0geder/Tukzie-HPEC-HUD/Photos/Reference/README.md

# Reference photos

Photos the student took for design work, resized to 1600 px on the long side. Personal screenshots (maps, ride apps) are not kept here.

## Enclosures (12 Oct 2026)

| File | What it shows | Numbers read from it |
|---|---|---|
| 2026-10-12_whiteboard_dashboard_272x187_pi5_imu_sizes.jpg | Whiteboard sketch of the display outline with the Pi 5 and IMU sizes | Display outer 272 x 187 mm; Pi 5 drawn as 90 x 60 mm (real board 85 x 56 mm); IMU (GY-521) 20 x 17 mm |
| 2026-10-12_sensor_board_and_camera_pod_with_ribbon.jpg | JCP Sense v1.0 ToF board and the yellow camera case joined by the ribbon, laid out the way they go in the front casing (camera above the board) | Camera case 29.2 x 28.2 x 12.35 mm (from its STL); board length estimated at about 120 mm from the photo, to be measured |
| 2026-10-12_display_stack_side_view_1.jpg, _2.jpg | Side of the display: acrylic front frame, panel, standoffs, back plate with the Pi 5 | Whole stack about 20 mm thick (student's estimate) |
| 2026-10-12_display_front_corner_and_stack.jpg | Front corner, frame screws, stack layers | |
| 2026-10-12_display_front_dashboard_running.jpg | The display running the SW-7 dashboard | |

## Vehicle measurements (2 Sep 2026)

Originals are in `../../../MeasurementsOfTuktuk/` (full resolution). Readings are taken from the tape in each photo.

| File | Reading |
|---|---|
| 2026-09-02_handlebar_height_tape.jpg | Tape beside the left grip and front panel, about 69 cm at the grip |
| 2026-09-02_meter_area_width_about_30cm.jpg | Across the meter and headlamp area to the steering stem, about 30.5 cm |
| 2026-09-02_seat_front_edge_width.jpg | Driver seat, about 72 cm |
| 2026-09-02_seat_length_about_93cm.jpg | Passenger seat, about 93 cm |
| 2026-09-02_mirror_span.jpg | Mirror to mirror region, about 90 cm |
| 2026-09-02_seat_cushion_length_about_75cm.jpg | Seat cushion, about 75 cm |
| 2026-09-02_handlebar_above_rear_seat.jpg | Height reading, about 64 cm |
| 2026-09-02_rear_seat_width_about_89cm.jpg | Rear seat, about 89 cm |

The readings marked "about" come from the photo alone; where a photo does not show both ends of the tape, treat the number as approximate.
