0geder/Tukzie-HPEC-HUD/Report/appendixi.tex

\chapter{Photographs of the First Road Session}
\label{app:road1}

These photographs and video stills were taken by the team around the first road session of 19 October 2026 (Section~\ref{sec:field-test-design}) and shared on 21 October. The originals, twelve photographs and five short videos, are kept in the project's \texttt{Roadtest1} folder and not in the repository. In line with Section~\ref{sec:ethics}, the faces of other people have been cropped away or blurred and the vehicle's number plate blurred; the videos show people, so they are listed in Table~\ref{tab:road1-videos} rather than reproduced.

\section{Rear sensor pod}

Figure~\ref{fig:road1-pod} shows the rear sensor pod of Appendix~\ref{app:mechanical} as built: the camera head with the time-of-flight board, the Raspberry Pi~4 with its fan and the ESP32 telemetry unit in their bays, and the vented lid with its push-on hood.

\begin{figure}[H]
\centering
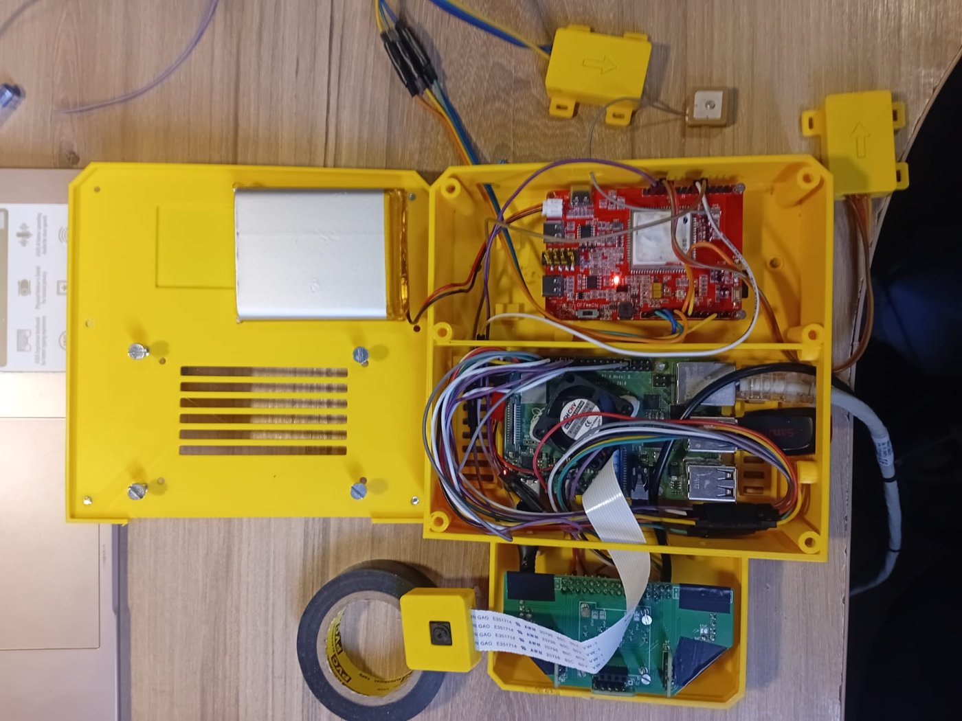
[picture p1: Report/figures/road1/pod_open_top.jpg]
\subfigure[Open, from above: the bays with the Raspberry Pi~4 and the ESP32, a battery pack held in the lid, and the head tray with the time-of-flight board below.]{}
\hfill
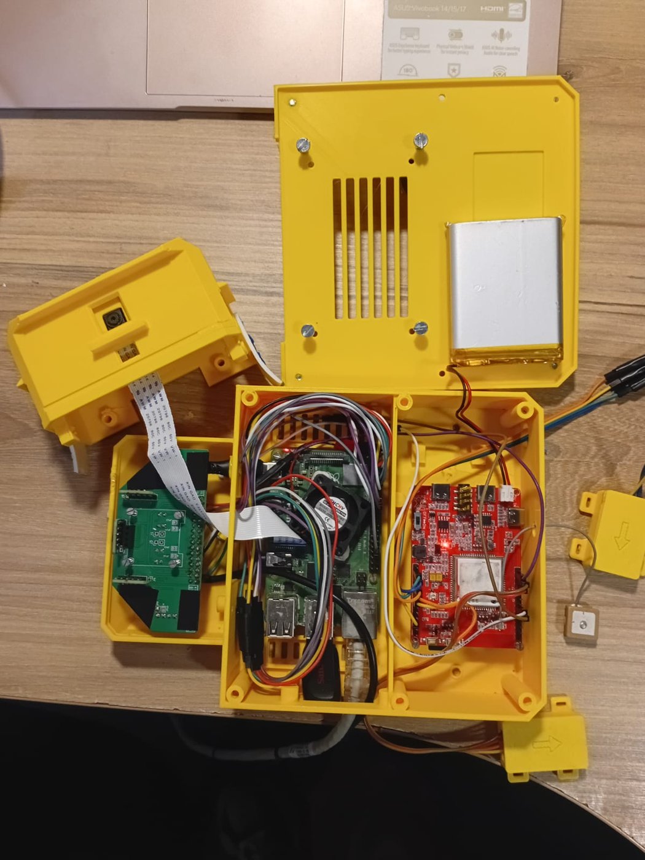
[picture p2: Report/figures/road1/pod_open_bays.jpg]
\subfigure[Open, with the camera head lifted on its ribbon cable beside the time-of-flight board.]{}
\\[4pt]
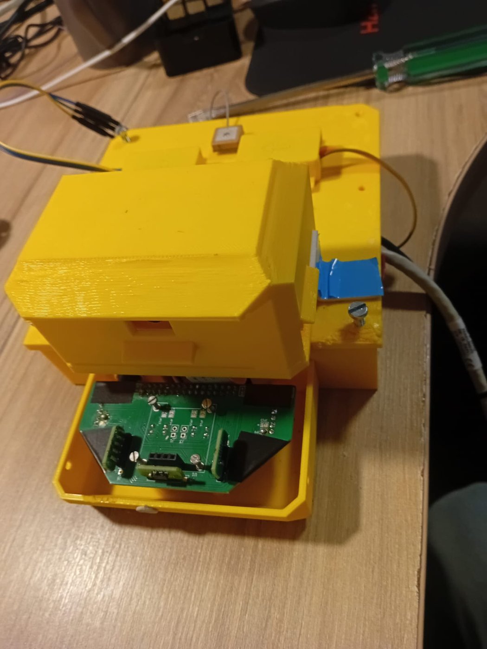
[picture p3: Report/figures/road1/pod_closed_hood.jpg]
\subfigure[Closed, with the hood over the lid's exhaust grille and the head tray open at the front.]{}
\hfill
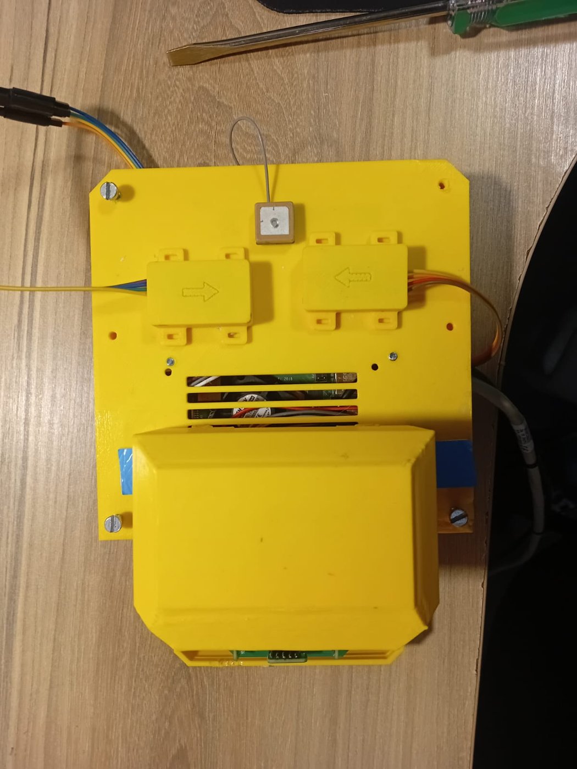
[picture p4: Report/figures/road1/pod_lid_antenna.jpg]
\subfigure[The lid from above, with the GNSS antenna on top and the grille under the hood.]{}
\caption[The rear sensor pod, printed and assembled]{The rear sensor pod, printed and assembled.}
\label{fig:road1-pod}
\end{figure}

\clearpage
\section{The system on the vehicle}

Figure~\ref{fig:road1-vehicle} shows the units mounted over the rear frame of the TUKZIE Rev 0, outdoors and in the laboratory, with the removable mounting of R13: a board laid over the frame and the units on it, with no drilling.

\begin{figure}[H]
\centering
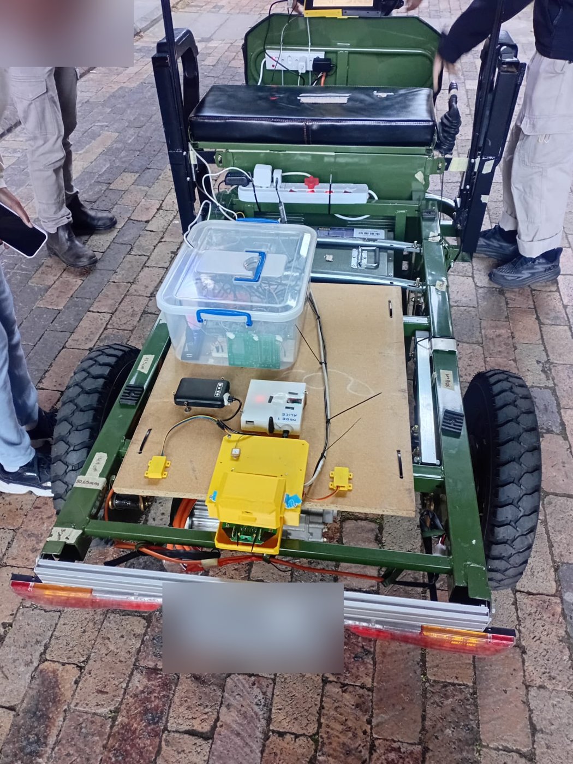
[picture p5: Report/figures/road1/chassis_rear.jpg]
\subfigure[From behind: the rear sensor pod (yellow) at the back edge of the board, the small IMU pods, and the power strip at the front of the bed.]{}
\hfill
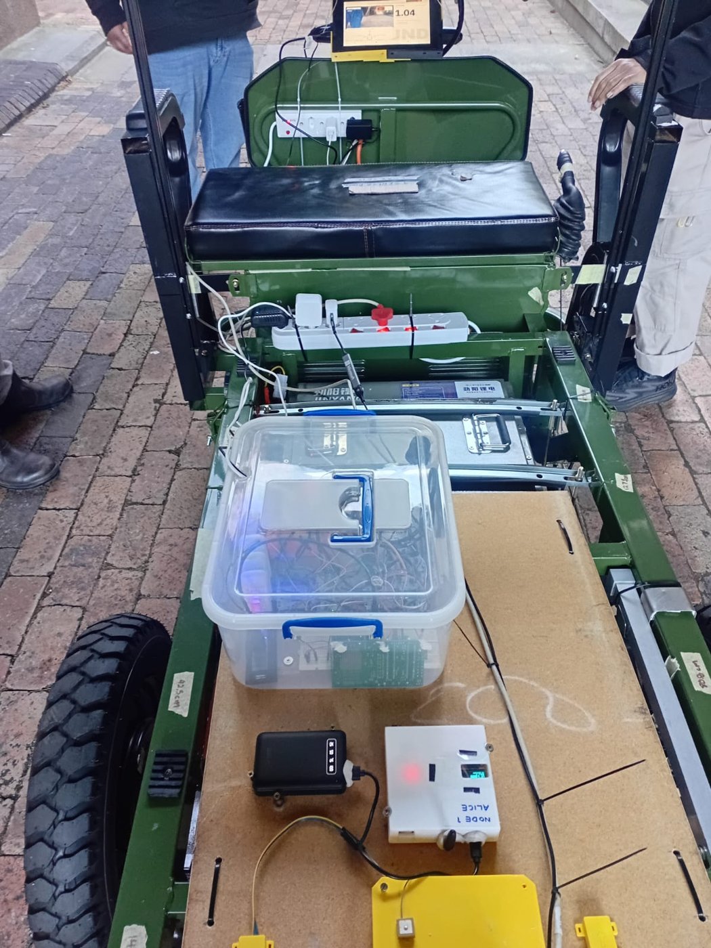
[picture p6: Report/figures/road1/chassis_rear_close.jpg]
\subfigure[Closer, with a clear box holding further electronics and the units on the board.]{}
\\[4pt]
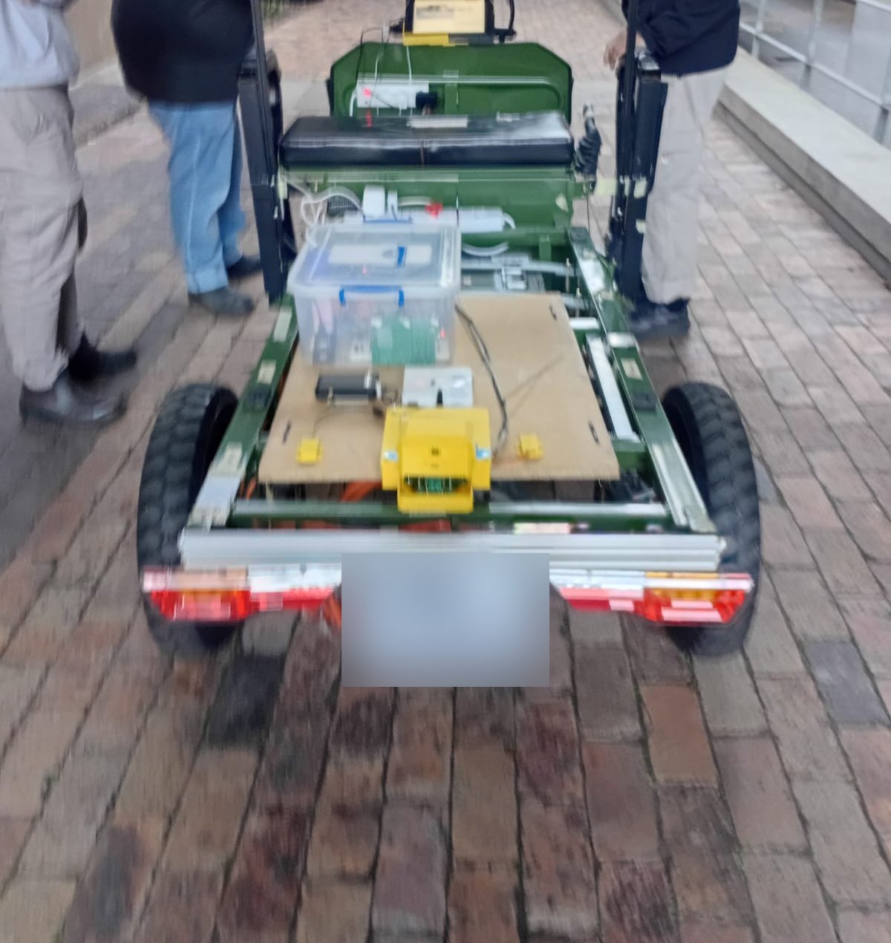
[picture p7: Report/figures/road1/chassis_rear_wide.jpg]
\subfigure[The whole vehicle from behind, outdoors.]{}
\hfill
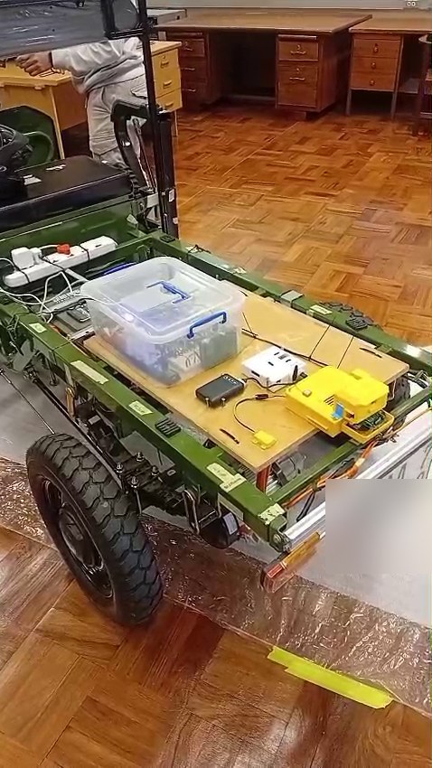
[picture p8: Report/figures/road1/vid_chassis_side.jpg]
\subfigure[From the side in the laboratory (video still).]{}
\caption[The system mounted on the vehicle]{The system mounted on the vehicle. Faces and the number plate are blurred or cropped.}
\label{fig:road1-vehicle}
\end{figure}

\clearpage
\section{The dashboard on the handlebar}

Figure~\ref{fig:road1-dash} shows the display in its printed holder on the handlebar, with the dashboard running.

\begin{figure}[H]
\centering
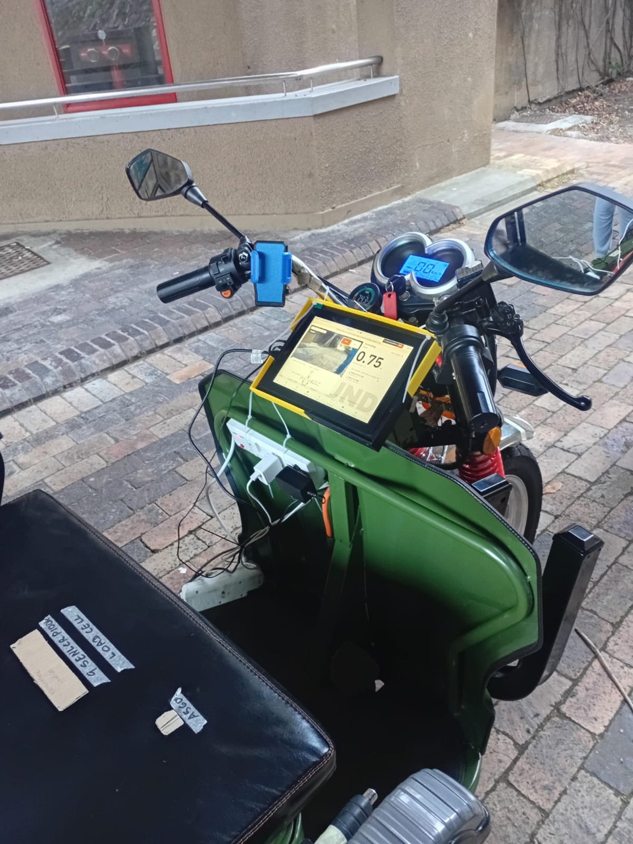
[picture p9: Report/figures/road1/dash_on_bar.jpg]
\subfigure[The display on the handlebar, outdoors.]{}
\hfill
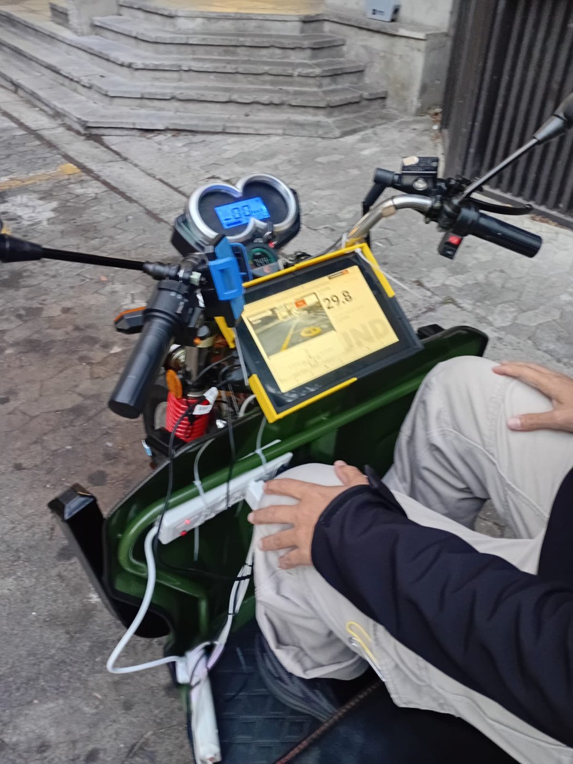
[picture p10: Report/figures/road1/dash_on_bar_seated.jpg]
\subfigure[From the seat.]{}
\hfill
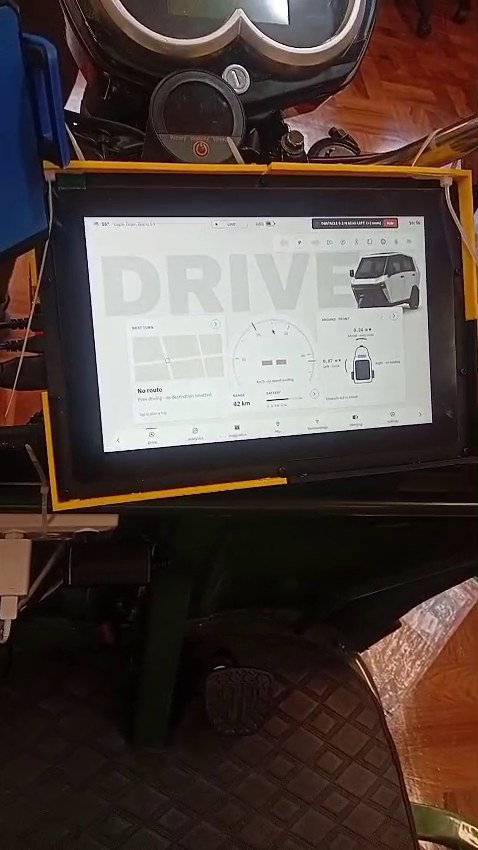
[picture p11: Report/figures/road1/vid_dash_drive.jpg]
\subfigure[The DRIVE page (video still).]{}
\caption[The dashboard display mounted on the vehicle]{The dashboard display mounted on the vehicle.}
\label{fig:road1-dash}
\end{figure}

\begin{table}[htbp]
\centering
\small
\caption[Videos from the first road session, kept with the originals (file names as shared on 21 October 2026)]{Videos from the first road session, kept with the originals (file names as shared on 21 October 2026).}
\label{tab:road1-videos}
\begin{tabular}{|p{4.6cm}|p{1.2cm}|p{8.0cm}|}
\hline
\textbf{File} & \textbf{Length} & \textbf{What it shows} \\ \hline
WhatsApp Video 2026-10-21 at 21.07.44 & 45\,s & From a corridor to a doorway as the vehicle is ridden out of the building \\ \hline
WhatsApp Video 2026-10-21 at 21.07.53 & 19\,s & A toy RC car and its remote shown to the camera, then the vehicle pushed through a doorway into a lecture venue \\ \hline
WhatsApp Video 2026-10-21 at 21.08.18 & 8\,s & A walk round the rear frame with the units mounted, indoors \\ \hline
WhatsApp Video 2026-10-21 at 21.08.19 & 16\,s & The vehicle ridden slowly inside the lecture venue \\ \hline
WhatsApp Video 2026-10-21 at 21.08.20 & 43\,s & The wiring at the bed, then the display on the handlebar showing the DRIVE page \\ \hline
\end{tabular}
\end{table}

\clearpage
\section{Front sensor board on the vehicle}

Figure~\ref{fig:road1-front} shows the front time-of-flight sensor board of the Raspberry Pi~5 unit (Section~\ref{sec:two-sided}) fitted on the vehicle, on its yellow printed mount below the headlight and between the fork legs, facing forward.

\begin{figure}[H]
\centering
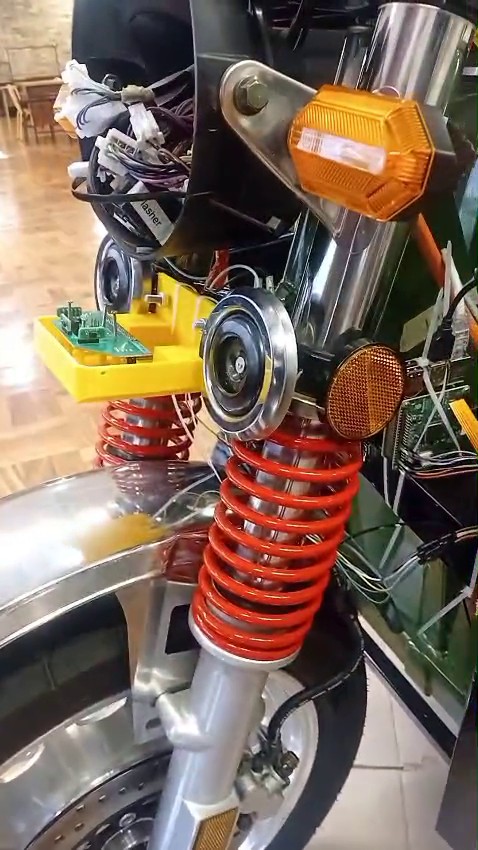
[picture p12: Report/figures/road1/vid_front_sensor.jpg]
\subfigure[The front of the vehicle with the sensor board on its mount (video still).]{}
\hfill
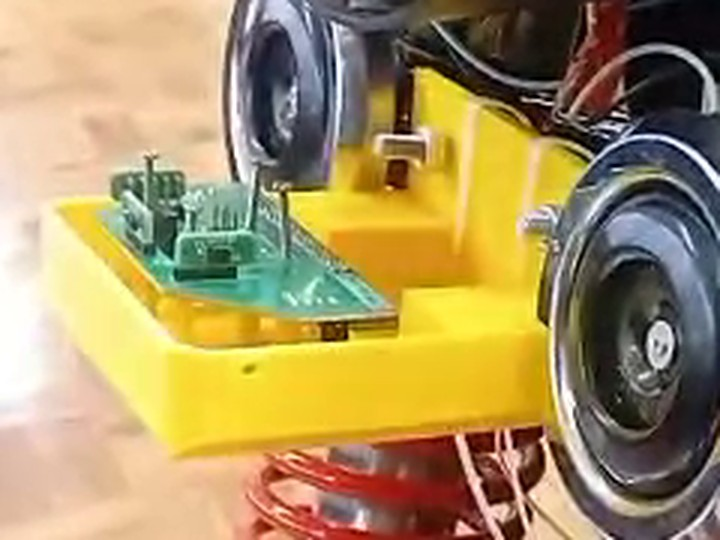
[picture p13: Report/figures/road1/vid_front_sensor_crop.jpg]
\subfigure[The mount and board, enlarged from the same frame.]{}
\caption[The front sensor board fitted on the TUKZIE Rev 0 (from the video of 21.08.20, at 28\,s)]{The front sensor board fitted on the TUKZIE Rev 0 (from the video of 21.08.20, at 28\,s).}
\label{fig:road1-front}
\end{figure}

\begin{figure}[htbp]
\centering
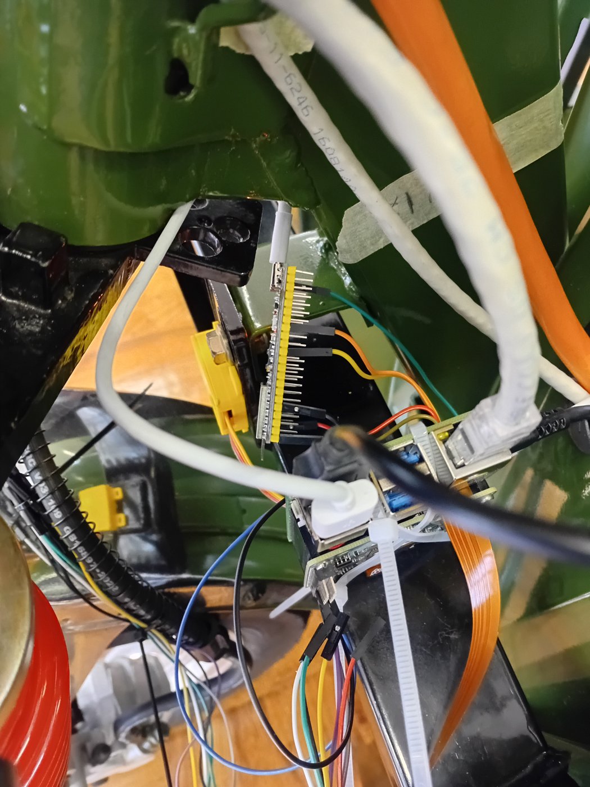
[picture p14: Report/figures/road1/front_install_1023.jpg]

\caption[The front installation under the frame, 23 October 2026]{The front installation under the frame, 23 October 2026: the Raspberry Pi~5 (lower right, with the Ethernet cable and the camera ribbon) and the front IMU node, a bare ESP32-S3 on yellow headers (centre), cable-tied beneath the front frame.}
\label{fig:front-install}
\end{figure}

\begin{figure}[htbp]
\centering
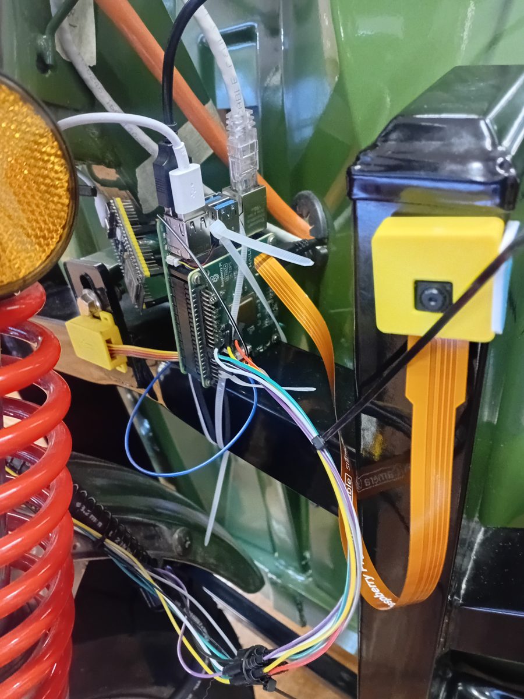
[picture p15: Report/figures/road1/front_camera_1022.jpg]
\subfigure[The front camera in its yellow printed case on the frame upright, with its ribbon to the Raspberry Pi~5.]{}\hfill
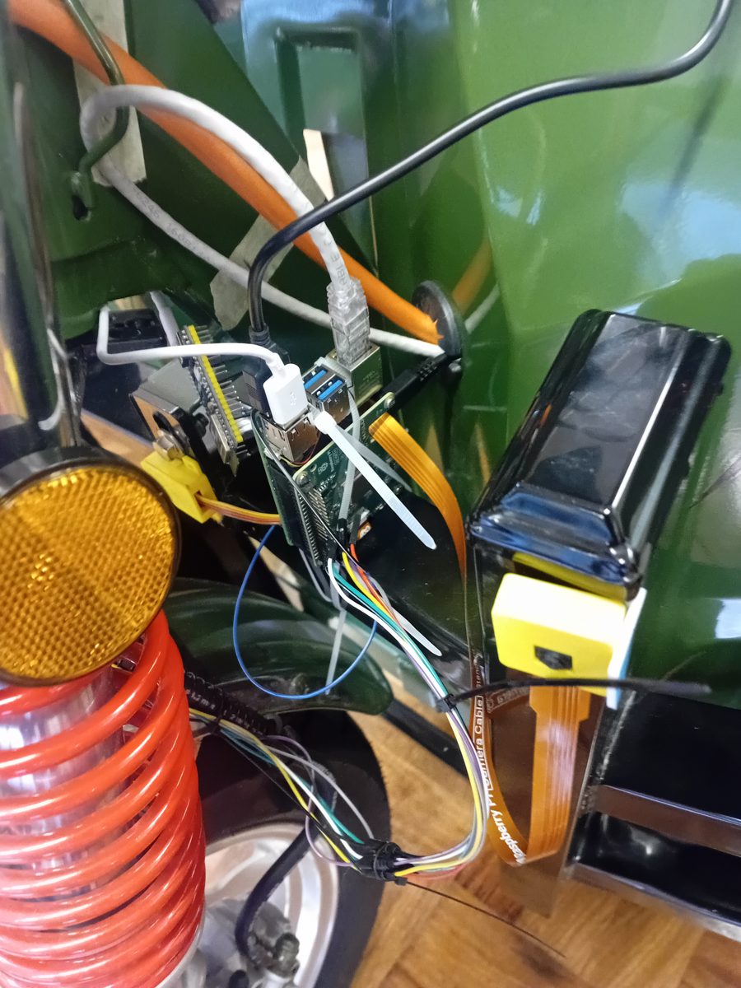
[picture p16: Report/figures/road1/front_system_1022.jpg]
\subfigure[The front system from above: the Raspberry Pi~5, the front IMU node and the camera, wired on the frame.]{}
\caption[The front camera and front system on the vehicle, 22 October 2026]{The front camera and front system on the vehicle, 22 October 2026.}
\label{fig:front-system-1022}
\end{figure}

\begin{figure}[htbp]
\centering
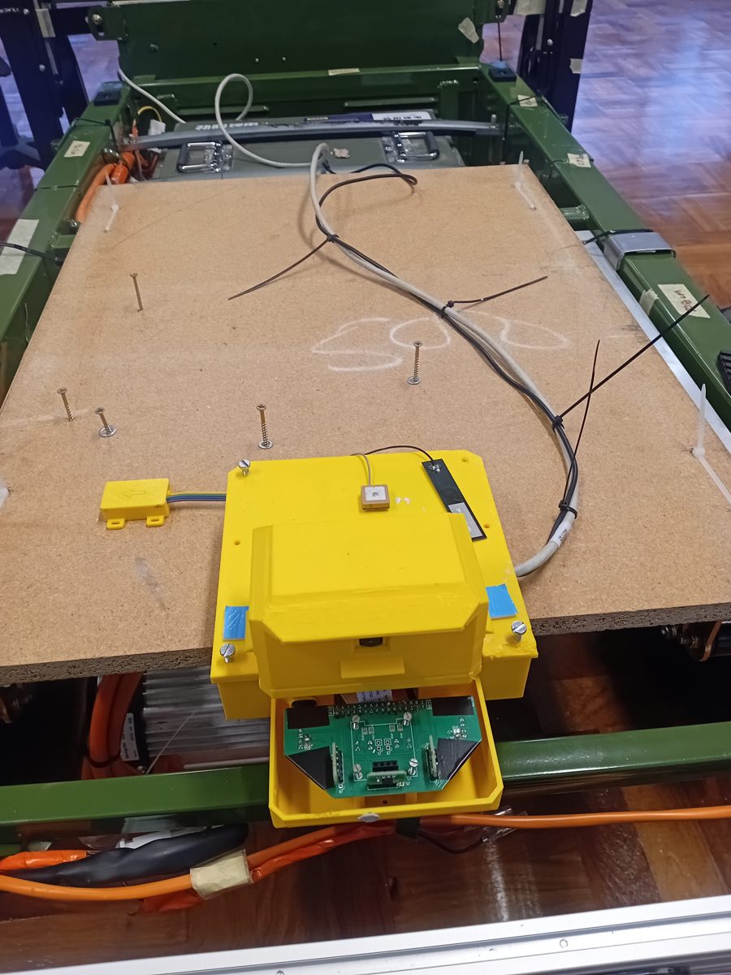
[picture p17: Report/figures/road1/rear_system_1022.jpg]

\caption[The rear system on the deck, 22 October 2026]{The rear system on the deck, 22 October 2026: the printed rear enclosure with the Raspberry Pi~4, the GNSS and LTE antennas on its lid, the rear camera and time-of-flight board at its end, and a small IMU pod and an ESP32-S3 board on the deck.}
\label{fig:rear-system-1022}
\end{figure}

\begin{figure}[htbp]
\centering
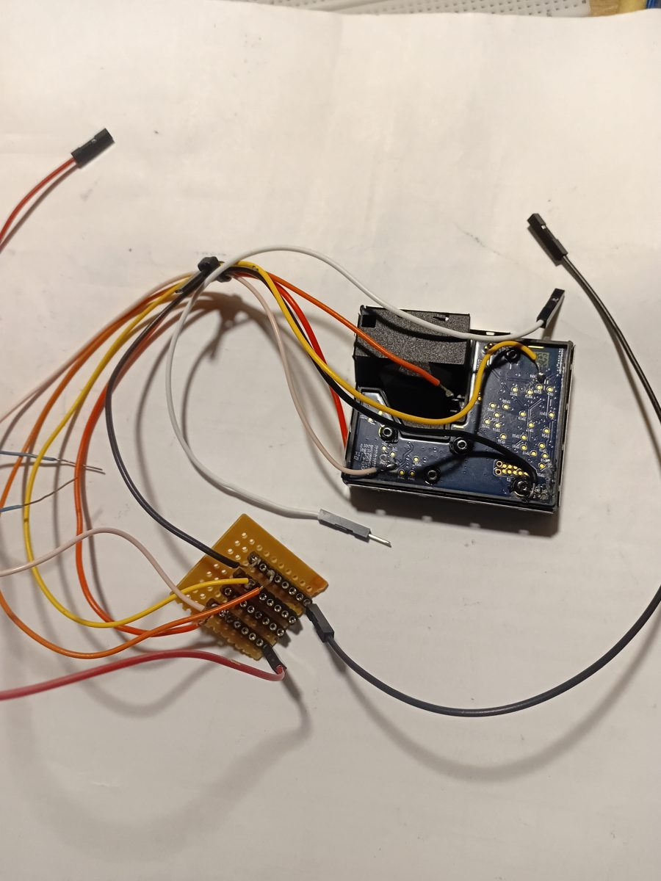
[picture p18: Report/figures/road1/sen55_damaged_1026.jpg]

\caption[The SEN55 air-quality sensor after wires were soldered to its test pads]{The SEN55 air-quality sensor after wires were soldered to its test pads in place of the missing cable, with the adapter board; the sensor no longer powered up (Section~\ref{sec:impl-other}).}
\label{fig:sen55-damaged}
\end{figure}

\IfFileExists{video_links.tex}{\input{video_evidence}}{}
