0geder/Tukzie-HPEC-HUD/Report/appendixc.tex

\chapter{Test Evidence}
\label{app:evidence}

This appendix indexes the raw evidence behind the bench results reported in Chapter~\ref{chap:results}. Every item is the unedited output of the test it names and is kept in the project repository, under \texttt{Report/evidence/} or \texttt{BenchTest/logs/}; Table~\ref{tab:evidence-index} gives each file. Figure~\ref{fig:live-dashboard} in Appendix~\ref{app:figures} and Figure~\ref{fig:recorded-session} in Chapter~\ref{chap:results} belong to the same record.

\begin{longtable}{|>{\raggedright\arraybackslash}p{1.7cm}|>{\raggedright\arraybackslash}p{3.6cm}|>{\raggedright\arraybackslash}p{5.2cm}|>{\raggedright\arraybackslash}p{3.6cm}|}
\caption[Index of test evidence]{Index of test evidence.}
\label{tab:evidence-index}\\
\hline
\textbf{Date} & \textbf{Test} & \textbf{Result shown} & \textbf{File} \\ \hline
\endfirsthead
\hline
\textbf{Date} & \textbf{Test} & \textbf{Result shown} & \textbf{File} \\ \hline
\endhead
25 Sep 2026 & Recorded bench session, telemetry unit, 150\,s from power-up & 200\,Hz on both IMUs with no dropped samples; 149 fused windows, all from both sensors; five of five fusion self-tests passed; acquisition gaps of 25 to 30\,ms every 12\,s, with intervals down to 0.8\,ms after each (catch-up) & \texttt{BenchTest/\allowbreak{}logs/\allowbreak{} 2026-09-25\_\allowbreak{}bench\_\allowbreak{}fusion\_\allowbreak{}shake.log} \\ \hline
25 Sep 2026 & The same log replayed through the bench console (Figure~\ref{fig:console-replay}) & Every subsystem's state at the end of the session, and the vibration and disagreement traces for the whole recording & \texttt{Report/\allowbreak{}evidence/\allowbreak{} 2026-09-25\_\allowbreak{}bench\_\allowbreak{}console\_\allowbreak{}replay.png} \\ \hline
28 Sep 2026 & Hazard detector, first run on live camera frames & 430 frames in 60.1\,s (7.2\,frames/s); a person in view logged as ``motorcycle'', which exposed the label-offset fault & \texttt{Report/\allowbreak{}evidence/\allowbreak{} 2026-09-28\_\allowbreak{}camera\_\allowbreak{}run1\_\allowbreak{}label\_\allowbreak{}bug.txt} \\ \hline
28 Sep 2026 & Hazard detector after the label and colour fixes & 419 frames in 60.1\,s (7.0\,frames/s); person detected at confidence 0.50 to 0.73; 16 alert activations in 47\,s for one person in view, which led to clear-side hysteresis & \texttt{Report/\allowbreak{}evidence/\allowbreak{} 2026-09-28\_\allowbreak{}camera\_\allowbreak{}run2\_\allowbreak{}after\_\allowbreak{}fixes.txt} \\ \hline
29 Sep 2026 & Firmware v0.5.0 on the telemetry unit: commands, flash-write stall test, MQTT reconnect & With logging on, 33 to 40\,ms gaps on both IMUs every 10\,s; with logging off, worst gap 5.9\,ms; no dropped samples; 47 MQTT publishes with no failures; reconnect in 0.4\,s & \texttt{BenchTest/\allowbreak{}logs/\allowbreak{} 2026-09-29\_\allowbreak{}v050\_\allowbreak{}bench\_\allowbreak{}test.log} \\ \hline
29 Sep 2026 & GNSS outdoor fix on a rooftop, firmware v0.5.0, raw replies requested every 15\,s & 3D fix after 51\,s; 17-field reply with decimal degrees; old parser read satellite counts as the position; well-formed replies 2.4 and 5.5\,m from the phone's position; replies garbled by the competing query & \texttt{BenchTest/\allowbreak{}logs/\allowbreak{} 2026-09-29\_\allowbreak{}gnss\_\allowbreak{}rooftop.log} \\ \hline
30 Sep 2026 & GNSS outdoor fix with the corrected parser (v0.5.2), raw replies printed by the firmware & 3D fix after 105\,s from a cold start; 23 to 25 satellites; over 104 fixes, median 2.7\,m and 95\% within 11.0\,m of the phone's position & \texttt{BenchTest/\allowbreak{}logs/\allowbreak{} 2026-09-30\_\allowbreak{}gnss\_\allowbreak{}rooftop\_\allowbreak{}v052.log} \\ \hline
30 Sep 2026 & MQTT recovery from a 60\,s radio-off period (\texttt{AT+CFUN=4}, then \texttt{AT+CFUN=1}), v0.5.0 and v0.5.3 & Loss detected in 0.8 to 20.7\,s; retries at 30 and 60\,s; reconnect 36\,s after the radio returned in v0.5.0, about 5\,s in v0.5.3; no failed publishes afterwards & \texttt{BenchTest/\allowbreak{}logs/\allowbreak{} 2026-09-30\_\allowbreak{}signal\_\allowbreak{}loss\_\allowbreak{}test.log}, \texttt{..\_v053.log} \\ \hline
30 Sep 2026 & Sync-pulse edges logged on the Pi (GPIO17, kernel timestamps), two 60\,s runs & Run 1: 16\,s burst of spurious edges, consistent with a disturbed contact; run 2: 121 edges, median interval 500.06\,ms, range 499.72 to 500.41\,ms & \texttt{BenchTest/\allowbreak{}logs/\allowbreak{} 2026-09-30\_\allowbreak{}sync\_\allowbreak{}edges\_\allowbreak{}run1\_\allowbreak{}noisy.csv}, \texttt{..\_run2.csv} \\ \hline
30 Sep 2026 & Camera detector latency on the Pi, three 60\,s runs (4 threads, 4 threads with live view, 1 thread) & Median 102, 105 and 186\,ms from sensor readout to result; 19.5, 17.3 and 7.0 frames/s; no throttling & \texttt{BenchTest/\allowbreak{}logs/\allowbreak{} 2026-09-30\_\allowbreak{}c4\_\allowbreak{}latency/} \\ \hline
1 Oct 2026 & Firmware v0.6.0 bench run, 330\,s, logging on throughout (buffered log, signal quality, Hall counter in loopback) & Five flushes; all ten gaps over 10\,ms (37 to 40\,ms) in the first window after a flush (0.2 to 1.05\,s after it); worst gap otherwise 5.9\,ms; no dropped samples; Hall counter 2.00 edges/s; CSQ 24 to 26 & \texttt{BenchTest/\allowbreak{}logs/\allowbreak{} 2026-10-01\_\allowbreak{}v060\_\allowbreak{}bench\_\allowbreak{}test.log} \\ \hline
1 Oct 2026 & Read-back of the stored telemetry log (firmware v0.6.3, \texttt{BenchTest/log\_dump.py}, four passes) & 6,020 records recovered complete; 5,545 contained \texttt{nan} (invalid JSON, fixed in v0.6.3); 14 records with a valid BMS reading (74.78\,V, 60\%) from 30 Sep; log then cleared & \texttt{BenchTest/\allowbreak{}logs/\allowbreak{} 2026-10-01\_\allowbreak{}telemetry\_\allowbreak{}log\_\allowbreak{}dump.jsonl}, \texttt{..clean.jsonl} \\ \hline
1 Oct 2026 & Stand-in ToF: micromouse sensor board on the Pi (three VL53L0X, \texttt{tof\_probe.py}, \texttt{tof\_reader.py}) & Chip confirmed VL53L0X; three sensors addressed and read at about 31 per second each; centre 267 to 300\,mm, right 24 to 38\,mm, left 8190 (no target) throughout & \texttt{BenchTest/\allowbreak{}logs/\allowbreak{} 2026-10-01\_\allowbreak{}tof\_\allowbreak{}three\_\allowbreak{}sensors.csv} \\ \hline
1 Oct 2026 & Dashboard camera page (laptop, offscreen) against the live detector on the Pi~4, 60\,s & Live after 0.6\,s; 638 frames decoded in 45\,s (14.2 per second); offline state shown when the detector stopped; no alerts (nothing in view) & \texttt{Report/\allowbreak{}evidence/\allowbreak{} 2026-10-01\_\allowbreak{}dashboard\_\allowbreak{}page\_\allowbreak{}live.png}, \texttt{Dashboard\allowbreak{}Integration/\allowbreak{}tests/\allowbreak{} test\_\allowbreak{}front\_\allowbreak{}camera\_\allowbreak{}page\_\allowbreak{}live.py} \\ \hline
1 Oct 2026 & Dashboard camera page against the live detector with a person in view, 40\,s & Red ``Person, Immediate'' alert listed 0.5\,s after start, matching the box on the video; 15.4 frames/s, 109 to 118\,ms; clearing not seen (person stayed in view) & \texttt{Report/\allowbreak{}evidence/\allowbreak{} 2026-10-01\_\allowbreak{}dashboard\_\allowbreak{}page\_\allowbreak{}person.png} \\ \hline
1 Oct 2026 & Camera colour check (C3): stills with the standard and the NoIR tuning, detector frames with NoIR tuning and saturation 1.8 & Standard tuning: white wall pink; NoIR tuning: neutral but washed out (blue card 120, 124, 125); with saturation 1.8: blue 1, 86, 216; red 222, 8, 77; green 6, 124, 103; grey 124, 129, 138; white 186, 199, 197 (slightly cool) & \texttt{Report/evidence/c3/} \\ \hline
2 Oct 2026 & First pothole model: YOLO11n fine-tuned in Colab (T4) on a public 608-image pothole dataset, test split at 640 and 320 & mAP@50 0.597 (P 0.66, R 0.50) at 640; 0.550 at 320; 46 epochs, 15 min & \texttt{Camera\allowbreak{}Detection/\allowbreak{}training/\allowbreak{} runs/\allowbreak{}run1\_\allowbreak{}gerapothole\_\allowbreak{}640/} \\ \hline
2 Oct 2026 & First pothole model on the South African test split (605 images, 1,238 potholes) at 640, 1280 and 1920 input; labels checked visually & mAP@50 0.000 at all three sizes, recall at most 1.2\%; label positions confirmed correct & \texttt{Camera\allowbreak{}Detection/\allowbreak{} training/\allowbreak{}runs/\allowbreak{} colab\_\allowbreak{}session\_\allowbreak{}2026-10-02.ipynb} \\ \hline
2 Oct 2026 & Firmware v0.7.0 DASH line on the bench (40 s) and through the Raspberry Pi~4 bridge to a laptop & 40 lines in 40 s, none missing, all valid JSON, max 272 bytes; IMUs 200 Hz, 0 drops; bridge served live record (0.37 s old) and ToF distances & \texttt{BenchTest/\allowbreak{}TEST\_\allowbreak{}PRO\allowbreak{}CEDURES.md} T11, T12 \\ \hline
2 Oct 2026 & YOLO11n (COCO) via NCNN on the Raspberry Pi~4, 320 input, 4 threads, 15 s trial & 7.9\,frames/s; inference 111 ms median; 175 ms sensor to result (p95 258 ms) & \texttt{Camera\allowbreak{}Detection/\allowbreak{} ncnn\_\allowbreak{}bench.py} \\ \hline
2 Oct 2026 & Dashboard map crash on the Raspberry Pi~5, diagnosed over ssh without changing the team's installation & Segmentation fault about 2\,s after the dashboard is shown with the web map (online or offline data); no crash with the native map after 30\,s; the web engine alone loads normally & \texttt{Dashboard\allowbreak Integration/\allowbreak{} PI5\_\allowbreak{}MAP\_\allowbreak{}CRASH.md} \\ \hline
3 Oct 2026 & Dashboard live-only mode and automatic Raspberry Pi~4 finding, offscreen against a simulated bridge (laptop) & With the bridge down every page shows \texttt{-{}-} or Unavailable and no simulated value; live when the bridge appears, back to no data when it stops; host found by localhost, override and beacon, and followed after it moved & \texttt{Dashboard\allowbreak Integration/\allowbreak{} tests/\allowbreak{}test\_\allowbreak{}live\_\allowbreak{}data\allowbreak \_\allowbreak{}provider.py} \\ \hline
4 Oct 2026 & Street-tile map, offscreen, fed the generated UCT replay track (not recorded data) against a stand-in tile server & Tiles requested at most two at a time and cached; heading-up follow; ``Waiting for GPS fix''; REPLAY badge; vector roads with the tile server down & \texttt{Dashboard\allowbreak Integration/\allowbreak{} tests/\allowbreak{}tile\_\allowbreak{}map\_\allowbreak{}*.png} \\ \hline
4 Oct 2026 & Camera and time-of-flight fusion, offline tests & 29 of 29 pass; not yet run on the Raspberry Pi~4 (test C9 planned) & \texttt{Camera\allowbreak{}Detection/\allowbreak{} tests/\allowbreak{}test\_\allowbreak{}sensor\_\allowbreak{}fusion.py} \\ \hline
6 Oct 2026 & Sensors page and hazard banner, whole dashboard offscreen against the live bridge & ToF gauges (ahead 0.43\,m red, right 0.69\,m amber, left no reading), both listed in the fusion's immediate band (under 3\,m) while the gauges colour by their own proximity thresholds (red under 0.5\,m, amber under 1.0\,m); banner over the driving page, hidden on the Sensors page & \texttt{Dashboard\allowbreak{}Integration/\allowbreak{} tests/\allowbreak{}sensors\_\allowbreak{}page.png}, \texttt{hazard\_banner.png} \\ \hline
6 Oct 2026 & First fused camera and time-of-flight hazard, live, before calibration & Person, ahead sensor: camera 0.874\,m, time-of-flight 0.096\,m, reported 0.096\,m; not checked against a tape & \texttt{BenchTest/\allowbreak{} TEST\_\allowbreak{}PRO\allowbreak{}CEDURES.md}, test C9 notes \\ \hline
6 Oct 2026 & Pothole model run 2, South African road-band tiles (Colab) & Validation mAP@50 0.714 at 640 and 0.566 at 320; held-out test tiles not yet scored & \texttt{Camera\allowbreak{}Detection/\allowbreak{} training/\allowbreak{}runs/\allowbreak{} run2\_\allowbreak{}sa\_\allowbreak{}band\_\allowbreak{}tiles\_\allowbreak{}640/\allowbreak{} training\_\allowbreak{}record.json} \\ \hline
6 Oct 2026 & Simulated drive on the street map, offscreen tests & Starts without a fix, 25\,km/h along the route, heading-up, arrives, a real fix stops it & \texttt{Dashboard\allowbreak{}Integration/\allowbreak{} tests/\allowbreak{}tile\_\allowbreak{}map\_\allowbreak{} simulated\_\allowbreak{}drive.png} \\ \hline
6 Oct 2026 & Raspberry Pi~4 power and temperature watcher, 20\,min & Clear with nothing attached; soft temperature limit from 17:45; under-voltage 14\,s after the telemetry unit was plugged into its USB port & \texttt{BenchTest/\allowbreak{}logs/\allowbreak{} 2026-10-06\_\allowbreak{}pi4\_\allowbreak{} power\_\allowbreak{}watch.log} \\ \hline
10 to 11 Oct 2026 & Raspberry Pi~4 reboots, temperature and detector timing with the whole system running & Three restarts in 20\,min with the telemetry unit on its USB port, none in 4\,h after; 14.6 to 14.7 frames/s, median 118 to 122\,ms, 95th percentile 146 to 148\,ms & \texttt{BenchTest/\allowbreak{}logs/\allowbreak{} 2026-10-10\_\allowbreak{}bench\_\allowbreak{} observations.md} \\ \hline
11 Oct 2026 & Store-and-forward outage test T15, firmware v0.7.4, 10\,min radio off, ingest on the Raspberry Pi~5 & 60 records built up, 0 lost; reconnect 5.2\,s; backlog cleared in 37 to 43\,s; 112 of 112 stored, 111 of 111 against the unit's log (24 backfilled); IMUs 200\,Hz, 0 dropped & \texttt{BenchTest/\allowbreak{}logs/\allowbreak{} 2026-10-11\_\allowbreak{}sync\_\allowbreak{} outage\_\allowbreak{}test.log}, \texttt{2026-10-11\_t15/} \\ \hline
11 Oct 2026 & Pothole path in the detector (C10) & Pothole found in a test picture (confidence 0.63); 13.9 frames/s at one run per 4\,s against 14.6 without the path & \texttt{BenchTest/\allowbreak{} TEST\_\allowbreak{}PRO\allowbreak{}CEDURES.md}, test C10 \\ \hline
15 Oct 2026 & Detector on the Raspberry Pi~5 with the dashboard running, second OV5647 camera, 60\,s & 19.2 frames/s; readout to result 51 to 54\,ms median, 61 to 63\,ms 95th percentile; CPU 64 to 73\,\%; no throttling & \texttt{BenchTest/\allowbreak{}logs/\allowbreak{} 2026-10-15\_\allowbreak{}pi5\_\allowbreak{}detector.log} \\ \hline
19 Oct 2026 & Whole system mounted on the vehicle, lab check & Front 17.5 to 22.0 frames/s, 53 to 102\,ms; rear 14.4 to 14.5 frames/s, 126 to 151\,ms; both ToF boards and IMUs answered; Ethernet 1000\,Mb/s, 0.25\,ms & \texttt{Planning/\allowbreak{} lab-notebook.md}, 19 Oct \\ \hline
19 Oct 2026 & First road session, recorder on the Raspberry Pi~5, 17:15 to 19:04 & 3,464 distinct records (10,287 replies), 38\,\% of seconds missing; 0 dropped; one 2\,s IMU1 stall; up to 46.9\,A, 74.6 to 72.8\,V; no GNSS fix (no antenna); 1,342 front and 741 rear alerts & \texttt{BenchTest/\allowbreak{}logs/\allowbreak{} roadtest\_\allowbreak{}2026-10-19/} \\ \hline
21 Oct 2026 & Telemetry unit on its own battery, wired UART to the Raspberry Pi~4 (v0.7.4.1) & No under-voltage on the Pi; 2,489 lines, 0 bad; unit restarted by itself and its modem stopped answering; IMU drop counts rose once and IMU2 was lost once, each until a reset & \texttt{Planning/\allowbreak{} lab-notebook.md}, 21 Oct \\ \hline
22 Oct 2026 & Rear drop fault recurs (v0.7.4.1, no USB host), 12:27 and 12:58 & Drops rising at about 168 and 46 a second (733,399 and 198,524 by 12:58); \texttt{imu\_hz} frozen at 200; vibration null; modem silent & \texttt{Planning/\allowbreak{} lab-notebook.md}, 22 Oct \\ \hline
22 Oct 2026 & Run-1 flash log read back before reflashing (\texttt{log\_dump.py}, four passes) and analysed & 2,000 of 2,022 records, 1,998 parse; boot 109: 1,154 records, 17:18 on 19 Oct to 00:44; current to $-48.03$\,A; per-IMU features parked and driving; IMU1 to IMU2 $\sigma$ ratio 1.06 while driving & \texttt{BenchTest/\allowbreak{}logs/\allowbreak{} flashlog\_\allowbreak{}2026-10-22/}; \texttt{Report/\allowbreak{}figures/\allowbreak{} results/\allowbreak{}flashlog\_\allowbreak{}run1.py}, \texttt{flashlog\_\allowbreak{}run1\_\allowbreak{} summary.txt} \\ \hline
22 Oct 2026 & Front node raw stream (v0.7.5) to the laptop at 115\,200 and 921\,600\,baud & 5,110 samples in 20\,s, line 85\,\% full; then 6,800 in 30\,s, 0 missing, 0 bad lines, 69 sync edges, 0 raw drops & \texttt{Planning/\allowbreak{} lab-notebook.md}, 22 Oct \\ \hline
22 Oct 2026 & Front node on the Raspberry Pi~5 (capture service), v0.7.5 then v0.7.6 & 200\,Hz, 0 drops, 0 read failures, 0 raw drops; 1,107 and 2,608 raw lines, 0 bad CRC; recorder 80 of 80; on v0.7.6 consumer ages 0 and 4\,ms & \texttt{Planning/\allowbreak{} lab-notebook.md}, 22 Oct; on the Pi~5 \texttt{/\allowbreak{}home/\allowbreak{}piadam/\allowbreak{} roadtest/\allowbreak{}raw\_\allowbreak{}front/} \\ \hline
22 Oct 2026 & Front IMU recalibration (\texttt{!recal} from the Raspberry Pi~5) & Factor 1.0035 against 1.0036 at first boot; 1.000\,g raw at rest; board at 49\textdegree & \texttt{Planning/\allowbreak{} calibration-record.md} \\ \hline
22 Oct 2026 & Front sync pulse, GPIO5 to Raspberry Pi~5 pin~11 & Pin~11 toggles every 500\,ms (static before the jumper was moved) & \texttt{Planning/\allowbreak{} lab-notebook.md}, 22 Oct \\ \hline
22 Oct 2026 & Rear unit on v0.7.6; IMU1 wires taken off while running & After flashing: 200\,Hz, 0 drops, 0 read failures, consumer ages 1 to 45\,ms; raw capture 0 bad CRC. Wires off: 17,080 read failures, 8,508 late, 0 drops, consumer ages 2 to 29\,ms; sensor asleep after refitting until reset & \texttt{Planning/\allowbreak{} lab-notebook.md}, 22 Oct; on the Pi~4 \texttt{/home/ogeder/ rawlog/} \\ \hline
22 Oct 2026 & Rear unit v0.7.6 soak, 62\,min, own battery, modem silent, wired UART & 0 restarts, 0 drops, 0 read failures, 0 late, 0 raw drops; consumer ages at most 49\,ms; rate outside 199.5 to 200.5\,Hz in 3 of 726 polls; 152 stuck readings; 3,720 lines, 0 bad & \texttt{Report/\allowbreak{}figures/\allowbreak{} results/\allowbreak{}soak\_\allowbreak{}v076b\_\allowbreak{} 20261022\_\allowbreak{}134823.jsonl} (copy of \texttt{/home/ogeder/soak/} on the Pi~4), \texttt{soak\_v076b\_ eval.py}, \texttt{soak\_\allowbreak{}v076b\_\allowbreak{} summary.txt} \\ \hline
22 Oct 2026 & Rear unit on v0.7.8: IMU1 supply wire pulled for several seconds and refitted, four times (about 15:20) & Each time: sensor marked down, 0 drops, consumer ages under 50\,ms; re-initialised by itself after refitting (count 1 to 4), 200\,Hz and vibration value back, no reset & \texttt{BenchTest/\allowbreak{}logs/\allowbreak{} recovery\_\allowbreak{}2026-10-22/\allowbreak{} rear\_\allowbreak{}recovery\_\allowbreak{}console\_\allowbreak{}2.txt} \\ \hline
\end{longtable}

\begin{figure}[htbp]
\centering
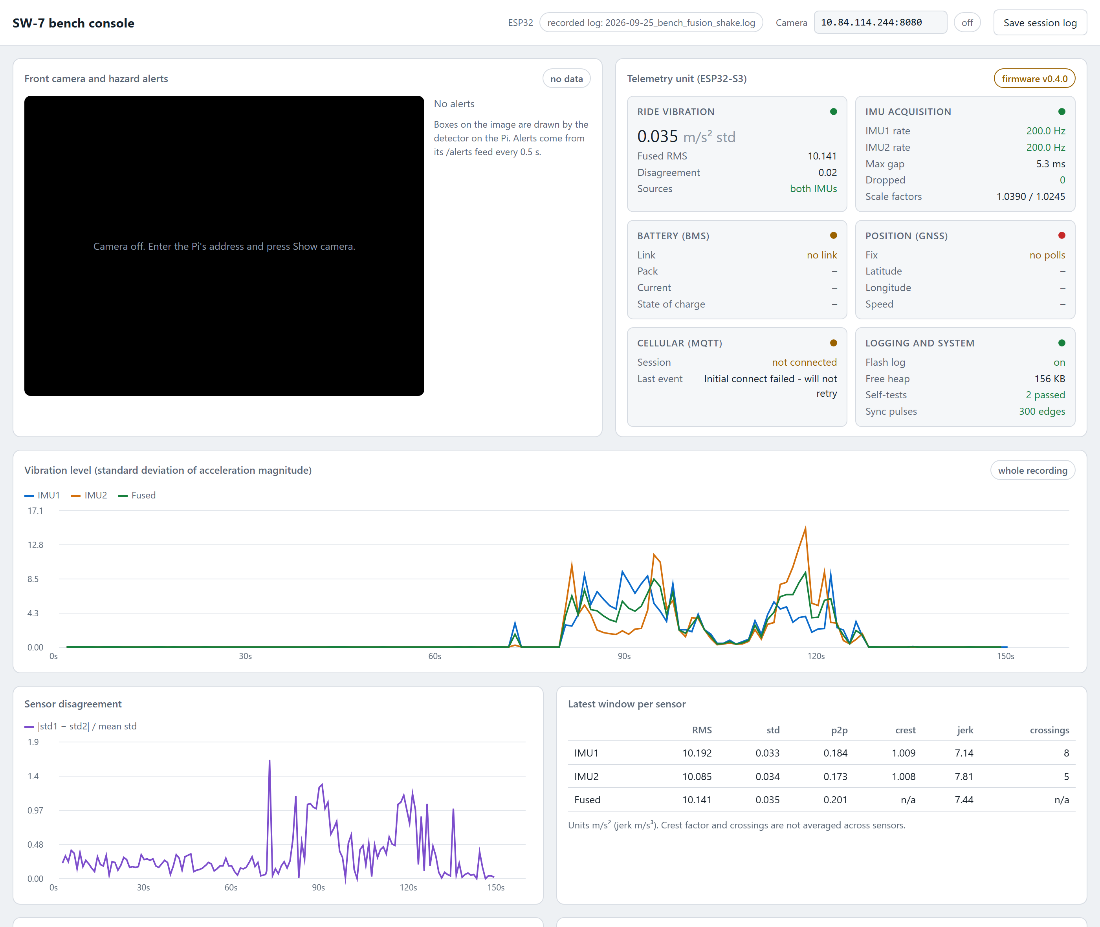
[picture p19: Report/evidence/2026-09-25_bench_console_replay.png]

\caption[The recorded bench session of 25 September 2026 replayed through the bench console, which parses the telemetry unit's serial output]{The recorded bench session of 25 September 2026 replayed through the bench console, which parses the telemetry unit's serial output. Only recorded data is shown; the camera panel is off because the camera was not part of this session.}
\label{fig:console-replay}
\end{figure}

The two detector runs end with the following lines, copied from the Raspberry Pi terminal. Before the fixes, every alert carried the wrong class:

\begin{verbatim}
Stopped. 430 frames in 60.1s (7.2 fps average).
{"class": "motorcycle", "distance_band": "immediate", "confidence": 0.66,
 "timestamp": "2026-09-28T11:58:32", "alert_status": "active"}
\end{verbatim}

After the fixes, the class is correct, and the log shows the alert clearing and re-activating within a few seconds while the same person stayed in view:

\begin{verbatim}
[14:31:28] person band=immediate conf=0.59 streak=3/3
  -> ALERT logged: person (immediate)
Stopped. 419 frames in 60.1s (7.0 fps average).
{"class": "person", "distance_band": "immediate", "confidence": 0.59,
 "timestamp": "2026-09-28T14:31:28", "alert_status": "active"}
{"class": "person", "distance_band": null, "confidence": 0.0,
 "timestamp": "2026-09-28T14:31:30", "alert_status": "cleared"}
{"class": "person", "distance_band": "immediate", "confidence": 0.59,
 "timestamp": "2026-09-28T14:31:31", "alert_status": "active"}
\end{verbatim}
