0geder/Tukzie-HPEC-HUD/Report/appendixb.tex

\chapter{Supporting Figures}
\label{app:figures}

The figures below support the text of Chapters~1 and~3, where each is referenced. The printed camera casing of Figure~\ref{fig:camera-casing} has a bottom shell (29.2 by 28.2 by 7.6\,mm) and a top cover (4.8\,mm) that enclose the camera module and its ribbon connection, and a separate 30-degree corner mount (32.3\,mm tall) by which it is to be attached to the vehicle.

\begin{figure}[htbp]
\centering
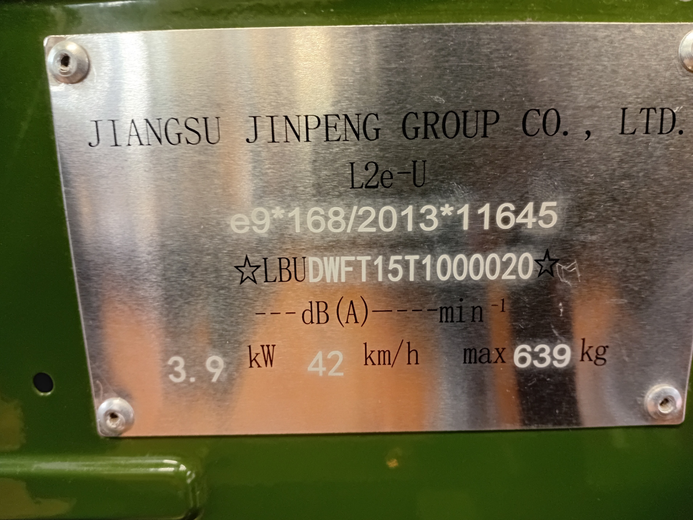
[picture p20: Report/figures/vehicle_nameplate.jpg]

\caption[Manufacturer identification plate on the TUKZIE Rev 0 platform, photographed directly during vehicle inspection]{Manufacturer identification plate on the TUKZIE Rev 0 platform, photographed directly during vehicle inspection.}
\label{fig:vehicle-nameplate}
\end{figure}

\begin{figure}[htbp]
\centering
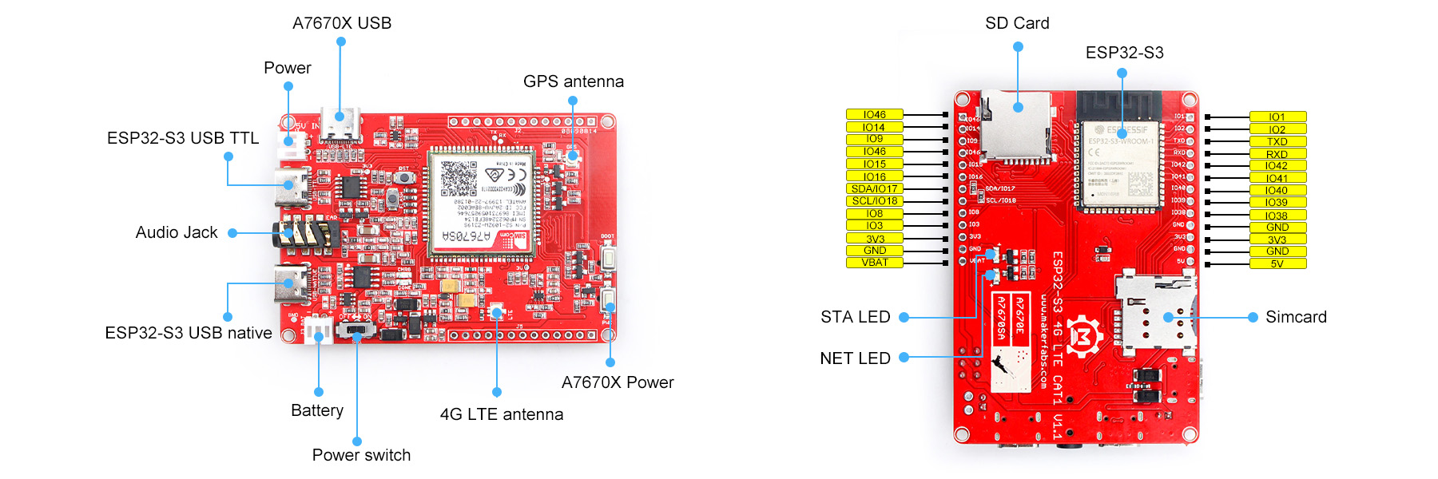
[picture p21: Report/figures/makerfabs_a7670x_pinout.jpg]

\caption[Makerfabs ESP32-S3 4G LTE CAT1 A7670X board: manufacturer-labelled ports (left) and pinout (right) \cite{makerfabsa7670x}]{Makerfabs ESP32-S3 4G LTE CAT1 A7670X board: manufacturer-labelled ports (left) and pinout (right) \cite{makerfabsa7670x}.}
\label{fig:makerfabs-pinout}
\end{figure}

\begin{figure}[htbp]
\centering
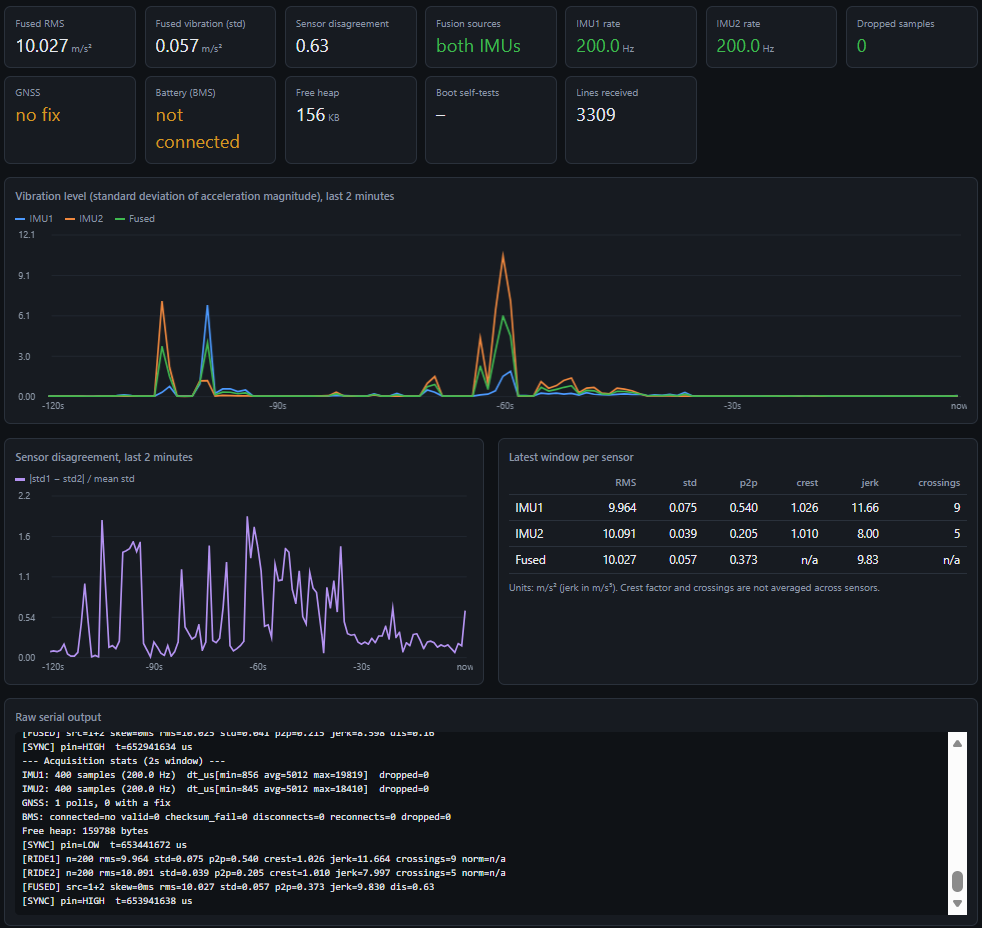
[picture p22: Report/figures/live_dashboard.png]

\caption[The live telemetry dashboard connected to the telemetry unit over USB during bench testing, showing both IMUs fused at 200\,Hz with no dropped samples and two hand disturbances in the vibration plot]{The live telemetry dashboard connected to the telemetry unit over USB during bench testing, showing both IMUs fused at 200\,Hz with no dropped samples and two hand disturbances in the vibration plot.}
\label{fig:live-dashboard}
\end{figure}

\begin{figure}[htbp]
\centering
\begin{tikzpicture}[
  lbl/.style={font=\footnotesize, text width=3.5cm, inner sep=1pt},
  pin/.style={draw=black, fill=white, circle, inner sep=0pt, minimum size=4.5pt},
  lead/.style={line width=0.6pt, draw=black, preaction={draw=white, line width=2.2pt}}]
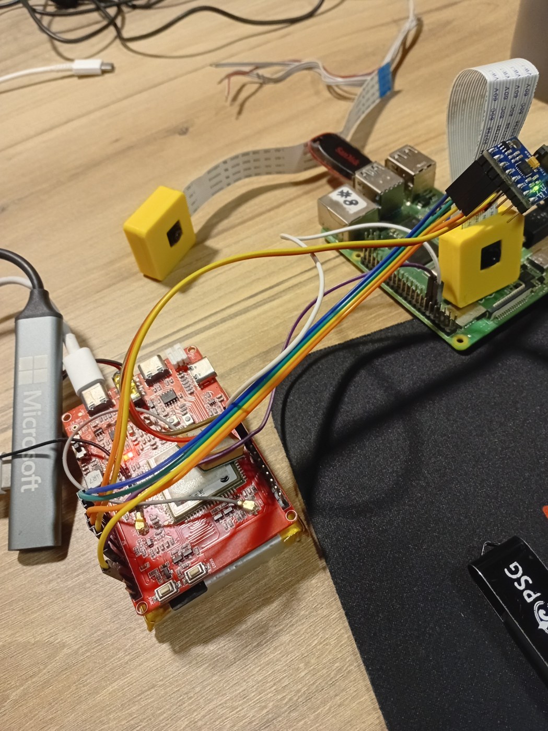
[picture p23: Report/figures/camera_casing_setup.jpg]
\node[anchor=south west, inner sep=0] (img) at (0,0) {};
\begin{scope}[x={(img.south east)}, y={(img.north west)}]
  \node[lbl, anchor=east, align=right] (rib) at (-0.04,0.86) {\textbf{Camera ribbon cable}\\CSI link from the camera to the Raspberry Pi};
  \node[lbl, anchor=east, align=right] (cs1) at (-0.04,0.66) {\textbf{3D-printed camera casing}\\houses and protects the OV5647 camera module};
  \node[lbl, anchor=east, align=right] (esp) at (-0.04,0.30) {\textbf{ESP32-S3 and A7670X board}\\telemetry unit};
  \node[lbl, anchor=west, align=left] (imu) at (1.04,0.88) {\textbf{MPU6050 IMU}\\inertial sensing};
  \node[lbl, anchor=west, align=left] (pi)  at (1.04,0.73) {\textbf{Raspberry Pi 4}\\camera host};
  \node[lbl, anchor=west, align=left] (cs2) at (1.04,0.55) {\textbf{3D-printed camera casing}\\houses the second camera};
  \draw[lead] (rib.east) -- (0.50,0.80); \node[pin] at (0.50,0.80) {};
  \draw[lead] (cs1.east) -- (0.29,0.69); \node[pin] at (0.29,0.69) {};
  \draw[lead] (esp.east) -- (0.33,0.32); \node[pin] at (0.33,0.32) {};
  \draw[lead] (imu.west) -- (0.93,0.79); \node[pin] at (0.93,0.79) {};
  \draw[lead] (pi.west)  -- (0.78,0.75); \node[pin] at (0.78,0.75) {};
  \draw[lead] (cs2.west) -- (0.87,0.64); \node[pin] at (0.87,0.64) {};
\end{scope}
\end{tikzpicture}
\caption[The two cameras in their 3D-printed casings on the bench, before the two-sided layout, when the Raspberry Pi~4 was the camera host]{The two cameras in their 3D-printed casings on the bench, before the two-sided layout, when the Raspberry Pi~4 was the camera host. In the final layout one camera is on the Raspberry Pi~4 at the rear and the other on the Raspberry Pi~5 at the front (Section~\ref{sec:two-sided}).}
\label{fig:camera-casing}
\end{figure}
