0geder/Tukzie-HPEC-HUD/Report/Samson Okuthe - EEE4022S Final Report (2026).tex

% M. S. Tsoeu (2011), University of Cape Town <mohohlo.tsoeu@uct.ac.za>

% This is a project report templace document created for EEE4022FS students at the University of Cape Town.
%
% This file should be is processed with ``pdflatex`` and might need a few modifications if a different processor is chosen.

\documentclass[a4paper,11pt]{report}

%Include packages you need to use here

\usepackage[top = 1in, bottom = 1in, left = 1in, right = 1in]{geometry}
\usepackage{graphicx}
\usepackage{fancyhdr}
\setlength{\headheight}{14.5pt}
\usepackage{amsmath, amsthm, amssymb}
\usepackage{lastpage}
\usepackage{subfigure}
\usepackage{lscape}
\usepackage{hyphenat}
\usepackage{setspace}
\usepackage{longtable}
\usepackage{pdfpages}
\usepackage{float}
\usepackage{array}
\usepackage{tikz}
\input{figures/tikz/sw7styles}
\usepackage{xurl}   % long URLs in the references break at any character (26 Oct 2026)
\usepackage[pagebackref=true]{hyperref}
\definecolor{linkblue}{HTML}{0F3B67}
\hypersetup{colorlinks=true, linkcolor=linkblue, citecolor=linkblue, urlcolor=linkblue, filecolor=linkblue}
\hypersetup{pdftitle={Embedded Telemetry with Road-Surface Characterisation and Camera-Based Hazard Detection for the TUKZIE Electric Trike}, pdfauthor={Samson Okuthe}, pdfsubject={EEE4022S Final Year Project, University of Cape Town, 2026}, pdfkeywords={telemetry, embedded systems, road roughness, IMU, hazard detection, electric trike, TUKZIE}}
% Each reference ends with the pages that cite it, as links back to those pages.
\renewcommand*{\backrefalt}[4]{\ifcase #1 \or {\small(Cited on page~#2.)}\else {\small(Cited on pages~#2.)}\fi}
\renewcommand*{\backreftwosep}{, }
\renewcommand*{\backreflastsep}{, }
\usepackage{qrcode}

% Course handout format: single column, Times New Roman, 11 pt, single line
% spacing, at most 50 content pages. XeTeX (Tectonic) uses the real Times
% New Roman; pdfLaTeX falls back to newtx, a Times clone.
\usepackage{iftex}
\ifXeTeX
  \usepackage{fontspec}
  \setmainfont{Times New Roman}
\else
  \usepackage{newtxtext,newtxmath}
\fi

% Marks results not yet measured, so they are easy to find and replace.
\newcommand{\outstanding}[1]{\textit{[Outstanding: #1]}}

% Include page formatting here.
\parskip = 6mm
\parindent = 0mm
\renewcommand{\headrulewidth}{0pt}
\rhead[]{\thesection}
\lhead[\thechapter]{}

% Float placement: let tables and figures share pages with text instead of leaving gaps (26 Oct 2026)
\renewcommand{\topfraction}{0.9}
\renewcommand{\bottomfraction}{0.8}
\renewcommand{\textfraction}{0.07}
\renewcommand{\floatpagefraction}{0.8}
\setcounter{topnumber}{3}
\setcounter{bottomnumber}{3}
\setcounter{totalnumber}{5}

\begin{document}

% This section formats the title page of the Report.
\thispagestyle{empty}
{\Huge \begin{center}
% Modify the line below to insert your title.
Embedded Telemetry with Road-Surface Characterisation and Camera-Based Hazard Detection for the TUKZIE Electric Trike
\hrule
\end{center}}

\vskip 5mm
\begin{center}
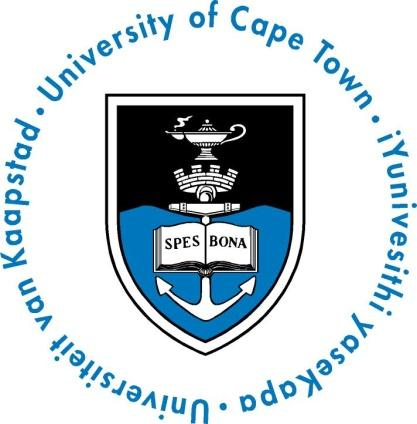
[picture p25: Report/uctLogo.png]
\- \- \- \- \- \- \- \- \- \-
\end{center}

\vskip 5mm
\begin{center}
Presented by:\\
Samson Okuthe\\
Student number: OKTSAM001
\end{center}

\vskip 10mm
\begin{center}
Prepared for:\\
Simon Winberg\\
Co-supervisor: Sampath Jayalath\\
Department of Electrical Engineering\\University of Cape Town
\end{center}

\vskip 10mm
\begin{center}
Submitted to the Department of Electrical Engineering at the University of Cape Town in partial
fulfilment of the academic requirements for a Bachelor of Science degree in Electrical and Computer
Engineering.

\end{center}

\vskip 5mm
\begin{center}{\bf \today}
\end{center}

\newpage

\singlespacing
\nohyphens{
\thispagestyle{empty}
\vskip 40mm

% Plagiarism declaration in the form required by the EEE4022S teaching team (October 2026).
{\Large Plagiarism Declaration}\\
\hrule

\vskip 10mm
\begin{enumerate}
\item I know that plagiarism is wrong. Plagiarism is to use another's work and pretend that it is one's own.
\item I have used the IEEE convention for citation and referencing. Each contribution to, and quotation in, this report from the work(s) of other people has been attributed, and has been cited and referenced. Any section taken from an internet source has been referenced to that source.
\item This report is my own work, and is in my own words (except where I have attributed it to others).
\item \textbf{I have not paid a third party to complete my work on my behalf. My use of artificial intelligence software has been limited to Claude Code (Anthropic), used as a coding and writing assistant: drafting and debugging firmware, Raspberry Pi and dashboard code and tests; running bench commands and the literature search at my direction; and drafting, restructuring and editing report text from my own notes, results and instructions. I directed and checked all of it and am responsible for every claim; examples of the prompts and outputs are in Appendix~\ref{app:ai}.}
\item I have not allowed and will not allow anyone to copy my work with the intention of passing it off as his or her own work.
\item I acknowledge that copying someone else's assignment or essay, or part of it, is wrong, and declare that this is my own work.
\end{enumerate}
\vskip 10mm
Signature: \raisebox{-0.3\height}{}
\\[8pt]Samson Okuthe (OKTSAM001)
\vskip10mm
Date: \today
\vskip10mm
Word count: 18\,079 (body of the report, Chapters 1 to 8)

\newpage
\thispagestyle{empty}
{\Large Terms of Reference}\\
\hrule

Project SW-7, set by A/Prof. Simon Winberg and Sampath Jayalath for the TUKZIE Flagship Programme, is to develop a high-performance embedded computing (HPEC) telemetry unit for the TUKZIE Rev~0 electric cargo trike with a windshield head-up display, the display replaced, by agreement with the supervisors, by integration with the vehicle's existing dashboard. The project is to:
\begin{itemize}
\item acquire synchronised inertial, battery, positioning, camera and environmental (air-quality) data on the vehicle;
\item characterise the vehicle's dynamic response on board, separating road-induced from powertrain vibration;
\item log telemetry locally and synchronise it with a central database over 4G/LTE through intermittent coverage;
\item present a minimal set of safety-relevant information and hazard alerts to the driver on the existing dashboard;
\item keep the installation removable, so that the vehicle can return quickly to its standard set-up;
\item test on the vehicle in a safe setting under an approved ethics application;
\item validate data accuracy, edge processing latency and synchronisation with the database in a technical report.
\end{itemize}

\fancyfoot[C]{\thepage}
\pagestyle{plain}
\newpage
\pagenumbering{roman}
{\Large Acknowledgments}\\
\hrule
I thank my supervisor, A/Prof. Simon Winberg, and co-supervisor, Sampath Jayalath, for their guidance, and the TUKZIE Flagship Programme and its vacation-work teams, whose earlier work on the vehicle's dashboard, sensing and drivetrain this project builds on. I thank Yusuf Vadwa, who is in charge of the laboratory that houses the TUKZIE, for making the vehicle and the space available, for staying long after the laboratory's 17:00 closing so that I could finish my work, and for driving the vehicle on the road sessions. I also thank Maisha Magavha for his careful reviews of several drafts of this report, whose comments sharpened its claims, equations and references.

\newpage

{\Large Abstract}\\
\hrule

% Place your abstract here.
% Place your abstract here.
The TUKZIE Rev 0, a 72\,V electric cargo trike, had no measurement of how it rides, what its battery does or what is around it. This project built a low-cost system that measures all three and shows them on the vehicle's existing dashboard, and tested it on the bench and on the vehicle. Two ESP32-S3 nodes, one at each end, sample an inertial sensor at 200\,Hz and stream every sample with a checksum; a third, the telemetry unit, reads the battery-management system over Bluetooth Low Energy and GNSS, logs every record to flash and publishes it over LTE, replaying what the broker did not acknowledge. A Raspberry Pi~4 at the rear and a Raspberry Pi~5 at the front each run an object detector beside time-of-flight sensors, with fusion and time-to-contact warnings not yet validated; the dashboard shows live data only. On the bench, both sensors were read at 200\,Hz with no queue losses, but each flash write left a gap of up to 44\,ms that the later reads do not fill; after a 10-minute radio outage every logged record reached the database once, 24 only after a backfill from the log; and detection took a median of 118 to 122\,ms from camera readout on the Raspberry Pi~4 and 51 to 54\,ms on the Raspberry Pi~5. On the vehicle the battery link held at up to 82.9\,A, a single calibration factor per sensor held only in the orientation calibrated, and with the drive wheel raised the motor raised the rear vibration five to seven times, between about 40 and 70\,Hz, with the same lines at the front. No reviewed system combines these on a light electric cargo trike; the contribution is that integration and its measurement. On the road, five passes at 10\,km/h on a smooth loop varied by only 5.0 and 5.3\,\% between passes at the two nodes, a rougher loop read about twice as high, the motor's lines held 1 to 3\,\% of the road's vibration energy, and 99.9\,\% of records crossed the wired link. The bench validated the deterministic acquisition and the store-and-forward telemetry; repeatability at higher speeds and place by place, and the driver's glance time, remain open. Videos of the system on the road and of its development are at \url{https://tuksense.site}.

\newpage

\newpage
\tableofcontents
\vfill
\noindent{\small Reading this PDF: section, figure, table and citation numbers are links. Each entry in the References lists the pages that cite it, as links back to them. In Adobe Acrobat and Firefox, Alt+Left Arrow also returns to where a link was clicked; the PDF viewers built into Edge and Chrome do not support this.}

\newpage
{\Large Abbreviations and terms}\\
\hrule
\addcontentsline{toc}{chapter}{Abbreviations and terms}

{\small
\begin{longtable}{|>{\raggedright\arraybackslash}p{2.6cm}|>{\raggedright\arraybackslash}p{11.2cm}|}
\hline
\textbf{Term} & \textbf{Meaning} \\ \hline
\endfirsthead
\hline
\textbf{Term} & \textbf{Meaning} \\ \hline
\endhead
$a_w$, VDV & Frequency-weighted r.m.s.\ acceleration and vibration dose value of ISO~2631-1 \\ \hline
AT command & A text command sent to the modem over its serial line, such as \texttt{AT+CGNSSINFO} \\ \hline
BLE & Bluetooth Low Energy, the radio link to the battery-management system \\ \hline
BMS & Battery-management system of the traction pack \\ \hline
Bridge & The program on a Raspberry Pi (\texttt{telemetry\_bridge.py}) that reads the telemetry unit and the time-of-flight sensors and serves them to the dashboard \\ \hline
Camera unit & A Raspberry Pi with a camera, the detector and three time-of-flight sensors: the Raspberry Pi~5 at the front, the Raspberry Pi~4 at the rear \\ \hline
COCO & Common Objects in Context, the image dataset on which the detector was trained \\ \hline
CV, ICC & Coefficient of variation; intraclass correlation, a measure of agreement between repeated passes \\ \hline
Dashboard line & The one-line JSON record the telemetry unit sends each second for the dashboard \\ \hline
DIO & Dual-I/O, a flash memory access mode \\ \hline
FreeRTOS & The real-time operating system kernel on which the ESP32-S3 firmware runs its tasks \\ \hline
Front node, rear node & The ESP32-S3 boards with one IMU each from 22 October: the front node on the Raspberry Pi~5, the rear node (the telemetry unit) on the Raspberry Pi~4 \\ \hline
Fusion & Matching camera detections with time-of-flight distances by bearing and time \\ \hline
GNSS & Global navigation satellite system: satellite positioning, such as GPS \\ \hline
GPIO & General-purpose input and output pin \\ \hline
HPEC & High-performance embedded computing \\ \hline
HTTP & Hypertext Transfer Protocol, used between the Raspberry Pis \\ \hline
HUD & Head-up display, which places information in the driver's forward view, in the original brief on the windshield \\ \hline
I\textsuperscript{2}C & Inter-Integrated Circuit, a two-wire bus for the IMUs and time-of-flight sensors \\ \hline
IMU & Inertial measurement unit: accelerometer and gyroscope (MPU6050) \\ \hline
IRI & International Roughness Index \\ \hline
JSON & JavaScript Object Notation, the text format of every record \\ \hline
LiDAR & Light detection and ranging \\ \hline
LittleFS & The file system in the telemetry unit's internal flash \\ \hline
LTE & Long Term Evolution, the 4G cellular network; Cat-1 is its low-rate category \\ \hline
MQTT & Message Queuing Telemetry Transport, a publish and subscribe protocol through a broker \\ \hline
NHTSA & National Highway Traffic Safety Administration (United States) \\ \hline
NoIR & A camera module without an infrared-cut filter \\ \hline
PSRAM & Pseudo-static RAM, external memory on the ESP32-S3 module \\ \hline
QoS & Quality of service level of an MQTT publish; at QoS~1 the broker acknowledges each record \\ \hline
R1 to R13 & The engineering requirements of Table~\ref{tab:requirements-mapping} \\ \hline
Raw stream & Every 200\,Hz inertial sample sent to a Raspberry Pi as a checked text line (firmware v0.7.5 on) \\ \hline
RMS & Root mean square \\ \hline
ROC & Receiver operating characteristic: detection rate against false alarms as a threshold is swept \\ \hline
RQ1 to RQ4 & The research questions of Chapter~\ref{chap:intro} \\ \hline
SoC & State of charge of the battery, in per cent \\ \hline
Store-and-forward & Logging every record locally and sending, or replaying, it when coverage allows \\ \hline
T, C, B tests & Test identifiers in \texttt{BenchTest/\allowbreak{}TEST\_\allowbreak{}PROCEDURES.md}: T for the telemetry unit, C for the camera units, B for the bench tools and dashboard \\ \hline
Telemetry unit & The ESP32-S3 board with its modem and GNSS beside the battery (two IMUs up to 21 October, one from 22 October) \\ \hline
ToF & Time of flight: optical ranging by the round-trip time of light (VL53L0X, VL53L5CX) \\ \hline
TRL & Technology Readiness Level \\ \hline
TTC & Time to contact: the time until an object closing at constant speed reaches the vehicle \\ \hline
UART & Universal asynchronous receiver and transmitter, a serial link \\ \hline
USB & Universal Serial Bus \\ \hline
UTC & Coordinated Universal Time \\ \hline
\end{longtable}
}

\newpage
\listoffigures

\newpage
\listoftables

% Page formatting, to place section titles as headers of odd pages and Chapter titles as headers of even pages.
\newpage
\fancyhead[RE,LO]{}
\fancyhead[LE]{\leftmark}
\fancyhead[RO]{\rightmark}
\pagestyle{fancy}

\pagenumbering{arabic}

% THe files included below are .tex files containing the respective chapters these are already created in this package and you can add to or modify them.
\include{Introduction}
\include{Literature}
\include{Method}
\include{Methodology}
\include{Results}
\include{Discussion}
\include{Conclusions}
\include{Recommendations}
\include{References}
\appendix
\include{appendixa}
\include{appendixb}
\include{appendixd}
\include{appendixc}
\include{appendixe}
\include{appendixf}
\include{appendixg}
\include{appendixh}
\include{appendixi}
\include{appendixj}
\include{appendixk}
}
\end{document}
