0geder/Tukzie-HPEC-HUD/Report/Introduction.tex

\chapter{Introduction}
\label{chap:intro}

\section{The vehicle and the problem}

Where electric cargo trikes have been measured in daily delivery work, they have cost far less to run than the motorcycles and small cars they replace (Section~\ref{sec:lit-trikes}). The TUKZIE Flagship Programme of the University of Cape Town \cite{tukzie2026web} is developing such a vehicle as an energy-aware, secure and autonomy-ready platform \cite{winberg2026} for last-mile logistics in growing cities \cite{unwup2019}. Its testbed is the TUKZIE Rev~0, a 72\,V trike made by Jinpeng \cite{jinpengmanual}. Its hub motor is rated at about 2.5\,kW input \cite{adamsrasara2026}, while the vehicle's plate gives 3.9\,kW output and 42\,km/h (Figure~\ref{fig:vehicle-nameplate}); the two disagree and neither was measured.

When the project began, the trike's Raspberry Pi~5 touchscreen dashboard showed only simulated values (Section~\ref{sec:dashboard-link}). Nothing measured its response to the road or powertrain, read the battery or recorded a journey. Road traffic injuries are a leading cause of death, mostly in low- and middle-income countries \cite{who2023}, so hazard alerts are worth having, but only if the display does not itself distract: US NHTSA guidance accepts an in-vehicle task when, across test drivers, glances away from the road mostly last 2\,s or less and total 12\,s or less for the task \cite{nhtsa2013}.

The engineering problem \cite{winberg2026} is to acquire synchronised data reliably on a high-vibration, power-constrained vehicle and tell road-induced motion from the vehicle's own dynamics. Latency must stay bounded, telemetry must survive gaps in coverage, and the result must not block the driver's view or depend on a remote service. The objective is a high-performance embedded computing (HPEC) telemetry unit for the TUKZIE Rev~0, integrated with its existing dashboard. The unit acquires synchronised inertial, battery, positioning and camera data, characterises the vehicle's response on board, keeps telemetry through coverage gaps and shows the driver only essential safety information.

\section{Deliverables and scope change}

The project started from a brief set by the supervisors, and its scope changed as the work showed what the vehicle needed. The brief \cite{winberg2026} asked for (1) a telemetry module with environmental, air-quality and inertial sensors and an optical windshield head-up display (HUD); (2) a deterministic multi-threaded software architecture for sensor fusion, ride metrics and the display; and (3) a technical report validating the data, edge latency and synchronisation with a central database over 4G/LTE. With the supervisor's agreement, the HUD was replaced by integration with the existing dashboard, because a second display would compete for the same attention \cite{zhu2021} (Section~\ref{sec:lit-display}). The title was changed on 2, 23 and 26 October to follow the work. A camera hazard detector was then added, later joined by time-of-flight proximity sensing and, in October, a second camera and sensor board at the rear that warns of approaching objects. The aim is a prototype demonstrated on the vehicle at Technology Readiness Level 6 \cite{kimmel2020}, not a product for unrestricted road use.

\section{Research questions}
\label{sec:rqs}

The literature search found no system that does all of the following on a light electric cargo trike: fixed-rate inertial acquisition with measured timing and loss, on-board ride features, camera and range fusion, cellular telemetry with local logging and replay, and display on the vehicle's own dashboard (Section~\ref{sec:lit-synthesis}, Table~\ref{tab:gap}). The contribution sought is this integration and its measurement, not any one component:

\begin{enumerate}
\item[RQ1] How accurately and repeatably can a low-cost edge-processing system characterise the trike's dynamic response to road- and powertrain-induced excitation in real time, using inertial sensors on a 72\,V electric cargo trike?
\item[RQ2] Which information hierarchy, layout and update strategy can present safety-critical telemetry and hazard alerts on the vehicle's existing dashboard while limiting visual clutter and driver distraction?
\item[RQ3] What end-to-end latency, data-loss and recovery performance can be achieved across sensor acquisition, edge processing, local logging and 4G/LTE synchronisation?
\item[RQ4] Which time- and frequency-domain features most effectively separate road-induced vibration from repeatable motor and powertrain vibration?
\end{enumerate}

In RQ1, accuracy means the accuracy of the instrument: its sampling rate, sample loss, calibration and feature computation. No reference profile or reference accelerometer was available for the ride itself, so for the road part of RQ1 only repeatability can be assessed, not accuracy.

\section{Engineering requirements and acceptance criteria}
\label{sec:requirements-mapping}

The requirements in Table~\ref{tab:requirements-mapping} turn the brief and the research questions into testable targets. Each has an acceptance criterion fixed before its test, except T1, which was run before the procedures were written. Where the literature gives a figure, the criterion uses it: the 160\,Hz sampling floor is the Nyquist rate of the 80\,Hz band of ISO~2631-1 \cite{iso2631}, the 2\,s glance target follows NHTSA's guidance \cite{nhtsa2013}, and the store-and-forward criteria follow the completeness, duplicate and recovery measures of Section~\ref{sec:lit-sync}. Where it does not, the figure comes from the vehicle or the brief, such as a resting magnitude within 0.1\,\% of gravity, a sync pulse within 20\,ms and a removal in about 20 minutes. RQ1 rests mainly on R1 to R4 and R6, RQ2 on R7, R8 and R10 to R12, RQ3 on R5, R9 and R10, and RQ4 on R3 with the stand and road analysis of Section~\ref{sec:data-analysis}. Chapter~\ref{chap:results} reports each requirement against its criterion (Table~\ref{tab:results-summary}).

\begin{table}[htbp]
\centering
\footnotesize
\caption[Engineering requirements, acceptance criteria and the research question each serves]{Engineering requirements, acceptance criteria and the research question each serves.}
\label{tab:requirements-mapping}
\begin{tabular}{|p{0.7cm}|p{4.1cm}|p{6.3cm}|p{0.8cm}|p{1.7cm}|}
\hline
\textbf{ID} & \textbf{Requirement} & \textbf{Acceptance criterion} & \textbf{RQ} & \textbf{Test} \\ \hline
R1 & Fixed-rate dual-IMU acquisition above 160\,Hz, the Nyquist rate of the 80\,Hz ISO~2631-1 band & Both IMUs at 195\,Hz or more; zero dropped samples; with logging off no inter-sample gap over 10\,ms, with buffered logging gaps over 10\,ms only at a flush & 1, 3 & T1, T2, T9 \\ \hline
R2 & Per-sensor calibration & Resting magnitude 9.80 to 9.82\,m/s\textsuperscript{2} on both IMUs & 1 & T4 \\ \hline
R3 & Correct on-board features and fusion & Synthetic-sine self-test within 5\%; all fusion self-tests pass; every fused window from both sensors & 1, 4 & T1 \\ \hline
R4 & Position & 3D fix; parsed position within 10\,m of a phone reference; no damaged reply accepted & 1, 3 & T3 \\ \hline
R5 & Battery telemetry & Connection and checksum-valid frames; pack voltage matches a meter & 3 & T7 \\ \hline
R6 & Camera to IMU time alignment & About 2 edges/s; median interval 500\,ms; none outside 500 $\pm$ 20\,ms & 1 & C6 \\ \hline
R7 & Hazard detection & Runs a full minute at 5\,frames/s or more; person logged as person; alert onset (three frames plus latency) under about 0.5\,s & 2, 3 & C1, C2, C8 \\ \hline
R8 & Proximity range & Three sensors answer and respond to the matching hand; within about 5\% of a tape below 1\,m; fused distance median error 5\,cm or less at 0.5 and 1.0\,m & 2 & C7, C9 \\ \hline
R9 & Store-and-forward telemetry & Acknowledged publishes; loss reported and reconnection without intervention after coverage returns; every stored record read back intact and parsing; every record stored once in the database after an outage & 3 & T5, T6, T10, T15 \\ \hline
R10 & Local dashboard link & One line per second, no missing sequence numbers, valid JSON; record under 3\,s old at the dashboard; IMUs unaffected & 2, 3 & T11, T12 \\ \hline
R11 & Driver display shows only valid data & Only live values, ``-{}-'' when missing, never simulated values; camera alerts listed and cleared; offline state shown & 2 & B2, B3 \\ \hline
R12 & Glance demand & Single glances within 2\,s, a project target based on the NHTSA criteria \cite{nhtsa2013} & 2 & none (Section~\ref{sec:ethics}) \\ \hline
R13 & Removable installation & No drilling or permanent change; vehicle back to standard in about 20\,min & all & VIT-001 \\ \hline
\end{tabular}
\end{table}

\section{Scope and limitations}
\label{sec:scope}

Three parts were delivered, bench-tested and run on the vehicle, with GNSS and LTE publishing tested on the moving vehicle only briefly (27 October). They are the ESP32-S3 telemetry unit (GNSS, battery-management system over Bluetooth Low Energy, LTE, local logging, replay into a database), joined on 22 October by a front IMU node and on 26 October by a rear one; forward and rear camera units, each with a pretrained detector and three time-of-flight sensors (fusion not yet validated); and dashboard integration. In scope but not delivered, so future work (Chapter~\ref{chap:recs}): the SEN55 air-quality sensor, damaged in wiring (Section~\ref{sec:impl-other}); the VL53L5CX time-of-flight sensor, not received; the motor Hall tap; and LTE publishing that recovers on the moving vehicle. Road-surface characterisation here means the vehicle's ride response and bump events, not a road profile measured as a roughness index \cite{fhwa2016} (Section~\ref{sec:lit-roughness}). The limitations are one vehicle and one hardware set, an advisory-only pretrained detector at automation level 0 \cite{saej3016}, mounted calibration outside its criterion on the road day, short low-speed vehicle sessions and mostly bench results. This scope follows the brief's order, a working baseline before machine learning or autonomy \cite{winberg2026}, and the staged validation of a prototype towards Technology Readiness Level 6 \cite{kimmel2020}.
