0geder/Tukzie-HPEC-HUD/Report/Methodology.tex

\chapter{Design}
\label{chap:design}

This chapter describes the system as driven on 27 October 2026 (phase~3, Section~\ref{sec:phases}), with the analysis behind each parameter. Each section names the requirements of Table~\ref{tab:requirements-mapping} and the research questions it serves. Pins, formats, thresholds and version history are in Appendix~\ref{app:impl}, the firmware configuration in Table~\ref{tab:config} and every connection in Appendix~\ref{app:wiring}.

\section{System overview and architecture selection}
\label{sec:architecture}

The architecture has to meet all thirteen requirements, but two decided it: R1, fixed-rate acquisition with no loss, and R7, detection at a useful frame rate. Figure~\ref{fig:system-architecture} shows the system. Two ESP32-S3 nodes each sample one inertial measurement unit (IMU) at one end of the vehicle, and a third, the telemetry unit beside the battery, reads GNSS and the battery-management system (BMS), logs to flash and publishes over LTE; until 26 October it also carried the rear IMU. Two camera units each run the detector and fuse it with three time-of-flight sensors: a Raspberry Pi~5 behind the display faces forward, runs the dashboard and reads the front node; a Raspberry Pi~4 beside the battery faces backward and reads the rear node and the telemetry unit. An Ethernet cable joins the two.

\begin{figure}[htbp]
\centering
\input{figures/tikz/system_architecture}
\caption[The system as driven on 27 October 2026: the Raspberry Pi~5 beside the display runs the dashboard, the front camera unit and the front node (an ESP32-S3 with one IMU, Section~\ref{sec:impl-front}); the Raspberry Pi~4 beside the battery runs the rear camera unit and reads the telemetry unit (battery, GNSS, LTE) and, from 26 October, the rear IMU node (Section~\ref{sec:res-integration}); the two are joined by an Ethernet cable (Section~\ref{sec:two-sided})]{The system as driven on 27 October 2026: the Raspberry Pi~5 beside the display runs the dashboard, the front camera unit and the front node (an ESP32-S3 with one IMU, Section~\ref{sec:impl-front}); the Raspberry Pi~4 beside the battery runs the rear camera unit and reads the telemetry unit (battery, GNSS, LTE) and, from 26 October, the rear IMU node (Section~\ref{sec:res-integration}); the two are joined by an Ethernet cable (Section~\ref{sec:two-sided}). A phone's GNSS gives speed (Section~\ref{sec:impl-phone-gps}). Programs are named by their files in the repository. Dashed outline: built but not yet connected on the vehicle.}
\label{fig:system-architecture}
\end{figure}

Table~\ref{tab:architectures} compares the feasible architectures. The deciding requirements were R1 (a fixed 200\,Hz period with no loss) and R7 (detection at a useful frame rate). A microcontroller under FreeRTOS holds a fixed period but cannot run a camera network at a useful rate; a Raspberry Pi runs the network, but a general-purpose Linux scheduler does not guarantee a 5\,ms period. The split keeps each function where its timing is predictable. Table~\ref{tab:design-params} lists the parameters that follow and where each is derived.

\begin{table}[htbp]
\centering
\small
\caption[Feasible architectures compared]{Feasible architectures compared. Figures are measured in this project unless marked; power was measured only on the Raspberry Pi~5 (Table~\ref{tab:power-budget}).}
\label{tab:architectures}
\begin{tabular}{|p{2.0cm}|p{2.9cm}|p{2.1cm}|p{1.7cm}|p{2.2cm}|p{2.1cm}|}
\hline
\textbf{Option} & \textbf{Workload} & \textbf{Power} & \textbf{Memory} & \textbf{Interfaces} & \textbf{Latency, timing} \\ \hline
ESP32-S3 alone & Dual 200\,Hz sampling, features, BLE, modem: yes. Camera network at a useful rate: no & Not measured (about 1\,W estimated) & 16\,MB flash, 8\,MB PSRAM (not used) & Two I\textsuperscript{2}C, UARTs, BLE, native USB; LTE and GNSS on the board & 5\,ms period held, 200.0 to 200.5\,Hz \\ \hline
Raspberry Pi alone & Detector alone at 19.5 (Pi~4) and 19.2\,frames/s (Pi~5); fixed-period sampling not guaranteed & Pi~5 with the dashboard: 2.2 to 3.0\,W on its rails; Pi~4 not measured & Not a constraint in testing & I\textsuperscript{2}C, CSI camera, Wi-Fi, USB; no LTE modem & Detector median 102\,ms (Pi~4), 51 to 54\,ms (Pi~5); sampling jitter not bounded \\ \hline
As built: three ESP32-S3 boards, Pi~4 (rear), Pi~5 (front and dashboard) & Acquisition on the ESP32 nodes; vision, fusion and display on the Pis & Pi~5 as above, measured before its camera unit was added; the rest estimated, about 20\,W in all & As above & Pulse wire per node for timing; telemetry unit on a wired UART; front node, and from 26 October the rear IMU node, on USB; Ethernet between the Pis & 5\,ms acquisition on both nodes; detection 51 to 54\,ms (front), 118 to 122\,ms (rear, whole system); 1\,Hz dashboard line \\ \hline
Pi~5 with Hailo-8 accelerator (not tested) & Detector at camera rate expected & Not measured & 16\,GB & Accelerator not yet enabled on the PCIe bus & Not measured \\ \hline
\end{tabular}
\end{table}

\begin{table}[htbp]
\centering
\small
\caption[Design parameters and their derivation]{Design parameters and their derivation.}
\label{tab:design-params}
\begin{tabular}{|p{2.9cm}|p{2.9cm}|p{6.9cm}|p{1.2cm}|}
\hline
\textbf{Parameter} & \textbf{Value} & \textbf{Basis} & \textbf{Serves} \\ \hline
IMU sample rate $f_s$ & 200\,Hz & Above 160\,Hz, the Nyquist rate of the 80\,Hz ISO~2631-1 band \cite{iso2631} & R1 \\ \hline
IMU low-pass filter & 94\,Hz, 3.0\,ms delay & Widest setting below $f_s/2$; images from above 100\,Hz only partly suppressed (Equation~\ref{eq:alias}) & R1, RQ4 \\ \hline
IMU queue depth & 100 samples (0.5\,s) & At least 9 samples for the 44\,ms flash pause (Equation~\ref{eq:buffer}) & R1 \\ \hline
Catch-up limit & 20 periods (100\,ms) & Above the 44\,ms pause, so it is caught up; a longer stall gives up its slots & R1 \\ \hline
Feature window & $N = 200$ (1\,s) & One feature record a second for the dashboard line & R3, R10 \\ \hline
Rear link & 460\,800\,baud, about 46\,kB/s & At most two raw streams and the dashboard line need about 15\,kB/s & R10 \\ \hline
Sync pulse & Edge every 500\,ms & Clock map with offset and drift (Section~\ref{sec:sync-pulse}) & R6 \\ \hline
Alert onset, clear & 3 frames, 5 frames & Onset delayed by two frame intervals; one missed frame cannot clear & R7 \\ \hline
Time-to-contact fit & 0.6\,s, at least 5 frames, growth at least 5\,\% & Error model (Equation~\ref{eq:ttc-error}); the growth gate admits $\tau \le 12$\,s & R7 \\ \hline
Time-to-contact alert & 4\,s warning, 2\,s immediate & Released at 1.25 times the threshold & R7 \\ \hline
Delay search & 0.03 to 1.5\,s & Covers $L/v$ at 10 to 20\,km/h for wheelbases of 0.17 to 4.1\,m; error budget in Table~\ref{tab:delay-budget} & RQ1 \\ \hline
\end{tabular}
\end{table}

\section{Hardware}
\label{sec:hardware}
\label{sec:camera-mount}

The hardware was chosen to meet the sensing and installation requirements (R1, R4 to R6, R8 and R13). The telemetry unit (the rear node until 26 October) is a Makerfabs ESP32-S3 board whose A7670X LTE modem also contains the GNSS receiver \cite{makerfabsa7670x} (Figure~\ref{fig:makerfabs-pinout}, Appendix~\ref{app:figures}), so processor, modem and GNSS needed no separate circuit; the front node and, from 26 October, the rear IMU node are bare ESP32-S3 boards. Each MPU6050 IMU has its own I\textsuperscript{2}C bus. Each camera unit has an OV5647 camera and three VL53L0X time-of-flight sensors in a casing printed in this project (Figure~\ref{fig:camera-casing}). Mounts are in Appendix~\ref{app:mechanical}, pins in Section~\ref{sec:impl-hardware}.

\section{Firmware architecture}
\label{sec:dual-imu-architecture}
\label{sec:acquisition-instrumentation}
\label{sec:raw-stream}
\label{sec:imu-health}
\label{sec:front-node}

The firmware has to hold a fixed 200\,Hz sampling period with no silent loss (R1) and time-stamp each sample so that it can be aligned with the cameras (R6); both properties underpin RQ1 and RQ3. One source builds all three boards (PlatformIO, Arduino on FreeRTOS). Each IMU task runs at the highest priority on core~1 and holds a 5\,ms period with \texttt{vTaskDelayUntil}, which schedules each wake-up from the previous target, so execution time does not accumulate into drift. Every consumer of samples and the modem, BMS and dashboard tasks run on core~0, so processing never shares a core with acquisition (Section~\ref{sec:inv-stall}). A full queue drops and counts the new sample rather than block. The supporting mechanisms (Table~\ref{tab:fw-mechanisms}) and the task diagram (Figure~\ref{fig:task-architecture}) are in Section~\ref{sec:impl-fw}.

\subsection{Sampling and anti-aliasing}
\label{sec:sampling}

The MPU6050 low-pass filters its accelerometer and updates its output registers at 1\,kHz \cite{invensense2012rm}; reading them every 5\,ms decimates that stream to $f_s = 200$\,Hz with no further filtering. A component at frequency $f$ appears at
\begin{equation}
f_a = \lvert f - k f_s \rvert, \qquad k = \operatorname{round}(f/f_s),
\label{eq:alias}
\end{equation}
so anything between 100 and 200\,Hz folds to $200 - f$. The setting used, 94\,Hz bandwidth with 3.0\,ms delay \cite{invensense2012rm}, is the widest below the 100\,Hz Nyquist frequency; the next, 44\,Hz, would attenuate the top of the 80\,Hz ISO band and the powertrain lines that RQ4 needs. The register map does not give the filter's order. The lines measured on the stands at 42.75, 49.0 and 64.0\,Hz (Figure~\ref{fig:res-stands}) could be images of 157.25, 151.0 and 136.0\,Hz, which a first-order response at 94\,Hz attenuates by only 5.8, 5.5 and 4.9\,dB, and a second-order Butterworth response by 9.5, 8.8 and 7.3\,dB. A line 10\,dB above the floor, the powertrain criterion, could therefore be the image of a stronger component. Speed separates them: a motor order $f = k\Omega$ rises with wheel speed $\Omega$ while its image $f_s - k\Omega$ falls, which stand runs at three settings with a wheel video would resolve (Section~\ref{sec:impl-run2}). The 3.0\,ms filter delay is the same on both nodes and cancels in the front-to-rear delay.

\subsection{Riding through the flash-write pause}
\label{sec:buffering}

A flash write suspends code running from flash on both cores for $T_p = 33$ to 44\,ms (Table~\ref{tab:res-acquisition}), stopping producers and consumers alike. Afterwards each IMU task runs its missed slots back to back, so every queue must accept
\begin{equation}
n_p = \lceil T_p f_s \rceil = \lceil 0.044 \times 200 \rceil = 9
\label{eq:buffer}
\end{equation}
samples on top of its normal fill. The IMU queues hold 100 samples, eleven times $n_p$, so a consumer may stall for 0.5\,s before a sample is lost; the ride-feature and raw-stream queues hold 400 and 200. The catch-up limit of 20 periods is 2.3 times the longest pause, so the pause is caught up while a longer stall, such as a failing bus, gives up its slots. Writing the log once a minute makes the pause rarer, not shorter. The sensor's FIFO is not used, so the caught-up reads are new readings, not the missed instants: each pause leaves a hole of up to 44\,ms, 4.4\,\% of a window, visible in the timestamps. Reading the FIFO would fill it.

\section{Ride-characterisation signal processing}
\label{sec:ride-characterisation}

The ride features turn the raw samples into the measures that RQ1 and RQ4 need, and must be calibrated (R2) and computed correctly (R3). A task per IMU computes time-domain features from each one-second window of $N = 200$ samples ($\Delta t = 1/f_s$). The mounting has not been related to a vehicle frame, so the orientation-free magnitude is used:
\begin{equation}
a_k = s\,\sqrt{a_{x,k}^2 + a_{y,k}^2 + a_{z,k}^2} \approx g + a_{v,k} + \frac{\lvert \mathbf{a}_{h,k} \rvert^2}{2g},
\label{eq:magnitude}
\end{equation}
where $s$ is the sensor's calibration factor and $a_{v,k}$ and $\mathbf{a}_{h,k}$ are the dynamic acceleration along and across gravity. While the dynamic acceleration is small against $g$, the magnitude's fluctuation is the vertical vibration, plus a second-order term from horizontal motion. From the window,
\begin{align}
\mu &= \frac{1}{N}\sum_{k=1}^{N} a_k, &
a_{\mathrm{RMS}} &= \sqrt{\frac{1}{N}\sum_{k=1}^{N} a_k^2}, &
\sigma &= \sqrt{\frac{1}{N}\sum_{k=1}^{N} a_k^2 - \mu^2}, \label{eq:mean-rms-std}\\
a_{\mathrm{pp}} &= \max_k a_k - \min_k a_k, &
\mathrm{CF} &= \frac{\max_k a_k}{a_{\mathrm{RMS}}}, &
\bar{J} &= \frac{1}{N-1}\sum_{k=2}^{N} \frac{\lvert a_k - a_{k-1}\rvert}{\Delta t}, \label{eq:pp-cf-jerk}
\end{align}
and the threshold count is the number of samples with $a_k > \mu + 2\sigma$. Since $a_k$ includes gravity, CF is about 1 at rest and, with the threshold count, serves only as a relative indicator; $\sigma$ is the vibration measure used. The ISO~2631-1 weighting is not applied on the unit, so these features describe vibration exposure, not comfort; the offline analysis computes the weighted value (Section~\ref{sec:road-analysis}). A synthetic sine checks the code at every boot (Section~\ref{sec:impl-ride}).

\subsection{Per-sensor calibration}
\label{sec:imu-magnitude-calibration}

Two nominally identical sensors at rest read about 8\,\% apart. One factor per sensor (Equation~\ref{eq:calibration}), from 200 stationary readings and kept in non-volatile storage, corrects the magnitude; it is reused at boot, since the vehicle may be powered while moving, and recalibrated in place by command. It holds only in the orientation in which it was measured (Section~\ref{sec:impl-cal}).

\subsection{Speed-normalised index}
\label{sec:speed-norm}

The same road driven faster gives a larger response. Following Li et al., who classify roughness from acceleration mean square divided by speed \cite{li2018}, each window also computes
\begin{equation}
I_v = \frac{\sigma^2}{v}, \qquad v \ge v_{\min},
\label{eq:speed-index}
\end{equation}
where $v$ is the GNSS speed. The $1/v$ scaling follows from a stated model. ISO~8608 describes a road profile by its displacement spectral density in spatial frequency $n$ \cite{agostinacchio2014},
\begin{equation}
G_d(n) = G_d(n_0)\left(\frac{n}{n_0}\right)^{-w}, \qquad n_0 = 0.1\,\mathrm{cycles/m}, \quad w = 2.
\label{eq:road-psd}
\end{equation}
At speed $v$ the wheel meets temporal frequency $f = vn$, and conserving variance gives $G_q(f) = G_d(f/v)/v$, so the vertical input velocity has the white spectral density
\begin{equation}
G_{\dot q}(f) = (2\pi f)^2 G_q(f) = 4\pi^2 n_0^2\, G_d(n_0)\, v .
\label{eq:road-velocity}
\end{equation}
For a response linear in the input, with $H(f)$ from input velocity to measured acceleration,
\begin{equation}
\sigma^2 = \int_0^{\infty} \lvert H(f) \rvert^2 G_{\dot q}(f)\,df = 4\pi^2 n_0^2\, G_d(n_0)\, v \int_0^{\infty} \lvert H(f) \rvert^2 df,
\label{eq:iv-derivation}
\end{equation}
so $\sigma^2/v$ depends on the road class and the vehicle, not on speed. The assumptions are the model's, not measured facts: $w = 2$ (otherwise $\sigma^2 \propto v^{w-1}$), a linear, stationary response, and $\sigma$ set by the road rather than the powertrain lines of Section~\ref{sec:sampling}. The second road session tested the consequence, $I_v$ constant from 10 to 20\,km/h (Section~\ref{sec:road-analysis}), and found it rose with speed (Section~\ref{sec:res-stands}). The GNSS speed is unchecked and the sensors are on the body, not the unsprung mass, so $I_v$ supports relative comparison within one dataset, not a roughness class (Section~\ref{sec:impl-speed}).

\subsection{Two-sensor comparison and speed from the front-to-rear delay}
\label{sec:imu-fusion}

A road feature reaches the two ends at different times, so the nodes are compared, not averaged (the earlier averaging is in Section~\ref{sec:impl-fusion}). The analysis gives per-sensor features over common windows and the front-to-rear delay $\tau_d$, the lag of the cross-correlation peak of front and rear vertical acceleration, refined by a parabola. With wheelbase $L$,
\begin{equation}
v = \frac{L}{\tau_d}, \qquad
\left(\frac{\delta v}{v}\right)^2 \approx \left(\frac{\delta L}{L}\right)^2 + \left(\frac{\delta \tau_d}{\tau_d}\right)^2, \qquad
\frac{\delta \tau_d}{\tau_d} = \frac{v\,\delta t}{L},
\label{eq:delay-speed}
\end{equation}
with no GNSS. The timing error $\delta t$ (Table~\ref{tab:delay-budget}) is budgeted at 5.3\,ms, provisional until the fixed offsets are measured, 1.8\,\% of a 0.3\,s delay, growing in proportion to speed; a wheelbase taped to $\pm 1$\,cm adds 1\,\% for a 1\,m wheelbase, less for a longer one. Both are inside the proposed 10\,\% criterion against the video speed if the unknown offsets are within their proposed bound, which is not yet measured; correlation is the larger risk, because the front wheel and the two rear wheels run on different tracks and only full-width features such as a speed bump are used (Section~\ref{sec:impl-road}).

\begin{table}[htbp]
\centering
\small
\caption[Timing error budget of the front-to-rear delay]{Timing error budget of the front-to-rear delay.}
\label{tab:delay-budget}
\begin{tabular}{|p{4.6cm}|p{3.4cm}|p{6.0cm}|}
\hline
\textbf{Source} & \textbf{Size} & \textbf{Treatment} \\ \hline
Correlation peak at $f_s = 200$\,Hz & $\pm 2.5$\,ms (half a sample) & Parabolic refinement; the bound is before refinement \\ \hline
Each node's clock to its Pi's (sync pulse) & Edge timestamps spread under 0.7\,ms & Straight line fitted over many edges, with the drift; the fallback, receive times of the raw lines, adds the serial latency \\ \hline
Raspberry Pi~4 to Pi~5 (chrony over Ethernet) & Error bound $\pm 0.079$\,ms (measured) & None needed \\ \hline
IMU filter delay & 3.0\,ms on each node & Same setting on both nodes; cancels \\ \hline
Fixed offsets (each Pi's GPIO latency, sensor position against the axle) & Unknown & In-situ zero from ten mallet strikes midway between the nodes; proposed criterion $\pm 2$\,ms, counted at that bound until measured \\ \hline
Worst-case sum & 5.3\,ms & \\ \hline
\end{tabular}
\end{table}

\section{Vehicle inputs: battery, position and others}
\label{sec:bms-interface}
\label{sec:gnss-parsing-validation}
\label{sec:gnss-outdoor}
\label{sec:environmental-sensing}
\label{sec:hall-tap}

Position and battery state give the context for the ride data (R4, R5): speed for RQ1, delivery for RQ3 and motor load for RQ4. Table~\ref{tab:vehicle-inputs} gives the design of each input. Two choices carry the rest: every parser checks its input before trusting it, because the documentation available did not match the hardware (Sections~\ref{sec:inv-gnss} and~\ref{sec:impl-bms}), and the telemetry unit sits beside the pack because the BMS link did not reach the front (Section~\ref{sec:impl-twosided}).

\begin{table}[htbp]
\centering
\small
\caption[Vehicle inputs (details in the sections named)]{Vehicle inputs (details in the sections named).}
\label{tab:vehicle-inputs}
\begin{tabular}{|p{2.4cm}|p{8.0cm}|p{3.8cm}|}
\hline
\textbf{Input} & \textbf{Design} & \textbf{Reason} \\ \hline
BMS, JBD protocol over BLE (\ref{sec:impl-bms}) & One reused client; reconnection on disconnect; framing from the declared length; checksum and plausibility check; offsets confirmed against a teammate's parser & Inherited code leaked clients and framed on a byte that can occur in the data \\ \hline
GNSS in the modem (\ref{sec:impl-gnss}) & Polled every 3\,s; raw reply logged; parser anchored on the latitude hemisphere letter; fix rejected for an invalid format or a jump over 100\,m/s & The manual \cite{simcoma76xx} did not match the fitted modem \\ \hline
Network position & About 550\,m accuracy; map only, never speed or $I_v$ & Too coarse for speed \\ \hline
Phone GNSS (\ref{sec:impl-phone-gps}) & NMEA over the phone's hotspot; dashboard speed when fresh & No fix in the lab; no speed signal on the vehicle \\ \hline
SEN55 air quality \cite{sensirionsen5x} (\ref{sec:impl-other}) & Chosen; first unit damaged in wiring, replacement to fit & Conditions on the vehicle's timeline \\ \hline
Motor Hall signal (\ref{sec:impl-other}) & Hardware pulse counter behind an optocoupler, at no cost to the IMU tasks & Relates powertrain lines to motor speed (RQ4) \\ \hline
\end{tabular}
\end{table}

\section{Camera subsystem}
\label{sec:camera-subsystem}

The camera subsystem detects hazards (R7), measures their distance (R8) and passes them to the dashboard (R10, R11), with frames aligned to the inertial data (R6). It serves RQ2 directly, and RQ1 and RQ3 through its timing.

\subsection{Capture and synchronisation}
\label{sec:sync-pulse}

The camera gives a visual record against which inertial events can be labelled, but it is on another board than the IMU. Each ESP32 therefore toggles a pin every 500\,ms and logs the microsecond time of each edge, and its Raspberry Pi timestamps each edge through the kernel's GPIO character device, on the monotonic clock of the camera's frame timestamps \cite{picamera2manual}. A straight line fitted to the edge pairs maps node time to Pi time, with offset and drift: the measured 500.06\,ms median interval means about 120 parts per million, 0.4\,s an hour (Section~\ref{sec:impl-sync}).

\subsection{Detection}
\label{sec:hazard-detection}

The detector runs a pretrained SSD-MobileNet-v1 \cite{liu2016ssd, howard2017mobilenets}, trained on COCO \cite{lin2014coco} and quantised to 8-bit integers \cite{jacob2018quantization} for LiteRT \cite{litert}, which needs no training data and no accelerator (Section~\ref{sec:lit-detection}). It reports vehicles, cyclists, pedestrians and animals in three distance bands from the box width and an assumed object width; the focal length is not calibrated, so the bands are indicative. An alert needs three consecutive frames and clears after five without the object. Each alert keeps five fields (class, band, confidence, time, status), and an approaching-object alert four more (approaching, track, time to contact, side); frames stay in memory, nothing recognises faces or plates, inference is local and the output is advisory. A YOLO11n pothole model \cite{ultralytics2024yolo11, gerapothole, nienaber2015dataset} is an experimental path, off by default, because it slows the detector \cite{ncnn} (Section~\ref{sec:impl-detect}).

\subsection{Range sensing and fusion}
\label{sec:tof-sensor}
\label{sec:camera-tof-fusion}

The chosen VL53L5CX (8$\times$8 zones) had not arrived, so three VL53L0X sensors facing left, ahead and right stand in on each camera unit, on the Pi's own bus; one that does not answer is skipped and looked for again (Section~\ref{sec:inv-tof}). The camera gives class and bearing but not distance; a time-of-flight sensor gives distance close by, without a class. A detection whose bearing falls in a sensor's cone, with a fresh valid reading, takes the camera's class and the sensor's distance; an unmatched detection keeps the camera estimate, and an unmatched reading becomes an unclassified obstacle. Association is frame by frame, without the detector's tracks (Section~\ref{sec:ttc}), and the sensor directions are defaults, not measurements (Section~\ref{sec:impl-tof}, Figure~\ref{fig:fusion-geometry}).

\subsection{Dashboard integration}
\label{sec:dashboard-page}
\label{sec:dashboard-link}
\label{sec:live-only}
\label{sec:pi5-default}

The inherited PySide6 dashboard ran only on simulated data. A driver's display should not depend on coverage, so the path is local: each node prints one JSON line a second, a bridge on each Raspberry Pi serves it with the distances and fused hazards over HTTP, and the dashboard polls it. Table~\ref{tab:display-design} answers the display issues of Section~\ref{sec:lit-display} (Section~\ref{sec:impl-dash}; pages in Appendix~\ref{app:interface}).

\begin{table}[htbp]
\centering
\small
\caption[Dashboard design against the display issues of Section~\ref{sec:lit-display}]{Dashboard design against the display issues of Section~\ref{sec:lit-display}.}
\label{tab:display-design}
\begin{tabular}{|p{2.4cm}|p{11.8cm}|}
\hline
\textbf{Issue} & \textbf{Design} \\ \hline
Data validity & Live-only mode: a field with no live source stays empty and lost data is shown as absent, never replaced by simulation \\ \hline
Layout & Few added elements: a camera page, a Sensors page, a ride-quality card, a front-obstacle distance from the forward sensor only \\ \hline
Colour & The dashboard's own status colours \\ \hline
Priority & Only an immediate hazard, or loss of the rear link, raises a banner over every page \\ \hline
Team's code & A patch set applied to a separate copy by a script that refuses to touch the team's folder; one command restores the team's dashboard \\ \hline
\end{tabular}
\end{table}

\subsection{Approaching objects: time to contact}
\label{sec:ttc}

A distance band says how near an object is, not whether it is closing. A tracker in the detector follows each detection across frames by box overlap, and the time to contact comes from the growth of its image width $w$, the expansion measure of Section~\ref{sec:lit-detection} \cite{lee1976tau,dagan2004fcw}. For an object of width $W$ at range $Z$ closing at constant speed, $w = fW/Z$, so $u = 1/w$ falls linearly to zero at contact and
\begin{equation}
\tau = \frac{w}{\dot w} = -\frac{u}{\dot u},
\label{eq:ttc}
\end{equation}
which needs neither the focal length $f$ nor $W$, both uncalibrated. A Theil-Sen line \cite{sen1968}, the median of pairwise slopes, which tolerates an outlying box, is fitted to $u$ against the frames' sensor timestamps over the last $T = 0.6$\,s, and $\tau$ is taken at the newest frame. With relative box-width noise $\varepsilon$ and $n = f_c T$ frames at frame rate $f_c$, a least-squares line, used as an approximation for the Theil-Sen fit, gives the slope a relative error $\varepsilon (\tau/T)\sqrt{12/n}$ and the end value $2\varepsilon/\sqrt{n}$; the slope dominates by $\sqrt{3}\,\tau/T$ (11.5 at 4\,s), so
\begin{equation}
\frac{\sigma_\tau}{\tau} \approx \frac{\sigma_{\dot w}}{\dot w} \approx \varepsilon\,\frac{\tau}{T}\sqrt{\frac{12}{n}}.
\label{eq:ttc-error}
\end{equation}
At the 4\,s threshold this is $6.8\varepsilon$ on the Raspberry Pi~5 (19.2\,frames/s, $n \approx 11.5$) and $7.8\varepsilon$ on the Raspberry Pi~4 (14.6\,frames/s, $n \approx 8.8$), half that at 2\,s: a 1\,\% box jitter gives about $\pm 0.3$\,s at 4\,s. The error falls as $T^{-3/2}$, so a longer window is more precise but slower to follow a change in closing speed. The width grows by the fraction $T/\tau$ over the window, so the 5\,\% growth gate admits $\tau$ up to 12\,s, three times the warning threshold. Test C11, which would measure $\varepsilon$, was not run. At close range the time-of-flight sensors give their own closing time. A stationary object ahead of the moving vehicle approaches, which is intended: a forward-collision warning (Section~\ref{sec:impl-ttc}).

\subsection{Two-sided layout}
\label{sec:two-sided}

Sensing is split by side. The Raspberry Pi~5 behind the dashboard runs the front camera, detector and time-of-flight board, so a front alert does not cross the network and has the Pi~5's lower latency (median 51 to 54\,ms beside the dashboard, against 118 to 122\,ms on the Raspberry Pi~4 with the whole system, Section~\ref{sec:res-hazard}). The Raspberry Pi~4 beside the battery looks backward and reads the rear node near the pack. A dedicated Ethernet cable joins them, leaving Wi-Fi for the internet. Figure~\ref{fig:two-sided} shows the result on the dashboard: one page switches between Front and Rear, the rear view mirrored, and the banner shows warnings from both sides (Section~\ref{sec:impl-twosided}).

\begin{figure}[htbp]
\centering
\subfigure[Surroundings, Front: the Raspberry Pi~5's camera and time-of-flight board (test image).]{}
\subfigure[Surroundings, Rear: mirrored, with a car approaching at 1.6\,s (test data).]{}
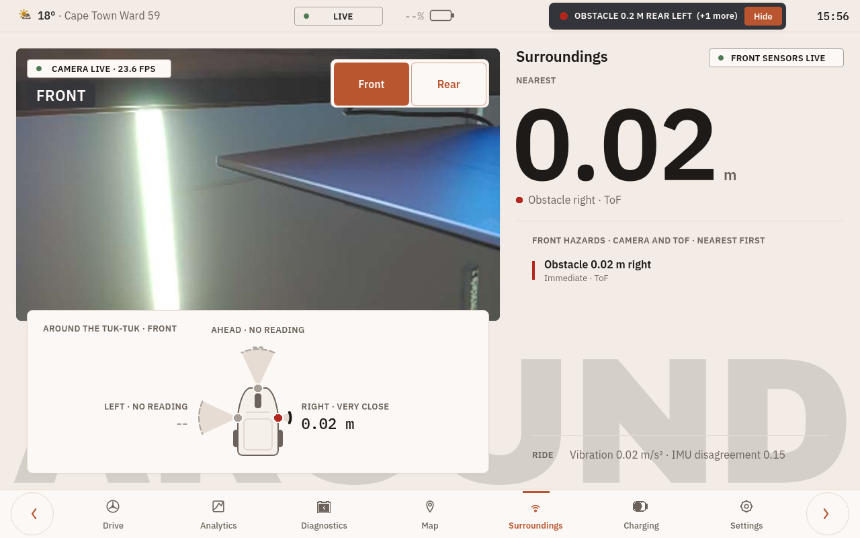
[picture p26: Report/figures/ui/ui_pi5_live_dualcam.png]
\subfigure[On the Raspberry Pi~5 on 15 October: live front camera at 23.6\,frames/s, a rear warning in the banner.]{}
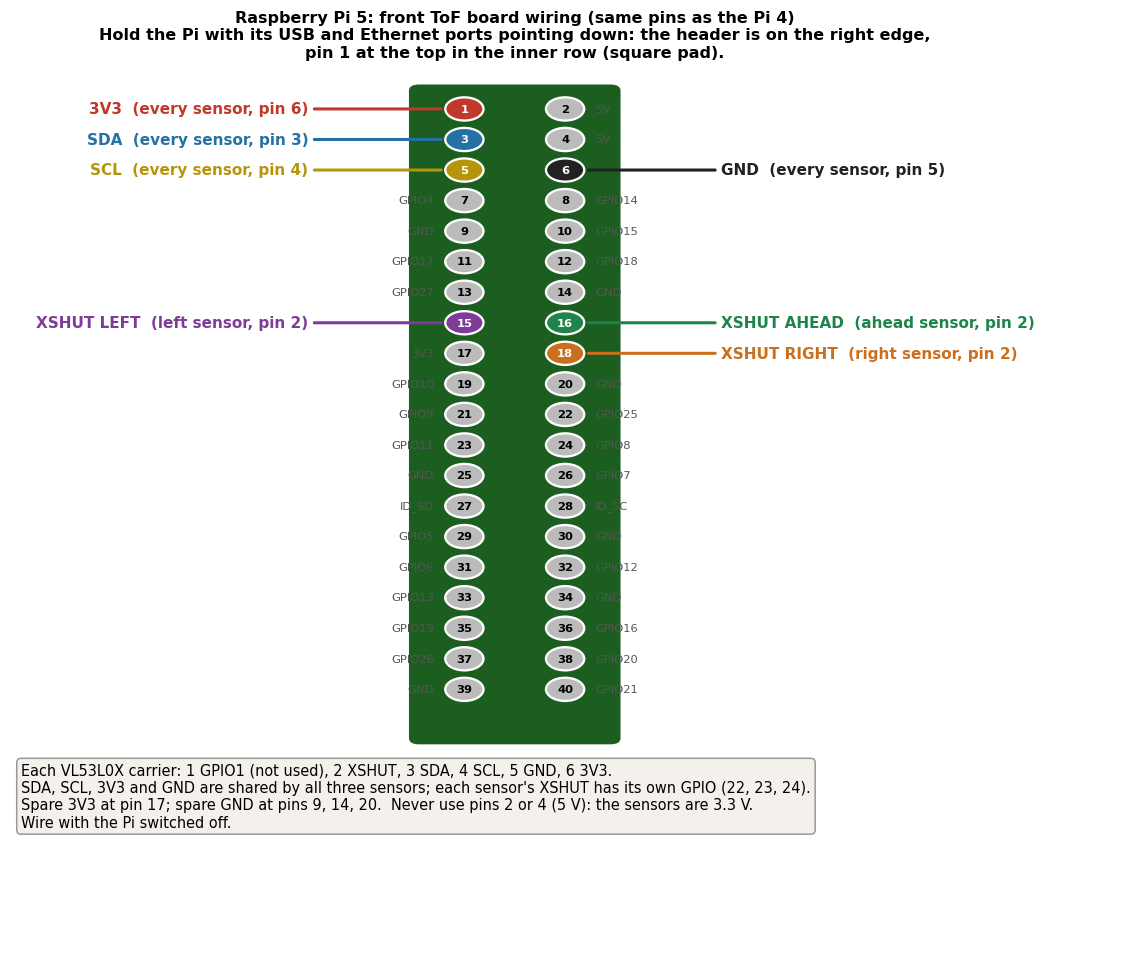
[picture p27: Report/figures/pi5_tof_wiring.png]
\subfigure[Front time-of-flight board on the Raspberry Pi~5: the same pins as on the Raspberry Pi~4.]{}
\caption[Two-sided layout: front sensing on the Raspberry Pi~5, rear sensing and the telemetry unit on the Raspberry Pi~4]{Two-sided layout: front sensing on the Raspberry Pi~5, rear sensing and the telemetry unit on the Raspberry Pi~4.}
\label{fig:two-sided}
\end{figure}

\section{Communications and local logging}
\label{sec:mqtt-networking}
\label{sec:local-logging}
\label{sec:db-sync}
\label{sec:pi-link}

Communications must keep every record through gaps in coverage (R9) and feed the dashboard locally (R10), the subject of RQ3. Table~\ref{tab:comms-design} gives the design. The principle is that no link is trusted: every record is kept locally whatever the coverage, carries what is needed to detect its loss, and is confirmed rather than assumed delivered (Section~\ref{sec:impl-comms}). A published record of about 550 bytes every 10\,s is 0.44\,kbit/s, 1.6\,MB in an 8-hour day before protocol overhead, against about 26\,MB an hour for one raw stream (Table~\ref{tab:fw-mechanisms}), so features are sent and samples stay on the vehicle.

\begin{table}[htbp]
\centering
\small
\caption[Communications and logging design]{Communications and logging design.}
\label{tab:comms-design}
\begin{tabular}{|p{2.6cm}|p{7.6cm}|p{4.0cm}|}
\hline
\textbf{Path} & \textbf{Design} & \textbf{Reason} \\ \hline
MQTT over LTE & JSON summary every 10\,s from the modem task; success taken from the modem's separate result code, not its first \texttt{OK}; session lost on repeated failures or the modem's report; reconnection when packet data returns & The modem UART has no lock; the first \texttt{OK} does not mean success \\ \hline
Public test broker & Record carries no position & Proves the path only \\ \hline
Flash log & Every record written whatever the coverage, buffered and written once a minute (Section~\ref{sec:buffering}); missing values as \texttt{null} & A session leaves a complete, valid record (Section~\ref{sec:inv-json}) \\ \hline
Store-and-forward & Boot counter and never-repeating sequence number; QoS~1; a ledger replays unacknowledged records after reconnection; ingest on the Raspberry Pi~5 stores each record once & Radio outages are replayed from the log; the record key prevents duplicate rows \\ \hline
Rear node to Pi~4 & Own supply; three-wire UART at 460\,800\,baud, no supply wire & A modem powered from a Pi's USB port pulled the Pi's supply down (Section~\ref{sec:inv-power}) \\ \hline
Front node to Pi~5 & USB & No modem load \\ \hline
\end{tabular}
\end{table}

\section{Fault investigations}
\label{sec:faults-summary}

The tests of R1, R4, R5, R8, R9 and R10 exposed faults that changed the design, which bears on RQ3. Eight faults of Table~\ref{tab:faults} needed a diagnosis, told in Section~\ref{sec:investigations} as symptom, candidate causes, deciding test, cause and fix (Table~\ref{tab:investigations}). Four changed the design: the telemetry unit needs its own supply (Section~\ref{sec:inv-power}); a silent sensor is skipped with a timeout (Section~\ref{sec:inv-tof}); the record is read back in full (Section~\ref{sec:inv-json}); and processing does not share a core with acquisition (Section~\ref{sec:inv-stall}).

\section{Testing infrastructure}
\label{sec:bench-tools}

Each test leaves a record: a browser bench console reads the serial output and replays saved logs through the same parsing (Figure~\ref{fig:live-dashboard}); scripts drive the firmware and record the result; and offline tests replace the camera, model or bridge with stand-ins (Section~\ref{sec:impl-tools}).

\section{Maintenance design}
\label{sec:maintenance}

Firmware is built from the repository with fixed board settings and every record carries its version; deploy scripts set up the Raspberry Pis and record the commit; every program restarts on failure; the display and pods come off without tools; and every wire is listed (Appendix~\ref{app:wiring}, Section~\ref{sec:impl-maint}).
