0geder/Tukzie-HPEC-HUD/Report/appendixd.tex

\chapter{Wiring and Connections}
\label{app:wiring}

This appendix records how every part of the system is connected, so that it can be rebuilt or checked from this document alone. Each table gives both ends of each wire by connector, pin number and signal. The pin assignments come from the firmware (\texttt{TelemetryUnit/\allowbreak{}src/\allowbreak{}main.cpp}), the time-of-flight reader (\texttt{CameraDetection/\allowbreak{}tof\_\allowbreak{}reader.py}) and the bench procedures (\texttt{BenchTest/\allowbreak{}TEST\_\allowbreak{}PROCEDURES.md}), and the pin positions from the manufacturers' documents reproduced in the figures. Connections not yet made on the hardware are marked as planned. Tables~\ref{tab:wiring-tof} to~\ref{tab:wiring-other} give, in turn, the Raspberry Pi~4 to the time-of-flight board (Table~\ref{tab:wiring-tof}), the telemetry unit to the Raspberry Pi~4 (Table~\ref{tab:wiring-esp-pi}), the IMUs (Table~\ref{tab:wiring-imu}), the telemetry unit's other connections (Table~\ref{tab:wiring-esp-other}), the SEN55 as first planned (Table~\ref{tab:wiring-sen55}) and the camera, displays and power (Table~\ref{tab:wiring-other}). The start-up and interface checks run on these connections are in Table~\ref{tab:startup-checks}.

\section{Pin references}

\begin{figure}[htbp]
\centering
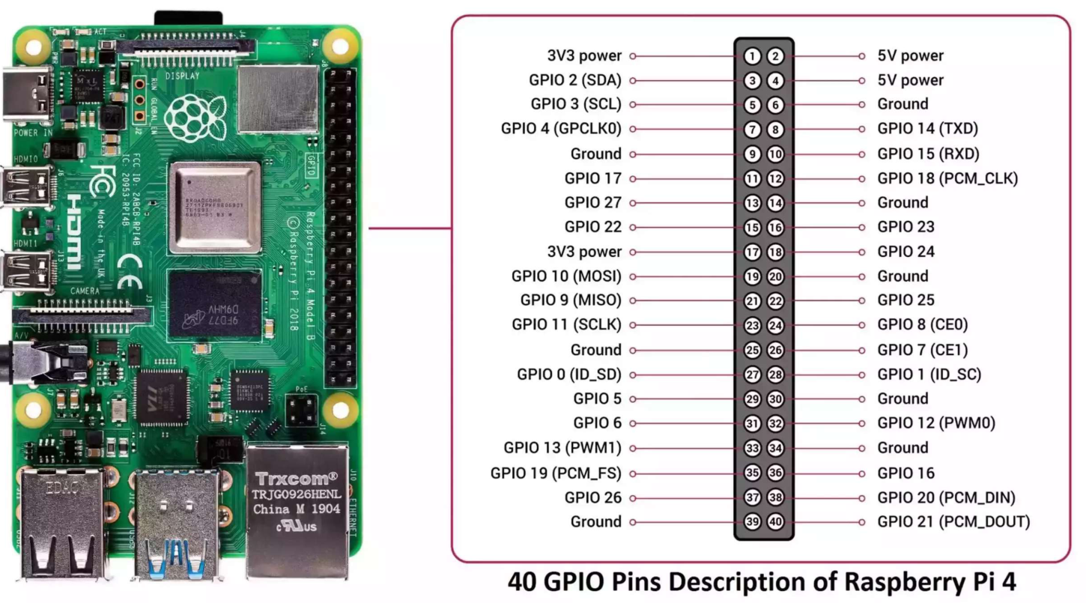
[picture p29: Report/figures/pi4_gpio_header.png]

\caption[Raspberry Pi~4 40-pin header, physical pin numbers and functions, from the project's reference sheet (\texttt{References/\allowbreak{}Hardware/\allowbreak{}Rasp Pi 4 pins.pdf}) \cite{raspberrypigpio}]{Raspberry Pi~4 40-pin header, physical pin numbers and functions, from the project's reference sheet (\texttt{References/\allowbreak{}Hardware/\allowbreak{}Rasp Pi 4 pins.pdf}) \cite{raspberrypigpio}. Odd-numbered pins are on the inner row and even-numbered pins on the board edge.}
\label{fig:pi4-gpio}
\end{figure}

\begin{figure}[htbp]
\centering
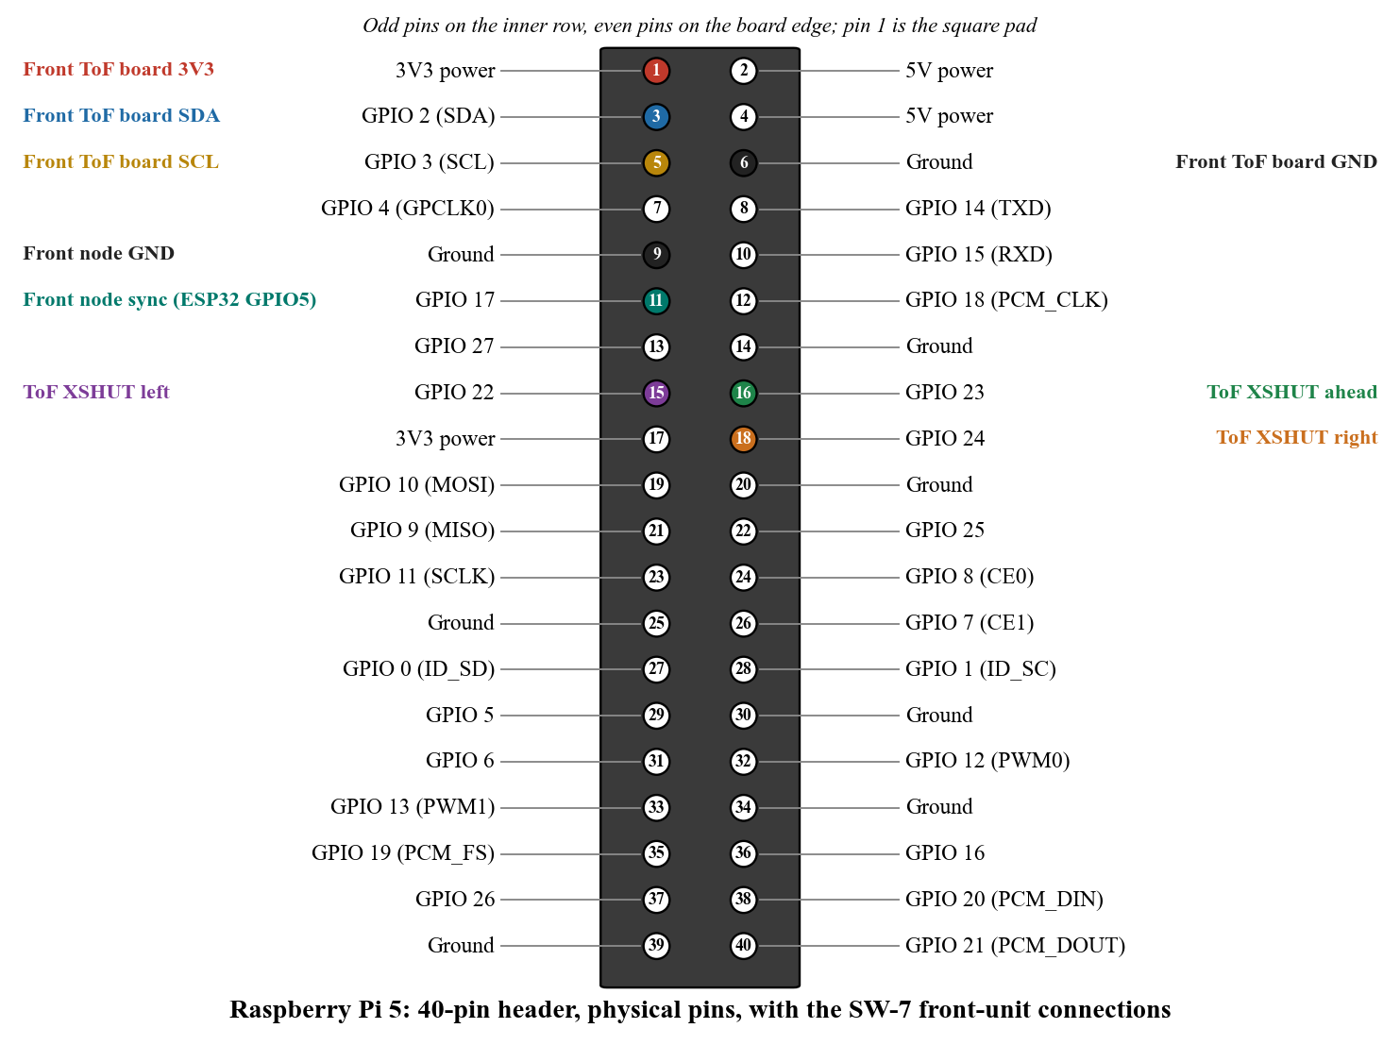
[picture p30: Report/figures/pi5_gpio_header.png]

\caption[Raspberry Pi~5 40-pin header, physical pin numbers and functions]{Raspberry Pi~5 40-pin header, physical pin numbers and functions. The Raspberry Pi~5 header is pin-compatible with the Raspberry Pi~4's (Figure~\ref{fig:pi4-gpio}) \cite{raspberrypigpio}. The coloured pins are the front unit's connections: the front time-of-flight board (3V3, SDA, SCL, GND and the three XSHUT lines on GPIO22, 23 and 24) and the front inertial node's sync pulse (ESP32 GPIO5 to GPIO17) and ground (Section~\ref{sec:front-node}).}
\label{fig:pi5-gpio}
\end{figure}

\begin{figure}[htbp]
\centering
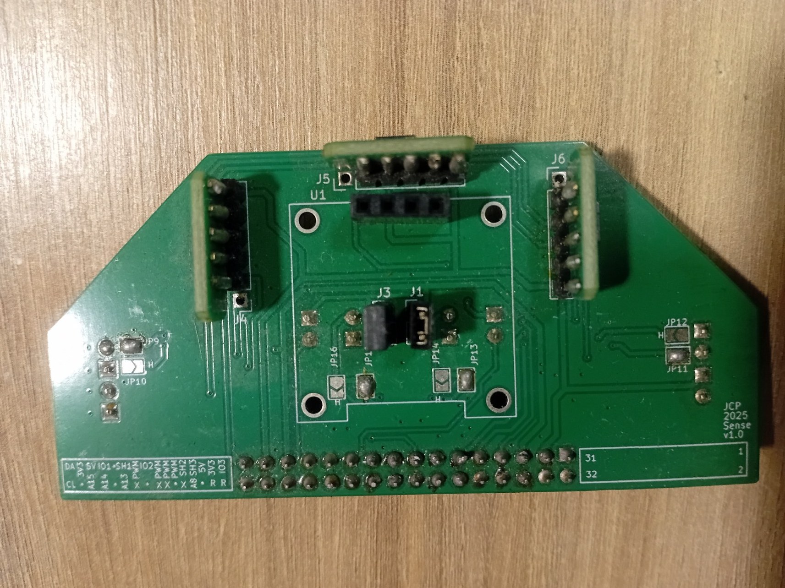
[picture p31: Report/figures/sensor_board_top.jpg]

\caption[Sensor board (UCT micromouse ``JCP 2025 Sense v1.0'') used as the time-of-flight stand-in]{Sensor board (UCT micromouse ``JCP 2025 Sense v1.0'') used as the time-of-flight stand-in. The 2$\times$16 header J2 runs along the top edge; the silkscreen marks pins 1 and 2 at one end and 31 and 32 at the other, and the legend at the right names the signals (3V3, DA, CL, SH1 to SH3, 5V). The three VL53L0X sensor carriers sit on J4, J5 and J6, facing left, ahead and right.}
\label{fig:sensor-board}
\end{figure}

\begin{figure}[htbp]
\centering
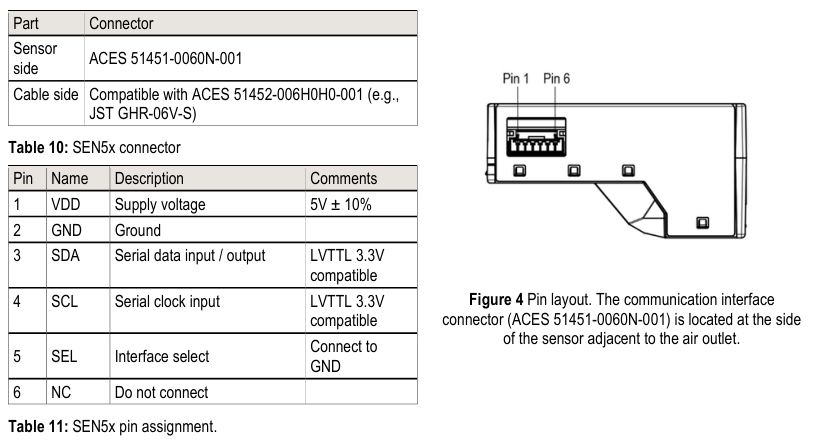
[picture p32: Report/figures/sen5x_pinout.png]

\caption[Sensirion SEN5x interface connector and pin assignment, reproduced from the datasheet \cite{sensirionsen5x}]{Sensirion SEN5x interface connector and pin assignment, reproduced from the datasheet \cite{sensirionsen5x}. The mating plug is a JST GHR-06V-S (1.25\,mm pitch, six way).}
\label{fig:sen5x-pinout}
\end{figure}

The Makerfabs ESP32-S3 A7670X board's headers are shown in Figure~\ref{fig:makerfabs-pinout} (Appendix~\ref{app:figures}). In this appendix its left header is called J5 and its right header J2, as on the board's schematic, with pins numbered from the top of the pinout figure: J5 runs IO46, IO14, IO9, IO46, IO15, IO16, IO17, IO18, IO8, IO3, 3V3, GND, VBAT (pins 1 to 13). The firmware comments confirm pins 5, 7 and 8 against the schematic; the others are read from the figure.

\section{Raspberry Pi 4 to the time-of-flight sensor board}

The three VL53L0X sensors share one I\textsuperscript{2}C bus and all start at address 0x29. Each sensor's shutdown line (XSHUT) goes to its own Pi GPIO, so that the reader can hold all three off, wake one at a time and move each to its own address (0x30, 0x31, 0x32). The sensors have 10\,k$\Omega$ pull-ups on XSHUT and no I\textsuperscript{2}C pull-ups; the Pi's own 1.8\,k$\Omega$ pull-ups on pins 3 and 5 are used.

\begin{table}[htbp]
\centering
\caption[Raspberry Pi 4 to sensor board J2 (Figures~\ref{fig:pi4-gpio} and~\ref{fig:sensor-board})]{Raspberry Pi 4 to sensor board J2 (Figures~\ref{fig:pi4-gpio} and~\ref{fig:sensor-board}).}
\label{tab:wiring-tof}
\begin{tabular}{|l|l|l|l|}
\hline
\textbf{Signal} & \textbf{Sensor board J2} & \textbf{Pi 4 pin} & \textbf{Pi 4 function} \\ \hline
3.3\,V supply & pin 3 (3V3) & 1 & 3V3 power \\ \hline
Ground & pin 23 (GND) & 6 (or 14) & Ground \\ \hline
I\textsuperscript{2}C data & pin 31 (DA) & 3 & GPIO2, SDA \\ \hline
I\textsuperscript{2}C clock & pin 32 (CL) & 5 & GPIO3, SCL \\ \hline
XSHUT, left sensor & pin 21 (SH1) & 15 & GPIO22 \\ \hline
XSHUT, ahead sensor & pin 9 (SH2) & 16 & GPIO23 \\ \hline
XSHUT, right sensor & pin 7 (SH3) & 18 & GPIO24 \\ \hline
LED supply (VDD) & not connected & & \\ \hline
\end{tabular}
\end{table}

If a cooling fan uses Pi pins 4 and 6, the sensor ground goes to pin 14. The sensors are 3.3\,V parts and are never connected to the 5\,V pins (2 and 4). If one XSHUT wire is disconnected, that sensor's pull-up keeps it on at 0x29, where it collides with each sensor being woken, and none of the three starts; the reader then logs each sensor as not answering after a 0.5\,s timeout.

\section{Telemetry unit (ESP32-S3) to the Raspberry Pi 4}

\begin{table}[htbp]
\centering
\caption[ESP32-S3 board (rear node) to Raspberry Pi 4, from 21 October 2026]{ESP32-S3 board (rear node) to Raspberry Pi 4, from 21 October 2026.}
\label{tab:wiring-esp-pi}
\begin{tabular}{|p{3.6cm}|p{4.2cm}|p{4.2cm}|}
\hline
\textbf{Link} & \textbf{ESP32-S3 board} & \textbf{Raspberry Pi 4} \\ \hline
UART, ESP32 to Pi (460\,800\,baud, \texttt{/dev/serial0}) & IO41, TX & pin 10, GPIO15 (RXD) \\ \hline
UART, Pi to ESP32 (commands) & IO42, RX & pin 8, GPIO14 (TXD) \\ \hline
Time-sync pulse (3.3\,V logic) & J5 pin 5, GPIO15 & pin 11, GPIO17 \\ \hline
Ground & J5 pin 12, GND & pin 6 or 9, Ground \\ \hline
Supply & its own LiPo battery & no 5\,V or 3.3\,V wire between the boards \\ \hline
\end{tabular}
\end{table}

Until 21 October the board was powered and read over USB from the Pi (\texttt{/dev/ttyACM0}). Its LTE modem, drawing through the Pi's USB port, caused repeated under-voltage on the Raspberry Pi~4 (Section~\ref{sec:inv-power}), and 38\,\% of the per-second records were lost on that link on the road session of 19 October. For the UART the Pi's Bluetooth is disabled, so that its full PL011 UART is on GPIO14 and 15. Both sides use 3.3\,V logic, so no level shifter is needed. On its own LiPo the board browned out during modem transmit bursts on 21 October, so it still needs a regulated supply.

\section{Front inertial node to the Raspberry Pi 5}

From 22 October the second MPU6050 is on a separate ESP32-S3 board, the front node, wired to its GPIO8 (SDA) and GPIO9 (SCL) with short wires. The node connects to the Raspberry Pi~5 by USB at 921\,600\,baud, which also powers it, and its 500\,ms sync pulse goes from its GPIO5 to Pi~5 pin~11 (Figure~\ref{fig:pi5-gpio}). The rear board then keeps IMU1 only. On 26 October that IMU stopped answering on the rear board (no device at its address, its data lines open), and it moved to a third ESP32-S3 board of the front node's type, the rear IMU node: the MPU6050 on GPIO8 (SDA) and GPIO9 (SCL) with 3V3 and GND, connected to the Raspberry Pi~4 by USB through a hub and captured there by the same program as the front node; its GPIO5 sync output is wired to Pi~4 pin~11 when the camera-to-IMU timing is wanted, in place of the telemetry unit's. The telemetry unit keeps the battery, GNSS and cellular link and the UART of Table~\ref{tab:wiring-esp-pi}, on its own battery, with its ground joined to the Pi~4's.

\section{Telemetry unit sensors and antennas}

\begin{table}[htbp]
\centering
\caption[ESP32-S3 board to the two MPU6050 inertial sensors, as used up to 22 October 2026]{ESP32-S3 board to the two MPU6050 inertial sensors, as used up to 22 October 2026. Each sensor has its own I\textsuperscript{2}C bus, so both use address 0x68 (AD0 left low). From 22 October IMU2 is on the front node and the rear board has IMU1 only.}
\label{tab:wiring-imu}
\begin{tabular}{|l|l|l|}
\hline
\textbf{MPU6050 pin} & \textbf{IMU1 (bus 0)} & \textbf{IMU2 (bus 1)} \\ \hline
VCC & J5 pin 11, 3V3 & J5 pin 11, 3V3 \\ \hline
GND & J5 pin 12, GND & J5 pin 12, GND \\ \hline
SDA & J5 pin 9, GPIO8 & J5 pin 7, GPIO17 \\ \hline
SCL & J5 pin 3, GPIO9 & J5 pin 8, GPIO18 \\ \hline
AD0, INT, XDA, XCL & not connected & not connected \\ \hline
\end{tabular}
\end{table}

\begin{table}[htbp]
\centering
\caption[Other telemetry unit connections]{Other telemetry unit connections.}
\label{tab:wiring-esp-other}
\begin{tabular}{|p{3.4cm}|p{4.6cm}|p{4.6cm}|}
\hline
\textbf{Part} & \textbf{Connection on the ESP32-S3 board} & \textbf{Notes} \\ \hline
LTE antenna & ``4G LTE antenna'' u.FL socket & away from metal and from the GNSS antenna \\ \hline
GNSS antenna & ``GPS antenna'' u.FL socket & ceramic face up, clear view of the sky \\ \hline
SIM card & SIM holder on the underside & \\ \hline
A7670X modem & on board: UART RX GPIO47, TX GPIO48, PWRKEY GPIO4, RESET GPIO5 & no external wiring \\ \hline
Battery management system & Bluetooth Low Energy, no wire & board within about 1\,m of the pack \\ \hline
\end{tabular}
\end{table}

\begin{table}[htbp]
\centering
\caption[Sensirion SEN55 to the ESP32-S3 board as first planned (Figure~\ref{fig:sen5x-pinout}); its address, 0x69, does not clash with the MPU6050 at 0x68]{Sensirion SEN55 to the ESP32-S3 board as first planned (Figure~\ref{fig:sen5x-pinout}); its address, 0x69, does not clash with the MPU6050 at 0x68. The sensor came without its cable and was instead to share the Raspberry Pi~4's I\textsuperscript{2}C bus through wires soldered to its test pads. The supply pad lifted, and the sensor never answered at 0x69, so it is future work (Chapter~\ref{chap:recs}).}
\label{tab:wiring-sen55}
\begin{tabular}{|l|l|l|}
\hline
\textbf{SEN55 pin} & \textbf{Signal} & \textbf{ESP32-S3 board} \\ \hline
1 & VDD, 5\,V $\pm$10\% & J2 pin 13, 5V \\ \hline
2 & GND & J2 pin 12, GND \\ \hline
3 & SDA (3.3\,V compatible) & J5 pin 7, GPIO17 \\ \hline
4 & SCL (3.3\,V compatible) & J5 pin 8, GPIO18 \\ \hline
5 & SEL & GND (selects I\textsuperscript{2}C) \\ \hline
6 & NC & not connected \\ \hline
\end{tabular}
\end{table}

\clearpage
\section{Camera, displays and power}

\begin{table}[htbp]
\centering
\caption[Remaining connections]{Remaining connections.}
\label{tab:wiring-other}
\begin{tabular}{|p{3.6cm}|p{4.4cm}|p{4.6cm}|}
\hline
\textbf{Part} & \textbf{Connection} & \textbf{Notes} \\ \hline
Rear camera (OV5647 NoIR) & 15\,cm ribbon to the Pi~4 ``CAMERA'' connector & contacts face the HDMI ports; longer ribbons pick up noise \\ \hline
Raspberry Pi 4 power & USB-C, 5.1\,V 3\,A supply & a weaker supply or a long thin cable gives under-voltage \\ \hline
Raspberry Pi 4 cooling & fan on 5\,V and GND & needed: 81\,\textdegree C without it, 48\,\textdegree C with it (10 Oct 2026) \\ \hline
Front camera (second OV5647) & ribbon to a camera connector on the Pi~5 & since 15 October \\ \hline
Raspberry Pi 5 (dashboard, front unit) & the vehicle's existing dashboard computer and display; front camera, detector and time-of-flight board added on 15 October & reaches the Pi~4 over the Ethernet cable \\ \hline
Network & dedicated Ethernet cable between the two Pis, fixed addresses 10.20.0.1 and 10.20.0.2; Wi-Fi only for the internet route. Until 15 October both Pis were on one 2.4\,GHz hotspot & \\ \hline
\end{tabular}
\end{table}

\section{Wiring checks}

Before power is applied: every board is switched off and unplugged; each wire is checked end to end with a multimeter on continuity; 3.3\,V and ground are checked not to be shorted; and each bundle is tied and fixed close to the board, so that a pull on the cable is taken by the tie and not by the header pins, since loose jumpers came off twice during bench testing. After power-up, the pre-test check (\texttt{BenchTest/sw7\_check.py}) reports each link: telemetry from the ESP32, the three time-of-flight readings, the camera rate and the Raspberry Pi~4's power and temperature flags.

\section{Start-up and interface checks}

The routine checks that establish each interface before the higher-level tests are in Table~\ref{tab:startup-checks}. They are pass or fail, and all passed; the faults they exposed are in Table~\ref{tab:faults}.

\begin{table}[htbp]
\centering
\small
\caption[Start-up and interface checks (bench)]{Start-up and interface checks (bench).}
\label{tab:startup-checks}
\begin{tabular}{|p{3.4cm}|p{6.2cm}|p{4.4cm}|}
\hline
\textbf{Check} & \textbf{Evidence required} & \textbf{Result} \\ \hline
Processor boot & Versioned banner, continuous status, no reset loop; bounded wait for a USB host & Pass \\ \hline
Flash configuration & 16\,MB flash in DIO mode with the 16\,MB partition table; LittleFS mounts & Pass after the DIO fix \\ \hline
Serial routing & Application output on the target board's native USB port & Pass after the routing fix \\ \hline
Modem power-up & Modem answers \texttt{AT} without the button; key pulsed only if silent & Pass (v0.5.2) \\ \hline
UART, SIM, signal & \texttt{OK} to \texttt{AT}; \texttt{+CPIN: READY}; valid \texttt{AT+CSQ} & Pass; CSQ 22 to 30 \\ \hline
LTE registration & \texttt{AT+CEREG?} and \texttt{AT+CPSI?} registered, \texttt{LTE,Online} & Pass; intermittent indoors \\ \hline
GNSS interface & Correctly framed \texttt{+CGNSSINFO} after warm-up & Pass \\ \hline
Manual bridge & Commands and replies passed both ways & Pass \\ \hline
I\textsuperscript{2}C levels & Idle bus at about 3.3\,V (inputs not 5\,V tolerant) & Pass, 3.3\,V \\ \hline
Both IMUs on target board & Found, configured, calibrated, 400 to 401 samples per 2\,s & Pass, 0 dropped \\ \hline
Raspberry Pi~4 & Same OS release as the Pi~5; camera identified (OV5647); network and ssh reachable & Pass \\ \hline
Pre-test check & \texttt{BenchTest/sw7\_check.py} reports every link before a session & 16 offline tests pass; READY on 4 Oct except the Pi~4 supply \\ \hline
\end{tabular}
\end{table}
