0geder/Tukzie-HPEC-HUD/Planning/report-review.md

# Examiner-style review of the SW-7 report draft

Historical: written before the HUD was replaced by dashboard integration on 2 Oct 2026. Its findings on the HUD title, abstract, Scope and RQ2 were addressed by the title and RQ2 change (30450ab, 1 to 2 Oct 2026).

Reviewed: "OKTSAM001 SW7 Report Draft.pdf", 71 PDF pages, dated 29 September 2026, with the .tex sources.
Criteria used: Lecture 2 (slides 3, 7, 9, 10, 12), the Intro Lecture (slides 4, 10, 11), the GA descriptors in "GA Tracking Form incl GA5.pdf" (pages 3 to 5), and the SW-7 brief (pages 20 to 22 of the topics list).
Context used: PROJECT_LOG.md and Planning/brief-compliance.md.

Page convention: "p." is the PDF page. In the main body the printed page number is the PDF page minus 10 (Chapter 1 starts on PDF p.11, printed page 1).

The official marking rubric ("Marking rubrics on Amathuba", L2 slide 14) was not available. Every grade and rating below is an estimate from the GA descriptors and the handout requirements, not from the rubric.

Checked after the review: the calibration arithmetic flagged in section 4 is confirmed. 10.35 to 10.39 m/s2 times 0.9773 gives 10.12 to 10.15, and 9.55 to 9.60 times 0.9901 gives 9.46 to 9.51, so the stated factors cannot produce the stated convergence to 9.80 to 9.81. The factors that would are about 0.946 and 1.024.

## 1. Overall verdict
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
