0geder/Tukzie-HPEC-HUD/Report/figures/tikz/system_architecture.tex

% System as driven, 27 October 2026 (rear IMU on its own ESP32-S3 from 26 October): two-sided layout (Pi 5 front, Pi 4 rear, Ethernet), rear ESP32 on a wired UART,
% front node (second ESP32-S3) on the Pi 5's USB, phone GNSS over the hotspot.
% Sources: TelemetryUnit/src/main.cpp (v0.7.8), BenchTest/raw_capture.py, DashboardIntegration/phone_gps_bridge.py, Server/sw7_ingest.py, CameraDetection/telemetry_bridge.py,
% hazard_detector.py, sensor_fusion.py, sync_logger.py, DashboardIntegration/deploy (pi5-hazard-detector,
% pi5-tof-bridge), live_data_provider.py, sw7_endpoints.py. Dashed amber = not yet working.
\begin{tikzpicture}[x=1cm, y=1cm]
  \def\tw{3.9cm}
  % ---- telemetry unit ----
  \node[swbox, text width=\tw] (a1) at (2.2,-1.25) {%
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
