0geder/Tukzie-HPEC-HUD/CameraMount/sensor_pod/concept_front.png

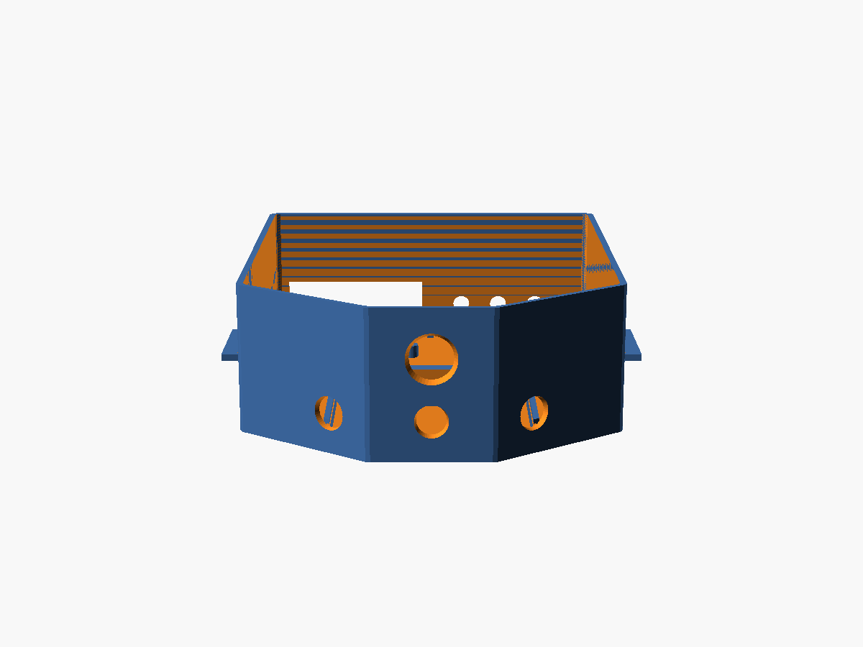
CameraMount/sensor_pod/concept_front.png
