0geder/Tukzie-HPEC-HUD/CameraMount/sensor_pod/concept_top.png

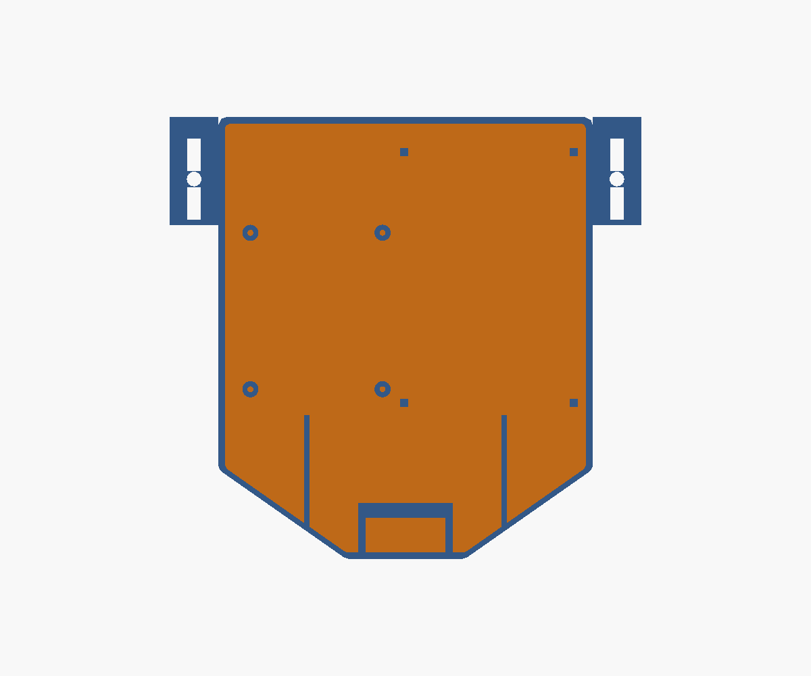
CameraMount/sensor_pod/concept_top.png
