0geder/Tukzie-HPEC-HUD/DashboardIntegration/tests/redesign/driving_panel_day_SAMPLE_VALUES.png

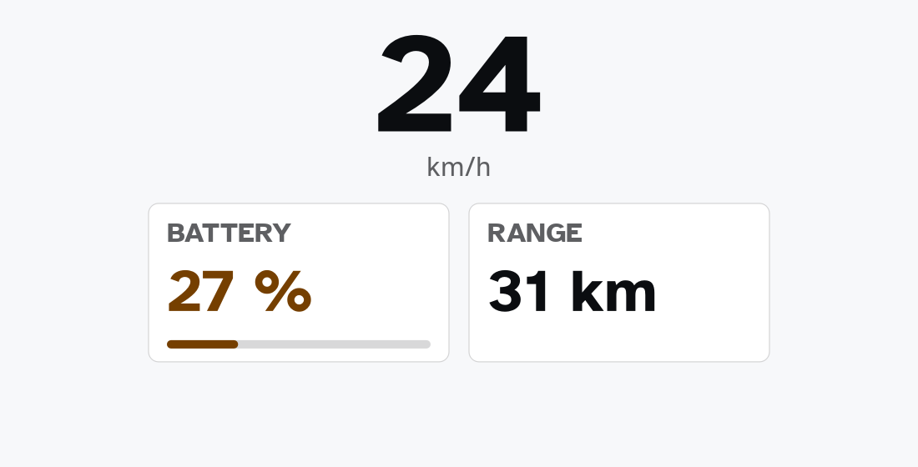
DashboardIntegration/tests/redesign/driving_panel_day_SAMPLE_VALUES.png
