0geder/Tukzie-HPEC-HUD/DashboardIntegration/tests/redesign/driving_panel_night_SAMPLE_VALUES.png

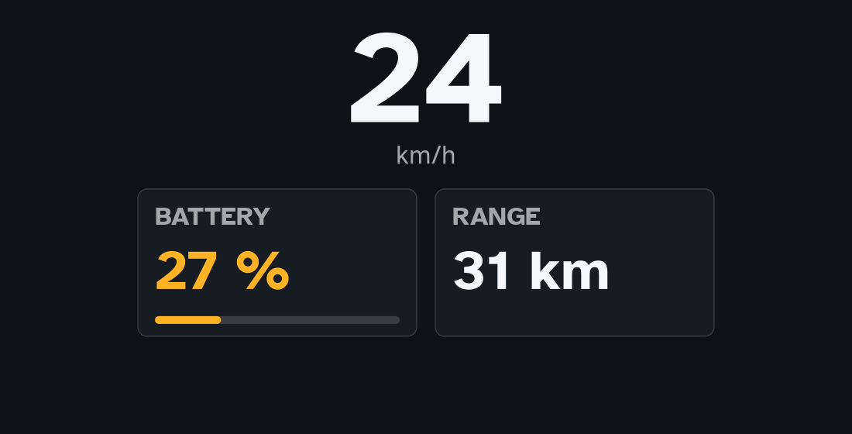
DashboardIntegration/tests/redesign/driving_panel_night_SAMPLE_VALUES.png
