0geder/Tukzie-HPEC-HUD/DashboardIntegration/tests/redesign/sw7_day_driving.png

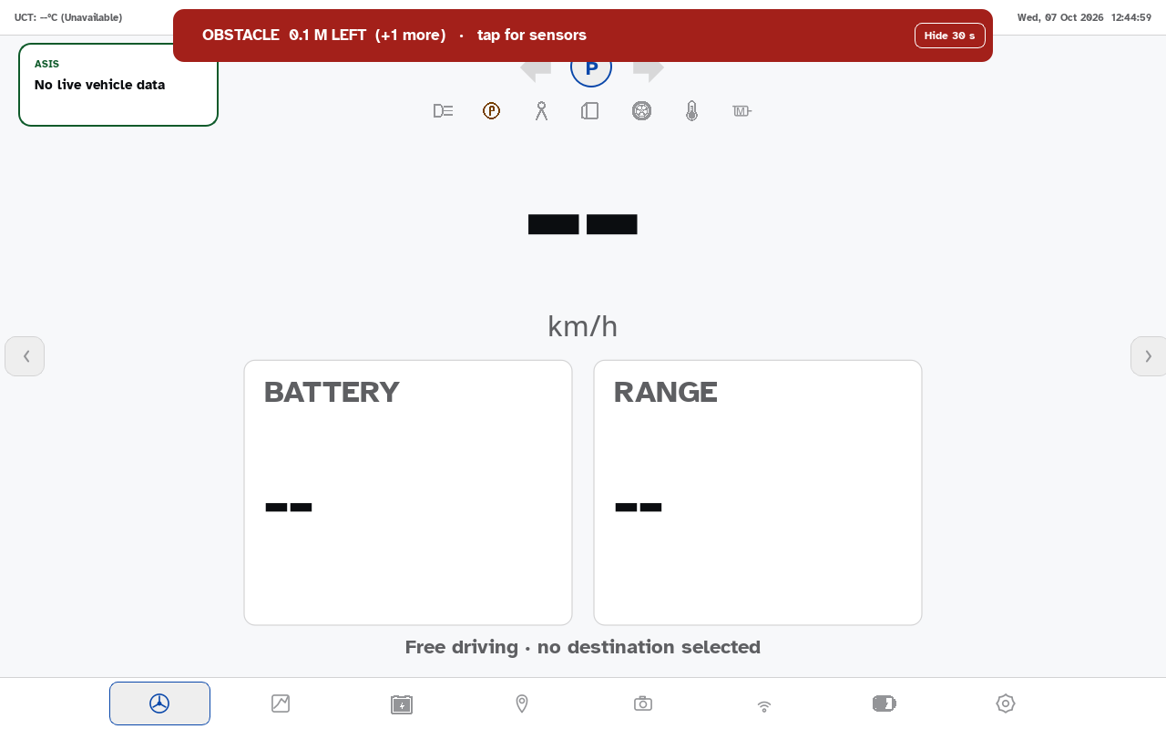
DashboardIntegration/tests/redesign/sw7_day_driving.png
