0geder/Tukzie-HPEC-HUD/DashboardIntegration/tests/redesign/sw7_night_driving.png

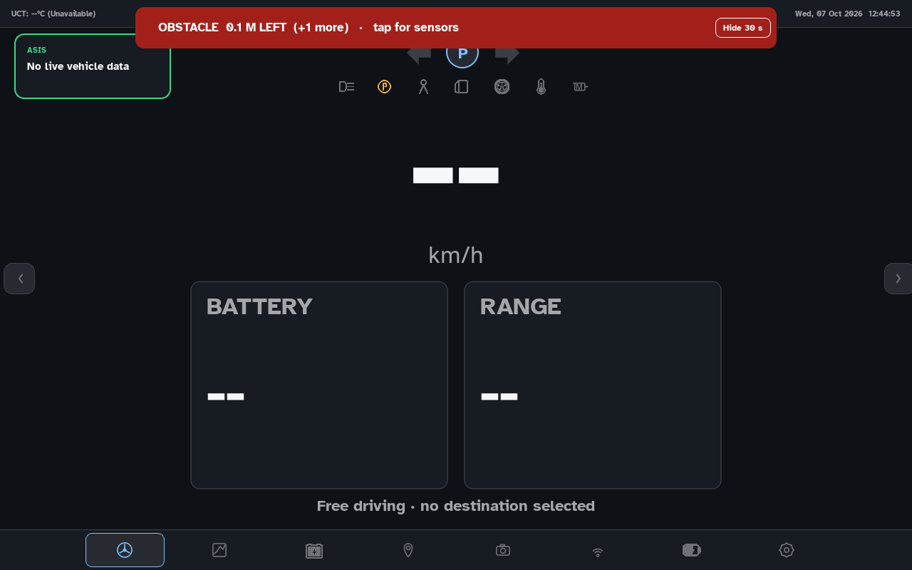
DashboardIntegration/tests/redesign/sw7_night_driving.png
