0geder/Tukzie-HPEC-HUD/DashboardIntegration/tests/redesign/sw7_night_sensors.png

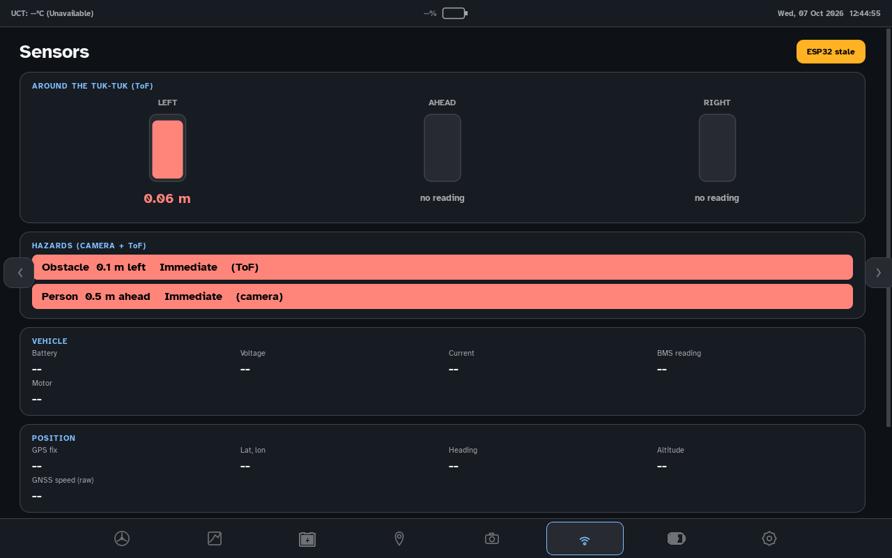
DashboardIntegration/tests/redesign/sw7_night_sensors.png
