0geder/Tukzie-HPEC-HUD/DashboardIntegration/tests/redesign/sw7_night_settings.png

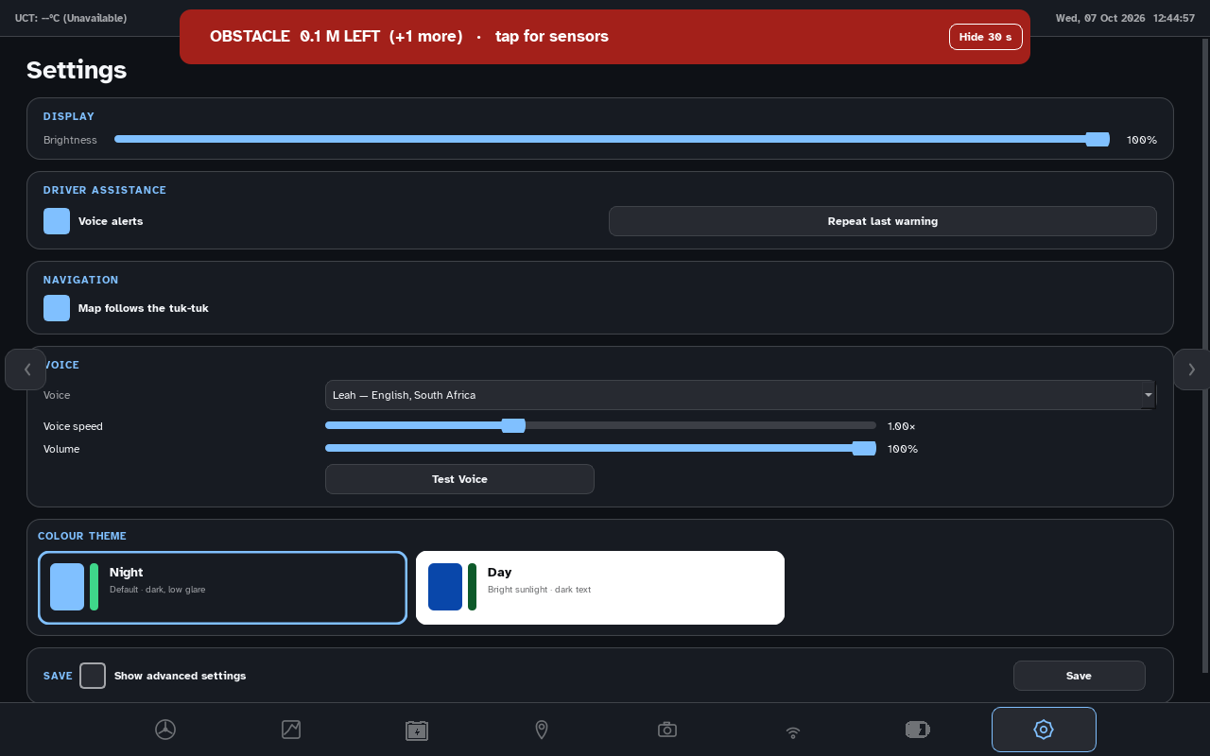
DashboardIntegration/tests/redesign/sw7_night_settings.png
