0geder/Tukzie-HPEC-HUD/Presentation/media/tuksense_overview_60s_poster.jpg

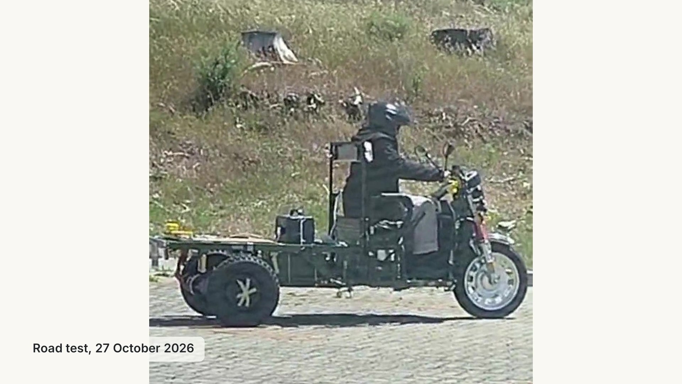
Presentation/media/tuksense_overview_60s_poster.jpg
