0geder/Tukzie-HPEC-HUD/Presentation/mockups/paper_theme_all_pages.jpg

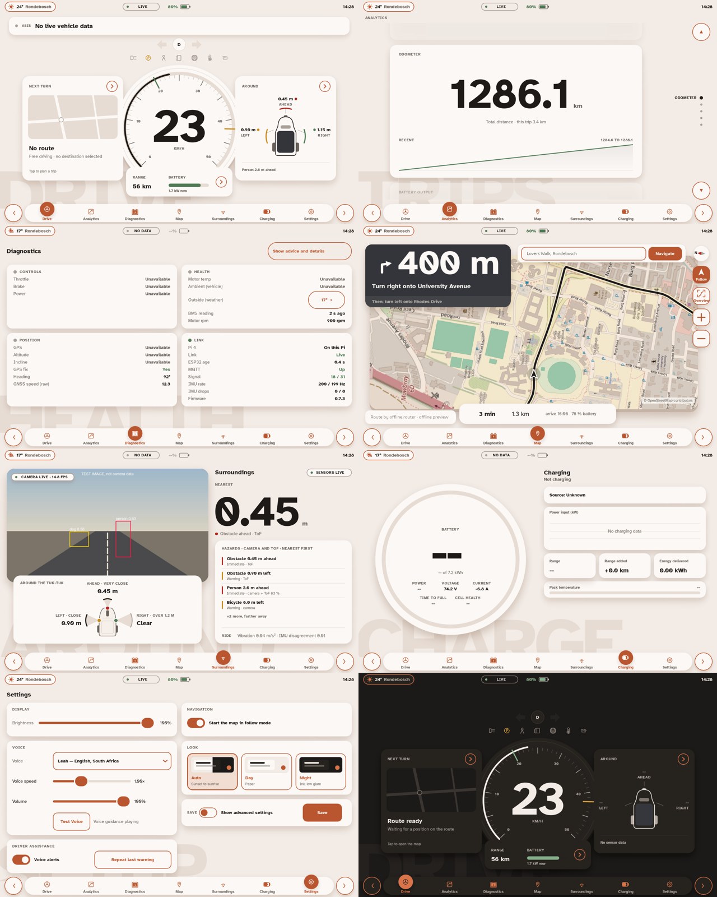
Presentation/mockups/paper_theme_all_pages.jpg
