0geder/Tukzie-HPEC-HUD/Presentation/source/assets/casing_labelled.png

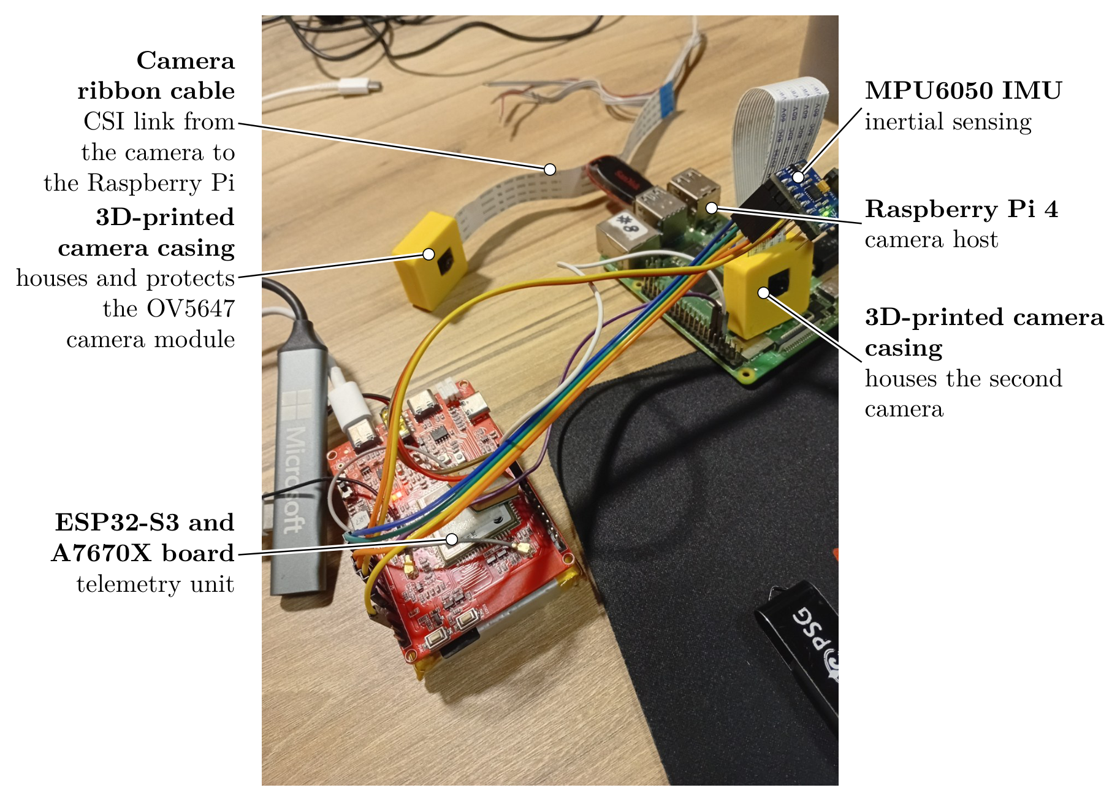
Presentation/source/assets/casing_labelled.png
