0geder/Tukzie-HPEC-HUD/Presentation/source/assets/qr_tuksense.png

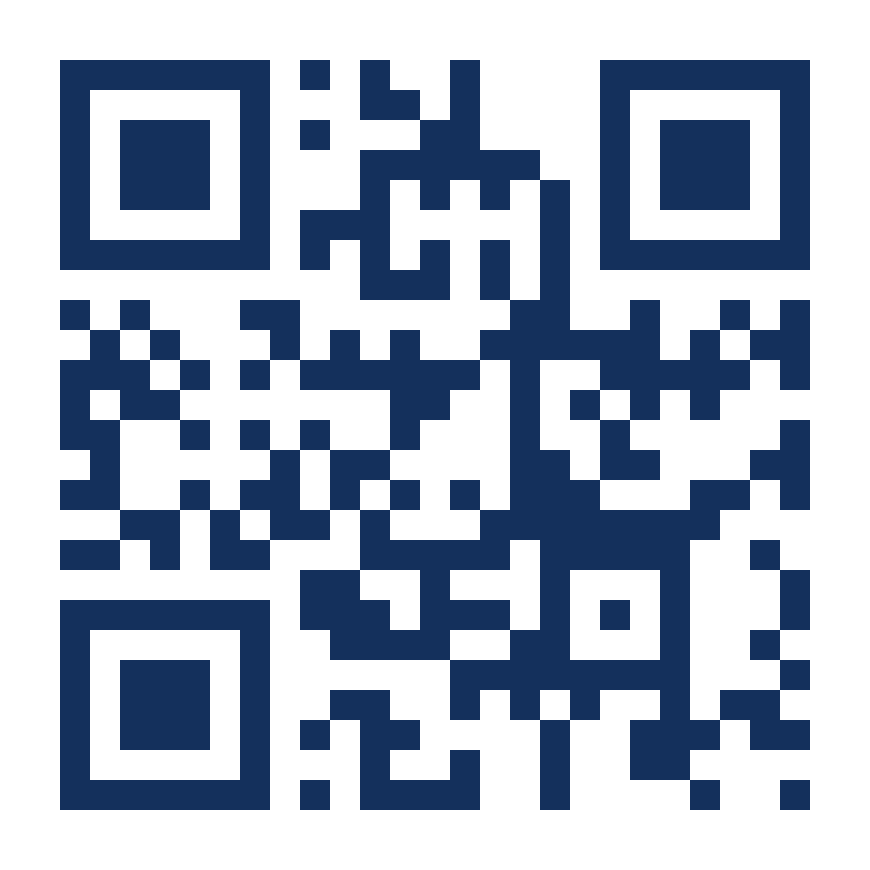
Presentation/source/assets/qr_tuksense.png
