0geder/Tukzie-HPEC-HUD/Presentation/source/assets/vibration_chart.png

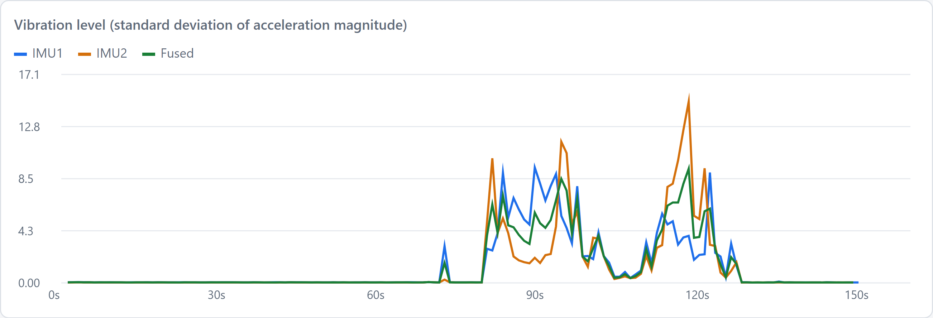
Presentation/source/assets/vibration_chart.png
