0geder/Tukzie-HPEC-HUD/Report/evidence/2026-10-01_dashboard_page_live.png

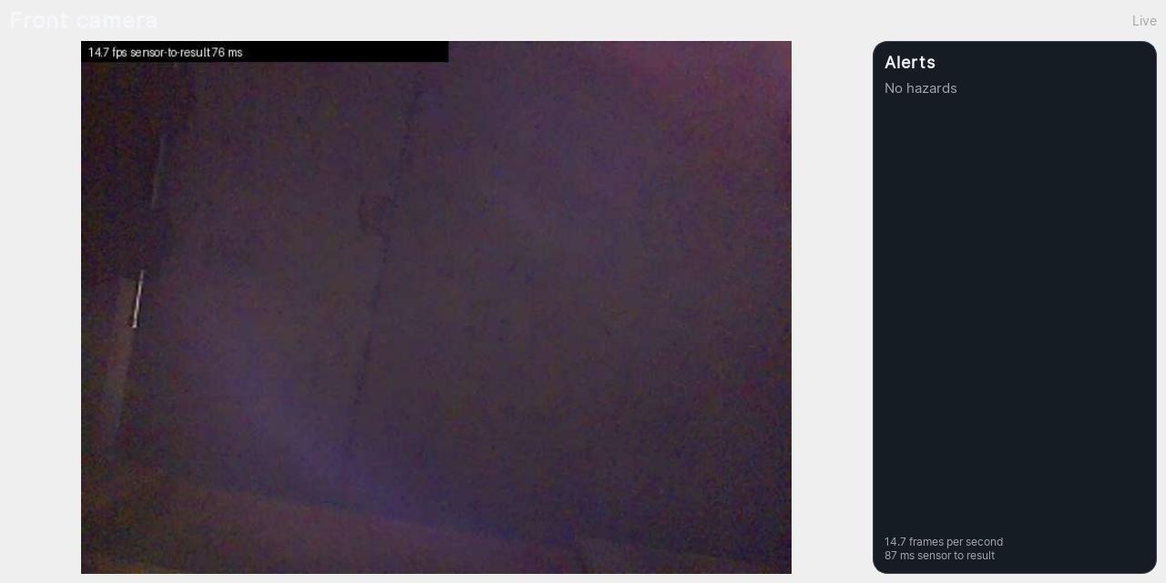
Report/evidence/2026-10-01_dashboard_page_live.png
