0geder/Tukzie-HPEC-HUD/Report/evidence/c3/card2_all4.jpg

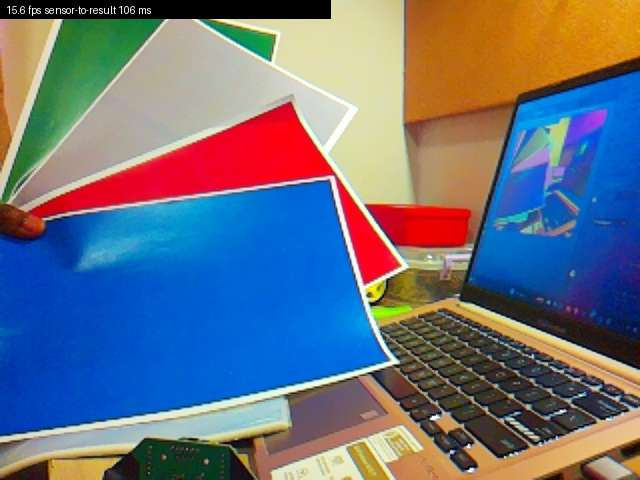
Report/evidence/c3/card2_all4.jpg
