0geder/Tukzie-HPEC-HUD/Report/evidence/c3/card2_blue.jpg

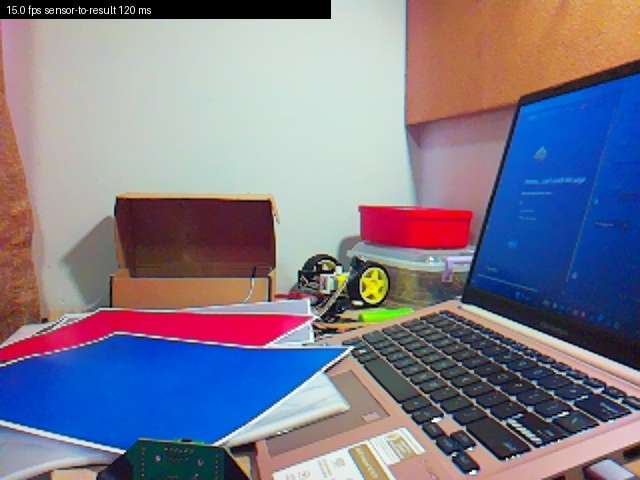
Report/evidence/c3/card2_blue.jpg
