0geder/Tukzie-HPEC-HUD/Report/evidence/c3/card2_green.jpg

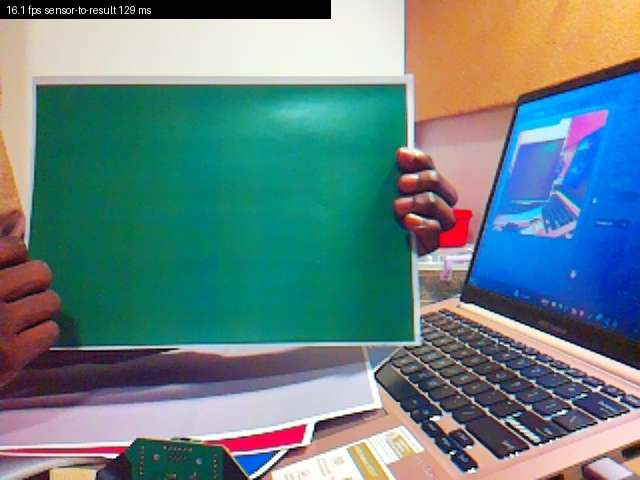
Report/evidence/c3/card2_green.jpg
