0geder/Tukzie-HPEC-HUD/Report/evidence/c3/card2_grey.jpg

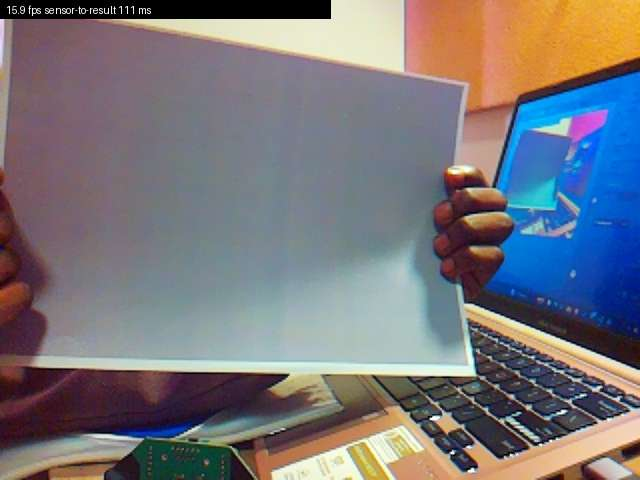
Report/evidence/c3/card2_grey.jpg
