0geder/Tukzie-HPEC-HUD/Report/evidence/c3/card2_white.jpg

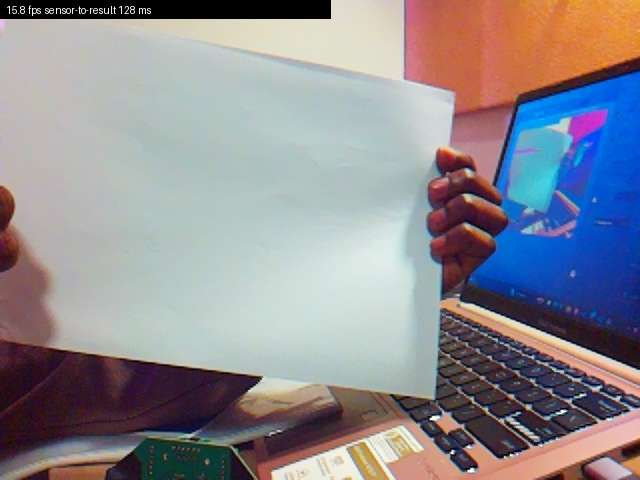
Report/evidence/c3/card2_white.jpg
