0geder/Tukzie-HPEC-HUD/Report/evidence/c3/card_blue.jpg

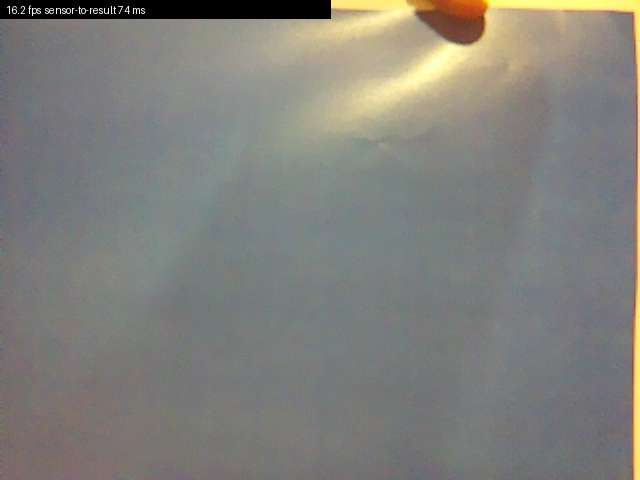
Report/evidence/c3/card_blue.jpg
