0geder/Tukzie-HPEC-HUD/Report/evidence/c3/card_blue_sat18.jpg

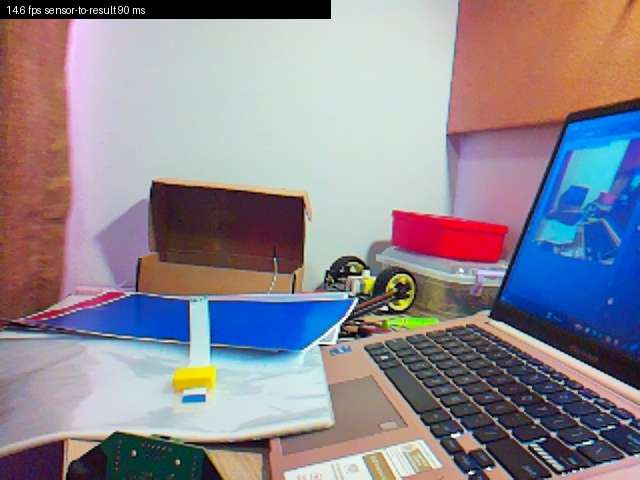
Report/evidence/c3/card_blue_sat18.jpg
