0geder/Tukzie-HPEC-HUD/Report/evidence/c3/default.jpg

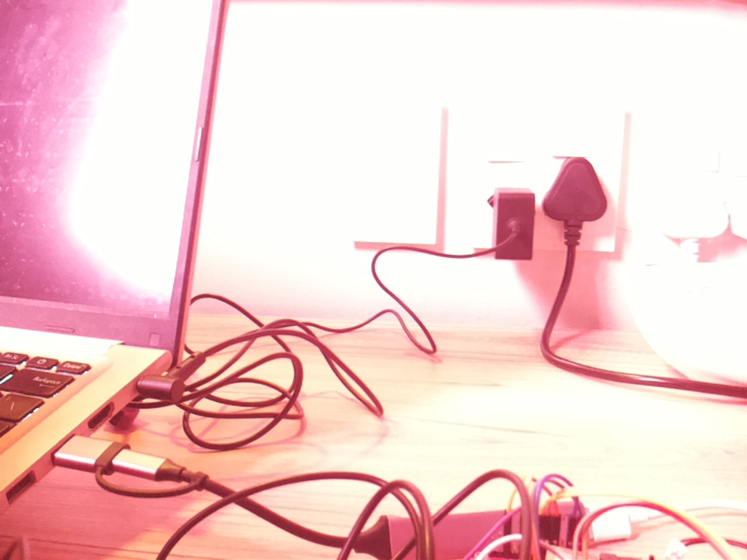
Report/evidence/c3/default.jpg
