0geder/Tukzie-HPEC-HUD/Report/evidence/c3/detector_view.jpg

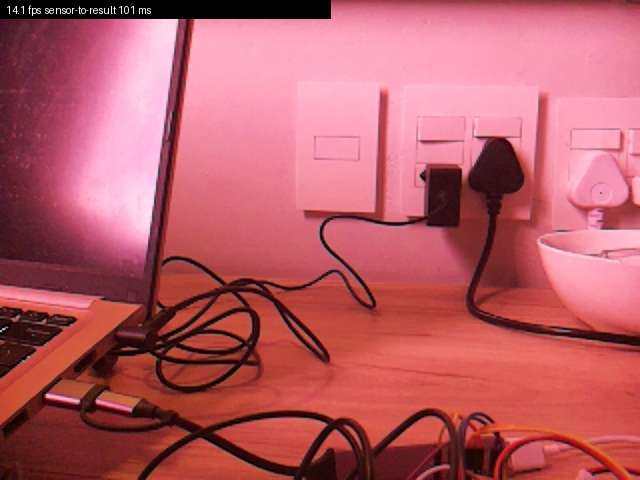
Report/evidence/c3/detector_view.jpg
