0geder/Tukzie-HPEC-HUD/Report/figures/cad/imu_pod_base.png

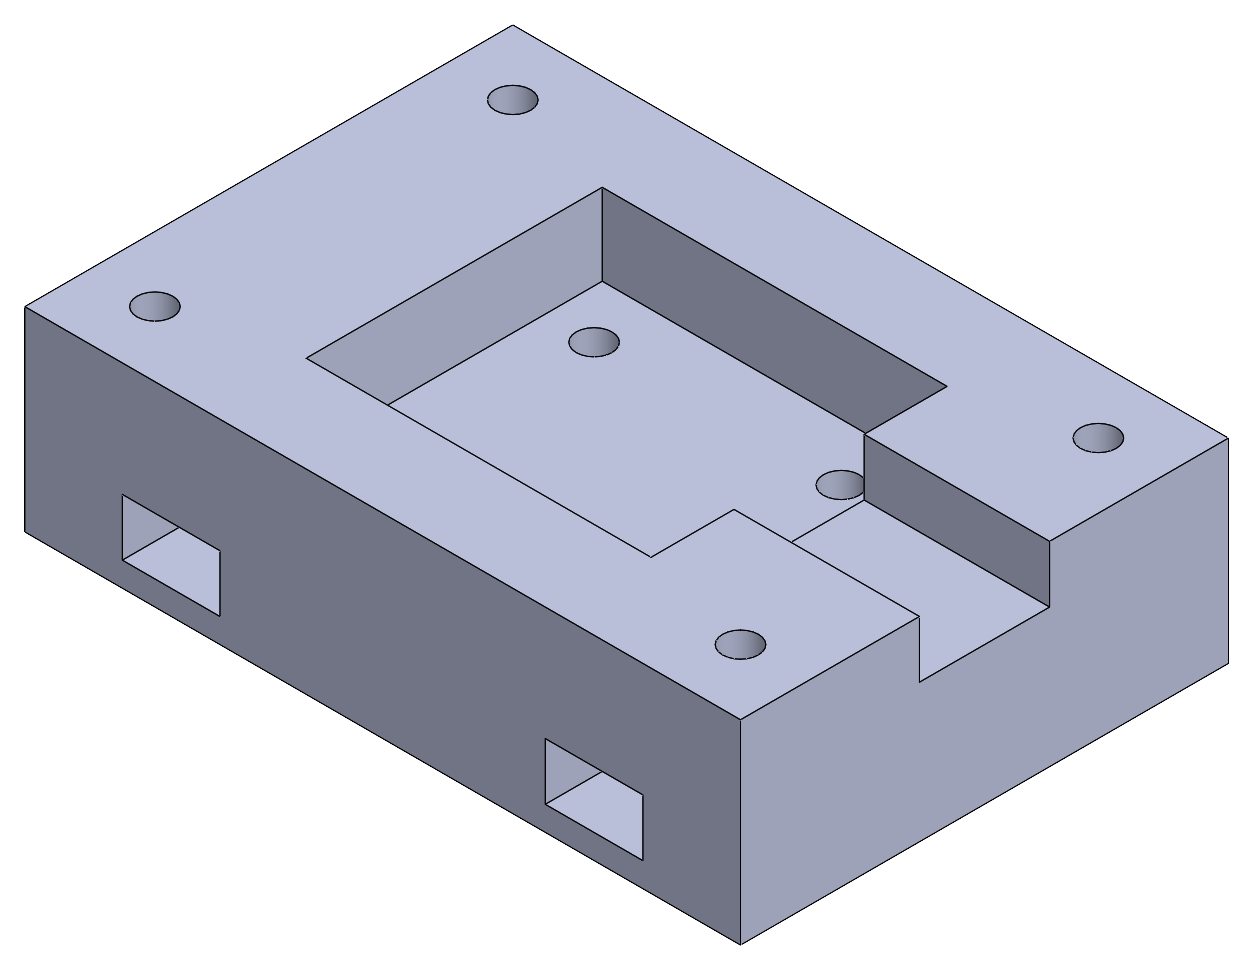
Report/figures/cad/imu_pod_base.png
