0geder/Tukzie-HPEC-HUD/Report/figures/cad/imu_pod_lid.png

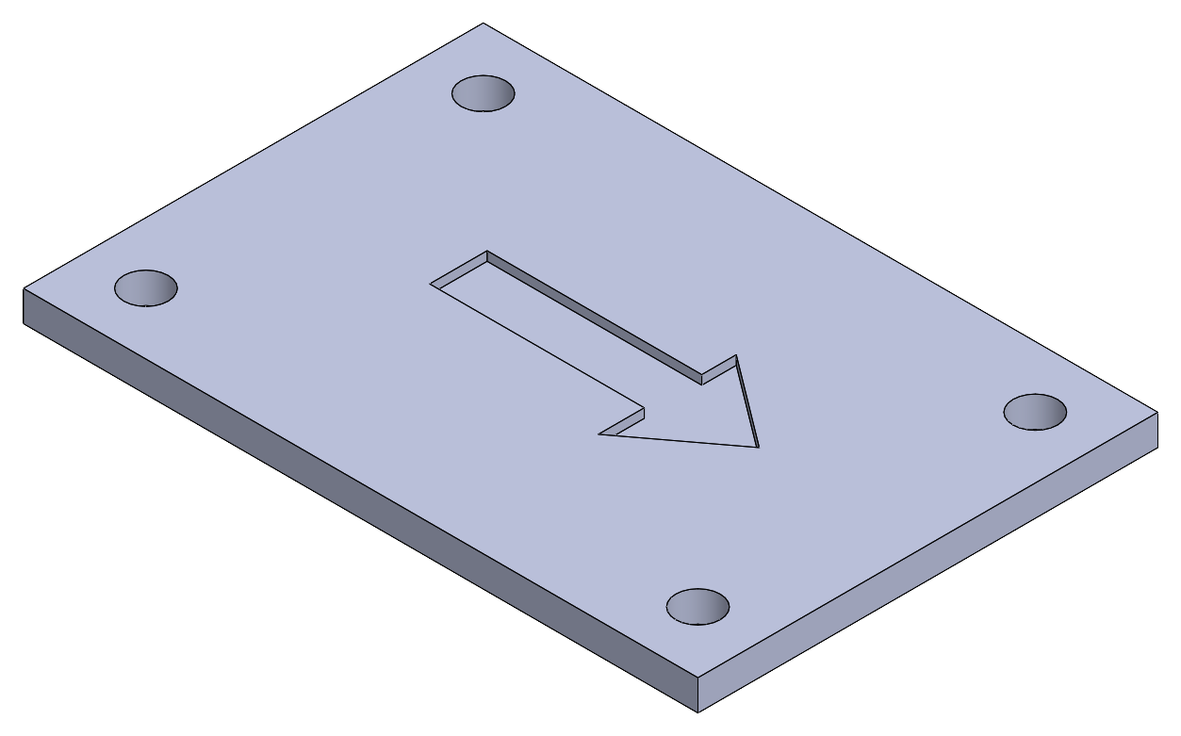
Report/figures/cad/imu_pod_lid.png
