0geder/Tukzie-HPEC-HUD/Report/figures/cad/photo_display_cables.jpg

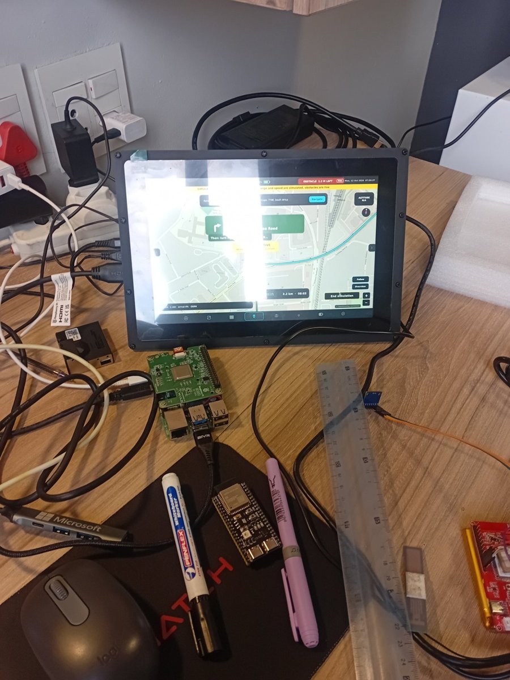
Report/figures/cad/photo_display_cables.jpg
