0geder/Tukzie-HPEC-HUD/Report/figures/cad/photo_display_stack.jpg

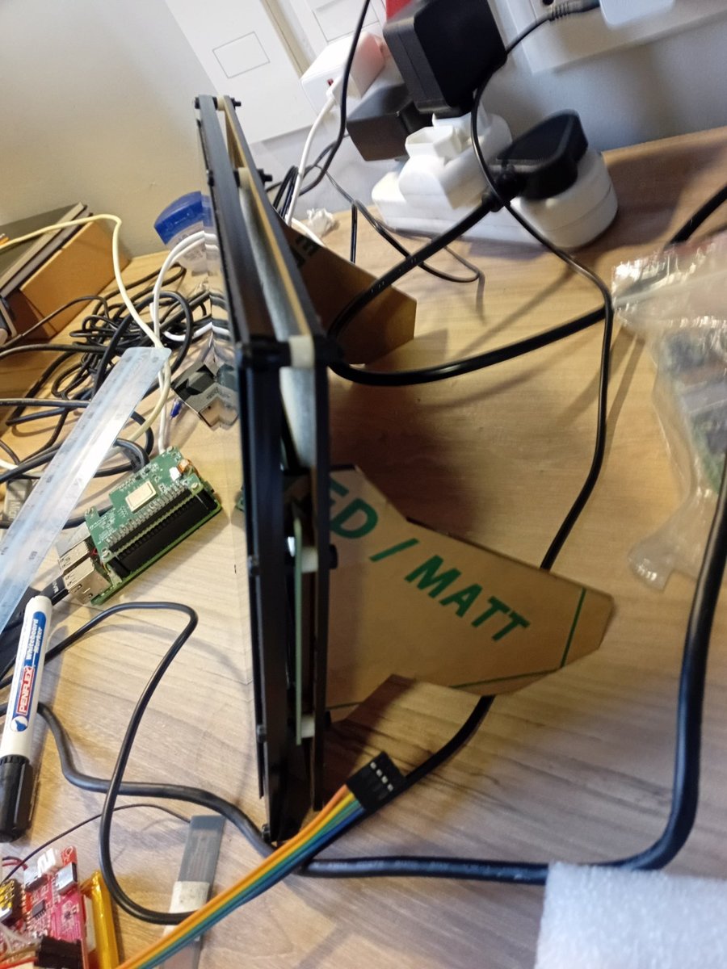
Report/figures/cad/photo_display_stack.jpg
