0geder/Tukzie-HPEC-HUD/Report/figures/camera_mount_render.png

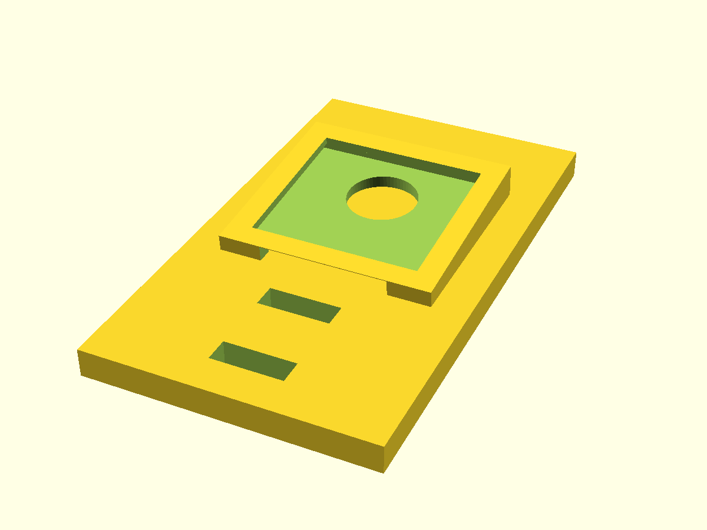
Report/figures/camera_mount_render.png
