0geder/Tukzie-HPEC-HUD/Report/figures/results/stand_spectra_1023.png

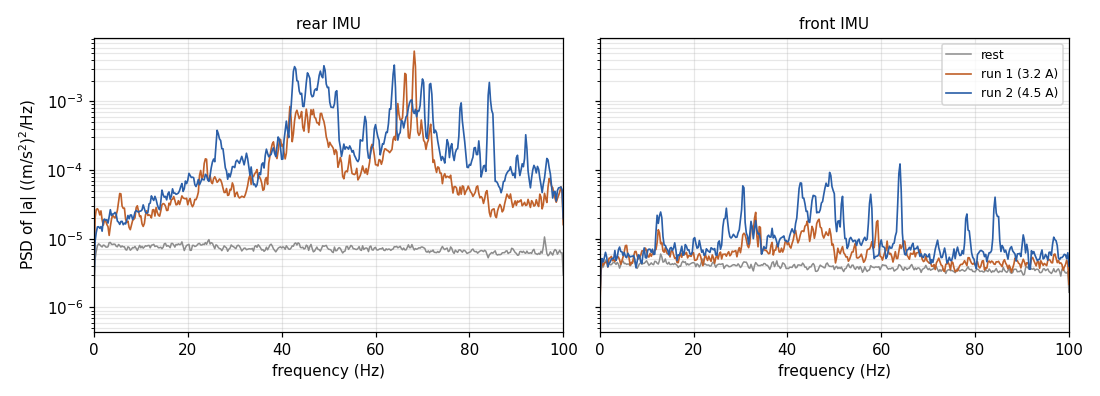
Report/figures/results/stand_spectra_1023.png
