0geder/Tukzie-HPEC-HUD/Report/figures/road1/vid_dash_mount.jpg

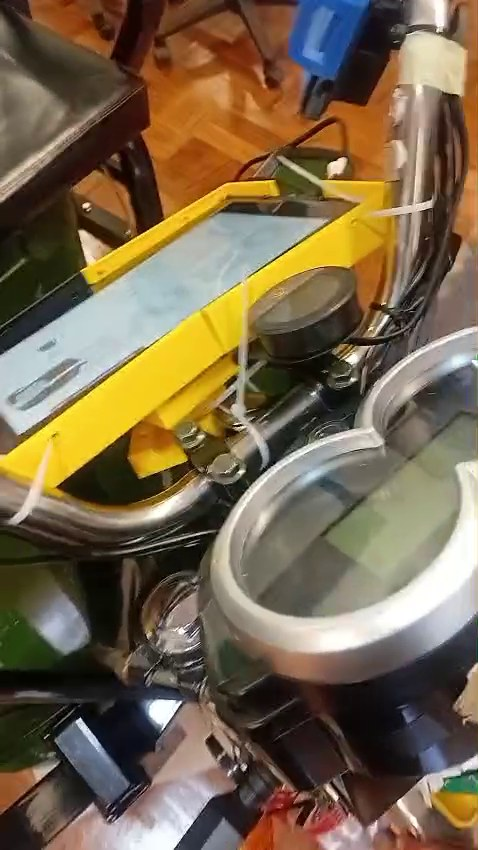
Report/figures/road1/vid_dash_mount.jpg
