0geder/Tukzie-HPEC-HUD/CAD/Sensor_Pod_Front/audit_logs/audit_3_parts.txt

Traceback (most recent call last):
  File "C:\Users\0geda\OneDrive - University of Cape Town\Documents\PlatformIO\Projects\Tukzie-HPEC-HUD\CAD\Sensor_Pod_Front\build\audit_3_parts.py", line 17, in <module>
    sw = win32com.client.GetActiveObject("SldWorks.Application")
  File "C:\Users\0geda\AppData\Roaming\Python\Python313\site-packages\win32com\client\__init__.py", line 94, in GetActiveObject
    dispatch = pythoncom.GetActiveObject(resultCLSID)
pywintypes.com_error: (-2147221021, 'Operation unavailable', None, None)
