0geder/Tukzie-HPEC-HUD/CAD/Dashboard_Enclosure/print_parts/dash_rail_plate.bmp

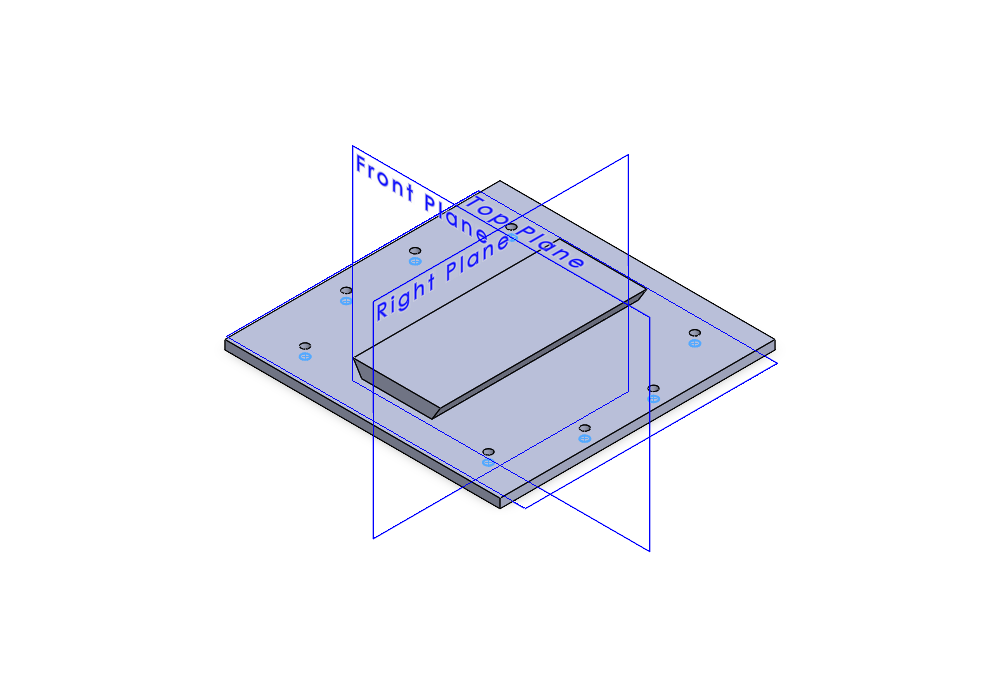
CAD/Dashboard_Enclosure/print_parts/dash_rail_plate.bmp
