0geder/Tukzie-HPEC-HUD/CAD/Dashboard_Enclosure/SW7_Dash_Assembly.SLDASM

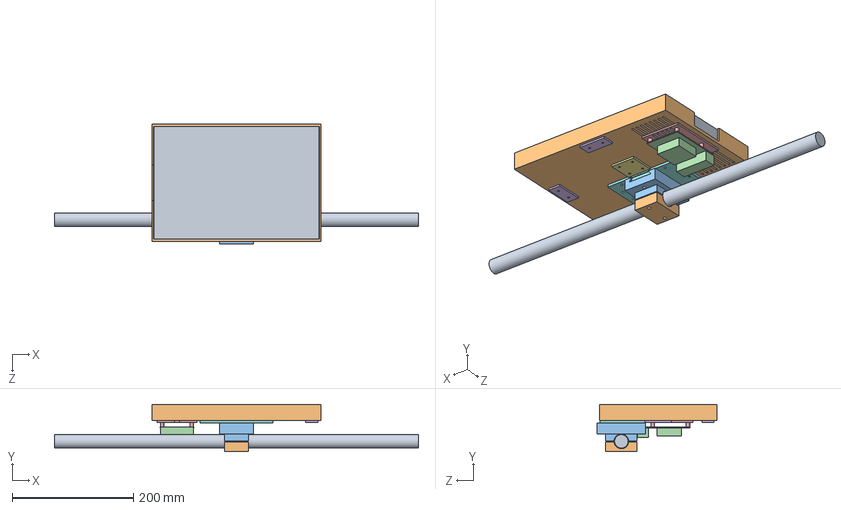
[picture p95: CAD file, 2026-10-12]
CAD/Dashboard_Enclosure/SW7_Dash_Assembly.SLDASM
600.0 x 78.0 x 197.6 mm
SW7_Dash_Back_Shell
REF_Display_272x187x20
SW7_Dash_Rail_Plate
SW7_Dash_Cross_Joiner
SW7_Dash_Joiner_Plate x 2
SW7_Dash_Pi5_Cradle
REF_Pi5_with_cooler
SW7_Dash_Bracket
SW7_Dash_Clamp_Cap
REF_Handlebar_22mm
