0geder/Tukzie-HPEC-HUD/CAD/Sensor_Pod/SW7_Sensor_Pod_Assembly.SLDASM

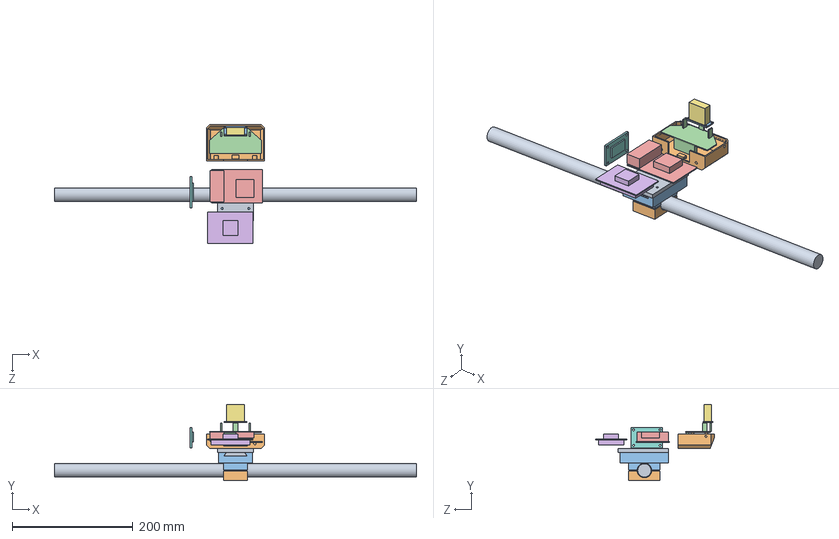
[picture p96: CAD file, 2026-10-12]
CAD/Sensor_Pod/SW7_Sensor_Pod_Assembly.SLDASM
600.0 x 126.6 x 197.2 mm
SW7_Pod_Camera_Retainer
SW7_Pod_Head_Tray
SW7_Pod_Rail_Plate
SW7_Pod_USB_Hatch_Cover
REF_Camera_Case
REF_ESP32_A7670
REF_Pi4_with_Fan
REF_Sensor_Board
SW7_Dash_Bracket
SW7_Dash_Clamp_Cap
REF_Handlebar_22mm
