0geder/Tukzie-HPEC-HUD/CAD/Sensor_Pod_Front/SW7_Front_Sensor_Pod_Exploded.SLDASM

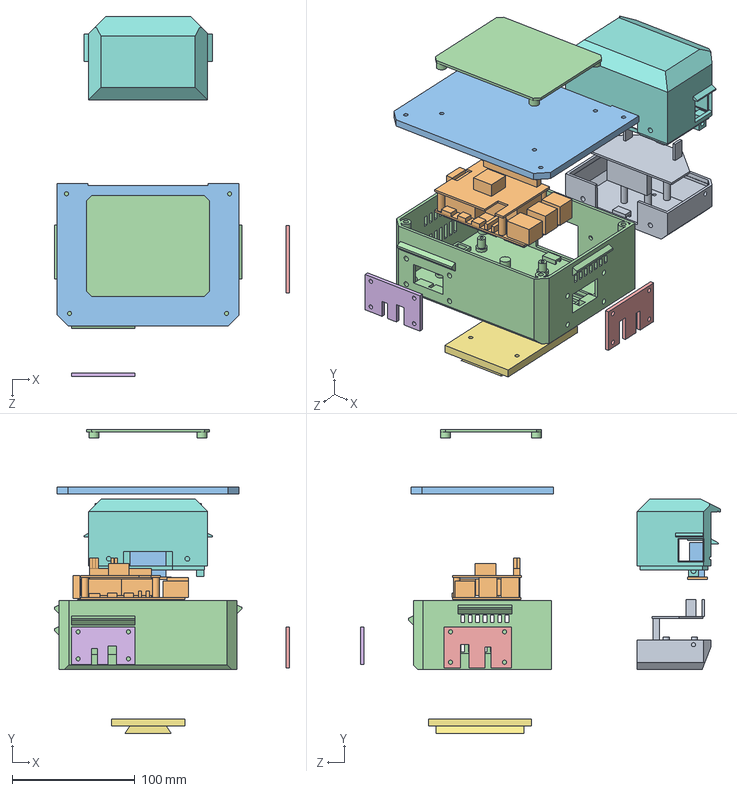
[picture p98: CAD file, 2026-10-15]
CAD/Sensor_Pod_Front/SW7_Front_Sensor_Pod_Exploded.SLDASM
191.8 x 247.8 x 293.4 mm
SW7_FPod_Box_Base
SW7_FPod_Box_Lid
SW7_FPod_Camera_Retainer
SW7_FPod_Head_Tray
SW7_FPod_Head_Upper
SW7_FPod_Rail_Plate
SW7_FPod_Rear_Port_Cover
SW7_FPod_Side_Port_Cover
SW7_FPod_Sunshade
REF_FPod_Camera_Case
REF_FPod_Pi5_with_Cooler
REF_FPod_Sensor_Board
