0geder/Tukzie-HPEC-HUD/CAD/IMU_Pod/rev3/SW7_IMU_Pod_rev3_assembled.stl

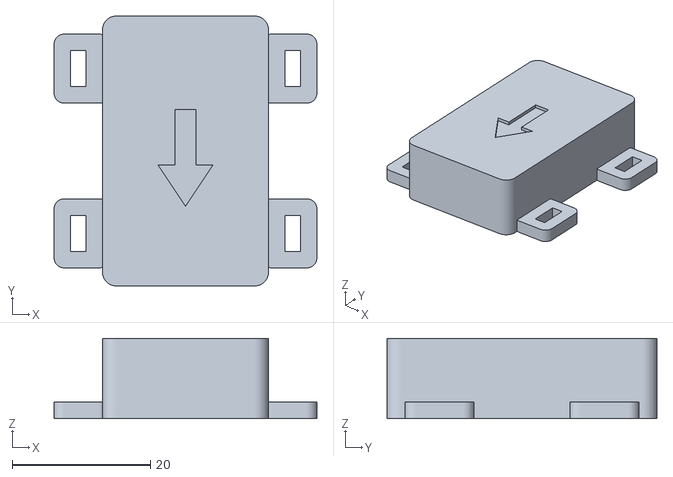
[picture p99: CAD file, 2026-10-13]
CAD/IMU_Pod/rev3/SW7_IMU_Pod_rev3_assembled.stl
38.0 x 39.0 x 11.6
