0geder/Tukzie-HPEC-HUD/CAD/Sensor_Pod/vent_rev/lid_vent_assembled_podframe.stl

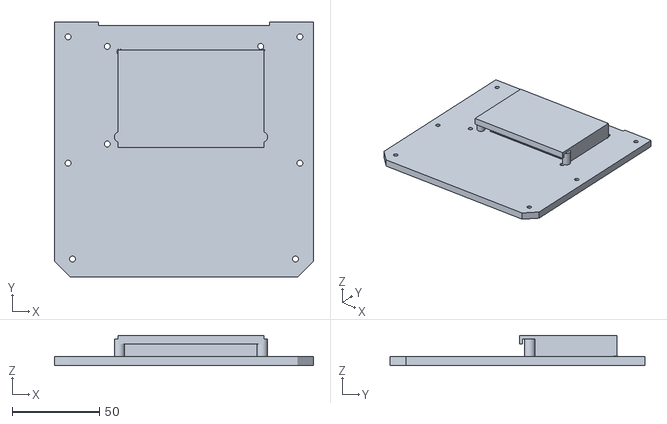
[picture p101: CAD file, 2026-10-16]
CAD/Sensor_Pod/vent_rev/lid_vent_assembled_podframe.stl
148.6 x 146.3 x 17.4
