0geder/Tukzie-HPEC-HUD/CAD/Dashboard_Enclosure/print_parts/SW7_Dash_Pi5_Cradle.SLDPRT

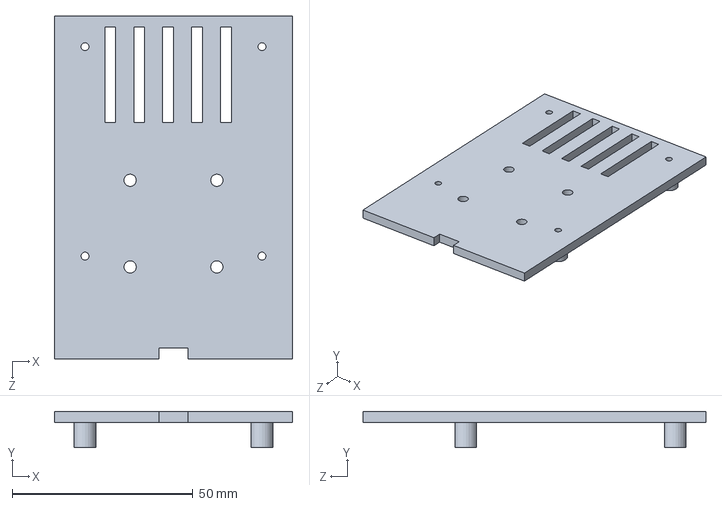
[picture p102: CAD file, 2026-10-12]
CAD/Dashboard_Enclosure/print_parts/SW7_Dash_Pi5_Cradle.SLDPRT
66.0 x 10.0 x 95.0 mm
