0geder/Tukzie-HPEC-HUD/CAD/Dashboard_Enclosure/reference_parts/REF_Pi5_with_cooler.SLDPRT

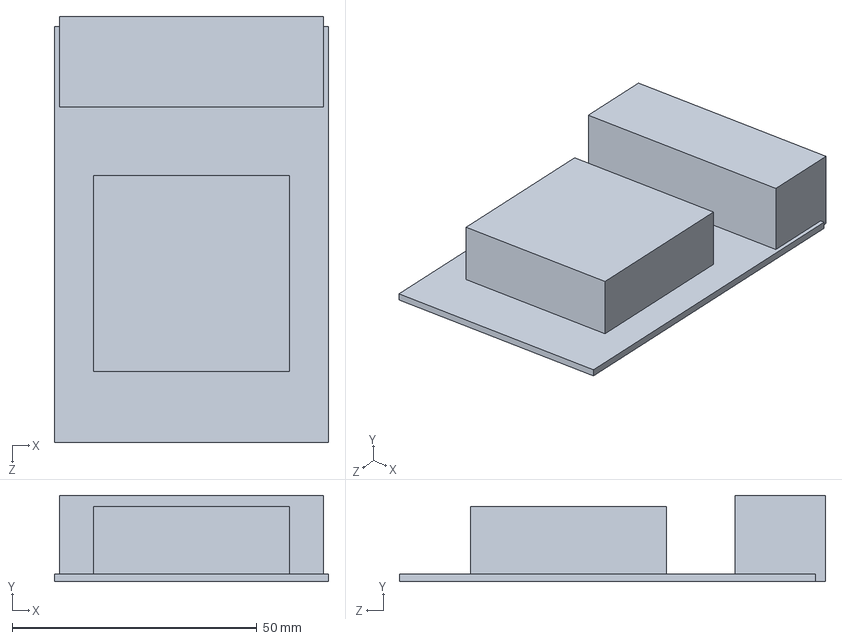
[picture p103: CAD file, 2026-10-12]
CAD/Dashboard_Enclosure/reference_parts/REF_Pi5_with_cooler.SLDPRT
56.0 x 17.6 x 87.0 mm
