0geder/Tukzie-HPEC-HUD/CAD/IMU_Pod/rev3/SW7_IMU_Pod_Lid_rev3.stl

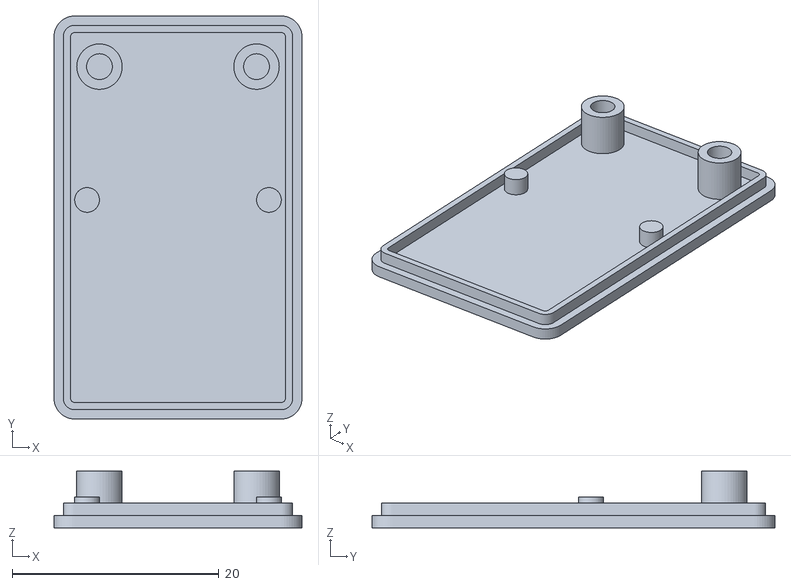
[picture p104: CAD file, 2026-10-13]
CAD/IMU_Pod/rev3/SW7_IMU_Pod_Lid_rev3.stl
24.0 x 39.0 x 5.50
