0geder/Tukzie-HPEC-HUD/CAD/IMU_Pod/SW7_IMU_Pod_Base.SLDPRT

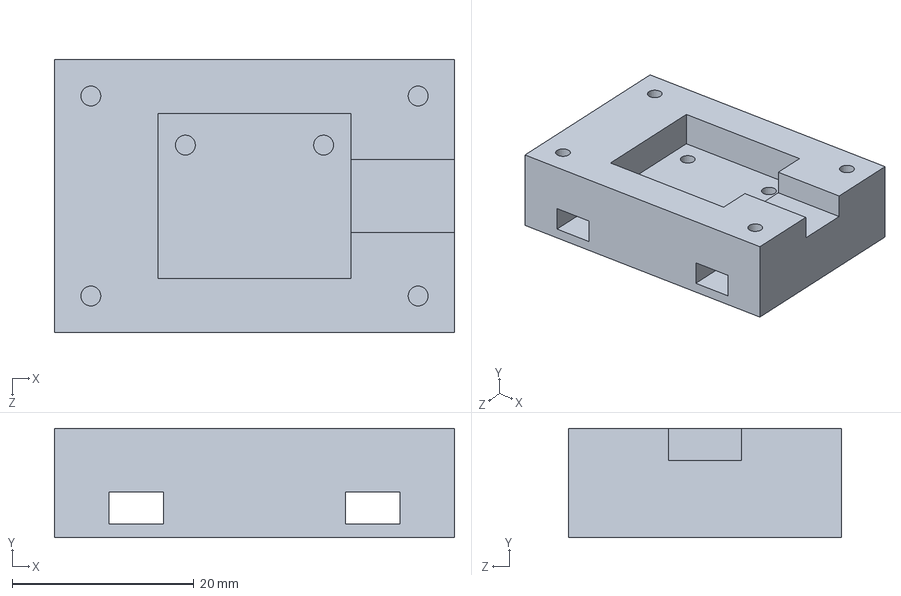
[picture p105: CAD file, 2026-10-12]
CAD/IMU_Pod/SW7_IMU_Pod_Base.SLDPRT
44.0 x 12.0 x 30.0 mm
