0geder/Tukzie-HPEC-HUD/CAD/Sensor_Pod/print_parts/SW7_Pod_Rail_Plate.SLDPRT

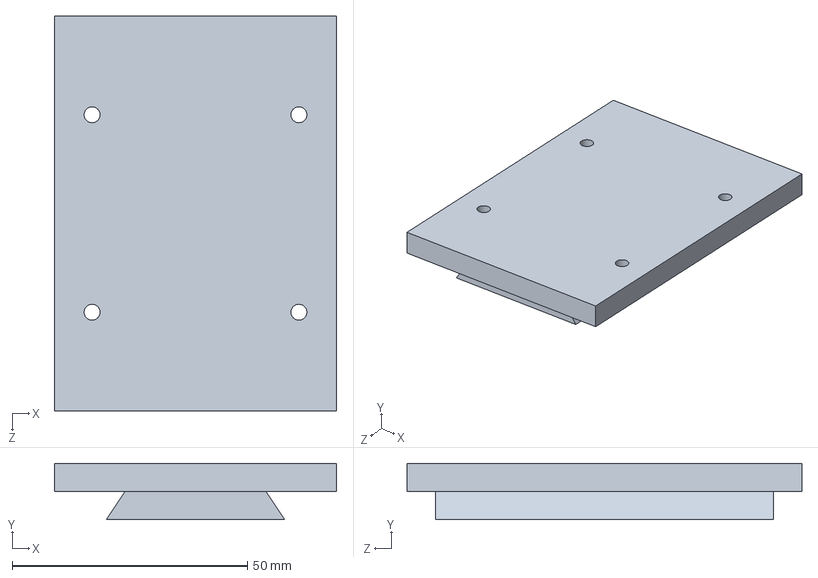
[picture p106: CAD file, 2026-10-12]
CAD/Sensor_Pod/print_parts/SW7_Pod_Rail_Plate.SLDPRT
60.0 x 12.0 x 84.0 mm
