0geder/Tukzie-HPEC-HUD/CAD/Sensor_Pod/reference_parts/REF_View_Cones.SLDPRT

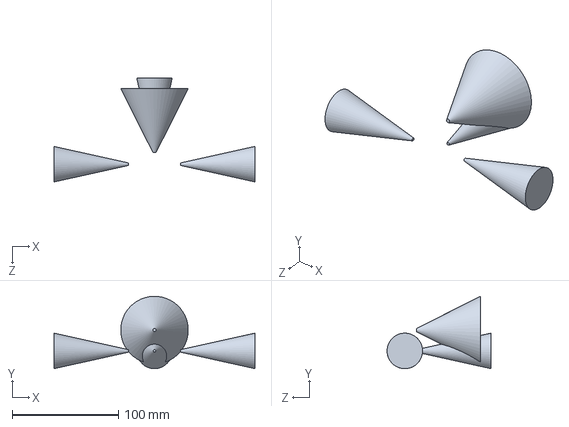
[picture p107: CAD file, 2026-10-12]
CAD/Sensor_Pod/reference_parts/REF_View_Cones.SLDPRT
189.0 x 68.0 x 97.7 mm
