0geder/Tukzie-HPEC-HUD/CAD/Sensor_Pod/vent_rev/SW7_FPod_Lid_Vent_Hood.stl

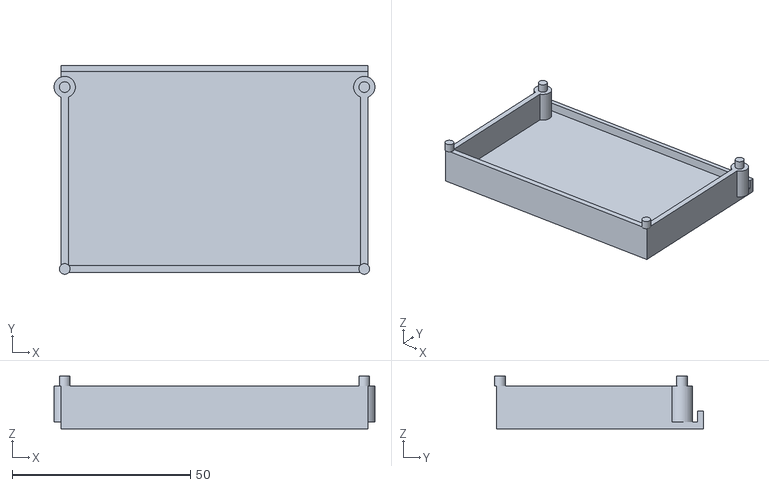
[picture p108: CAD file, 2026-10-16]
CAD/Sensor_Pod/vent_rev/SW7_FPod_Lid_Vent_Hood.stl
90.0 x 58.5 x 14.8
