0geder/Tukzie-HPEC-HUD/CAD/Sensor_Pod_Front/print_parts/SW7_FPod_Side_Port_Cover.SLDPRT

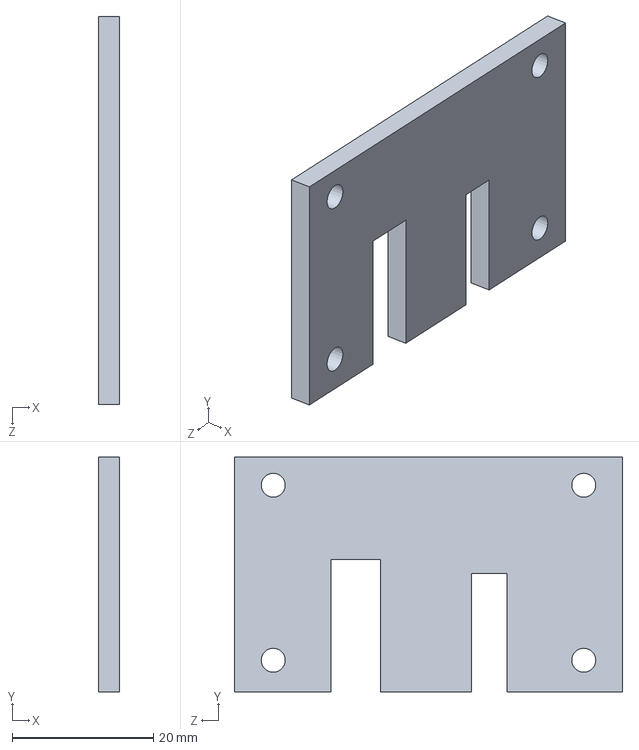
[picture p109: CAD file, 2026-10-15]
CAD/Sensor_Pod_Front/print_parts/SW7_FPod_Side_Port_Cover.SLDPRT
3.00 x 33.3 x 55.0 mm
