0geder/Tukzie-HPEC-HUD/CAD/Sensor_Pod_Front/reference_tools/TOOL_FPod_Hex_Keys.SLDPRT

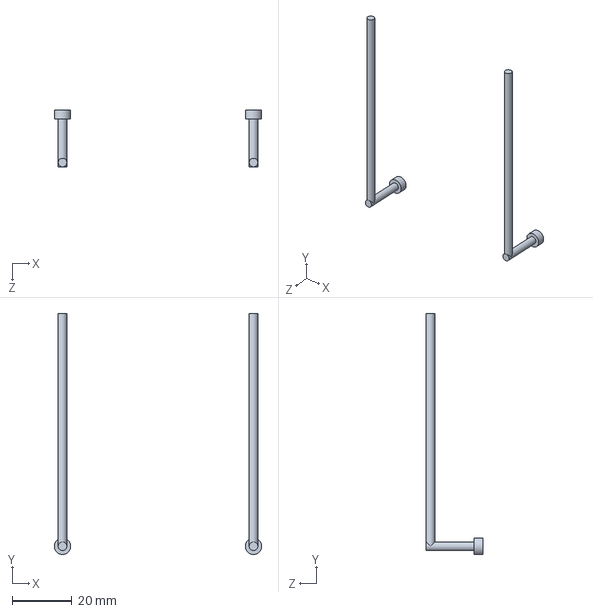
[picture p110: CAD file, 2026-10-15]
CAD/Sensor_Pod_Front/reference_tools/TOOL_FPod_Hex_Keys.SLDPRT
69.5 x 80.8 x 19.0 mm
