0geder/Tukzie-HPEC-HUD/CameraMount/camera_mount.stl

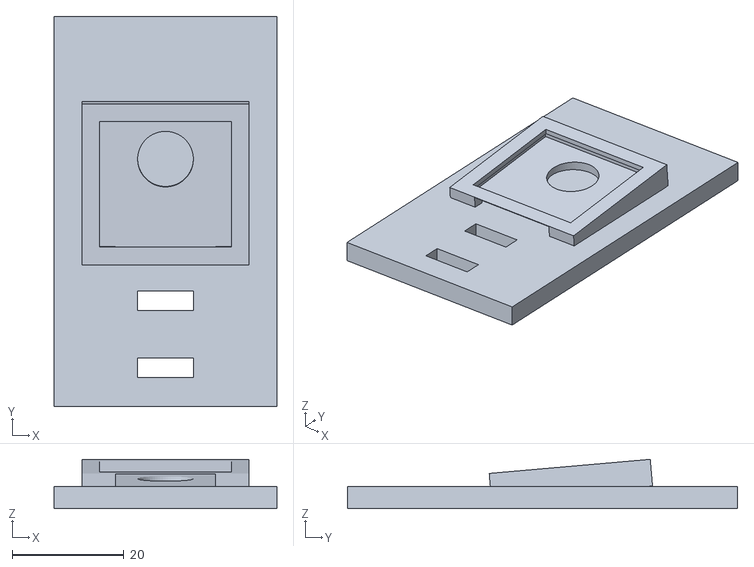
[picture p111: CAD file, 2026-09-19]
CameraMount/camera_mount.stl
40.0 x 70.0 x 8.85
