0geder/Tukzie-HPEC-HUD/CameraMount/casing/RPi_cam_case_bottom.stl

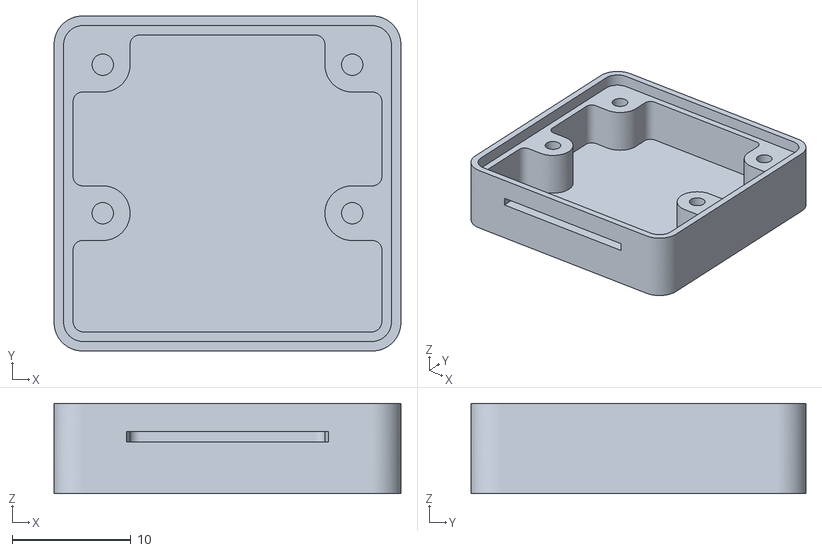
[picture p112: CAD file, 2026-09-25]
CameraMount/casing/RPi_cam_case_bottom.stl
29.2 x 28.2 x 7.60
