0geder/Tukzie-HPEC-HUD/CameraMount/sensor_pod/lid_CONCEPT.stl

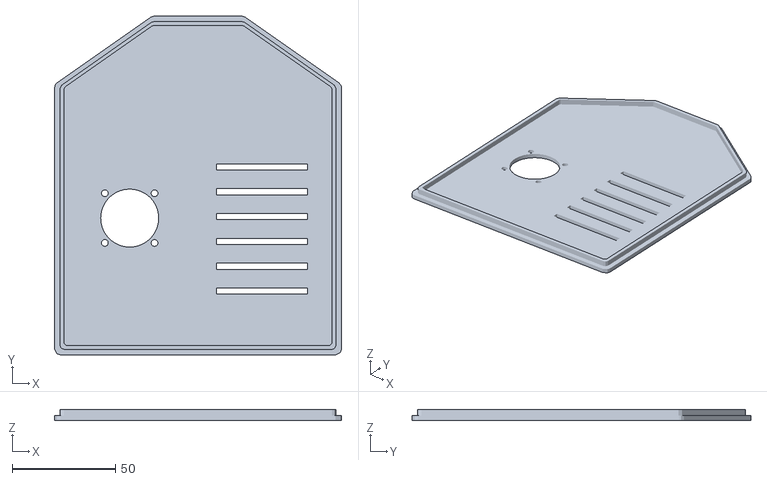
[picture p113: CAD file, 2026-10-07]
CameraMount/sensor_pod/lid_CONCEPT.stl
138.8 x 163.8 x 5.40
