0geder/Tukzie-HPEC-HUD/CAD/Dashboard_Enclosure/print_parts/SW7_Dash_Cross_Joiner.SLDPRT

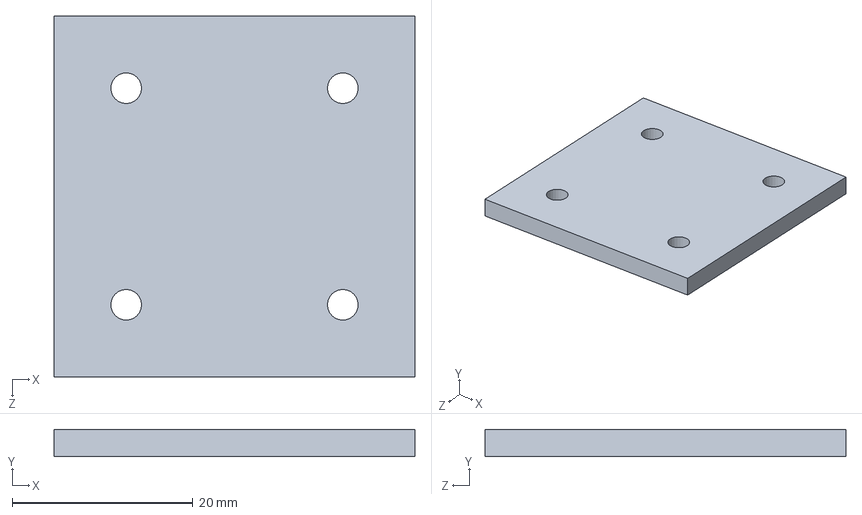
[picture p114: CAD file, 2026-10-12]
CAD/Dashboard_Enclosure/print_parts/SW7_Dash_Cross_Joiner.SLDPRT
40.0 x 3.00 x 40.0 mm
