0geder/Tukzie-HPEC-HUD/CAD/Dashboard_Enclosure/reference_parts/REF_Display_272x187x20.SLDPRT

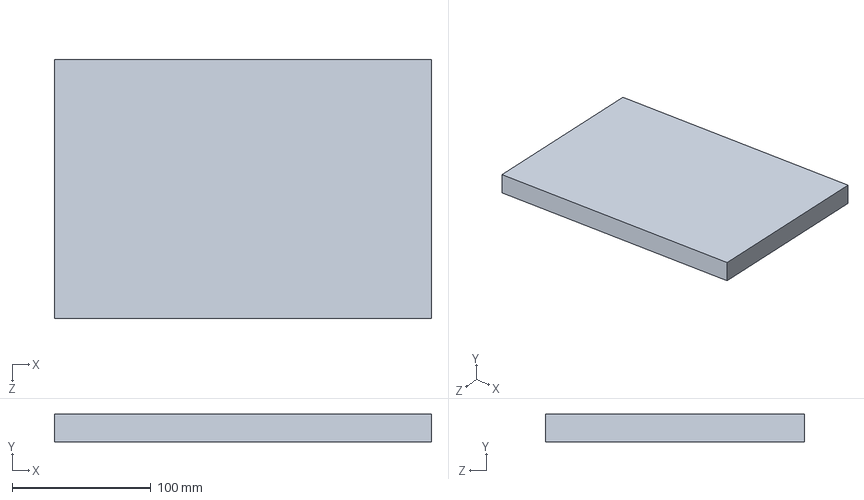
[picture p115: CAD file, 2026-10-12]
CAD/Dashboard_Enclosure/reference_parts/REF_Display_272x187x20.SLDPRT
272.0 x 20.0 x 187.0 mm
