0geder/Tukzie-HPEC-HUD/CAD/Dashboard_Enclosure/SW7_Dash_Back_Shell.SLDPRT

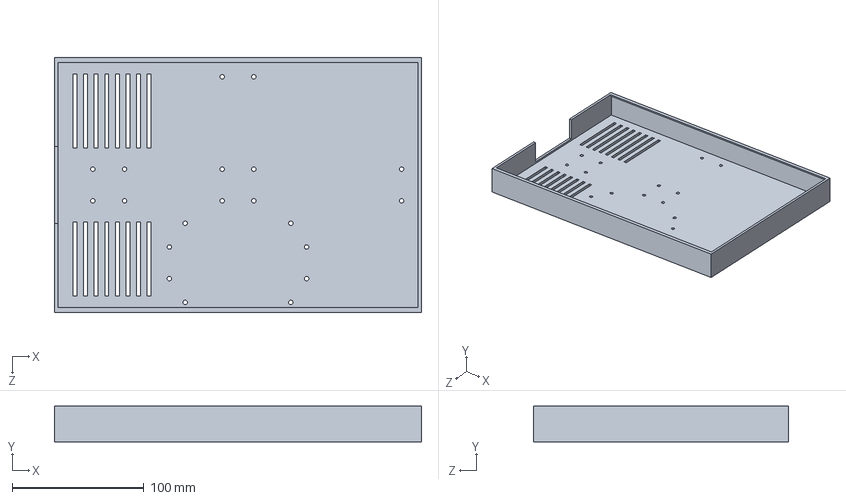
[picture p116: CAD file, 2026-10-12]
CAD/Dashboard_Enclosure/SW7_Dash_Back_Shell.SLDPRT
278.2 x 27.0 x 193.2 mm
