0geder/Tukzie-HPEC-HUD/CAD/IMU_Pod/rev3/SW7_IMU_Pod_Base_rev3.stl

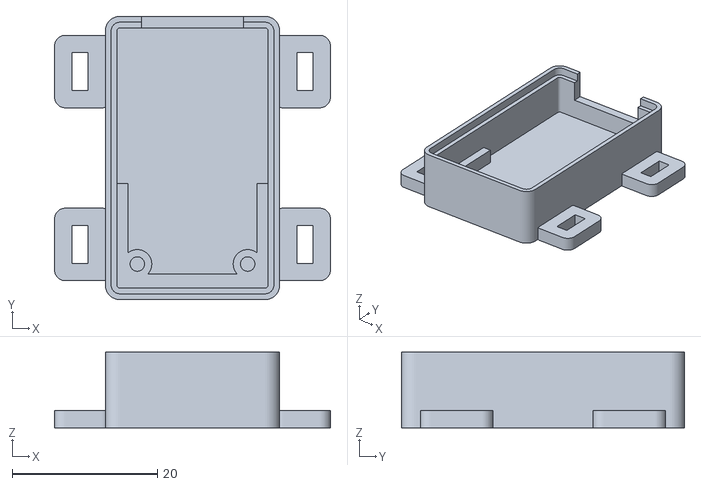
[picture p117: CAD file, 2026-10-13]
CAD/IMU_Pod/rev3/SW7_IMU_Pod_Base_rev3.stl
38.0 x 39.0 x 10.4
