0geder/Tukzie-HPEC-HUD/CAD/IMU_Pod/SW7_IMU_Pod_Lid.SLDPRT

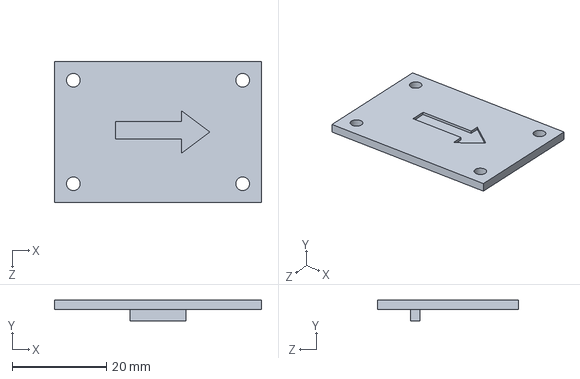
[picture p118: CAD file, 2026-10-12]
CAD/IMU_Pod/SW7_IMU_Pod_Lid.SLDPRT
44.0 x 4.40 x 30.0 mm
