0geder/Tukzie-HPEC-HUD/CAD/Sensor_Pod/print_parts/SW7_Pod_Camera_Retainer.SLDPRT

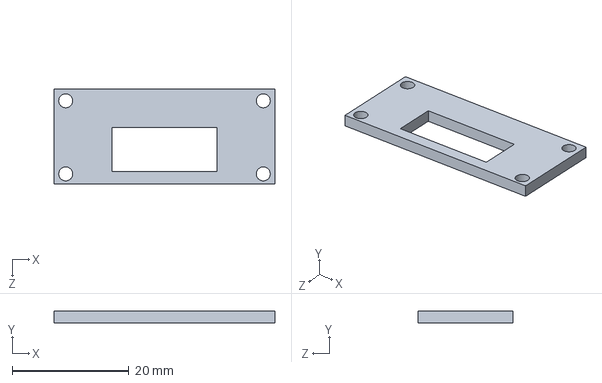
[picture p119: CAD file, 2026-10-12]
CAD/Sensor_Pod/print_parts/SW7_Pod_Camera_Retainer.SLDPRT
37.8 x 2.00 x 16.2 mm
