0geder/Tukzie-HPEC-HUD/CAD/Sensor_Pod/reference_parts/REF_Sensor_Board.SLDPRT

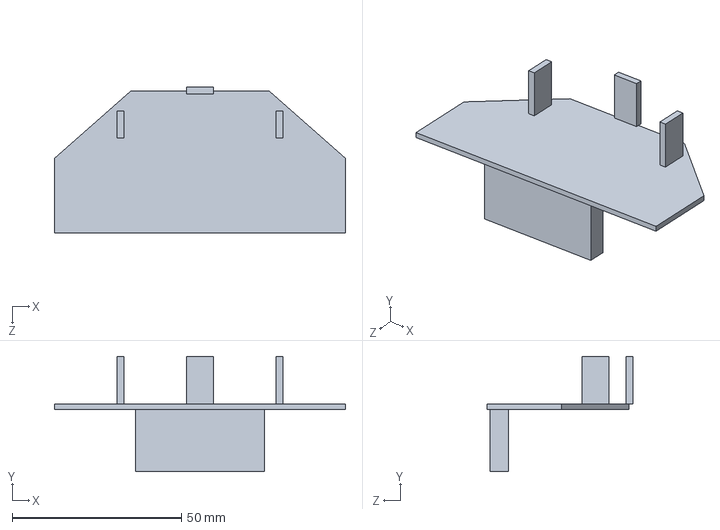
[picture p120: CAD file, 2026-10-12]
CAD/Sensor_Pod/reference_parts/REF_Sensor_Board.SLDPRT
86.0 x 34.0 x 43.0 mm
