0geder/Tukzie-HPEC-HUD/CAD/Sensor_Pod/vent_rev/SW7_FPod_Box_Lid_vented.stl

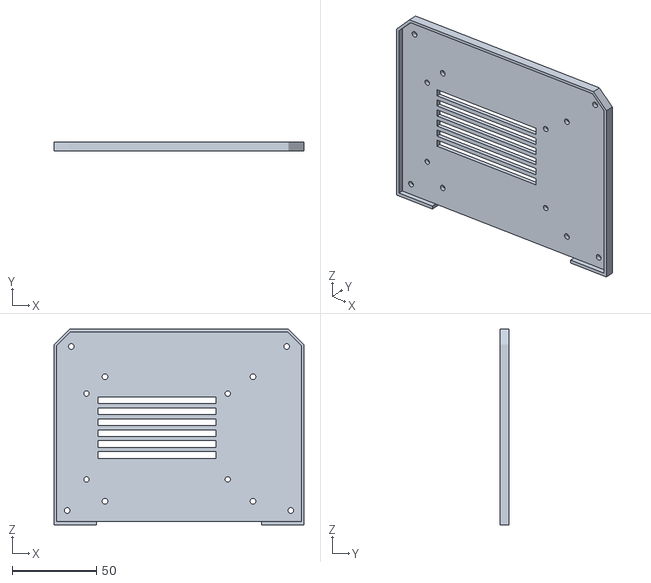
[picture p121: CAD file, 2026-10-16]
CAD/Sensor_Pod/vent_rev/SW7_FPod_Box_Lid_vented.stl
148.6 x 5.40 x 116.3
