0geder/Tukzie-HPEC-HUD/CAD/Sensor_Pod_Front/print_parts/SW7_FPod_Box_Base.SLDPRT

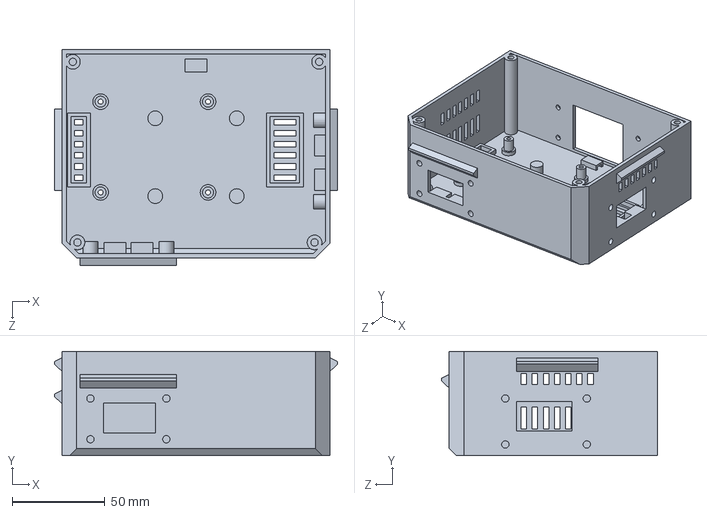
[picture p122: CAD file, 2026-10-15]
CAD/Sensor_Pod_Front/print_parts/SW7_FPod_Box_Base.SLDPRT
152.8 x 56.4 x 116.5 mm
