0geder/Tukzie-HPEC-HUD/CAD/Sensor_Pod_Front/reference_parts/REF_FPod_Camera_Case.SLDPRT

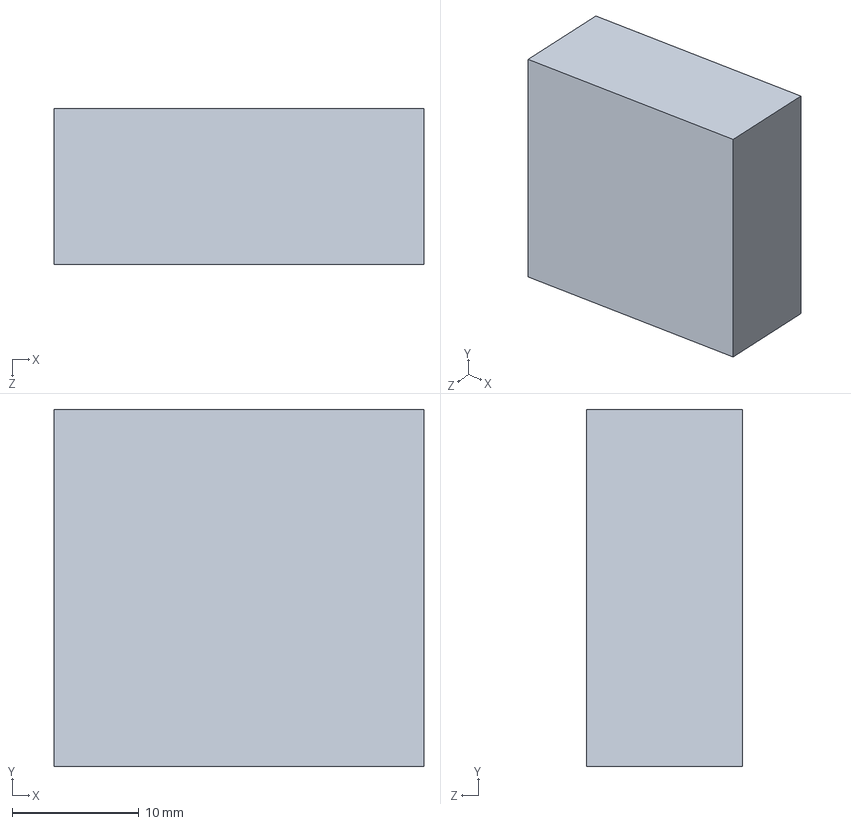
[picture p123: CAD file, 2026-10-15]
CAD/Sensor_Pod_Front/reference_parts/REF_FPod_Camera_Case.SLDPRT
29.2 x 28.2 x 12.4 mm
