0geder/Tukzie-HPEC-HUD/CameraMount/casing/RPi_cam_30_deg_corner_mount.stl

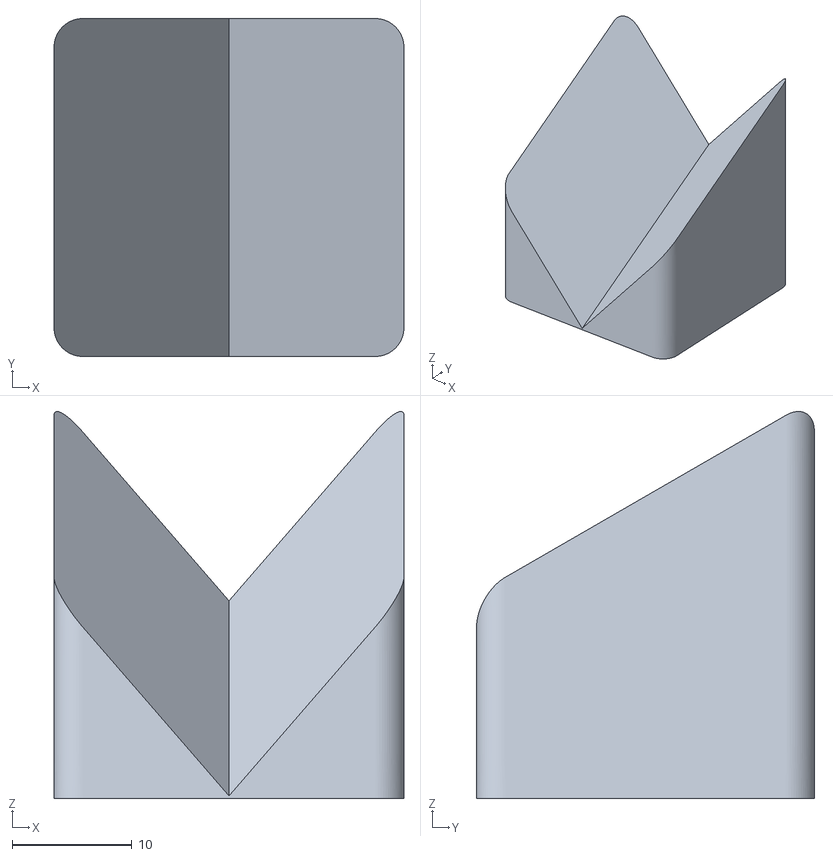
[picture p124: CAD file, 2026-09-25]
CameraMount/casing/RPi_cam_30_deg_corner_mount.stl
29.2 x 28.2 x 32.3
