0geder/Tukzie-HPEC-HUD/CameraMount/sensor_pod/base_CONCEPT.stl

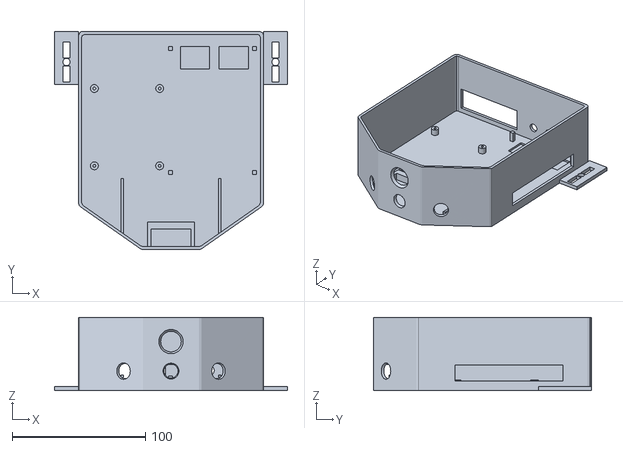
[picture p125: CAD file, 2026-10-07]
CameraMount/sensor_pod/base_CONCEPT.stl
174.8 x 163.8 x 54.8
