0geder/Tukzie-HPEC-HUD/CAD/Dashboard_Enclosure/print_parts/SW7_Dash_Shell_Q_Right_Bottom.SLDPRT

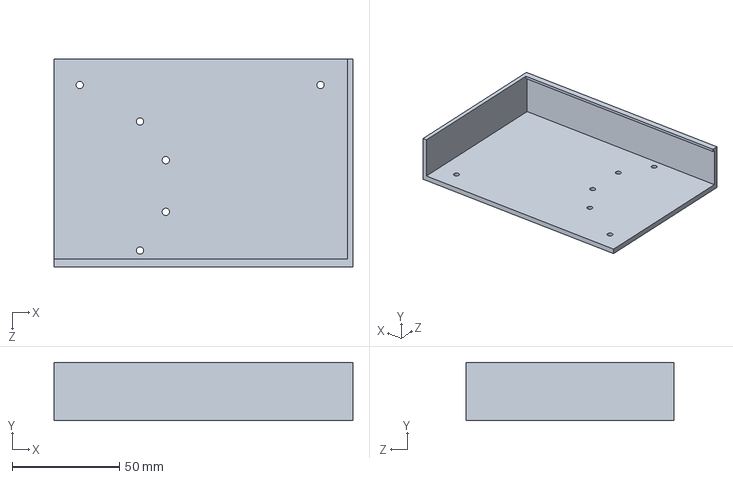
[picture p126: CAD file, 2026-10-12]
CAD/Dashboard_Enclosure/print_parts/SW7_Dash_Shell_Q_Right_Bottom.SLDPRT
139.1 x 27.0 x 96.6 mm
