0geder/Tukzie-HPEC-HUD/CAD/Dashboard_Enclosure/reference_parts/REF_Handlebar_22mm.SLDPRT

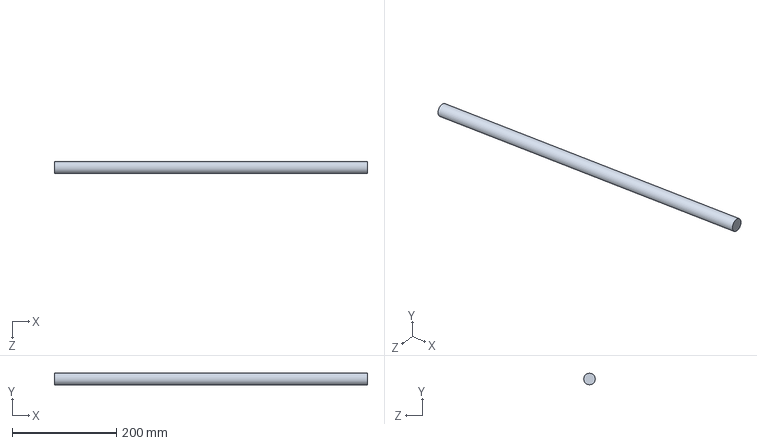
[picture p127: CAD file, 2026-10-12]
CAD/Dashboard_Enclosure/reference_parts/REF_Handlebar_22mm.SLDPRT
600.0 x 22.2 x 22.2 mm
