0geder/Tukzie-HPEC-HUD/CAD/Dashboard_Enclosure/SW7_Dash_Bracket.SLDPRT

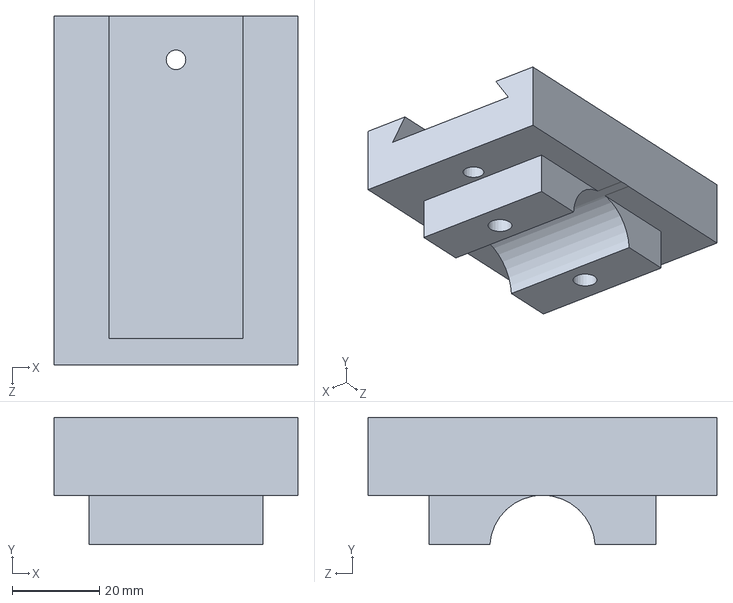
[picture p128: CAD file, 2026-10-12]
CAD/Dashboard_Enclosure/SW7_Dash_Bracket.SLDPRT
56.0 x 29.2 x 80.0 mm
