0geder/Tukzie-HPEC-HUD/CAD/Sensor_Pod/print_parts/SW7_Pod_USB_Hatch_Cover.SLDPRT

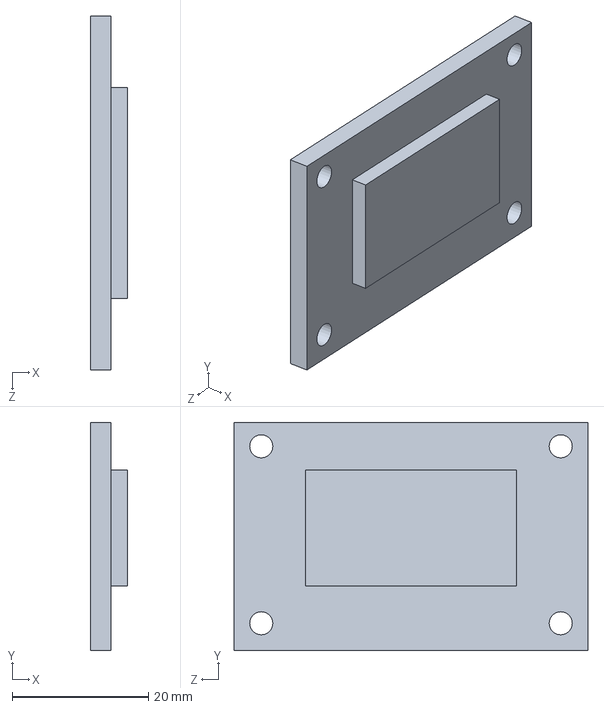
[picture p129: CAD file, 2026-10-12]
CAD/Sensor_Pod/print_parts/SW7_Pod_USB_Hatch_Cover.SLDPRT
5.40 x 33.5 x 52.0 mm
