0geder/Tukzie-HPEC-HUD/CAD/Sensor_Pod/reference_parts/REF_ESP32_A7670.SLDPRT

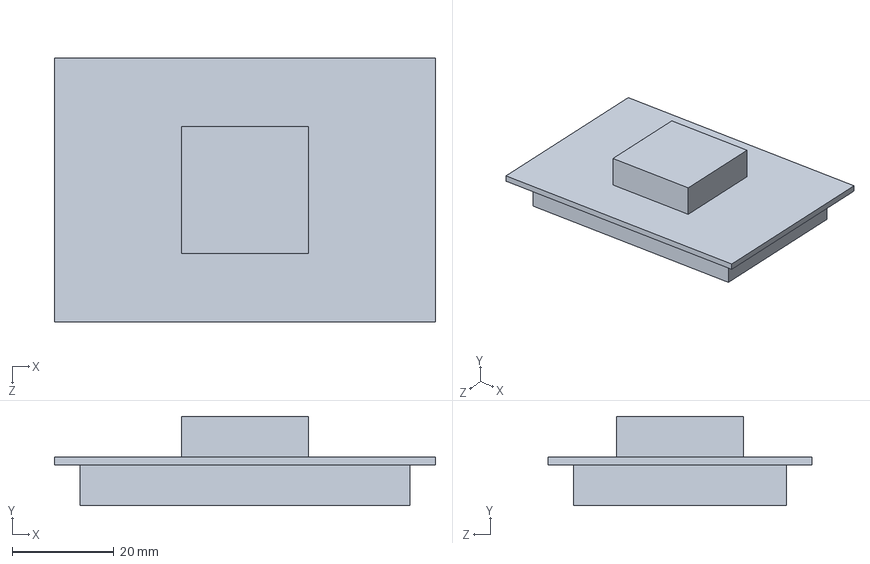
[picture p130: CAD file, 2026-10-12]
CAD/Sensor_Pod/reference_parts/REF_ESP32_A7670.SLDPRT
75.0 x 17.6 x 52.0 mm
