0geder/Tukzie-HPEC-HUD/CAD/Sensor_Pod_Front/print_parts/SW7_FPod_Rear_Port_Cover.SLDPRT

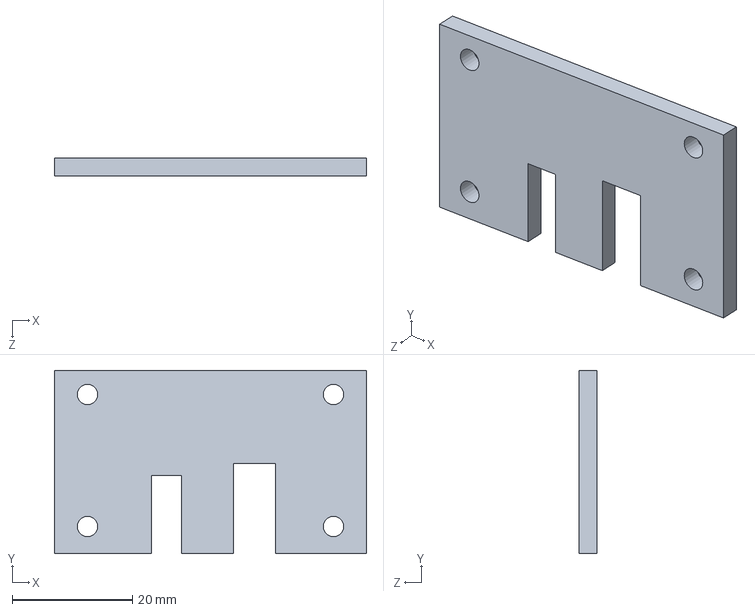
[picture p131: CAD file, 2026-10-15]
CAD/Sensor_Pod_Front/print_parts/SW7_FPod_Rear_Port_Cover.SLDPRT
52.0 x 30.5 x 3.00 mm
