0geder/Tukzie-HPEC-HUD/CAD/Sensor_Pod_Front/reference_parts/REF_FPod_Pi5_with_Cooler.SLDPRT

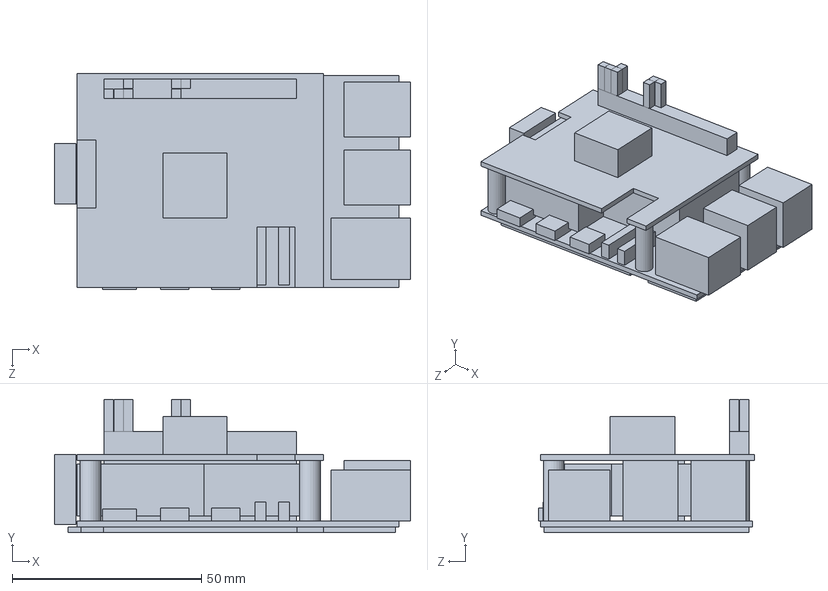
[picture p132: CAD file, 2026-10-15]
CAD/Sensor_Pod_Front/reference_parts/REF_FPod_Pi5_with_Cooler.SLDPRT
94.0 x 35.2 x 57.0 mm
