0geder/Tukzie-HPEC-HUD/CameraMount/casing/RPi_cam_case_top.stl

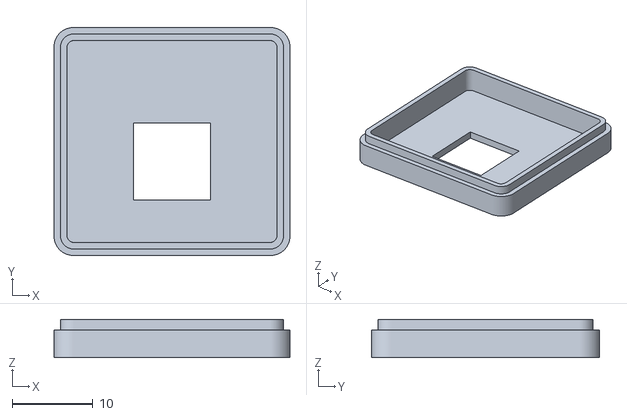
[picture p133: CAD file, 2026-09-25]
CameraMount/casing/RPi_cam_case_top.stl
29.2 x 28.2 x 4.75
