0geder/Tukzie-HPEC-HUD/CAD/Dashboard_Enclosure/SW7_Dash_Clamp_Cap.SLDPRT

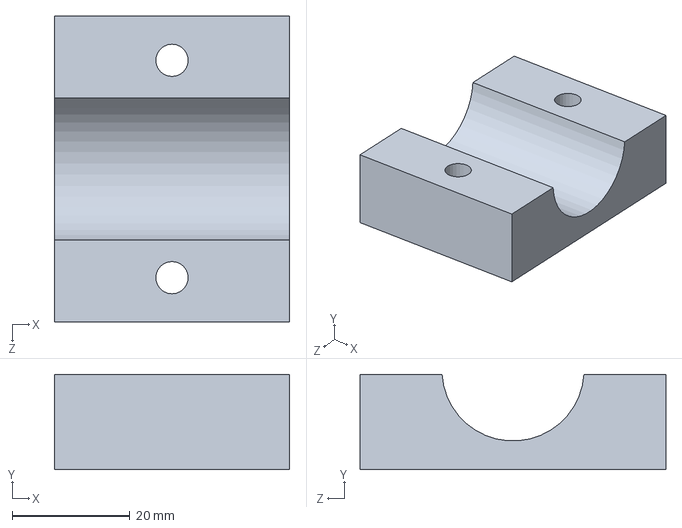
[picture p135: CAD file, 2026-10-12]
CAD/Dashboard_Enclosure/SW7_Dash_Clamp_Cap.SLDPRT
40.0 x 16.2 x 52.0 mm
