0geder/Tukzie-HPEC-HUD/CAD/Sensor_Pod/print_parts/SW7_Pod_Head_Tray.SLDPRT

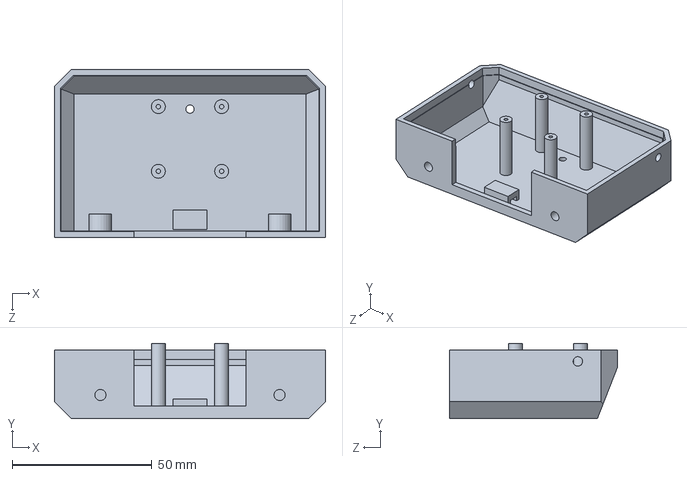
[picture p136: CAD file, 2026-10-12]
CAD/Sensor_Pod/print_parts/SW7_Pod_Head_Tray.SLDPRT
96.8 x 26.8 x 60.1 mm
