0geder/Tukzie-HPEC-HUD/CAD/Sensor_Pod/vent_rev/SW7_Pod_Lid_Vent_Hood.stl

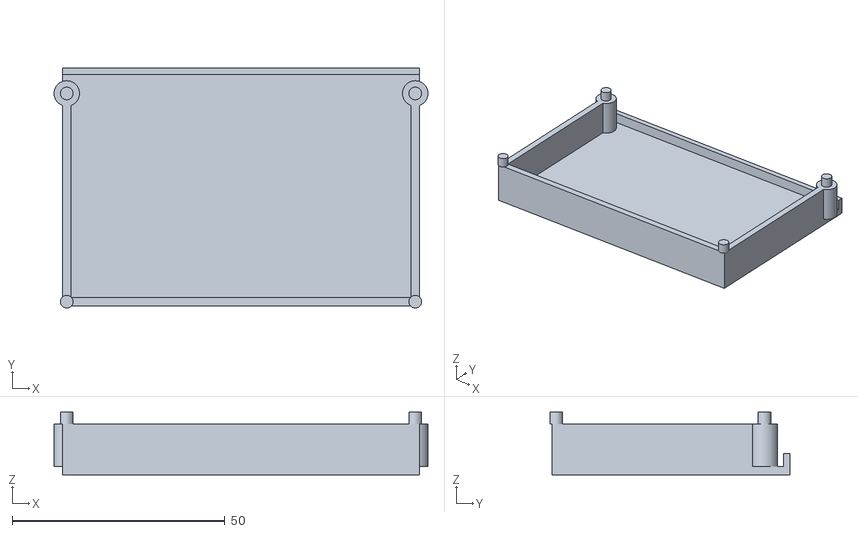
[picture p137: CAD file, 2026-10-16]
CAD/Sensor_Pod/vent_rev/SW7_Pod_Lid_Vent_Hood.stl
88.0 x 56.5 x 14.8
