0geder/Tukzie-HPEC-HUD/CAD/Sensor_Pod_Front/print_parts/SW7_FPod_Box_Lid.SLDPRT

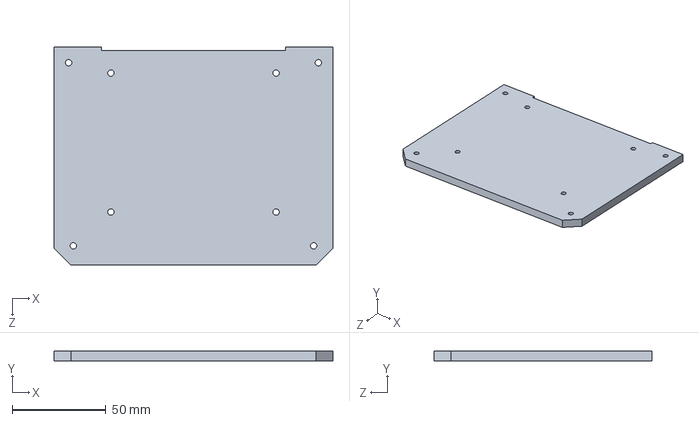
[picture p138: CAD file, 2026-10-15]
CAD/Sensor_Pod_Front/print_parts/SW7_FPod_Box_Lid.SLDPRT
148.6 x 5.40 x 116.3 mm
