0geder/Tukzie-HPEC-HUD/CAD/Dashboard_Enclosure/print_parts/SW7_Dash_Joiner_Plate.SLDPRT

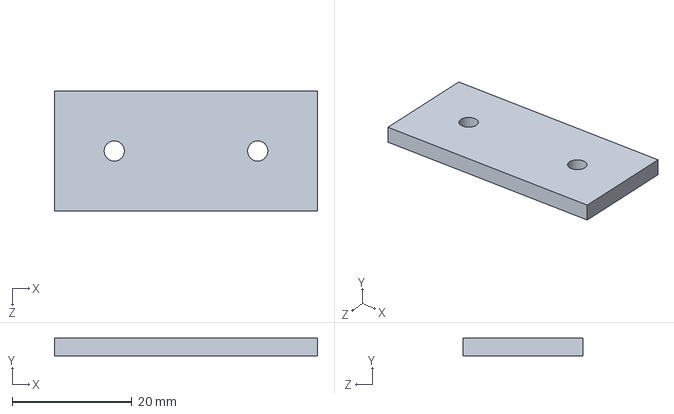
[picture p139: CAD file, 2026-10-12]
CAD/Dashboard_Enclosure/print_parts/SW7_Dash_Joiner_Plate.SLDPRT
44.0 x 3.00 x 20.0 mm
