0geder/Tukzie-HPEC-HUD/CAD/Sensor_Pod/reference_parts/REF_Pi4_with_Fan.SLDPRT

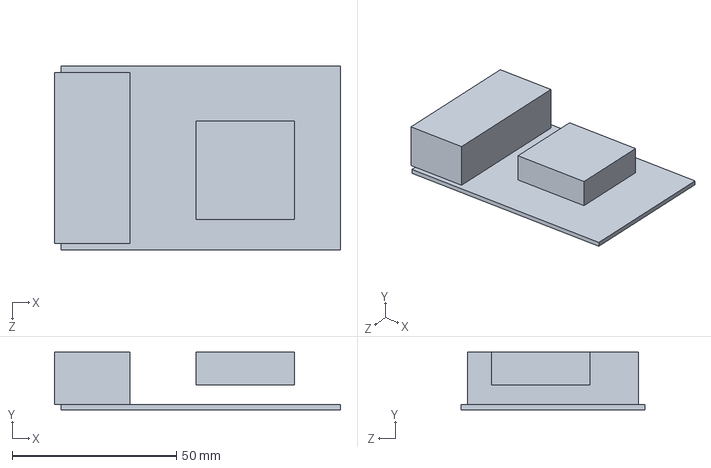
[picture p140: CAD file, 2026-10-12]
CAD/Sensor_Pod/reference_parts/REF_Pi4_with_Fan.SLDPRT
87.0 x 17.6 x 56.0 mm
