0geder/Tukzie-HPEC-HUD/CAD/Sensor_Pod_Front/print_parts/SW7_FPod_Sunshade.SLDPRT

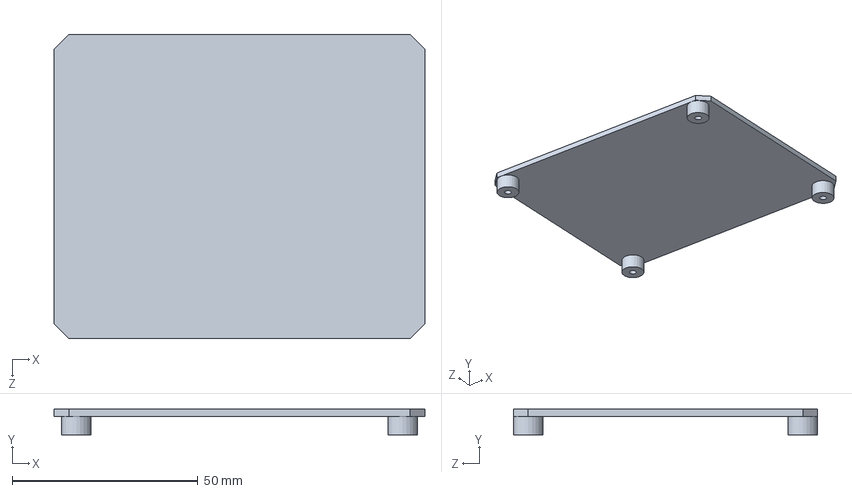
[picture p141: CAD file, 2026-10-15]
CAD/Sensor_Pod_Front/print_parts/SW7_FPod_Sunshade.SLDPRT
100.0 x 7.00 x 82.0 mm
