0geder/Tukzie-HPEC-HUD/CAD/Sensor_Pod_Front/reference_parts/REF_FPod_Cables.SLDPRT

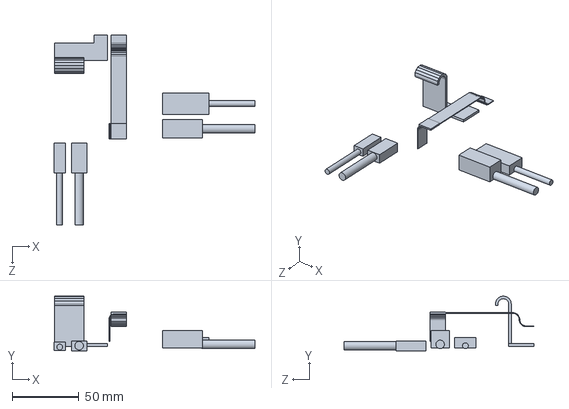
[picture p142: CAD file, 2026-10-15]
CAD/Sensor_Pod_Front/reference_parts/REF_FPod_Cables.SLDPRT
150.4 x 41.2 x 142.5 mm
