0geder/Tukzie-HPEC-HUD/CAD/Dashboard_Enclosure/print_parts/SW7_Dash_Rail_Plate.SLDPRT

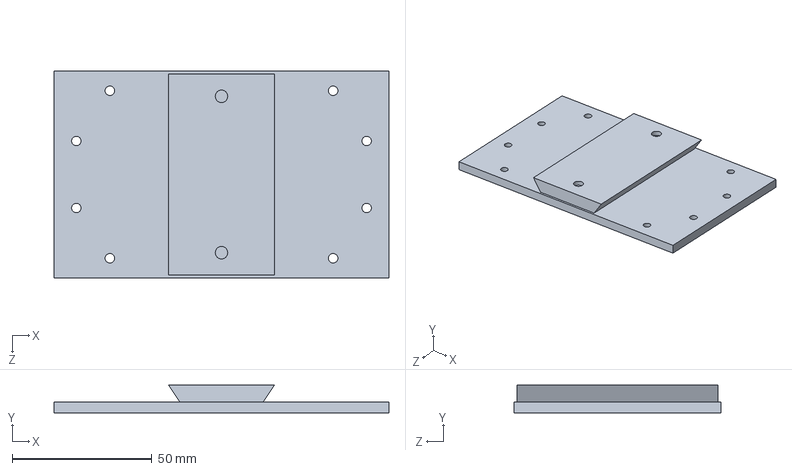
[picture p143: CAD file, 2026-10-12]
CAD/Dashboard_Enclosure/print_parts/SW7_Dash_Rail_Plate.SLDPRT
120.0 x 10.0 x 74.0 mm
