0geder/Tukzie-HPEC-HUD/CAD/Sensor_Pod_Front/print_parts/SW7_FPod_Head_Upper.SLDPRT

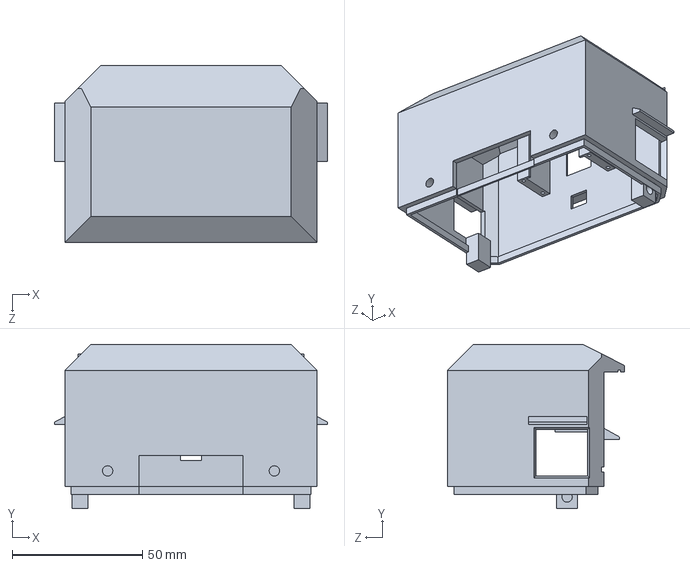
[picture p145: CAD file, 2026-10-15]
CAD/Sensor_Pod_Front/print_parts/SW7_FPod_Head_Upper.SLDPRT
104.8 x 63.1 x 67.9 mm
