0geder/Tukzie-HPEC-HUD/(list of files, cad)

Other CAD files:
CAD/Sensor_Pod_Front/reference_parts/REF_FPod_View_Cones.SLDPRT
CAD/Sensor_Pod/reference_parts/REF_Camera_Case.SLDPRT
CAD/Sensor_Pod_Front/reference_parts/REF_FPod_Sensor_Board.SLDPRT
CAD/Sensor_Pod_Front/print_parts/SW7_FPod_Rail_Plate.SLDPRT
CAD/Dashboard_Enclosure/print_parts/SW7_Dash_Shell_Q_Left_Top.SLDPRT
CAD/Dashboard_Enclosure/print_parts/SW7_Dash_Shell_Q_Right_Top.SLDPRT
CAD/Sensor_Pod_Front/print_parts/SW7_FPod_Head_Tray.SLDPRT
CAD/Sensor_Pod_Front/print_parts/SW7_FPod_Camera_Retainer.SLDPRT
TelemetryUnit/housing/base_concept.stl
TelemetryUnit/housing/lid_concept.stl
