0geder/Tukzie-HPEC-HUD/CAD/Print/PRINT_LIST.md

# SW-7 print list: Prusa MINI, Prusament PLA, 0.20 mm QUALITY

Sliced with PrusaSlicer 2.9.4 from the student's own MINI profiles (`slice_all.py`). PLA is for fit checks; reprint the parts that live on the vehicle (bracket, cap, rail plates, shell, pod) in PETG or ASA, because PLA softens in the sun.

| Bed | What | Settings | Print | Time each | PLA each |
|---|---|---|---|---|---|
| 01_Dash_Shell_Left_Top | Dashboard back shell quarter | enclosure | x1 | 3h 46m 54s | 51 g (17.0 m) |
| 02_Dash_Shell_Left_Bottom | Dashboard back shell quarter | enclosure | x1 | 3h 49m 12s | 51 g (17.0 m) |
| 03_Dash_Shell_Right_Top | Dashboard back shell quarter | enclosure | x1 | 3h 49m 13s | 55 g (18.4 m) |
| 04_Dash_Shell_Right_Bottom | Dashboard back shell quarter | enclosure | x1 | 3h 51m 26s | 55 g (18.4 m) |
| 05_Dash_Rail_Plate_and_Joiners | Dashboard rail plate and the 2 joiner plates | structural | x1 | 4h 21m 38s | 51 g (17.0 m) |
| 06_Dash_Pi5_Cradle_and_Cross_Joiner | Pi 5 cradle and cross joiner | enclosure | x1 | 1h 54m 1s | 23 g (7.6 m) |
| 07_Bar_Clamp_Bracket_and_Cap | Handlebar clamp: print twice (one for the dashboard, one for the sensor pod) | structural support | x2 | 8h 59m 58s | 95 g (31.9 m) |
| 08_Pod_Head_Upper | Sensor pod head, upper shell | enclosure support | x1 | 10h 18m 10s | 114 g (38.2 m) |
| 09_Pod_Head_Tray_and_Camera_Retainer | Sensor pod tray and camera retainer | enclosure bed support | x1 | 3h 1m 56s | 35 g (11.6 m) |
| 10_Pod_Box_Base | Sensor pod electronics box | enclosure bed support | x1 | 11h 23m 11s | 130 g (43.6 m) |
| 11_Pod_Box_Lid | Sensor pod lid | enclosure | x1 | 3h 42m 17s | 56 g (18.6 m) |
| 12_Pod_Rail_Plate_Sunshade_Hatch | Sensor pod rail plate, sunshade and USB hatch cover | structural | x1 | 5h 11m 59s | 61 g (20.5 m) |
| 13_IMU_Pods_x2 | Two IMU pods (dashboard and rear), base and lid each | enclosure | x1 | 2h 27m 50s | 27 g (9.1 m) |

Total: about 75 h 30 min of printing and 897 g of PLA (about 0.90 kg), counting the clamp twice.
