0geder/Tukzie-HPEC-HUD/CameraDetection/deploy/INSTALL.md

# Running the detector as a service on the Pi 4

The service starts the detector at boot with the live view and the
`/alerts` endpoint on port 8080, and restarts it if it stops unexpectedly.

## Before installing

The detector must already run by hand (see `../README.md`, Deploying):
`~/hazard_detector` holds `hazard_detector.py`, `detect.tflite`,
`labelmap.txt` and the `venv` with `ai-edge-litert`.

The `ExecStart` line uses the flags the detector is run with by hand:
`--duration 0 --threads 4 --preview --preview-host 0.0.0.0 --tuning
ov5647_noir.json --saturation 1.8 --log-path /home/ogeder/alerts_live.jsonl`.
Change it there if the camera module or log location changes.

## Install (laptop, then Pi)

Laptop PowerShell, from the repository root:

```
scp -i ~/.ssh/pi4_camera_key CameraDetection/hazard_detector.py CameraDetection/deploy/hazard-detector.service ogeder@<pi-ip>:~/hazard_detector/
```

Pi terminal:

```
sudo cp ~/hazard_detector/hazard-detector.service /etc/systemd/system/
sudo systemctl daemon-reload
sudo systemctl enable --now hazard-detector
systemctl status hazard-detector --no-pager
```

`active (running)` means it is up. The live view is then at
`http://<pi-ip>:8080` and the alerts at `http://<pi-ip>:8080/alerts`.

## Everyday use

| Task | Command (Pi) |
|---|---|
| See its output (alerts, 5 s timing lines) | `journalctl -u hazard-detector -f` |
| Stop it (for example to run the detector by hand) | `sudo systemctl stop hazard-detector` |
| Start it again | `sudo systemctl start hazard-detector` |
| Stop it starting at boot | `sudo systemctl disable hazard-detector` |
| After copying a new `hazard_detector.py` | `sudo systemctl restart hazard-detector` |

Only one program can use the camera at a time, so stop the service before
running the detector or `rpicam-hello` by hand.

## Address for the dashboard

The Pi 4's name is `pi4-camera`, so on a normal network the dashboard can
use `http://pi4-camera.local:8080` (mDNS, provided by avahi-daemon on Pi
OS). Check it from the Pi 5 with `ping pi4-camera.local`. On the phone
hotspot `.local` names did not resolve, and the address changes when the
Pi reconnects, so there set `TUKZIE_CAMERA_URL` on the Pi 5 to the
current IP from `hostname -I` on the Pi 4.

## Telemetry bridge (port 8081)

`telemetry_bridge.py` serves `GET /telemetry` for the Pi 5 dashboard: the
ESP32's latest `DASH` line from USB serial plus the three ToF sensors (see
`DashboardIntegration/TELEMETRY_LINK.md`). It runs from the same folder and
venv as the detector.

Laptop PowerShell, from the repository root:

```
scp -i ~/.ssh/pi4_camera_key CameraDetection/telemetry_bridge.py CameraDetection/tof_reader.py CameraDetection/sensor_fusion.py CameraDetection/fusion_config.json CameraDetection/deploy/telemetry-bridge.service ogeder@<pi-ip>:~/hazard_detector/
```

Pi terminal:

```
~/hazard_detector/venv/bin/pip install pyserial adafruit-blinka adafruit-circuitpython-vl53l0x
cd ~/hazard_detector && venv/bin/python3 telemetry_bridge.py --duration 20
sudo cp ~/hazard_detector/telemetry-bridge.service /etc/systemd/system/
sudo systemctl daemon-reload
sudo systemctl enable --now telemetry-bridge
curl -s http://localhost:8081/telemetry
```

pyserial is optional: without it the bridge reads the tty directly. The
ToF libraries are only needed for the sensors; without them `tof` is null.
The bridge also sends a UDP discovery beacon every 2 s to port 50808 on
every interface's broadcast address, so the dashboard can find the Pi 4 on
any network (`DashboardIntegration/TELEMETRY_LINK.md` section 4.2). The
status page `http://localhost:8081/` shows how many were sent and failed.
Add `--no-beacon` to `ExecStart` to turn it off.

The bridge imports `sensor_fusion.py` (camera and ToF fusion), so copy it
with the bridge. With the detector running (`--preview`, as in its
service), the bridge fuses its `/detections` with the ToF readings and
adds a `fusion` block to `/telemetry` (also `GET /hazards`). It logs
nothing by default; for a C9 test session run the bridge by hand with
`--fusion-log ~/c9/<step>.jsonl` (about 5 to 10 MB per hour). `--fusion off`
turns fusion off. Geometry: `fusion_config.json` (TEST_PROCEDURES.md C9).

Logs: `journalctl -u telemetry-bridge -f`. Stop the service before running
`tof_reader.py` by hand, since both use the same sensors.

### GPS replay for bench testing (not live data)

`tests/replay_uct_route.txt` is a generated GPS track along a real road
route near UCT upper campus (OSRM route on OpenStreetMap data, built by
`tools/make_replay_track.py`). It lets the dashboard's moving map be tested
on the bench without riding. It is not a recording: every line has
`"fw":"0.7.1-replay"`, and while it plays `/telemetry` reports
`"replay": true` and `"replay_file": "replay_uct_route.txt"` in the
`bridge` block, so the dashboard can show a REPLAY badge. Never present it
as ride data.

Laptop PowerShell, from the repository root (only needed once, or after
regenerating the file):

```
scp -i ~/.ssh/pi4_camera_key CameraDetection/telemetry_bridge.py ogeder@<pi-ip>:~/hazard_detector/
ssh -i ~/.ssh/pi4_camera_key ogeder@<pi-ip> "mkdir -p ~/hazard_detector/tests"
scp -i ~/.ssh/pi4_camera_key CameraDetection/tests/replay_uct_route.txt ogeder@<pi-ip>:~/hazard_detector/tests/
```

Pi terminal. The service holds port 8081, so stop it first:

```
sudo systemctl stop telemetry-bridge
cd ~/hazard_detector && venv/bin/python3 telemetry_bridge.py --replay tests/replay_uct_route.txt --no-tof
```

The file plays one line per second and loops at the end (about 11 minutes
per lap, 650 lines over about 3 km). Leave out `--no-tof` to keep the real
ToF sensors, or use `--fake-tof` for made-up distances. Check it with
`curl -s http://localhost:8081/telemetry` (look for `"replay": true`).
Stop it with Ctrl+C, then put the live bridge back:

```
sudo systemctl start telemetry-bridge
curl -s http://localhost:8081/telemetry
```

and confirm `"replay": false` before any real test or demonstration.
