0geder/Tukzie-HPEC-HUD/Presentation/Poster_A1_print.pdf

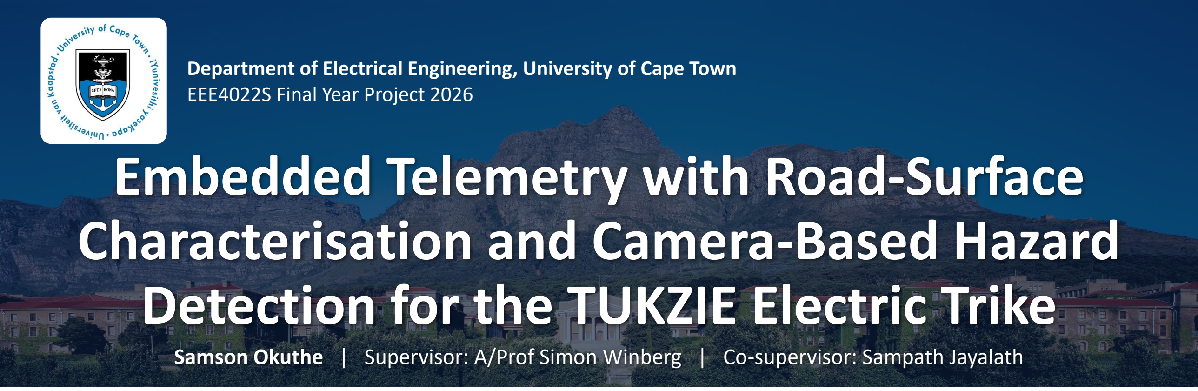
[picture p146: figure]
EEE4022S Final Year Project 2026 Embedded Telemetry with Road-Surface; Detection for the TUKZIE Electric Trike

### Department of Electrical Engineering, University of Cape Town

# Characterisation and Camera-Based Hazard

## Samson Okuthe | Supervisor: A/Prof Simon Winberg | Co-supervisor: Sampath Jayalath

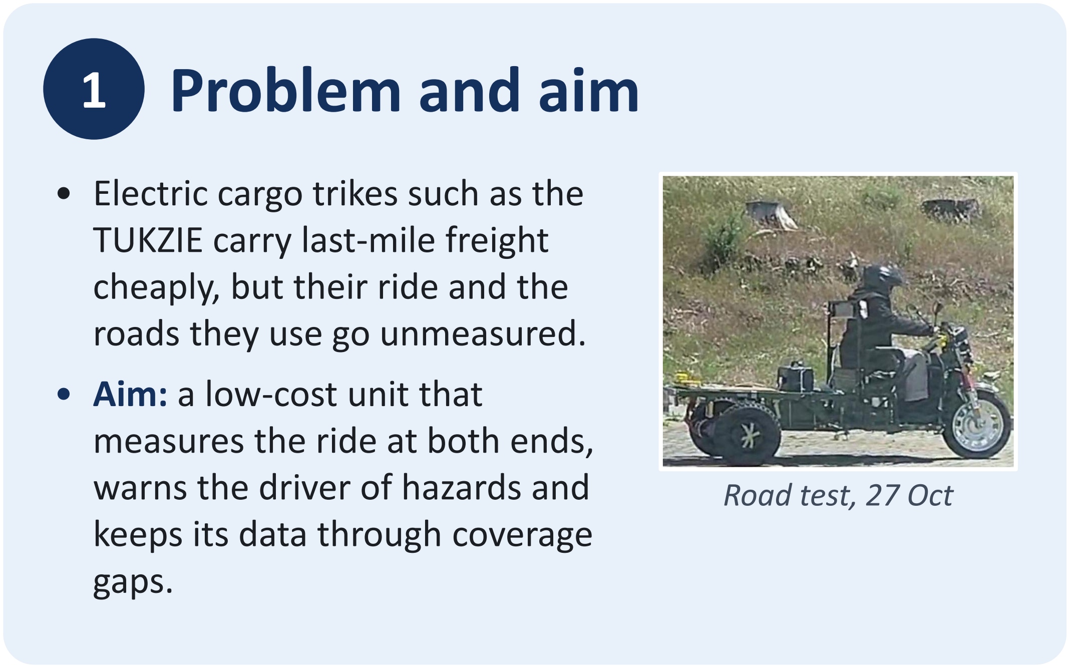
[picture p147: figure]
1 Problem and aim; • Electric cargo trikes such as the TUKZIE carry last-mile freight cheaply, but their ride and the roads they use go unmeasured.; • Aim: a low-cost unit that measures the ride at both ends, warns the driver of hazards and keeps its data through coverage gaps.; Road test, 27 Oct
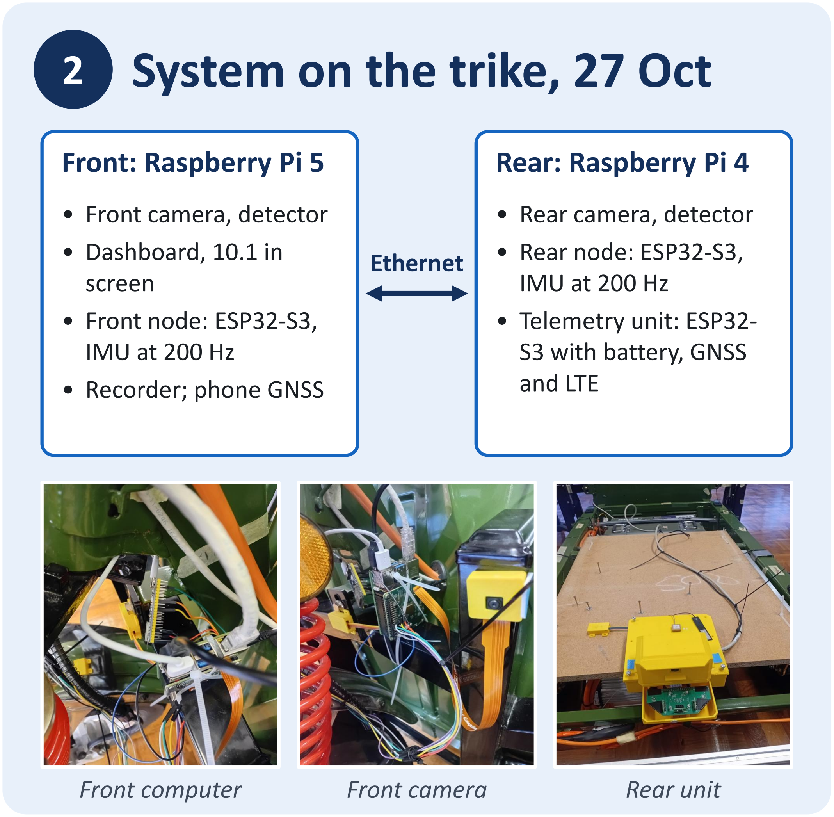
[picture p148: figure]
2 System on the trike, 27 Oct; Front: Raspberry Pi 5; • Front camera, detector • Dashboard, 10.1 in screen • Front node: ESP32-S3, IMU at 200 Hz • Recorder; phone GNSS; Rear: Raspberry Pi 4; • Rear camera, detector • Rear node: ESP32-S3, IMU at 200 Hz • Telemetry unit: ESP32- S3 with battery, GNSS and LTE; Ethernet; Front computer; Front camera; Rear unit
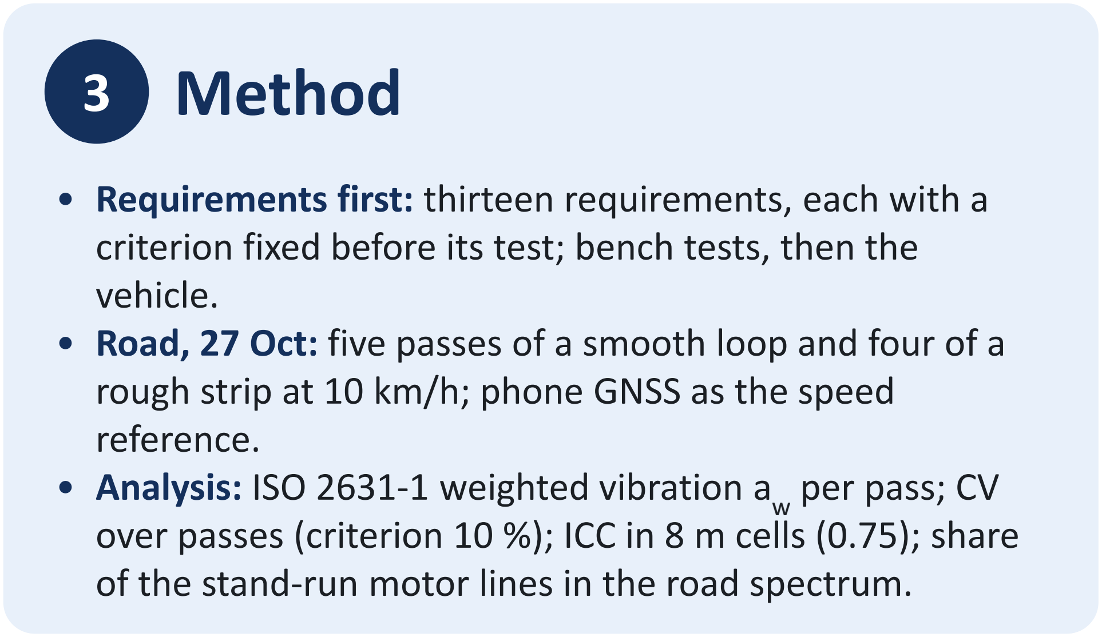
[picture p149: figure]
3 Method; vehicle.; reference.; per pass; CV

- Requirements first: thirteen requirements, each with a criterion fixed before its test; bench tests, then the
- Road, 27 Oct: five passes of a smooth loop and four of a rough strip at 10 km/h; phone GNSS as the speed
- Analysis: ISO 2631-1 weighted vibration a
over passes (criterion 10 %); ICC in 8 m cells (0.75); share of the stand-run motor lines in the road spectrum.

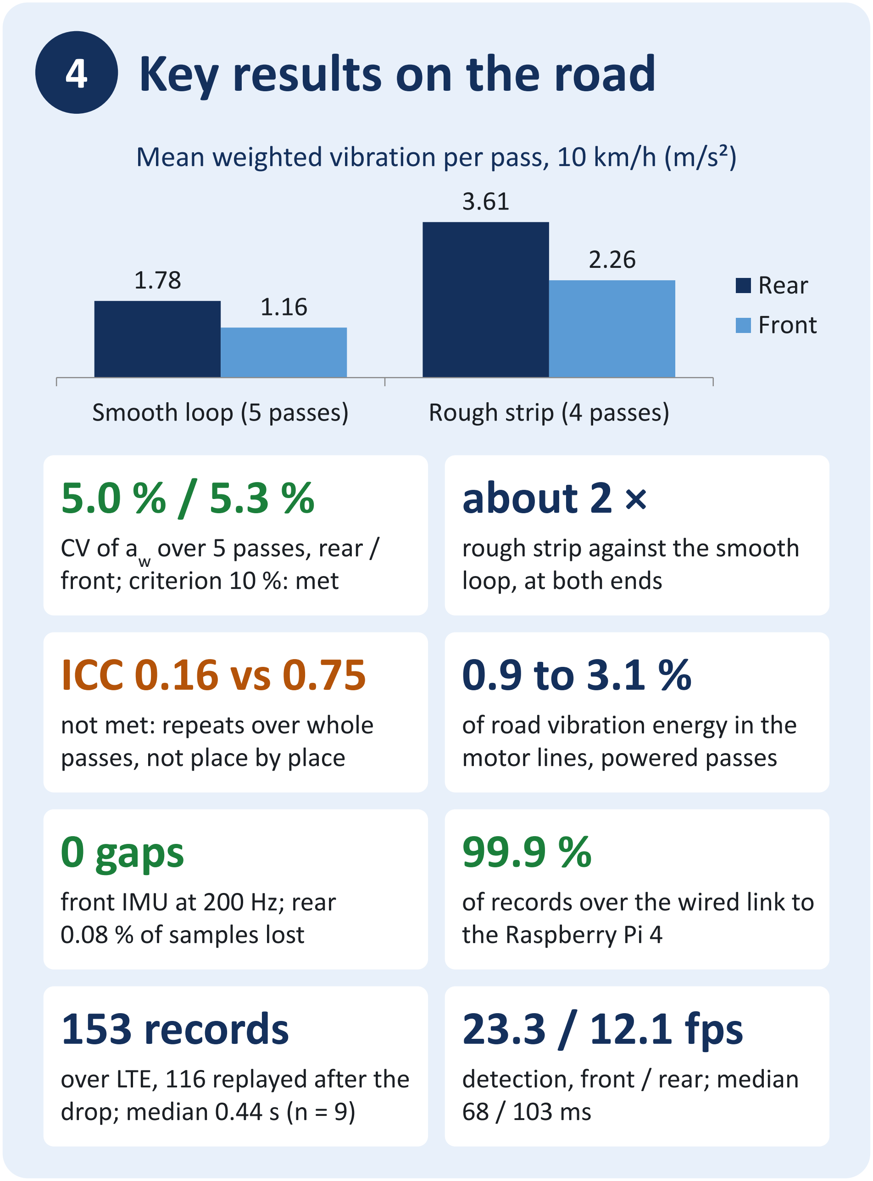
[picture p150: figure]
4 Key results on the road; Smooth loop (5 passes); Rough strip (4 passes); Rear Front; over 5 passes, rear / front; criterion 10 %: met; about 2 ×; rough strip against the smooth loop, at both ends; ICC 0.16 vs 0.75; not met: repeats over whole passes, not place by place; of road vibration energy in the motor lines, powered passes; 0 gaps; front IMU at 200 Hz; rear 0.08 % of samples lost; of records over the wired link to the Raspberry Pi 4; 153 records; over LTE, 116 replayed after the drop; median 0.44 s (n = 9); 23.3 / 12.1 fps; detection, front / rear; median 68 / 103 ms

Mean weighted vibration per pass, 10 km/h (m/s²)

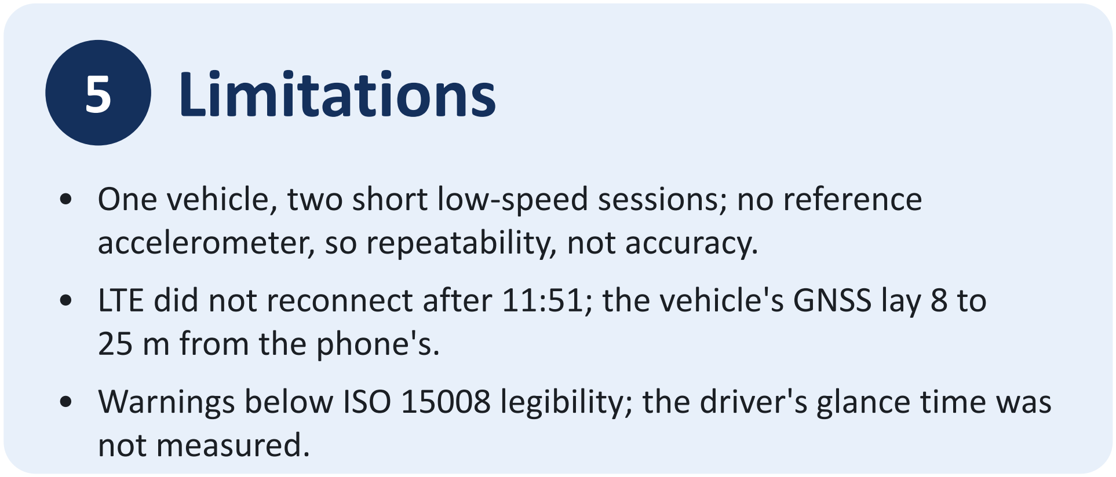
[picture p151: figure]
5 Limitations; accelerometer, so repeatability, not accuracy.; 25 m from the phone's.; not measured.

- One vehicle, two short low-speed sessions; no reference
- LTE did not reconnect after 11:51; the vehicle's GNSS lay 8 to
- Warnings below ISO 15008 legibility; the driver's glance time was

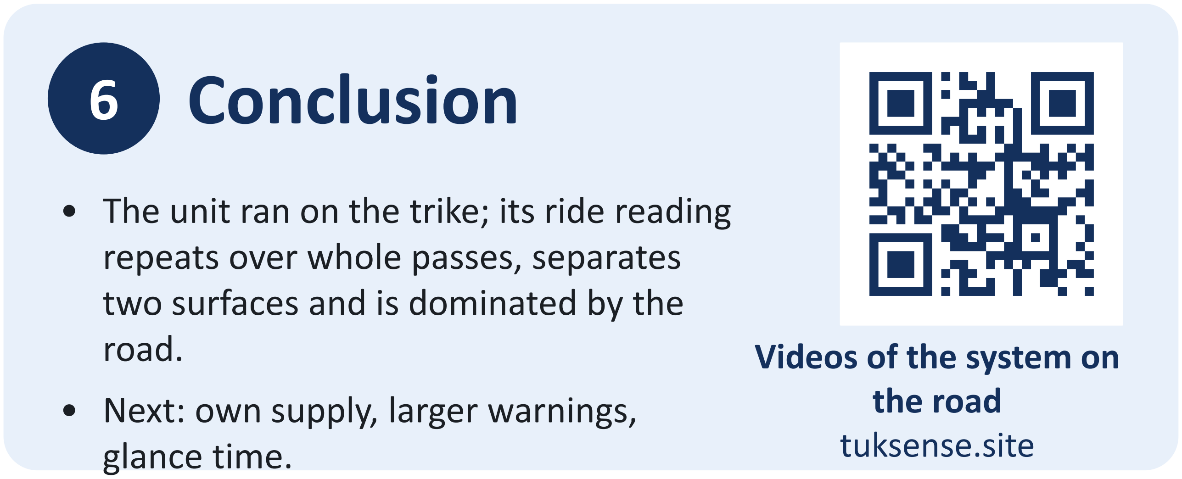
[picture p152: figure]
6 Conclusion; repeats over whole passes, separates two surfaces and is dominated by the road.; • Next: own supply, larger warnings, glance time.; Videos of the system on the road tuksense.site

- The unit ran on the trike; its ride reading
