0geder/Tukzie-HPEC-HUD/CAD/Dashboard_Enclosure/previews/assembly_from_below.png

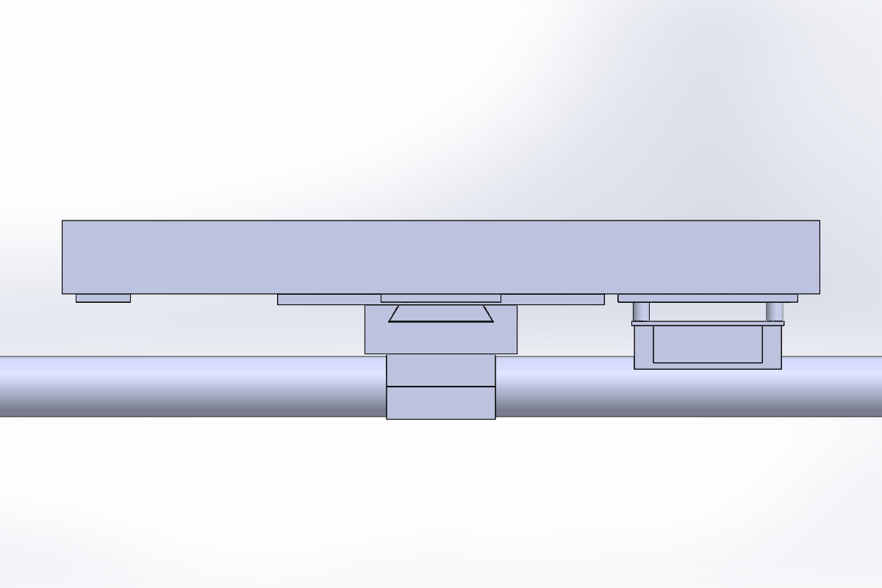
CAD/Dashboard_Enclosure/previews/assembly_from_below.png
