0geder/Tukzie-HPEC-HUD/CAD/Dashboard_Enclosure/previews/assembly_on_handlebar.png

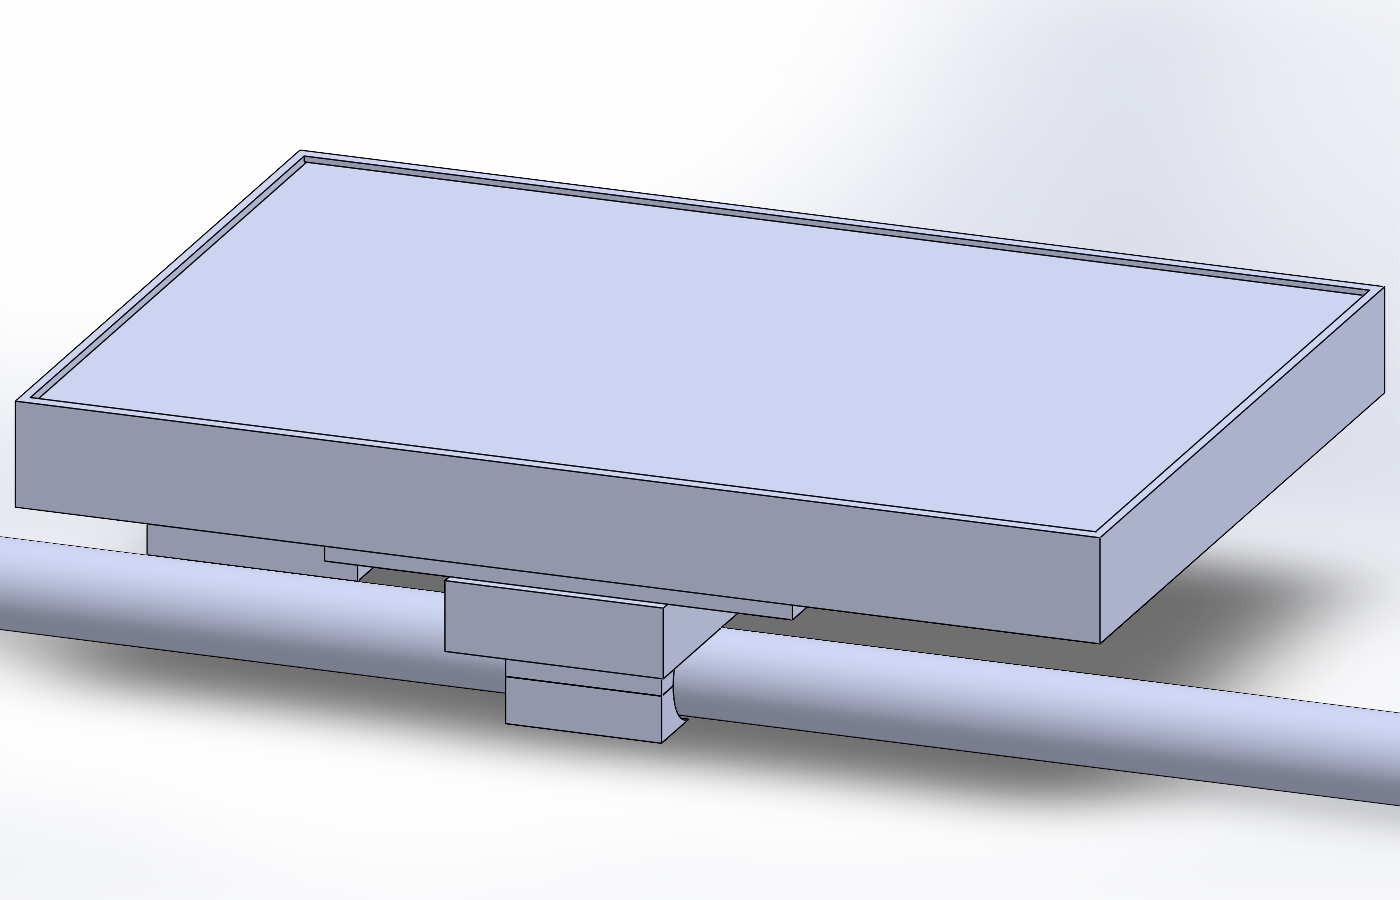
CAD/Dashboard_Enclosure/previews/assembly_on_handlebar.png
