0geder/Tukzie-HPEC-HUD/CAD/Dashboard_Enclosure/previews/assembly_side_view.png

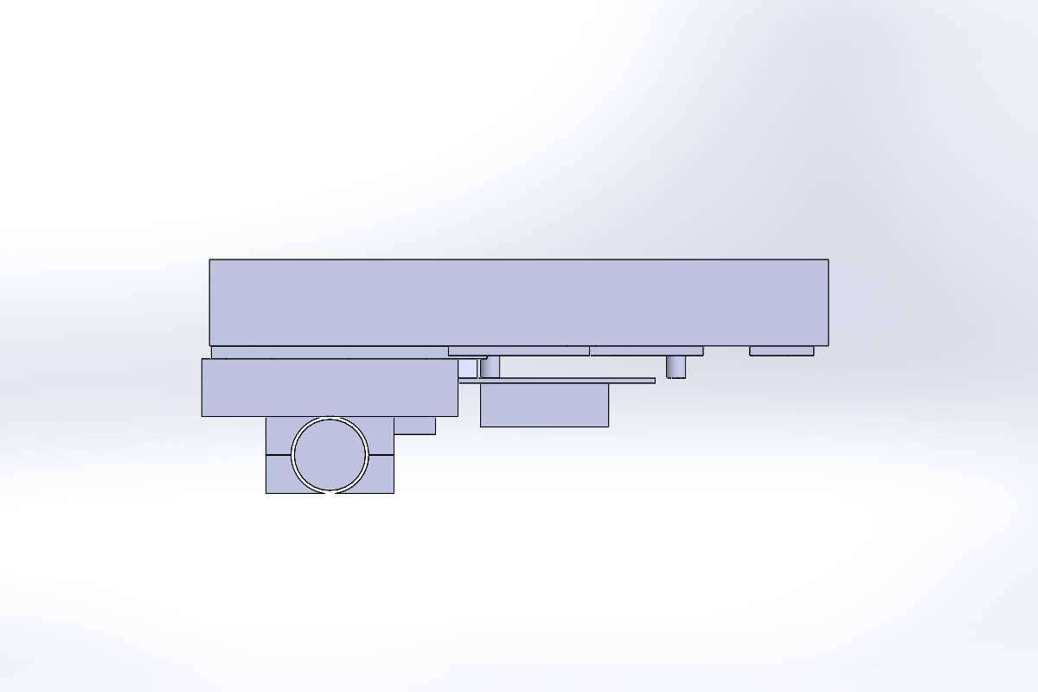
CAD/Dashboard_Enclosure/previews/assembly_side_view.png
