0geder/Tukzie-HPEC-HUD/CAD/Print/bed_layouts.png

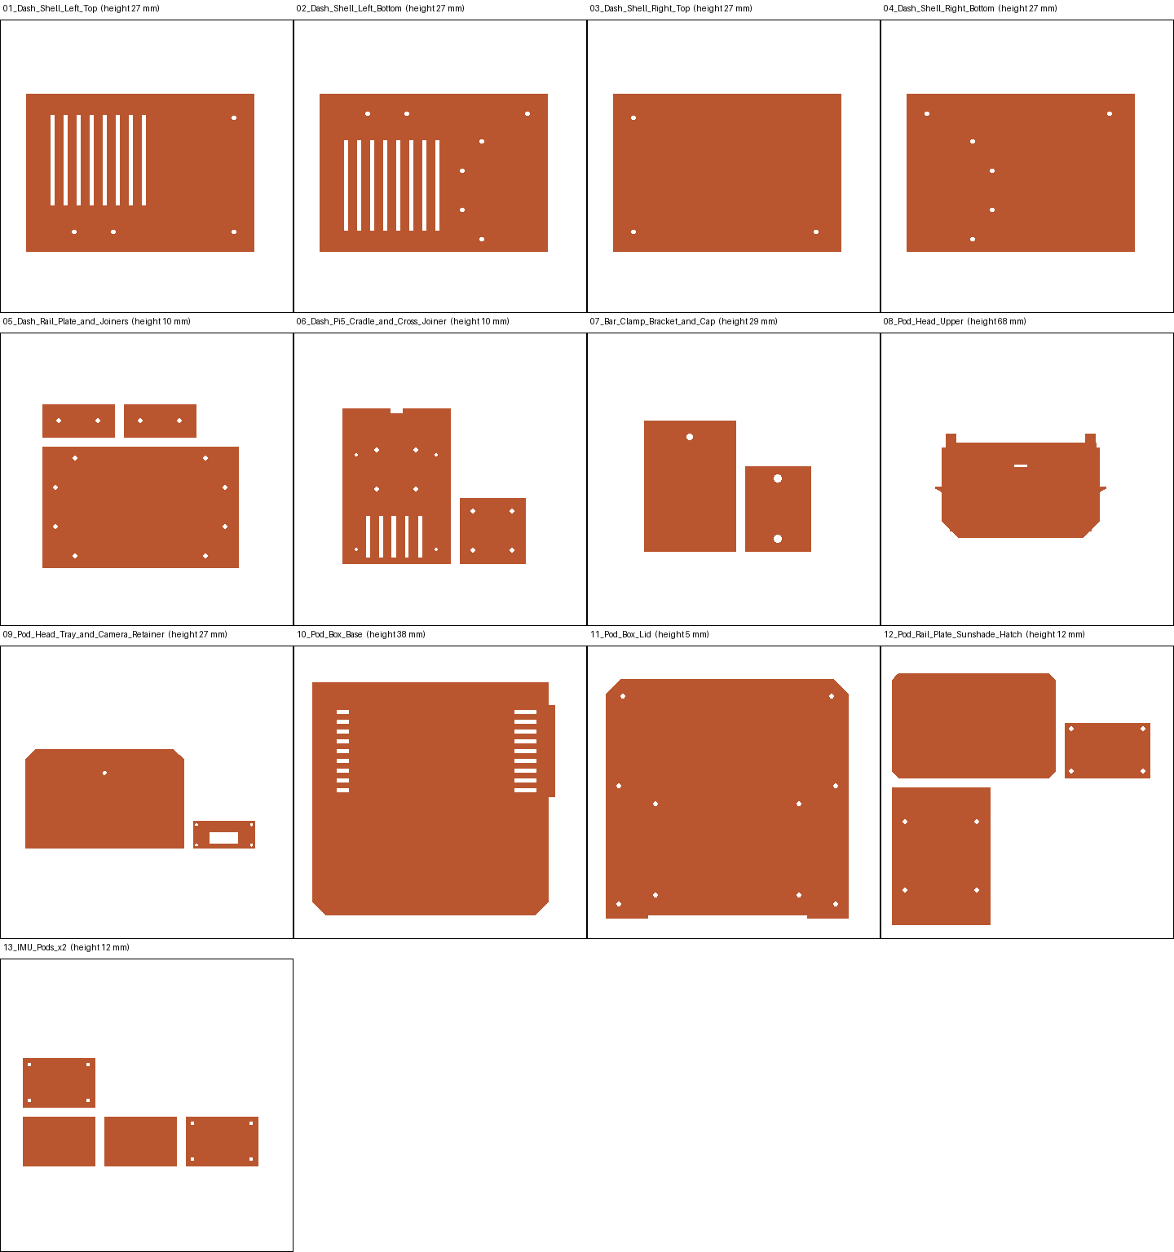
CAD/Print/bed_layouts.png
