0geder/Tukzie-HPEC-HUD/CAD/Sensor_Pod_Front/renders/assembly_exploded_rear.png

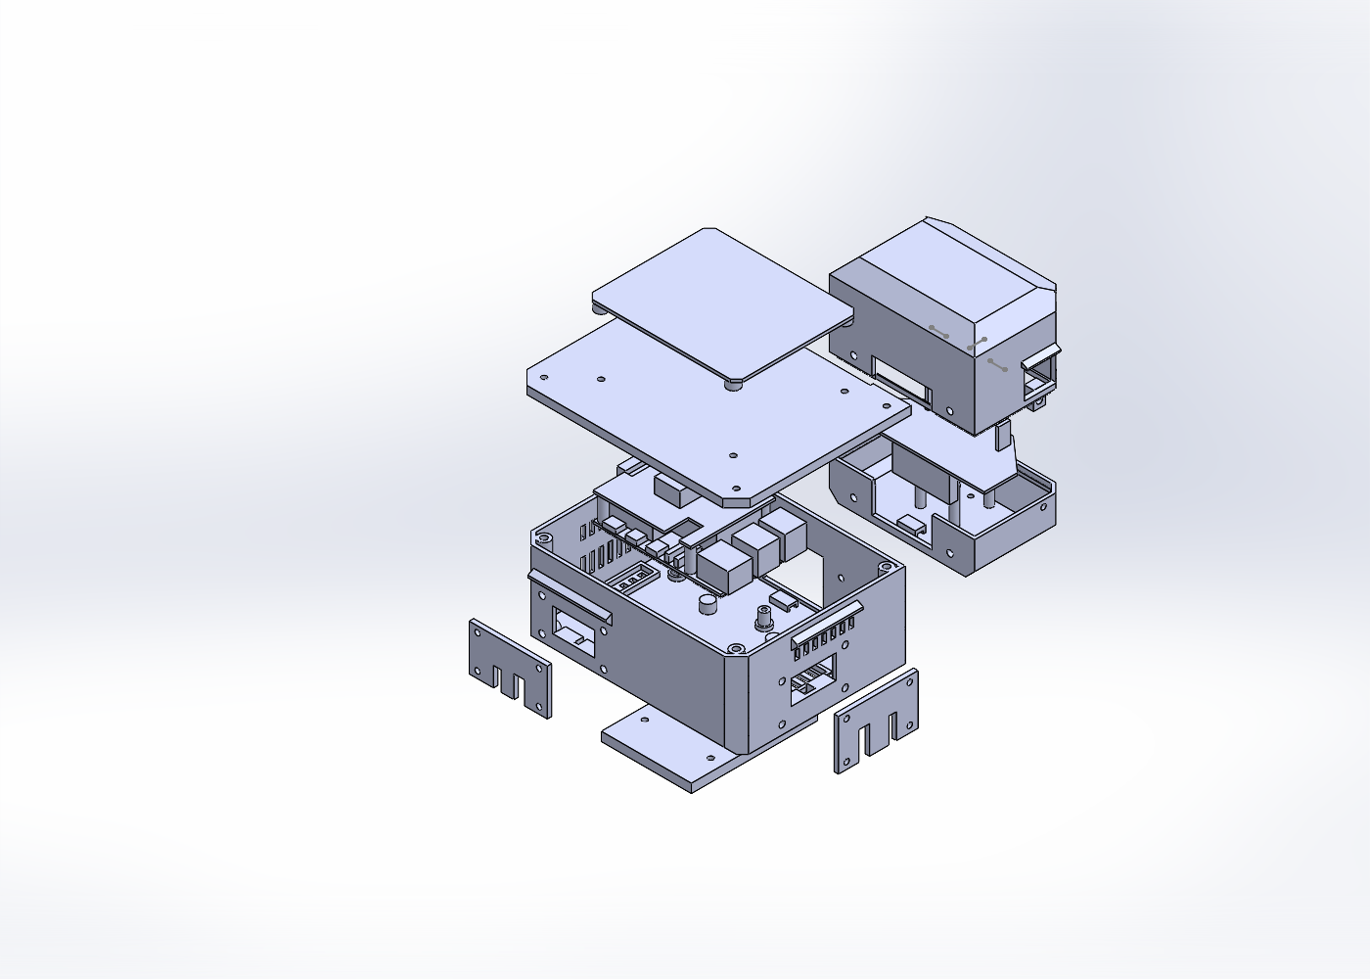
CAD/Sensor_Pod_Front/renders/assembly_exploded_rear.png
