0geder/Tukzie-HPEC-HUD/CAD/Sensor_Pod_Front/renders/assembly_front_iso.png

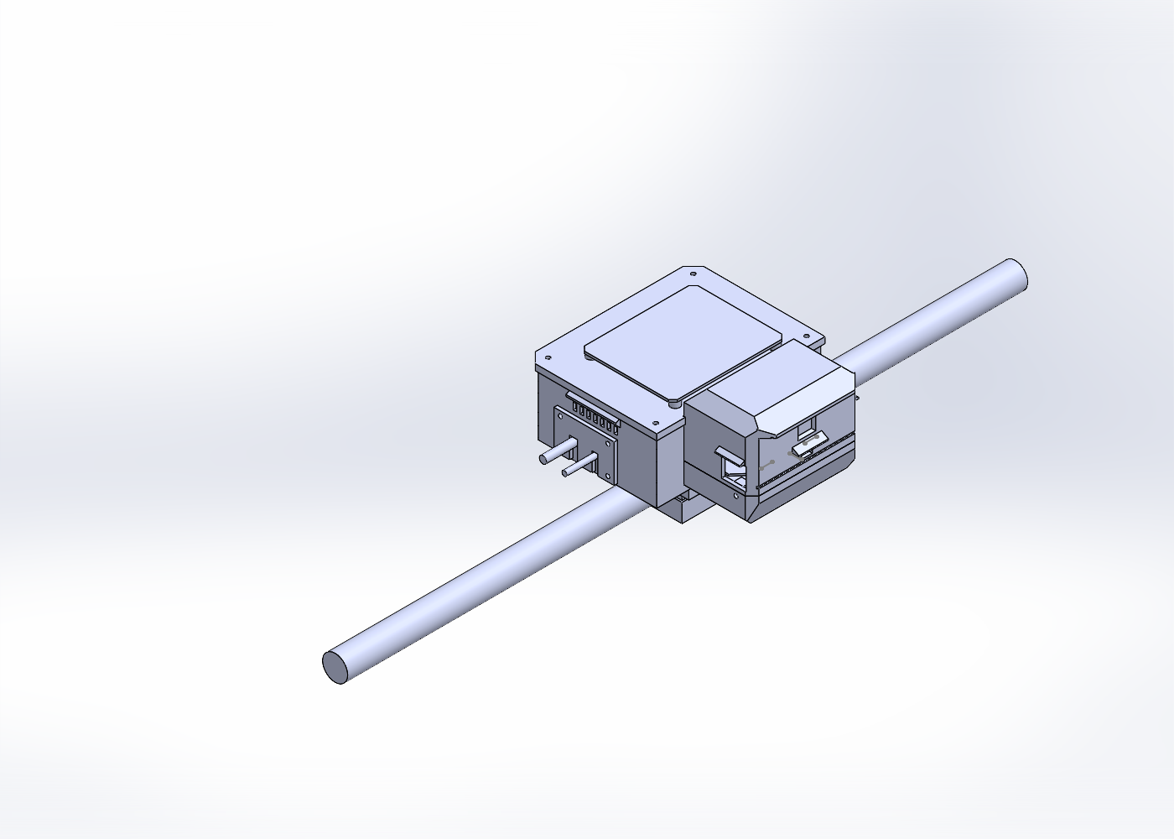
CAD/Sensor_Pod_Front/renders/assembly_front_iso.png
