0geder/Tukzie-HPEC-HUD/CAD/Sensor_Pod_Front/renders/assembly_side.png

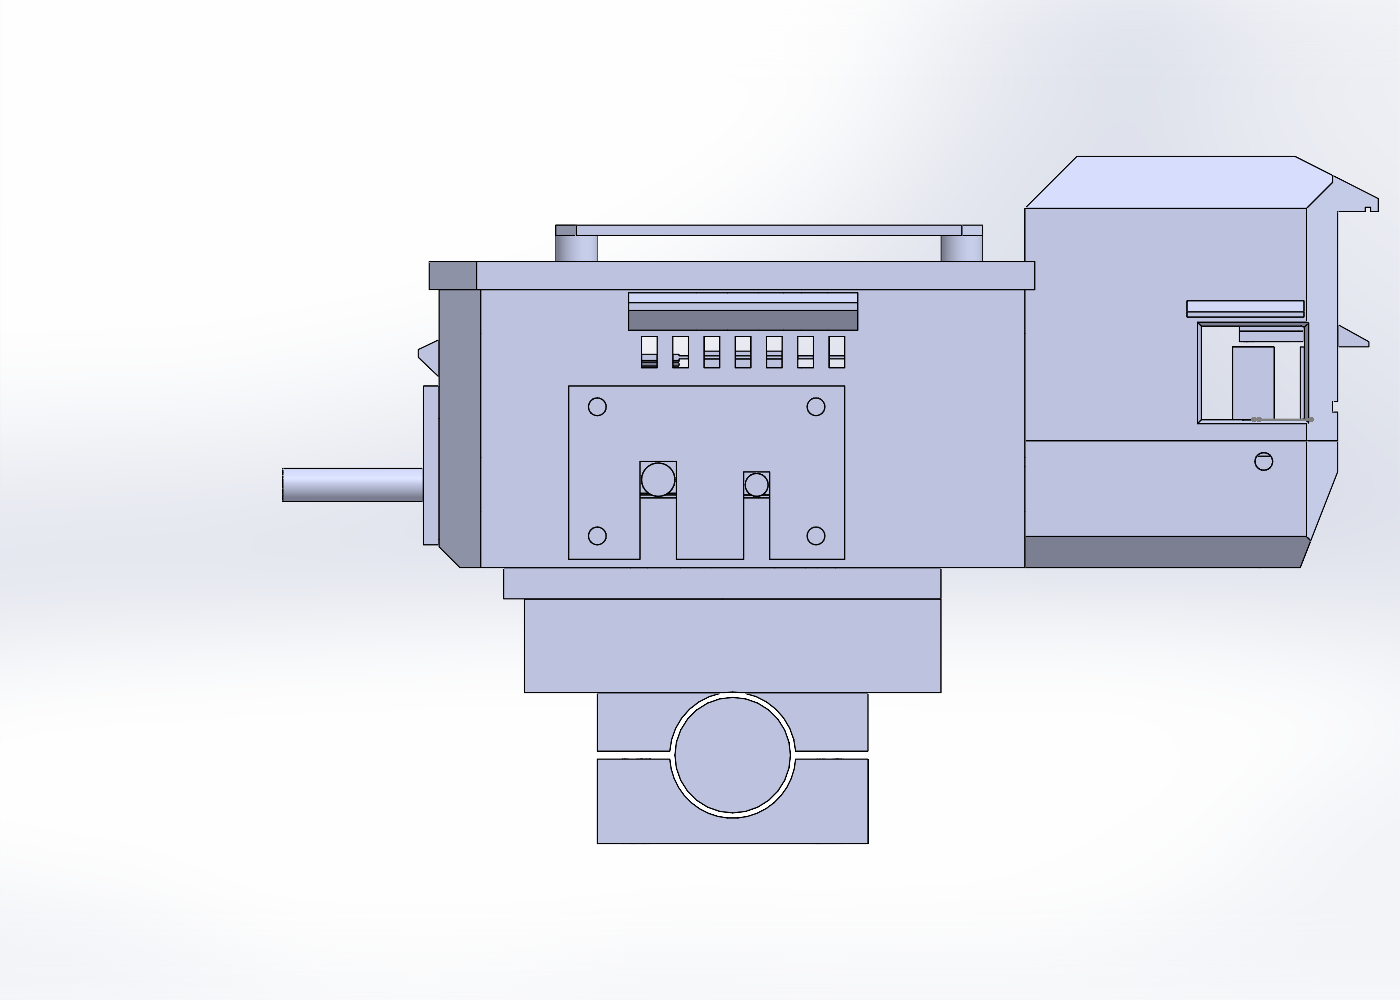
CAD/Sensor_Pod_Front/renders/assembly_side.png
