0geder/Tukzie-HPEC-HUD/CAD/Sensor_Pod_Front/renders/assembly_top_no_lid.png

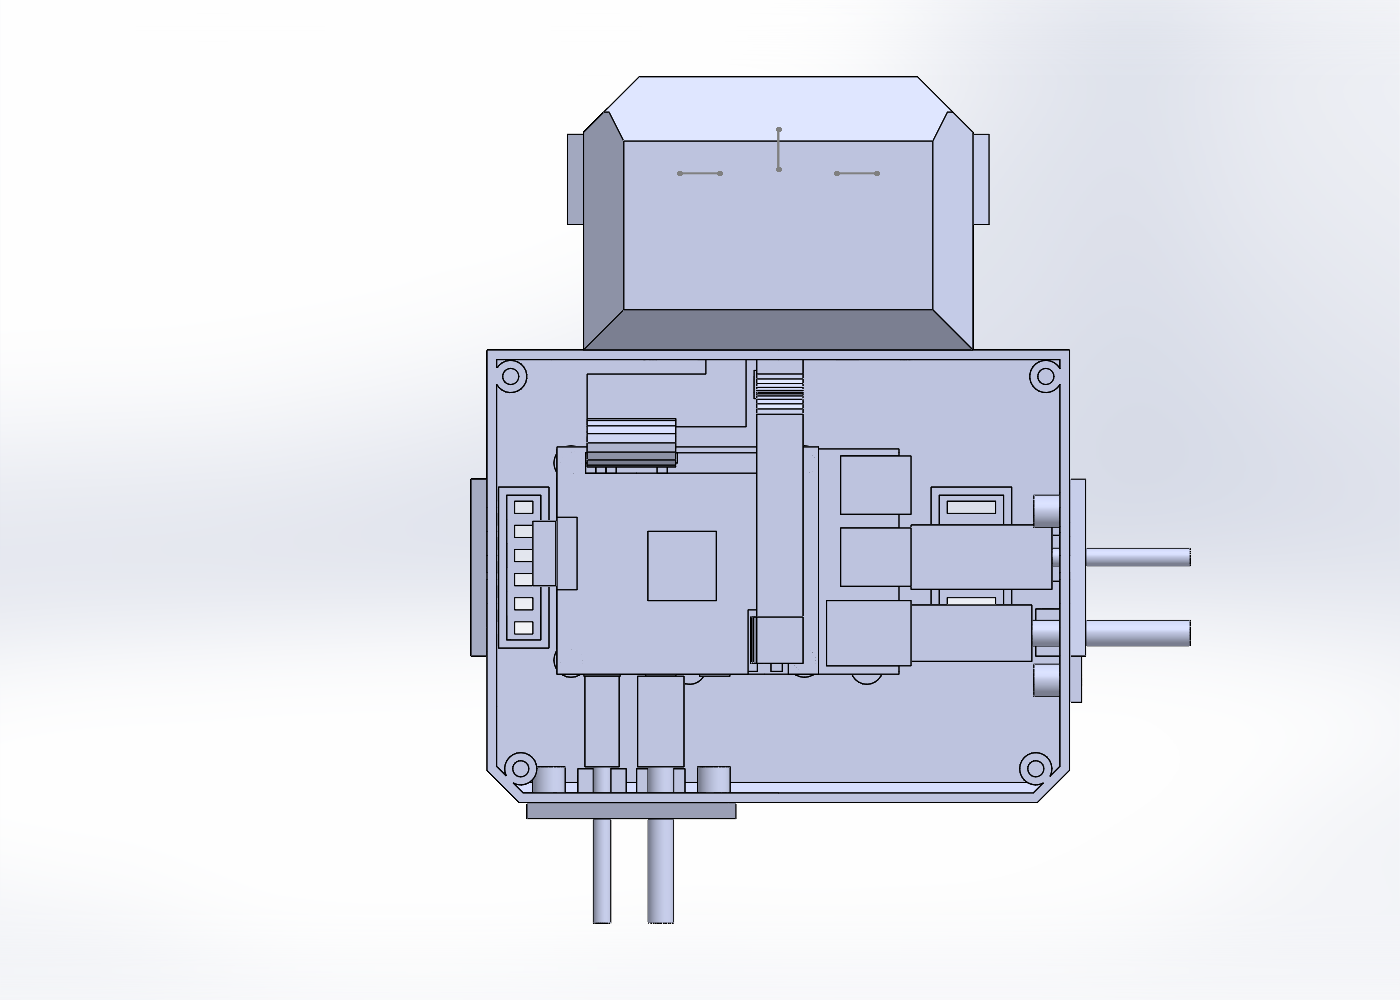
CAD/Sensor_Pod_Front/renders/assembly_top_no_lid.png
