0geder/Tukzie-HPEC-HUD/CameraMount/sensor_pod/concept_assembly.png

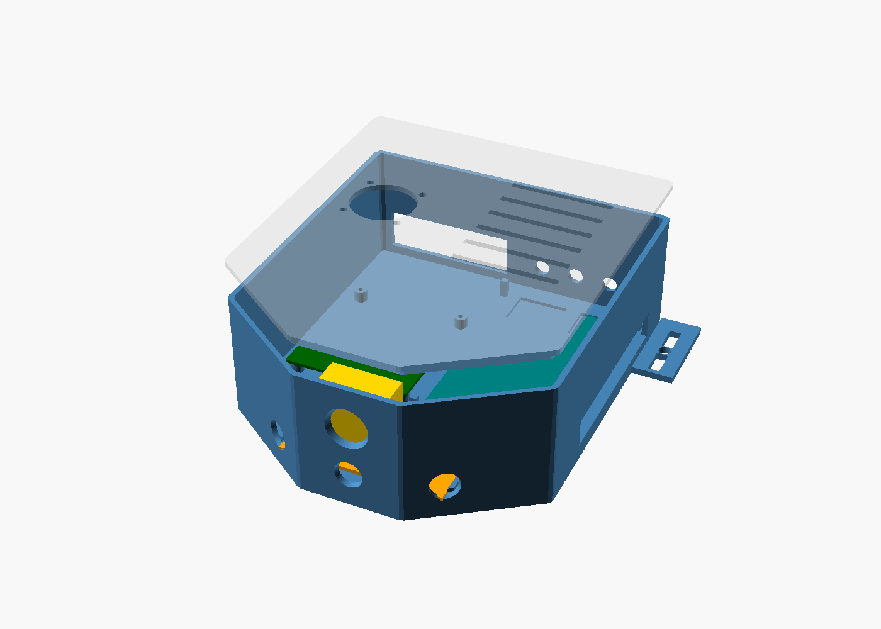
CameraMount/sensor_pod/concept_assembly.png
