0geder/Tukzie-HPEC-HUD/Photos/Vehicle/2026-10-26_rear_unit_as_installed.jpg

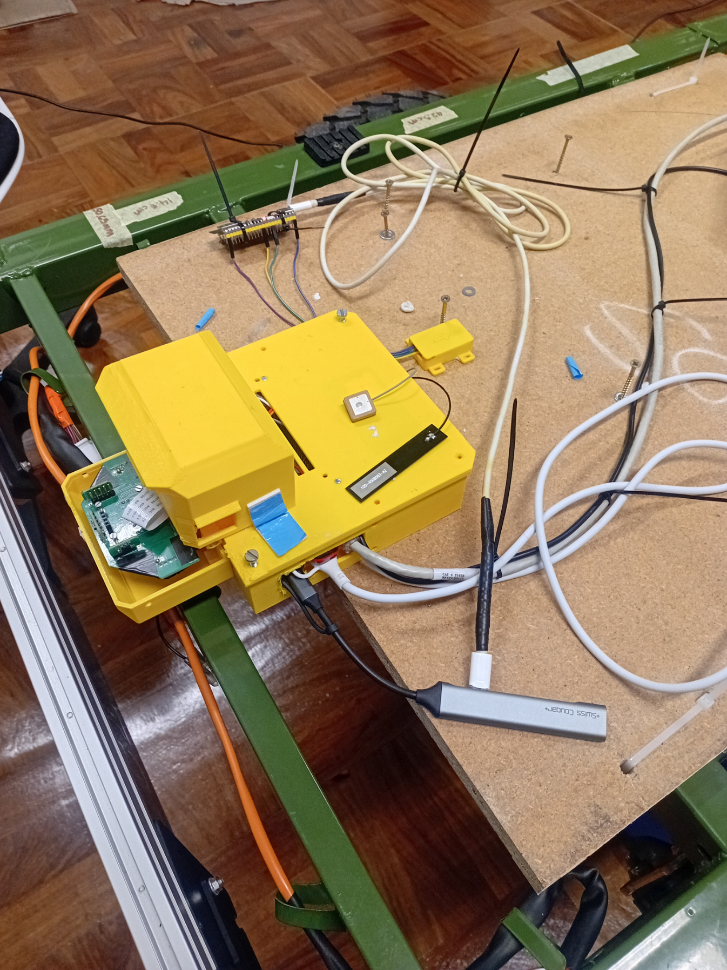
Photos/Vehicle/2026-10-26_rear_unit_as_installed.jpg
