0geder/Tukzie-HPEC-HUD/Report/figures/cad/imu_pod_rev3_assembled.png

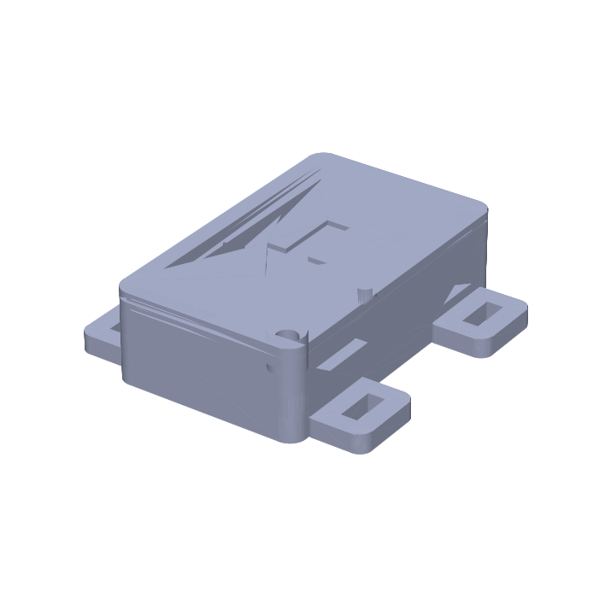
Report/figures/cad/imu_pod_rev3_assembled.png
