0geder/Tukzie-HPEC-HUD/Report/Results.tex

\chapter{Results}
\label{chap:results}

This chapter gives the measured results of the experiments of Section~\ref{sec:experiments}, analysed as in Section~\ref{sec:data-analysis}, against the requirements of Table~\ref{tab:requirements-mapping}. Bench results were measured between 25 September and 26 October 2026; results from the vehicle (road sessions on 19 and 27 October) are marked as such. It is structured by requirement, earlier results first and the road session last, and closes with a summary table (Section~\ref{sec:res-summary}). The headline result of each test is given here; the full run histories, per-run breakdowns and longer tables are in Appendix~\ref{app:results}, and the raw evidence is indexed in Appendix~\ref{app:evidence}.

\section{Inertial acquisition (R1)}
\label{sec:res-acq}

Both IMUs held 200.0 to 200.5\,Hz with no dropped samples in the bench sessions of Table~\ref{tab:res-acquisition}, including with all subsystems running together and with the 94\,Hz filter of v0.7.4. The only timing fault was the pause at each flash write. Figure~\ref{fig:res-imu-gaps} shows the longest interval in each 2\,s window: writing every 10\,s (v0.5.0), 30 of 151 windows per IMU had a gap of 33 to 40\,ms; with buffered writes (v0.6.0) only the 5 windows after the five flushes did, and the worst gap elsewhere was 5.9\,ms in both runs. No dropped samples does not mean even spacing: after a pause the missed samples are read about 1\,ms apart, which distorts the jerk of that window. The two inertial-only nodes of the second session, which keep no flash log, removed the pause altogether: on the vehicle on 27 October each held 200.00\,Hz with no interval longer than 5.2\,ms in about 35,000 samples at rest, and at rest they read 9.845 (rear) and 9.941\,m/s\textsuperscript{2} (front) against 9.81, within 0.4 and 1.3\,\%, with both Raspberry Pis' clocks in step. R1 is met on the bench as defined; up to v0.7.4.1 a read that failed on the bus was not detected, so those figures cover the processing path, not the bus.

\begin{figure}[htbp]
\centering

\caption[Longest interval between consecutive IMU samples in each 2\,s statistics window, on the bench]{Longest interval between consecutive IMU samples in each 2\,s statistics window, on the bench. (a) Firmware v0.5.0, 29 September, writing to flash every 10\,s; the grey band is the period with flash logging switched off (219.7 to 340.8\,s). (b) Firmware v0.6.0, 1 October, buffered logging; dashed lines mark the five flushes as logged by the firmware (71 to 202\,ms each). The firmware reports only the minimum, mean and maximum interval per window, so each point is one window maximum (212 windows per IMU in (a), 173 in (b)); times are when the host received the line. The dotted line is the nominal 5\,ms interval at 200\,Hz. No samples were dropped in either run.}
\label{fig:res-imu-gaps}
\end{figure}

On the first road session, with about 16 minutes of driving, the drop count stayed at zero on both IMUs, and 3,431 of the 3,437 readable records show both at 200.0 to 200.5\,Hz; one record, while driving, shows a stall of IMU1 of nearly 2\,s whose cause is not known. Of the 5,557 seconds from the first to the last record, 2,093 (38\,\%) have none at the recorder, most likely lost on the USB link (R10 below). On the first road session R1 is not met: the stall lost about 396 samples that the drop count does not show.

On 21 and 22 October, on its own battery and the wired link, the rear unit's drop counts rose until a reset: the statistics and ride tasks had stopped on the IMU core, and v0.7.6 moved them (Section~\ref{sec:inv-stall}). On v0.7.6 both nodes ran at 200\,Hz with no drops or read failures, and a 62-minute soak of the rear unit under the fault's conditions had no restarts, drops, read failures or late slots, with the rate outside 199.5 to 200.5\,Hz in 3 of 726 polls (Table~\ref{tab:res-twonode}). The soak shows that v0.7.6 ran through the fault's conditions, not that the trigger was present. With v0.7.8 the unit re-initialised IMU1 by itself after each of four pulls of its supply wire, with no drops and no reset (Section~\ref{sec:impl-health}). R1 is met on both nodes on the bench.

On the road session of 27 October (11:30 to 12:40, laps at 10, 15 and 20\,km/h), the two inertial-only nodes held 200.005 and 200.006\,Hz: the front node delivered 1,791,190 samples with no sequence gap and the rear 1,184,780 with 910 missing in transport (0.08\,\%), with no read failures, raw drops or clipped samples, one stuck value and four lines rejected by their checksum. R1 is met on the vehicle for rate and spacing; the 910 samples lost in transport break its zero-loss clause at the rear, although the node itself dropped none.

\section{Calibration (R2)}
\label{sec:res-cal}

Before calibration the two IMUs read about 5.7\,\% above and 2.6\,\% below standard gravity at rest; after it both read 9.80 to 9.81\,m/s\textsuperscript{2}. On the target board a later session read 1.3\,\% and 2.9\,\% above gravity with the same factors, which suggests that a single factor holds only in the orientation in which it was measured. On the front node a recalibration on 22 October repeated the first factor within 0.01\,\% (1.0036 and 1.0035), with the board not yet mounted (Section~\ref{sec:resx-cal}).

On 23 October both nodes were recalibrated in their mounted positions, with the vehicle on stands, the motor off and the wheel still (markers R2 RECAL). The front node read 9.886\,m/s\textsuperscript{2} at rest and stored a factor of 0.9919, against 1.0035 on the bench: the same sensor needs a factor 1.2\,\% different once mounted. The rear node reports its result only on its unconnected USB console, so its factor was computed from the raw stream of the 12.9\,s after its restart by the same method (2,580 samples, none missing): 0.9907\,g, or 9.715\,m/s\textsuperscript{2}, giving 1.0094, with a noise standard deviation of 0.003\,g; its pod sits within 1.5$^\circ$ of level. These are the factors' own definition, not an independent check: with the earlier bench factors the parked vehicle read 10.04 and 10.34\,m/s\textsuperscript{2} on 19 October (Table~\ref{tab:res-flashlog}), and on 27 October the parked vehicle read 9.845 (rear) and 9.941\,m/s\textsuperscript{2} (front), so R2 is not met on the vehicle.

\section{Ride features and fusion (R3)}
\label{sec:res-ride}

The feature self-test and all five fusion self-tests passed at every boot, and in a 150\,s bench session all 149 fused windows combined both sensors with a skew below 1\,ms; under a hand disturbance both sensors rose and decayed together (Section~\ref{sec:resx-ride}). R3 is met: the features are computed and combined as designed, which does not show how they respond to the road or the motor.

\subsection{First road session}
\label{sec:res-road1}

On the road session (Figure~\ref{fig:res-road}), with seconds labelled as driving by current or vibration, so that the separation is partly by construction, the per-second vibration value had a median of 0.03\,m/s\textsuperscript{2} in 2,832 parked seconds and 1.39\,m/s\textsuperscript{2} in 605 driving seconds (95th percentile 3.2, maximum 5.09), with battery current up to 46.9\,A.

\begin{figure}[htbp]
\centering

\caption[Road session on 19 October 2026, 17:15 to 18:50 local time (UTC+2), as recorded by the Raspberry Pi~5 from the rear unit (file \texttt{2026-10-19\_\allowbreak{}171534\_\allowbreak{}roadtest.jsonl})]{Road session on 19 October 2026, 17:15 to 18:50 local time (UTC+2), as recorded by the Raspberry Pi~5 from the rear unit (file \texttt{2026-10-19\_\allowbreak{}171534\_\allowbreak{}roadtest.jsonl}). Top: vibration value (standard deviation of the fused acceleration magnitude per 1\,s window). Bottom: battery current from the BMS, negative for discharge. The recorder polled twice a second and the bridge repeats the latest record, so the 10\,287 rear rows carrying a telemetry record were reduced to 3464 by keeping the first row for each sequence number. Lines break wherever a sequence number is missing (2093 of 5557, 37.7\,\%, including one gap of 407 records from 18:06:34 to 18:13:23). Green shading marks records with $|i|>1$\,A or vibration above 0.3\,m/s$^2$ (607 records, 605 with every field readable); the dashed line is the drive marker added from the laptop at 17:58:41.}
\label{fig:res-road}
\end{figure}

\subsection{Run-1 flash log}
\label{sec:res-flashlog}

The unit's own log of the session, read back on 22 October, holds the per-IMU features of one 1\,s window about every 23\,s (1,154 records; Figure~\ref{fig:res-flashlog} and Table~\ref{tab:res-flashlog} in Appendix~\ref{app:results}). In the 26 records identified as driving by current, $\sigma$ rose from about 0.03 to a median of about 2\,m/s\textsuperscript{2}, peak-to-peak from about 0.17 to 11 to 14\,m/s\textsuperscript{2}, crest factor from 1.01 to about 1.6 and jerk from about 7 to 250\,m/s\textsuperscript{3}. The two sensors, both on the rear unit that day, tracked each other closely: the ratio of their $\sigma$ had a median of 1.06 and a correlation of 0.97, and $D$ a median of 0.074. This shows the size of the response and that two sensors measuring the same motion agreed, not its repeatability, its dependence on speed (there was no GNSS antenna) or how the front and rear compare.

\subsection{Stand runs}
\label{sec:res-stands}

The lab part of run 2 took place on 23 October with the drive wheel raised on stands; the road part was driven on 27 October. In two stand runs (15:53:11 to 15:55:50 and 16:08:12 to 16:10:20) the motor drew a mean of 3.2 and 4.5\,A (peaks 4.4 and 6.2\,A). In the raw 200\,Hz streams, which had no gaps, the dynamic RMS of the rear acceleration magnitude rose from 0.027\,m/s\textsuperscript{2} at rest to 0.13 and 0.20, five to seven times, with the energy between about 40 and 70\,Hz. The front node rose only from 0.020 to 0.026 and 0.035, but in the second run it showed the same lines as the rear, at 42.75, 49.0 and 64.0\,Hz, so powertrain vibration reaches the front through the frame (Figure~\ref{fig:res-stands}). The throttle settings and wheel speed were not recorded, so the lines cannot yet be assigned to motor orders.

\begin{figure}[htbp]
\centering

\caption[Stand runs of 23 October 2026, drive wheel raised: Welch spectra of the acceleration magnitude (4\,s Hann segments, 50\,\% overlap, detrended, raw counts in m/s\textsuperscript{2} without the calibration factor) at rest (motor off, 15:58:00 to 16:07:30, 114,000 samples per node) and in the two runs, each trimmed by 5\,s at both ends]{Stand runs of 23 October 2026, drive wheel raised: Welch spectra of the acceleration magnitude (4\,s Hann segments, 50\,\% overlap, detrended, raw counts in m/s\textsuperscript{2} without the calibration factor) at rest (motor off, 15:58:00 to 16:07:30, 114,000 samples per node) and in the two runs, each trimmed by 5\,s at both ends. Windows cut from the raw captures by the Raspberry Pis' synchronised clocks; no sequence gaps. Mean battery current from the BMS in the legend. Script \texttt{BenchTest/\allowbreak{}analysis/\allowbreak{}stand\_spectra\_2026\_10\_23.py}; numbers in \texttt{BenchTest/\allowbreak{}logs/\allowbreak{}run2\_lab\_2026-10-23/\allowbreak{}stand\_spectra\_1023.json}.}
\label{fig:res-stands}
\end{figure}

The road part was driven on 27 October as laps with stops between them and no typed markers; the pass windows were derived afterwards from the phone's GNSS speed and the battery current (\texttt{BenchTest/\allowbreak{}analysis/\allowbreak{}auto\_markers.py}), so they include each lap's turns and run-up, and no stand runs, bump passes or video were recorded. On a smooth loop, five passes at 10\,km/h gave a rear $a_w$ of 1.78\,m/s\textsuperscript{2} with a CV of 5.0\,\% (VDV 2.4\,\%, $\sigma$ 4.6\,\%) and a front $a_w$ of 1.16\,m/s\textsuperscript{2} with a CV of 5.3\,\%, inside the 10\,\% criterion at both ends (n = 5). On a rougher strip about 200\,m away, identified by position and by the session's timing, four passes at the same speed read 3.61 (rear) and 2.26\,m/s\textsuperscript{2} (front), about twice the smooth values, with CVs near 20\,\% because the laps covered different stretches. Only two passes were driven at 15\,km/h (rear $a_w$ 2.43 and 2.39) and one at 20\,km/h (3.59), too few for their repeatability: the car park was too small to hold the higher speeds for long, and the light trike, without its body, became unstable in the corners (the phone recorded up to 28.3\,km/h). Aligned by the phone's GNSS position in 8\,m cells (\texttt{position\_icc.py}), the passes agreed poorly place by place: ICC(2,1) 0.16 at the rear on the smooth loop (5 cells, 95\,\% interval $-0.09$ to 0.75) and 0.01 on the rough strip (9 cells), 0.00 to 0.02 at the front, against the 0.75 criterion; over the 1 to 3\,s a pass spends in a cell, $a_w$ varied about 30\,\% between passes but only about 18\,\% between cells, for cells of 6 to 16\,m and a GNSS lag of up to 2\,s. On the smooth loop $I_v$ rose with speed (rear 1.14, 1.59 and 2.44 at about 10, 13 and 18\,km/h), so it is not speed-invariant over this range. In each pass the 23 October powertrain lines (42.75, 49.0 and 64.0\,Hz) held 0.9 to 3.1\,\% of the 0.5 to 80\,Hz energy in powered passes (0.4\,\% coasting), while 65 to 84\,\% lay between 4 and 8\,Hz; a coasting pass on the smooth loop gave a rear $a_w$ of 1.80\,m/s\textsuperscript{2} against 1.78 powered at the same speed. The front-to-rear delay was not estimated: the correlation peaked at 0.37 to 0.53 at a lag of 0.09 to 0.10\,s in every pass, the same at 10, 15 and 20\,km/h, so it reflects the body's common motion or a clock offset, not travel over the wheelbase, which was not measured.

\section{Position (R4)}
\label{sec:res-position}

The receiver reached a fix 105\,s after a cold start, and over 104 fixes the position was a median of 2.7\,m from a phone's, 95\,\% within 11.0\,m: against the 10\,m criterion the median passes but the 95th percentile does not, and the phone's own error makes this a consistency check. The speed field has not been checked against a known speed. On the first road session no GNSS antenna was connected (Section~\ref{sec:resx-gnss}); on 27 October the vehicle's fix lay 8 to 25\,m from the phone's and froze from 12:13 (Table~\ref{tab:results-summary}).

With the antenna on the modem's GNSS connector (fitted 22 October), in more than 45 minutes in the lab on 23 October, with the assisted data loaded, the receiver reported no fix; the modem's network position was available throughout, at an estimated 550\,m accuracy, which is not usable on the road. With a view of the sky on 24 October, off the vehicle, it held a 3D fix for 10 minutes (179 fixes, 23 to 29 satellites, HDOP 0.77 to 1.1), within a median 1.8\,m and at most 5.9\,m of its median position, so the lab's failure was the sky view, not the receiver; standing still, 42 of the speed readings were not zero (up to 6.97, units unconfirmed), so the analysis ignores speeds below a minimum. As a speed and position reference that does not depend on the vehicle's receiver, a phone on the vehicle now streams its GNSS as NMEA over its hotspot to the Raspberry Pi~5, which logs every sentence with its own clock and passes the speed to the dashboard (Section~\ref{sec:impl-phone-gps}). In the lab it delivered 2,006 sentences with no checksum errors and a fix on 13 satellites, and with a simulated 20\,km/h drive the dashboard showed 20\,km/h; it has not yet been compared with a known speed.

On 27 October the phone gave the speed throughout the laps (14,181 fixes) until its log stopped at 12:29, and the vehicle receiver held a fix outdoors from 11:36. On the smooth loop its pass-mean speed, read as knots, was 0.9 to 1.4 times the phone's and its position 8 to 25\,m from the phone's, and its position updated about every 4\,s, near the 3\,s poll (Section~\ref{sec:inv-gnss-hang}); from 12:13 it held a stale position and zero speed while still flagged as fixed. The phone was therefore the speed source, and the trike's speedometer was hard to read in sunlight. No side video was taken. Read by eye during the laps, the dashboard showed about 1\,km/h less than the trike's own speedometer (for example 10 against 11\,km/h) and lagged it by a second or two when the speed changed, as the phone's once-a-second fixes and the dashboard's polling predict; since speedometers are made to read slightly high, the two agree, but the check was not recorded and R4 stays partly met.

\section{Battery telemetry (R5)}
\label{sec:res-battery}

Once the unit was moved near the pack (Sections~\ref{sec:impl-twosided} and~\ref{sec:inv-bms}), the BMS link held, and on the first road session it held throughout: the current reached 46.9\,A under load (48.03\,A in the unit's own log), the voltage fell from 74.6 to 72.8\,V and the state of charge from 60 to 58\,\%. The pack name gives 24 cells, consistent with 74.7\,V; the chemistry is not confirmed. R5 is partly met: the voltage has not been compared with a meter (Section~\ref{sec:resx-bms}).

The BMS voltage was not compared with a meter on 27 October; between 11:30 and 12:40 it read 71.2 to 74.0\,V and 52 to 55\,\%, with up to 82.9\,A on the 20\,km/h pass, consistent with the pack's own display, which was read by eye only. R5 stays partly met.

\section{Hazard sensing (R6 to R8)}
\label{sec:res-hazard}

On the Raspberry Pi~4, the rear unit, the detector alone ran at 19.5\,frames/s with a median of 102\,ms from sensor readout to result, of which about 52\,ms was readout and image processing and 36\,ms inference (Table~\ref{tab:camera-latency}). With the whole system running it ran at 14.6 to 14.7\,frames/s with a median of 118 to 122\,ms; the cause of the difference has not been isolated. The Raspberry Pi~5 beside the running dashboard reached 19.2\,frames/s with a median of 51 to 54\,ms (Figure~\ref{fig:res-latency}, Appendix~\ref{app:results}). The three-frame onset adds two frame intervals, so an alert is raised at the detector about 0.26\,s, or 2.2\,m at 30\,km/h, after an object appears. Only the person class has been confirmed on live frames, indoors; R7's rate and class are met at the detector on the bench. R6 is met for the pulse itself, timestamped with a spread of under 0.7\,ms, but the offset between the clocks has not been measured, and the median interval of 500.06\,ms means a drift of about 0.4\,s an hour that the alignment must fit. The full hazard-sensing results are in Table~\ref{tab:res-camera}.

\begin{table}[htbp]
\centering
\caption[Camera detector latency on the Raspberry Pi~4, the rear unit in the final layout (ms, median / 95th percentile; 60\,s per run, except the whole-system row, read from the service's timing lines)]{Camera detector latency on the Raspberry Pi~4, the rear unit in the final layout (ms, median / 95th percentile; 60\,s per run, except the whole-system row, read from the service's timing lines).}
\label{tab:camera-latency}
\small
\begin{tabular}{lrrrrrr}
\hline
Run & frames/s & Queue & Pre & Inference & Alert logic & Total \\
\hline
4 threads & 19.5 & 52 / 71 & 12 / 14 & 36 / 39 & 0.1 / 0.2 & 102 / 120 \\
4 threads, live view & 17.3 & 57 / 78 & 12 / 12 & 36 / 39 & 0.1 / 0.2 & 105 / 127 \\
1 thread & 7.0 & 47 / 68 & 12 / 14 & 126 / 129 & 0.1 / 0.2 & 186 / 207 \\
Whole system & 14.6--14.7 & 55--58 / - & - & 51--52 / - & - & 118--122 / 146--148 \\
\hline
\end{tabular}
\end{table}

The time-of-flight sensors answered and responded in the right order, so the first part of R8 is met. On 26 October, with the vehicle parked and the author as the target on the front camera's axis at distances set out with a tape, the front sensor ahead read 1.06\,m (n = 44) at about 1.0\,m and nothing at 2.2\,m, beyond its range. At about 0.5\,m the fused distance was 0.47\,m (median of 43 hazard records), within the 5\,cm criterion, but a person is a poor target: the time-of-flight reading spread from 0.34 to 0.89\,m and only 6 of the 43 records were fused, so the flat-target check (C9) is still needed. The camera's range of a standing person followed the pinhole relation: distance times box width was 471 to 502\,px\,m over four readings at 2.2 and 3.2\,m, within 3\,\% of 490, but with the assumed 0.5\,m person width every reading was 36 to 40\,\% short. The width was set to 0.60\,m (0.80\,m fits this person and stance; \texttt{BenchTest/\allowbreak{}logs/\allowbreak{}focal\_cal.csv}). Closer than about 1.2\,m a person does not fit in the frame and the estimate is unusable (0.90 to 2.15\,m). The focal length itself (C5) needs a target of fixed width and was not calibrated. On the first road session the front detector raised 1,342 alerts and the rear 741, not yet checked against video (Section~\ref{sec:resx-hazard}).

The walking-pace approaches (block V5) were not run and no forward video was kept, so the detector has no check against video on the vehicle; R7 stays partly met.

\section{Telemetry, logging and recovery (R9, R10)}
\label{sec:res-telemetry}

The unit published 47 times with no failures, detected a radio loss within 0.8\,s and, from v0.5.3, reconnected about 5\,s after coverage returned; a full read-back recovered all 6,020 stored records (Section~\ref{sec:resx-telemetry}). In the store-and-forward test T15 (Table~\ref{tab:res-sync}, Figure~\ref{fig:res-t15}) the radio was off for 10 minutes; the unit reconnected 5.2\,s after it returned and cleared its 60-record backlog, and every record of the boot was stored once, 24 of them only after a backfill from the unit's log. The public broker acknowledges a record with no subscriber present, so on it the log read-back is the safety net. R9 is met on the bench, including the database.

\begin{table}[htbp]
\centering
\caption[Store-and-forward to the database after a 10-minute outage (test T15, firmware v0.7.4, bench)]{Store-and-forward to the database after a 10-minute outage (test T15, firmware v0.7.4, bench).}
\label{tab:res-sync}
\begin{tabular}{|p{6.2cm}|p{7.6cm}|}
\hline
\textbf{Measure} & \textbf{Result} \\ \hline
Outage & Radio off (\texttt{AT+CFUN=4}) for 600\,s; 60 records built up, 0 lost \\ \hline
Reconnection after the radio returned & 5.2\,s \\ \hline
Backlog cleared & 37.3\,s for the 60 replays at the database (1.61 per second); unit's backlog zero 37.9\,s after reconnection (Figure~\ref{fig:res-t15}) \\ \hline
Stored in the database & 112 of 112 records of the boot; 0 missing sequence numbers; 0 duplicates (a unique key on device, boot and sequence number rejects repeats) \\ \hline
Against the unit's log & 111 of 111 logged records stored (24 backfilled from the log) \\ \hline
IMUs during the test & 200.0 to 200.5\,Hz, 0 dropped \\ \hline
End-to-end latency & Not measured (no GNSS time indoors) \\ \hline
\end{tabular}
\end{table}

\begin{figure}[htbp]
\centering

\caption[Store-and-forward outage test T15 on the bench, 11 October, firmware v0.7.4]{Store-and-forward outage test T15 on the bench, 11 October, firmware v0.7.4. The radio was turned off with \texttt{AT+CFUN=4} at 63.4\,s and back on with \texttt{AT+CFUN=1} at 663.7\,s (grey band); the board was not reset. Points are the device's own counters from the 21 \texttt{!sync} status lines in the capture: records stored on the device and not yet acknowledged (backlog), and records replayed and acknowledged since the outage began. Dashed lines mark the MQTT reconnection (669.0\,s) and the firmware's ``backlog cleared'' message (706.9\,s). The server's per-record receive times were not exported for this run, so the figure uses the device counters; the server-side totals are in the text.}
\label{fig:res-t15}
\end{figure}

The dashboard line delivered 40 of 40 lines, at most 0.37\,s old at a laptop. Over USB, 2 to 11\,\% of lines were lost over hours on the bench, and 38\,\% of the seconds on the first road session. Since 21 October the line travels over the wired UART: none of the first 2,489 lines was bad, nor any of the 3,720 in the 62-minute soak. R10 is met on the bench over the wired link; on the vehicle on 27 October 5 records were missed (below).

On 27 October the recorder received 4,196 of the telemetry unit's 4,201 per-second records over the wired serial link (99.9\,\%), against 62\,\% over USB on 19 October, and answered all of about 8,391 polls of each of the six sources between 11:30 and 12:40. Over LTE, 153 records reached the database during the session, 37 live and 116 replayed from the unit's backlog when the link returned; the live records with GNSS time arrived a median of 0.44\,s after the unit stamped them (95th percentile 0.55\,s, n = 9). From 11:51 the cellular link did not reconnect, and the remaining records stayed in the unit's log.

\section{Driver display (R11, R12)}
\label{sec:res-display}

On a laptop against the live detector, the camera page showed video within 0.6\,s at 14.2\,frames/s and listed a person alert 0.5\,s after it was opened with the person in view. In live-only mode every page showed ``-{}-'' or ``Unavailable'' with the bridge down, never a simulated value. On the Raspberry Pi~5 the Sensors page showed live distances in the right colours and the banner appeared over the driving page (Section~\ref{sec:resx-display}). R11 is partly met: alerts were seen to clear only in offline runs. R12, the glance demand, needs a participant and is not measured (Section~\ref{sec:ethics}), but its precondition, legibility, needs none. At the measured eye distance of 0.62\,m (four readings from the seat, 0.60 to 0.63\,m) from the 10.1-inch panel (0.170\,mm per pixel), the speed digits are 100\,px tall, 94 arc minutes, far above the 20 recommended by ISO~15008; the alert banner's capitals are 11\,px, 10 arc minutes, below even the 12 minimum, and only 4 of 110 labels reach the acceptable 16. The median touch target is 10.9\,mm, and 5 of 26 reach 17.5\,mm (Section~\ref{sec:resx-display}). The speed is legible at a glance; the warnings are not.

Display photographs in sunlight were not taken, so contrast in daylight remains unmeasured (Section~\ref{sec:disc-display}). The dashboard also takes spoken commands, recognised offline (Vosk): 15 to 18 of 18 synthetic-voice commands on the bench, 13 to 14 at 0\,dB signal-to-noise ratio, in 1.8 to 2.4\,s, with alerts, battery and weather read out on request (Appendix~\ref{app:interface}); no driver was tested.

\section{Integration and power}
\label{sec:res-integration}

The chain from the telemetry unit through the Raspberry Pi~4 to the dashboard ran on the bench, and on 19 October the whole system was mounted on the vehicle: both detectors ran (front 17.5 to 22.0\,frames/s, 53 to 102\,ms; rear 14.4 to 14.5\,frames/s, 126 to 151\,ms), both time-of-flight boards answered, both IMUs held 200\,Hz and the Ethernet link ran at 1000\,Mb/s. The Raspberry Pi~4's under-voltage was traced to the modem on its USB port (Section~\ref{sec:inv-power}). On the first road session the recorder ran for 108.6 minutes without restarting, though the rear unit stopped answering it for the last 15 minutes, cause not recorded. The estimated added load is about 20\,W from the 72\,V pack while driving, 0.28\,\% of a 7.2\,kWh pack an hour, but enough to empty it in about 15 days if left on, so the system must switch off with the vehicle (Table~\ref{tab:power-budget}, Section~\ref{sec:resx-power}). Only the Raspberry Pi~5's figure is measured.

On 23 October, in the lab, both nodes, both detectors (front 23.8, rear 14.3\,frames/s), the recorder and the screen capture ran with the Raspberry Pis joined by Ethernet, the Raspberry Pi~4's clock synchronised to the Raspberry Pi~5's (offset estimate under 1\,$\mu$s, error bound about $\pm 79\,\mu$s). The Raspberry Pi~4 restarted twice (about 14:17 and 16:22:48) and flagged under-voltage repeatedly (10 events in 44 minutes); the second restart came 40\,s after the rear unit restarted for its recalibration, the pattern of the bench reboots when the modem powered up from the Raspberry Pi~4's USB port. Its supply is therefore not yet adequate on the vehicle.

On 26 October the Raspberry Pi~4 stopped booting after a day of under-voltage flags and repeated restarts, and was replaced with another board on the same SD card. The new board reported no under-voltage with only its own loads (0x0 after 24 minutes) but flagged it again, in short repeated events, while the telemetry unit was also powered from its USB port, so the old board's supply path was at least part of the fault and the telemetry unit must not draw from the Raspberry Pi. On the same day the rear MPU6050 stopped answering on the telemetry unit (no device at 0x68, and with a weak pull-down neither data line showed the module's pull-up resistors, so the wiring or the module's supply was open; no short between the lines). The sensor itself worked on a second ESP32-S3 board, which became the rear inertial node: the front node's firmware named \texttt{rear}, at 200\,Hz with no drops, on the Raspberry Pi~4's USB and captured like the front node, while the telemetry unit kept the battery, GNSS and cellular link on the wired serial line. With that arrangement the readiness check passed on every critical item, and the recorder logged all six sources (24 of 24 polls in its first 12\,s).

On 27 October the Raspberry Pi~4, with the telemetry unit also powered from its USB port, flagged under-voltage repeatedly and restarted once (11:21), taking the telemetry unit with it; a time-sync setting then had to be corrected so that its clock stepped to the Raspberry Pi~5's after a restart. From then to the end of the laps the system ran without a restart, and between 11:30 and 12:40 the recorder lost no poll. The Raspberry Pi~5 went off when the vehicle was switched off after the laps, and its data were copied once it was powered again. Removal was not timed, so R13 stays partly met.

\section{Summary against the requirements}
\label{sec:res-summary}

\begin{table}[htbp]
\centering
\small
\caption[Status of each requirement at the time of writing (bench unless stated)]{Status of each requirement at the time of writing (bench unless stated).}
\label{tab:results-summary}
\begin{tabular}{|p{0.8cm}|p{7.6cm}|p{5.4cm}|}
\hline
\textbf{ID} & \textbf{Result} & \textbf{Status} \\ \hline
R1 & Bench: 200.0 to 200.5\,Hz, 0 dropped (260 and 94\,Hz filters); gaps over 10\,ms only at a flush. Both nodes on 22 October: 0 drops, 0 read failures; rear v0.7.6 soak 62\,min, 0 drops, rate outside 199.5 to 200.5\,Hz in 3 of 726 polls; v0.7.8 recovers a sensor without a reset. Vehicle, 19 Oct over USB: drop count 0, but one 2\,s stall of IMU1 (about 396 samples, not counted); 38\,\% of per-second records not received & Met on the bench; on the vehicle (27 October) met at the front, rear 0.08\,\% lost in transport \\ \hline
R2 & 9.80 to 9.81\,m/s\textsuperscript{2} after calibration; drifts with orientation; front node factor repeats (1.0036, 1.0035); with bench factors the parked vehicle read 10.04 and 10.34 (19 October); mounted on 23 October: front 0.9919, rear 1.0094 & Met at each calibration; not met on the vehicle: 9.845 (rear, new board not recalibrated) and 9.941 (front) at rest on 27 October \\ \hline
R3 & Self-tests pass; 149 of 149 windows fused; run-1 log: two IMUs agree while driving (ratio 1.06, $r$ = 0.97) & Met for the fused design (to v0.7.6); the nodes are now compared, not fused \\ \hline
R4 & Median 2.7\,m, 95\% within 11.0\,m of the phone; vehicle's receiver static 10\,min (24 Oct): scatter median 1.8\,m, 95\% 4.3\,m; 19 Oct: no antenna yet, no fix; 27 Oct: fixed in 98 to 100\,\% of each pass & Partly met: bench median within 10\,m; on the vehicle (27 Oct) 8 to 25\,m from the phone, stale from 12:13 \\ \hline
R5 & 19 Oct: up to 48.03\,A in the unit's log (46.9\,A in the recorder), 74.6 to 72.8\,V; 27 Oct: up to 82.9\,A, 74.0 to 71.2\,V; no meter check & Partly met: sustained under load on the vehicle; no meter check \\ \hline
R6 & Median interval 500.06\,ms, range 499.72 to 500.41\,ms; front pulse on the Raspberry Pi~5 since 22 October; clock offset not measured & Partly met: the pulse meets its criterion; the camera-to-IMU offset is not yet measured \\ \hline
R7 & Rear (Raspberry Pi~4): 14.6\,frames/s with the whole system (19.5 alone), onset at the detector about 0.26\,s; on the road (27 Oct) 12.1\,frames/s, median 103\,ms. Front (Raspberry Pi~5): 19.2\,frames/s on the bench beside the dashboard; on the road 23.3\,frames/s, median 68\,ms & Partly met: rate and person class met; onset computed from rate and latency, not timed at the screen (C8) \\ \hline
R8 & Sensors answer; ahead sensor 1.06\,m at about 1.0\,m; fused 0.47\,m at about 0.5\,m with a person as the target (n = 43) & Partly met: no flat-target or tape series \\ \hline
R9 & 47 of 47 publishes; reconnection about 5\,s after coverage; bench read-back 6,020 of 6,020, run-1 log 2,000 of 2,022; after a 10-minute outage 112 of 112 records stored, backlog cleared 38\,s after reconnection & Met on the bench; partly met on the vehicle (153 records over LTE, 116 replayed, median 0.44\,s; link lost from 11:51) \\ \hline
R10 & 40 of 40 lines, record 0.37\,s old at a laptop; 2 to 11\,\% of lines lost over hours on USB; wired UART since 21 October, 0 bad in 2,489 lines and in 3,720 over 62\,min & Met on the bench; partly met on the vehicle: 4,196 of 4,201 records (99.9\,\%) \\ \hline
R11 & Live-only presentation; alert listed 0.5\,s after opening the page with a person in view; offline state & Partly met: clearing seen only offline \\ \hline
R12 & Glance time not measured (no participants); legibility at the measured 0.62\,m: speed 94 arc minutes, alert banner 10, labels 11 (ISO~15008: 16 acceptable) & Not tested: needs a participant; its precondition, legibility, is not met for the warnings \\ \hline
R13 & Mounted on the vehicle on 19 October; no drilling or permanent change; removal and return to standard not timed & Partly met \\ \hline
\end{tabular}
\end{table}
