0geder/Tukzie-HPEC-HUD/BenchTest/TEST_PROCEDURES.md

# SW-7 test procedures

How each test in the project is run, what counts as a pass, and where the
result and the evidence are. Every test here can be repeated from the files
in this repo. Results go in the report (Chapter 3 now, Results chapter
later), and raw evidence is indexed in Report Appendix C.

Board: Makerfabs ESP32-S3 A7670X on COM10 (native USB). Only one program
can hold COM10 at a time: close the bench console and any PlatformIO
monitor before running a script.

## Telemetry unit (ESP32)

### T1. Recorded bench session: acquisition and dual-IMU fusion
- Purpose: show 200 Hz acquisition with no drops, and dual-IMU fusion, over a full session from power-up.
- Setup: board on the bench, both IMUs connected, still, then disturbed by hand.
- Method: `BenchTest/capture_log.ps1` records every serial line with its time since reset; `BenchTest/analyse_log.py <log>` summarises it.
- Pass: both IMUs 195 Hz or more, zero dropped samples, every fused window from both sensors, all boot self-tests PASS.
- Result (25 Sep 2026): 200.0 to 200.5 Hz, 0 dropped, 149 of 149 fused windows from both IMUs, skew under 1 ms, 5 of 5 fusion self-tests passed.
- Evidence: `BenchTest/logs/2026-09-25_bench_fusion_shake.log`.

### T2. Firmware v0.5.0 bench test: commands, flash-write stall, MQTT reconnect
- Purpose: check the serial commands, test whether flash logging causes the periodic acquisition gaps, and check MQTT reconnection.
- Setup: board still on the bench, LTE antenna connected.
- Method: `python BenchTest/v050_bench_test.py COM10 <log>`: resets the board, sends `!help` and `!status`, runs 120 s with logging on, sends `!log off` and runs 120 s, then `!log on`, `!mqtt`, `!status`.
- Pass: commands answer; with logging off, no inter-sample gap over 10 ms; MQTT reconnects after `!mqtt`.
- Result (29 Sep 2026): logging on, 33 to 40 ms gaps every 10 s on both IMUs; logging off, worst gap 5.9 ms; no dropped samples; 47 publishes, 0 failed; reconnect in 0.4 s.
- Evidence: `BenchTest/logs/2026-09-29_v050_bench_test.log`.

### T3. GNSS outdoor fix and field-layout check
- Purpose: confirm the modem's +CGNSSINFO field order with a real fix, and measure position accuracy.
- Setup: board outdoors with a clear sky view (rooftop), patch antenna flat with its ceramic face up, board still. Reference position from a phone (Google Maps, long-press the blue dot).
- Method: `python BenchTest/gnss_capture.py COM10 <minutes> <log> raw <ref_lat> <ref_lon>`: turns on the firmware's `!gnssraw` printing, records every raw reply and parsed fix, and measures each fix against the reference. (Mode `query` sends its own AT+CGNSSINFO and is only for older firmware: it competes with the firmware's polling and garbles replies.)
- Pass: a 3D fix (mode 3); parsed position within 10 m of the phone; no damaged reply accepted as a fix.
- Result (29 Sep 2026, first capture, firmware v0.5.0): 3D fix after 51 s; 15 to 16 GPS, 9 BeiDou and 2 to 3 Galileo satellites; HDOP 0.86 to 0.96. The raw reply has 17 fields with latitude and longitude in decimal degrees; the old parser read satellite counts as the position. Well-formed replies were 2.4 and 5.5 m from the phone's position (-33.9800701, 18.4654199). Replies garbled by the competing query were identified and are now rejected by firmware v0.5.1.
- Result (30 Sep 2026, firmware v0.5.2, raw mode): 3D fix after 105 s from a cold start, 23 to 25 satellites, HDOP about 0.9 to 1.5. Over 104 fixes, median 2.7 m from the phone's position, 95% within 11.0 m, maximum 12.3 m. 18 replies had an 18-field layout (empty course, one extra trailing value) that v0.5.2 wrongly rejected; v0.5.3 accepts it.
- Also found: the modem power-key pulse at boot switched an already-running modem off after a reflash (a v0.5.1 capture got no replies at all); fixed in v0.5.2, which pulses only if the modem does not answer AT.
- Still open: speed units (the fix was stationary, 0.000; the manual says knots). Check against a phone's speed on the road test.
- Evidence: `BenchTest/logs/2026-09-29_gnss_rooftop.log` (v0.5.0, query mode), `BenchTest/logs/2026-09-29_gnss_rooftop_v051.log` (v0.5.1, modem switched off, no replies), `BenchTest/logs/2026-09-30_gnss_rooftop_v052.log` (v0.5.2, raw mode).

### T4. IMU calibration
- Purpose: scale each IMU's acceleration magnitude to 9.80665 m/s2 at rest.
- Method: automatic at the first boot with no stored calibration (board must be still for about 1 s). To redo it: `!recal` in the bench console, then keep the board completely still while it restarts. Then `!status` for the stored factors and the ride-vibration card or `[RIDE]` lines for the rest reading.
- Pass: rest reading 9.80 to 9.82 m/s2 on both IMUs.
- Result: bare development board 18 Sep (factors 0.9773, 0.9901, then 9.80 to 9.81); target board first boot 18 Sep (9.4387 and 9.5725 measured, factors 1.0390 and 1.0245); the rest readings later drifted to 9.93 and 10.10, most likely because of orientation. To be redone after mounting on the vehicle, in the final orientation.

### T5. MQTT end-to-end publish
- Purpose: prove the cellular path from the board to a broker.
- Method: broker set to test.mosquitto.org in main.cpp; watch for `[MQTT] Connected.` and publish results. `!status` shows counts.
- Pass: connection and acknowledged publishes.
- Result: first acknowledged publish (+CMQTTPUB: 0,0) on the target board; T2 then gave 47 of 47.

### T6. Signal-loss recovery
- Method: `python BenchTest/signal_loss_test.py COM10 60 <log>` sends `AT+CFUN=4` (radio off), waits 60 s, sends `AT+CFUN=1`, and records until the firmware reconnects. By hand: the same two commands in the bench console.
- Pass: the firmware reports the loss, retries with increasing delay, and reconnects by itself within a few retry intervals of the radio coming back.
- Result (30 Sep 2026): loss detected 0.8 s (modem report) or 20.7 s (three failed publishes) after the radio went off; retries at 30 and 60 s; reconnect 36 s after the radio returned in v0.5.0, about 5 s in v0.5.3, which reconnects as soon as the modem reports the data connection back. No failed publishes afterwards.
- Evidence: `BenchTest/logs/2026-09-30_signal_loss_test.log` (v0.5.0), `BenchTest/logs/2026-09-30_signal_loss_test_v053.log` (v0.5.3).

### T8. I2C line voltage
- Method: board powered, multimeter on 20 V DC, black probe on GND, red probe on the IMU's SDA and then SCL pins with the bus idle.
- Pass: about 3.3 V (pull-ups to 3.3 V, safe for the ESP32 inputs; 5 V would mean the module's pull-ups go to 5 V).
- Result (30 Sep 2026, bench): about 3.3 V. To repeat on the vehicle wiring after mounting.

### T9. Firmware v0.6.0: buffered logging, signal quality, Hall counter
- Method: `python BenchTest/v060_bench_test.py COM10 <log> 330`: resets the board, `!status`, 330 s with logging on, `!status`. Board still. Hall counter in bench loopback on the sync pin (HALL_INPUT_PIN = SYNC_PULSE_PIN).
- Pass: gaps over 10 ms only at a log flush (about once a minute); no dropped samples; Hall count between the two `!status` = 2.00 edges/s; a CSQ value shown.
- Result (1 Oct 2026): 5 flushes (71 to 202 ms each); 10 windows with a gap over 10 ms (37 to 40 ms, both IMUs at each flush), all within 3.5 s after a flush; worst gap otherwise 5.9 ms; 200.0 to 200.5 Hz, 0 dropped; Hall 666 edges in 333.3 s = 2.00 edges/s; CSQ 24 to 26 (about -65 dBm). Log file 2.18 MB of the 3 MB cap.
- Evidence: `BenchTest/logs/2026-10-01_v060_bench_test.log`.

### T10. Stored log read-back
- Method: `python BenchTest/log_dump.py COM10 <out.jsonl> [--clear]`: sends `!log dump` (records printed as LOG|index|length|record, paced), keeps intact records, repeats up to four passes until every index is present, checks JSON, saves the records as stored and a .clean.jsonl with nan replaced by null; `--clear` then sends `!log clear`.
- Pass: every index up to the firmware's line count received intact; every record parses.
- Result (1 Oct 2026, v0.6.3): 6,020 records (2.2 MB, about 16.7 h) complete after four passes (the one index missing was a record written during the dump). 5,545 contained nan and were not valid JSON as stored (fixed in v0.6.3); all parse after nan -> null. 14 records with a valid BMS reading (74.78 V, 0.00 A, 60%) from the 30 Sep v0.5.4 session. Log cleared afterwards.
- Evidence: `BenchTest/logs/2026-10-01_telemetry_log_dump.jsonl`, `.clean.jsonl`.

### T11. Firmware v0.7.0 DASH line (dashboard link)
- Method: flash v0.7.0, read the USB serial port for 40 s, parse every line starting with `DASH ` as JSON, check the period, sequence numbers, fields and length (`DashboardIntegration/TELEMETRY_LINK.md` section 1).
- Pass: one line per second, no missing sequence numbers, every line valid JSON with all contract fields, under 400 bytes, IMUs still at 200 Hz with no drops.
- Result (2 Oct 2026, bench, laptop COM10): 40 lines in 40 s, seq 13 to 52, none missing, all valid JSON, all 18 fields, longest 272 bytes; arrival gaps 0.55 to 1.45 s at the laptop (read-side buffering; sequence complete); imu_hz 200.0 and 200.0, drops 0 and 0; vib 0.034 m/s2 at rest; csq 22; BMS and GNSS null indoors (pack out of range, no fix), MQTT not yet connected 54 s after boot. Pass.
- Result v0.7.1 (4 Oct 2026, laptop COM10, 25 s): every line carries crs and alt (both null indoors, no fix), longest line 298 bytes, fw "0.7.1", imu_hz 200.5 and 200.5, drops 0 and 0, csq 30, MQTT not yet connected 42 s after the restart. Sequence 16 to 40 with one number missing: the firmware counts only lines it sent, so that line was received damaged, most likely interleaved with another task's serial output; the bridge counts such a line as bad and uses the next one a second later.

### T12. Telemetry bridge on the Pi 4 (dashboard link)
- Method: ESP32 (v0.7.0) on the Pi 4's USB (`/dev/ttyACM0`), run `CameraDetection/telemetry_bridge.py`, fetch `http://<pi4>:8081/telemetry` from the laptop over the hotspot.
- Pass: contract JSON (`DashboardIntegration/TELEMETRY_LINK.md` section 2) with a live ESP32 record under 3 s old, ToF distances, no bad lines; opening the port does not reset the ESP32.
- Result (2 Oct 2026): replay trial on the Pi with real ToF (11 lines, 0 bad, clean stop); live: esp32 record 370 ms old (fw 0.7.0, imu_hz 200.5 and 200.5, drops 0, vib 0.038, csq 22), tof left 149, ahead 37, right 154 mm, 14 lines 0 bad; ESP32 seq already 64 when the bridge started, so no reset on open. Pass. Boot service installed and enabled on 2 Oct 2026 (16:46): active, serial and all three ToF sensors opened, 443 lines 0 bad, ESP32 record 340 ms old, imu 200.5 and 200.5 Hz, 0 drops. MQTT, false in the first minute, was connected by then (seq 1237), so the earlier false was slow registration, not a fault.

### T13. Pre-test check (before every session)
- Purpose: confirm, in one command, that every part of the dashboard link is up before a test or demonstration, so a test is never run on stale, simulated or missing data.
- Method: `python BenchTest/sw7_check.py` from the laptop (or on the Pi 5). It finds the Pi 4 the same way the dashboard does (`DashboardIntegration/sw7_endpoints.py`) and the Pi 5 from its beacon (`deploy/pi5_beacon.py`), its last address, the Raspberry Pis on the local network and, if none, a scan for open ssh ports (phone hotspots drop pings and mDNS between clients, seen 3 Oct 2026), confirming the hostname over ssh. Items: Pi 4 found and how; camera `/alerts` with fps; telemetry fresh (ESP32 age under 3 s); IMU rates and drops; three ToF valid; detector and bridge services; Pi 4 under-voltage and throttling flags (`vcgencmd get_throttled`); Pi 5 reachable; dashboard running there with `TUKZIE_LIVE_ONLY` set.
- Pass: `RESULT: READY (all critical items pass)`, exit code 0. Warnings (for example the throttling flags) are recorded with the session.
- Result: offline tests `python -m pytest -q BenchTest/tests/test_sw7_check.py`, 16 passed (5 Oct 2026). Against the real system: not yet recorded. Record the first full output here, including the Pi 4 throttling value.
- Result against the real system (4 Oct 2026, laptop on the phone hotspot): RESULT: READY. Pi 4 found via its beacon (10.74.67.244); /telemetry answered in 18 ms, ESP32 record 527 ms old, IMU1 and IMU2 200.0 Hz, drops unchanged; ToF left 150, ahead 82, right 1017 mm; camera /alerts at 6.1 fps; telemetry-bridge and hazard-detector services active; Pi 5 found by name with the SW-7 dashboard running (commit 37e5641) and TUKZIE_LIVE_ONLY=1. Pi 4 power FAIL: throttled 0x50005 (under-voltage and throttling now and since boot), which matches the detector running at 6.1 fps against 19.5 fps on a proper supply (C4). Earlier runs the same day: NOT READY with the camera detector not yet a service; the Pi 4 not found when the 1 s probe timeout was shorter than the hotspot round trip (timeout raised to 3 s); the Pi 5 not found by name or ping on the phone hotspot (it drops pings and mDNS between clients; the check now listens for the Pi 5 beacon and scans for open ssh ports).

### T14. GPS replay through the bridge to the dashboard (planned on the Pis)
- Purpose: test the moving map and the REPLAY marking end to end without driving.
- Data: `CameraDetection/tests/replay_uct_route.txt`, generated by `CameraDetection/tools/make_replay_track.py` from an OSRM demo-server driving route on OpenStreetMap data (2,993 m, 650 points at 1 Hz, 18 km/h target). Not recorded data: every line has `"fw":"0.7.1-replay"`, battery and motor fields null, vibration made up.
- Method: on the Pi 4, `sudo systemctl stop telemetry-bridge`, then `venv/bin/python3 telemetry_bridge.py --replay tests/replay_uct_route.txt --no-tof` (`CameraDetection/deploy/INSTALL.md`); on the Pi 5, open the Navigation page of the SW-7 dashboard. Afterwards restart the service and confirm `"replay": false` in `/telemetry` before any real test.
- Pass: `/telemetry` shows `"replay": true`; the map follows the route heading-up and moves smoothly; the amber REPLAY badge is on the map and the ride card throughout; tiles load (or vector roads offline).
- Result: offscreen on the laptop (`DashboardIntegration/tests/test_tile_map.py` with a stand-in tile server, 4 Oct 2026, rerun 5 Oct 2026): all tile map tests pass. On the Pis: not yet run.

### T15. Store-and-forward to the central database: outage and replay (firmware v0.7.4)
- Purpose: validate "successful remote data synchronisation with the central database": every record the unit makes reaches the database once, also across an LTE outage, and measure how long the backlog takes to drain and the end-to-end latency.
- Setup: v0.7.4 flashed, board on the laptop (COM10), LTE antenna connected, ideally by a window so the GNSS time is known (needed for the latency figure; `!sync` shows `utc_ms` once it is). Ingest running on the Pi 5 (`systemctl --user status sw7-ingest`, `Server/README.md`) on the same broker and topic as the firmware. Note the start time.
- Method: (1) `!sync` in the console: note boot, next_seq, lost. (2) `python BenchTest/sync_outage_test.py COM10 10 logs/<date>_sync_outage_test.log`: 60 s of normal flow, radio off with AT+CFUN=4 for 10 minutes, radio on, polls `!sync` until the backlog is 0, prints reconnect and drain times. Alternative: `--manual` and unplug the LTE antenna by hand. (3) On the Pi 5: `cd ~/sw7_server && venv/bin/python sync_report.py --since <start time> --csv reports/<date>_t15 --check`, and copy the CSVs to `BenchTest/logs/`. (4) Optional cross-check against the unit's own log: `python BenchTest/log_dump.py COM10 logs/<date>_t15_dump.jsonl`, then `sync_report.py --log <that file> --since <start time>`.
- Pass: (a) zero missing seq in the test window, and with the log copy every logged record stored; (b) about 60 records replayed for a 10 minute outage, each stored once (duplicates are allowed in transit and counted, never stored twice); (c) backlog 0 within 2 minutes of reconnecting (60 records at 1 to 3 per second); (d) live latency, receive time minus device UTC, median 2 s or less and 95th percentile 5 s or less (provisional: no measurement yet; includes the GNSS time error of up to about 1 s); (e) the unit's `lost` counter unchanged; (f) IMUs still at 200 Hz with no dropped samples during the replay (it reads the log from flash).
- Laptop-only checks done (11 Oct 2026): firmware ledger logic, `python TelemetryUnit/test_host/run.py` (40 checks including 900 randomised outage, reboot and truncation simulations, all pass); server, `python Server/tests/test_server.py` (11 pass); synthetic records through test.mosquitto.org into the Pi 5 database, 20 of 20 stored, 0 missing.
- Result (11 Oct 2026, indoors, v0.7.4 flashed from the laptop, ingest on the Pi 5, public test broker): PASS on completeness; latency not measured.
  - Outage made with AT+CFUN=4 for 600 s (sync_outage_test.py COM10 10). Unit: 60 records built up (backlog 60, lost 0); modem reconnected 5.2 s after the radio came back; backlog 0 after 48.0 s (42.8 s after reconnecting); after the test acked 170 of next 171, replayed 67 this boot (7 earlier at start-up), lost 0.
  - Database (sync_report.py --boot 2 --log ... --check): 112 of 112 records of boot 2 stored, missing seq 0, duplicates 0; 60 first arrived as replays and drained in 37.3 s (1.58 per s, 600 s of device time); against the unit's log, 111 of 111 logged records stored (100.00 %). CHECK missing seq = 0: PASS.
  - 24 records were backfilled from the unit's log (ingest --import-log): two (seq 90 and 91) were published live while the ingest was being restarted, and the rest predate the ingest fix. The public broker acknowledges records with no subscriber present and does not queue them, so log read-back is the safety net on this broker.
  - Found and fixed during the test: the ingest's persistent session on test.mosquitto.org stopped delivering while still connected (records at the broker, none in the database for over an hour). Persistent sessions are now opt-in (SW7_PERSISTENT_SESSION=1), commit 892219f.
  - Not measured: live latency (no GNSS time indoors; needs a fix, e.g. on the road test).
  - Evidence: BenchTest/logs/2026-10-11_sync_outage_test.log, BenchTest/logs/2026-10-11_t15_device_log.jsonl, BenchTest/logs/2026-10-11_t15/ (summary, boots, replay, latency CSV).

### C8a. YOLO11n via NCNN without PyTorch (trial)
- Why: the PyTorch download for the Pi failed repeatedly over the campus network; NCNN alone is also the lighter deployment.
- Method: `CameraDetection/ncnn_bench.py` (ncnn package, numpy letterbox, decode, NMS; masks and polygons for -seg), same camera settings and SensorTimestamp timing as C4.
- Result (2 Oct 2026, 15 s trial, YOLO11n COCO, 320 input, 4 threads): 7.9 fps; queue 48 ms, pre 7 ms, inference 111 ms, post 2 ms (medians); total 175 ms median, 258 ms p95; CPU 64.3 C. No detections (nothing in view; to recheck with a person in view). Full 60 s runs for 320/640 and -seg still to do.

### T7. BMS link on the vehicle (planned)
- Method: on the vehicle with the pack on, watch `[BMS] scan saw:` lines for the configured address; if absent, record the addresses seen.
- Result so far (30 Sep 2026): pack seen as DB24SA01L24S150ABU at the configured address, weak signal (-93 dBm at the laptop, -88 dBm on a phone). One connection, three frames, all rejected: checksum formula wrong (included the register byte). Fixed in v0.5.4, which also prints rejected frames raw. Confirmed by the stored log (T10): 14 records with a valid reading, 74.78 V, 0.00 A, 60%, later in the same session; still to compare with the phone app. Next: place the board within about 1 m of the pack's Bluetooth module; compare with the phone app.
- Evidence: `BenchTest/logs/2026-09-30_bms_vehicle_v054*.log`, `BenchTest/bms_probe.py` (laptop, read-only).
- Pass: connection and checksum-valid frames; pack voltage matches a meter reading.

## Camera and detector (Raspberry Pi 4)

Commands for the Pi are on the Camera Test Runbook page; the steps below
say what each test is for and what counts as a pass.

### C1. Live detection
- Method: `python3 hazard_detector.py --duration 60 --log-path alerts.jsonl` (optionally `--preview --preview-host 0.0.0.0` and view `http://<pi-ip>:8080`).
- Pass: runs for the full minute; a person in view is logged as "person"; frame rate at least 5 fps.
- Result (28 Sep 2026): run 1, 7.2 fps, person logged as "motorcycle" (label-offset fault); run 2 after the label and colour fixes, 7.0 fps, person at confidence 0.50 to 0.73; 16 alert activations in 47 s, which led to the clear-side hysteresis.
- Evidence: `Report/evidence/2026-09-28_camera_run1_label_bug.txt`, `..._run2_after_fixes.txt`.

### C2. Detector logic, offline
- Method: `python CameraDetection/tests/test_alert_logic.py`, `test_alerts_endpoint.py`, `test_latency_and_preview.py`. They run the unchanged detector loop with a fake camera and model (`CameraDetection/tests/fakes`).
- Pass: single missed frames do not clear an alert; a single near frame does not escalate it; a sustained approach does; the alert clears when the object leaves; `/alerts` empties after clearing; handing a frame to the preview does not block; timings are recorded.
- Result (28 to 30 Sep 2026): all pass.

### C3. Colour check
- Method: runbook step 5 with the colour cards in `Colour Cards/` (blue, red, green, grey, plus plain white paper), held together about 1 m from the camera.
- Pass: blue shows blue; grey and white look neutral. If both the live view and the Pi's own preview are reddish, try the `ov5647_noir.json` tuning.
- Result (1 Oct 2026): `rpicam-still` with the standard tuning: white wall strongly pink; with `ov5647_noir.json`: neutral. Detector frames (standard tuning) also pink, so the module has no IR-cut filter (student confirms the camera is the cause). With `--tuning ov5647_noir.json` alone: neutral but washed out, blue card RGB 120/124/125. With `--saturation 1.8` added: blue card 1/83/218, red box 213/7/56, white wall 202/217/214. Detector now started with both (service file updated). Each card held up in turn, mean RGB in the detector's frames: blue 1/86/216, red 222/8/77, green 6/124/103, grey 124/129/138, white 186/199/197. All four held together in one frame (card2_all4.jpg): blue 1/94/207, red 243/19/44, grey 187/189/176, green 77/145/89, all distinct. Pass: colours clearly identified; grey and white slightly cool (red about 12 to 14 low), acceptable. Recheck outdoors in daylight.
- Evidence: `Report/evidence/c3/` (default.jpg, noir.jpg, detector_view.jpg, detector_view_noir.jpg, card_blue.jpg, card_blue_sat18.jpg, card2_blue.jpg, card2_green.jpg, card2_grey.jpg, card2_white.jpg).

### C4. Latency
- Method: runbook step 7, three one-minute runs (no preview, with preview, one thread), keeping the `[timing]` lines and CSVs.
- Pass: to be set from the measurements and the speed argument in the report.
- Result (30 Sep 2026, current detector deployed to the Pi first; bench, no objects): 4 threads 19.5 fps, total median 102 ms, p95 120 ms, max 136 ms (queue 52, pre 12, inference 36, alert logic 0.1); with the live-view server (no viewer) 17.3 fps, 105 / 127 ms; 1 thread 7.0 fps, 186 / 207 ms (inference 126 ms). 65.7 C, no throttling. The earlier 7 fps live runs match the 1-thread figure.
- Evidence: `BenchTest/logs/2026-09-30_c4_latency/` (per-frame CSVs and console output).

### C5. Distance calibration and object coverage (planned)
- Method: runbook steps 4 and 6 with a tape measure (2, 4, 6, 8 m; facing and side-on; person and bicycle first).
- Pass: bands match the tape-measured distance after focal-length calibration.

### C6. Camera to IMU time alignment
- Method: sync pulse from the ESP32 (GPIO15, toggling every 500 ms) to the Pi (GPIO17), with a lens-cover test for the camera clock offset. Quick wiring check on the Pi: `time gpiomon -c gpiochip0 -n 20 17 > /dev/null`, expecting about 10 s.
- Wiring: ESP32 J5 pin 5 (GPIO15) to Pi physical pin 11 (GPIO17), plus a ground wire (Pi pin 9 to ESP32 GND). Both are 3.3 V logic, so they connect directly.
- Logger: `python3 CameraDetection/sync_logger.py --duration 60 --out sync_edges.csv` records every edge with the Pi's monotonic clock (kernel timestamps through gpiod) and prints the interval summary. Run it alongside the camera or detector so both use the same clock.
- Pass: about 2 edges per second; median interval 500 ms; no intervals outside 500 +/- 20 ms. Zero edges means the wire or ground is loose (seen once on the bench).
- Result: offset bounded under about 1 s (see Methodology, time synchronisation). Logger checked offline against a fake GPIO (30 Sep 2026); not yet run on the Pi. Wire check (30 Sep 2026): 20 edges in 9.95 s, one edge every 500 ms as expected. Logger on the Pi (30 Sep 2026, gpiod v2 kernel timestamps, 60 s each): run 1, 159 edges with 50 intervals out of range, all between 5 and 21 s into the run (bursts of extra edges down to 0.03 ms apart, consistent with a disturbed contact), clean for the last 39 s; run 2, 121 edges, median 500.06 ms, range 499.72 to 500.41 ms, 0 out of range. Evidence: `BenchTest/logs/2026-09-30_sync_edges_run1_noisy.csv`, `..._run2.csv`.

### C7. Stand-in ToF (micromouse sensor board, three VL53L0X)
- Wiring: sensor board J2 pin 3 (3V3) to Pi pin 1, J2 GND (pin 23) to Pi pin 6, J2 31 (SDA) to Pi 3, J2 32 (SCL) to Pi 5, XSHUT1/2/3 (J2 21/9/7) to Pi 15/16/18 (GPIO22/23/24). VDD (LED supply) not connected. Continuity-check each pin first. Pi I2C on (`sudo raspi-config nonint do_i2c 0`).
- Method: `venv/bin/python tof_probe.py`, then `venv/bin/python tof_reader.py --duration 15 --csv tof.csv`. Then a hand at about 15 cm in front of each sensor in turn to confirm which is left, ahead and right, and a tape measure at 0.2, 0.5, 1.0 and 1.5 m.
- Pass: chip identified; three sensors answer; readings change with the hand on the matching sensor; within about 5% of the tape below 1 m.
- Result (1 Oct 2026): chip VL53L0X; all three addressed and read at about 31 readings/s each; centre 267 to 300 mm, right 24 to 38 mm (something close in front of it), left 8190 every reading (no target in range, sensor answering). Cover test (1 Oct 2026, board untouched, each sensor covered by a fingertip in turn): left 27 to 46 mm, then centre 40 to 43 mm, then right 20 to 24 mm, in the order covered, so the labels match the physical sensors; afterwards about 690, 330 and 595 mm to the room. Tape check not yet done.
- Evidence: `BenchTest/logs/2026-10-01_tof_three_sensors.csv`, `..._tof_hand_test.csv`, `..._tof_cover_test.csv`.

### C9. Camera and ToF fusion
- Purpose: show that fusing the camera detector (what, and in which direction) with the three ToF sensors (how far, close by) gives a better distance than the camera's width heuristic alone, and that each sensor covers the bearing assumed for it. Rules in `CameraDetection/sensor_fusion.py`; geometry in `CameraDetection/fusion_config.json`.
- Software: detector running with `--preview` (its service does), which serves `GET /detections` on port 8080; bridge with `--fusion on` polls it at 5 Hz and writes one JSON line per update to `--fusion-log` (time, the three ToF readings, fused hazards; numbers only, no images). Offline checks: `python -m pytest -q CameraDetection/tests/test_sensor_fusion.py` (29 tests: bearing, association inside and outside a cone, out of range, stale timestamps, two objects, ToF-only debounce, band recomputation, `/detections`, and the bridge against a fake detector).
- Setup: sensor board and camera fixed together on the bench, the board's front edge level with the lens (the reference plane for every tape measurement). Indoors, plain wall behind, nothing else within 2 m in front of the sensors (the VL53L0X reaches about 2 m). Use one log file per step.
- Calibration (before F1 to F4; results go into `fusion_config.json`, set `"calibrated": true`):
  1. Camera axis: a strip of tape on the floor from below the lens straight ahead to 2 m, positioned so a marker on it stays on the vertical centre line of the live view (`http://<pi-ip>:8080`) at 0.5 and 2 m.
  2. Cross line: a second strip across the first at 0.8 m, marked every 2 cm from the axis (negative to the left).
  3. ToF cones: a narrow upright target (a 4 cm wide cardboard tube) on the cross line, moved from far left to far right in 2 cm steps. At each step read the three distances from `http://localhost:8081/` (status page, or `watch -n 0.5 curl -s localhost:8081/`). For each sensor note x_in and x_out, the first and last offsets where it reads the target (within about 5 cm of 0.80 m). Centre bearing = atan(((x_in + x_out) / 2) / 0.8); half-angle = atan(((x_out - x_in) / 2 - 0.02) / 0.8). Expected near -35, 0, +35 degrees and 12.5 degrees.
  4. Camera field of view and sign: the same target at the left and right edges of the live view at 0.8 m (offsets x_l, x_r): hfov = atan(|x_l| / 0.8) + atan(x_r / 0.8). Then the tester steps to the right of the axis: `curl -s localhost:8080/detections` must show a positive `bearing_deg` (otherwise set `"camera_mirror": true`).
  5. Range: from C7's tape check, the largest distance at which each sensor is within 5% of the tape becomes `max_range_m` (default 1.2 m).
- F1. Walk across at 1 m: the tester walks slowly (about 3 s across the view) along a line 1 m from the lens, left to right, then back. Log: `f1_walk.jsonl`. Expected: the person's bearing rises steadily; source "fused" with sensor "ahead" in the centre, "camera" elsewhere, "fused" with "left"/"right" only where those cones overlap the camera's view (with the default geometry only the outer 9 degrees of each side of the view, gate included). Report: `fusion_report.py f1 f1_walk.jsonl --class person`. Pass: at least 80% of bearing steps in the walking direction, and the fused sensors in spatial order.
- F2. Distance: the tester stands on the axis, facing the camera, at 0.5, 1.0 and 1.5 m on the tape (front of the body to the reference plane), 20 s each. Logs: `f2_050.jsonl`, `f2_100.jsonl`, `f2_150.jsonl`. Report: `fusion_report.py f2 f2_050.jsonl:0.5 f2_100.jsonl:1.0 f2_150.jsonl:1.5 --class person --skip-s 3` (median and maximum error of the fused and camera distances against the tape). Pass: at 0.5 and 1.0 m the person is fused in at least 80% of updates and the median fused error is 5 cm or less; at 1.5 m (beyond 1.2 m) camera-only. The camera error is recorded for comparison (its focal length is not yet calibrated, C5).
- F3. Object outside the camera's classes: a cardboard box (about 40 cm) on the axis at 0.8 m, nobody in view, 20 s. Log: `f3_box.jsonl`. Report: `fusion_report.py f3 f3_box.jsonl --tape 0.8 --skip-s 3`. Pass: an "obstacle" with source "tof" from the ahead sensor in at least 90% of updates, no camera or fused hazard, ToF distance within 5 cm.
- F4. Person beyond ToF range: the tester on the axis at 2.5 m, 20 s. Log: `f4_person.jsonl`. Report: `fusion_report.py f4 f4_person.jsonl --tape 2.5 --class person --skip-s 3`. Pass: the person in at least 90% of updates, always source "camera", never fused; camera distance error recorded.
- Commands (Pi): `sudo systemctl stop telemetry-bridge` (it holds the ToF sensors), check the detector with `curl -s localhost:8080/detections`, then for each step `cd ~/hazard_detector && mkdir -p ~/c9 && venv/bin/python3 telemetry_bridge.py --fusion on --no-beacon --fusion-log ~/c9/<step>.jsonl --duration 25`; afterwards `sudo systemctl start telemetry-bridge`. Laptop: `scp -i ~/.ssh/pi4_camera_key ogeder@<pi-ip>:~/c9/*.jsonl BenchTest/logs/<date>_c9/`, then the reports above.
- Result: offline tests pass (4 Oct 2026); not yet run on the Pi.
- First run on the Pi 4 (4 Oct 2026, before calibration, not the C9 test): detector /detections answering at 15.8 fps with the band thresholds and hfov 53.5; the bridge's fusion block live in /telemetry with no person in view, showing ToF-only "obstacle" hazards (e.g. ahead 0.125 m, band immediate) from objects on the bench. Fusion log off by default; C9 steps F1 to F4 not yet run.
- First fused hazard (6 Oct 2026, before calibration, not the C9 test): with a person close in front of the camera, /telemetry showed source "fused", class person, sensor "ahead", camera distance 0.874 m, ToF distance 0.096 m, reported distance 0.096 m, band immediate (detector 6.2 fps, person at bearing 0.34 deg, confidence 0.60). At the same time the right ToF gave a ToF-only obstacle at 0.17 m; left ToF null. Shows the matching works and that the uncalibrated camera distance is far off at close range; tape distances not measured.
- Evidence: `BenchTest/logs/<date>_c9/` (fusion logs, report output, `fusion_config.json` as calibrated).

### C10. Pothole path in the detector (experimental, run-2 model)
- Purpose: run the run-2 YOLO11n pothole model (NCNN, 320 input) inside the detector on the road band it was trained on (42 to 68 % of the height, three tiles), publish potholes without disturbing the existing outputs, and measure what it costs the people and vehicle detector. Code: `CameraDetection/pothole_detector.py`, `--potholes on|off` and `--test-image` in `hazard_detector.py`; brief and results in `Planning/pothole-integration-prompt.md`.
- Offline: `python CameraDetection/tests/test_pothole.py` (22 tests: band and tile maths against cell 2g, letterbox, decode back to full-frame pixels, merging across overlapping tiles, NMS, the 2-of-3 debounce, settings precedence; with the ncnn package also the model on `tests/data/pothole_slievebane_road.jpg` and on a blank frame).
- Speed (Pi 4, service running, 60 s of `[timing]` lines per setting): `{"potholes": true, ...}` in `~/hazard_detector/detector_options.json`, restart the service (kill its MainPID), read `journalctl -u hazard-detector --since "-60 s" | grep timing` and `road_hazards_meta.rate_hz` in `curl -s localhost:8080/detections`. Pass: fps and sensor-to-result latency within 10 % of the run with the path off.
- Picture check (no driving needed): with the service running, `cd ~/hazard_detector && venv/bin/python3 hazard_detector.py --duration 30 --preview --preview-port 8090 --potholes on --pothole-rate 1 --test-image pothole_slievebane_road.jpg --log-path /tmp/pothole_check_alerts.jsonl`, then `curl -s localhost:8090/detections` and `/alerts`. Pass: a pothole in `road_hazards` with `experimental: true`, one `pothole` alert after 2 runs, the existing keys unchanged.
- Result (11 Oct 2026): offline, 22 of 22 pass; the existing detector and fusion tests still pass. Pi 4 picture check: pothole at confidence 0.63, box (0.379, 0.522, 0.480, 0.550), bearing -4.1 degrees, centre tile, alert logged with the five approved fields. Speed against the path off (14.6 fps, total median 121 ms, p95 148 ms): 2 threads at up to 4 Hz, 11.7 fps and 137 ms; 1 thread at 1 Hz, 12.0 fps and 138 ms; 1 thread on its own core with the detector on 3, 10.9 fps and 147 ms; 1 thread at 0.5 Hz, 13.3 fps, 129 ms, p95 166 ms; 1 thread at 0.25 Hz, 13.9 fps, 125 ms, p95 157 ms (the only setting within 10 %). One run of three tiles takes 0.55 to 0.75 s next to the detector, and the 640 export 2.2 s, which also missed the pothole in the picture. The path is therefore off by default and the service runs without it. Not yet tested on a road or with this vehicle's camera; the held-out score of the model is still to be made (`CameraDetection/training/score_heldout.py`).

### C11. Approaching objects: time to contact accuracy (planned)
- Purpose: measure how accurate the approaching warning is on each camera (Pi 5 front, Pi 4 rear) and the ToF: the time to contact (TTC) from box growth in `hazard_detector.py`, the ToF closing rate in `sensor_fusion.py`, how soon the alert comes, and that still or receding objects do not raise it. Method and schema in the two module docstrings.
- Before field use: the approaching alert and its four extra log fields (track_id, ttc_s, side, approaching) change the alert method and logged fields, which the ethics conditions ask to be reviewed first (`CameraDetection/README.md`). Run V1 to V5 only once that is settled. Safety: closed area, a marshal for V3, cones the car never passes.
- Offline: `python -m pytest -q CameraDetection/tests/test_approach.py` (40 tests: TTC within 2 % for a constant-speed approach at 19 and 14.7 fps, median error about 3 % with 1.5 % box jitter, no alert for receding, constant-size or jittering boxes, clipped boxes rejected, track id kept through two missed frames, hysteresis, ToF closing rate with nulls and out-of-range readings, fused TTC source, schema, per-frame cost).
- Logging (numbers only, no frames): the detector's alert log (`--log-path`, approaching onsets and clears with ttc_s, track_id, side); the bridge with `--fusion on --fusion-log ~/c11/<run>.jsonl` (every 0.2 s: each hazard's ttc_s, closing_mps, approaching, ttc_source, side; camera hazards carry the detector's per-frame TTC). Check `curl -s localhost:8080/alerts` shows the right `"side"` on each Pi first.
- Ground truth: tape marks on the ground on the camera axis every 1 m from 1 to 10 m (V1, V2) or cones every 5 m from 5 to 40 m (V3), distances from the lens plane. A phone films the subject and the marks from the side at 60 fps. Clock: both Pis and the phone on NTP; at the start of each run the phone also films a Pi terminal running `while true; do date +%T.%N; sleep 0.1; done`, which gives the phone-to-Pi offset to about 0.1 s.
- V1. Person walking toward each camera: the tester walks from the 10 m mark toward the camera at a steady pace (a metronome at 2 steps per second, about 1.2 to 1.4 m/s) and stops at the 1 m mark; three runs per camera, front and rear. Expected: approaching (warning) once the true TTC falls under 4 s, immediate under 2 s.
- V2. Still and receding person: standing at 3 m for 60 s, then walking away from 1 m to 10 m; three runs per camera. Expected: no approaching alert at any time.
- V3. Car approaching the stationary trike: in a closed car park, a car drives straight at the stationary trike from 40 m at a steady 10 km/h, then 20 km/h (cruise or a marshal reading the speedometer), starting to brake at the 15 m cone and stopping before the 10 m cone; two runs per speed for the rear camera (car behind the trike), then the front camera. Only the steady part before braking is scored (TTC at the brake point: 5.4 s at 10 km/h, 2.7 s at 20 km/h measured to the lens).
- V4. ToF closing: a box on a trolley pushed toward the ahead sensor from 1.2 m to 0.3 m along a tape marked every 0.1 m, three runs at about 0.3 and 0.6 m/s. Expected: `ttc_source` "tof" while fused or ToF-only, approaching once the TTC falls under 4 s.
- V5. Moving trike (ego motion, qualitative): ride at walking pace toward a parked car and a standing person in the closed area, stopping well short. Expected: both reported as approaching from the front camera (forward collision warning; intended), nothing from the rear camera for still objects behind.
- Computing the error: from the video, the time each mark is crossed; a straight-line fit of distance against time over the scored part gives the speed v and the contact time t_c (distance 0). True TTC at time t is t_c - t. For every logged ttc_s (fusion log, matched by Pi time after the clock offset), error = ttc_s - (t_c - t). Report per camera and per run type the median and 95th percentile of the absolute error and of the error divided by the true TTC, in bins of true TTC 0 to 2, 2 to 4 and 4 to 6 s; the share of updates with a valid TTC (coverage); the alert delay, from the true TTC crossing 4 s to the approaching onset in the alert log; and the number of approaching alerts in V2. For V4 the same, with the ToF readings as a second ground truth. closing_mps is compared with v only after the focal length is calibrated (C5).
- Pass (proposed): median absolute error at most 20 % of the true TTC for true TTC 1 to 4 s on both cameras; alert delay at most 0.7 s (window fill, three-frame onset and the 51 to 120 ms pipeline); no approaching alert in V2; V4 median error at most 15 %.
- Result: not yet run. Offline tests pass (15 Oct 2026, 40 of 40).
- Evidence: `BenchTest/logs/<date>_c11/` (fusion logs, alert logs, mark-crossing times from the video; the video itself stays on the phone and is deleted after the times are read, as it shows people).

## Bench tools

### C8. YOLO comparison on the Pi 4 (planned)
- Why: decide with measurements whether a YOLO model (boxes, or polygons with -seg) can replace or join SSD-MobileNet on the Pi 4, and what polygons cost.
- Method: stop the detector; copy `CameraDetection/yolo_bench.py` and `run_yolo_bench.sh` to `~/yolo_bench` on the Pi and run `bash run_yolo_bench.sh`. It builds its own venv (ultralytics, ncnn), exports YOLO11n and YOLO11n-seg to NCNN at 320 and 640, and runs each for 60 s with the NoIR tuning and saturation 1.8. Timing as in C4: queue from SensorTimestamp, then pre, inference, post, total sensor to result; no frames stored.
- Pass: not a pass/fail test. Record fps and median/p95 total for each of the four runs next to SSD-MobileNet (19.5 fps, 102/120 ms). A model is usable for live alerts if it keeps the alert onset (three frames plus latency) under about 0.5 s.
- Results: `results/` on the Pi, copied to `BenchTest/logs/`.

### B1. Bench console replay
- Method: inject a recorded log into `BenchTest/sw7_console.html` as `window.REPLAY_LINES` and screenshot it with headless Edge (the replay figure in Appendix C).
- Pass: every card and chart matches the log.

### B2. Dashboard camera page, offscreen
- Method: `DashboardIntegration/tests/test_front_camera_page.py` (setup in its header).
- Pass: newest frame chosen from a chunked stream; alerts listed and cleared; responsive and "Camera offline, retrying" against an unreachable address.
- Result (28 Sep 2026): passes. Not yet tested on the Pi 5.
- Live (1 Oct 2026, `DashboardIntegration/tests/test_front_camera_page_live.py` on the laptop, detector on the Pi 4 with `--preview --preview-host 0.0.0.0`, 50 s): page Live 0.6 s after start; 638 frames decoded in 45 s (14.2 per second, detector 14.8 fps); longest gap 0.22 s; frame rate and latency shown (14.7 fps, 76 to 87 ms); 'Camera offline, retrying' within a second of the detector stopping. No alerts (nobody in view) in that run. Second run (40 s, person in view): red 'Person Immediate' row 0.5 s after start, matching the box on the video, 15.4 fps, 109 to 118 ms. Pass. Clearing not seen on the page (person stayed in view); detector log for the session has active and cleared person alerts. Note: start the detector in the foreground of the SSH session; started with nohup from SSH it did not serve.
- Evidence: `Report/evidence/2026-10-01_dashboard_page_live.png`, `Report/evidence/2026-10-01_dashboard_page_person.png`.

### B3. Dashboard live-only mode and Pi 4 finding, offscreen
- Method: `python DashboardIntegration/tests/test_live_data_provider.py` (copies the dashboard, applies the edits in `tests/dashboard_patches.py`, runs a fake bridge and fake beacons on the laptop).
- Pass: with `TUKZIE_LIVE_ONLY=1` and the bridge down, every page shows `--` or Unavailable and no simulated value, the simulation timer never runs; live when the fake bridge appears; back to no data (not simulation) when it stops; `soc_pct` None when the BMS has never reported; the resolver finds localhost, the override and a beacon host, ignores old or foreign beacons, and searches again after exactly 3 failed polls, with the camera page and ride card following.
- Result (3 Oct 2026, rerun 5 Oct 2026): all tests pass. Not yet tested on the Pi 5 with the real bridge.

### B4. Street-tile map, offscreen
- Method: `python DashboardIntegration/tests/test_tile_map.py` (fake tile server via `TUKZIE_TILE_URL`, temporary cache, fixes from the replay track through `build_live_state()`).
- Pass: zoom-17 tiles requested vehicle tile first, at most 2 at a time, with the SW-7 User-Agent, and cached; a cached tile under 30 days old not fetched again; heading-up with the vehicle at 70 % height; smooth marker movement and idle timer; "Waiting for GPS fix"; REPLAY badge; vector roads with the tile server down and no endless retries; touch and Overview.
- Result (4 Oct 2026, rerun 5 Oct 2026): all pass, also against the v1.1 copy per `DashboardIntegration/README.md`. Not yet run on the Pi 5.
- Evidence: `DashboardIntegration/tests/tile_map_follow.png`, `tile_map_no_fix.png`, `tile_map_replay.png`, `tile_map_offline.png`.

### B5. Dashboard map crash on the Pi 5 (diagnosis)
- Method and results: `DashboardIntegration/PI5_MAP_CRASH.md` (2 Oct 2026, over ssh, team installation unchanged).
- Result: segmentation fault about 2 s after the dashboard is shown with the web map (online or offline data); no crash with "Native fallback" after 30 s; the web engine alone works. Separate copy on the Pi 5 with the 13 edits of the time and the native map: no crash on the map page (2 Oct 2026). Screen blanked after 600 s without touch (X11 screensaver and DPMS); start script now disables both.
- Deploy (3 Oct 2026): `DashboardIntegration/deploy/deploy_dashboard.sh` rebuilt ~/Dashboard_sw7 on the Pi 5 from the team's installed v1.1 (the same code as their GitHub HEAD a94cfd2) and applied all edits (49 on 3 Oct, 50 with the tile map on 4 Oct), each anchor matching once; the team's ~/Dashboard unchanged. Their two auto-start entries (dashboard.desktop, tukzie_dashboard.desktop) moved to ~/.config/autostart.team-backup/ and replaced by sw7_dashboard.desktop, intended to make our build start at boot. Correction (5 Oct 2026): the Pi 5 desktop is labwc (Wayland), which ignores ~/.config/autostart entries and runs ~/.config/labwc/autostart, where the team's launcher was; that is why the team dashboard kept returning after restarts. The deploy now points ~/.config/labwc/autostart at start_sw7_dashboard.sh (team file kept as autostart.team-backup). Deployed 5 Oct (commit 228c34a, 51 edits): our dashboard on screen with the camera page live (person detected, 'Person, Immediate'), battery shown as '--%' (no BMS reading), Pi 5 beacon running. Reboot test to confirm. X11 screen blanking (600 s) disabled by our start script; Xbox controller poller off (TUKZIE_NO_CONTROLLER=1).
