0geder/Tukzie-HPEC-HUD/BenchTest/logs/run2_road_2026-10-27/analysis/tables/powertrain_ratios.tex

% generated by BenchTest/analysis; do not edit by hand
\begin{tabular}{lrrrrrrrrrrrrrrrrrrr}
\hline
pass & band\_hz & band\_energy & line\_energy & line\_share & lines\_hz & line\_halfwidth\_hz & E\_0.5-4 & share\_0.5-4 & E\_4-8 & share\_4-8 & E\_8-16 & share\_8-16 & E\_16-40 & share\_16-40 & E\_40-80 & share\_40-80 & line\_method & speed\_mps & speed\_source \\ \hline
R2 A v10 p1 & 0.5-80 & 3.53 & 0.083 & 0.0235 & 42.8; 49; 64 & 1; 1; 1 & 0.132 & 0.0376 & 2.28 & 0.647 & 0.303 & 0.0858 & 0.131 & 0.037 & 0.583 & 0.165 & fixed stand lines +-1 Hz (no orders, no wheel circumference; valid only near the stand wheel speed) & 2.47 & GNSS \\
R2 A v10 p2 & 0.5-80 & 3.9 & 0.122 & 0.0313 & 42.8; 49; 64 & 1; 1; 1 & 0.145 & 0.0371 & 2.52 & 0.646 & 0.348 & 0.0891 & 0.144 & 0.037 & 0.67 & 0.172 & fixed stand lines +-1 Hz (no orders, no wheel circumference; valid only near the stand wheel speed) & 2.83 & GNSS \\
R2 A v10 p3 & 0.5-80 & 3.22 & 0.0615 & 0.0191 & 42.8; 49; 64 & 1; 1; 1 & 0.122 & 0.0379 & 2.26 & 0.703 & 0.277 & 0.0862 & 0.137 & 0.0425 & 0.332 & 0.103 & fixed stand lines +-1 Hz (no orders, no wheel circumference; valid only near the stand wheel speed) & 2.71 & GNSS \\
R2 A coast v10 p4 & 0.5-80 & 3.65 & 0.0541 & 0.0148 & 42.8; 49; 64 & 1; 1; 1 & 0.123 & 0.0338 & 2.7 & 0.74 & 0.307 & 0.0841 & 0.136 & 0.0372 & 0.308 & 0.0842 & fixed stand lines +-1 Hz (no orders, no wheel circumference; valid only near the stand wheel speed) & 2.59 & GNSS \\
R2 A v10 p4 & 0.5-80 & 4.12 & 0.0878 & 0.0213 & 42.8; 49; 64 & 1; 1; 1 & 0.147 & 0.0356 & 2.9 & 0.704 & 0.234 & 0.0568 & 0.118 & 0.0286 & 0.651 & 0.158 & fixed stand lines +-1 Hz (no orders, no wheel circumference; valid only near the stand wheel speed) & 2.88 & GNSS \\
R2 A v15 p2 & 0.5-80 & 6.21 & 0.0956 & 0.0154 & 42.8; 49; 64 & 1; 1; 1 & 0.163 & 0.0262 & 4.48 & 0.721 & 0.609 & 0.0981 & 0.234 & 0.0377 & 0.595 & 0.0959 & fixed stand lines +-1 Hz (no orders, no wheel circumference; valid only near the stand wheel speed) & 3.48 & GNSS \\
R2 A v10 p5 & 0.5-80 & 3.83 & 0.069 & 0.018 & 42.8; 49; 64 & 1; 1; 1 & 0.132 & 0.0346 & 2.58 & 0.673 & 0.374 & 0.0977 & 0.122 & 0.0319 & 0.524 & 0.137 & fixed stand lines +-1 Hz (no orders, no wheel circumference; valid only near the stand wheel speed) & 3.06 & GNSS \\
R2 A v15 p3 & 0.5-80 & 6.55 & 0.0871 & 0.0133 & 42.8; 49; 64 & 1; 1; 1 & 0.194 & 0.0296 & 4.88 & 0.744 & 0.592 & 0.0904 & 0.183 & 0.0279 & 0.525 & 0.0802 & fixed stand lines +-1 Hz (no orders, no wheel circumference; valid only near the stand wheel speed) & 3.68 & GNSS \\
R2 A v20 p1 & 0.5-80 & 15.1 & 0.134 & 0.00885 & 42.8; 49; 64 & 1; 1; 1 & 0.39 & 0.0258 & 11.5 & 0.756 & 1.5 & 0.0993 & 0.649 & 0.0429 & 0.874 & 0.0578 & fixed stand lines +-1 Hz (no orders, no wheel circumference; valid only near the stand wheel speed) & 4.95 & GNSS \\
R2 A v10 p6 & 0.5-80 & 2.77 & 0.0669 & 0.0242 & 42.8; 49; 64 & 1; 1; 1 & 0.0964 & 0.0348 & 1.98 & 0.715 & 0.208 & 0.075 & 0.0867 & 0.0313 & 0.337 & 0.122 & fixed stand lines +-1 Hz (no orders, no wheel circumference; valid only near the stand wheel speed) & 2.31 & GNSS \\
R2 A v10 p7 & 0.5-80 & 10.4 & 0.163 & 0.0157 & 42.8; 49; 64 & 1; 1; 1 & 0.416 & 0.0401 & 7.63 & 0.735 & 0.732 & 0.0705 & 0.525 & 0.0506 & 0.882 & 0.085 & fixed stand lines +-1 Hz (no orders, no wheel circumference; valid only near the stand wheel speed) & 1.92 & GNSS \\
R2 A coast v10 p6 & 0.5-80 & 19.3 & 0.244 & 0.0126 & 42.8; 49; 64 & 1; 1; 1 & 0.705 & 0.0365 & 14.4 & 0.745 & 1.19 & 0.0615 & 1.35 & 0.0699 & 1.26 & 0.0654 & fixed stand lines +-1 Hz (no orders, no wheel circumference; valid only near the stand wheel speed) & 2.83 & GNSS \\
R2 A coast v10 p7 & 0.5-80 & 3.74 & 0.0165 & 0.00442 & 42.8; 49; 64 & 1; 1; 1 & 0.0919 & 0.0246 & 3.15 & 0.842 & 0.32 & 0.0856 & 0.0803 & 0.0215 & 0.0654 & 0.0175 & fixed stand lines +-1 Hz (no orders, no wheel circumference; valid only near the stand wheel speed) & 2.3 & GNSS \\
R2 A v10 p8 & 0.5-80 & 17.9 & 0.272 & 0.0152 & 42.8; 49; 64 & 1; 1; 1 & 0.735 & 0.0411 & 13.1 & 0.734 & 1.09 & 0.0609 & 1.15 & 0.0642 & 1.45 & 0.081 & fixed stand lines +-1 Hz (no orders, no wheel circumference; valid only near the stand wheel speed) & 2.51 & GNSS \\
R2 A v10 p9 & 0.5-80 & 21.8 & 0.228 & 0.0104 & 42.8; 49; 64 & 1; 1; 1 & 0.836 & 0.0383 & 16.5 & 0.758 & 1.49 & 0.0684 & 1.2 & 0.0548 & 1.37 & 0.0626 & fixed stand lines +-1 Hz (no orders, no wheel circumference; valid only near the stand wheel speed) & 2.65 & GNSS \\
R2 A v10 p10 & 0.5-80 & 10.2 & 0.235 & 0.023 & 42.8; 49; 64 & 1; 1; 1 & 0.521 & 0.051 & 6.62 & 0.648 & 0.902 & 0.0884 & 0.695 & 0.068 & 1.21 & 0.119 & fixed stand lines +-1 Hz (no orders, no wheel circumference; valid only near the stand wheel speed) & 1.98 & GNSS \\
\hline
\end{tabular}
