0geder/Tukzie-HPEC-HUD/BenchTest/sw7_console.html

# SW-7 bench console

ESP32 Connect Disconnect not connected

Camera Show camera off

Save session log Clear

## Front camera and hazard alerts no data

Camera off. Enter the Pi's address and press Show camera.

No alerts

Boxes on the image are drawn by the detector on the Pi. Alerts come from its /alerts feed every 0.5 s.

## Telemetry unit (ESP32-S3) firmware unknown

### Ride vibration

– m/s² std

Fused RMS– Disagreement– Sources–

### IMU acquisition

IMU1 rate– IMU2 rate– Max gap– Dropped– Scale factors–

### Battery (BMS)

Link– Pack– Current– State of charge–

### Position (GNSS)

Fix– Latitude– Longitude– Speed–

### Cellular (MQTT)

Session– Last event–

### Logging and system

Flash log– Free heap– Self-tests– Sync pulses–

## Vibration level (standard deviation of acceleration magnitude) last 2 minutes

IMU1 IMU2 Fused

## Sensor disagreement

|std1 − std2| / mean std

## Latest window per sensor

| RMS | std | p2p | crest | jerk | crossings
IMU1 | – | – | – | – | – | –
IMU2 | – | – | – | – | – | –
Fused | – | – | – | n/a | – | n/a

Units m/s² (jerk m/s³). Crest factor and crossings are not averaged across sensors.

## Time-of-flight (VL53L5CX, 8x8 zones) not connected

Waiting for the sensor. Once the firmware prints lines of the form [TOF] mm=d0,d1,...,d63 (64 distances, row by row) this grid fills in: red under 1 m, amber under 2 m.

## Air quality and microclimate (SEN55) not connected

PM1.0– PM2.5– PM4.0– PM10– Temperature– Humidity– VOC index– NOx index–

Waiting for the sensor. Expected line format: [ENV] pm1=.. pm2_5=.. pm4=.. pm10=.. t=.. rh=.. voc=.. nox=..

## Commands and serial output

!status !log off !log on !mqtt !recal Board flat and completely still? Yes, recalibrate Cancel
