0geder/Tukzie-HPEC-HUD/BenchTest/live_telemetry.html

# SW7 live telemetry (ESP32-S3 serial)

Not connected Connect Disconnect Clear

Fused RMS

–m/s²

Fused vibration (std)

–m/s²

Sensor disagreement

–

Fusion sources

–

IMU1 rate

–Hz

IMU2 rate

–Hz

Dropped samples

–

GNSS

–

Battery (BMS)

–

Free heap

–KB

Boot self-tests

–

Lines received

0

## Vibration level (standard deviation of acceleration magnitude), last 2 minutes

IMU1 IMU2 Fused

## Sensor disagreement, last 2 minutes

|std1 − std2| / mean std

## Latest window per sensor

| RMS | std | p2p | crest | jerk | crossings
IMU1 | – | – | – | – | – | –
IMU2 | – | – | – | – | – | –
Fused | – | – | – | n/a | – | n/a

Units: m/s² (jerk in m/s³). Crest factor and crossings are not averaged across sensors.

## Raw serial output
