0geder/Tukzie-HPEC-HUD/Planning/SW7-VIT-001 Rev E - Vehicle Integration and Test Plan.docx

VEHICLE INTEGRATION & TEST PLAN

SW-7 · Embedded HPEC Telemetry Unit and Windshield HUD · Tukzie Rev 0

FIELD | DETAIL | FIELD | DETAIL
Document ref | SW7-VIT-001 Rev E | Facility | Controls Laboratory
Supersedes | Rev D | Lab custodian | Y. Vawda
Prepared by | S. Okuthe · OKTSAM001 | Supervisors | S. Winberg · S. Jayalath
Issued | 04 September 2026 | Asset | Jinpeng e-tricycle, 72 V

This plan sets out the vehicle-access sessions required to integrate and validate the SW-7 telemetry unit on the Tukzie. Each session states the specific vehicle subsystem being handled, the electrical risk class, the supervision or assistance required, and the equipment requested in advance. Session times are scheduled to avoid the custodian's committed periods.

# 1. Summary for the lab custodian

- Ten laboratory sessions across three weeks, weighted to mornings.
- Eight sessions are non-powered or 12 V only — mechanical fit-up, sensor commissioning, signal probing and bench instrumentation.
- Two sessions energise the 72 V traction system with the drive wheel raised (D6, D8). These are the only sessions requiring a second person.
- Two joint sessions with the wider Tukzie team, both in Week 2.
- The vehicle is already raised on stands, so no lifting is requested and no repositioning is assumed.
- Road testing cannot be done in the Controls Lab and is not requested here — see section 2.

# 2. Phase A and Phase B

With the trike permanently raised, the programme divides into work achievable on a stationary vehicle (Phase A, sessions D1–D10, requested here) and work requiring the vehicle on the ground (Phase B, not a laboratory request).

ACHIEVABLE WITH THE VEHICLE RAISED — PHASE A | REQUIRES THE VEHICLE ON THE GROUND — PHASE B
Mechanical integration; camera mounting; sensor commissioning and calibration; acquisition-timing measurement; Raspberry Pi to ESP32 synchronisation; harness signal capture; Hall tap and pole-pair count; stationary powertrain vibration baseline; BMS verification; GNSS and LTE static tests; HUD geometry and legibility; endurance soak. | Repeatability across repeated traversals; speed dependence; surface discrimination; sensor-placement comparison under road excitation; coast-down powertrain separation; payload comparison; all forward road video.

Phase B is being taken to the project supervisors separately, with the relevant ethics and safety documentation. It is noted here only so that laboratory and road work are not confused. No approval for Phase B is sought from the laboratory.

# 3. Custodian availability observed

DAY | NOT AVAILABLE — PRAYER | NOT AVAILABLE — LAB COMMITMENTS | SESSION WINDOWS USED
Monday | 12:00–14:00 | — | 08:30–12:00 · 14:00–16:30
Tuesday | 12:00–14:00 | 11:00–12:00 · 14:00–16:00 | 08:30–11:00
Wednesday | 12:00–14:00 | 14:00–16:30; 15:00–17:00 Tukzie vac team | 08:30–12:00
Thursday | 12:00–14:00 | 14:00–16:00 | 08:30–12:00
Friday | 12:30–14:00 — Jumu'ah | — | 08:30–12:00 · 14:00–16:30

Friday morning sessions close at 12:00 rather than 12:30, so there is a clear half hour before Jumu'ah.

# 4. Supervision key

MARKER | MEANING | EXAMPLES
U — Unsupervised | Bench or measurement work I complete alone once the vehicle is accessible. No attendance needed. | Windscreen and mounting-point measurement, IMU bench calibration, photography, cable preparation.
C — Custodian aware | I do the work myself, but you should know it is happening and be reachable. | First connection to the 12 V rail, probing harness taps, first powered boot, confirming stand stability.
A — Assistance required | I cannot or should not do this alone for safety reasons. | Any activity with the 72 V traction system energised.

### Assistance summary — the only times a second person is needed

- D6, Thursday morning — 72 V energised for a brief Hall-signal confirmation run.
- D8, Monday, full day — 72 V energised powertrain run at each drive mode.

Two occasions, both for the same reason: I will not run the traction system without a second person present. Neither involves lifting, since the vehicle is already on stands. Melo and Sharaav are working on the related Tukzie projects (JBM11 and SW-6) and we intend to cover each other on these, so no technician is requested unless you would prefer one present.

# 5. Session schedule

REF | DATE | TIME | FOCUS | RISK | ASSIST
D1 | Wed 02 Sep | 08:30–12:00 | Survey, mounting points, bracket fabrication | No power | —
— | Thu 03 Sep | Excluded | Project presentation — no access requested | — | —
D2 | Fri 04 Sep | 08:30–12:00, 14:00–16:30 | Mechanical fit-up, camera mount, cable routing | No power | —
D3 | Mon 07 Sep | 08:30–12:00, 14:00–16:30 | 12 V commissioning, harness signal capture | ≤12 V | —
D4 | Tue 08 Sep | 08:30–11:00 | Sensor commissioning, calibration, Pi–ESP32 time sync | No power | —
D5 | Wed 09 Sep | 08:30–12:00 | Joint session I — telemetry interface, Pi integration | 12 V | Team
D6 | Thu 10 Sep | 08:30–12:00 | Motor Hall tap, pole-pair determination | 72 V | Yes
D7 | Fri 11 Sep | 08:30–12:00, 14:00–16:30 | Joint session II — integration, GNSS and LTE static | 12 V | Team
D8 | Mon 14 Sep | 08:30–12:00, 14:00–16:30 | Stationary powertrain baseline, BMS verification | 72 V | Yes
D9 | Wed 16 Sep | 08:30–12:00 | HUD optical bench trial at the windscreen | No power | —
D10 | Fri 18 Sep | 08:30–12:00, 14:00–16:30 | Endurance soak, contingency, handback | 12 V | Handback

# 6. Session detail

## D1 · Wednesday 02 September · 08:30–12:00

Survey and measurement

Activities

- [C] Confirm vehicle sign-out procedure and agree the working area
- [U] Measure and photograph the handlebar stem and rear chassis rail mounting points
- [U] Measure the windscreen — dimensions, rake angle, driver eye position
- [U] Locate the dashboard node enclosure and the 12 V rail termination
- [U] Establish and document the sensor axis convention
- [U] Fabricate IMU brackets at the bench to the measured dimensions

Equipment requested

- Tape measure, vernier calipers
- Digital angle gauge
- Inspection torch
- Bench vice, files, deburring tool
- Hacksaw or bench shear for bracket stock

Assistance: None

Output: Dimensioned survey, windscreen geometry record, axis-convention sketch, brackets fabricated. No tools applied to the vehicle.

## D2 · Friday 04 September · 08:30–12:00 and 14:00–16:30

Mechanical fit-up

Activities

- [U] Fit both IMU brackets to the stem and rear chassis positions
- [U] Mount the ESP32 telemetry enclosure in the dashboard node area
- [U] Dry-fit the Raspberry Pi and display bracket
- [U] Fit the forward-facing camera mount and set its aim, clear of the driver's view
- [U] Route and secure cable looms clear of the steering arc and drive train
- [U] Verify no fouling through full steering lock, both directions
- [U] Confirm loom routing will still clear the wheel once the vehicle is eventually lowered

Equipment requested

- Metric hex and Torx driver sets
- Torque driver, 1–6 N·m
- M4/M5 fasteners, washers, Nyloc nuts
- Cable ties, spiral wrap, P-clips
- VHB mounting tape
- Creeper or mat for rear access with the vehicle raised

Assistance: None — the vehicle stays where it is

Output: Both IMU mounts and the camera mount installed and photographed; enclosure located; loom routing fixed and clearance verified. Morning session ends 12:00.

## D3 · Monday 07 September · 08:30–12:00 and 14:00–16:30

Auxiliary power commissioning and harness signal capture

Activities

- [U] Prepare and crimp the fused 12 V feed at the bench
- [C] First connection to the existing 12 V dashboard-node rail
- [C] First powered boot of the telemetry unit on vehicle supply
- [U] Measure quiescent and peak current draw; confirm rail stability under load
- [C] Probe and capture oscilloscope traces of the documented taps: throttle AX1/AX2, brake, drive/reverse AY2, and the H/M/L mode lines AZ1/AZ3
- [U] Ignition on, drive disabled, vehicle stationary. No connection to the 72 V pack

Equipment requested

- Bench PSU, 0–30 V, 3 A, current-limited
- Digital multimeter
- DC clamp meter
- 2-channel digital storage oscilloscope with probes
- Insulated probe hooks, breakout leads
- Inline fuse holders, 2 A and 5 A fuses
- Crimp tool with JST and Dupont crimps
- ESD mat and wrist strap

Assistance: None

Output: Commissioned fused 12 V feed with a measured current budget; oscilloscope traces for every harness signal. These traces are absent from the existing handover documentation.

## D4 · Tuesday 08 September · 08:30–11:00

Sensor commissioning, calibration and time synchronisation

Activities

- [U] Bring both IMUs online and confirm addressing across the two I²C buses
- [U] Six-position static calibration against a flat reference at the bench
- [U] Re-verify orientation in situ on the vehicle
- [U] Capture the GPIO sample-tick to confirm acquisition timing
- [U] Prove the ESP32-to-Pi synchronisation pulse; measure clock offset and drift
- [U] Verify the camera capture path — frame rate, per-frame timestamps, storage throughput
- [U] Record the first synchronised inertial and video dataset, vehicle stationary

Equipment requested

- Logic analyser, or a spare scope channel
- Precision spirit level, machinist square
- Known-flat reference surface
- ESD mat
- Monitor with HDMI input for the Pi

Assistance: None

Output: Calibration table with pre- and post-correction error; sampling-jitter capture; measured clock offset and drift; first synchronised dataset.

## D5 · Wednesday 09 September · 08:30–12:00

Joint session I — telemetry interface and Raspberry Pi integration

Activities

- [C] Joint working session with the wider Tukzie team at the vehicle
- [U] Align the telemetry data contract with the dashboard application
- [U] Commission the physical link between the ESP32 unit and the Raspberry Pi
- [U] Verify inertial fields reach the dashboard correctly
- [C] Confirm no contention on shared supply rails with the existing nodes

Equipment requested

- Bench space for 3–4 people at the vehicle
- Additional 230 V outlets, extension leads
- Monitor with HDMI input
- Network switch or shared hotspot

Assistance: None from the laboratory — my team provides the people

Output: Verified end-to-end telemetry path; interface definition agreed and signed off by both parties.

## D6 · Thursday 10 September · 08:30–12:00

Motor Hall-sensor tap and pole-pair determination — 72 V ENERGISED

Activities

- [C] Confirm the existing stands are correctly rated and stable, and the remaining wheels chocked, before anything else
- [U] Tap the motor Hall-sensor cable with the controller de-energised
- [U] Determine pole-pair count by rotating the wheel by hand and counting electrical cycles
- [A] Brief low-throttle confirmation run to verify Hall frequency against wheel speed
- [U] Analyse captures at the bench once de-energised

Equipment requested

- Confirm existing stands are rated for vehicle mass
- Wheel chocks, if not already fitted
- Means of isolating or locking out the pack
- 2-channel oscilloscope, insulated probes
- Tachometer or optical marker
- IR thermometer

Assistance: Second person required for the energised run

Output: Pole-pair count; validated Hall-frequency to road-speed conversion. No locked-rotor condition will be created at any point.

## D7 · Friday 11 September · 08:30–12:00 and 14:00–16:30

Joint session II — full-system integration, GNSS and cellular

Activities

- [C] Bring all subsystems online together with the team
- [U] Mount LTE and GNSS antennas in their intended vehicle positions
- [U] Measure time-to-first-fix from cold and warm start
- [U] Run the GNSS antenna out on an extension to open sky — the vehicle cannot be moved while raised
- [U] Log stationary position scatter over an extended period
- [U] Stream live telemetry and record uplink latency and packet loss
- [U] Induce a network outage and verify store-and-forward recovery

Equipment requested

- Antenna extension lead — now essential, since the vehicle cannot be repositioned
- Roller-door or window access for antenna placement
- Bench space for the team, 230 V outlets
- Monitor with HDMI input

Assistance: None — the vehicle stays where it is

Output: Time-to-first-fix, position scatter, uplink latency and packet loss, outage recovery record, integration photographs. Morning session ends 12:00.

## D8 · Monday 14 September · 08:30–12:00 and 14:00–16:30

Stationary powertrain vibration baseline and BMS verification — 72 V ENERGISED

Activities

- [C] Confirm stand rating and stability; chock; set an exclusion barrier
- [A] Run the motor at low, medium and high modes, approximately 60 s per mode
- [A] Log inertial and current data simultaneously; monitor case temperature throughout
- [A] Read the battery-management system wirelessly and verify decoded pack voltage against a direct meter reading
- [U] De-energise, then analyse spectra at the bench

Equipment requested

- Axle stands and wheel chocks — confirm rating
- Exclusion barrier or cones
- AC/DC current clamp probe rated above 40 A
- Oscilloscope
- Multimeter with CAT III 600 V rated leads
- Insulated gloves
- IR thermometer
- Fire extinguisher suitable for lithium batteries

Assistance: Second person required for the full session

Output: Power spectral density per drive mode; motor thermal record; validated BMS decode with voltage cross-check. Highest-risk session of the programme. No modification to the pack or BMS.

## D9 · Wednesday 16 September · 08:30–12:00

HUD optical bench trial at the windscreen

Activities

- [U] Mount the HUD combiner and projection unit at the windscreen — removable fixing only, no drilling
- [U] Measure eye-box geometry and projection distance from the driver position
- [U] Assess legibility under varied ambient illumination
- [U] Capture end-to-end display latency
- [U] Remove the assembly and confirm the windscreen is unmarked

Equipment requested

- Digital luxmeter
- Adjustable work light
- Blackout cloth
- Camera tripod
- Tape measure, digital angle gauge

Assistance: None

Output: Eye-box map; luminance and legibility measurements; display latency figure.

## D10 · Friday 18 September · 08:30–12:00 and 14:00–16:30

Endurance soak, contingency and vehicle handback

Activities

- [U] Continuous soak run to confirm thermal and memory stability
- [U] Second induced outage to re-verify store-and-forward
- [U] Contingency slot for any earlier session that overran
- [C] Return the vehicle to standard configuration and confirm handback with you

Equipment requested

- 230 V outlet for extended logging
- Lockable storage for the prototype

Assistance: Brief attendance for handback only

Output: Soak-test log; outage recovery record; vehicle confirmed returned to standard configuration. Morning session ends 12:00.

# 7. Safety and vehicle-condition undertakings

### 72 V traction system — sessions D6 and D8 only

The pack is nominally 72 V and the motor controller is rated to 90 A. For both sessions in which the traction system is energised I undertake to: confirm before starting that the existing stands are correctly rated and stable and the remaining wheels chocked; keep a second person present for the full duration; isolate and wait before making or breaking any connection; and use only insulated, appropriately rated probes. Locked-rotor conditions will not be created at any point.

The vehicle is already raised. I will not assume the existing arrangement is adequate for a powered run without checking it first, and I will not adjust or remove the stands myself.

### Vehicle condition

- All mounting is removable. No drilling, cutting or permanent modification of any vehicle structure, windscreen included.
- All harness connections are made at existing documented tap points. No wiring is cut or re-terminated.
- The vehicle can be returned to standard configuration within approximately 20 minutes at any time if needed by others.
- The vehicle is left in its original state at the end of every session unless otherwise agreed.

# 8. Equipment and standing requests

EQUIPMENT I SUPPLY | STANDING REQUESTS
ESP32-S3 telemetry unit, LTE and GNSS antennas; two IMU modules and mounting brackets; laptop, programming leads and logging storage; forward-facing camera and mount; prototype HUD combiner and projection assembly; consumable wiring, connectors and heat-shrink. | Bench space adjacent to the vehicle for the three-week period; lockable storage for the prototype between sessions; confirmation of the vehicle sign-out procedure; notice of any period when the vehicle is committed elsewhere; confirmation of who assists on D6 and D8.

# 9. Confirmations requested

1. The correct sign-out procedure for the vehicle.
2. Whether the equipment listed against each session can be made available.
3. Whether the proposed session times suit you, and whether a single shared booking calendar would work better — the three of us would rather coordinate through one than email separately.
4. Who assists on D6 and D8, or whether I should arrange a colleague from the Tukzie team.

# 10. Approvals

Sessions D1–D10 (Phase A) are requested under normal laboratory access and can all be completed with the vehicle raised. Phase B is not a laboratory request — it requires the vehicle on the ground and is being taken to the project supervisors separately, with the relevant ethics and safety documentation.

STUDENT | LAB CUSTODIAN | SUPERVISOR — PHASE B ONLY
Name: Signature: Date: | Name: Signature: Date: | Name: Signature: Date:
