0geder/Tukzie-HPEC-HUD/CameraDetection/training/runs/run2_sa_band_tiles_640/results.csv

epoch | time | train/box_loss | train/cls_loss | train/dfl_loss | metrics/precision(B) | metrics/recall(B) | metrics/mAP50(B) | metrics/mAP50-95(B) | val/box_loss | val/cls_loss | val/dfl_loss | lr/pg0 | lr/pg1 | lr/pg2
1 | 140.373 | 2.69074 | 4.36016 | 1.76145 | 0.54338 | 0.44016 | 0.4633 | 0.19384 | 2.12915 | 2.27381 | 1.38739 | 0.000663043 | 0.000663043 | 0.000663043
2 | 264.943 | 2.15473 | 1.91686 | 1.36936 | 0.50062 | 0.33959 | 0.33909 | 0.12652 | 2.28279 | 2.91308 | 1.51376 | 0.00130777 | 0.00130777 | 0.00130777
3 | 386.419 | 2.16024 | 1.86079 | 1.37539 | 0.35162 | 0.2211 | 0.19219 | 0.06666 | 2.40589 | 3.9554 | 1.56958 | 0.0019305 | 0.0019305 | 0.0019305
4 | 506.425 | 2.16408 | 1.89528 | 1.38888 | 0.62633 | 0.48619 | 0.51527 | 0.20532 | 2.05469 | 2.62508 | 1.35746 | 0.001901 | 0.001901 | 0.001901
5 | 626.989 | 2.11576 | 1.78781 | 1.35028 | 0.57788 | 0.44219 | 0.47371 | 0.20326 | 1.92927 | 1.91471 | 1.29777 | 0.001868 | 0.001868 | 0.001868
6 | 748.006 | 2.06439 | 1.73128 | 1.32978 | 0.53099 | 0.41785 | 0.4248 | 0.19651 | 2.01856 | 2.27444 | 1.31698 | 0.001835 | 0.001835 | 0.001835
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
