0geder/Tukzie-HPEC-HUD/BenchTest/logs/2026-09-30_c4_latency/run1_4t.csv

frame | sensor_ns | queue_ms | pre_ms | infer_ms | post_ms | total_ms
1 | 17658105115000 | 22.29 | 16.16 | 38.18 | 0.17 | 76.81
2 | 17658154297000 | 30.45 | 14.60 | 36.50 | 0.23 | 81.78
3 | 17658203341000 | 35.08 | 12.15 | 37.34 | 0.21 | 84.77
4 | 17658252846000 | 37.58 | 11.69 | 36.09 | 0.15 | 85.52
5 | 17658302312000 | 38.00 | 11.68 | 36.22 | 0.16 | 86.06
6 | 17658351773000 | 38.53 | 11.90 | 36.22 | 0.15 | 86.80
7 | 17658401237000 | 39.66 | 13.41 | 36.44 | 0.15 | 89.65
8 | 17658450705000 | 42.14 | 11.66 | 36.00 | 0.15 | 89.95
9 | 17658500168000 | 42.41 | 11.92 | 35.88 | 0.15 | 90.36
10 | 17658549633000 | 43.18 | 13.42 | 36.39 | 0.15 | 93.14
11 | 17658599100000 | 45.60 | 11.67 | 36.16 | 0.15 | 93.58
12 | 17658648560000 | 46.00 | 11.90 | 36.10 | 0.15 | 94.15
13 | 17658698026000 | 46.94 | 13.38 | 36.37 | 0.15 | 96.84
14 | 17658747493000 | 49.35 | 11.76 | 36.47 | 0.15 | 97.74
15 | 17658796955000 | 50.19 | 11.89 | 36.38 | 0.15 | 98.62
16 | 17658846422000 | 51.46 | 13.47 | 39.12 | 0.16 | 104.21
17 | 17658895889000 | 56.82 | 11.87 | 35.88 | 0.15 | 104.71
18 | 17658945351000 | 57.17 | 12.33 | 35.46 | 0.15 | 105.11
19 | 17658994817000 | 57.95 | 13.53 | 35.36 | 0.15 | 107.00
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
