0geder/Tukzie-HPEC-HUD/BenchTest/logs/2026-09-30_c4_latency/run2_4t_preview.csv

frame | sensor_ns | queue_ms | pre_ms | infer_ms | post_ms | total_ms
1 | 17719373434000 | 22.14 | 16.27 | 38.61 | 0.18 | 77.19
2 | 17719422137000 | 33.22 | 23.03 | 46.42 | 0.13 | 102.80
3 | 17719470203000 | 58.17 | 15.61 | 49.45 | 0.12 | 123.35
4 | 17719518749000 | 85.51 | 14.41 | 36.36 | 0.16 | 136.44
5 | 17719616217000 | 48.23 | 11.76 | 36.81 | 0.16 | 96.96
6 | 17719664950000 | 57.91 | 13.88 | 35.40 | 0.15 | 107.35
7 | 17719713688000 | 68.62 | 14.47 | 35.78 | 0.17 | 119.05
8 | 17719762422000 | 80.04 | 12.15 | 36.63 | 0.16 | 128.98
9 | 17719859893000 | 41.26 | 13.50 | 37.80 | 0.15 | 92.71
10 | 17719908626000 | 54.61 | 12.32 | 36.14 | 0.15 | 103.22
11 | 17719957360000 | 63.78 | 11.90 | 35.63 | 0.15 | 111.45
12 | 17720006096000 | 71.98 | 11.83 | 36.37 | 0.12 | 120.30
13 | 17720103565000 | 31.86 | 11.79 | 36.17 | 0.15 | 79.98
14 | 17720152299000 | 40.42 | 11.75 | 36.33 | 0.15 | 88.65
15 | 17720201033000 | 48.96 | 11.74 | 36.61 | 0.16 | 97.46
16 | 17720249767000 | 58.38 | 11.70 | 36.32 | 0.15 | 106.55
17 | 17720298502000 | 66.88 | 11.77 | 35.48 | 0.15 | 114.28
18 | 17720347245000 | 75.55 | 11.82 | 36.10 | 0.15 | 123.63
19 | 17720444706000 | 35.29 | 11.80 | 36.58 | 0.15 | 83.82
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
