0geder/Tukzie-HPEC-HUD/BenchTest/logs/2026-09-30_c4_latency/run3_1t.csv

frame | sensor_ns | queue_ms | pre_ms | infer_ms | post_ms | total_ms
1 | 17780678909000 | 22.39 | 16.29 | 127.40 | 0.15 | 166.23
2 | 17780823273000 | 24.57 | 14.65 | 125.94 | 0.19 | 165.36
3 | 17780920678000 | 70.47 | 12.15 | 126.47 | 0.16 | 209.25
4 | 17781066785000 | 65.11 | 11.50 | 126.10 | 0.15 | 202.86
5 | 17781212896000 | 58.67 | 12.11 | 129.96 | 0.16 | 200.89
6 | 17781359002000 | 57.15 | 11.98 | 125.54 | 0.15 | 194.83
7 | 17781505113000 | 50.96 | 13.52 | 125.55 | 0.15 | 190.18
8 | 17781651220000 | 46.00 | 11.70 | 125.52 | 0.15 | 183.37
9 | 17781797329000 | 39.21 | 11.95 | 125.94 | 0.15 | 177.25
10 | 17781943439000 | 33.40 | 13.49 | 150.29 | 0.17 | 197.35
11 | 17782089547000 | 53.54 | 16.63 | 128.00 | 0.15 | 198.31
12 | 17782235655000 | 54.17 | 12.10 | 125.50 | 0.15 | 191.92
13 | 17782381764000 | 48.11 | 13.42 | 125.57 | 0.15 | 187.25
14 | 17782527874000 | 43.04 | 11.85 | 125.64 | 0.15 | 180.68
15 | 17782673982000 | 36.45 | 11.95 | 125.58 | 0.21 | 174.19
16 | 17782820091000 | 30.27 | 13.45 | 125.79 | 0.15 | 169.66
17 | 17782966199000 | 25.46 | 11.80 | 125.59 | 0.14 | 163.00
18 | 17783063606000 | 67.71 | 12.00 | 125.62 | 0.15 | 205.48
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
