0geder/Tukzie-HPEC-HUD/BenchTest/logs/2026-09-30_sync_edges_run1_noisy.csv

n | edge | t_mono_ns | t_wall_s | interval_ms
1 | fall | 15326156720271 | 1790730786.079838
2 | rise | 15326657115114 | 1790730786.580240 | 500.395
3 | fall | 15327156833799 | 1790730787.080091 | 499.719
4 | rise | 15327657176490 | 1790730787.580358 | 500.343
5 | fall | 15328156946996 | 1790730788.080195 | 499.771
6 | rise | 15328657327397 | 1790730788.580543 | 500.380
7 | fall | 15329157109960 | 1790730789.080343 | 499.783
8 | rise | 15329657417299 | 1790730789.580629 | 500.307
9 | fall | 15330157173893 | 1790730790.080409 | 499.757
10 | rise | 15330657604154 | 1790730790.580738 | 500.430
