0geder/Tukzie-HPEC-HUD/BenchTest/logs/2026-09-30_sync_edges_run2.csv

n | edge | t_mono_ns | t_wall_s | interval_ms
1 | rise | 15255648598427 | 1790730715.571686
2 | fall | 15256148388427 | 1790730716.071526 | 499.790
3 | rise | 15256648658498 | 1790730716.571759 | 500.270
4 | fall | 15257148514041 | 1790730717.071635 | 499.856
5 | rise | 15257648804159 | 1790730717.571933 | 500.290
6 | fall | 15258148622042 | 1790730718.071750 | 499.818
7 | rise | 15258648899017 | 1790730718.571965 | 500.277
8 | fall | 15259148748007 | 1790730719.071868 | 499.849
9 | rise | 15259649060344 | 1790730719.572143 | 500.312
10 | fall | 15260148879466 | 1790730720.072124 | 499.819
11 | rise | 15260649148102 | 1790730720.572356 | 500.269
12 | fall | 15261149008179 | 1790730721.072248 | 499.860
13 | rise | 15261649295898 | 1790730721.572501 | 500.288
14 | fall | 15262149133201 | 1790730722.072364 | 499.837
15 | rise | 15262649447430 | 1790730722.572636 | 500.314
16 | fall | 15263149205399 | 1790730723.072436 | 499.758
17 | rise | 15263649610572 | 1790730723.572770 | 500.405
18 | fall | 15264149403690 | 1790730724.072649 | 499.793
19 | rise | 15264649727288 | 1790730724.572917 | 500.324
20 | fall | 15265149774133 | 1790730725.072994 | 500.047
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
