0geder/Tukzie-HPEC-HUD/BenchTest/logs/2026-10-01_tof_cover_test.csv

t_mono_s | left_mm | ahead_mm | right_mm
1434.433 | 31 |  | 591
1434.465 | 28 |  | 582
1434.497 | 31 |  | 590
1434.530 | 33 |  | 596
1434.562 | 30 |  | 588
1434.595 | 30 |  | 593
1434.627 | 33 |  | 589
1434.660 | 30 |  | 590
1434.692 | 29 |  | 580
1434.724 | 30 |  | 589
1434.756 | 31 |  | 587
1434.789 | 33 |  | 587
1434.821 | 31 |  | 588
1434.853 | 32 |  | 591
1434.886 | 30 |  | 588
1434.918 | 32 |  | 590
1434.951 | 31 |  | 580
1434.983 | 30 |  | 583
1435.015 | 31 |  | 585
1435.047 | 32 |  | 589
1435.080 | 35 |  | 593
1435.112 | 31 |  | 583
1435.145 | 28 |  | 586
1435.177 | 33 |  | 587
1435.209 | 29 |  | 586
1435.241 | 32 |  | 589
1435.274 | 31 |  | 587
1435.306 | 30 |  | 586
1435.339 | 32 |  | 592
1435.371 | 33 |  | 589
1435.403 | 30 |  | 590
1435.436 | 32 |  | 584
1435.468 | 32 |  | 589
1435.501 | 33 |  | 589
1435.533 | 33 |  | 586
1435.565 | 32 |  | 588
1435.597 | 32 |  | 590
1435.630 | 34 |  | 585
1435.662 | 34 |  | 590
1435.694 | 31 |  | 589
1435.727 | 35 |  | 585
1435.759 | 32 |  | 586
1435.792 | 34 |  | 586
1435.824 | 33 |  | 594
1435.856 | 35 |  | 589
1435.889 | 34 |  | 596
1435.921 | 33 |  | 586
1435.953 | 31 |  | 585
1435.986 | 31 |  | 592
1436.018 | 34 |  | 579
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
