0geder/Tukzie-HPEC-HUD/CameraDetection/training/runs/run1_gerapothole_640/results.csv

epoch | time | train/box_loss | train/cls_loss | train/dfl_loss | metrics/precision(B) | metrics/recall(B) | metrics/mAP50(B) | metrics/mAP50-95(B) | val/box_loss | val/cls_loss | val/dfl_loss | lr/pg0 | lr/pg1 | lr/pg2
1 | 28.7133 | 1.95516 | 2.6672 | 1.96324 | 0.00911 | 0.66667 | 0.03663 | 0.01098 | 2.2495 | 3.38707 | 2.69384 | 0.000649573 | 0.000649573 | 0.000649573
2 | 45.4431 | 1.83211 | 2.08795 | 1.85278 | 0.14884 | 0.12195 | 0.07525 | 0.02113 | 2.26822 | 3.04112 | 2.48326 | 0.00129452 | 0.00129452 | 0.00129452
3 | 65.9312 | 1.79353 | 1.93354 | 1.84414 | 0.27074 | 0.19512 | 0.14231 | 0.03945 | 2.52697 | 2.79687 | 2.70046 | 0.00191747 | 0.00191747 | 0.00191747
4 | 86.1549 | 1.80856 | 1.9093 | 1.89218 | 0.05097 | 0.10366 | 0.02128 | 0.0048 | 3.18222 | 3.37109 | 3.44051 | 0.001901 | 0.001901 | 0.001901
5 | 104.354 | 1.8186 | 1.8405 | 1.86699 | 0.30353 | 0.28788 | 0.19972 | 0.05522 | 2.4841 | 3.11314 | 2.63844 | 0.001868 | 0.001868 | 0.001868
6 | 122.893 | 1.82046 | 1.80991 | 1.85063 | 0.47171 | 0.35569 | 0.33887 | 0.10286 | 2.46369 | 2.58659 | 2.56727 | 0.001835 | 0.001835 | 0.001835
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
