0geder/Tukzie-HPEC-HUD/BenchTest/logs/calibration/20261019_120755_front_trike_10ft.jpg

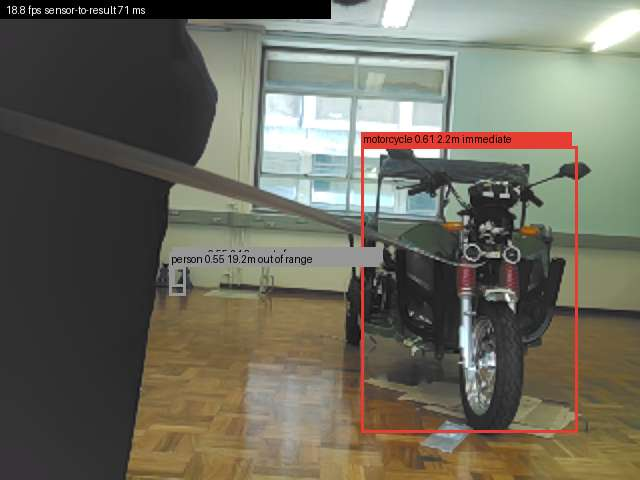
BenchTest/logs/calibration/20261019_120755_front_trike_10ft.jpg
