0geder/Tukzie-HPEC-HUD/BenchTest/logs/calibration/20261019_124143_person_2m.jpg

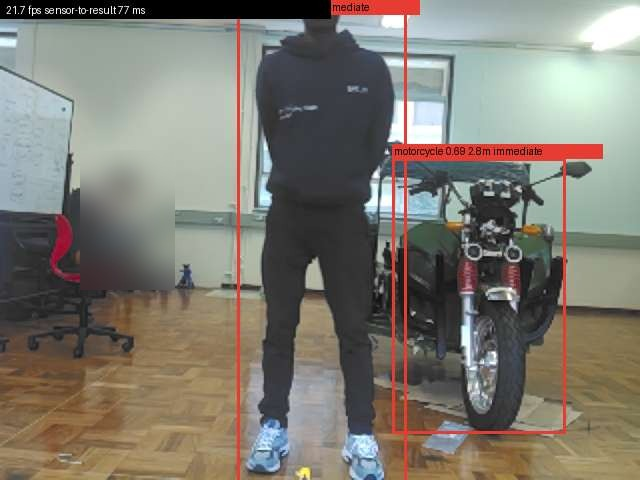
BenchTest/logs/calibration/20261019_124143_person_2m.jpg
