0geder/Tukzie-HPEC-HUD/BenchTest/logs/calibration/20261019_124331_person_3m.jpg

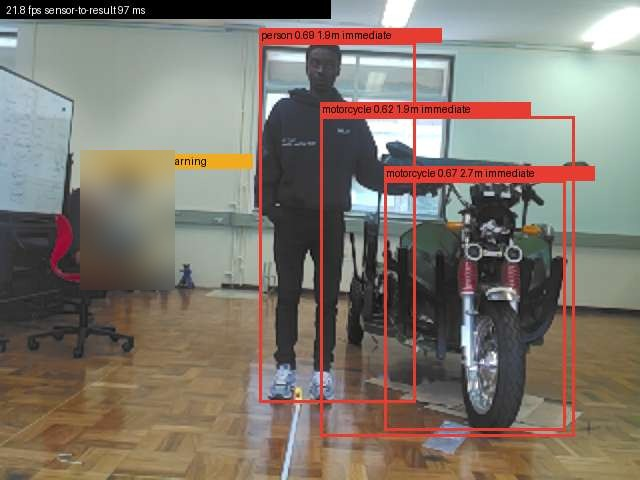
BenchTest/logs/calibration/20261019_124331_person_3m.jpg
