0geder/Tukzie-HPEC-HUD/BenchTest/logs/calibration/20261019_markers_1m_2m_3m.jpg

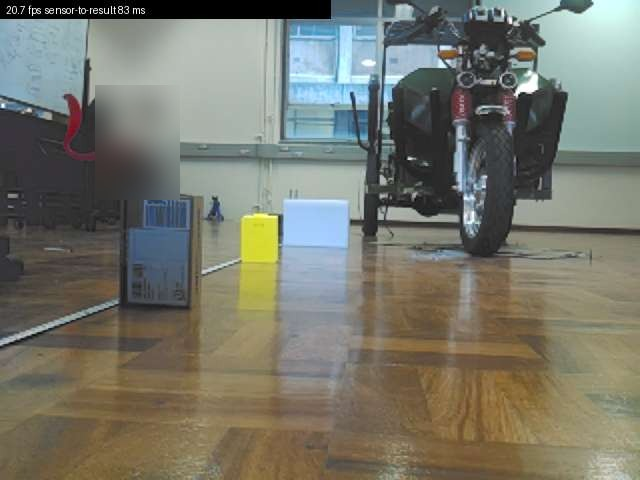
BenchTest/logs/calibration/20261019_markers_1m_2m_3m.jpg
