0geder/Tukzie-HPEC-HUD/BenchTest/logs/calibration/20261026_173928_person_2.2m.jpg

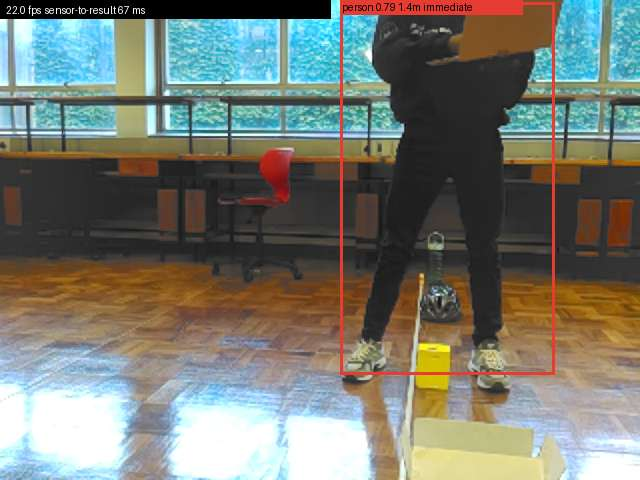
BenchTest/logs/calibration/20261026_173928_person_2.2m.jpg
