0geder/Tukzie-HPEC-HUD/BenchTest/logs/calibration/20261026_174028_person_3.2m.jpg

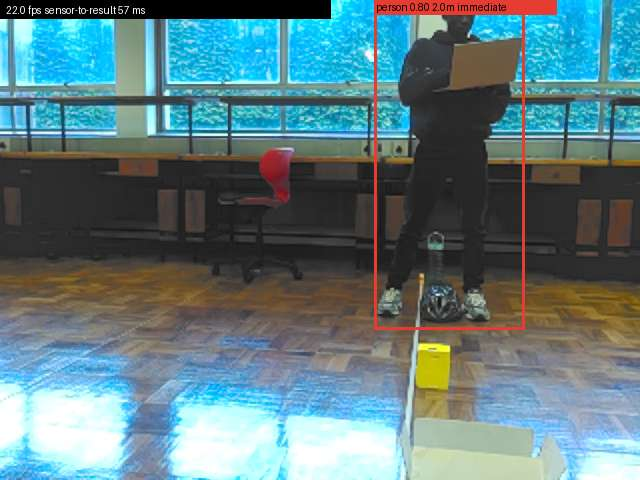
BenchTest/logs/calibration/20261026_174028_person_3.2m.jpg
