0geder/Tukzie-HPEC-HUD/BenchTest/logs/legibility_2026-10-24/page_00_DrivingPage.png

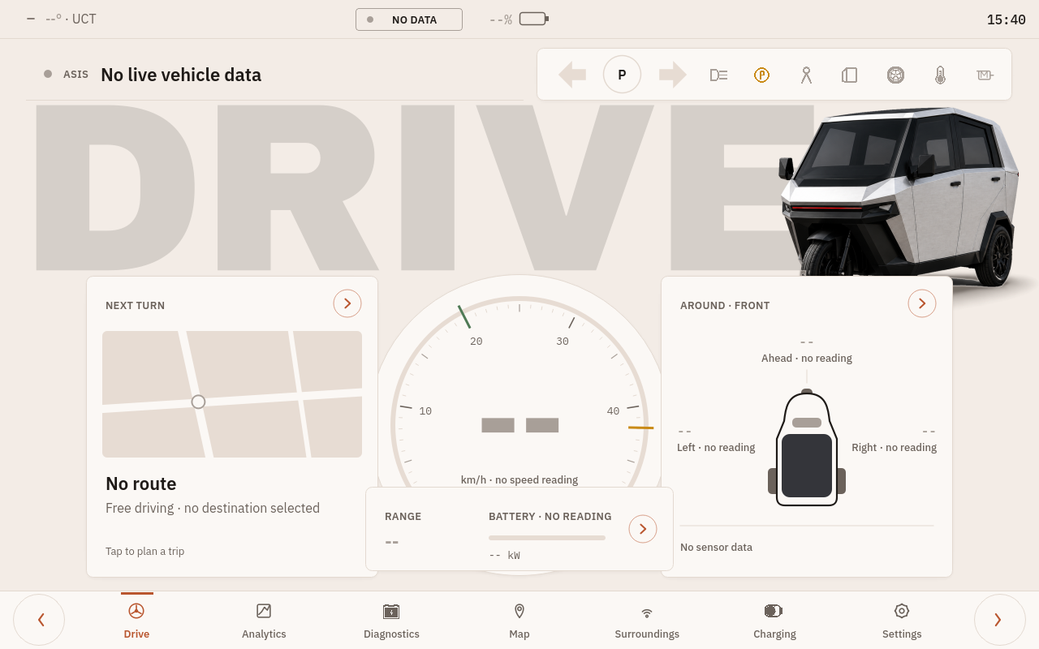
BenchTest/logs/legibility_2026-10-24/page_00_DrivingPage.png
