0geder/Tukzie-HPEC-HUD/BenchTest/logs/legibility_2026-10-24/page_03_NavigationPage.png

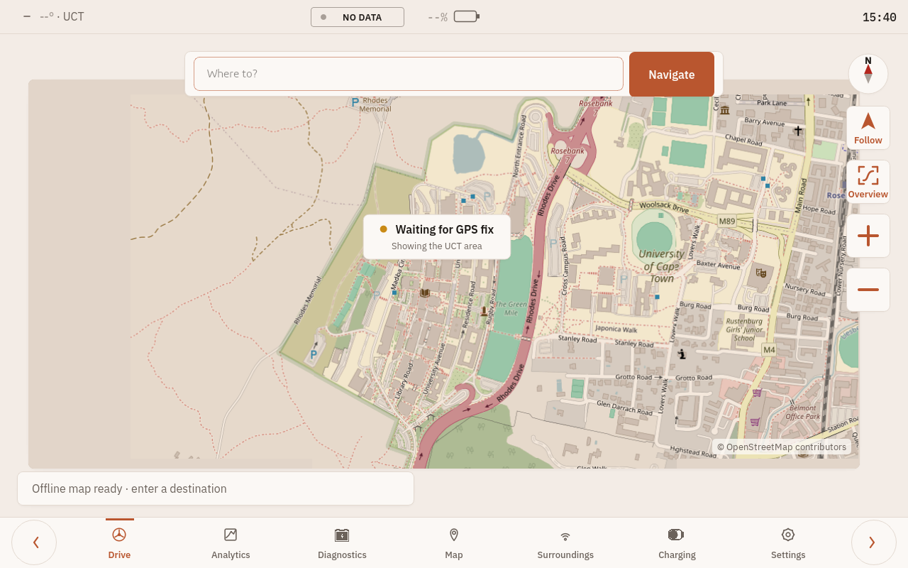
BenchTest/logs/legibility_2026-10-24/page_03_NavigationPage.png
