0geder/Tukzie-HPEC-HUD/BenchTest/logs/legibility_2026-10-24/page_04_QWidget.png

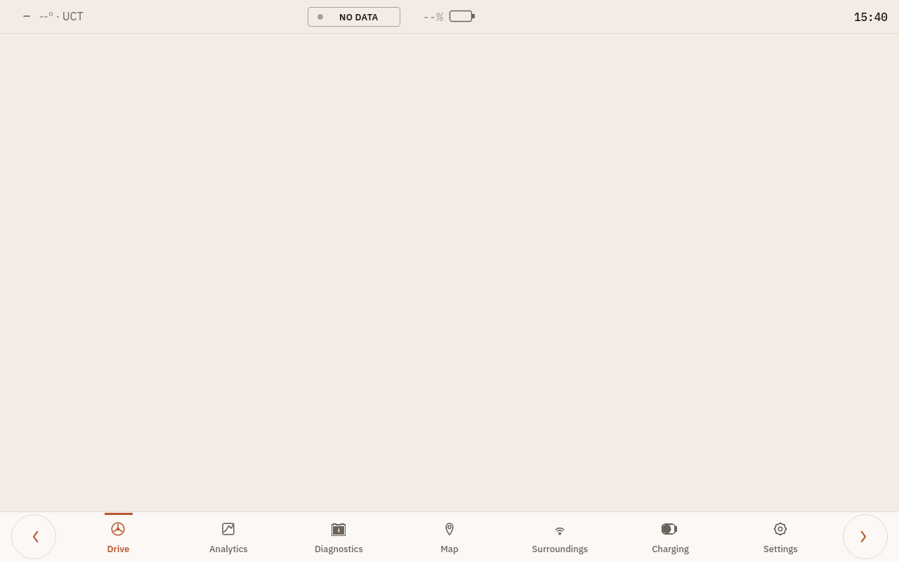
BenchTest/logs/legibility_2026-10-24/page_04_QWidget.png
