0geder/Tukzie-HPEC-HUD/BenchTest/logs/legibility_2026-10-24/page_06_ReverseCameraPage.png

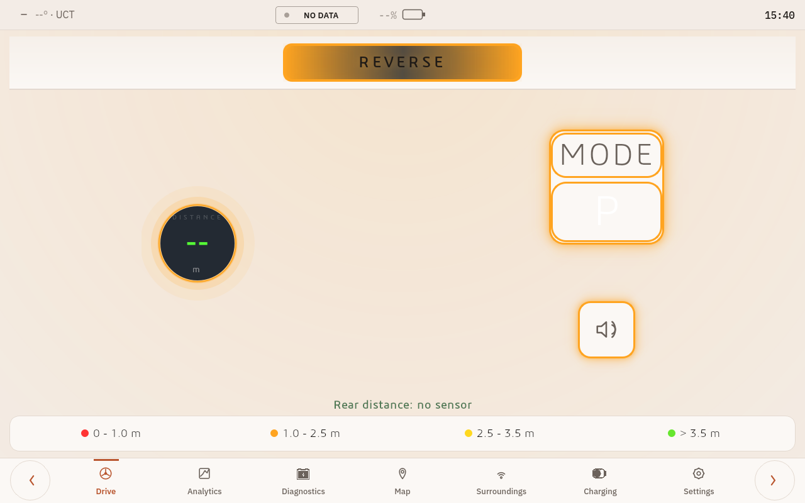
BenchTest/logs/legibility_2026-10-24/page_06_ReverseCameraPage.png
