0geder/Tukzie-HPEC-HUD/BenchTest/logs/legibility_2026-10-24/page_08_SettingsPage.png

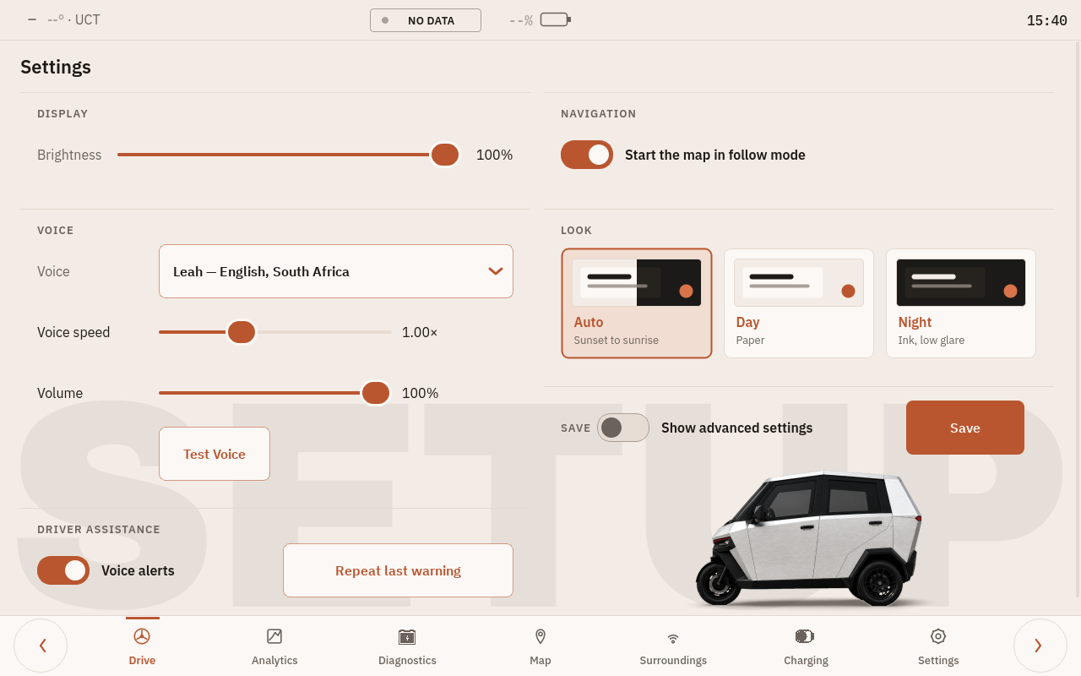
BenchTest/logs/legibility_2026-10-24/page_08_SettingsPage.png
