0geder/Tukzie-HPEC-HUD/BenchTest/logs/run2_road_2026-10-27/analysis/figures/pothole_sweep.png

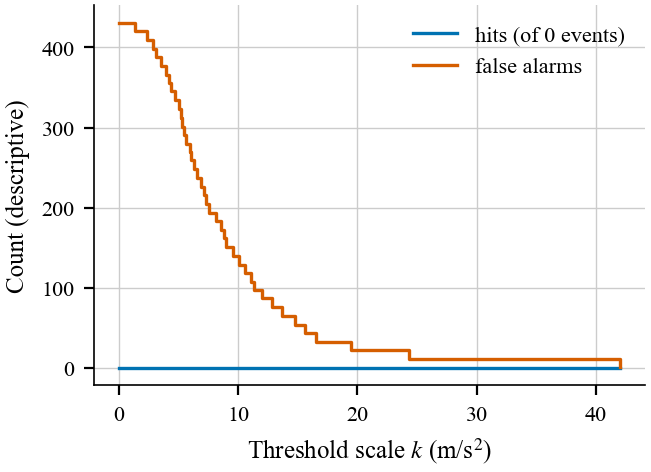
BenchTest/logs/run2_road_2026-10-27/analysis/figures/pothole_sweep.png
