0geder/Tukzie-HPEC-HUD/CameraDetection/tests/data/pothole_slievebane_road.jpg

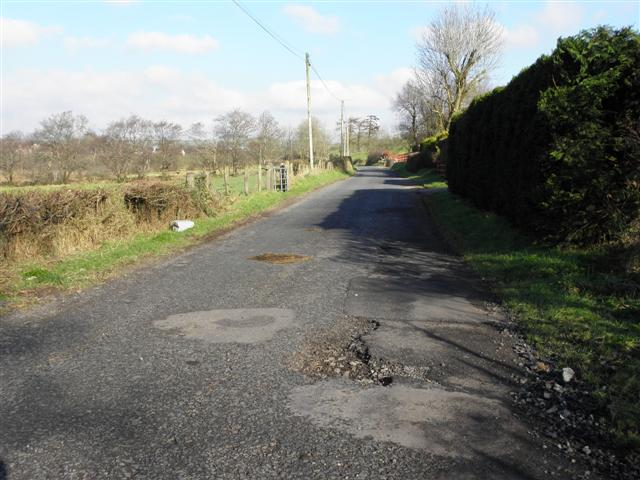
CameraDetection/tests/data/pothole_slievebane_road.jpg
