0geder/Tukzie-HPEC-HUD/CameraDetection/training/runs/run2_sa_band_tiles_640/results.png

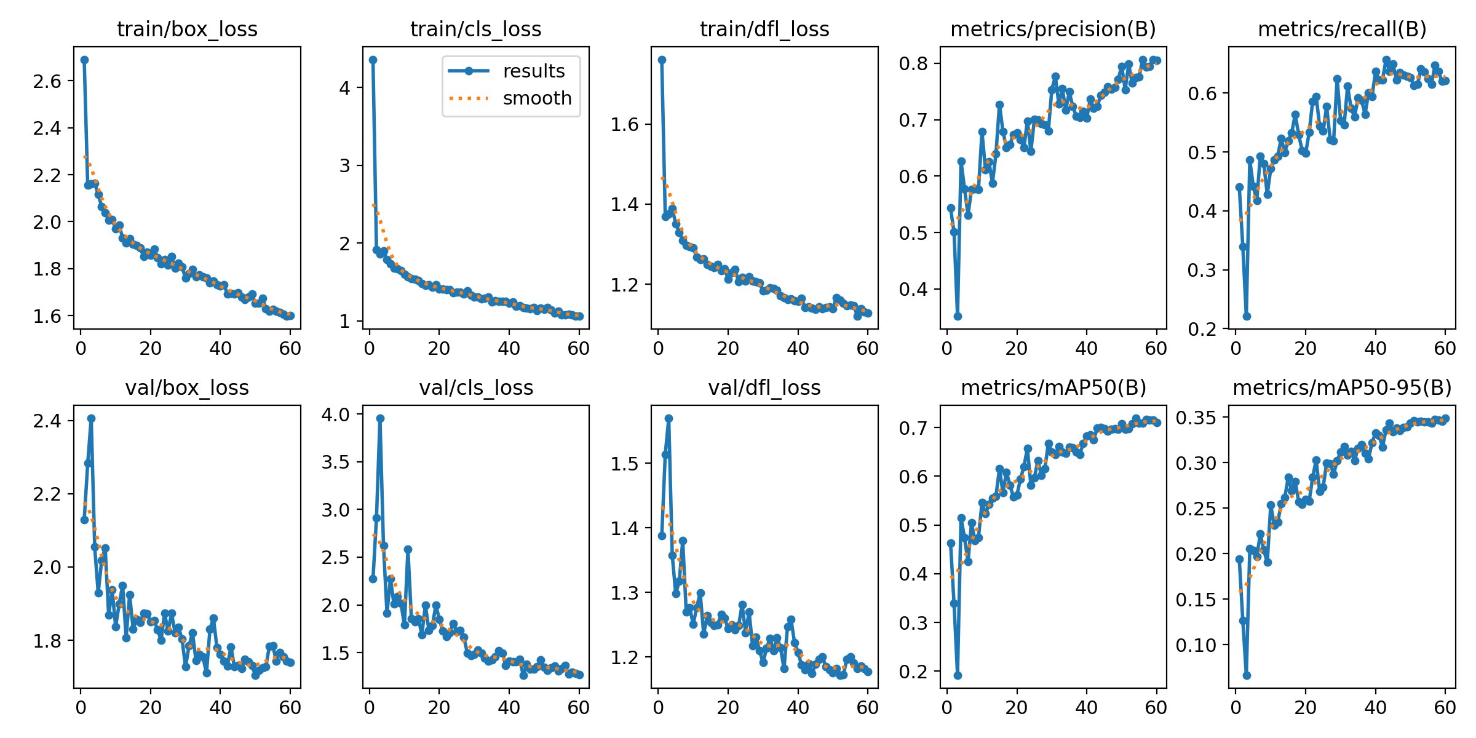
CameraDetection/training/runs/run2_sa_band_tiles_640/results.png
