0geder/Tukzie-HPEC-HUD/DashboardIntegration/tests/layout/drive/after_analytics.png

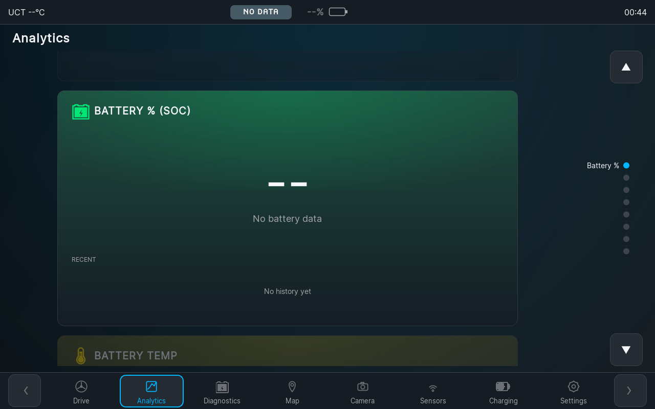
DashboardIntegration/tests/layout/drive/after_analytics.png
