0geder/Tukzie-HPEC-HUD/DashboardIntegration/tests/layout/drive/after_analytics_graphs.png

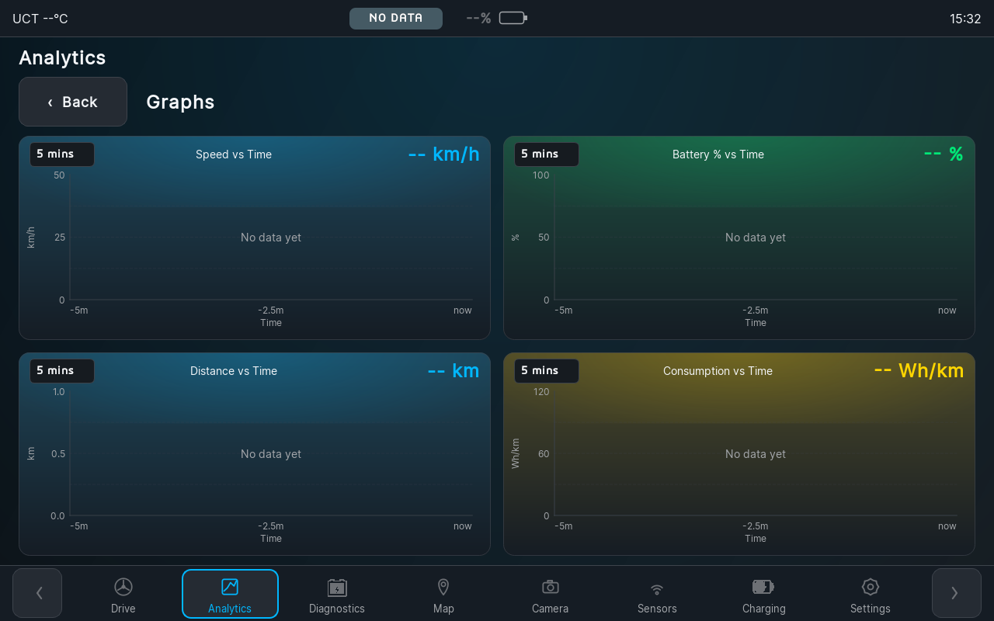
DashboardIntegration/tests/layout/drive/after_analytics_graphs.png
