0geder/Tukzie-HPEC-HUD/DashboardIntegration/tests/layout/drive/after_analytics_sim.png

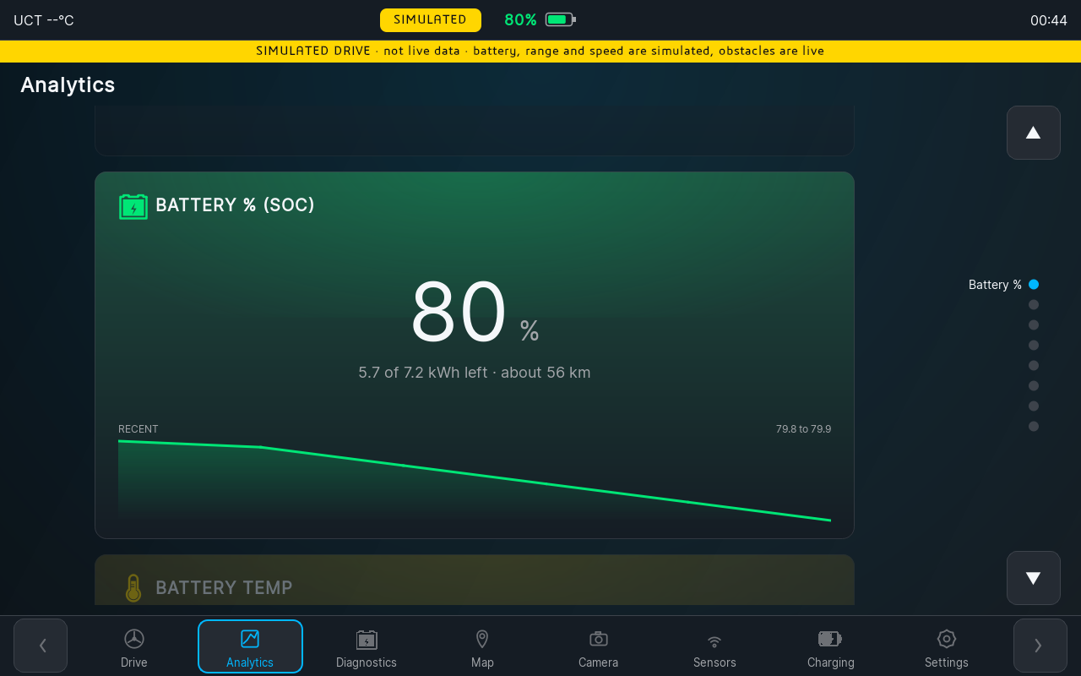
DashboardIntegration/tests/layout/drive/after_analytics_sim.png
