0geder/Tukzie-HPEC-HUD/DashboardIntegration/tests/layout/drive/after_driving.png

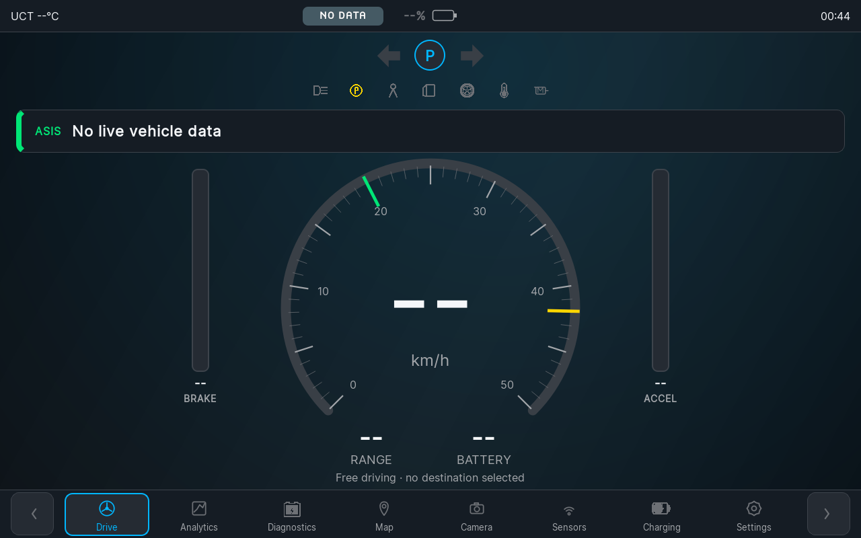
DashboardIntegration/tests/layout/drive/after_driving.png
