0geder/Tukzie-HPEC-HUD/DashboardIntegration/tests/layout/drive/after_driving_sim.png

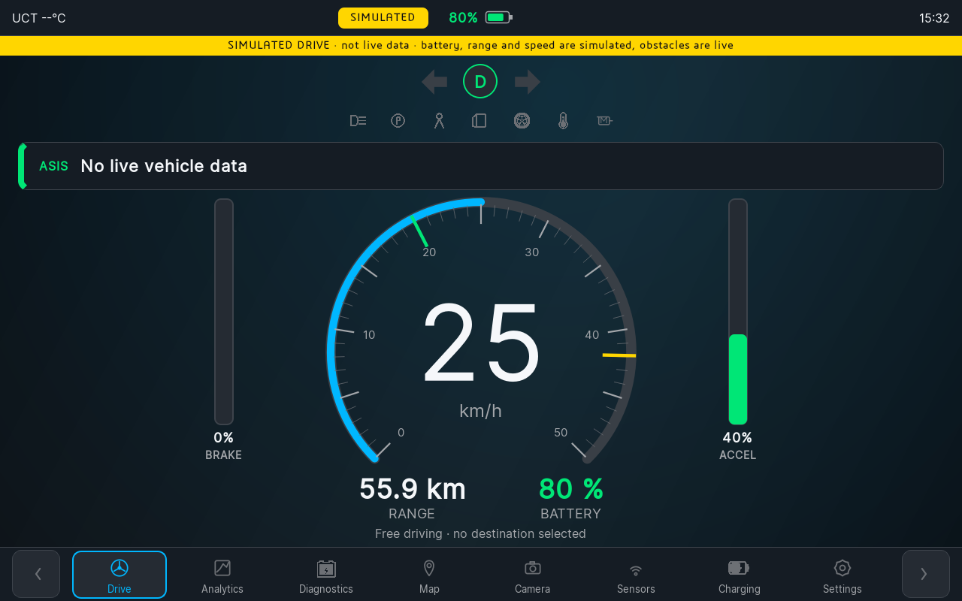
DashboardIntegration/tests/layout/drive/after_driving_sim.png
