0geder/Tukzie-HPEC-HUD/DashboardIntegration/tests/layout/drive/before_analytics.png

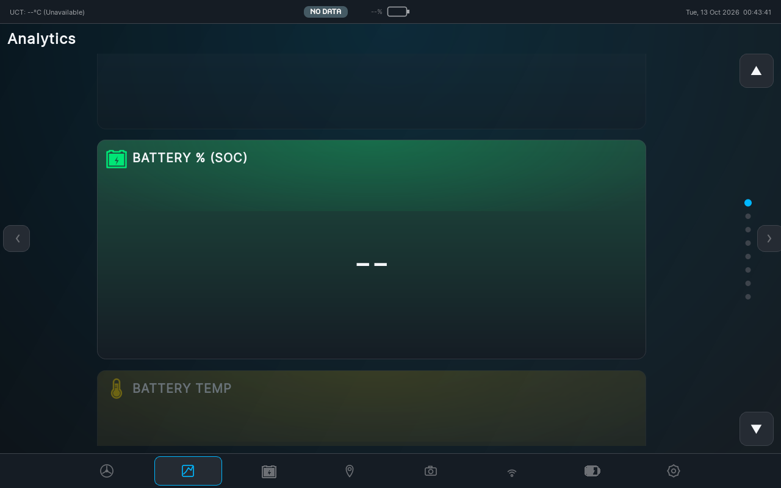
DashboardIntegration/tests/layout/drive/before_analytics.png
