0geder/Tukzie-HPEC-HUD/DashboardIntegration/tests/layout/drive/before_analytics_graphs.png

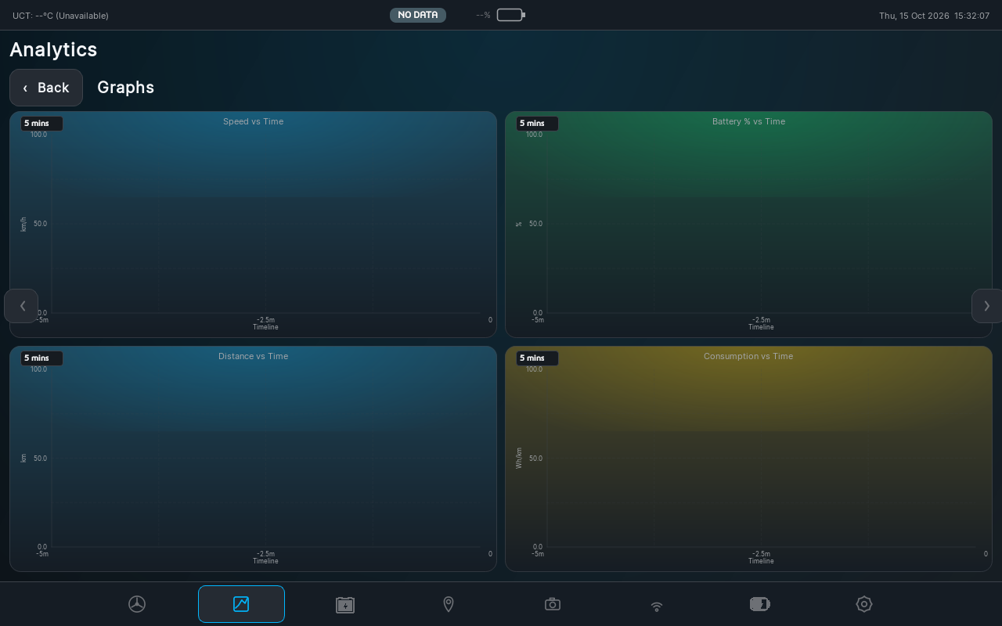
DashboardIntegration/tests/layout/drive/before_analytics_graphs.png
