0geder/Tukzie-HPEC-HUD/DashboardIntegration/tests/layout/drive/before_analytics_graphs_sim.png

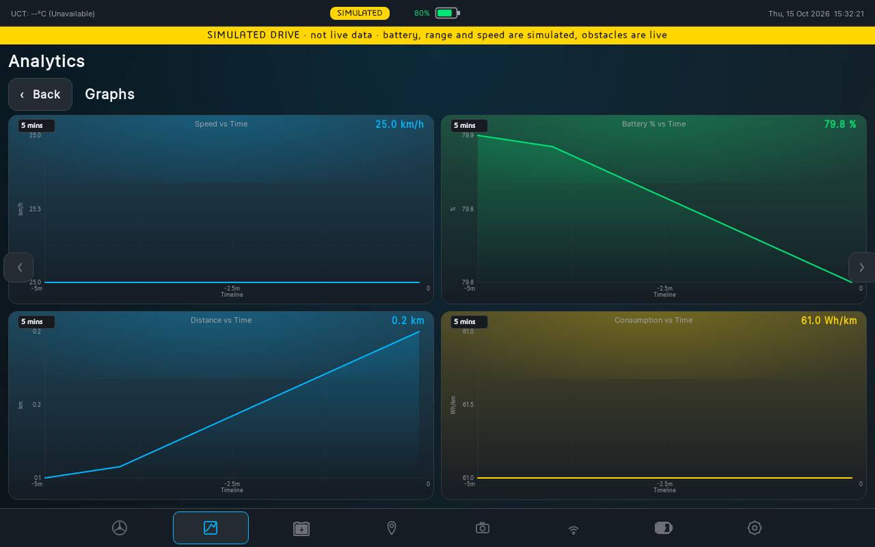
DashboardIntegration/tests/layout/drive/before_analytics_graphs_sim.png
