0geder/Tukzie-HPEC-HUD/DashboardIntegration/tests/layout/drive/before_driving_sim.png

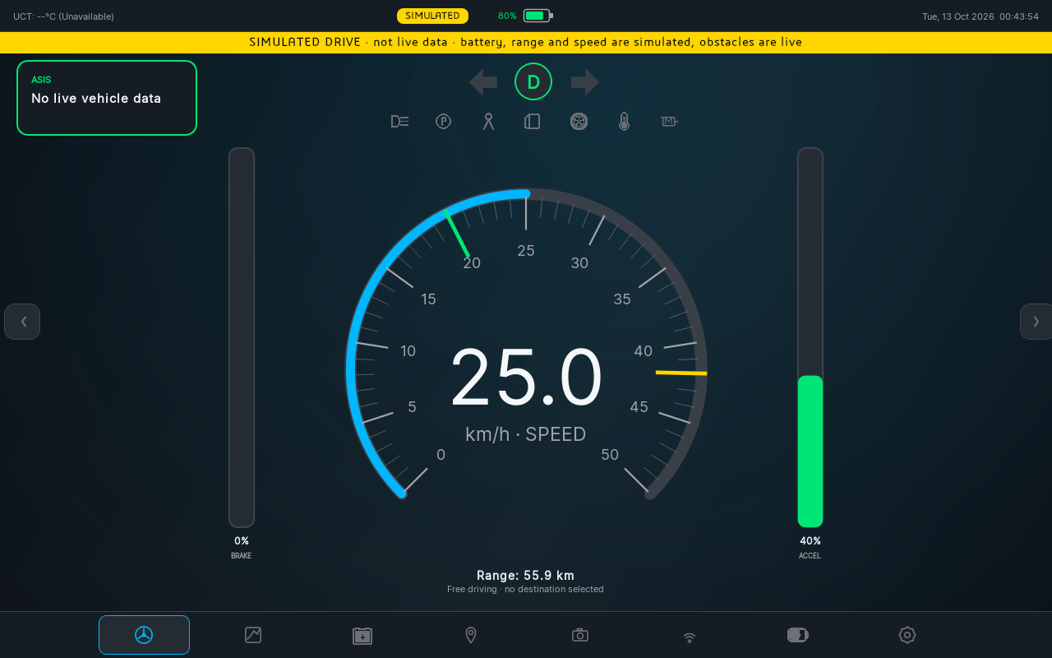
DashboardIntegration/tests/layout/drive/before_driving_sim.png
