0geder/Tukzie-HPEC-HUD/DashboardIntegration/tests/layout/frame/after_charging.png

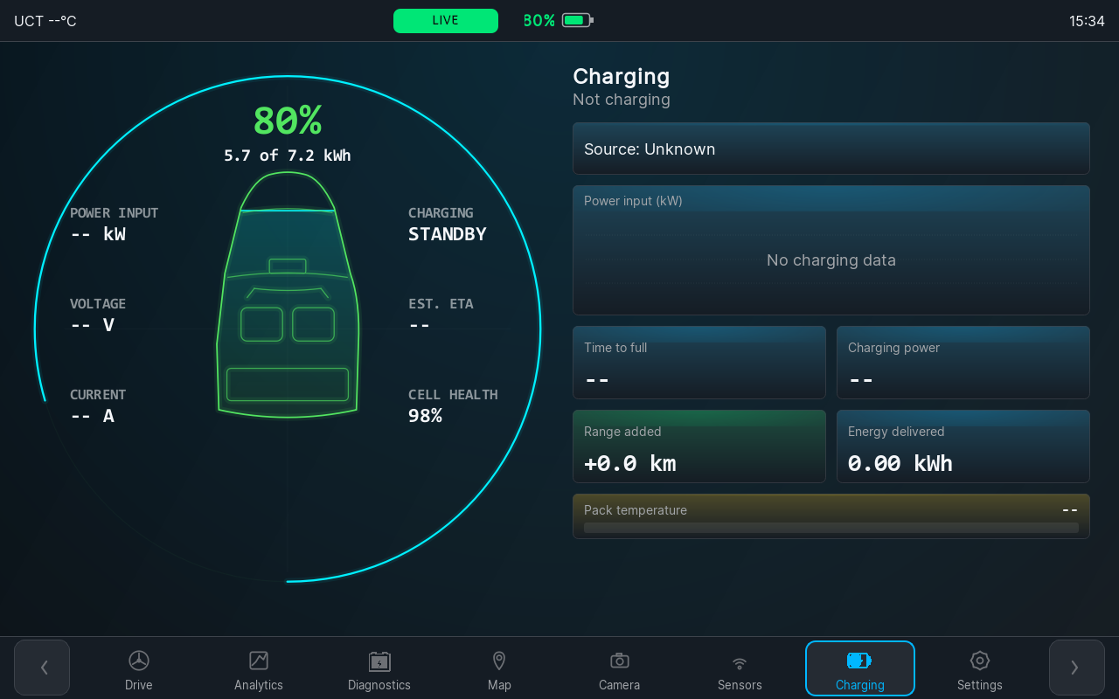
DashboardIntegration/tests/layout/frame/after_charging.png
