0geder/Tukzie-HPEC-HUD/DashboardIntegration/tests/layout/frame/after_settings.png

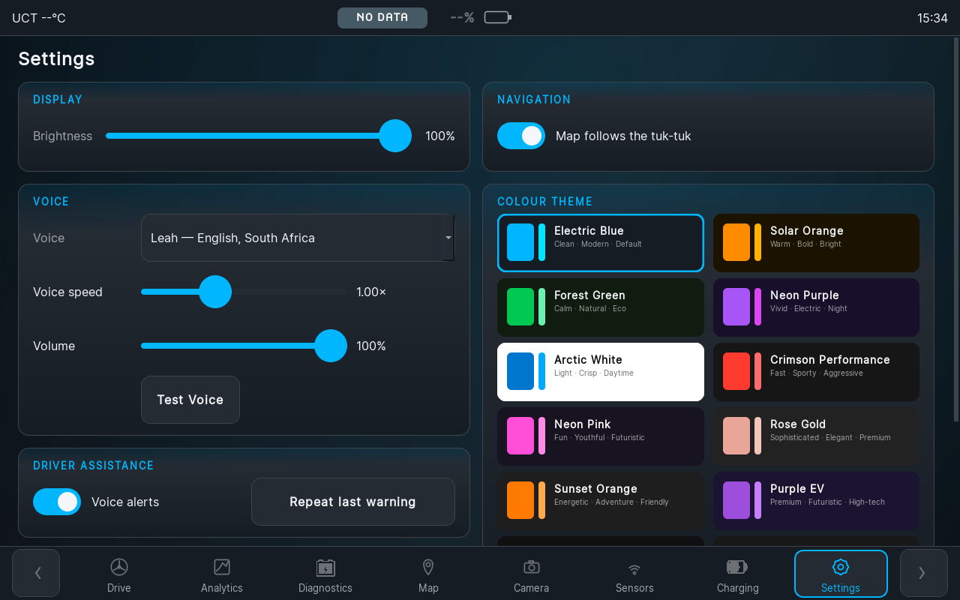
DashboardIntegration/tests/layout/frame/after_settings.png
