0geder/Tukzie-HPEC-HUD/DashboardIntegration/tests/layout/frame/after_settings_end.png

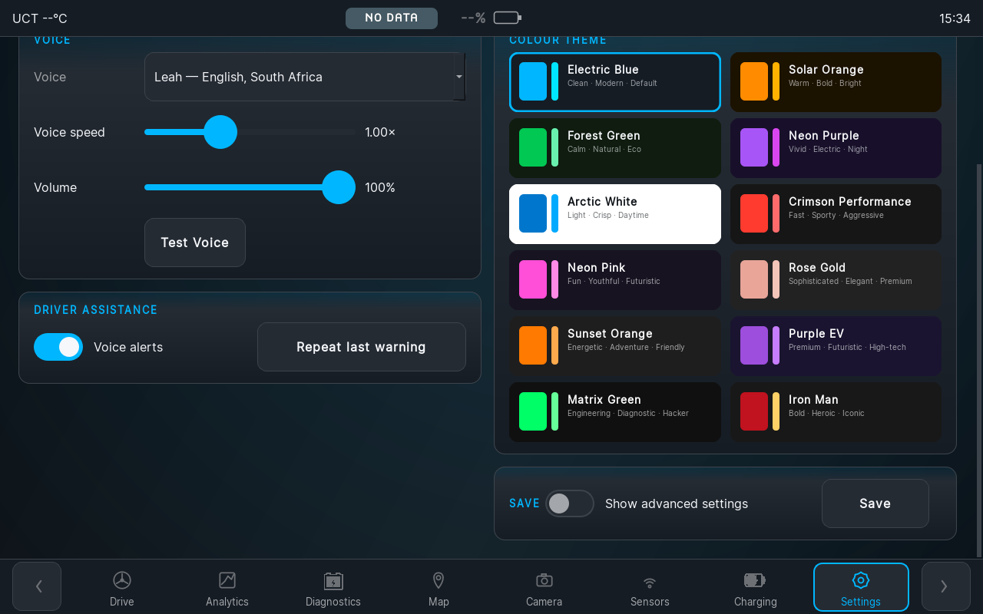
DashboardIntegration/tests/layout/frame/after_settings_end.png
