0geder/Tukzie-HPEC-HUD/DashboardIntegration/tests/layout/frame/before_charging.png

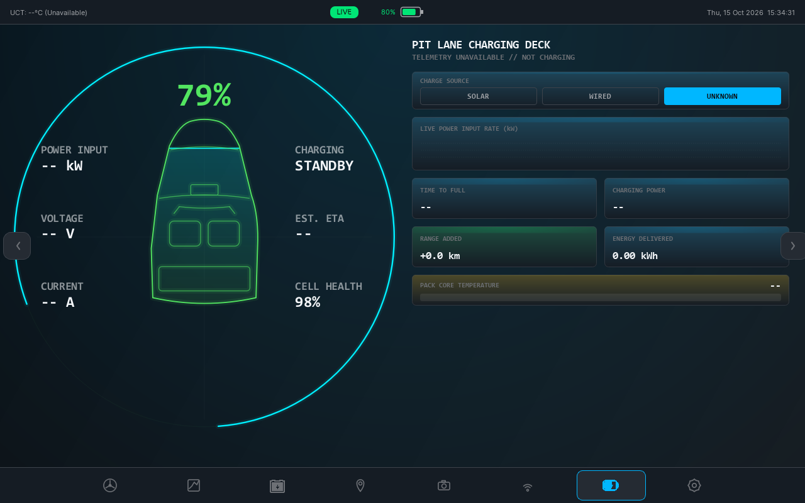
DashboardIntegration/tests/layout/frame/before_charging.png
