0geder/Tukzie-HPEC-HUD/DashboardIntegration/tests/layout/frame/before_settings.png

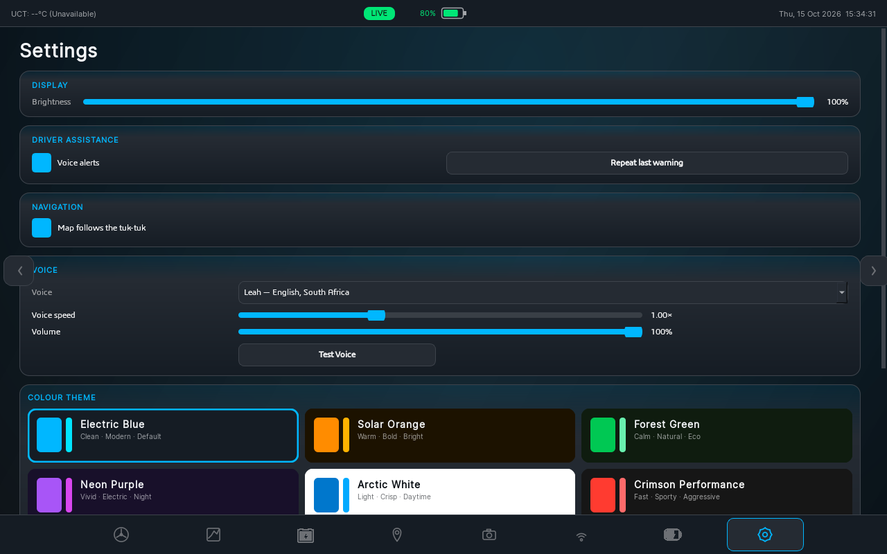
DashboardIntegration/tests/layout/frame/before_settings.png
