0geder/Tukzie-HPEC-HUD/DashboardIntegration/tests/layout/frame/before_settings_end.png

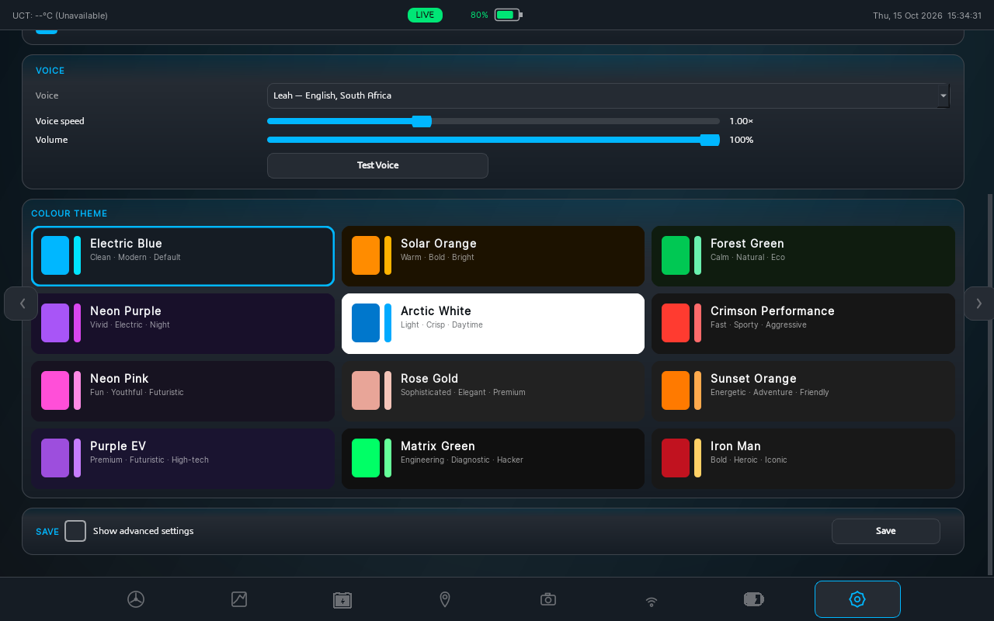
DashboardIntegration/tests/layout/frame/before_settings_end.png
