0geder/Tukzie-HPEC-HUD/DashboardIntegration/tests/layout/map/after_follow.png

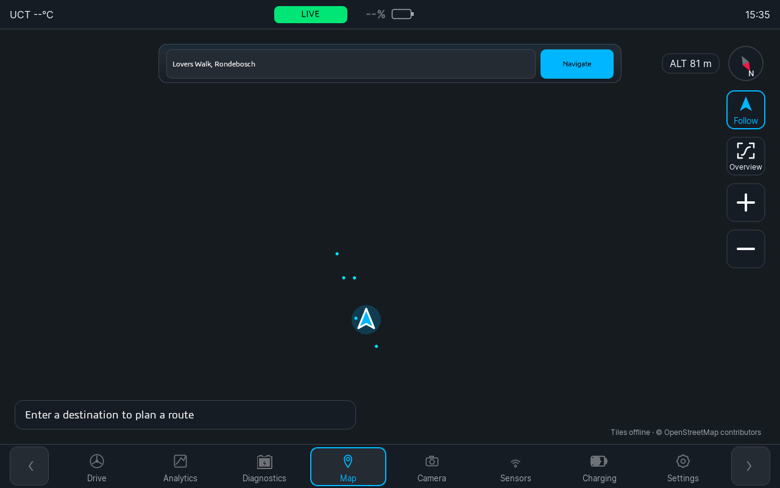
DashboardIntegration/tests/layout/map/after_follow.png
