0geder/Tukzie-HPEC-HUD/DashboardIntegration/tests/layout/map/after_navigation.png

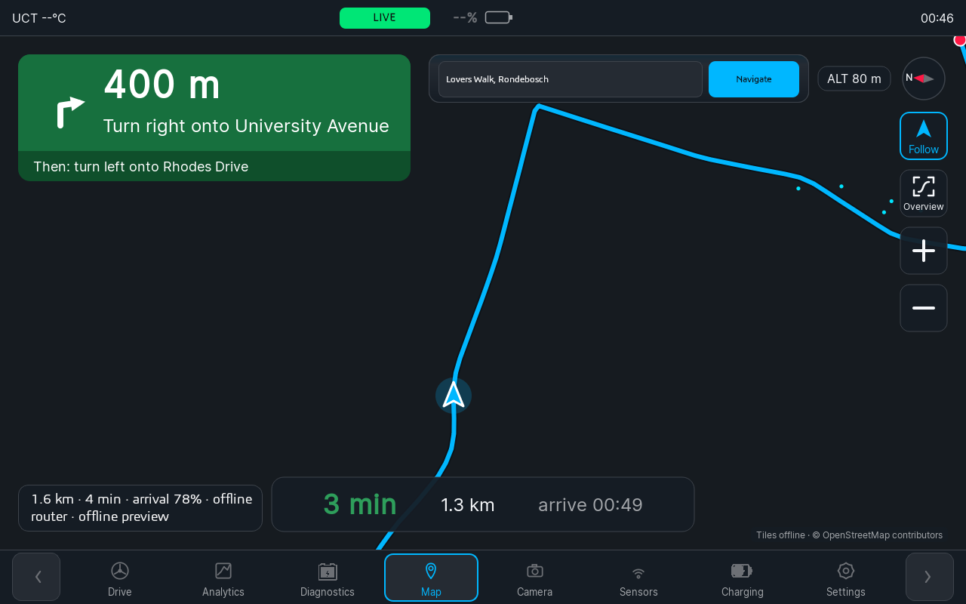
DashboardIntegration/tests/layout/map/after_navigation.png
