0geder/Tukzie-HPEC-HUD/DashboardIntegration/tests/layout/map/after_simulated.png

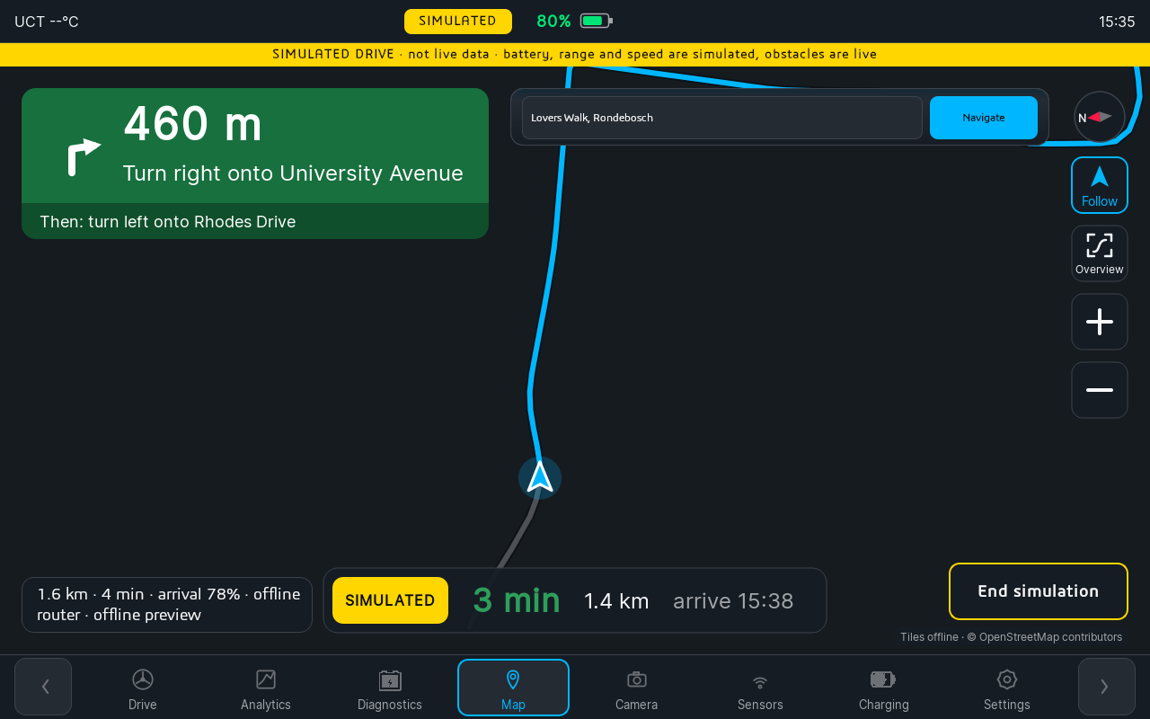
DashboardIntegration/tests/layout/map/after_simulated.png
