0geder/Tukzie-HPEC-HUD/DashboardIntegration/tests/layout/map/before_follow.png

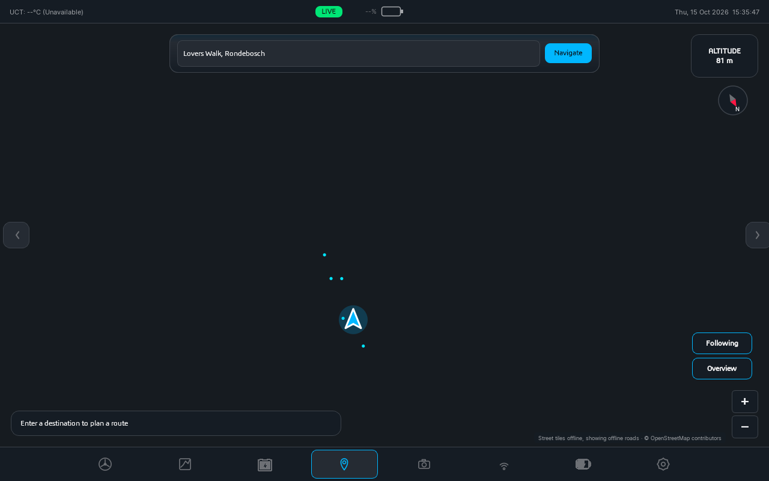
DashboardIntegration/tests/layout/map/before_follow.png
