0geder/Tukzie-HPEC-HUD/DashboardIntegration/tests/layout/map/before_navigation.png

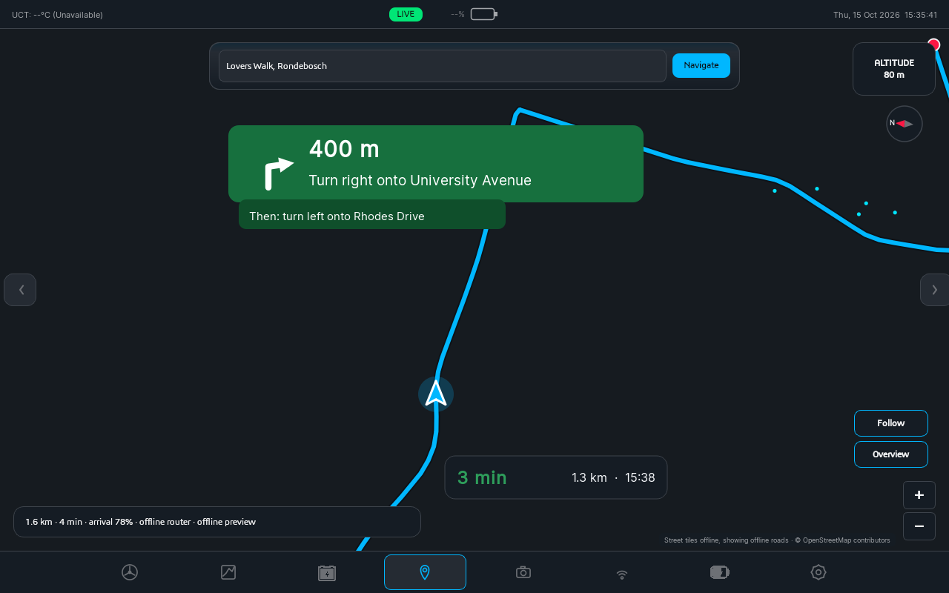
DashboardIntegration/tests/layout/map/before_navigation.png
