0geder/Tukzie-HPEC-HUD/DashboardIntegration/tests/layout/map/before_simulated.png

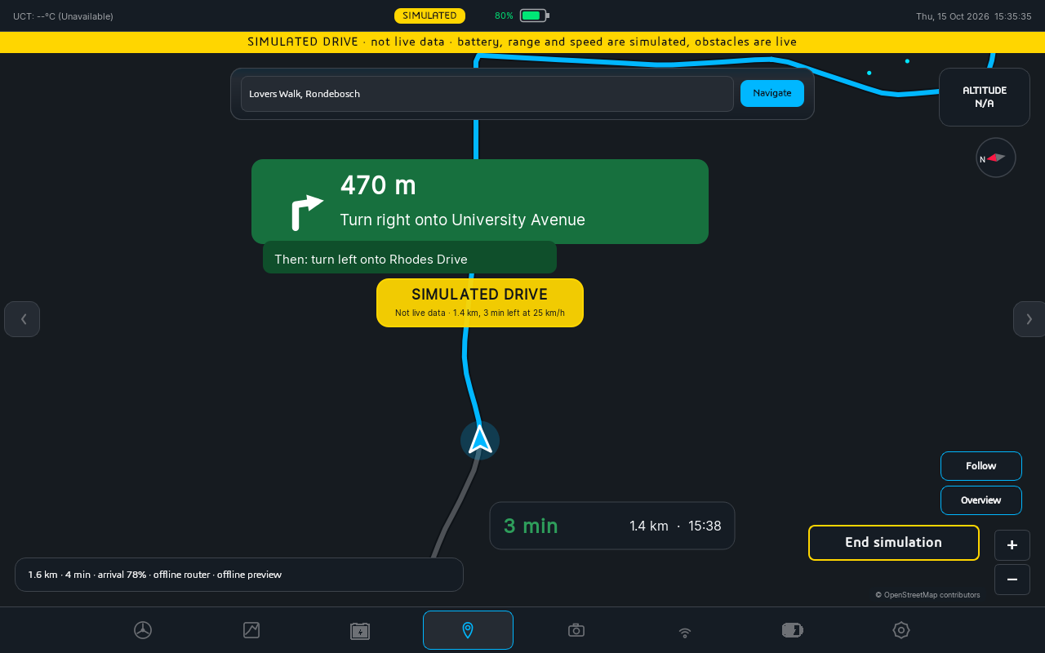
DashboardIntegration/tests/layout/map/before_simulated.png
