0geder/Tukzie-HPEC-HUD/DashboardIntegration/tests/layout/map/before_tilt.png

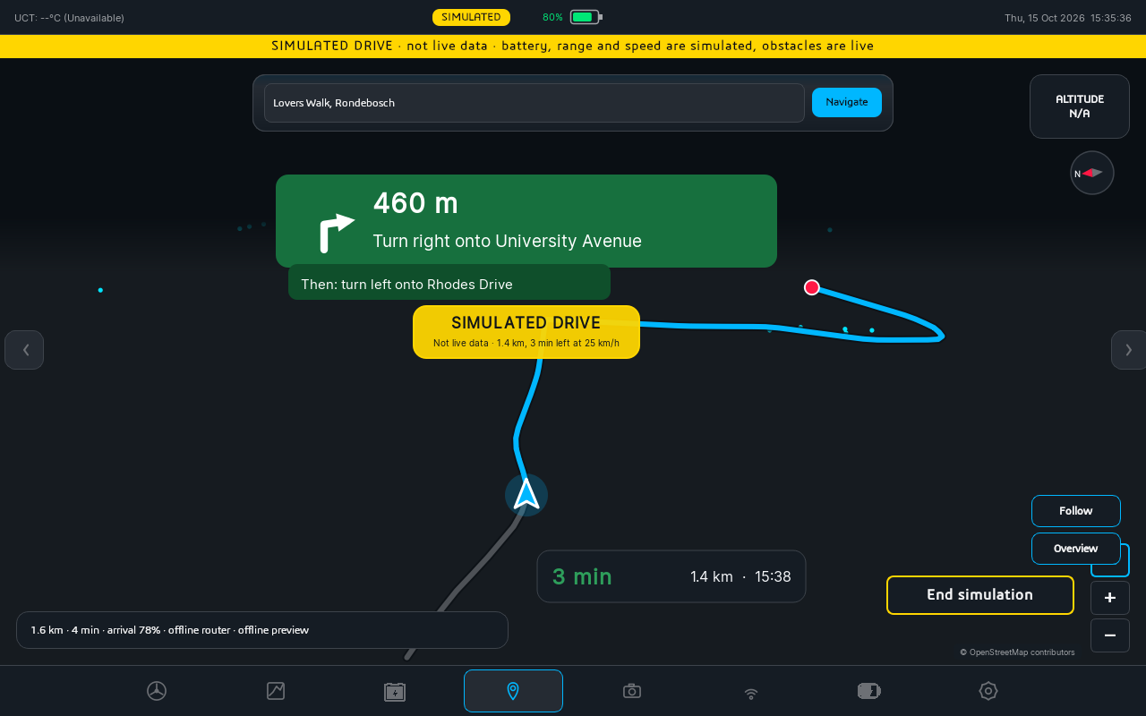
DashboardIntegration/tests/layout/map/before_tilt.png
