0geder/Tukzie-HPEC-HUD/DashboardIntegration/tests/layout/pages/after_camera_alerts.png

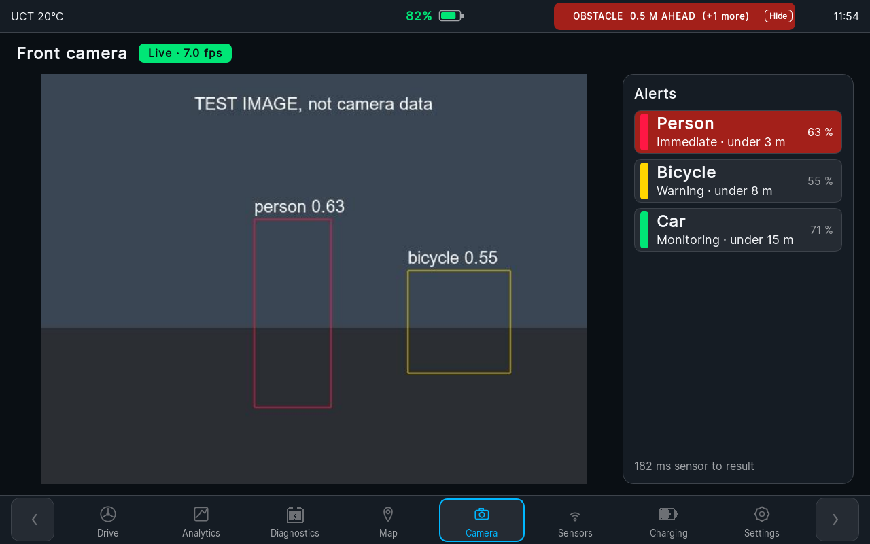
DashboardIntegration/tests/layout/pages/after_camera_alerts.png
