0geder/Tukzie-HPEC-HUD/DashboardIntegration/tests/layout/pages/after_diagnostics.png

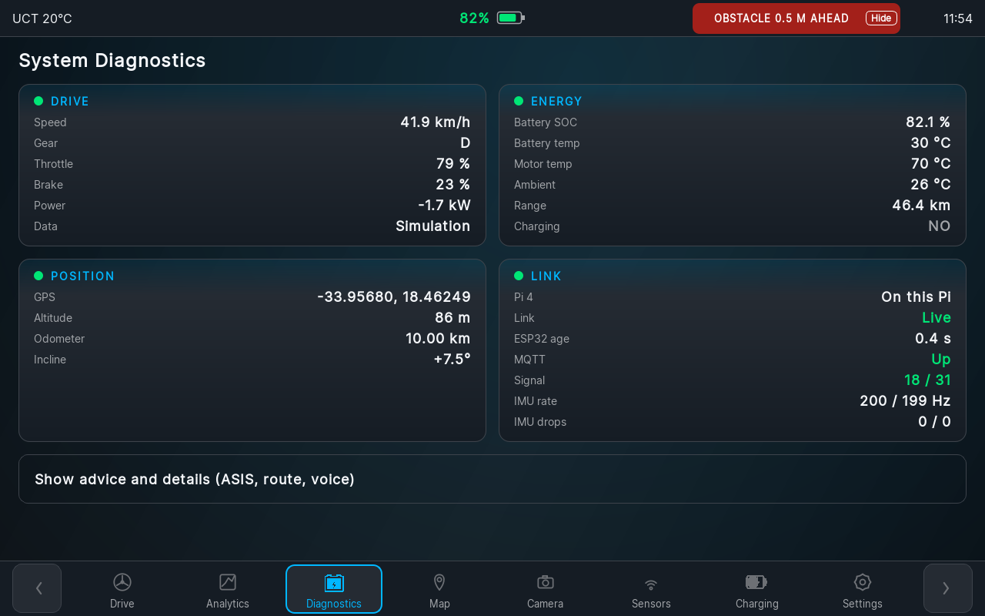
DashboardIntegration/tests/layout/pages/after_diagnostics.png
