0geder/Tukzie-HPEC-HUD/DashboardIntegration/tests/layout/pages/after_diagnostics_details.png

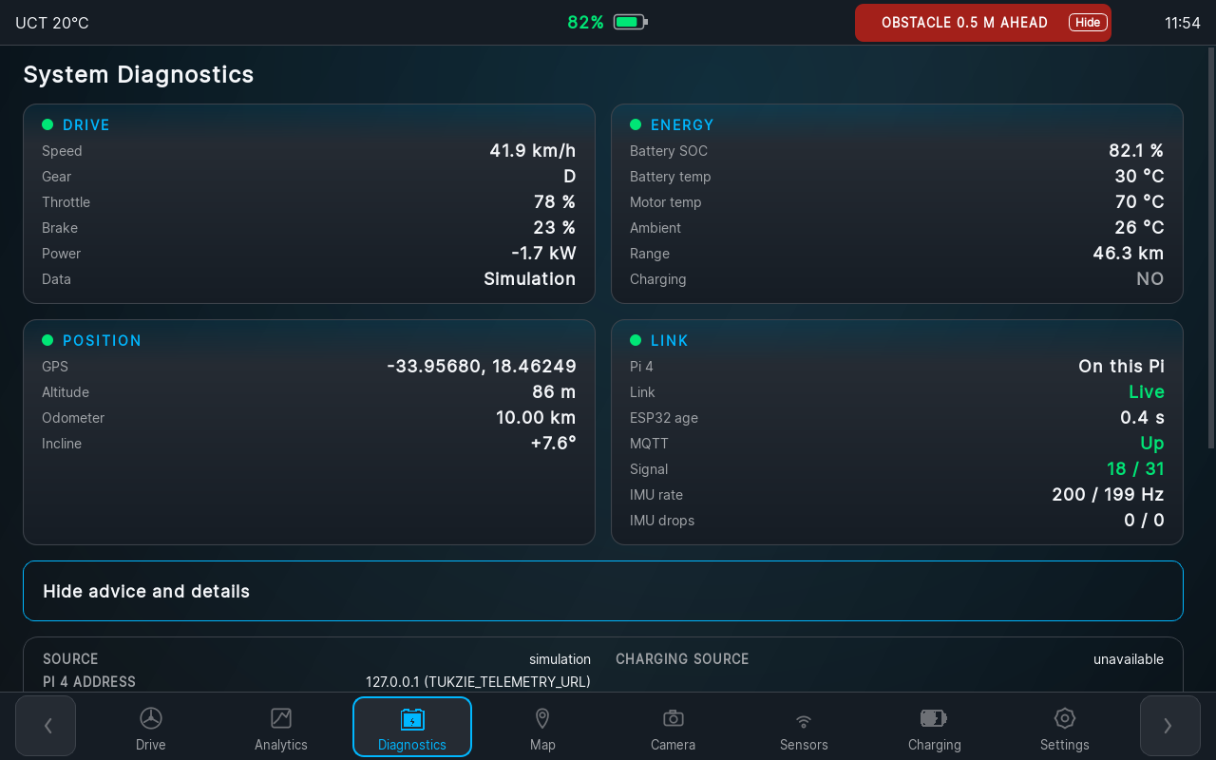
DashboardIntegration/tests/layout/pages/after_diagnostics_details.png
