0geder/Tukzie-HPEC-HUD/DashboardIntegration/tests/layout/pages/after_sensors_far.png

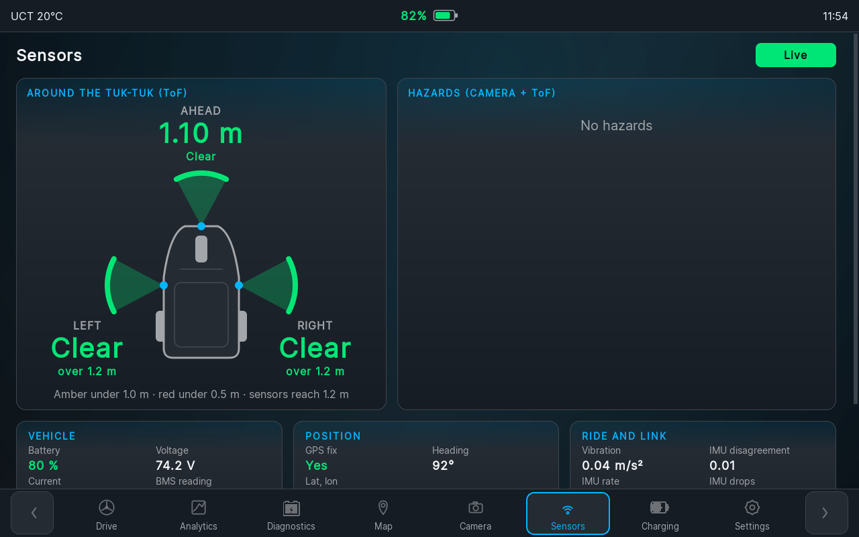
DashboardIntegration/tests/layout/pages/after_sensors_far.png
