0geder/Tukzie-HPEC-HUD/DashboardIntegration/tests/layout/pages/after_sensors_near.png

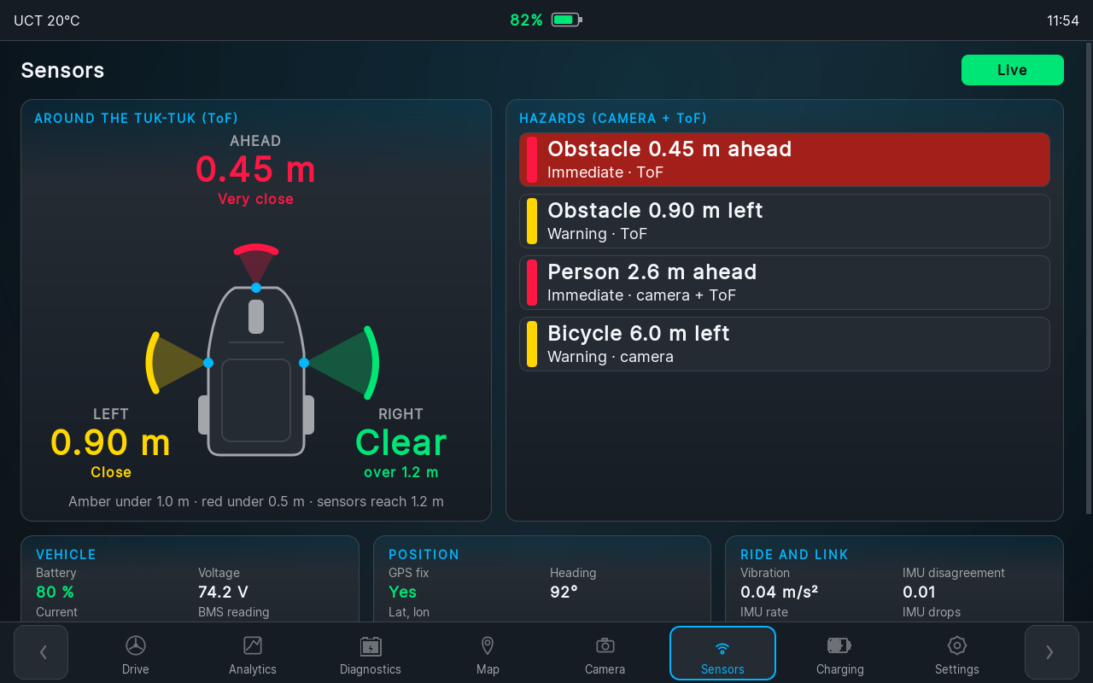
DashboardIntegration/tests/layout/pages/after_sensors_near.png
