0geder/Tukzie-HPEC-HUD/DashboardIntegration/tests/layout/pages/before_camera_alerts.png

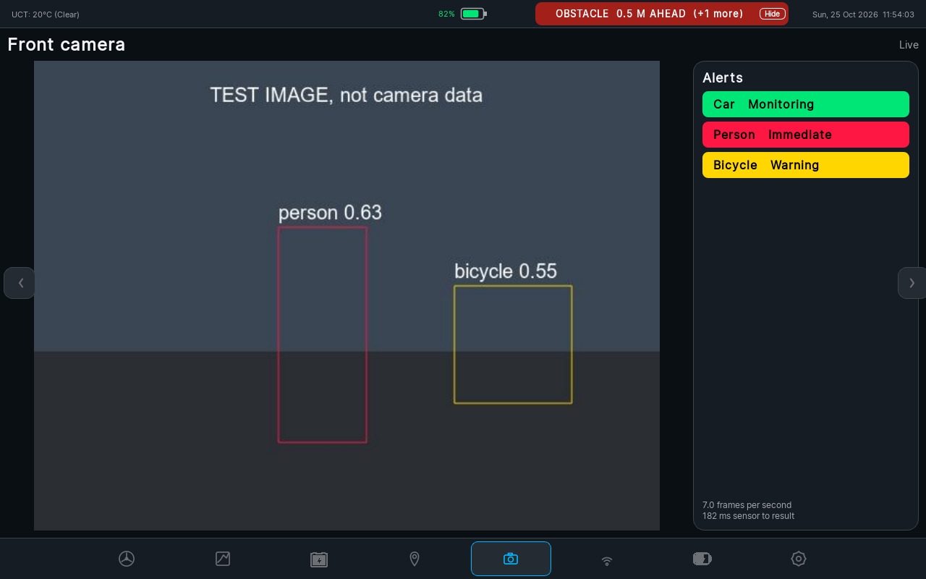
DashboardIntegration/tests/layout/pages/before_camera_alerts.png
