0geder/Tukzie-HPEC-HUD/DashboardIntegration/tests/layout/pages/before_diagnostics.png

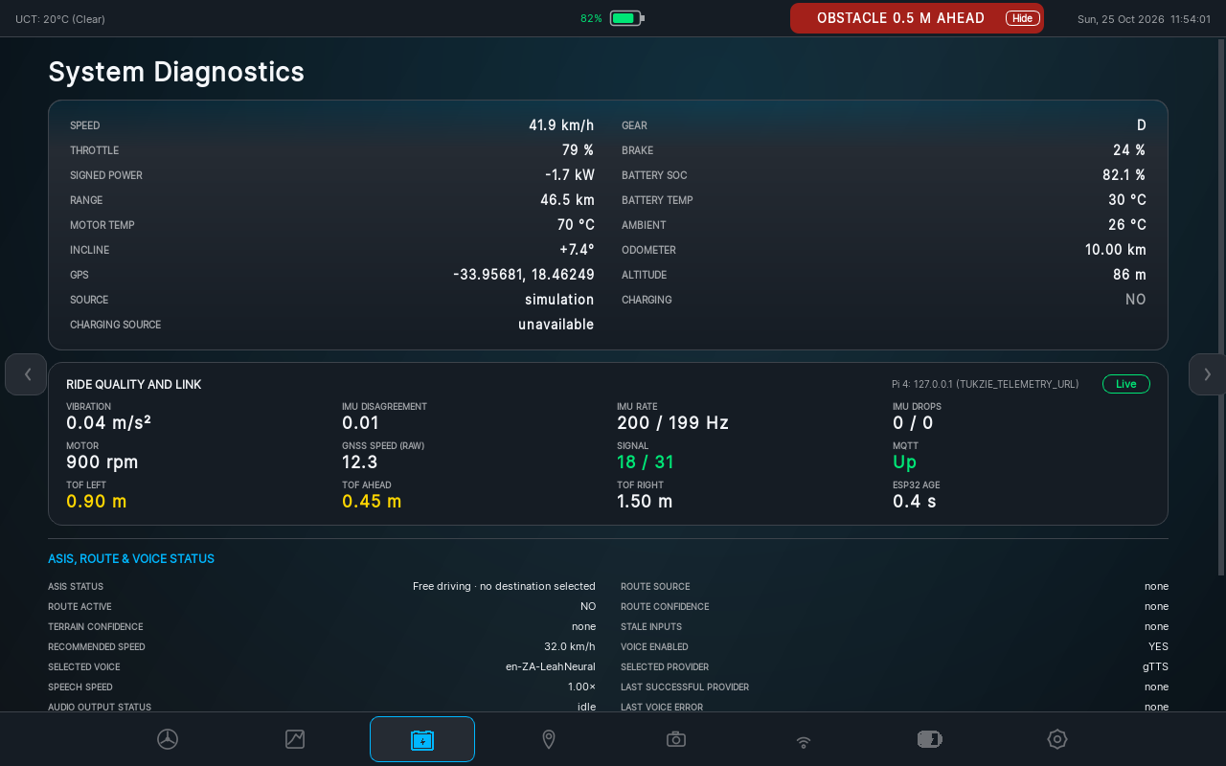
DashboardIntegration/tests/layout/pages/before_diagnostics.png
