0geder/Tukzie-HPEC-HUD/DashboardIntegration/tests/layout/pages/before_sensors_far.png

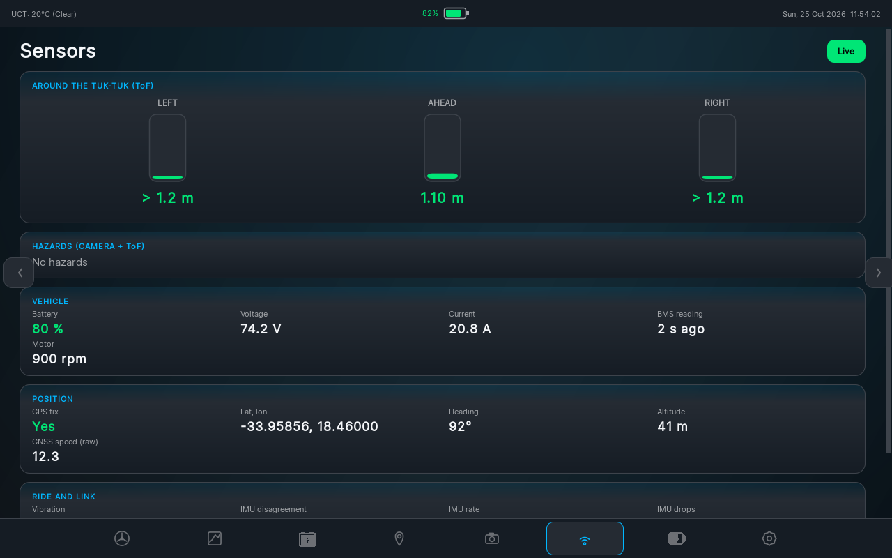
DashboardIntegration/tests/layout/pages/before_sensors_far.png
