0geder/Tukzie-HPEC-HUD/DashboardIntegration/tests/layout/pages/before_sensors_near.png

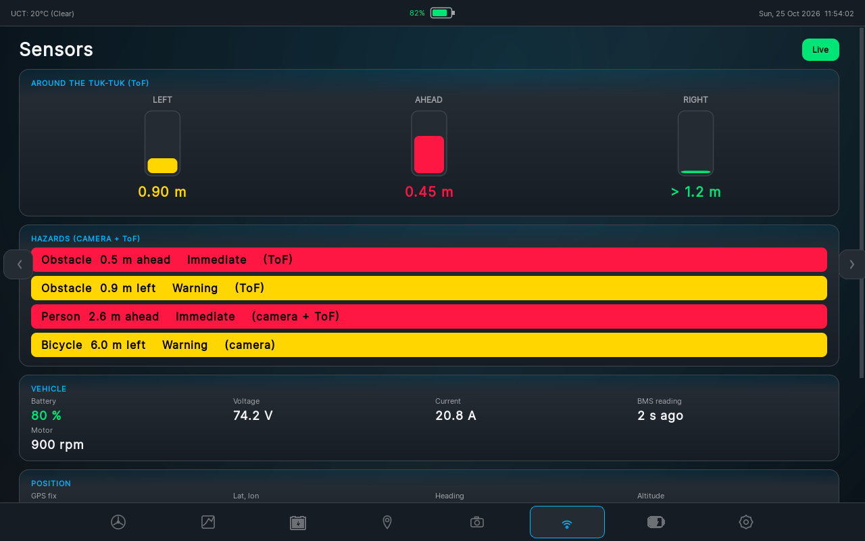
DashboardIntegration/tests/layout/pages/before_sensors_near.png
