0geder/Tukzie-HPEC-HUD/DashboardIntegration/tests/search/search_local_first.png

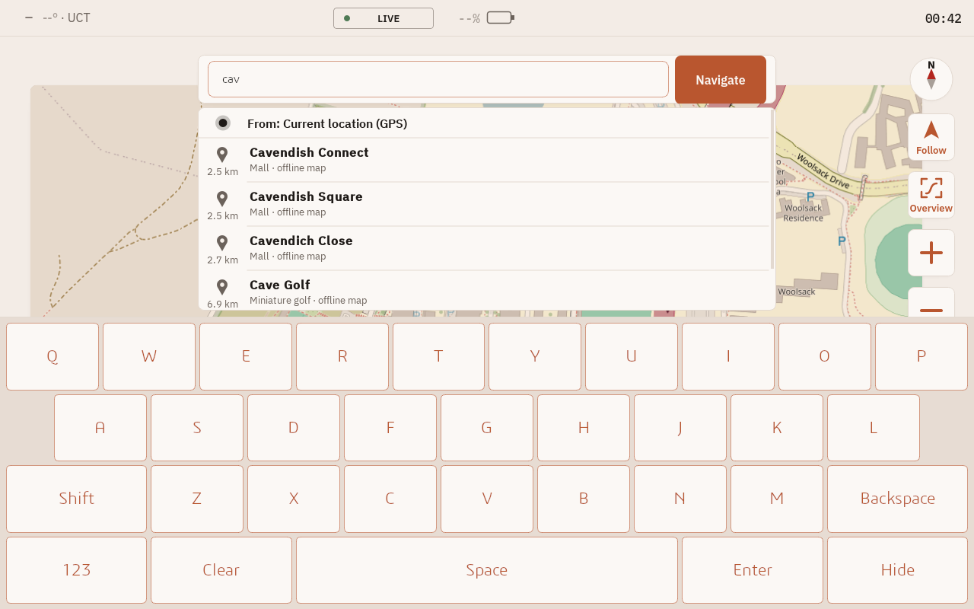
DashboardIntegration/tests/search/search_local_first.png
