0geder/Tukzie-HPEC-HUD/DashboardIntegration/tests/search/search_recents.png

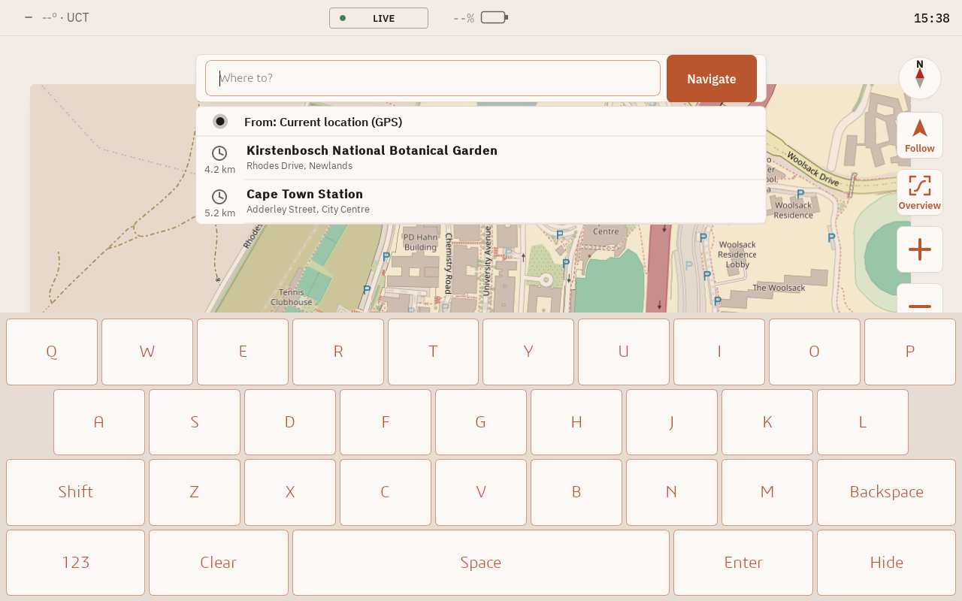
DashboardIntegration/tests/search/search_recents.png
