0geder/Tukzie-HPEC-HUD/DashboardIntegration/tests/search/search_recents_network.png

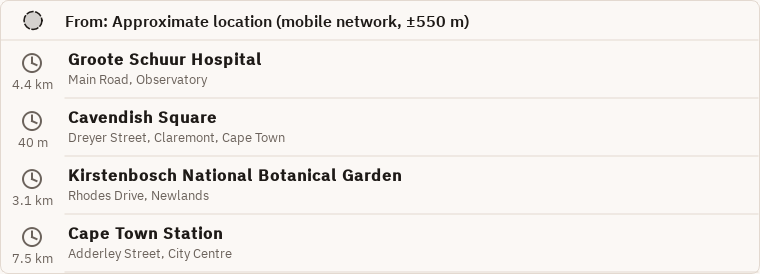
DashboardIntegration/tests/search/search_recents_network.png
