0geder/Tukzie-HPEC-HUD/DashboardIntegration/tests/search/search_results_list.png

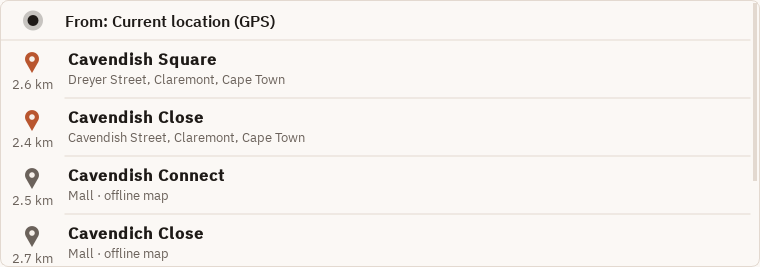
DashboardIntegration/tests/search/search_results_list.png
