0geder/Tukzie-HPEC-HUD/DashboardIntegration/tests/sim_sync/sim_analytics.png

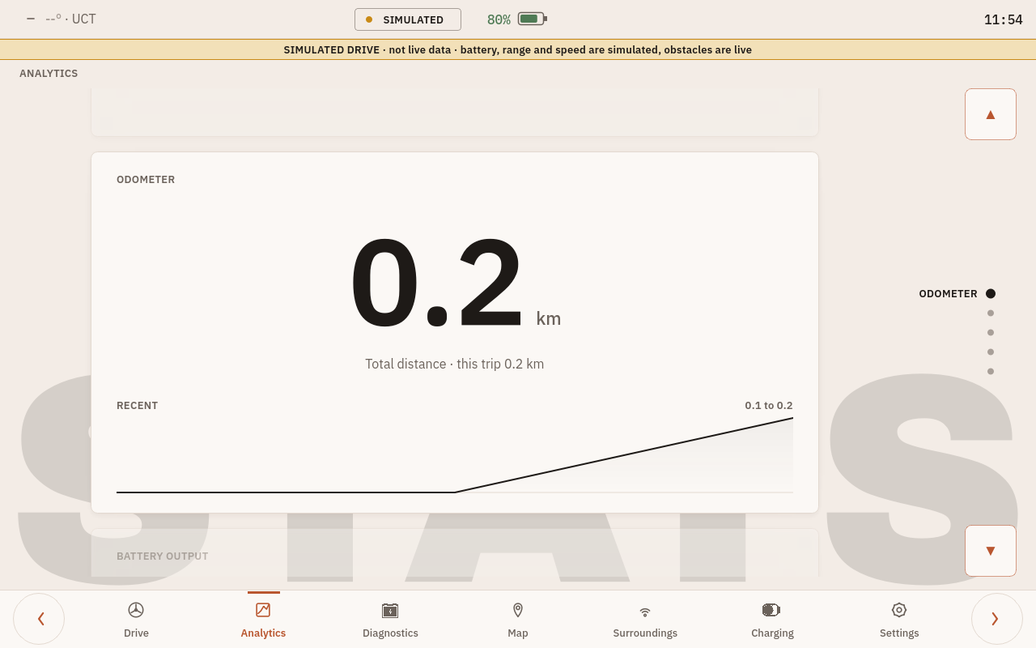
DashboardIntegration/tests/sim_sync/sim_analytics.png
