0geder/Tukzie-HPEC-HUD/DashboardIntegration/tests/sim_sync/sim_charging.png

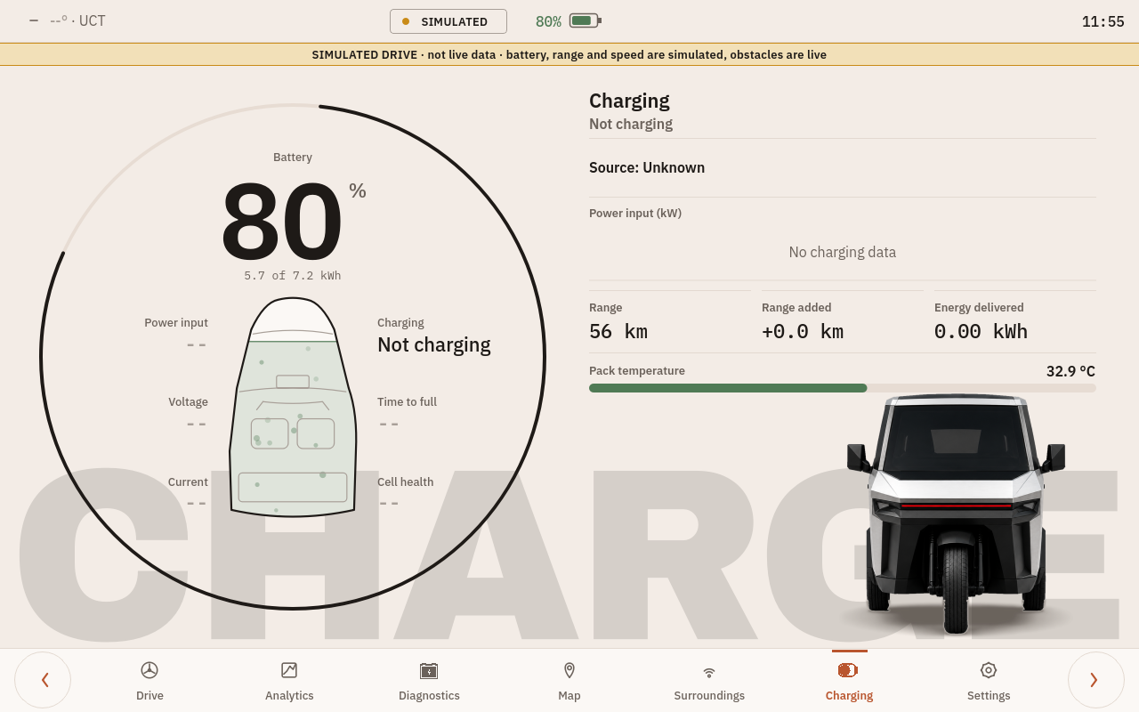
DashboardIntegration/tests/sim_sync/sim_charging.png
