0geder/Tukzie-HPEC-HUD/DashboardIntegration/tests/sim_sync/sim_diagnostics.png

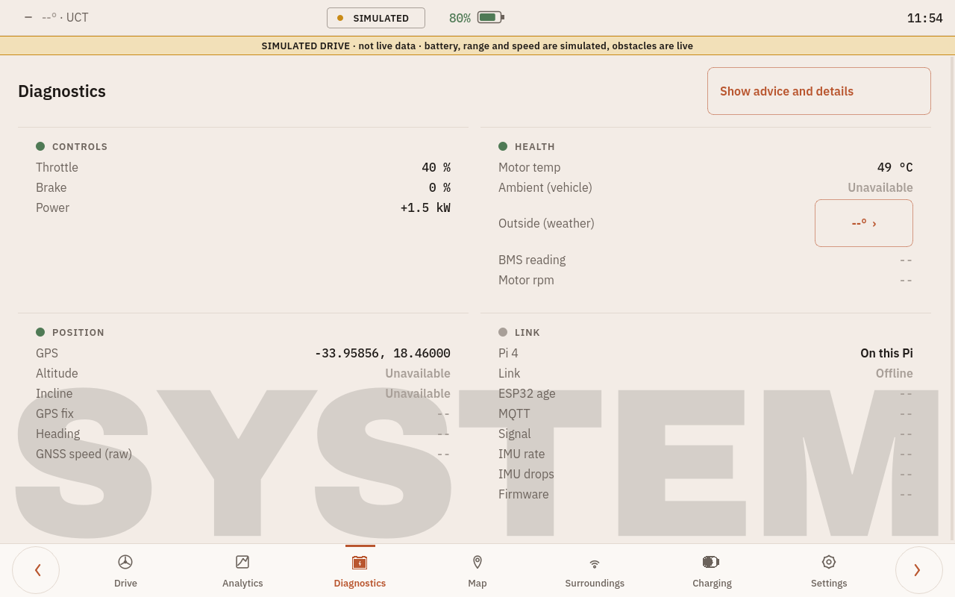
DashboardIntegration/tests/sim_sync/sim_diagnostics.png
