0geder/Tukzie-HPEC-HUD/DashboardIntegration/tests/sim_sync/sim_driving.png

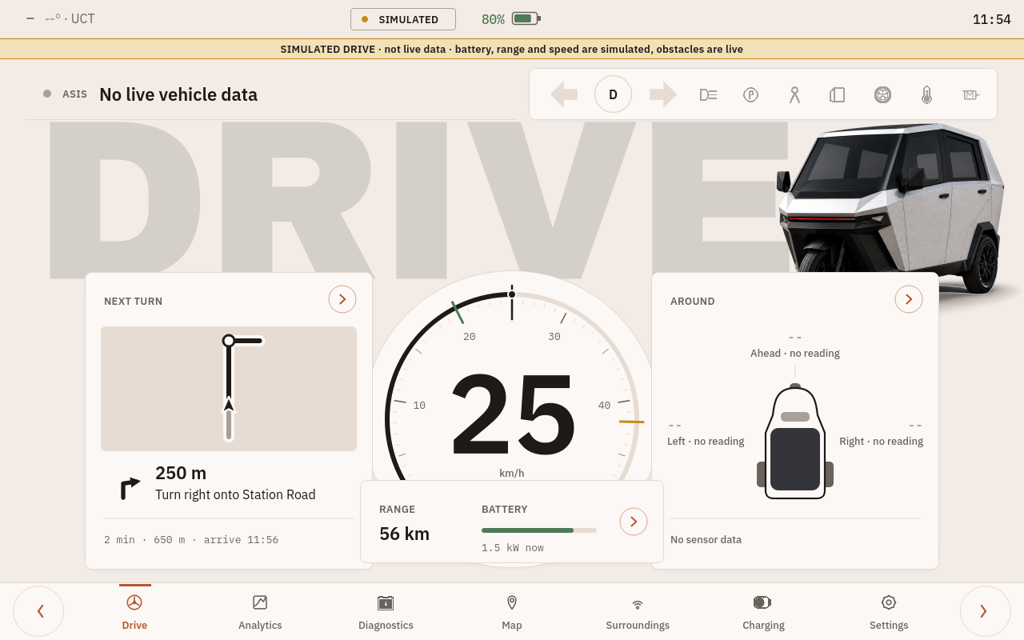
DashboardIntegration/tests/sim_sync/sim_driving.png
