0geder/Tukzie-HPEC-HUD/DashboardIntegration/tests/sim_sync/sim_navigation.png

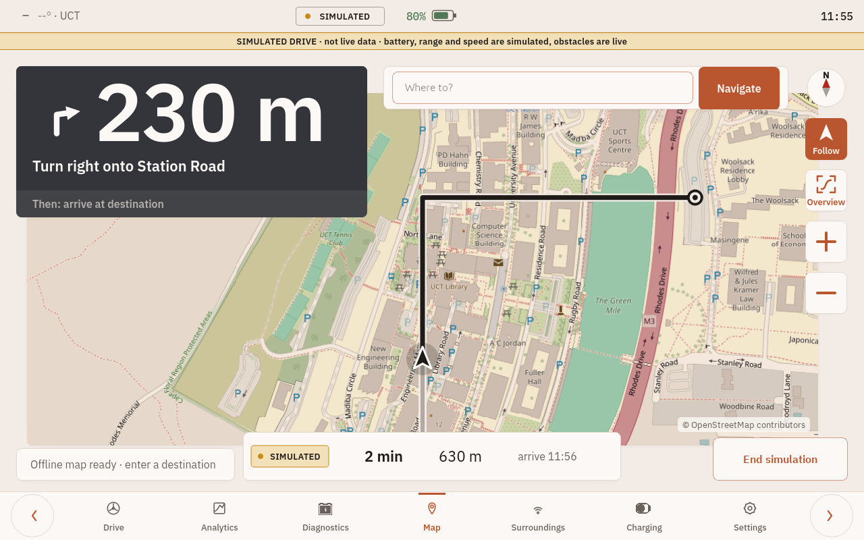
DashboardIntegration/tests/sim_sync/sim_navigation.png
