0geder/Tukzie-HPEC-HUD/DashboardIntegration/tests/sim_sync/sim_sensors.png

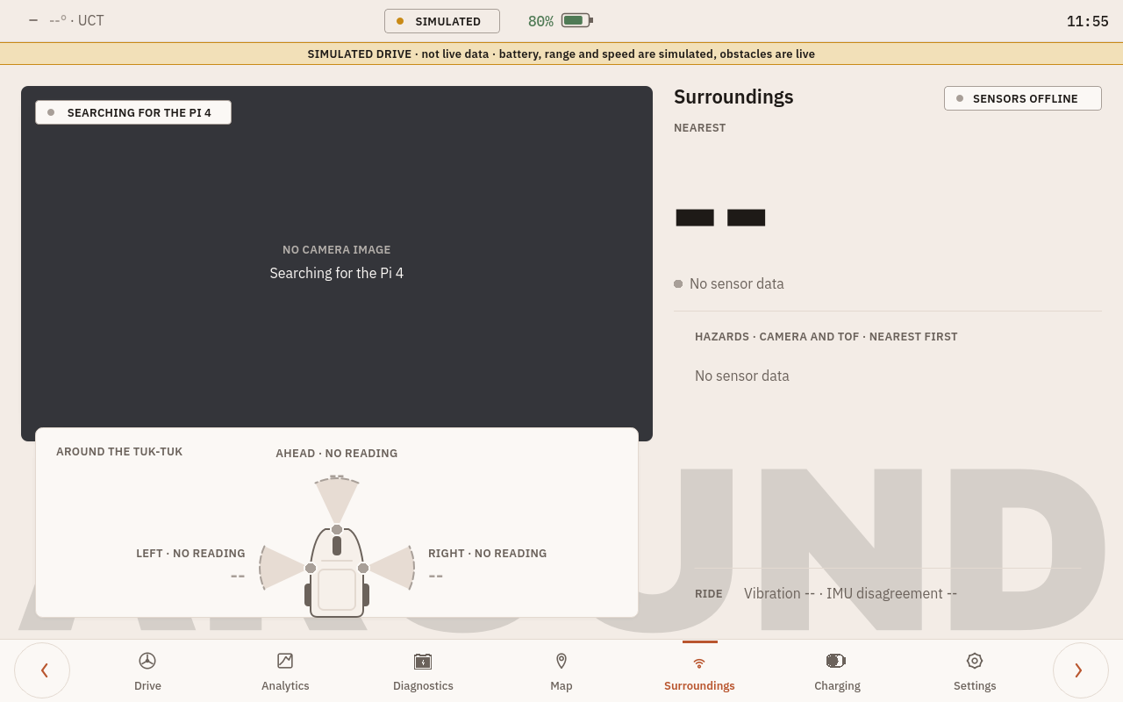
DashboardIntegration/tests/sim_sync/sim_sensors.png
