0geder/Tukzie-HPEC-HUD/DashboardIntegration/tests/style/core/day_map.png

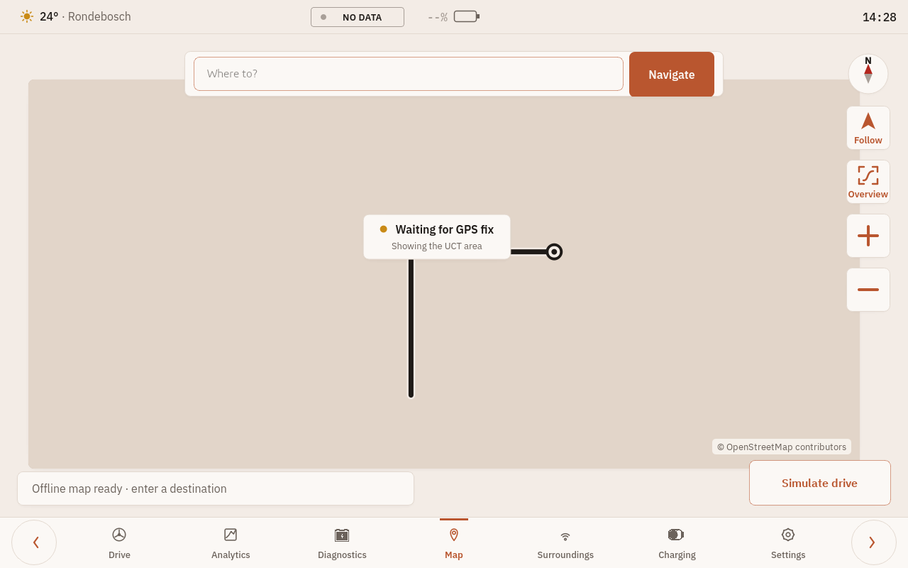
DashboardIntegration/tests/style/core/day_map.png
