0geder/Tukzie-HPEC-HUD/DashboardIntegration/tests/style/core/night_map.png

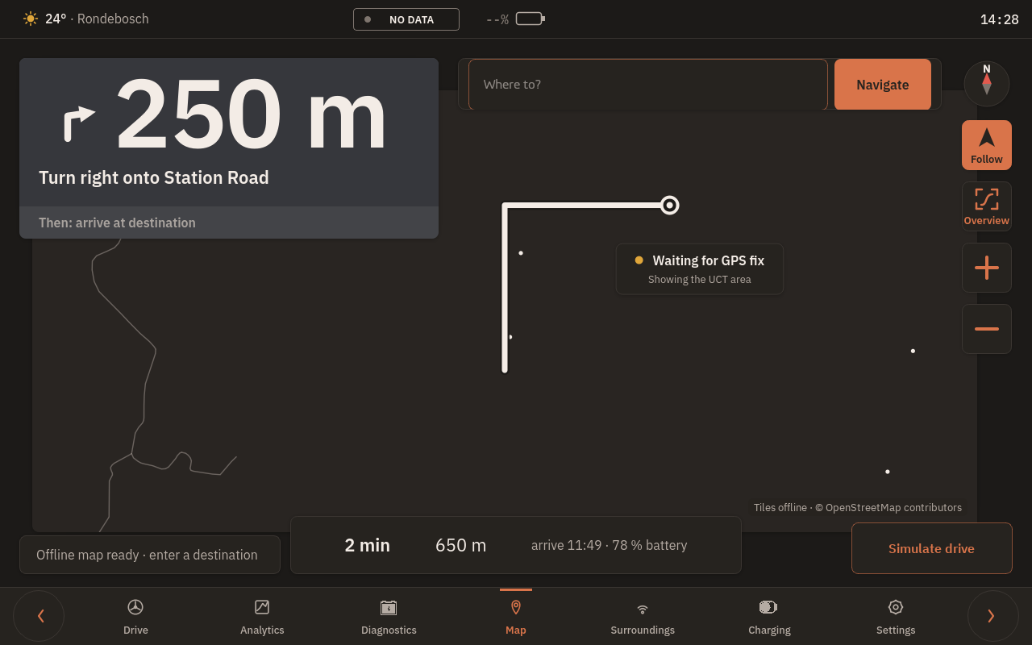
DashboardIntegration/tests/style/core/night_map.png
