0geder/Tukzie-HPEC-HUD/DashboardIntegration/tests/style/core/night_weather_card.png

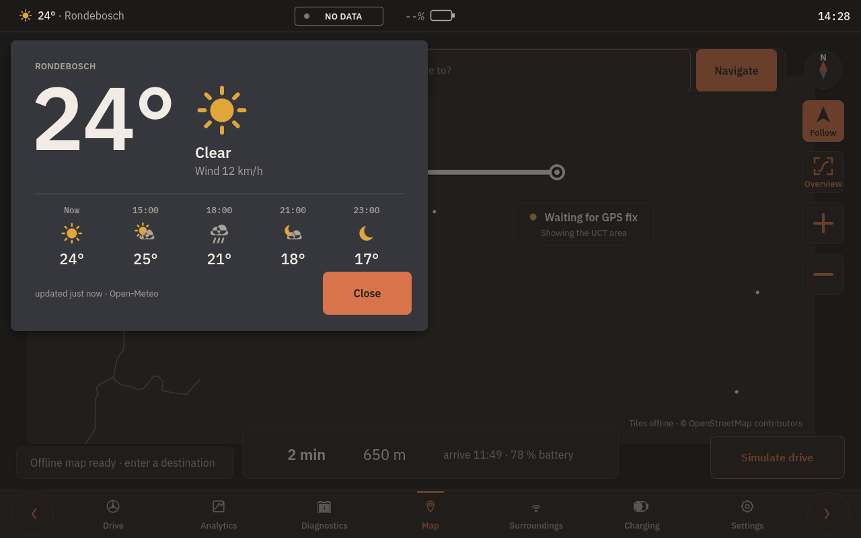
DashboardIntegration/tests/style/core/night_weather_card.png
