0geder/Tukzie-HPEC-HUD/DashboardIntegration/tests/style/core/obstacle_driving.png

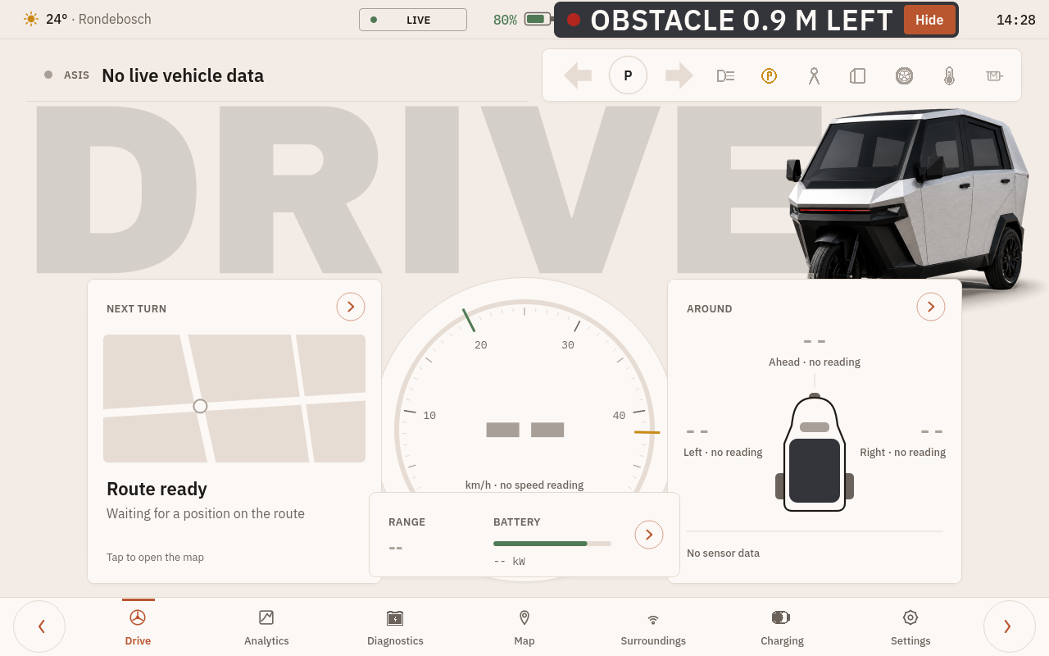
DashboardIntegration/tests/style/core/obstacle_driving.png
