0geder/Tukzie-HPEC-HUD/DashboardIntegration/tests/style/core/simulated_map.png

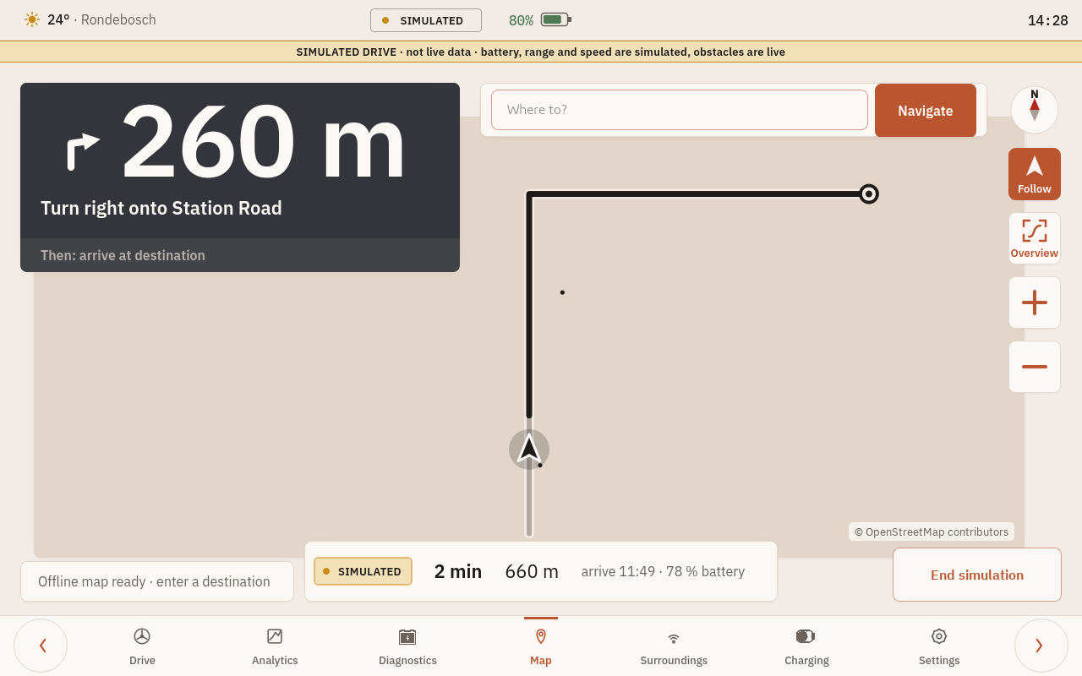
DashboardIntegration/tests/style/core/simulated_map.png
