0geder/Tukzie-HPEC-HUD/DashboardIntegration/tests/style/core/weather_card_driving.png

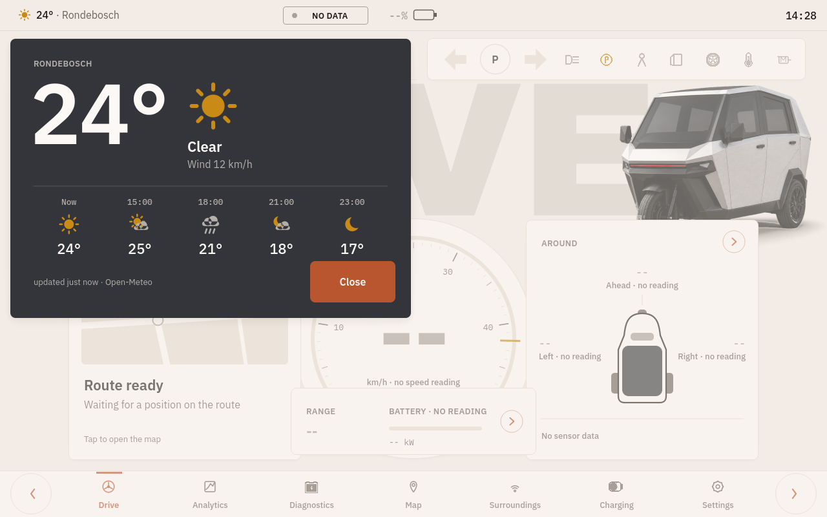
DashboardIntegration/tests/style/core/weather_card_driving.png
