0geder/Tukzie-HPEC-HUD/DashboardIntegration/tests/style/core/weather_card_map.png

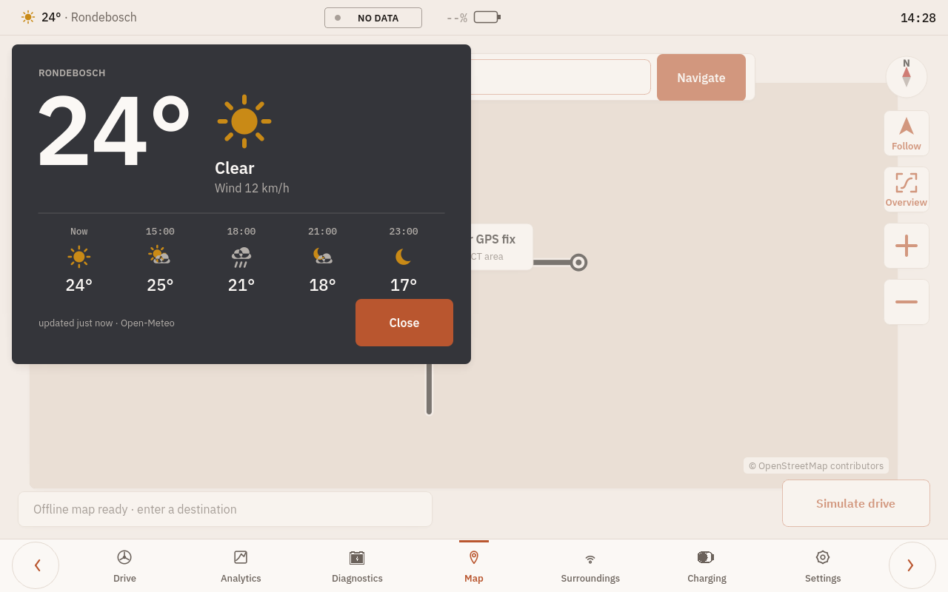
DashboardIntegration/tests/style/core/weather_card_map.png
