0geder/Tukzie-HPEC-HUD/DashboardIntegration/tests/style/drive/day_analytics.png

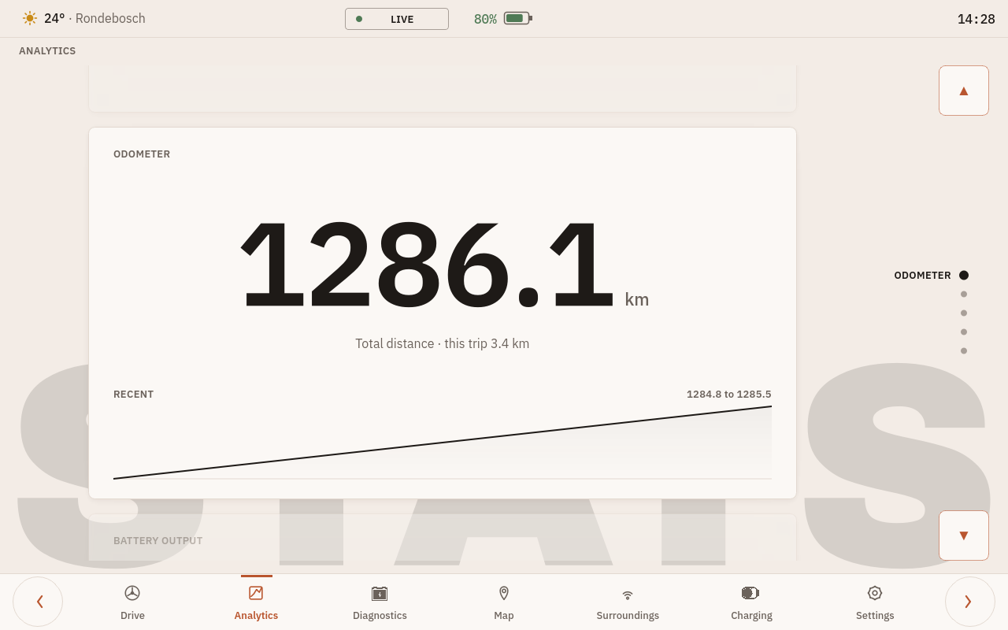
DashboardIntegration/tests/style/drive/day_analytics.png
