0geder/Tukzie-HPEC-HUD/DashboardIntegration/tests/style/drive/day_analytics_graphs_card.png

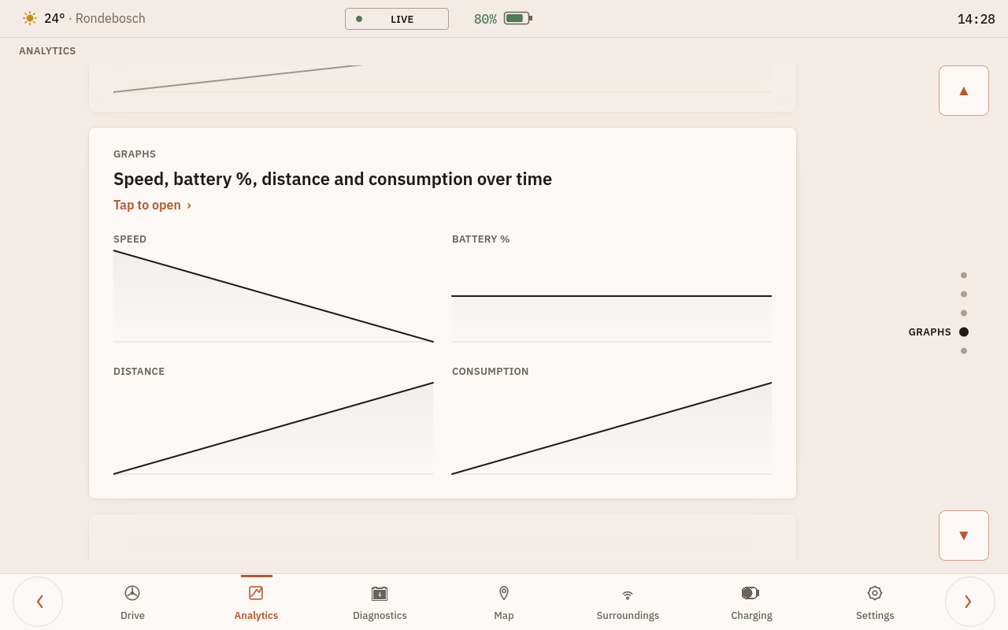
DashboardIntegration/tests/style/drive/day_analytics_graphs_card.png
