0geder/Tukzie-HPEC-HUD/DashboardIntegration/tests/style/drive/day_analytics_power.png

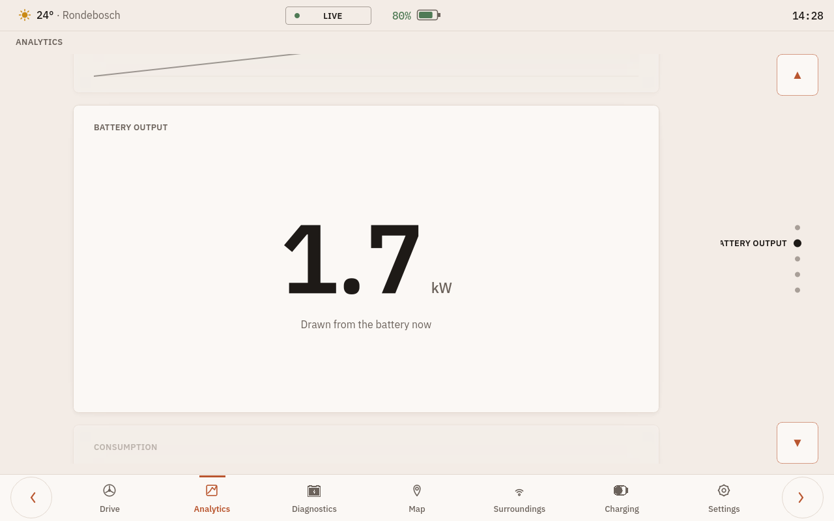
DashboardIntegration/tests/style/drive/day_analytics_power.png
