0geder/Tukzie-HPEC-HUD/DashboardIntegration/tests/style/drive/day_drive.png

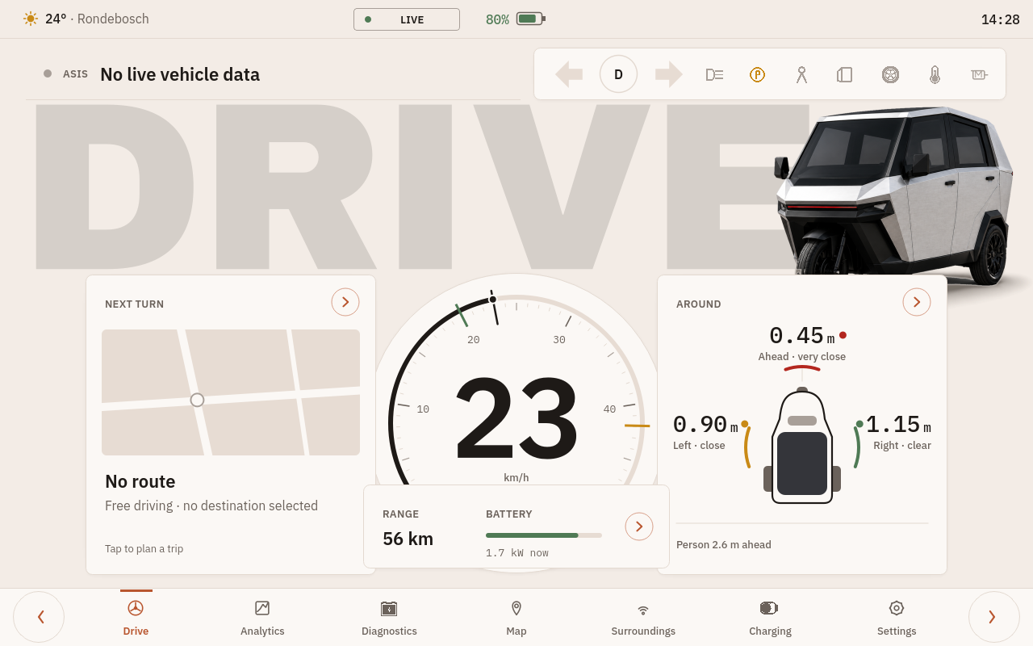
DashboardIntegration/tests/style/drive/day_drive.png
