0geder/Tukzie-HPEC-HUD/DashboardIntegration/tests/style/drive/night_analytics.png

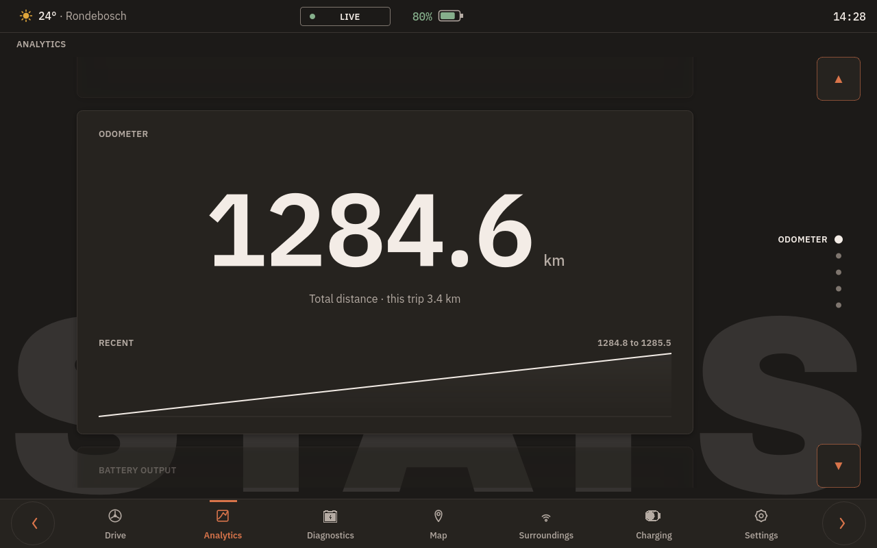
DashboardIntegration/tests/style/drive/night_analytics.png
