0geder/Tukzie-HPEC-HUD/DashboardIntegration/tests/style/drive/night_analytics_graphs.png

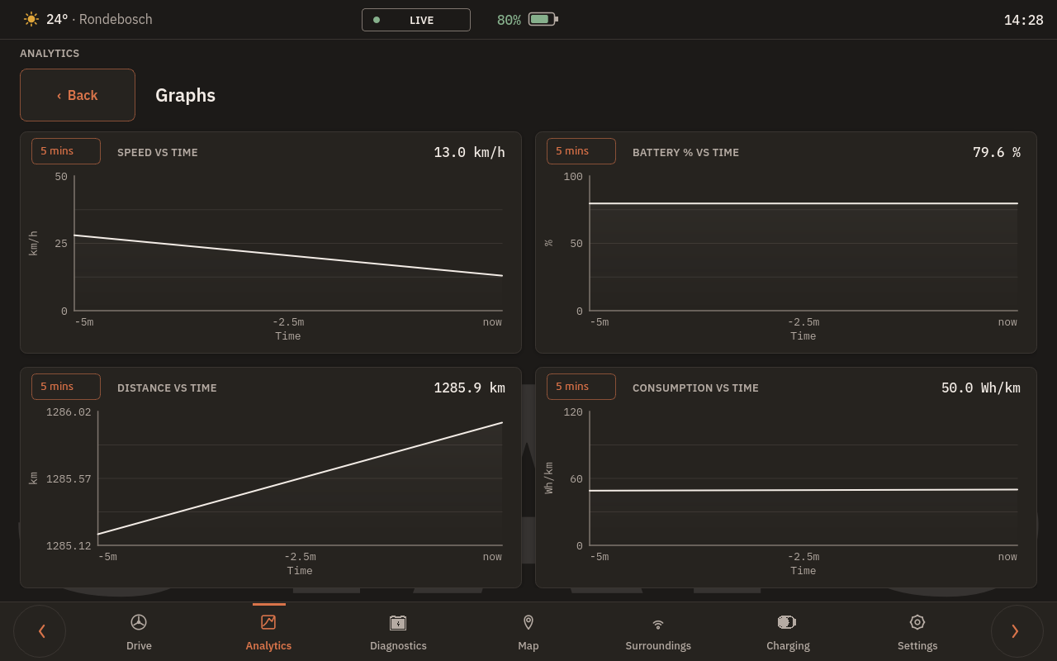
DashboardIntegration/tests/style/drive/night_analytics_graphs.png
