0geder/Tukzie-HPEC-HUD/DashboardIntegration/tests/style/drive/night_drive.png

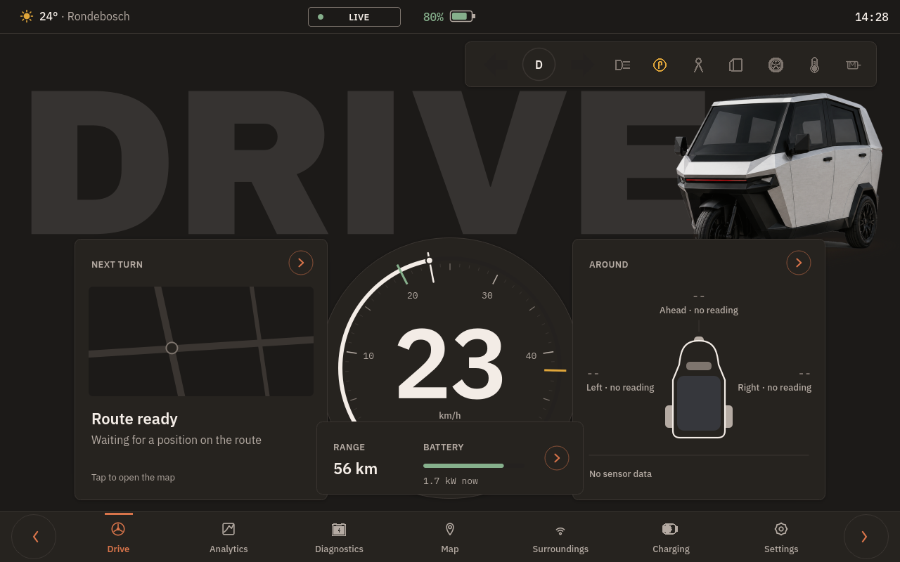
DashboardIntegration/tests/style/drive/night_drive.png
