0geder/Tukzie-HPEC-HUD/DashboardIntegration/tests/style/drive/simulated_analytics.png

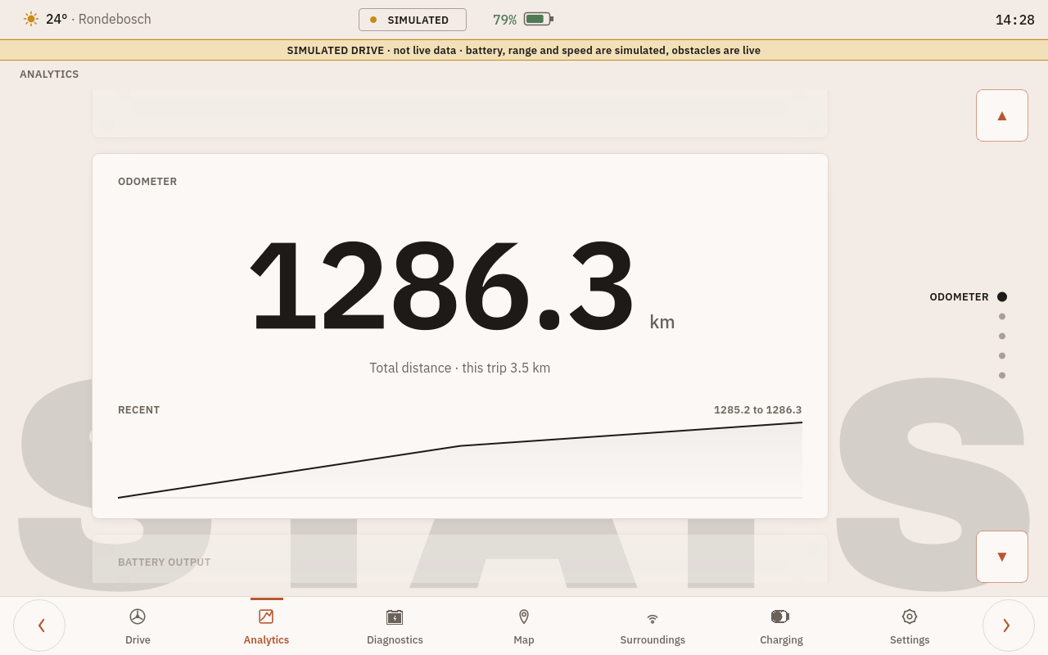
DashboardIntegration/tests/style/drive/simulated_analytics.png
