0geder/Tukzie-HPEC-HUD/DashboardIntegration/tests/style/dualcam/day_surroundings_front.png

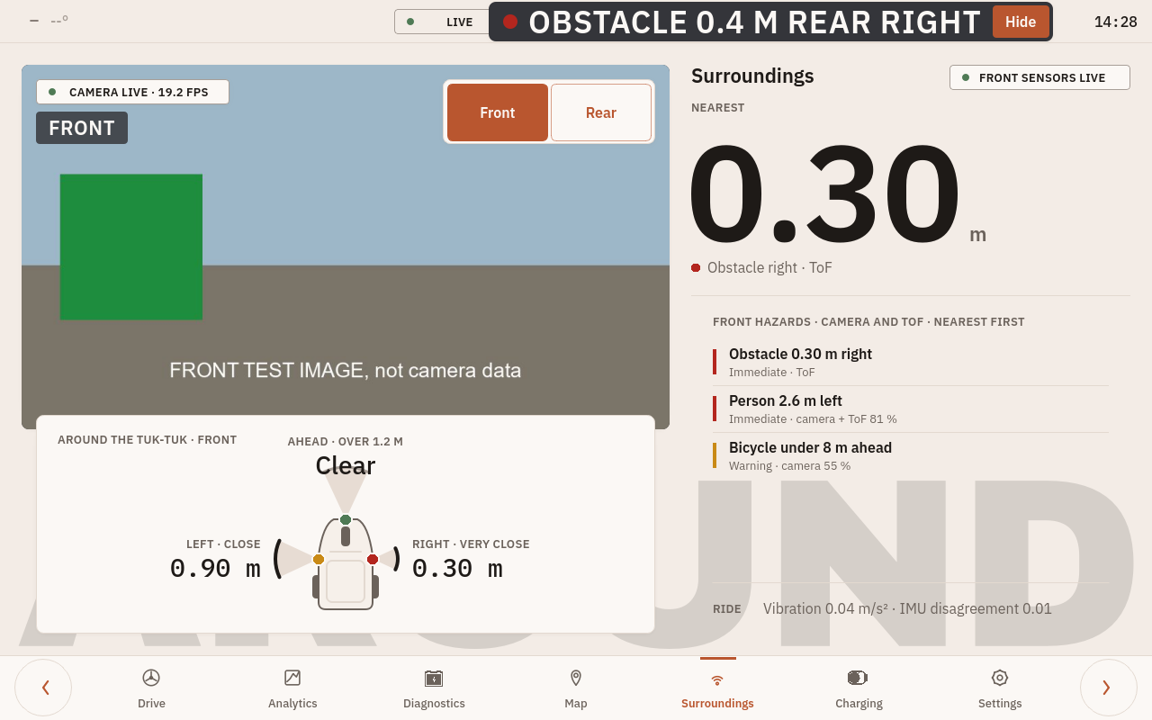
DashboardIntegration/tests/style/dualcam/day_surroundings_front.png
