0geder/Tukzie-HPEC-HUD/DashboardIntegration/tests/style/dualcam/day_surroundings_rear.png

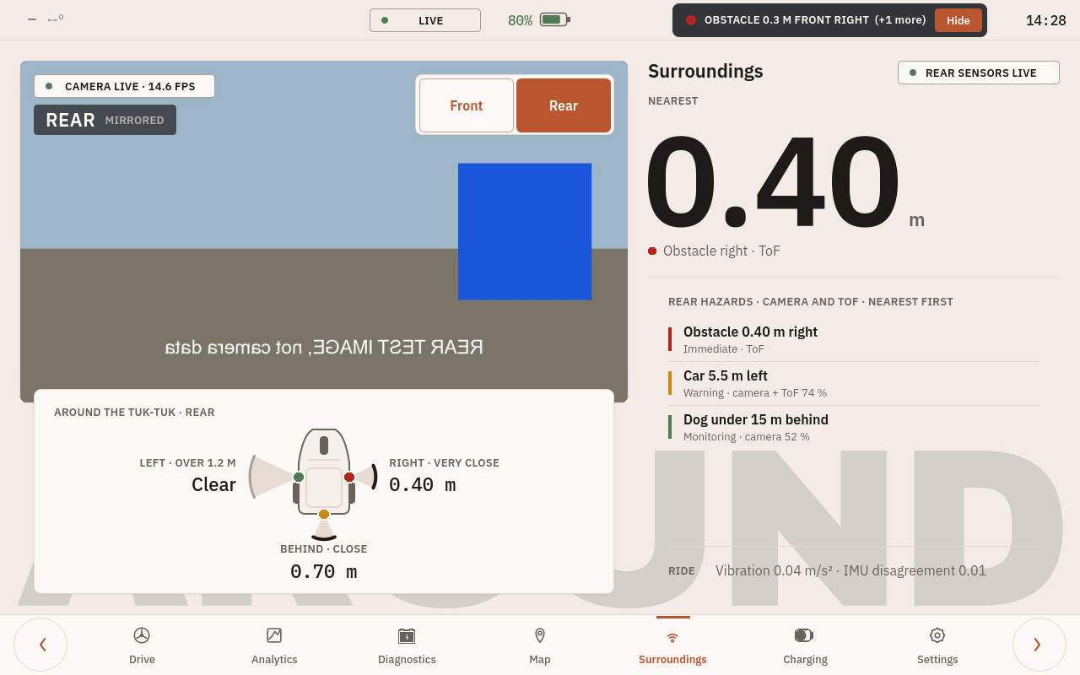
DashboardIntegration/tests/style/dualcam/day_surroundings_rear.png
