0geder/Tukzie-HPEC-HUD/DashboardIntegration/tests/style/dualcam/night_surroundings_front.png

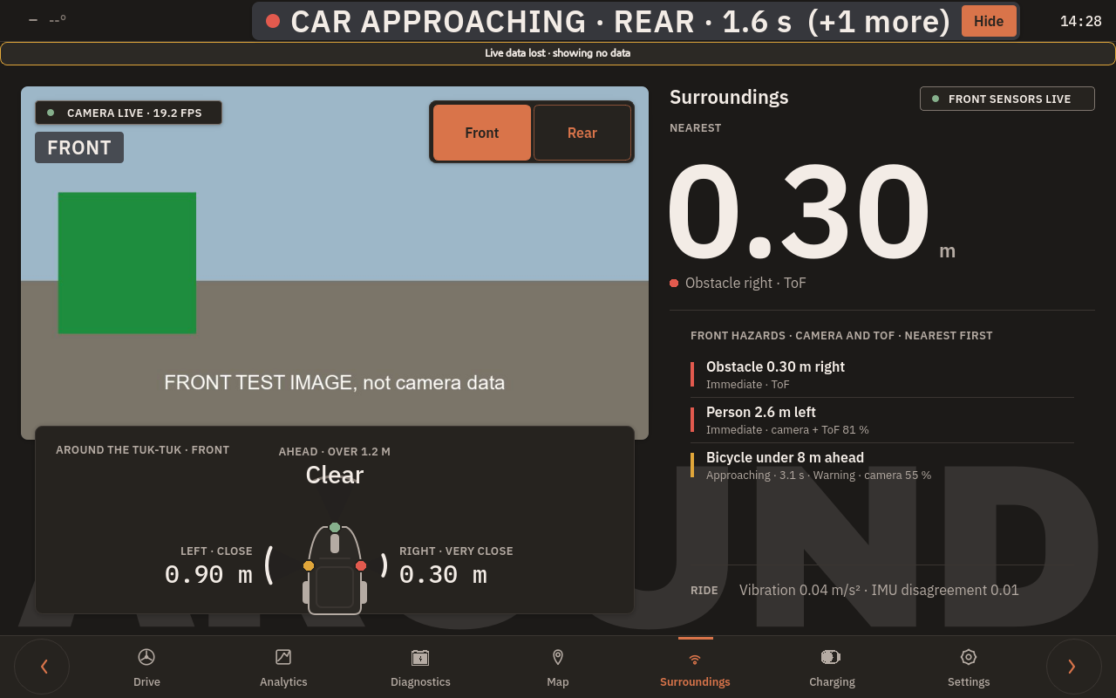
DashboardIntegration/tests/style/dualcam/night_surroundings_front.png
