0geder/Tukzie-HPEC-HUD/DashboardIntegration/tests/style/dualcam/night_surroundings_front_offline.png

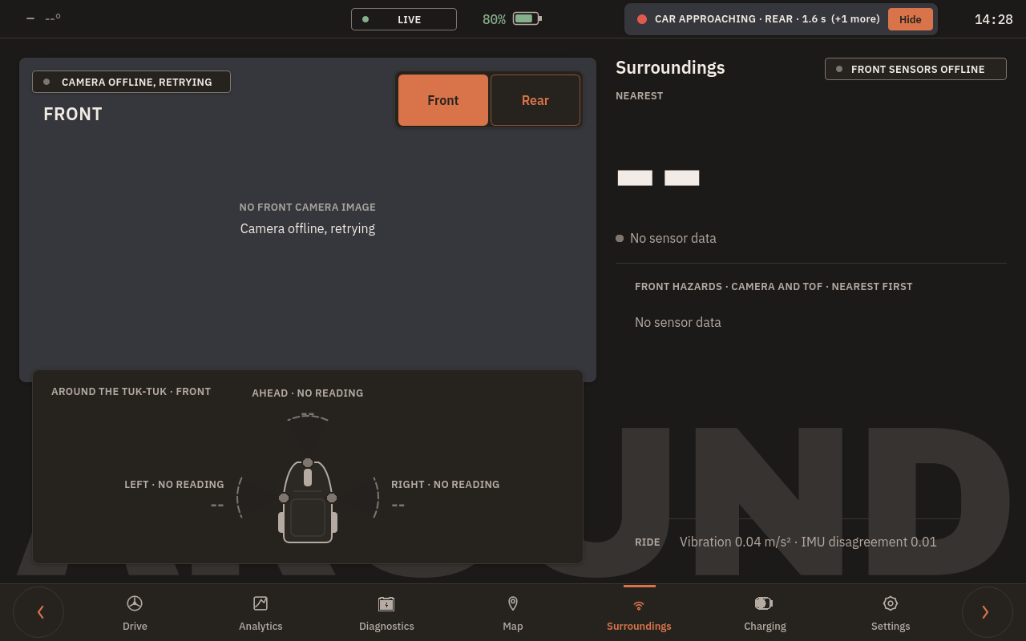
DashboardIntegration/tests/style/dualcam/night_surroundings_front_offline.png
