0geder/Tukzie-HPEC-HUD/DashboardIntegration/tests/style/dualcam/night_surroundings_rear.png

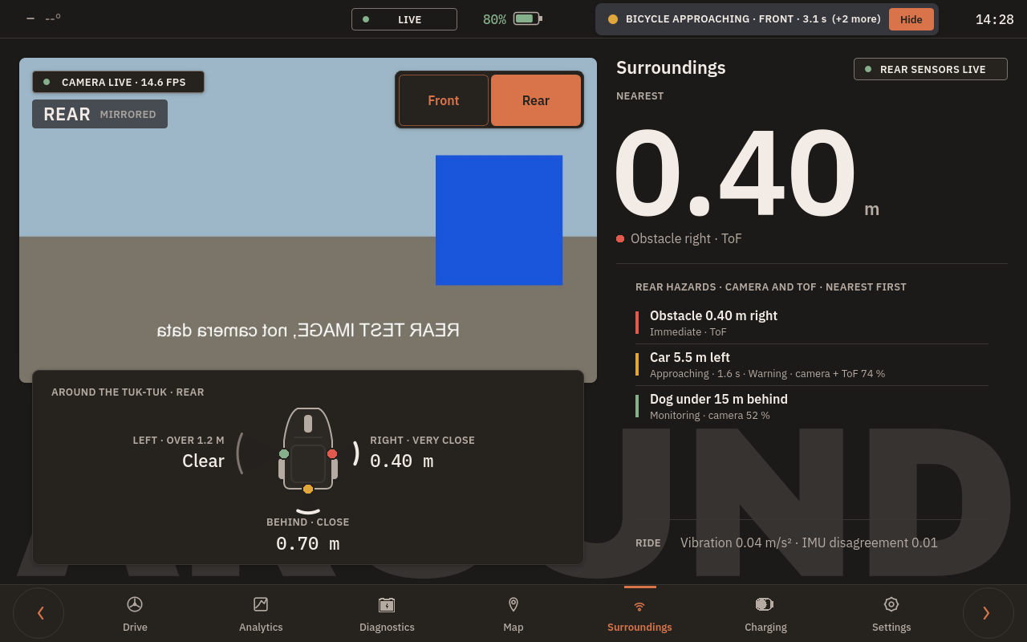
DashboardIntegration/tests/style/dualcam/night_surroundings_rear.png
