0geder/Tukzie-HPEC-HUD/DashboardIntegration/tests/style/map/day.png

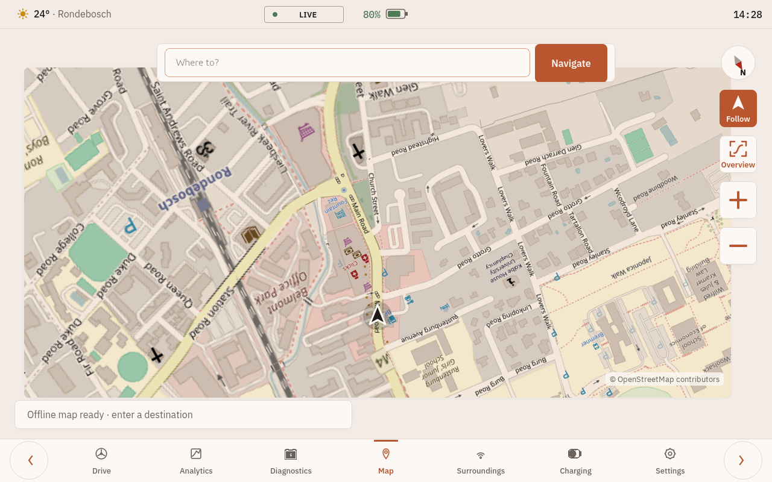
DashboardIntegration/tests/style/map/day.png
