0geder/Tukzie-HPEC-HUD/DashboardIntegration/tests/style/map/keyboard.png

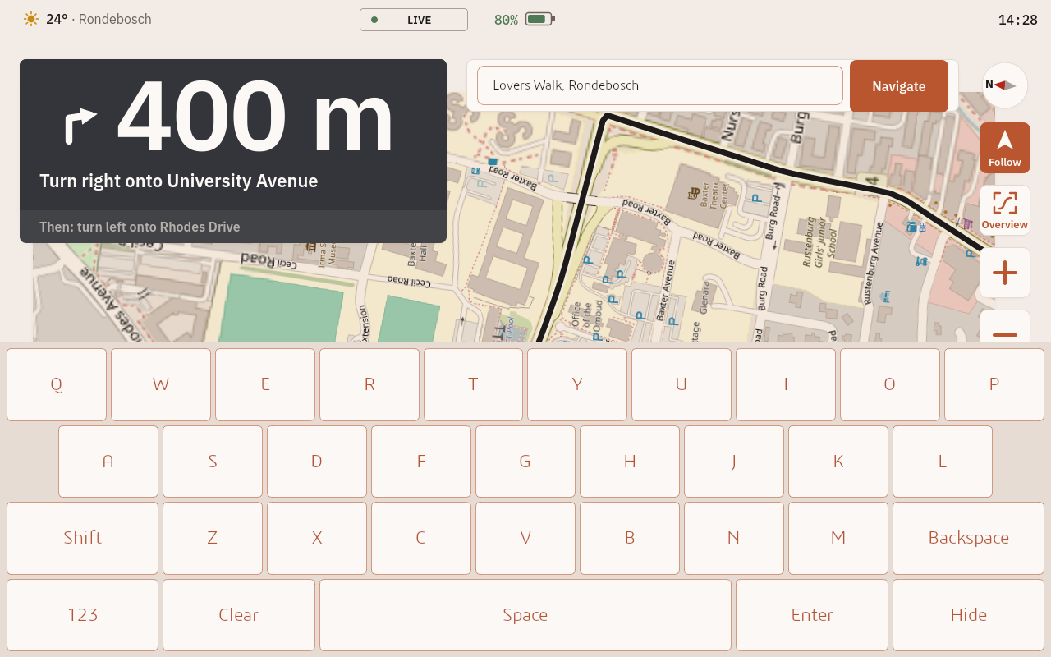
DashboardIntegration/tests/style/map/keyboard.png
