0geder/Tukzie-HPEC-HUD/DashboardIntegration/tests/style/map/navigation.png

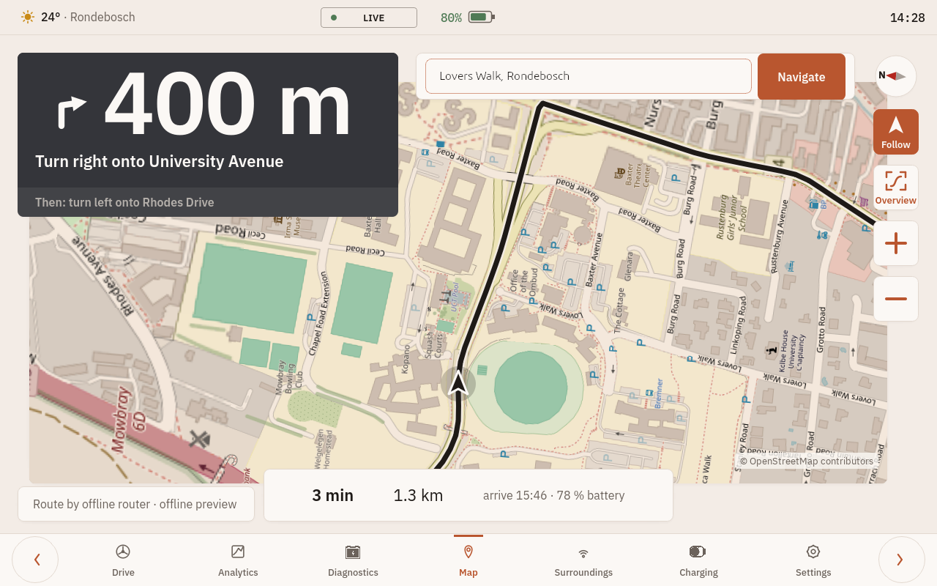
DashboardIntegration/tests/style/map/navigation.png
