0geder/Tukzie-HPEC-HUD/DashboardIntegration/tests/style/map/night.png

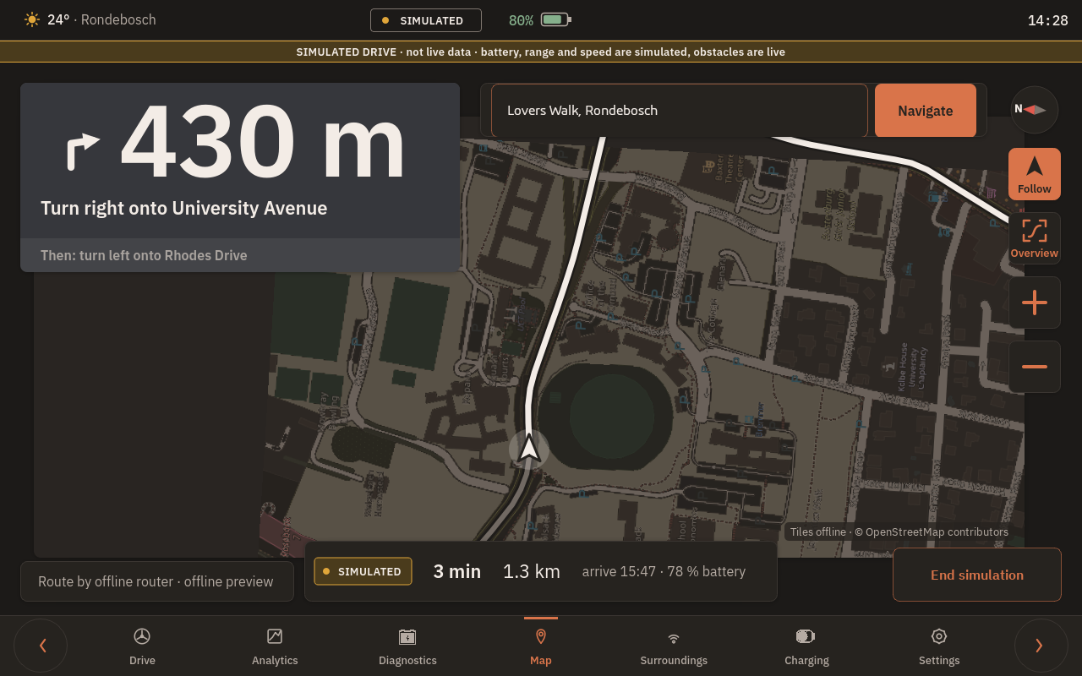
DashboardIntegration/tests/style/map/night.png
