0geder/Tukzie-HPEC-HUD/DashboardIntegration/tests/style/map/settings_day_end.png

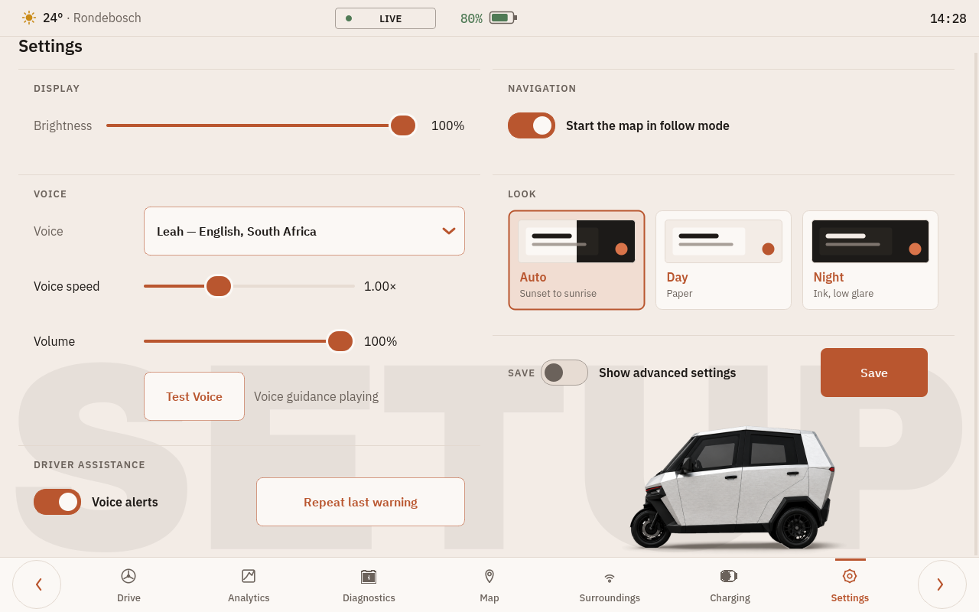
DashboardIntegration/tests/style/map/settings_day_end.png
