0geder/Tukzie-HPEC-HUD/DashboardIntegration/tests/style/map/settings_night.png

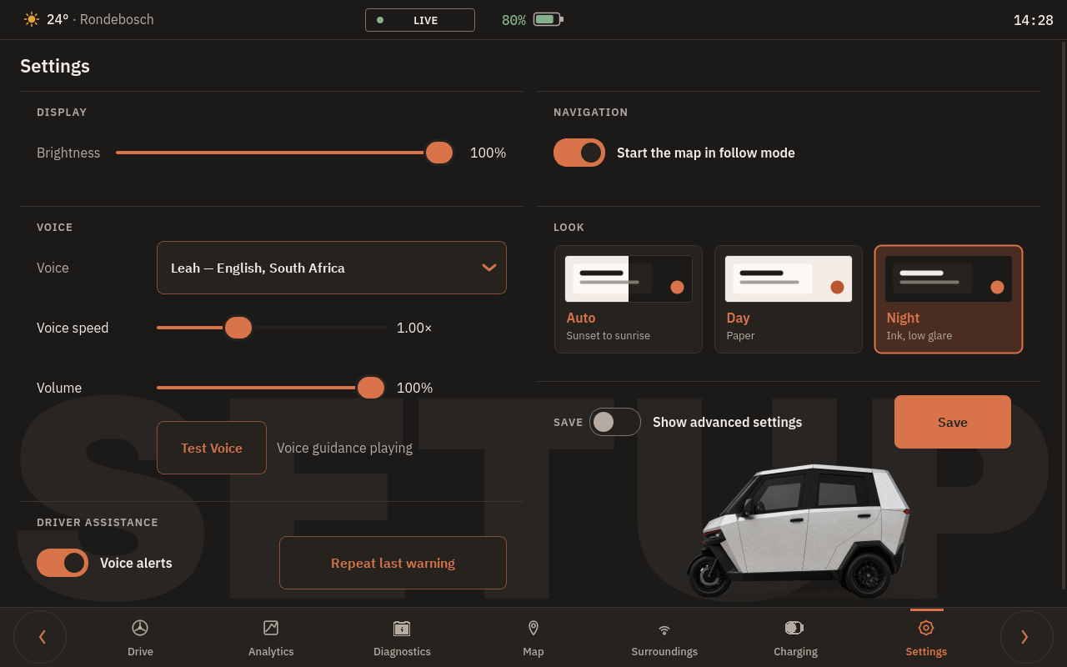
DashboardIntegration/tests/style/map/settings_night.png
