0geder/Tukzie-HPEC-HUD/DashboardIntegration/tests/style/map/simulated.png

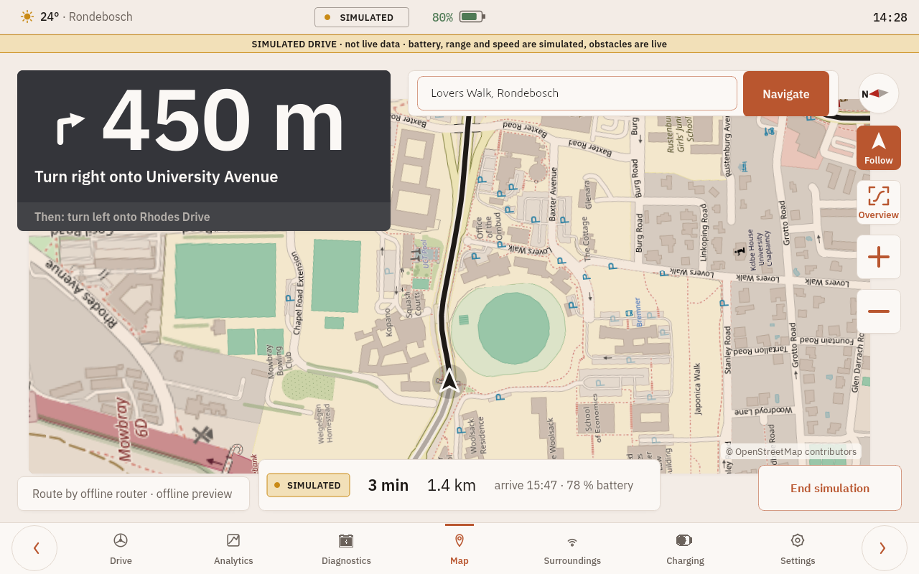
DashboardIntegration/tests/style/map/simulated.png
