0geder/Tukzie-HPEC-HUD/DashboardIntegration/tests/style/map/tilt.png

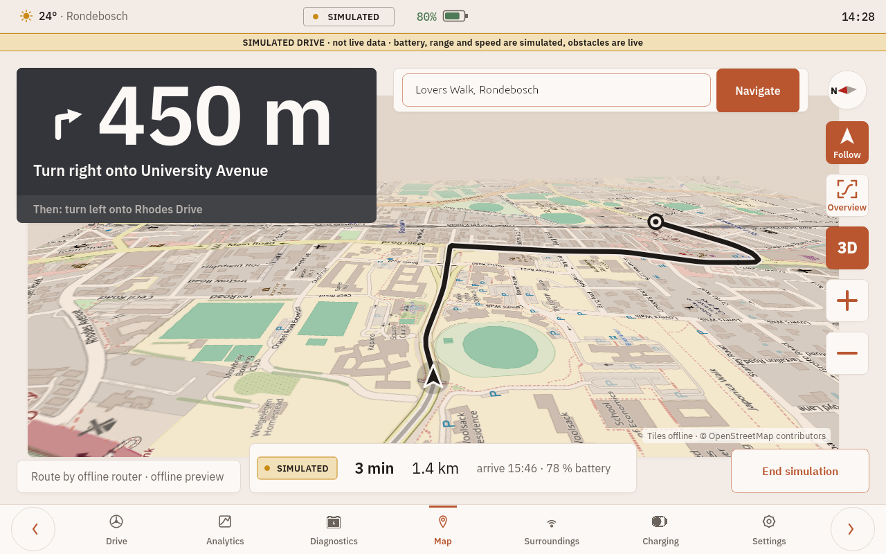
DashboardIntegration/tests/style/map/tilt.png
