0geder/Tukzie-HPEC-HUD/DashboardIntegration/tests/style/pages/day_diagnostics_details.png

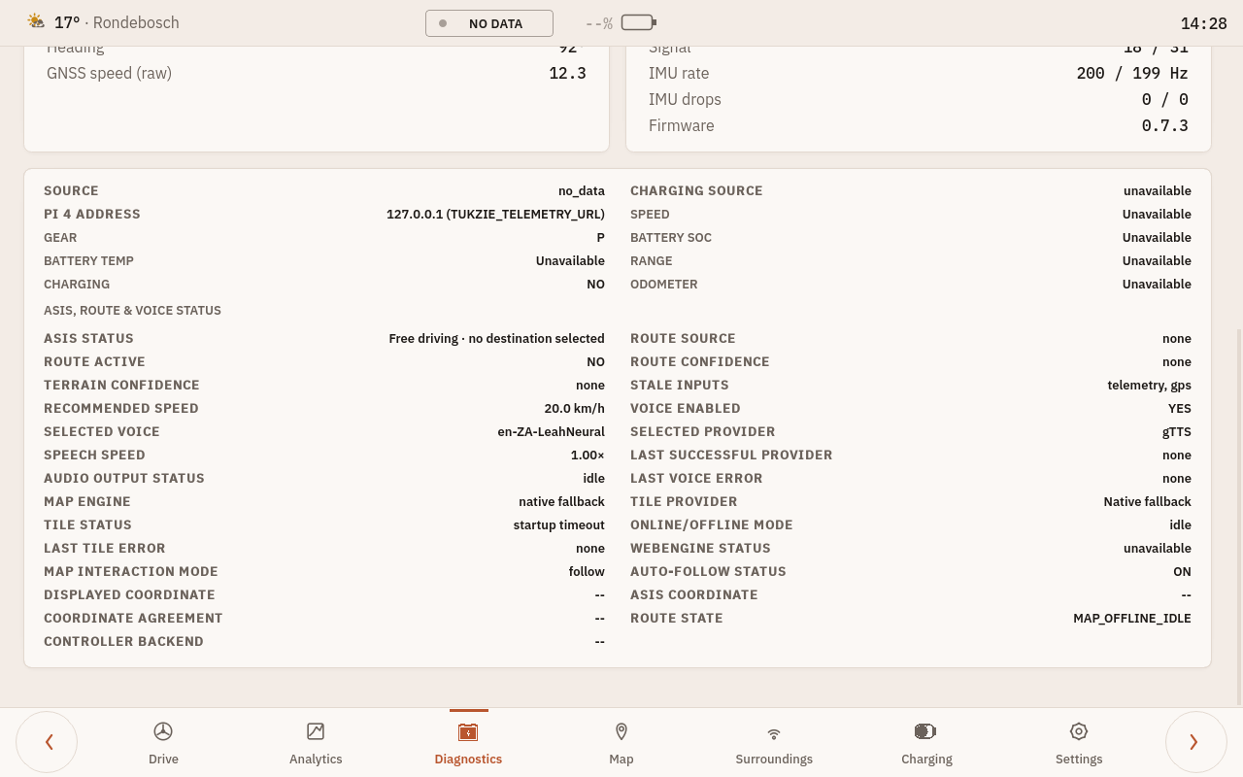
DashboardIntegration/tests/style/pages/day_diagnostics_details.png
