0geder/Tukzie-HPEC-HUD/DashboardIntegration/tests/style/pages/day_surroundings.png

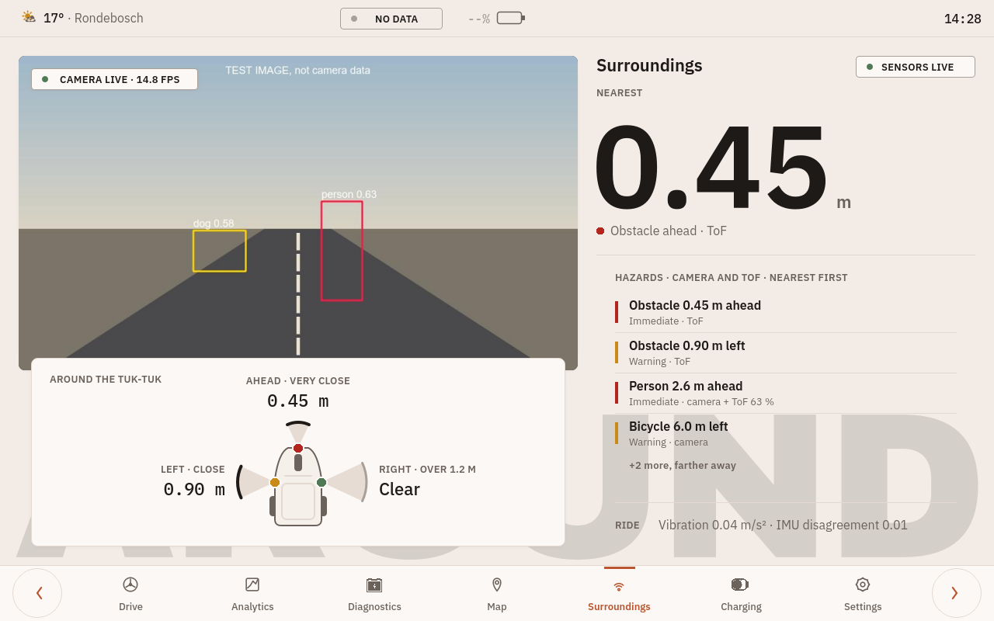
DashboardIntegration/tests/style/pages/day_surroundings.png
