0geder/Tukzie-HPEC-HUD/DashboardIntegration/tests/style/pages/night_charging.png

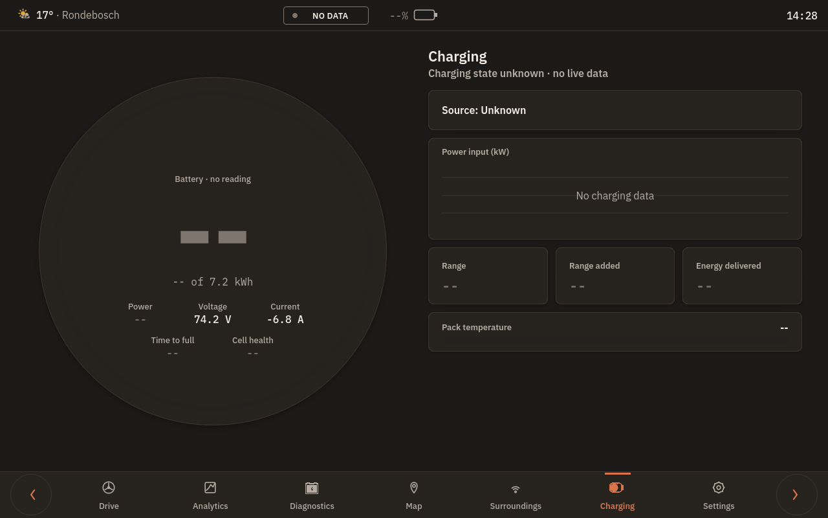
DashboardIntegration/tests/style/pages/night_charging.png
