0geder/Tukzie-HPEC-HUD/DashboardIntegration/tests/style/pages/night_diagnostics.png

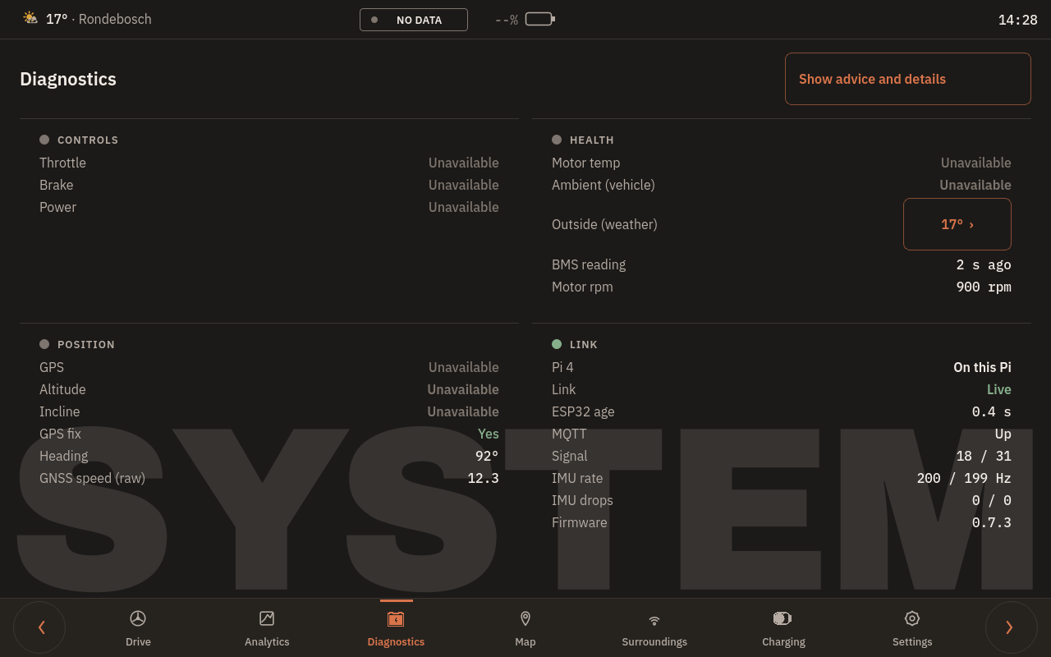
DashboardIntegration/tests/style/pages/night_diagnostics.png
