0geder/Tukzie-HPEC-HUD/DashboardIntegration/tests/style/pages/night_surroundings.png

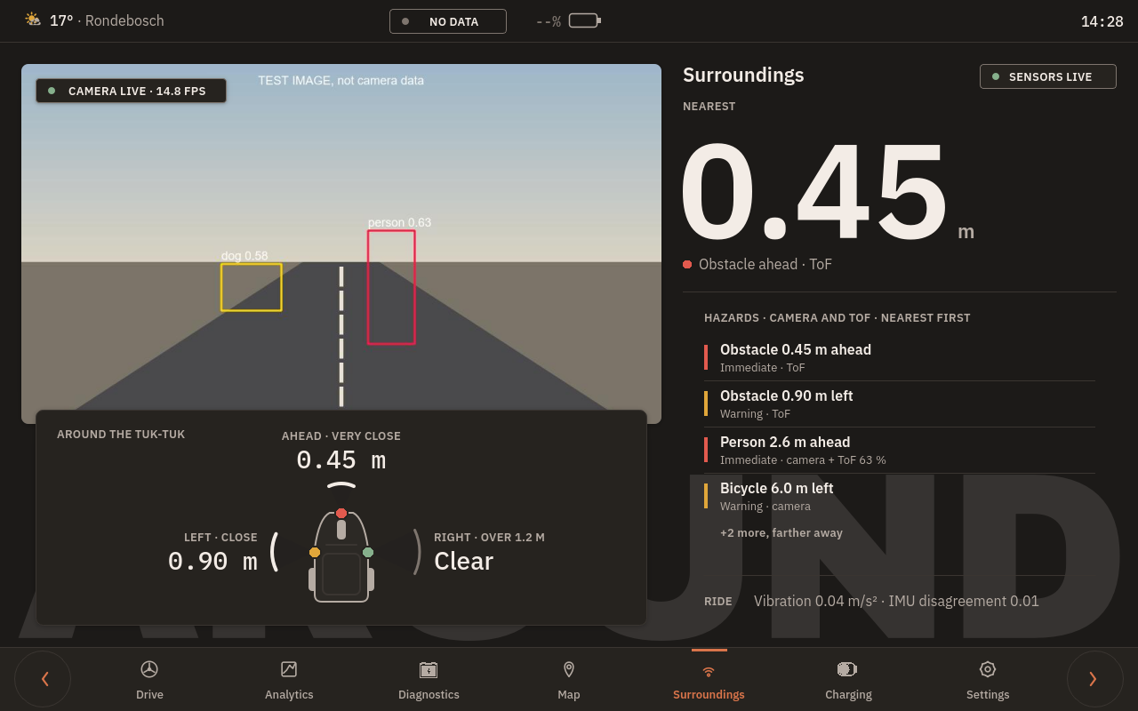
DashboardIntegration/tests/style/pages/night_surroundings.png
