0geder/Tukzie-HPEC-HUD/DashboardIntegration/tests/style/pages/simulated_surroundings.png

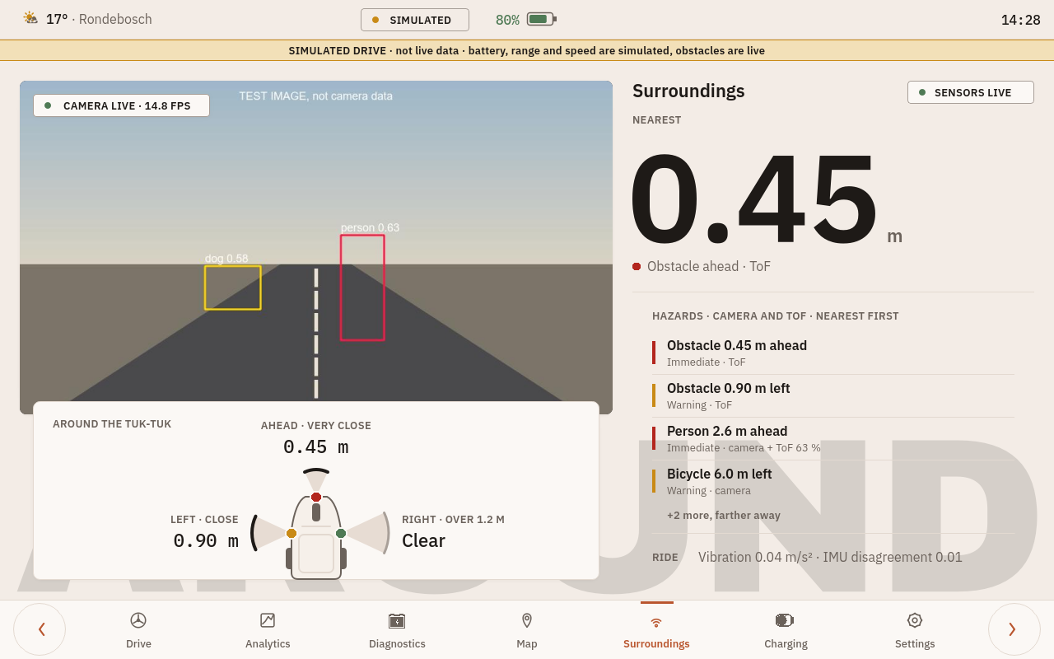
DashboardIntegration/tests/style/pages/simulated_surroundings.png
