0geder/Tukzie-HPEC-HUD/DashboardIntegration/tests/style/planes/night_diagnostics.png

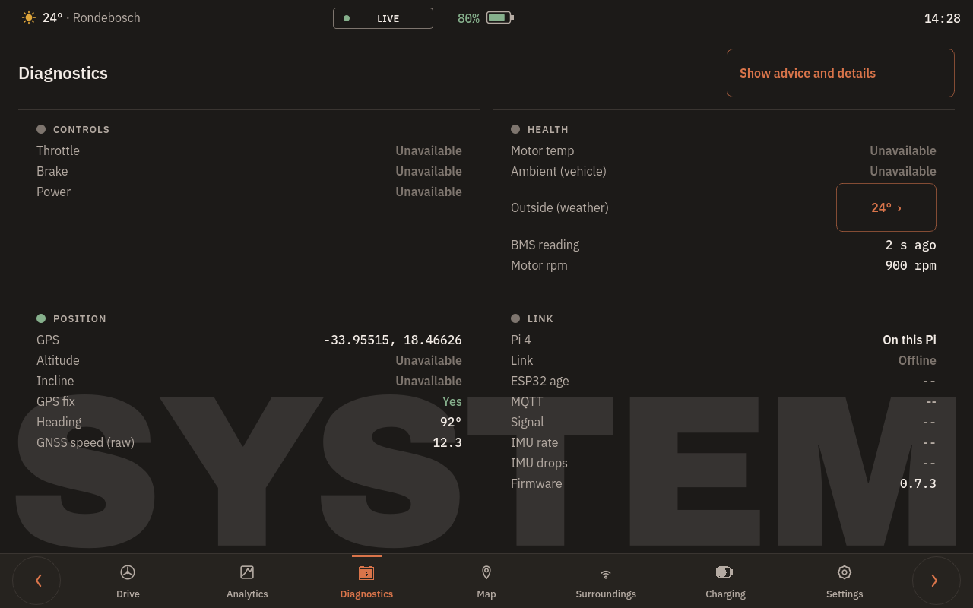
DashboardIntegration/tests/style/planes/night_diagnostics.png
