0geder/Tukzie-HPEC-HUD/DashboardIntegration/tests/style/planes/night_drive.png

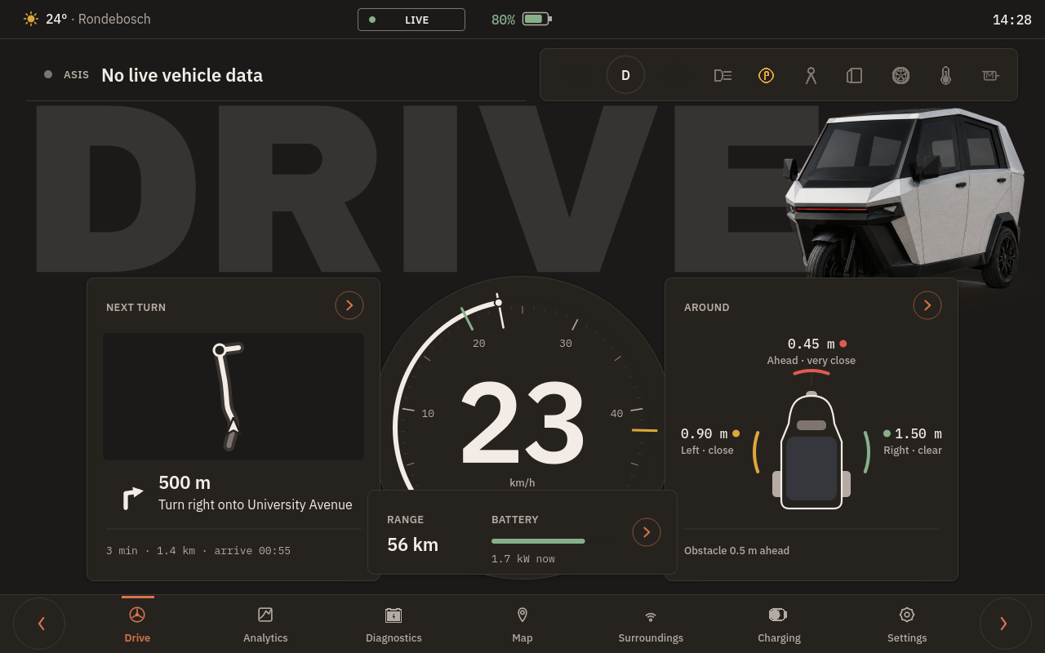
DashboardIntegration/tests/style/planes/night_drive.png
