0geder/Tukzie-HPEC-HUD/DashboardIntegration/tests/style/refine/after_day_diagnostics.png

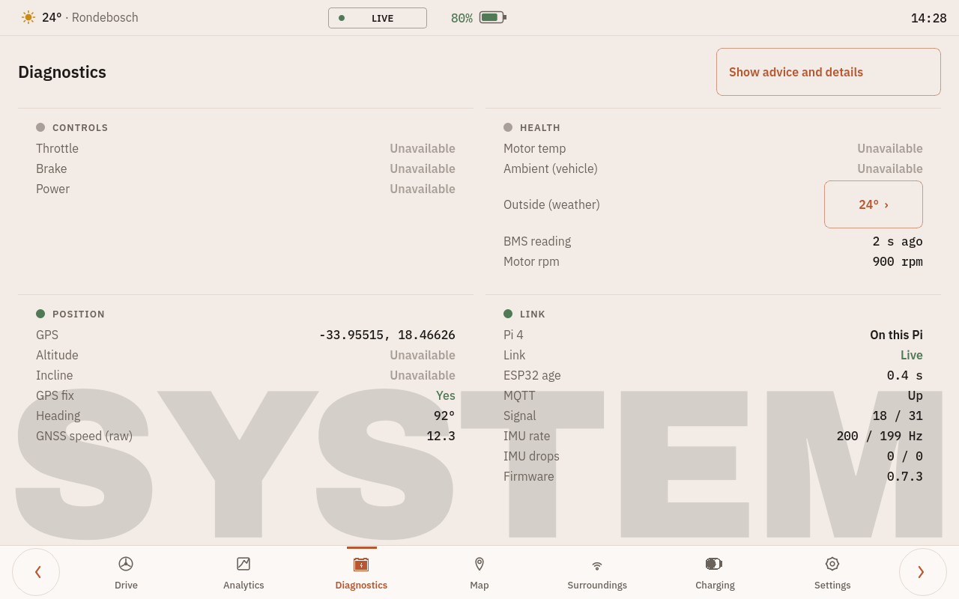
DashboardIntegration/tests/style/refine/after_day_diagnostics.png
