0geder/Tukzie-HPEC-HUD/DashboardIntegration/tests/style/refine/after_day_surroundings.png

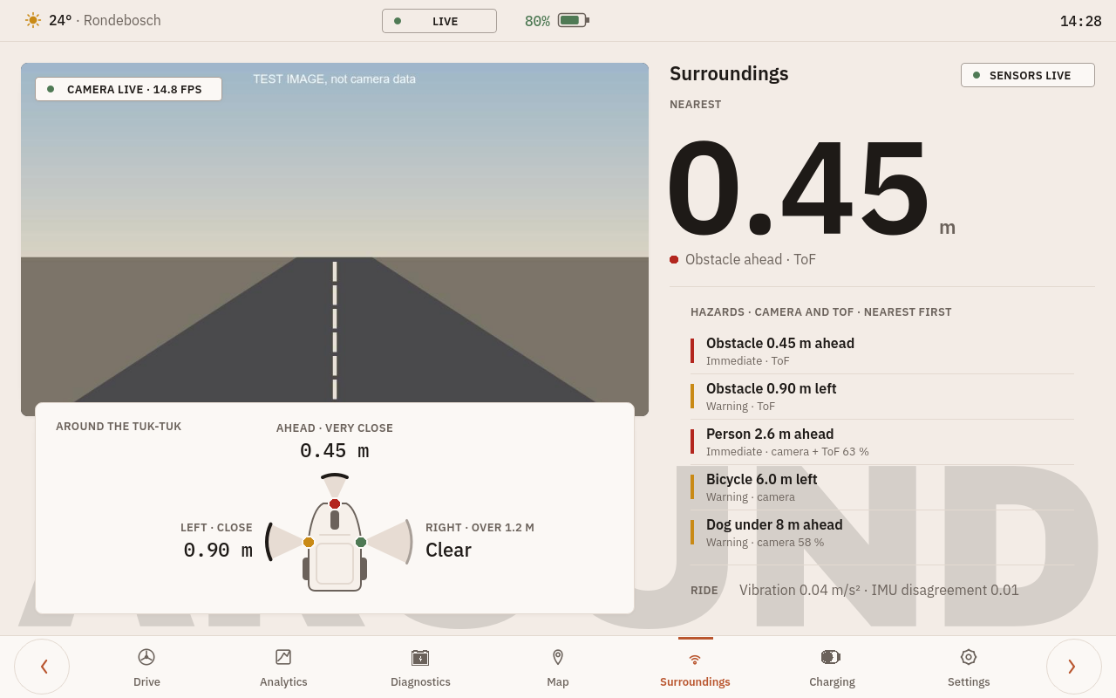
DashboardIntegration/tests/style/refine/after_day_surroundings.png
