0geder/Tukzie-HPEC-HUD/DashboardIntegration/tests/style/refine/after_night_analytics.png

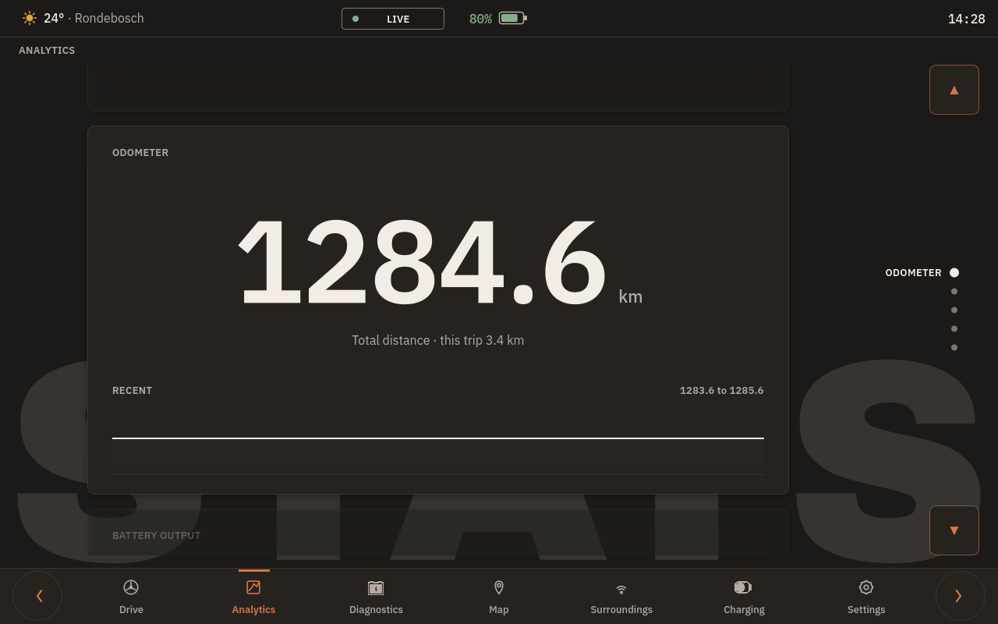
DashboardIntegration/tests/style/refine/after_night_analytics.png
