0geder/Tukzie-HPEC-HUD/DashboardIntegration/tests/style/refine/after_night_charging.png

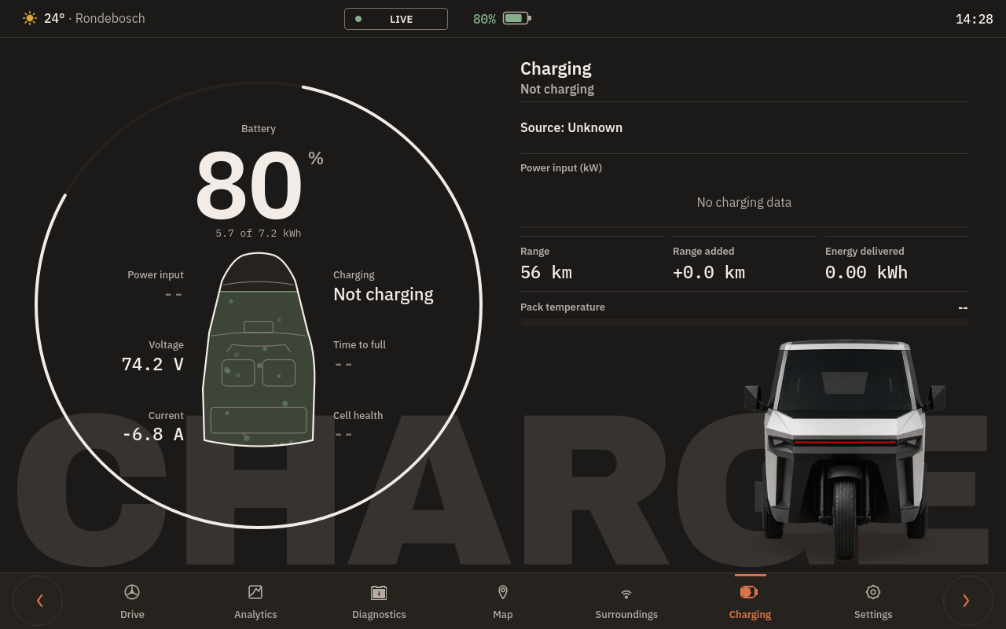
DashboardIntegration/tests/style/refine/after_night_charging.png
