0geder/Tukzie-HPEC-HUD/DashboardIntegration/tests/style/refine/after_night_map.png

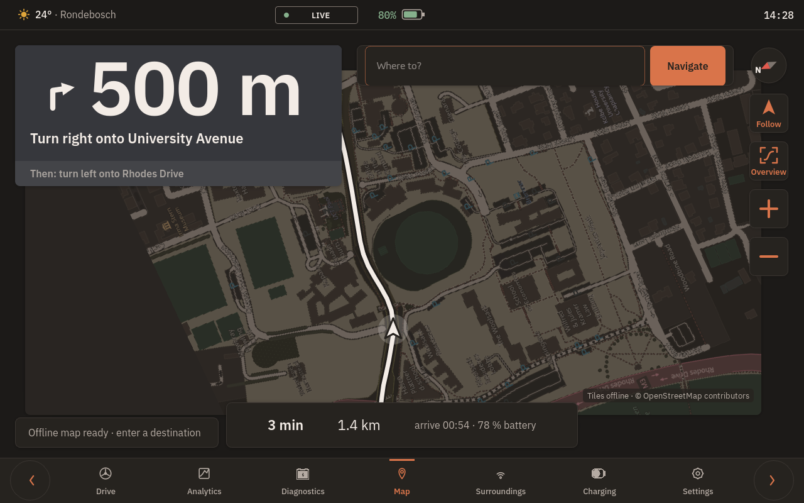
DashboardIntegration/tests/style/refine/after_night_map.png
