0geder/Tukzie-HPEC-HUD/DashboardIntegration/tests/style/refine/after_night_settings.png

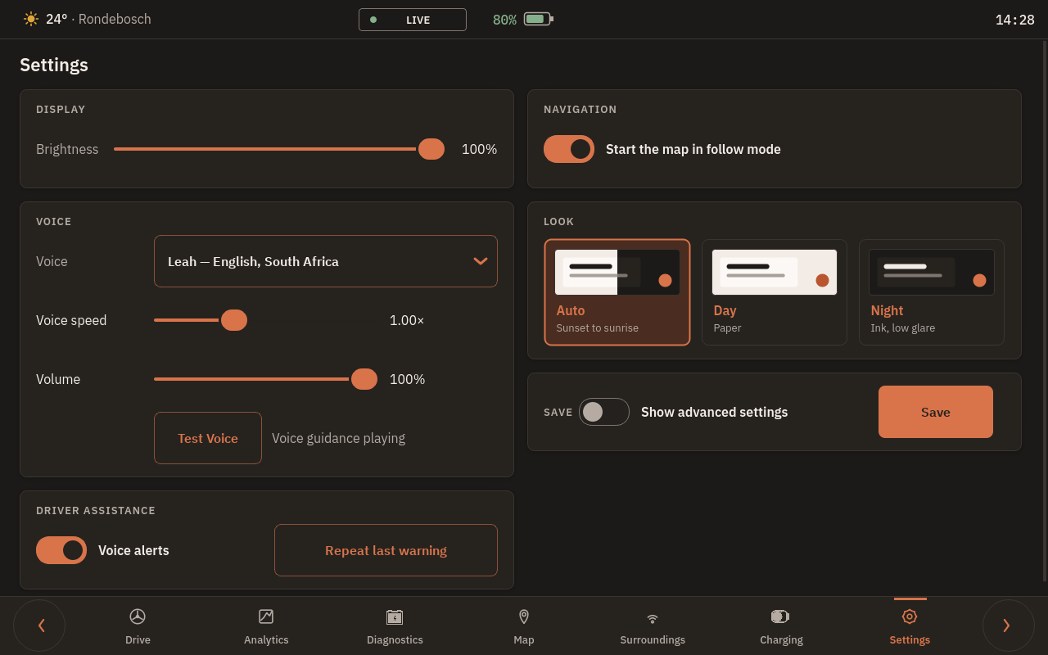
DashboardIntegration/tests/style/refine/after_night_settings.png
