0geder/Tukzie-HPEC-HUD/DashboardIntegration/tests/style/refine/after_night_surroundings.png

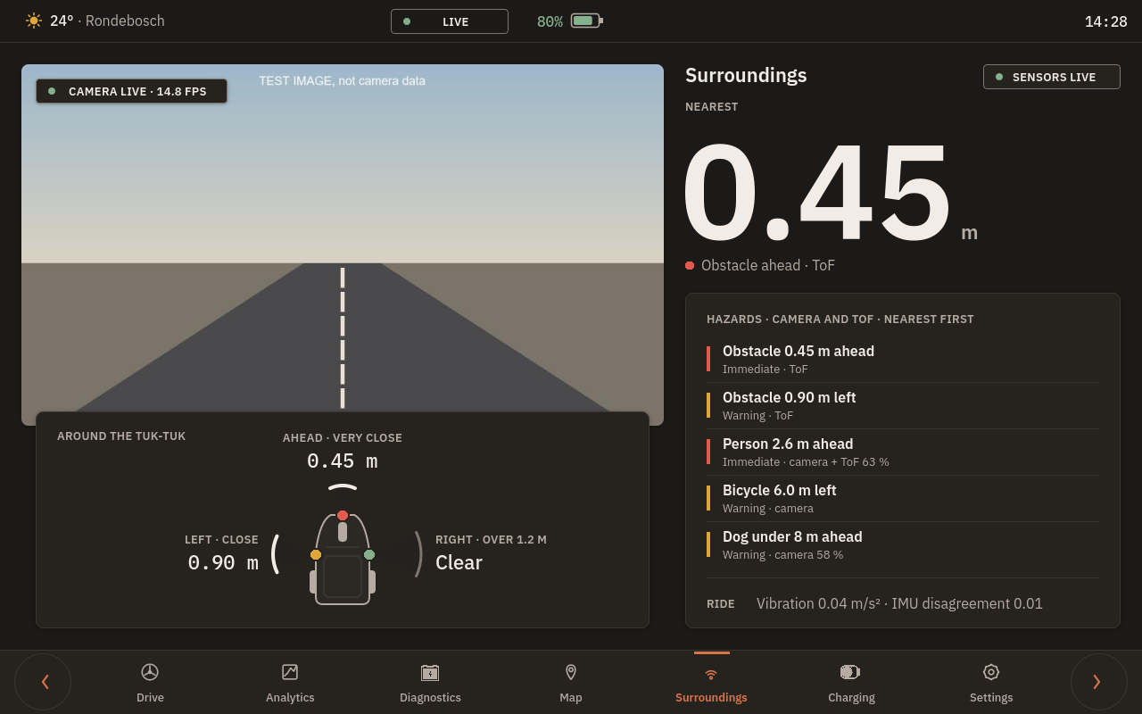
DashboardIntegration/tests/style/refine/after_night_surroundings.png
