0geder/Tukzie-HPEC-HUD/DashboardIntegration/tests/style/refine/before_day_analytics.png

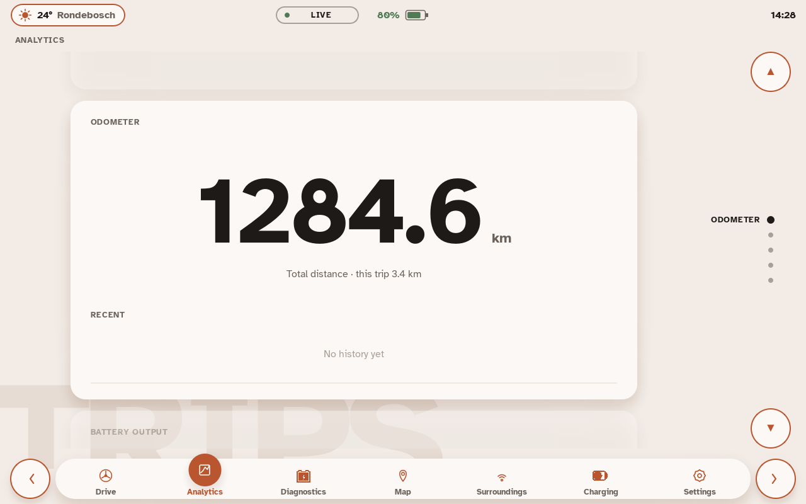
DashboardIntegration/tests/style/refine/before_day_analytics.png
