0geder/Tukzie-HPEC-HUD/DashboardIntegration/tests/style/refine/before_day_charging.png

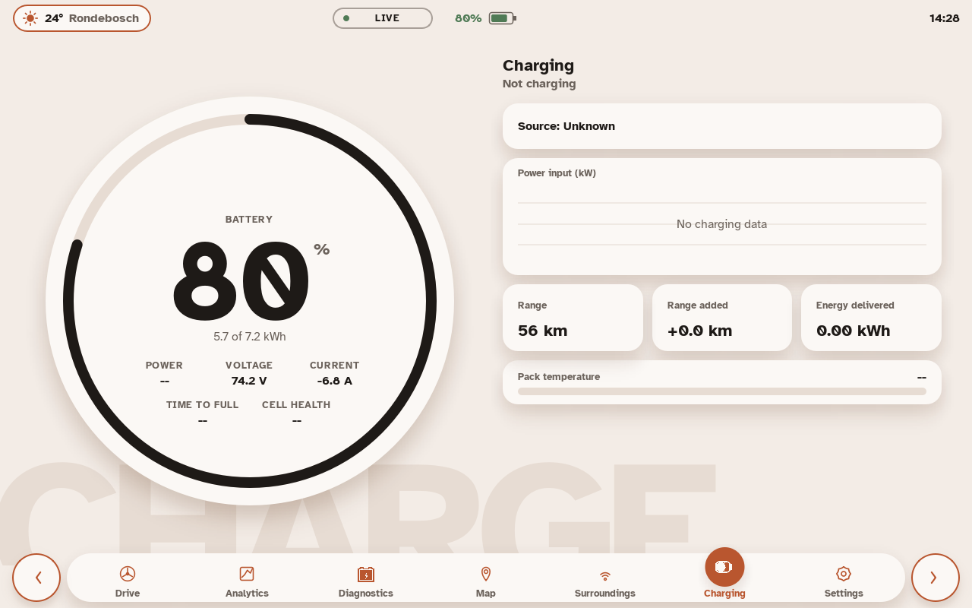
DashboardIntegration/tests/style/refine/before_day_charging.png
