0geder/Tukzie-HPEC-HUD/DashboardIntegration/tests/style/refine/before_day_diagnostics.png

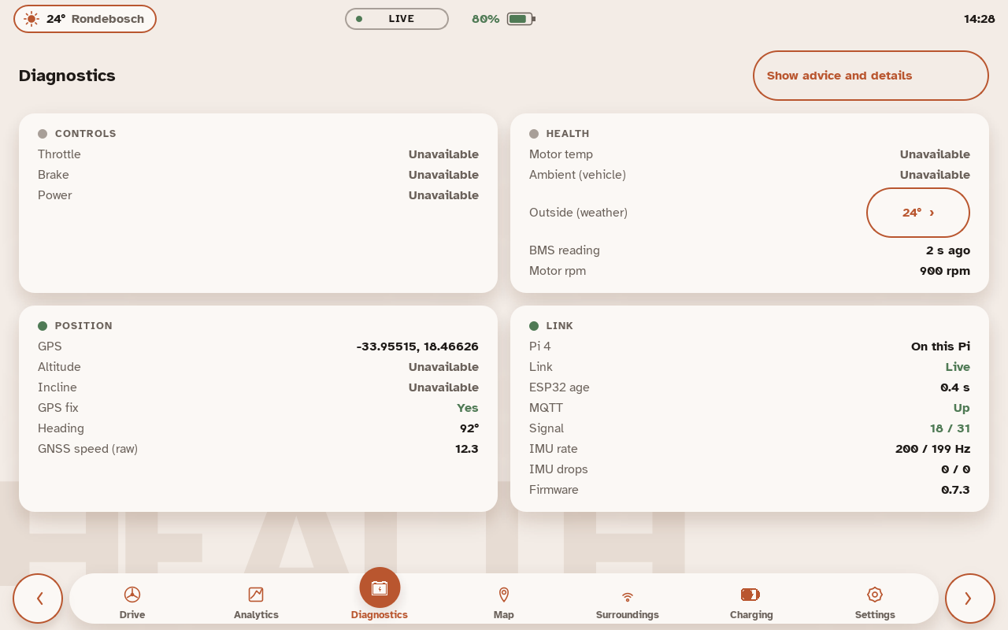
DashboardIntegration/tests/style/refine/before_day_diagnostics.png
