0geder/Tukzie-HPEC-HUD/DashboardIntegration/tests/style/refine/before_day_map.png

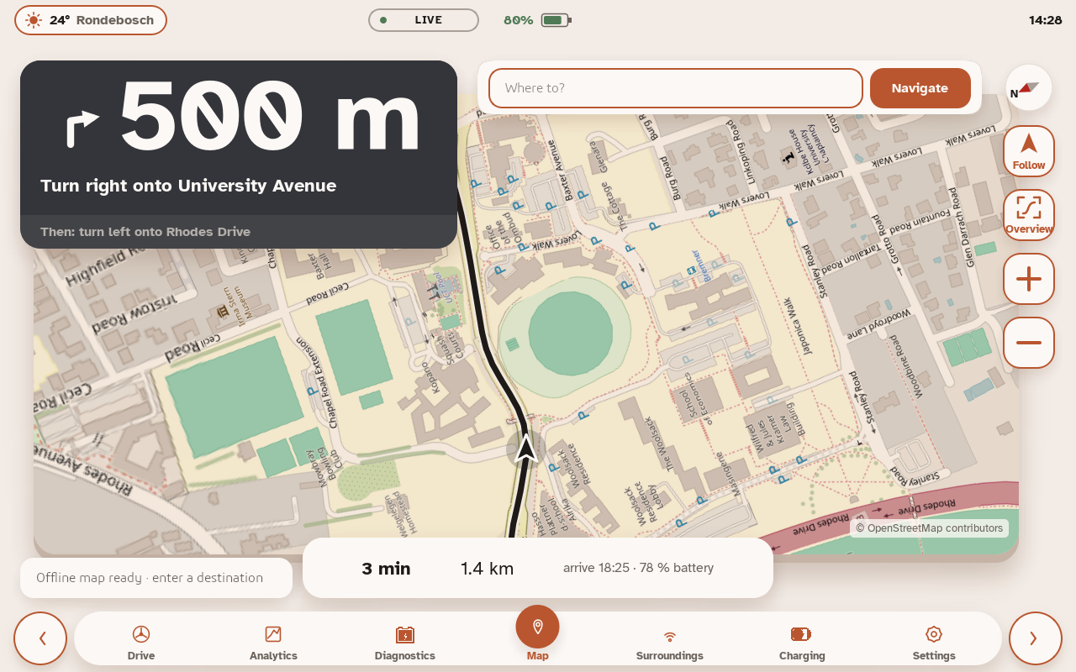
DashboardIntegration/tests/style/refine/before_day_map.png
