0geder/Tukzie-HPEC-HUD/DashboardIntegration/tests/style/refine/before_day_settings.png

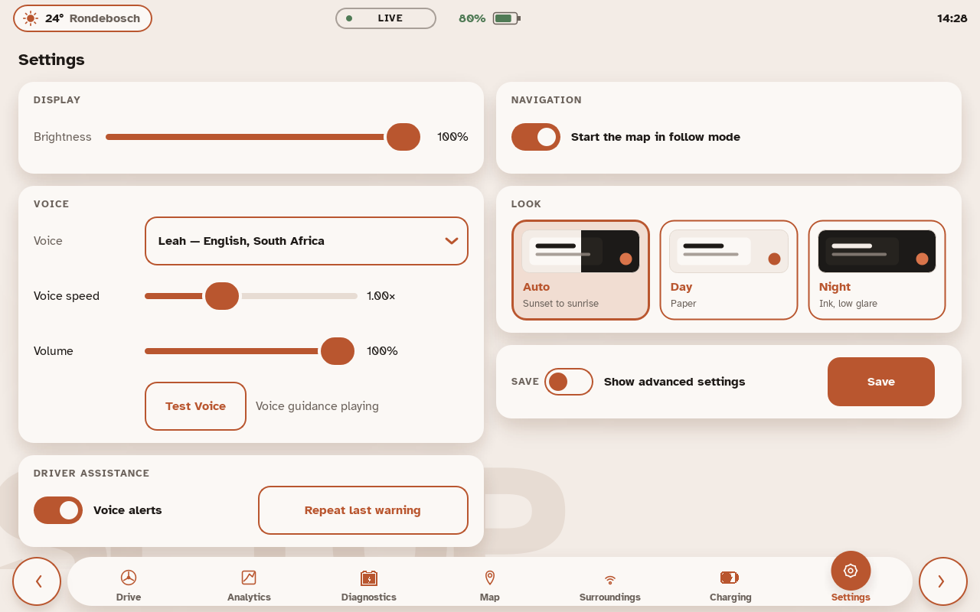
DashboardIntegration/tests/style/refine/before_day_settings.png
