0geder/Tukzie-HPEC-HUD/DashboardIntegration/tests/style/refine/before_day_surroundings.png

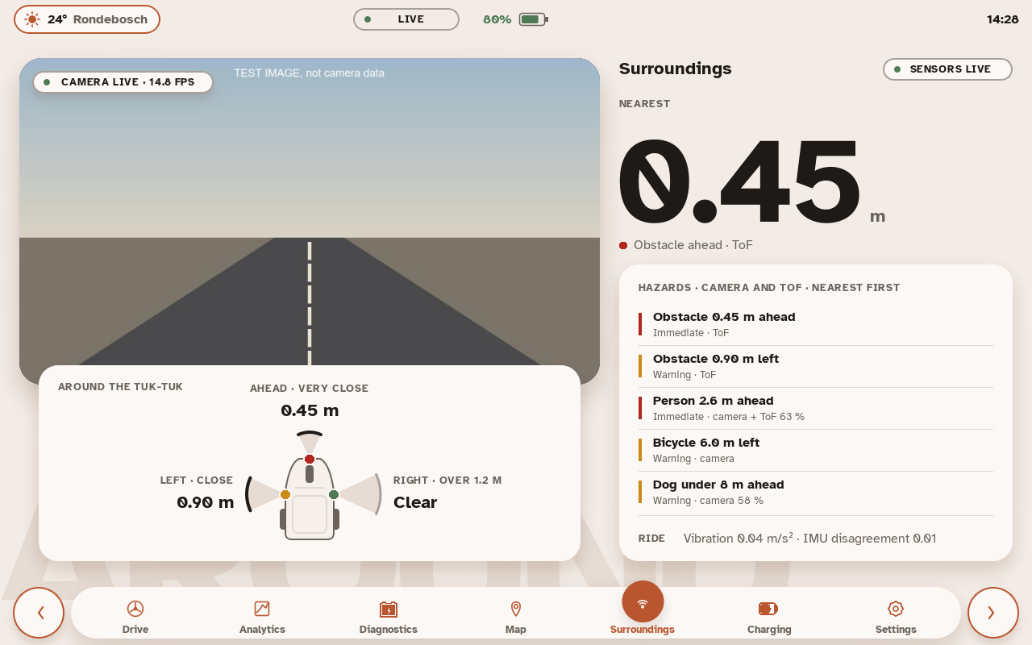
DashboardIntegration/tests/style/refine/before_day_surroundings.png
