0geder/Tukzie-HPEC-HUD/DashboardIntegration/tests/style/refine/before_night_analytics.png

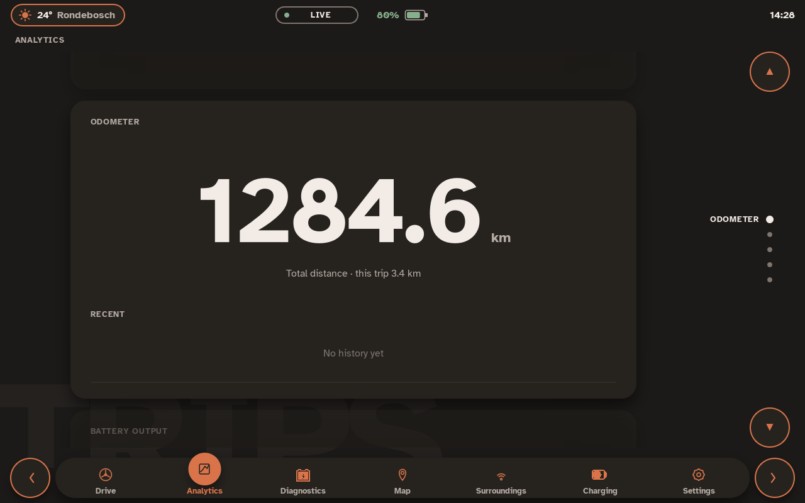
DashboardIntegration/tests/style/refine/before_night_analytics.png
