0geder/Tukzie-HPEC-HUD/DashboardIntegration/tests/style/refine/before_night_diagnostics.png

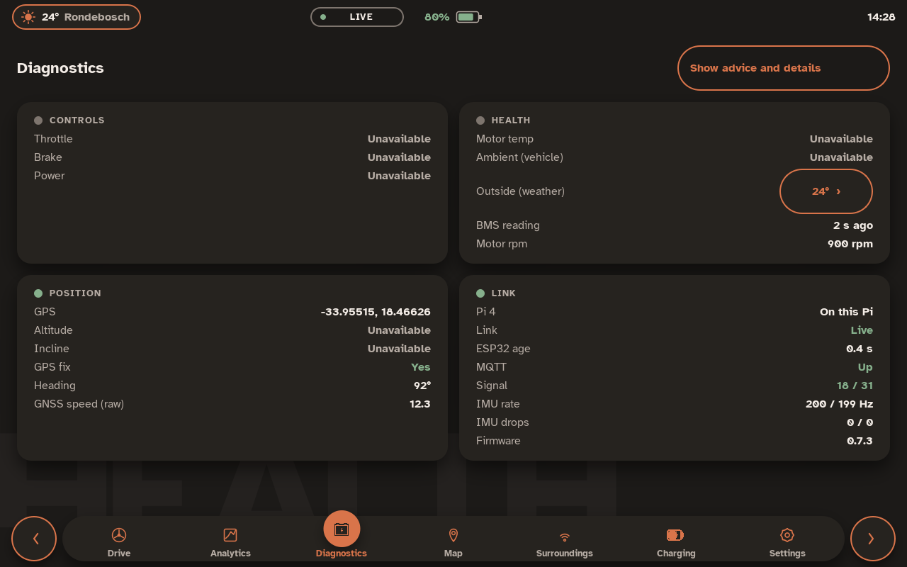
DashboardIntegration/tests/style/refine/before_night_diagnostics.png
