0geder/Tukzie-HPEC-HUD/DashboardIntegration/tests/style/refine/before_night_drive.png

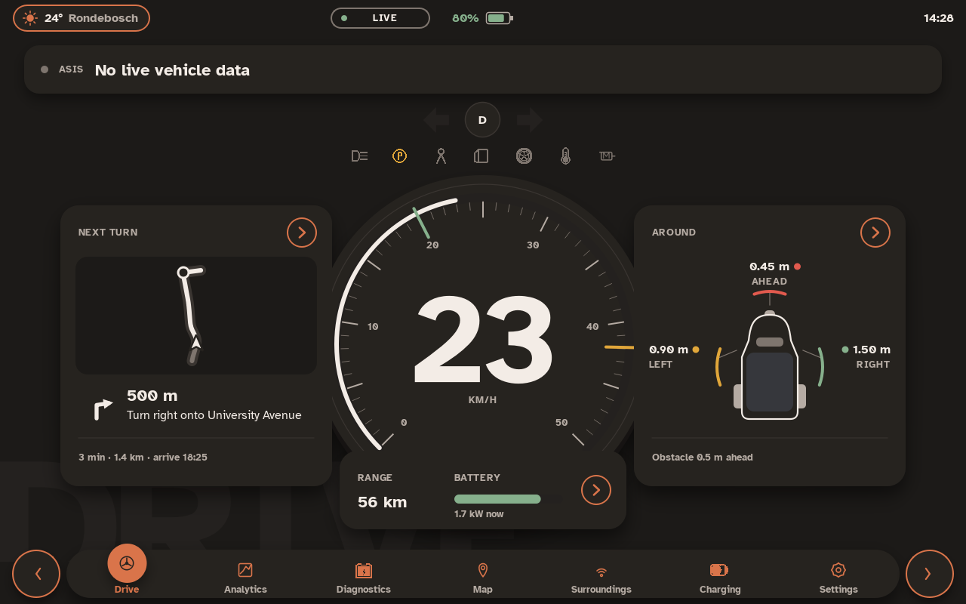
DashboardIntegration/tests/style/refine/before_night_drive.png
