0geder/Tukzie-HPEC-HUD/DashboardIntegration/tests/style/refine/before_night_settings.png

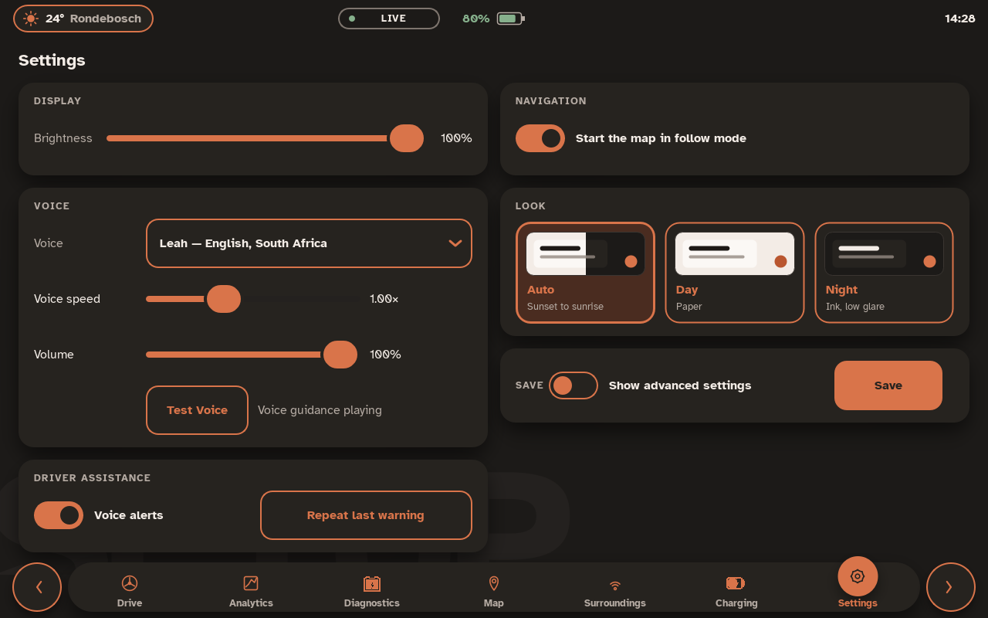
DashboardIntegration/tests/style/refine/before_night_settings.png
