0geder/Tukzie-HPEC-HUD/DashboardIntegration/tests/style/refine/before_night_surroundings.png

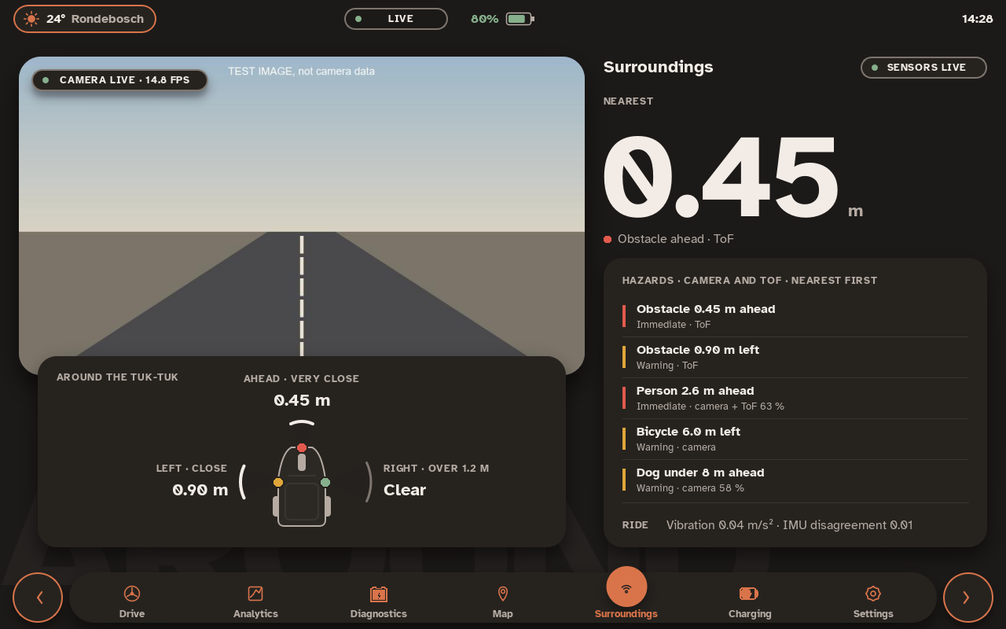
DashboardIntegration/tests/style/refine/before_night_surroundings.png
