0geder/Tukzie-HPEC-HUD/DashboardIntegration/tests/style/refine/before_team_camera.png

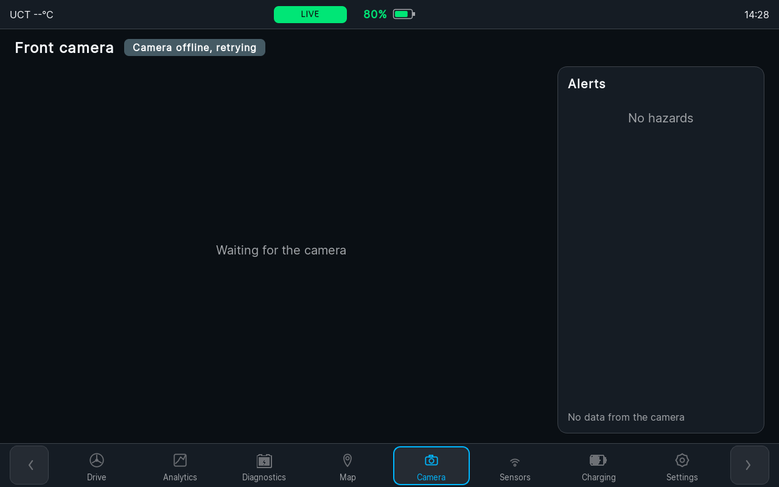
DashboardIntegration/tests/style/refine/before_team_camera.png
