0geder/Tukzie-HPEC-HUD/DashboardIntegration/tests/style/refine/before_team_charging.png

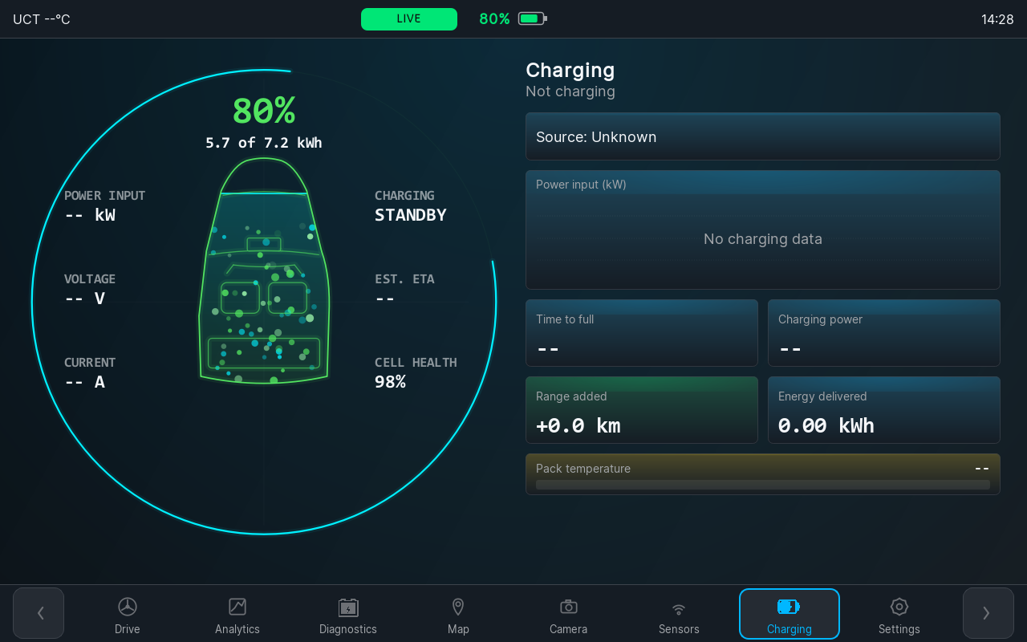
DashboardIntegration/tests/style/refine/before_team_charging.png
