0geder/Tukzie-HPEC-HUD/DashboardIntegration/tests/tile_map_flat_drive.png

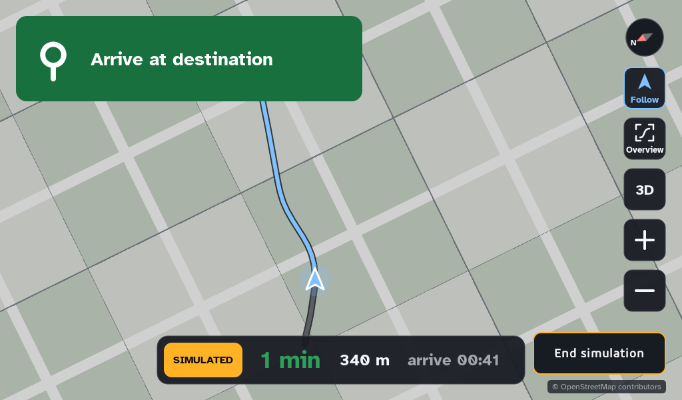
DashboardIntegration/tests/tile_map_flat_drive.png
