0geder/Tukzie-HPEC-HUD/DashboardIntegration/tests/tile_map_follow.png

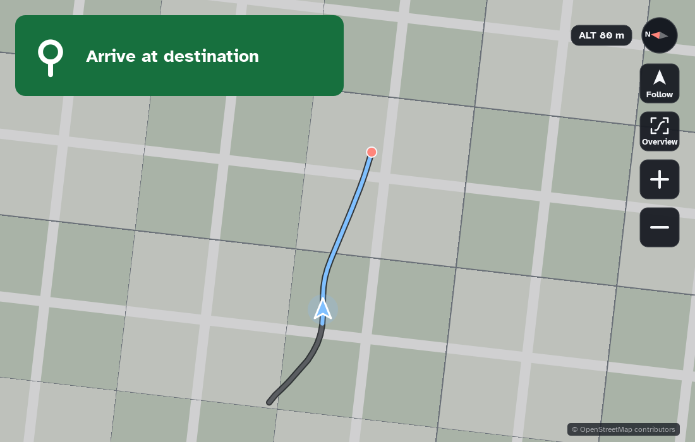
DashboardIntegration/tests/tile_map_follow.png
