0geder/Tukzie-HPEC-HUD/DashboardIntegration/tests/tile_map_navigation_pi5.png

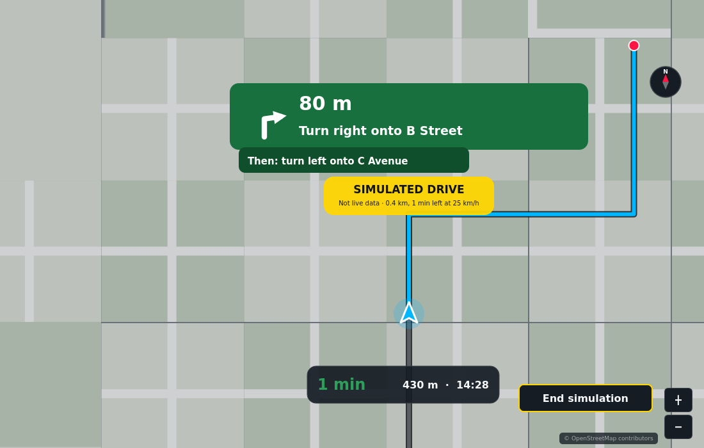
DashboardIntegration/tests/tile_map_navigation_pi5.png
