0geder/Tukzie-HPEC-HUD/DashboardIntegration/tests/tile_map_network_position.png

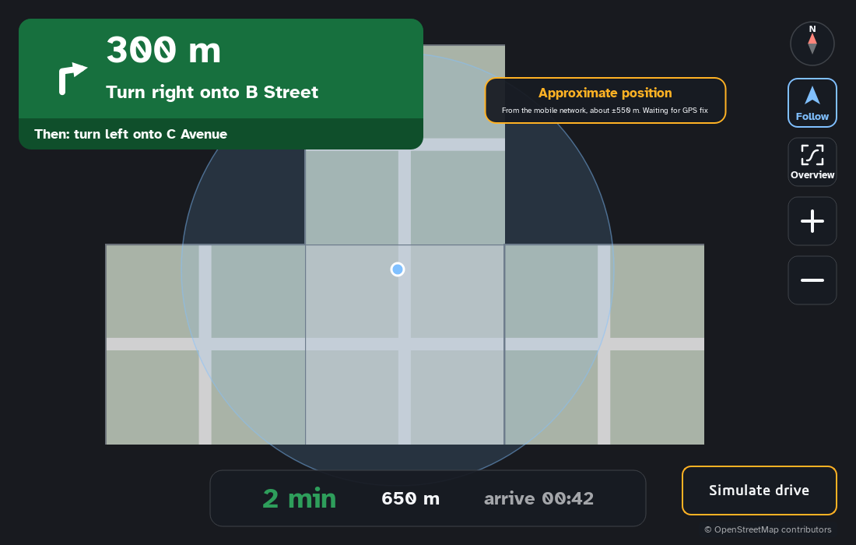
DashboardIntegration/tests/tile_map_network_position.png
