0geder/Tukzie-HPEC-HUD/DashboardIntegration/tests/tile_map_offline.png

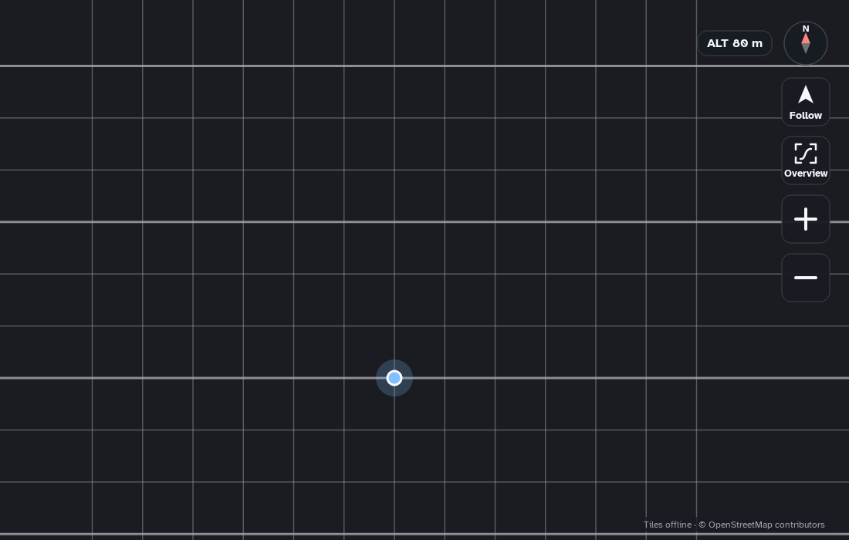
DashboardIntegration/tests/tile_map_offline.png
