0geder/Tukzie-HPEC-HUD/DashboardIntegration/tests/tile_map_simulated_drive.png

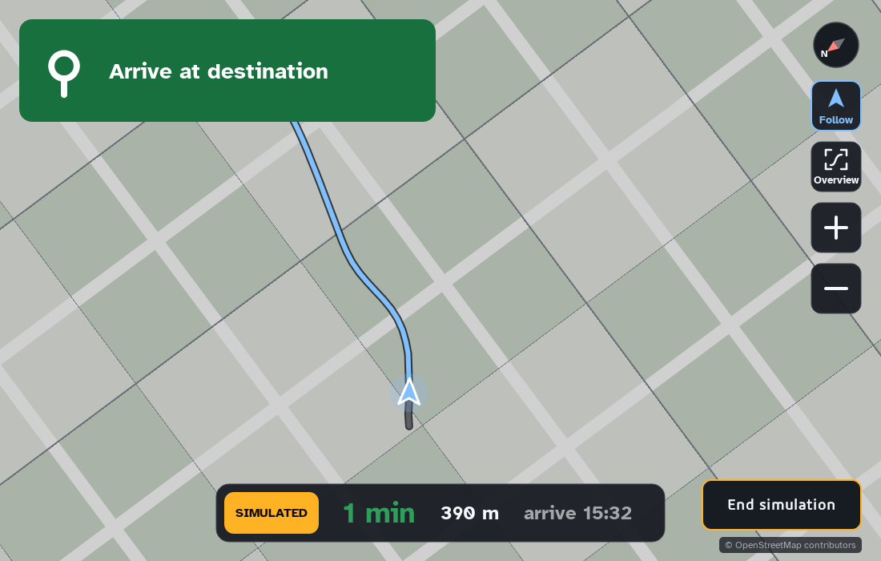
DashboardIntegration/tests/tile_map_simulated_drive.png
