0geder/Tukzie-HPEC-HUD/DashboardIntegration/tests/tile_map_tilt_drive.png

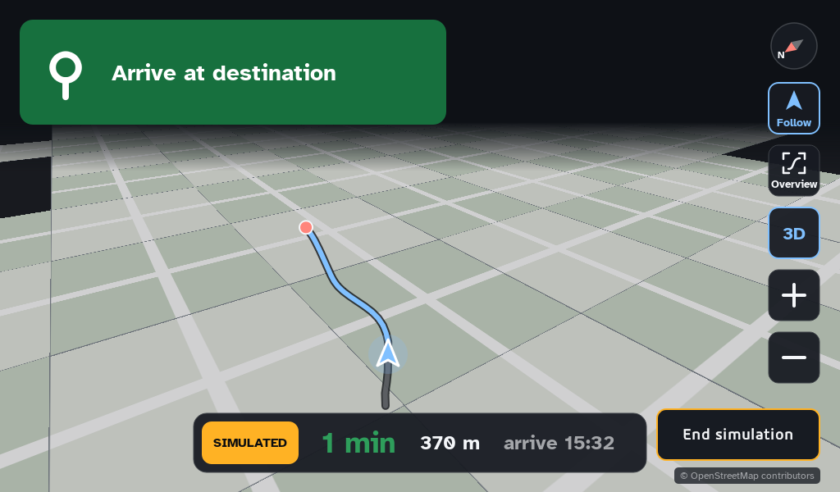
DashboardIntegration/tests/tile_map_tilt_drive.png
