0geder/Tukzie-HPEC-HUD/DashboardIntegration/tests/voice/voice_destination_options.png

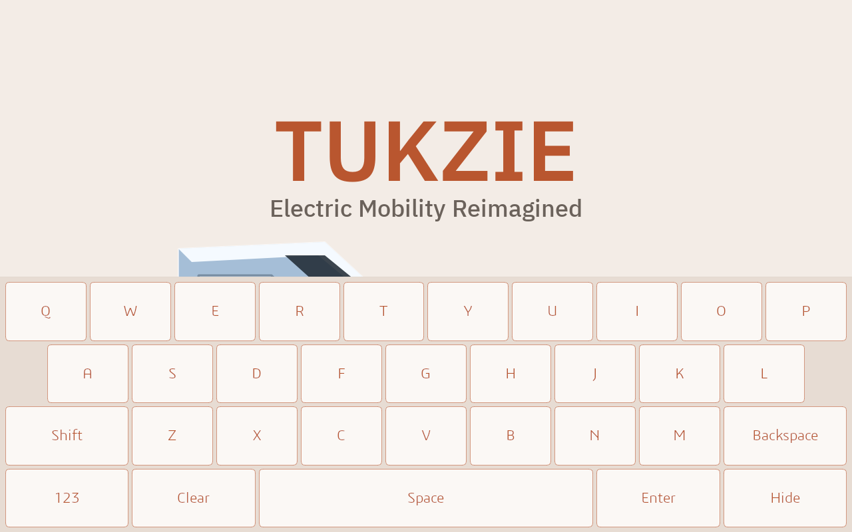
DashboardIntegration/tests/voice/voice_destination_options.png
