0geder/Tukzie-HPEC-HUD/DashboardIntegration/tests/voice/voice_destination_set.png

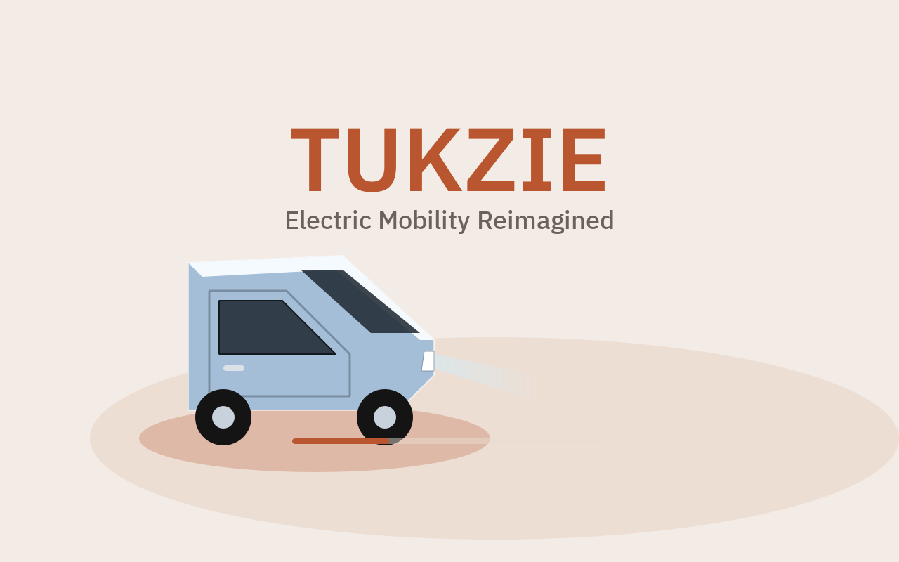
DashboardIntegration/tests/voice/voice_destination_set.png
