0geder/Tukzie-HPEC-HUD/Photos/Reference/Vehicle_Measurements/2026-09-02_handlebar_above_rear_seat.jpg

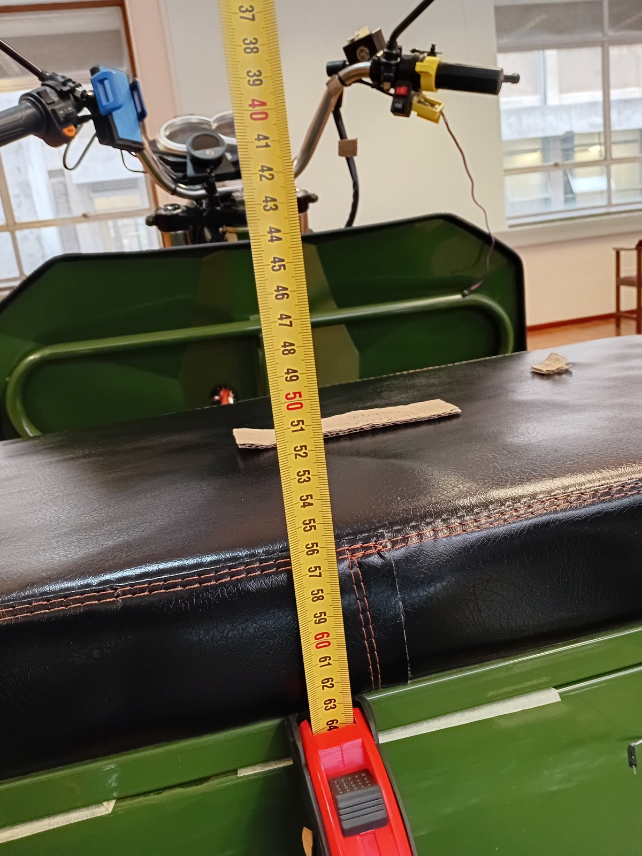
Photos/Reference/Vehicle_Measurements/2026-09-02_handlebar_above_rear_seat.jpg
