0geder/Tukzie-HPEC-HUD/Photos/Reference/Vehicle_Measurements/2026-09-02_handlebar_height_tape.jpg

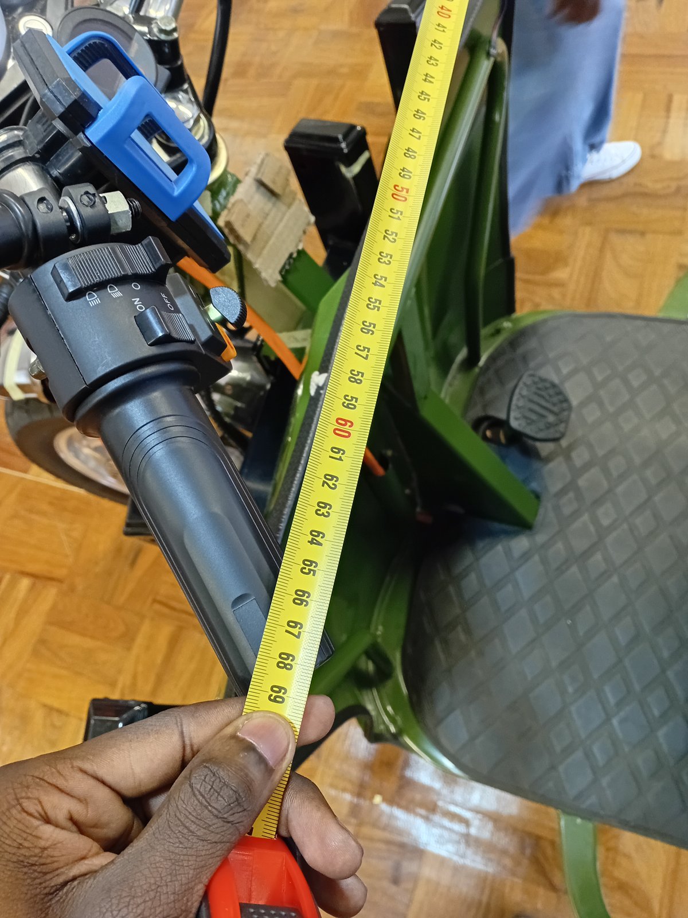
Photos/Reference/Vehicle_Measurements/2026-09-02_handlebar_height_tape.jpg
