0geder/Tukzie-HPEC-HUD/Photos/Reference/Vehicle_Measurements/2026-09-02_meter_area_width_about_30cm.jpg

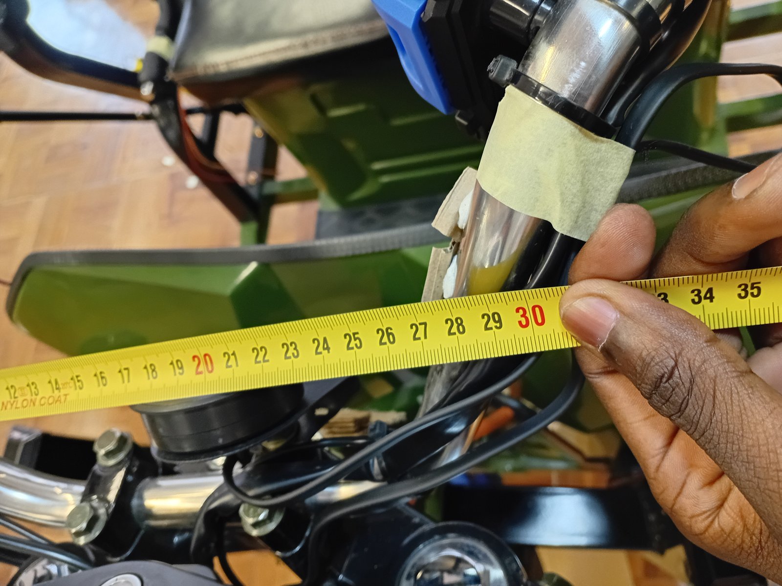
Photos/Reference/Vehicle_Measurements/2026-09-02_meter_area_width_about_30cm.jpg
