0geder/Tukzie-HPEC-HUD/Photos/Reference/Vehicle_Measurements/2026-09-02_mirror_span.jpg

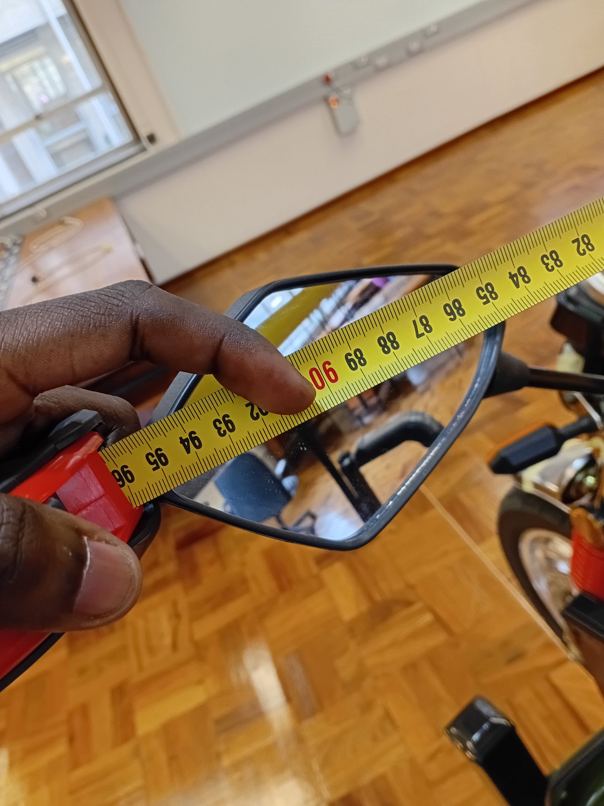
Photos/Reference/Vehicle_Measurements/2026-09-02_mirror_span.jpg
