0geder/Tukzie-HPEC-HUD/Photos/Reference/Vehicle_Measurements/2026-09-02_rear_seat_width_about_89cm.jpg

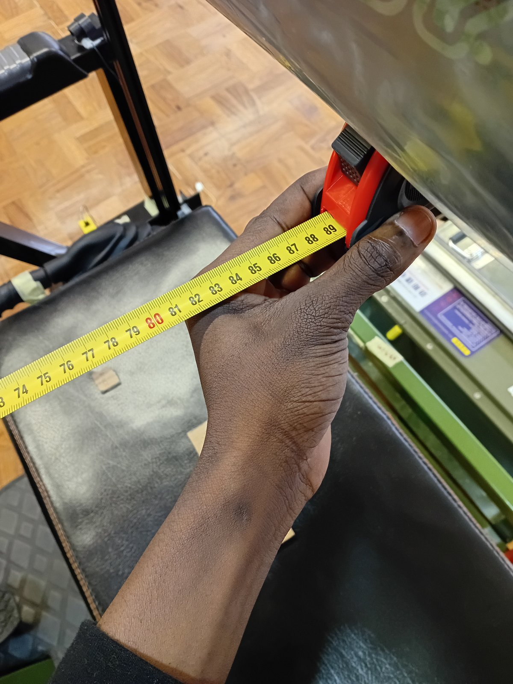
Photos/Reference/Vehicle_Measurements/2026-09-02_rear_seat_width_about_89cm.jpg
