0geder/Tukzie-HPEC-HUD/Photos/Reference/Vehicle_Measurements/2026-09-02_seat_cushion_length_about_75cm.jpg

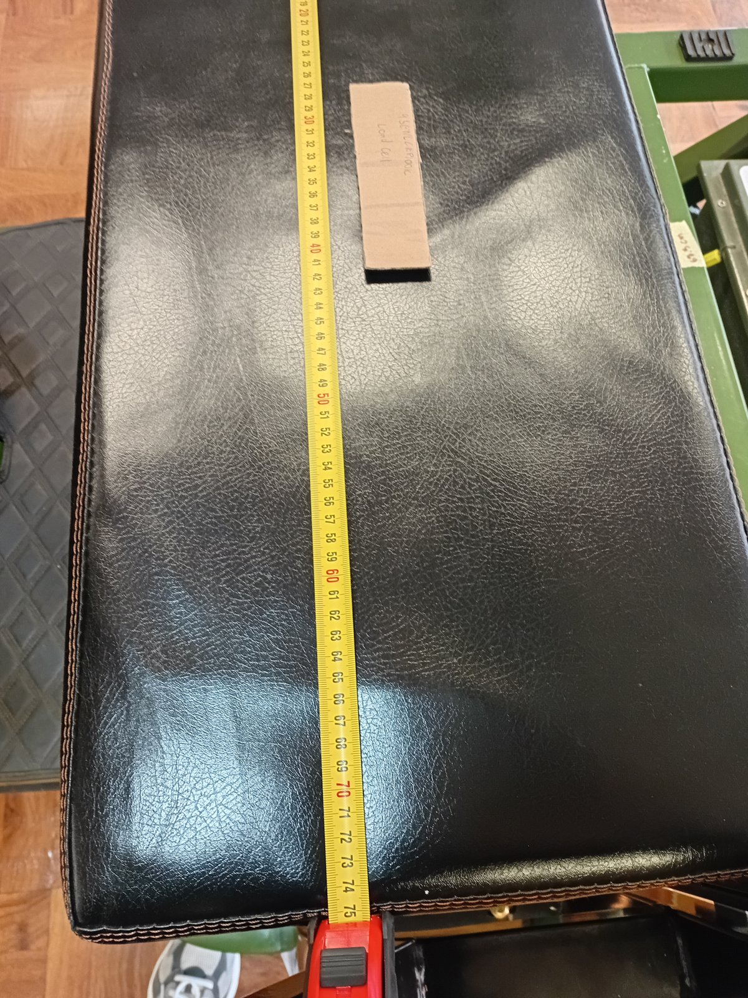
Photos/Reference/Vehicle_Measurements/2026-09-02_seat_cushion_length_about_75cm.jpg
