0geder/Tukzie-HPEC-HUD/Photos/Reference/Vehicle_Measurements/2026-09-02_seat_front_edge_width.jpg

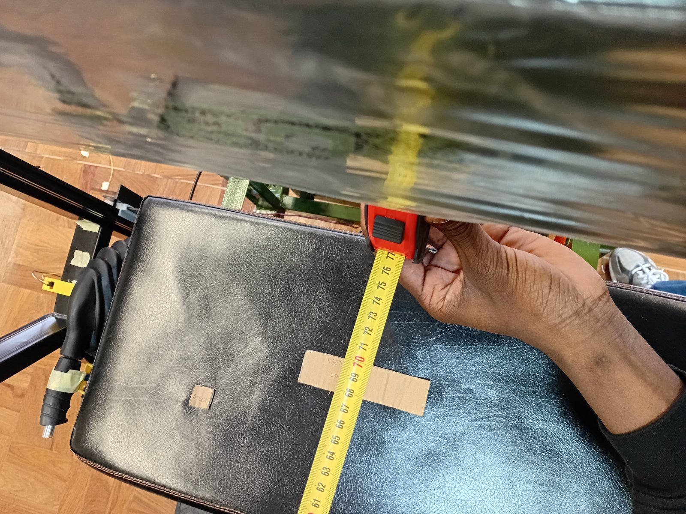
Photos/Reference/Vehicle_Measurements/2026-09-02_seat_front_edge_width.jpg
