0geder/Tukzie-HPEC-HUD/Presentation/source/assets/road_test_1027.jpg

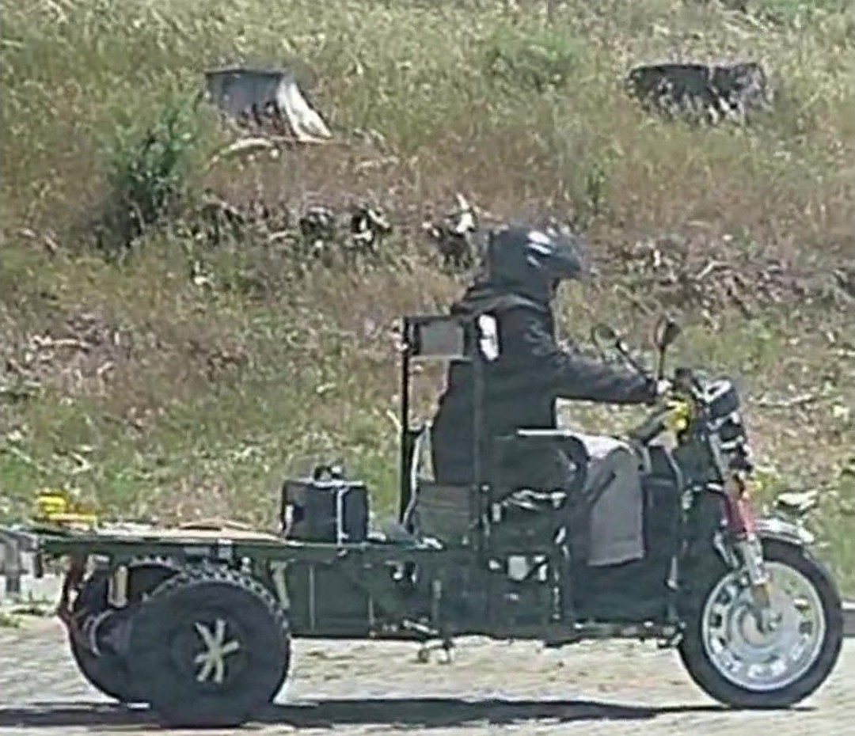
Presentation/source/assets/road_test_1027.jpg
