0geder/Tukzie-HPEC-HUD/Presentation/source/assets/search_results.png

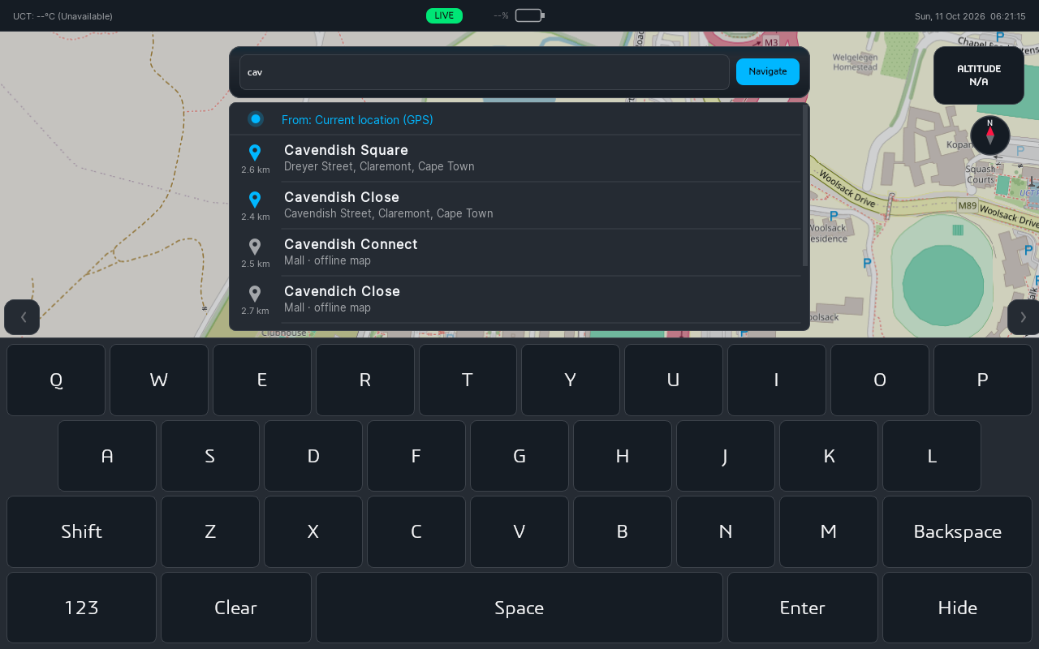
Presentation/source/assets/search_results.png
