0geder/Tukzie-HPEC-HUD/Report/figures/results/imu_write_gaps.png

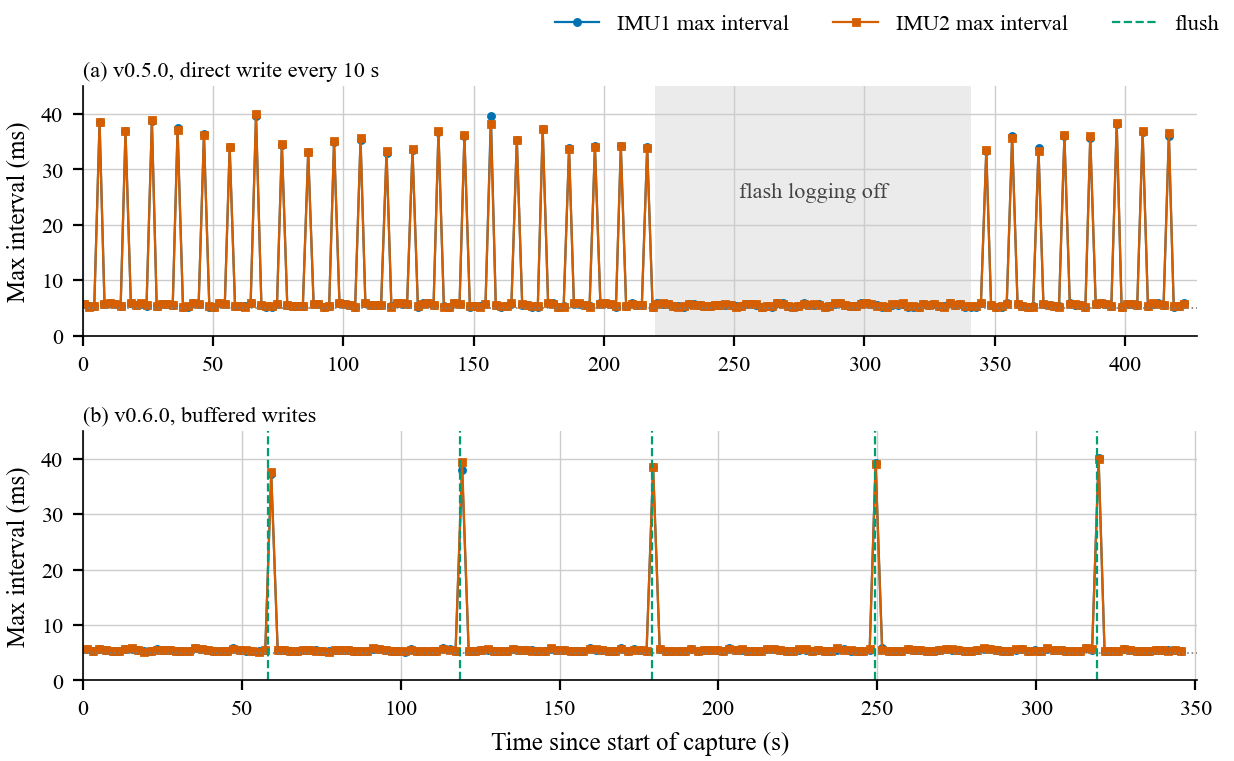
Report/figures/results/imu_write_gaps.png
