0geder/Tukzie-HPEC-HUD/Report/evidence/2026-09-28_camera_run1_label_bug.txt

# Detector run 1 on the Raspberry Pi 4, 28 Sept 2026, as pasted from the Pi terminal.
# Before the label-offset and colour-order fixes: a person in view was logged as "motorcycle".

Stopped. 430 frames in 60.1s (7.2 fps average).
(venv) ogeder@pi4-camera:~/hazard_detector $ cat alerts.jsonl
{"class": "motorcycle", "distance_band": "immediate", "confidence": 0.66, "timestamp": "2026-09-28T11:58:32", "alert_status": "active"}
{"class": "motorcycle", "distance_band": null, "confidence": 0.0, "timestamp": "2026-09-28T11:58:49", "alert_status": "cleared"}
{"class": "motorcycle", "distance_band": "immediate", "confidence": 0.57, "timestamp": "2026-09-28T11:58:53", "alert_status": "active"}
{"class": "motorcycle", "distance_band": null, "confidence": 0.0, "timestamp": "2026-09-28T11:58:54", "alert_status": "cleared"}
{"class": "motorcycle", "distance_band": "immediate", "confidence": 0.59, "timestamp": "2026-09-28T11:59:21", "alert_status": "active"}
(venv) ogeder@pi4-camera:~/hazard_detector $ ^C
