0geder/Tukzie-HPEC-HUD/DashboardIntegration/screenshots/2026-10-26/after_speed_fix_deploy.png

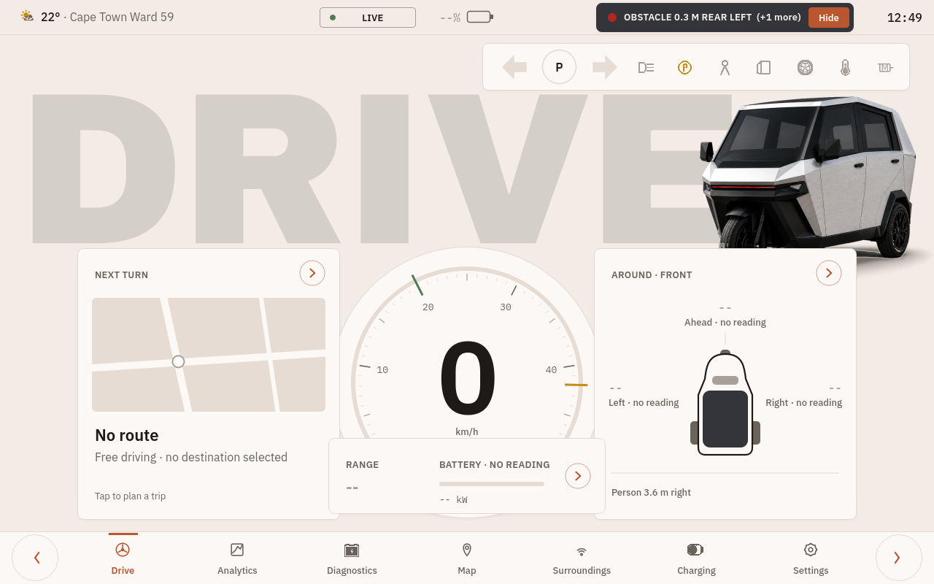
DashboardIntegration/screenshots/2026-10-26/after_speed_fix_deploy.png
