0geder/Tukzie-HPEC-HUD/DashboardIntegration/screenshots/2026-10-27/before_sim_fix.png

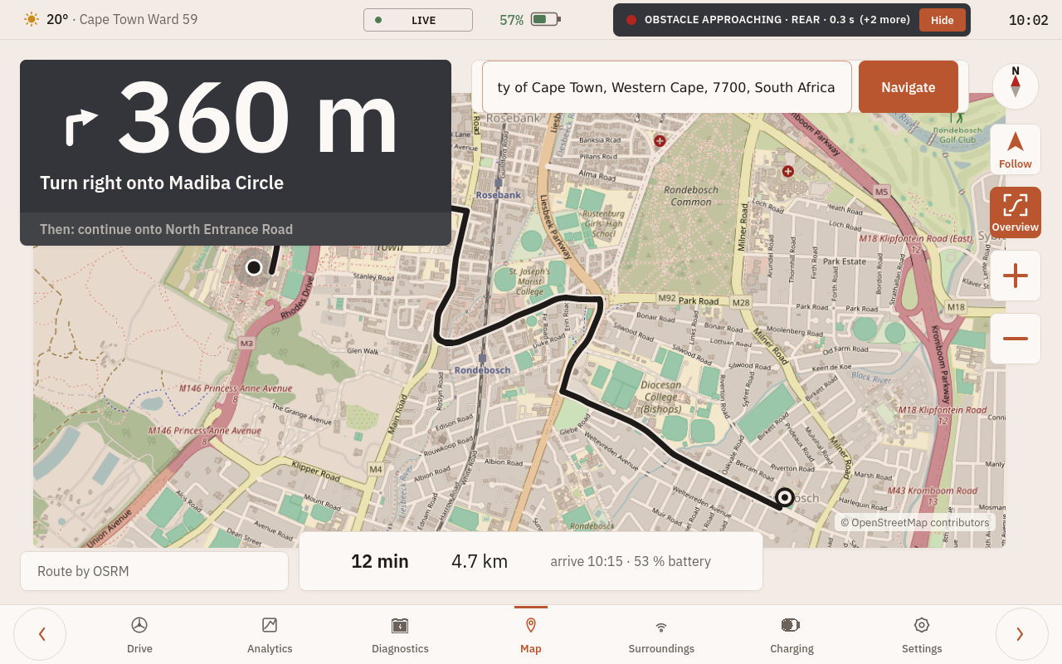
DashboardIntegration/screenshots/2026-10-27/before_sim_fix.png
