0geder/Tukzie-HPEC-HUD/DashboardIntegration/tests/tile_map_no_fix.png

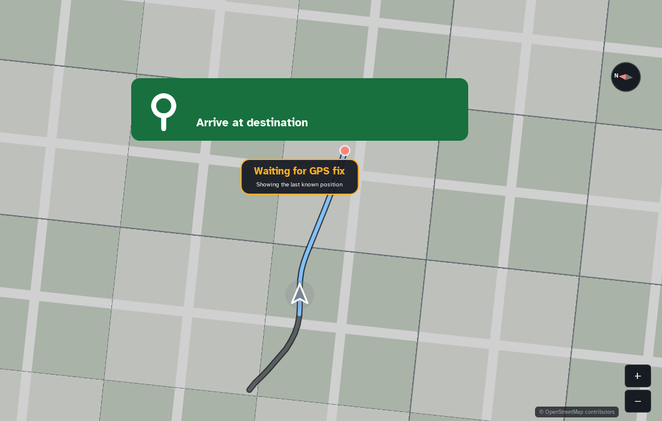
DashboardIntegration/tests/tile_map_no_fix.png
