0geder/Tukzie-HPEC-HUD/Report/figures/results/flashlog_run1.pdf

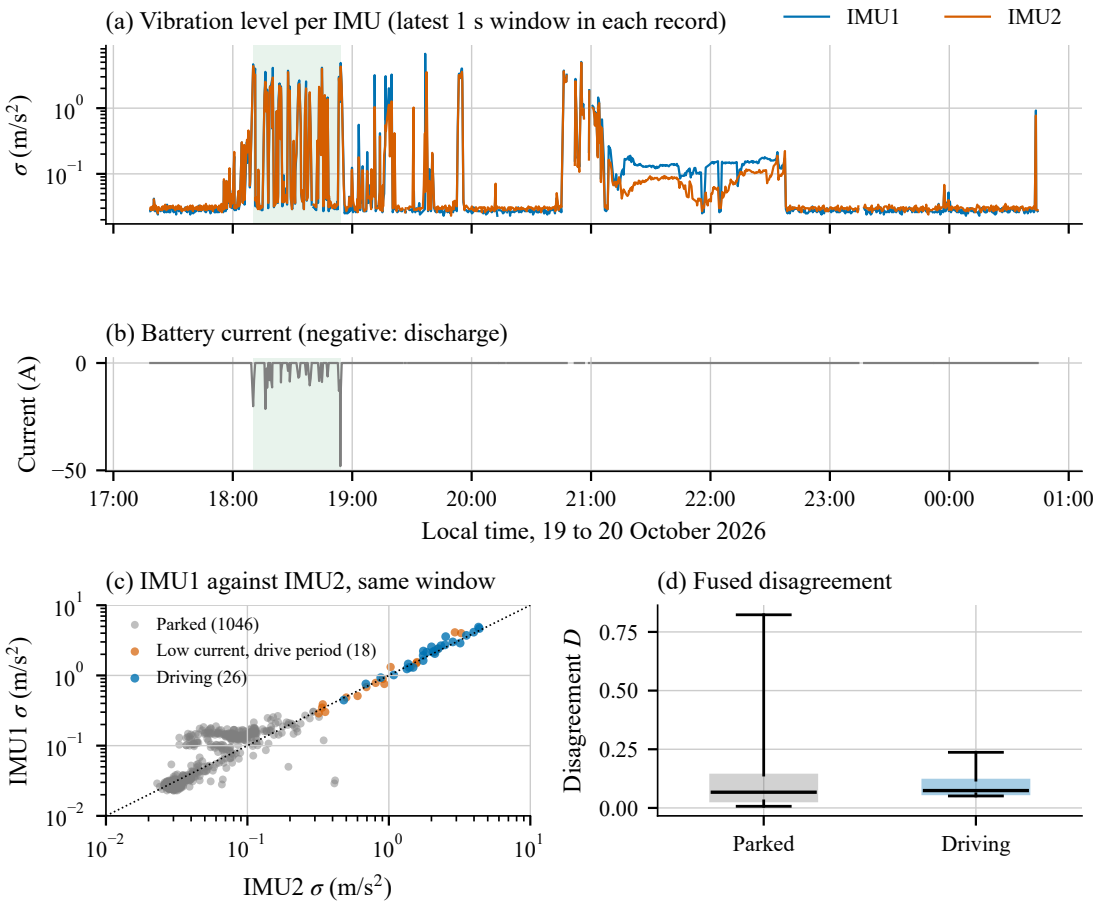
[picture p312: page 1]
(a) Vibration level per IMU (latest 1 s window in each record); IMU1; IMU2; Current (A); IMU2 σ (m/s; (c) IMU1 against IMU2, same window; Parked; Driving; Disagreement D; (d) Fused disagreement

(b) Battery current (negative: discharge)

Local time, 19 to 20 October 2026

Parked (1046)
Low current, drive period (18)
Driving (26)
