0geder/Tukzie-HPEC-HUD/Report/figures/results/detector_latency.pdf

(a)

(b)

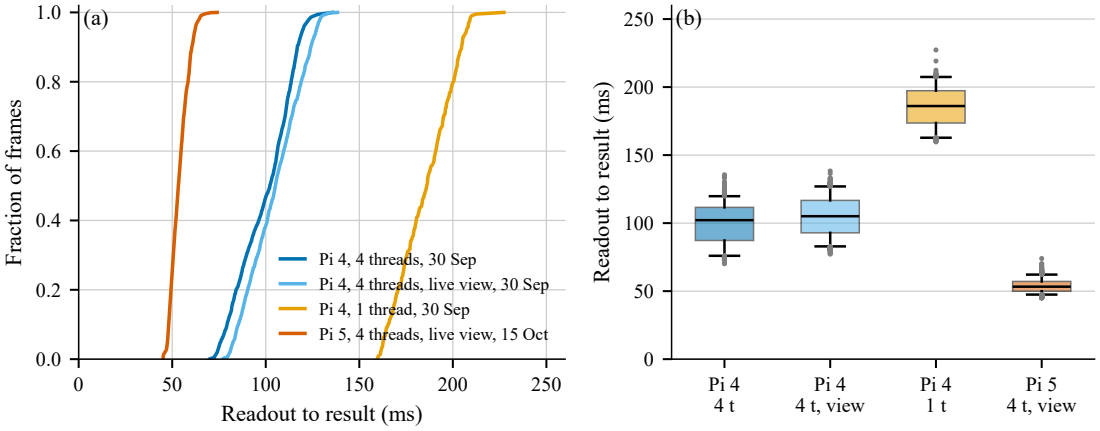
[picture p313: page 1]
Pi 4 4 t, view; Pi 5 4 t, view

Readout to result (ms)

Fraction of frames

Pi 4, 4 threads, 30 Sep
Pi 4, 4 threads, live view, 30 Sep
Pi 4, 1 thread, 30 Sep
Pi 5, 4 threads, live view, 15 Oct
