0geder/Tukzie-HPEC-HUD/Report/figures/results/imu_write_gaps.pdf

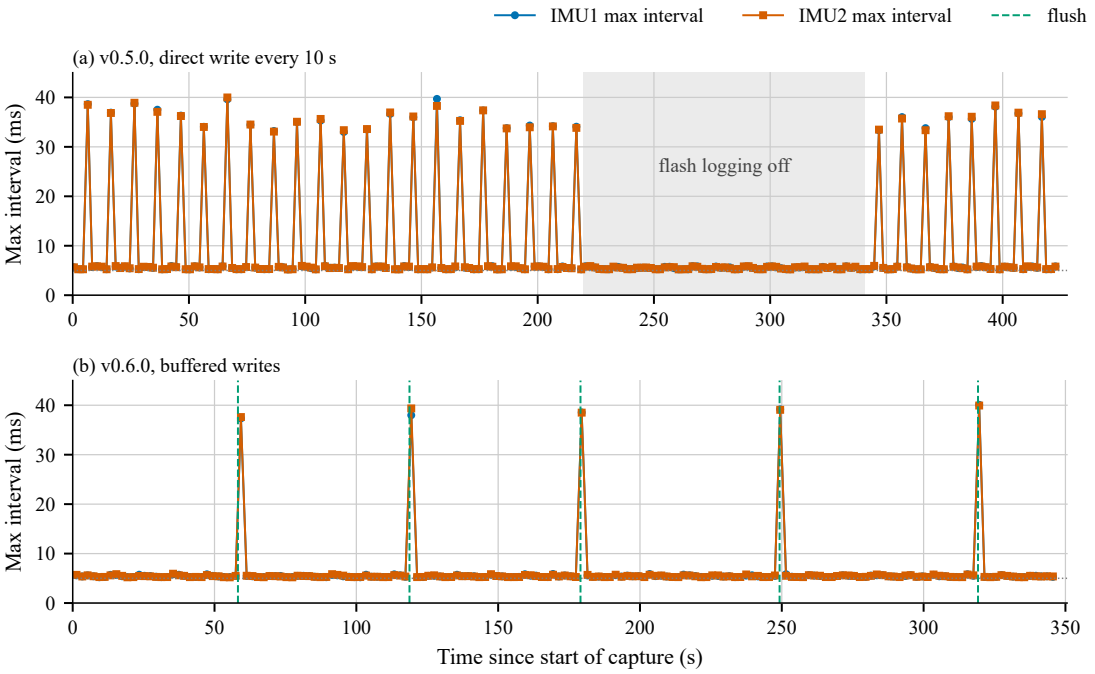
[picture p314: page 1]
(b) v0.6.0, buffered writes; IMU1 max interval; IMU2 max interval; flush

(a) v0.5.0, direct write every 10 s

Max interval (ms)

flash logging off

Time since start of capture (s)
