0geder/Tukzie-HPEC-HUD/Report/figures/results/road_session_1019.pdf

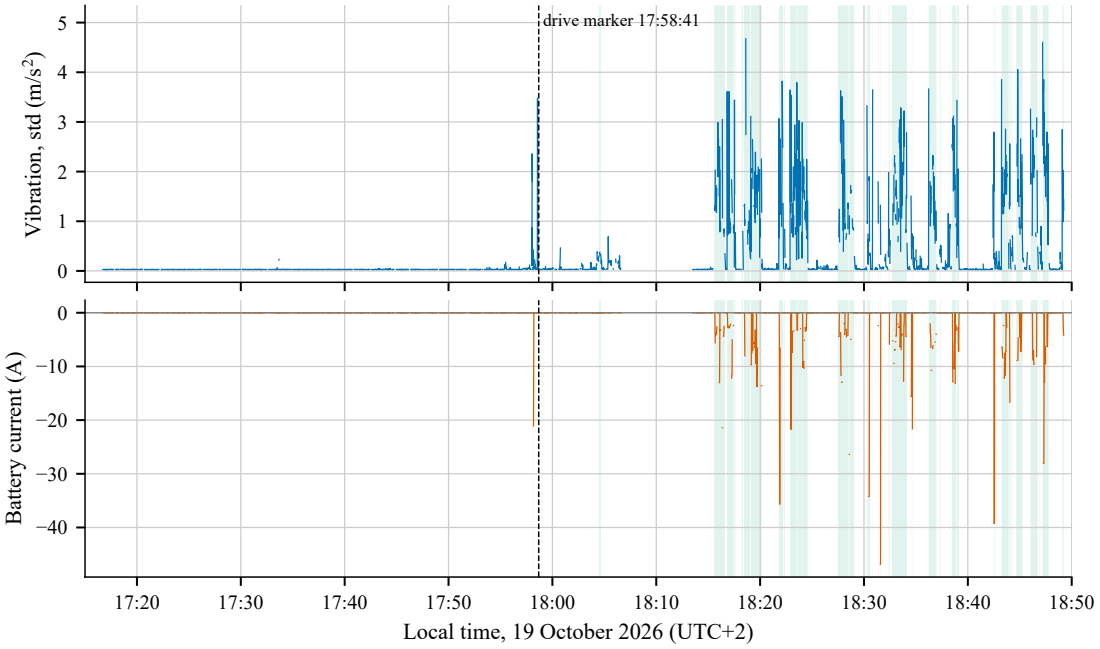
[picture p315: page 1]
Vibration, std (m/s2); drive marker 17:58:41; Battery current (A)

Local time, 19 October 2026 (UTC+2)
