0geder/Tukzie-HPEC-HUD/Report/figures/results/t15_outage_backlog.pdf

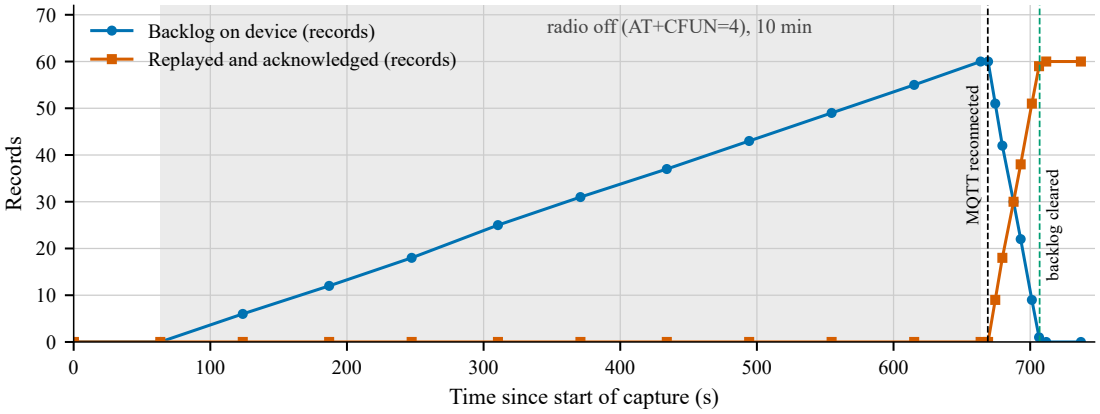
[picture p316: page 1]
Records; MQTT reconnected; backlog cleared

Backlog on device (records)
Replayed and acknowledged (records)

radio off (AT+CFUN=4), 10 min

Time since start of capture (s)
