0geder/Tukzie-HPEC-HUD/BenchTest/logs/run2_road_2026-10-27/analysis/figures/session.pdf

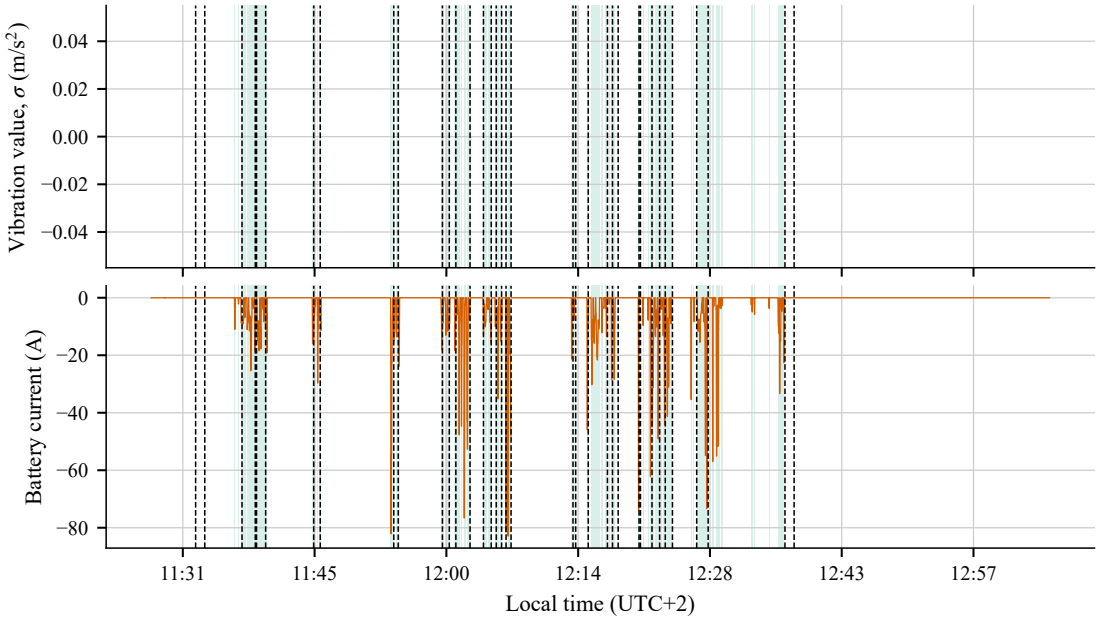
[picture p317: page 1]
Vibration value, σ (m/s2); Battery current (A)

Local time (UTC+2)
