0geder/Tukzie-HPEC-HUD/Report/figures/results/stand_spectra_1023.pdf

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

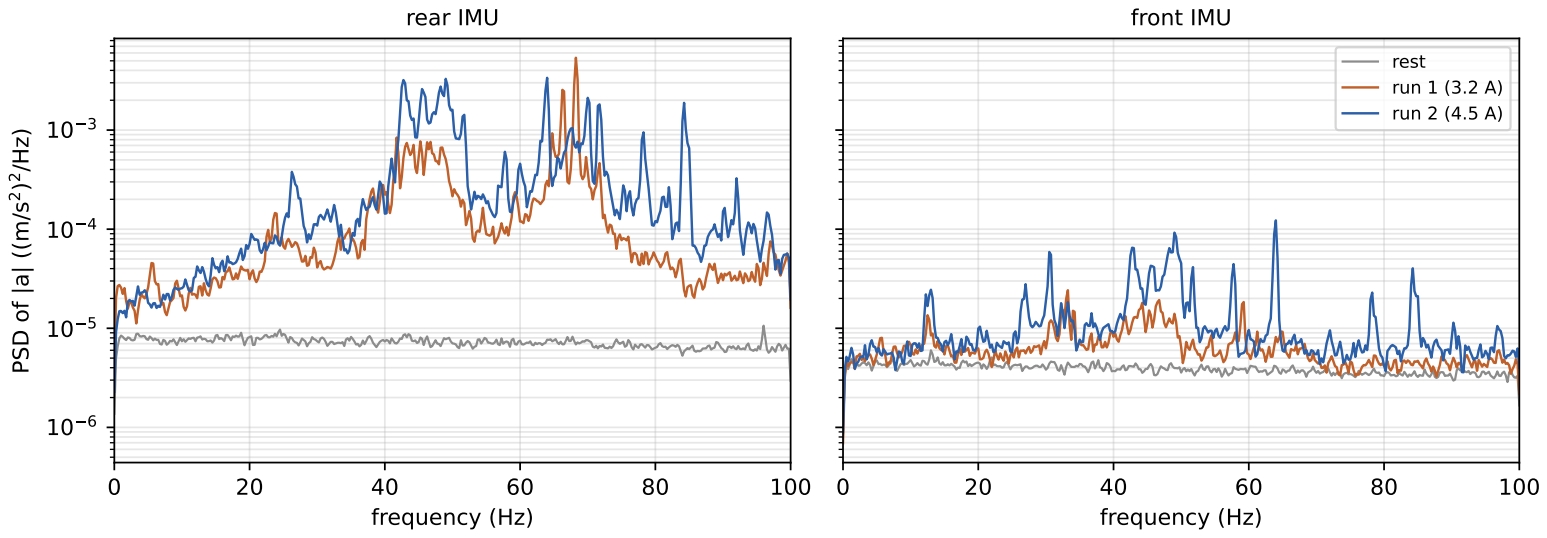
[picture p318: page 1]
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
