0geder/Tukzie-HPEC-HUD/BenchTest/logs/run2_road_2026-10-27/analysis/figures/pass_aw_front1.pdf

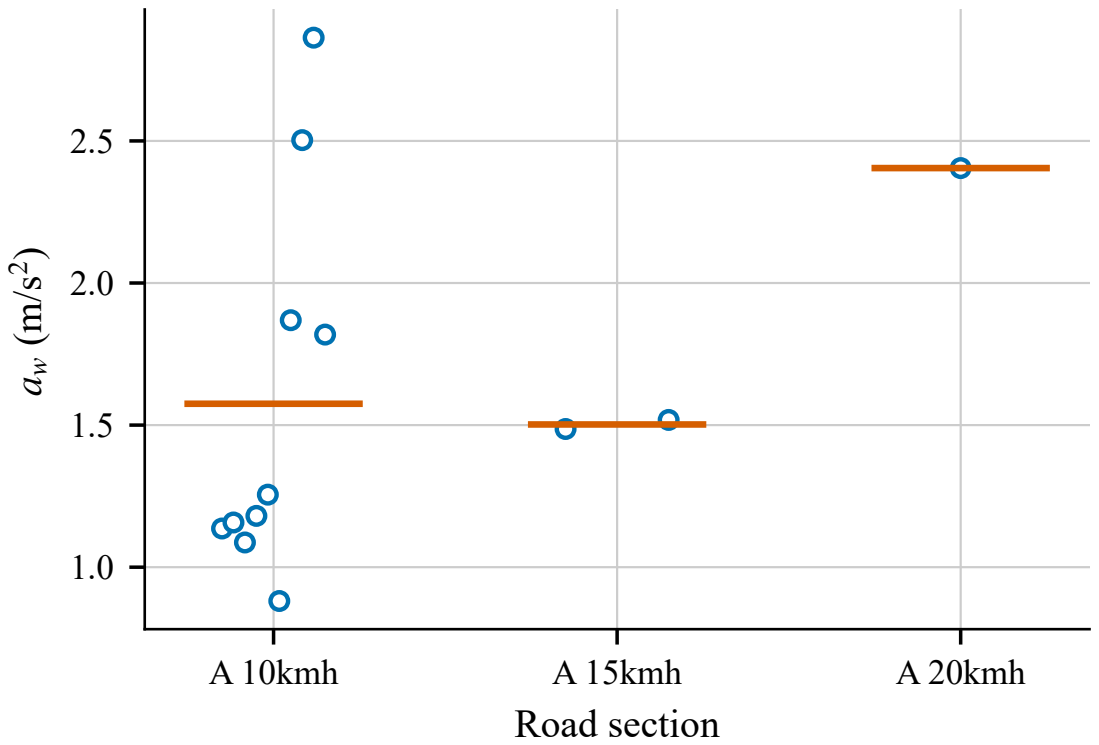
[picture p319: page 1]
A 10kmh; A 15kmh; A 20kmh; Road section
