0geder/Tukzie-HPEC-HUD/BenchTest/logs/run2_road_2026-10-27/analysis/figures/psd.pdf

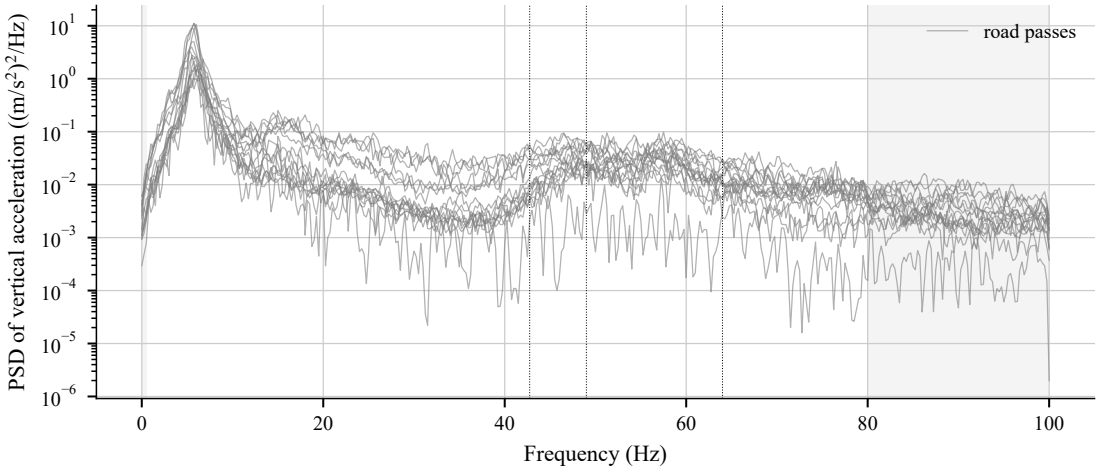
[picture p321: page 1]
Frequency (Hz); road passes

PSD of vertical acceleration ((m/s2)2/Hz)
