0geder/Tukzie-HPEC-HUD/CameraDetection/telemetry_bridge.py

#!/usr/bin/env python3
"""
SW-7 telemetry bridge for the Pi 4: ESP32 serial and ToF sensors to HTTP.

Implements section 2 of DashboardIntegration/TELEMETRY_LINK.md. It reads
the ESP32's USB serial port, keeps the latest "DASH {json}" line, reads
the three VL53L0X ToF sensors with the code in tof_reader.py, and serves:

  GET /telemetry   application/json, the shape in TELEMETRY_LINK.md:
      {"esp32": {...latest DASH object..., "age_ms": 420} or null,
       "tof": {"left_mm": 812, "ahead_mm": 1490, "right_mm": null,
               "age_ms": 35} or null,
       "bridge": {"version": "1.0", "serial_port": "/dev/ttyACM0",
                  "lines": 1234, "bad_lines": 2,
                  "replay": false, "replay_file": null,
                  "raw": {"capture": true, "dir": "/home/ogeder/rawlog",
                          "file": "rear_raw_2026-10-22_141500.txt",
                          "lines": 5210, "bad_crc": 0, "raw": 5100,
                          "rawh": 10, "raws": 100, "bytes_written": 1860000,
                          "not_written": 0, "write_errors": 0, "files": 1,
                          "paused": null}}}
  GET /            a short plain-text status page

Beacon (TELEMETRY_LINK.md section 4.2): every 2 s a UDP broadcast to port
50808 on 255.255.255.255 and on each IPv4 interface's broadcast address,
payload {"sw7": "pi4", "v": 1, "host": "<hostname>", "camera_port": 8080,
"telemetry_port": 8081, "seq": n}, so the dashboard can find this Pi on
any network. The receiver uses the packet's source address. Interfaces
are looked up again before every send, so a link that comes up later
(the wired sw7-link) is included. Send failures are counted, never
fatal. --no-beacon turns it off.

Counting: "lines" is every line starting with "DASH " that was received,
"bad_lines" is the subset that could not be used (not valid JSON, not a
JSON object, or containing NaN or Infinity). Lines that do not start
with "DASH " (boot log, debug prints) are ignored and not counted.

esp32 is null until the first good line arrives, and again whenever the
serial port is lost (ESP32 unplugged or reset; the ESP32-S3 re-enumerates
on reset). The port is reopened automatically when it comes back. tof is
null with --no-tof, when the sensors or their Python libraries are
absent, or after a read error (the bridge then retries every few
seconds). A reading of 0, about 8190 (nothing in range) or anything at or
above tof_reader.OUT_OF_RANGE_MM becomes null for that sensor.

Only telemetry numbers are handled: no camera frames, no personal data.
Nothing is written to disk except the fusion log (see above) and the raw
IMU capture (below).

Raw IMU capture (firmware 0.7.5+, TelemetryUnit/RAW_STREAM.md): lines that
carry a RAW, RAWH or RAWS type word are not DASH lines and do not touch
the esp32 block or the DASH counts. Each one is appended verbatim to a
capture file as "<host_epoch_s> <line>\n", where host_epoch_s is this Pi's
wall clock (time.time(), 6 decimals) when the read that completed the line
returned (resolution about 20 ms; see TELEMETRY_LINK.md section 6 for
clock alignment). Lines that fail their CRC are written too and counted;
the reference decoder (TelemetryUnit/tools/raw_stream_decode.py) reads
these files as they are and drops them again. Files:
<raw-dir>/rear_raw_YYYY-MM-DD_HHMMSS.txt (local time of opening), a new
one at every bridge start, every hour (--raw-rotate-s) and whenever a
file reaches --raw-max-mb. Flushed every second. Writing pauses (lines
counted in "not_written") while the disk has less than --raw-min-free-mb
free; with --raw-keep-mb the oldest capture files are deleted to keep the
directory under that total. The directory is created on the first raw
line, so a bridge with no raw stream (the Pi 5's) never creates it.
--no-raw-capture stops the writing; the counting continues. The counts
are in /telemetry under "bridge": {"raw": {...}} and on the status page.

Serial access uses pyserial when installed (venv/bin/pip install
pyserial); without it, the tty is read directly with termios (Linux only).

Replay: with --replay FILE the esp32 block comes from a recorded or
generated file of DASH lines played in a loop, not from the ESP32. The
bridge block then says "replay": true and "replay_file": "<file name>", so
the dashboard can show a REPLAY badge and replayed data is never taken for
live data. From the serial port it says "replay": false, "replay_file": null.

Camera and ToF fusion (sensor_fusion.py, rules in its docstring): with
--fusion on, or with the default --fusion auto once the hazard detector
answers GET /detections on localhost:8080 (it needs --preview), the bridge
polls the detections at 5 Hz, matches them to the ToF sensors by bearing
and time, and adds a "fusion" block to /telemetry:
      "fusion": {"hazards": [{"class": "person", "source": "fused",
                  "sensor": "ahead", "bearing_deg": -3.1, "distance_m": 0.98,
                  "band": "immediate", "confidence": 0.71,
                  "camera_distance_m": 1.31, "tof_distance_m": 0.98,
                  "tof_dt_ms": 12, "side": "front", "ttc_s": 1.6,
                  "closing_mps": 0.61, "approaching": true,
                  "ttc_source": "tof"}, ...],
                 "age_ms": 80, "camera_fps": 14.8, "camera_age_ms": 160,
                 "config": "fusion_config.json"}
The same block is at GET /hazards (503 while fusion is inactive). In auto
mode the block is absent until the detector has answered once. Every fused
update can be appended to --fusion-log (off by default; give a path only
for a C9 test session): time, ToF readings and hazards, numbers only, no
images. Off by default because the approved data handling for the camera
logs five fields per alert with a distance band, not continuous distances
and bearings.

Approaching hazards (sensor_fusion.py rule 6): each fused hazard carries
ttc_s, closing_mps, approaching, ttc_source and side. The ToF closing rate
is fitted over the last 0.3 s of the ToF history kept here (TOF_HISTORY).
--side front|rear names the end of the trike this Pi watches; without it
the side the detector reports is used.

Testing without hardware:
  python3 telemetry_bridge.py --replay tests/dash_sample.txt --fake-tof
Then open http://localhost:8081/telemetry
"""
import argparse
import binascii
import glob
import ipaddress
import json
import math
import os
import shutil
import signal
import socket
import subprocess
import sys
import threading
import time
from collections import deque

import sensor_fusion
import tof_reader

VERSION = "1.0"
DASH_PREFIX = "DASH "
DASH_BYTES = DASH_PREFIX.encode()
MAX_LINE_BYTES = 4096        # a line longer than this with no newline is dropped (DASH max 576, RAW max 400)
SERIAL_RETRY_S = 2.0         # wait between attempts to open a missing serial port
READ_IDLE_S = 0.02           # after a short read, wait this long so reads come in chunks, not byte by byte
READ_SHORT_BYTES = 512       # a read below this size counts as short
RAW_DIR = "/home/ogeder/rawlog"
RAW_FILE_PREFIX = "rear_raw_"
RAW_MAX_MB = 100.0           # rotate a capture file at this size (about 15 kB/s: 54 MB per hour)
RAW_ROTATE_S = 3600.0        # and at least every hour
RAW_MIN_FREE_MB = 1000.0     # pause writing below this much free disk
RAW_FLUSH_S = 1.0
RAW_RETRY_S = 10.0           # recheck the free space / retry a failed open this often
TOF_RETRY_S = 5.0            # wait between attempts to open the ToF sensors
TOF_REPROBE_S = 60.0         # with a sensor missing, reopen all three this often so a reseated one comes back
TOF_NAMES = ("left", "ahead", "right")
BEACON_PORT = 50808          # TELEMETRY_LINK.md 4.2
BEACON_INTERVAL_S = 2.0
CAMERA_PORT = 8080           # the hazard detector's port, announced in the beacon
TOF_HISTORY = 64             # ToF samples kept for fusion (about 3 s at 20 per second)
HERE = os.path.dirname(os.path.abspath(__file__))


def _reject_constant(name):
    # json.loads accepts NaN, Infinity and -Infinity by default. The
    # contract says unknown values are null, so these make the line bad.
    raise ValueError("non-finite constant %s" % name)


def parse_dash_line(line):
    """Classify one line of serial text.

    Returns ("ignore", None) for a line that does not start with "DASH ",
    ("bad", None) for a DASH line that cannot be used, and ("ok", dict)
    for a good one."""
    line = line.strip("\r\n")
    if not line.startswith(DASH_PREFIX):
        return "ignore", None
    try:
        obj = json.loads(line[len(DASH_PREFIX):], parse_constant=_reject_constant)
    except ValueError:
        return "bad", None
    if not isinstance(obj, dict):
        return "bad", None
    return "ok", obj


# Raw IMU stream (firmware 0.7.5+) --------------------------------------------

# Type words, longest first so "RAW " never claims a RAWH or RAWS line. As
# in the reference decoder, the word may follow other text (on USB serial
# another task's print can land in front of a line); the CRC decides.
RAW_WORDS = ((b"RAWH ", "rawh"), (b"RAWS ", "raws"), (b"RAW ", "raw"))
_HEX_LOWER = frozenset(b"0123456789abcdef")


def raw_crc_ok(body):
    """body: bytes from the type word to the end of the line, no newline.
    True if it ends in " xxxx" (4 lowercase hex digits) and that is the
    CRC-16/CCITT-FALSE of everything before the space, as in
    TelemetryUnit/tools/raw_stream_decode.py. binascii.crc_hqx with init
    0xFFFF is that CRC (poly 0x1021, no reflection, no final XOR), in C."""
    if len(body) < 6 or body[-5] != 0x20 or not _HEX_LOWER.issuperset(body[-4:]):
        return False
    return binascii.crc_hqx(body[:-5], 0xFFFF) == int(body[-4:], 16)


def classify_raw(line):
    """line: bytes, newline removed. None if the line carries no raw type
    word, else (kind, crc_ok) with kind "raw", "rawh" or "raws"."""
    for word, kind in RAW_WORDS:
        p = line.find(word)
        if p >= 0:
            return kind, raw_crc_ok(line[p:].rstrip(b"\r"))
    return None


class RawCapture:
    """Counts raw-stream lines and appends them, with the host receive
    time, to rotating capture files. handle() and tick() are called from
    the serial reader thread only; stats() from any thread."""

    def __init__(self, directory=RAW_DIR, enabled=True, prefix=RAW_FILE_PREFIX,
                 max_mb=RAW_MAX_MB, rotate_s=RAW_ROTATE_S, min_free_mb=RAW_MIN_FREE_MB,
                 keep_mb=0.0, flush_s=RAW_FLUSH_S, retry_s=RAW_RETRY_S):
        self._lock = threading.Lock()
        self.directory = directory
        self.enabled = enabled
        self.prefix = prefix
        self.max_bytes = int(max_mb * 1e6)
        self.rotate_s = rotate_s
        self.min_free_bytes = int(min_free_mb * 1e6)
        self.keep_bytes = int(keep_mb * 1e6)
        self.flush_s = flush_s
        self.retry_s = retry_s
        self.disk_free = lambda d: shutil.disk_usage(d).free     # replaceable in tests
        self.lines = 0            # every line with a raw type word
        self.bad_crc = 0          # the subset that failed the CRC (still written)
        self.by_kind = {"raw": 0, "rawh": 0, "raws": 0}   # good lines per type
        self.bytes_written = 0
        self.not_written = 0      # lines not written: capture paused (disk, open or write error)
        self.write_errors = 0
        self.files = 0            # capture files opened since start
        self.paused = None        # reason, while writing is paused
        self.path = None
        self._f = None
        self._file_bytes = 0
        self._opened = 0.0
        self._last_flush = 0.0
        self._retry_at = 0.0
        self._space_check_at = 0.0

    # Counting and writing

    def handle(self, line, t_host=None):
        """line: bytes, newline removed. Returns None for a line with no raw
        type word (not counted, not written), else the kind or "bad"."""
        r = classify_raw(line)
        if r is None:
            return None
        kind, ok = r
        with self._lock:
            self.lines += 1
            if ok:
                self.by_kind[kind] += 1
            else:
                self.bad_crc += 1
        if self.enabled:
            t = time.time() if t_host is None else t_host
            self._write(b"%.6f " % t + line.rstrip(b"\r") + b"\n")
        return kind if ok else "bad"

    def _pause(self, reason):
        if reason != self.paused:
            print("Raw capture paused: %s" % reason)
        self.paused = reason
        self._retry_at = time.monotonic() + self.retry_s

    def _write(self, data):
        now = time.monotonic()
        if self._f is not None and (self._file_bytes + len(data) > self.max_bytes
                                    or now - self._opened >= self.rotate_s):
            self._close_file()
        if self._f is None:
            if now < self._retry_at or not self._open(now):
                with self._lock:
                    self.not_written += 1
                return
        elif now >= self._space_check_at:
            self._space_check_at = now + self.retry_s
            if not self._space_ok():
                self._close_file()
                with self._lock:
                    self.not_written += 1
                return
        try:
            self._f.write(data)
        except OSError as e:
            with self._lock:
                self.write_errors += 1
                self.not_written += 1
            self._close_file()
            self._pause("write error: %s" % e)
            return
        self._file_bytes += len(data)
        with self._lock:
            self.bytes_written += len(data)

    def _space_ok(self):
        try:
            free = self.disk_free(self.directory)
        except OSError as e:
            self._pause("cannot read free space: %s" % e)
            return False
        if free < self.min_free_bytes:
            self._pause("disk free %.0f MB, below %.0f MB" % (free / 1e6, self.min_free_bytes / 1e6))
            return False
        return True

    def _open(self, now):
        try:
            os.makedirs(self.directory, exist_ok=True)
        except OSError as e:
            self._pause("cannot create %s: %s" % (self.directory, e))
            return False
        if self.keep_bytes > 0:
            self._prune()
        if not self._space_ok():
            return False
        stem = os.path.join(self.directory, self.prefix + time.strftime("%Y-%m-%d_%H%M%S"))
        path, n = stem + ".txt", 1
        while os.path.exists(path):        # a size rotation within the same second
            path, n = "%s_%d.txt" % (stem, n), n + 1
        try:
            self._f = open(path, "xb")
        except OSError as e:
            self._pause("cannot open %s: %s" % (path, e))
            return False
        if self.paused is not None:
            print("Raw capture resumed")
        self.paused = None
        self.path = path
        self._file_bytes = 0
        self._opened = now
        self._last_flush = now
        self._space_check_at = now + self.retry_s
        with self._lock:
            self.files += 1
        print("Raw capture file %s" % path)
        return True

    def _prune(self):
        """Delete the oldest capture files while the directory's total is over keep_bytes."""
        try:
            files = sorted(glob.glob(os.path.join(self.directory, self.prefix + "*.txt")))
            sizes = [os.path.getsize(p) for p in files]
        except OSError:
            return
        total = sum(sizes)
        for p, s in zip(files, sizes):
            if total <= self.keep_bytes:
                break
            try:
                os.remove(p)
                total -= s
                print("Raw capture: deleted %s to stay under %.1f MB" % (p, self.keep_bytes / 1e6))
            except OSError:
                pass

    def tick(self):
        """Call often: flushes the open file once per flush_s."""
        if self._f is None:
            return
        now = time.monotonic()
        if now - self._last_flush >= self.flush_s:
            self.flush()

    def flush(self):
        if self._f is None:
            return
        self._last_flush = time.monotonic()
        try:
            self._f.flush()
        except OSError as e:
            with self._lock:
                self.write_errors += 1
            self._close_file()
            self._pause("flush error: %s" % e)

    def _close_file(self):
        f, self._f = self._f, None
        if f is not None:
            try:
                f.close()
            except OSError:
                with self._lock:
                    self.write_errors += 1

    def close(self):
        self._close_file()

    def stats(self):
        with self._lock:
            return {
                "capture": self.enabled,
                "dir": self.directory if self.enabled else None,
                "file": os.path.basename(self.path) if (self.enabled and self.path) else None,
                "lines": self.lines,
                "bad_crc": self.bad_crc,
                "raw": self.by_kind["raw"],
                "rawh": self.by_kind["rawh"],
                "raws": self.by_kind["raws"],
                "bytes_written": self.bytes_written,
                "not_written": self.not_written,
                "write_errors": self.write_errors,
                "files": self.files,
                "paused": self.paused,
            }


class TelemetryState:
    """Latest ESP32 record and ToF reading, shared between the reader
    threads and the HTTP handler."""

    def __init__(self, serial_label, replay_file=None, raw=None):
        self._lock = threading.Lock()
        self.serial_label = serial_label
        self.raw = raw            # RawCapture, or None
        # File name only (no directories), or None for the live serial port.
        self.replay_file = os.path.basename(replay_file) if replay_file else None
        self.lines = 0
        self.bad_lines = 0
        self._esp32 = None
        self._esp32_t = None
        self._tof = None
        self._tof_t = None
        self._tof_hist = deque(maxlen=TOF_HISTORY)   # (t_mono, {"left": mm or None, ...})
        self._fusion = None

    def handle_line(self, line):
        kind, obj = parse_dash_line(line)
        if kind == "ignore":
            return kind
        with self._lock:
            self.lines += 1
            if kind == "bad":
                self.bad_lines += 1
            else:
                self._esp32 = obj
                self._esp32_t = time.monotonic()
        return kind

    def clear_esp32(self):
        with self._lock:
            self._esp32 = None
            self._esp32_t = None

    def set_tof(self, values):
        """values: {"left": mm or None, ...}, or None when the sensors are absent."""
        with self._lock:
            if values is None:
                self._tof, self._tof_t = None, None
                self._tof_hist.clear()
            else:
                self._tof = {"%s_mm" % n: values.get(n) for n in TOF_NAMES}
                self._tof_t = time.monotonic()
                self._tof_hist.append((self._tof_t, {n: values.get(n) for n in TOF_NAMES}))

    def tof_history(self):
        """Recent ToF samples, oldest first, for the fusion."""
        with self._lock:
            return list(self._tof_hist)

    def set_fusion(self, block):
        """block from sensor_fusion.FusionRunner (with t_mono), or None."""
        with self._lock:
            self._fusion = block

    def fusion_block(self, now=None):
        """The fusion block as served, or None while fusion is inactive."""
        now = time.monotonic() if now is None else now
        with self._lock:
            f = self._fusion
        if f is None:
            return None
        out = {k: v for k, v in f.items() if k != "t_mono"}
        out["age_ms"] = int(round((now - f["t_mono"]) * 1000))
        return out

    def snapshot(self):
        now = time.monotonic()
        with self._lock:
            esp32 = None
            if self._esp32 is not None:
                esp32 = dict(self._esp32)
                esp32["age_ms"] = int(round((now - self._esp32_t) * 1000))
            tof = None
            if self._tof is not None:
                tof = dict(self._tof)
                tof["age_ms"] = int(round((now - self._tof_t) * 1000))
            snap = {
                "esp32": esp32,
                "tof": tof,
                "bridge": {
                    "version": VERSION,
                    "serial_port": self.serial_label,
                    "lines": self.lines,
                    "bad_lines": self.bad_lines,
                    "replay": self.replay_file is not None,
                    "replay_file": self.replay_file,
                    "raw": self.raw.stats() if self.raw is not None else None,
                },
            }
        fusion = self.fusion_block(now)
        if fusion is not None:      # absent, not null, while fusion is inactive (contract unchanged)
            snap["fusion"] = fusion
        return snap


# Serial port access ---------------------------------------------------------

class _PySerialPort:
    def __init__(self, port, baud):
        import serial
        self._serial_mod = serial
        self._s = serial.Serial(port, baud, timeout=0.5)

    def read(self):
        """Some bytes, or b"" after the timeout. Raises OSError when the
        device has gone."""
        try:
            n = self._s.in_waiting
            return self._s.read(n if n > 0 else 1)
        except self._serial_mod.SerialException as e:
            raise OSError(str(e))

    def close(self):
        try:
            self._s.close()
        except Exception:
            pass


class _TermiosPort:
    """Plain tty reading for a Pi without pyserial. Raw mode, 8N1, no echo."""

    def __init__(self, port, baud):
        import select
        import termios
        self._select = select
        self._fd = os.open(port, os.O_RDONLY | os.O_NOCTTY | os.O_NONBLOCK)
        try:
            attrs = termios.tcgetattr(self._fd)
            speed = getattr(termios, "B%d" % baud, termios.B115200)
            attrs[0] = 0                                                      # iflag
            attrs[1] = 0                                                      # oflag
            attrs[2] = termios.CS8 | termios.CREAD | termios.CLOCAL           # cflag
            attrs[3] = 0                                                      # lflag
            attrs[4] = speed
            attrs[5] = speed
            termios.tcsetattr(self._fd, termios.TCSANOW, attrs)
        except Exception:
            os.close(self._fd)
            raise

    def read(self):
        r, _, _ = self._select.select([self._fd], [], [], 0.5)
        if not r:
            return b""
        data = os.read(self._fd, 4096)
        if not data:
            # Readable but empty means the device was unplugged.
            raise OSError("serial device disconnected")
        return data

    def close(self):
        try:
            os.close(self._fd)
        except OSError:
            pass


def open_serial(port, baud):
    try:
        import serial  # noqa: F401
    except ImportError:
        try:
            import termios  # noqa: F401
        except ImportError:
            raise OSError("pyserial is not installed and termios is not available on this system")
        return _TermiosPort(port, baud)
    return _PySerialPort(port, baud)


class LineSource(threading.Thread):
    """Feeds lines into the state, from the serial port or a replay file."""

    def __init__(self, state, stop, port=None, baud=115200, replay=None, replay_interval=1.0):
        super().__init__(daemon=True)
        self.state = state
        self.stop = stop
        self.port = port
        self.baud = baud
        self.replay = replay
        self.replay_interval = replay_interval

    def run(self):
        if self.replay:
            self._run_replay()
        else:
            self._run_serial()

    def _run_replay(self):
        with open(self.replay, "r", encoding="utf-8", errors="replace") as f:
            lines = f.read().splitlines()
        if not lines:
            print("Replay file %s is empty" % self.replay)
            return
        i = 0
        while not self.stop.is_set():
            self.state.handle_line(lines[i % len(lines)])
            i += 1
            self.stop.wait(self.replay_interval)

    def _run_serial(self):
        last_error = None
        while not self.stop.is_set():
            try:
                dev = open_serial(self.port, self.baud)
            except (OSError, ValueError) as e:
                msg = str(e)
                if msg != last_error:
                    print("Serial %s not available (%s); retrying every %.0f s"
                          % (self.port, msg, SERIAL_RETRY_S))
                    last_error = msg
                self.stop.wait(SERIAL_RETRY_S)
                continue
            last_error = None
            print("Serial %s open" % self.port)
            buf = bytearray()
            first = True     # the first line after opening may be a fragment
            raw = self.state.raw
            try:
                while not self.stop.is_set():
                    # The port read returns everything waiting (or blocks up to
                    # 0.5 s for one byte). After a short read the loop waits
                    # READ_IDLE_S, so at 15 kB/s it wakes about 50 times a second
                    # with a few hundred bytes, not once per byte.
                    data = dev.read()
                    if data:
                        buf += data
                        if b"\n" in data:
                            t_host = time.time()
                            lines = buf.split(b"\n")
                            buf = bytearray(lines.pop())
                            for line in lines:
                                if first:
                                    first = False
                                    if not line.startswith(DASH_BYTES) and classify_raw(line) is None:
                                        continue
                                self._line(line, t_host, raw)
                        if len(buf) > MAX_LINE_BYTES:
                            buf = bytearray()
                    if raw is not None:
                        raw.tick()
                    if len(data) < READ_SHORT_BYTES:
                        self.stop.wait(READ_IDLE_S)
            except OSError as e:
                print("Serial %s lost (%s); waiting for it to come back" % (self.port, e))
            finally:
                dev.close()
                self.state.clear_esp32()
                if raw is not None:
                    raw.flush()
            self.stop.wait(SERIAL_RETRY_S / 4)
        if self.state.raw is not None:
            self.state.raw.close()

    def _line(self, line, t_host, raw):
        """One complete line (bytes, no newline): DASH to the state as before,
        raw-stream lines to the capture, anything else ignored."""
        if line.startswith(DASH_BYTES):
            self.state.handle_line(line.decode("utf-8", errors="replace"))
        elif raw is not None:
            raw.handle(line, t_host)


# ToF sensors ----------------------------------------------------------------

class TofReader(threading.Thread):
    """Reads the three VL53L0X sensors with tof_reader.open_sensors, or
    makes up plausible changing distances with fake=True."""

    def __init__(self, state, stop, fake=False, period_s=0.05):
        super().__init__(daemon=True)
        self.state = state
        self.stop = stop
        self.fake = fake
        self.period_s = period_s

    def run(self):
        if self.fake:
            self._run_fake()
        else:
            self._run_real()

    def _run_fake(self):
        t0 = time.monotonic()
        while not self.stop.is_set():
            t = time.monotonic() - t0
            raw = {
                "left": 800 + 150 * math.sin(t / 3.0),
                "ahead": 1500 + 600 * math.sin(t / 5.0),
                # Nothing in range (8190) about a third of the time, so
                # the null path is exercised too.
                "right": 8190 if math.sin(t / 2.0) > 0.5 else 650 + 100 * math.cos(t / 2.0),
            }
            self.state.set_tof({n: tof_reader.clean_mm(v) for n, v in raw.items()})
            self.stop.wait(self.period_s)

    @staticmethod
    def _release(sensors, handles):
        for s in (sensors or {}).values():
            try:
                s.stop_continuous()
            except Exception:
                pass
        for h in reversed(handles):
            try:
                h.deinit()
            except Exception:
                pass
        handles.clear()

    def _run_real(self):
        last_error = None
        last_open = None
        while not self.stop.is_set():
            handles = []
            sensors = None
            reprobe = False
            try:
                sensors = tof_reader.open_sensors(False, handles)
                for s in sensors.values():
                    s.start_continuous()
                missing = [n for n in TOF_NAMES if n not in sensors]
                desc = ", ".join(sensors) + ("; missing: " + ", ".join(missing) if missing else "")
                if desc != last_open:
                    print("ToF sensors open: %s" % desc)
                    last_open = desc
                last_error = None
                opened = time.monotonic()
                while not self.stop.is_set():
                    self.state.set_tof({n: tof_reader.clean_mm(s.range) for n, s in sensors.items()})
                    if missing and time.monotonic() - opened >= TOF_REPROBE_S:
                        reprobe = True        # look for the missing sensor again
                        break
                    self.stop.wait(self.period_s)
            except Exception as e:   # ImportError, OSError, RuntimeError, ValueError from Blinka
                msg = "%s: %s" % (type(e).__name__, e)
                if msg != last_error:
                    print("ToF sensors not available (%s); tof is null, retrying every %.0f s"
                          % (msg, TOF_RETRY_S))
                    last_error = msg
                self.state.set_tof(None)
            finally:
                self._release(sensors, handles)
            if not reprobe:
                self.stop.wait(TOF_RETRY_S)


# Beacon ---------------------------------------------------------------------

def parse_ip_json(text):
    """Broadcast addresses from `ip -j -4 addr` output, loopback and
    point-to-point (/31, /32) excluded. Never raises."""
    try:
        ifaces = json.loads(text or "[]")
    except ValueError:
        return []
    found = []
    for iface in ifaces if isinstance(ifaces, list) else []:
        try:
            if "LOOPBACK" in (iface.get("flags") or []):
                continue
            for a in iface.get("addr_info") or []:
                if a.get("family") != "inet":
                    continue
                b = a.get("broadcast")
                if not b:
                    net = ipaddress.ip_network("%s/%s" % (a["local"], a["prefixlen"]), strict=False)
                    if net.prefixlen >= 31:
                        continue
                    b = str(net.broadcast_address)
                if b not in found:
                    found.append(b)
        except Exception:
            continue
    return found


def broadcast_addresses():
    """IPv4 broadcast addresses of this machine's interfaces. On Linux from
    `ip -j -4 addr`; elsewhere, or if that fails, an empty list."""
    if not sys.platform.startswith("linux"):
        return []
    try:
        out = subprocess.run(["ip", "-j", "-4", "addr"], capture_output=True, text=True,
                             timeout=2).stdout
    except Exception:
        return []
    return parse_ip_json(out)


def default_beacon_targets():
    return ["255.255.255.255"] + [b for b in broadcast_addresses() if b != "255.255.255.255"]


class Beacon(threading.Thread):
    """Sends the discovery packet every interval_s. targets is a list of
    addresses, or None for 255.255.255.255 plus every interface's
    broadcast address (looked up again before each send)."""

    def __init__(self, stop, telemetry_port, camera_port=CAMERA_PORT, port=BEACON_PORT,
                 interval_s=BEACON_INTERVAL_S, targets=None, host=None):
        super().__init__(daemon=True)
        self.stop = stop
        self.telemetry_port = telemetry_port
        self.camera_port = camera_port
        self.port = port
        self.interval_s = interval_s
        self.targets = list(targets) if targets else None
        self.host = host or socket.gethostname().split(".")[0]
        self.seq = 0
        self.sent = 0
        self.send_errors = 0
        self.last_error = None

    def payload(self):
        return {"sw7": "pi4", "v": 1, "host": self.host, "camera_port": self.camera_port,
                "telemetry_port": self.telemetry_port, "seq": self.seq}

    def send_once(self, sock):
        targets = self.targets if self.targets is not None else default_beacon_targets()
        data = json.dumps(self.payload(), separators=(",", ":")).encode()
        for t in targets:
            try:
                sock.sendto(data, (t, self.port))
                self.sent += 1
            except OSError as e:     # no route, network down, broadcast refused
                self.send_errors += 1
                self.last_error = "%s: %s" % (t, e)
        self.seq += 1

    def run(self):
        sock = None
        while not self.stop.is_set():
            try:
                if sock is None:
                    sock = socket.socket(socket.AF_INET, socket.SOCK_DGRAM)
                    sock.setsockopt(socket.SOL_SOCKET, socket.SO_BROADCAST, 1)
                self.send_once(sock)
            except Exception as e:   # never let the beacon take the bridge down
                self.send_errors += 1
                self.last_error = str(e)
                if sock is not None:
                    try:
                        sock.close()
                    except OSError:
                        pass
                    sock = None
            self.stop.wait(self.interval_s)
        if sock is not None:
            sock.close()


# HTTP -----------------------------------------------------------------------

class TelemetryServer:
    def __init__(self, state, port, host="0.0.0.0"):
        from http.server import BaseHTTPRequestHandler, ThreadingHTTPServer
        server = self
        self.state = state
        self.beacon = None       # set by Bridge, for the status page
        self.fusion = None       # set by Bridge, for the status page

        class Handler(BaseHTTPRequestHandler):
            def log_message(self, *a):
                pass

            def _send(self, code, ctype, body):
                self.send_response(code)
                self.send_header("Content-Type", ctype)
                self.send_header("Cache-Control", "no-cache")
                self.send_header("Access-Control-Allow-Origin", "*")
                self.send_header("Content-Length", str(len(body)))
                self.end_headers()
                self.wfile.write(body)

            def do_GET(self):
                path = self.path.split("?", 1)[0]
                if path == "/telemetry":
                    body = json.dumps(server.state.snapshot()).encode()
                    self._send(200, "application/json", body)
                elif path == "/hazards":
                    f = server.state.fusion_block()
                    if f is None:
                        self._send(503, "application/json", b'{"fusion": null, "reason": "fusion inactive"}')
                    else:
                        self._send(200, "application/json", json.dumps(f).encode())
                elif path == "/":
                    self._send(200, "text/plain; charset=utf-8", server.status_text().encode())
                else:
                    self.send_error(404)

        self._httpd = ThreadingHTTPServer((host, port), Handler)
        self._httpd.daemon_threads = True
        self.port = self._httpd.server_address[1]
        self._thread = threading.Thread(target=self._httpd.serve_forever, daemon=True)
        self._thread.start()

    def status_text(self):
        snap = self.state.snapshot()
        b = snap["bridge"]
        e = snap["esp32"]
        t = snap["tof"]
        lines = [
            "SW-7 telemetry bridge %s" % b["version"],
            "serial: %s, %d DASH lines, %d bad" % (b["serial_port"], b["lines"], b["bad_lines"]),
            "source: %s" % ("REPLAY of %s (not live data)" % b["replay_file"] if b["replay"] else "live serial"),
            "esp32: %s" % ("no data" if e is None else "seq %s, %d ms ago" % (e.get("seq"), e["age_ms"])),
            "tof: %s" % ("absent" if t is None else "left %s, ahead %s, right %s mm, %d ms ago" % (
                t["left_mm"], t["ahead_mm"], t["right_mm"], t["age_ms"])),
            "beacon: %s" % ("off" if self.beacon is None else "UDP port %d, %d sent, %d failed%s" % (
                self.beacon.port, self.beacon.sent, self.beacon.send_errors,
                "" if not self.beacon.last_error else " (last: %s)" % self.beacon.last_error)),
            "fusion: %s" % self._fusion_text(snap.get("fusion")),
            "raw: %s" % self._raw_text(b.get("raw")),
            "JSON: /telemetry, /hazards",
        ]
        return "\n".join(lines) + "\n"

    @staticmethod
    def _raw_text(r):
        if r is None:
            return "off"
        counts = "%d lines (RAW %d, RAWH %d, RAWS %d), %d bad CRC" % (
            r["lines"], r["raw"], r["rawh"], r["raws"], r["bad_crc"])
        if not r["capture"]:
            return counts + "; capture to disk off"
        where = ("file %s/%s" % (r["dir"], r["file"])) if r["file"] else ("dir %s (no file yet)" % r["dir"])
        text = "%s; %s, %.1f MB written, %d not written" % (counts, where, r["bytes_written"] / 1e6, r["not_written"])
        if r["paused"]:
            text += "; PAUSED: %s" % r["paused"]
        return text

    def _fusion_text(self, f):
        r = self.fusion
        if r is None:
            return "off"
        if f is None:
            return "waiting for the detector at %s" % r.url
        return "%d hazards (%s), %d updates, camera %s, log %s" % (
            len(f["hazards"]), ", ".join("%s/%s" % (h["class"], h["source"]) for h in f["hazards"]) or "none",
            r.updates, "absent" if f["camera_age_ms"] is None else "%s fps" % f["camera_fps"],
            r.log_path or "off")

    def close(self):
        self._httpd.shutdown()
        self._httpd.server_close()


class Bridge:
    """The whole bridge: line source, ToF reader and HTTP server."""

    def __init__(self, serial_port="/dev/ttyACM0", baud=115200, host="0.0.0.0", port=8081,
                 replay=None, replay_interval=1.0, tof=True, fake_tof=False,
                 beacon=True, beacon_port=BEACON_PORT, beacon_targets=None,
                 beacon_interval_s=BEACON_INTERVAL_S, camera_port=CAMERA_PORT,
                 fusion="off", detections_url=None, fusion_config=None, fusion_log=None, side=None,
                 raw_capture=True, raw_dir=RAW_DIR, raw_max_mb=RAW_MAX_MB, raw_rotate_s=RAW_ROTATE_S,
                 raw_min_free_mb=RAW_MIN_FREE_MB, raw_keep_mb=0.0):
        label = ("replay:%s" % replay) if replay else serial_port
        self.raw = RawCapture(raw_dir, enabled=raw_capture, max_mb=raw_max_mb, rotate_s=raw_rotate_s,
                              min_free_mb=raw_min_free_mb, keep_mb=raw_keep_mb)
        self.state = TelemetryState(label, replay_file=replay, raw=self.raw)
        self.stop = threading.Event()
        self.source = LineSource(self.state, self.stop, serial_port, baud, replay, replay_interval)
        self.tof = TofReader(self.state, self.stop, fake=fake_tof) if (tof or fake_tof) else None
        self.server = TelemetryServer(self.state, port, host)
        self.port = self.server.port
        self.beacon = None
        if beacon:
            self.beacon = Beacon(self.stop, self.port, camera_port, beacon_port,
                                 beacon_interval_s, beacon_targets)
            self.server.beacon = self.beacon
        self.fusion = None
        if fusion in ("on", "auto"):
            self.fusion = sensor_fusion.FusionRunner(
                self.stop, self.state.tof_history, self.state.set_fusion,
                url=detections_url or "http://127.0.0.1:%d/detections" % camera_port,
                config_path=fusion_config, log_path=fusion_log, mode=fusion, side=side)
            self.server.fusion = self.fusion

    def start(self):
        self.source.start()
        if self.tof is not None:
            self.tof.start()
        if self.beacon is not None:
            self.beacon.start()
        if self.fusion is not None:
            self.fusion.start()
        return self

    def close(self):
        self.stop.set()
        self.server.close()
        for t in (self.source, self.tof, self.beacon, self.fusion):
            if t is not None and t.is_alive():
                t.join(timeout=3)
        if not self.source.is_alive():     # otherwise the source closes it on its way out
            self.raw.close()


def main():
    ap = argparse.ArgumentParser(description="SW-7 telemetry bridge: ESP32 serial and ToF to HTTP /telemetry")
    ap.add_argument("--serial-port", default="/dev/ttyACM0")
    ap.add_argument("--baud", type=int, default=115200)
    ap.add_argument("--host", default="0.0.0.0",
                    help="0.0.0.0 = reachable from the Pi 5 on the local network; 127.0.0.1 = this Pi only")
    ap.add_argument("--port", type=int, default=8081)
    ap.add_argument("--replay", default=None, metavar="FILE",
                    help="Read DASH lines from FILE in a loop instead of the serial port (testing)")
    ap.add_argument("--replay-interval", type=float, default=1.0,
                    help="Seconds between replayed lines (default 1, like the ESP32)")
    ap.add_argument("--no-tof", action="store_true", help="Do not read the ToF sensors (tof is null)")
    ap.add_argument("--fake-tof", action="store_true", help="Made-up changing ToF distances (testing)")
    ap.add_argument("--no-beacon", action="store_true",
                    help="Do not send the UDP discovery beacon (port %d)" % BEACON_PORT)
    ap.add_argument("--beacon-port", type=int, default=BEACON_PORT)
    ap.add_argument("--beacon-interval", type=float, default=BEACON_INTERVAL_S)
    ap.add_argument("--beacon-target", action="append", default=None, metavar="ADDR",
                    help="Send the beacon to ADDR only (repeatable; testing). Default: "
                         "255.255.255.255 and every interface's broadcast address")
    ap.add_argument("--camera-port", type=int, default=CAMERA_PORT,
                    help="Camera port announced in the beacon")
    ap.add_argument("--fusion", choices=("auto", "on", "off"), default="auto",
                    help="Camera and ToF fusion (sensor_fusion.py). auto (default): starts once the "
                         "detector answers --detections-url; on: always (ToF-only without the detector); off")
    ap.add_argument("--detections-url", default=None,
                    help="Detector detections URL (default http://127.0.0.1:<camera-port>/detections)")
    ap.add_argument("--fusion-config", default=os.path.join(HERE, "fusion_config.json"),
                    help="Fusion geometry (sensor bearings, cones, ranges); default fusion_config.json "
                         "next to this script, built-in defaults if missing")
    ap.add_argument("--fusion-log", default="",
                    help="Append every fused update here as JSON lines (numbers only), for a C9 test session only; "
                         "off by default (routine logging of distances and bearings is outside the approved data handling)")
    ap.add_argument("--side", choices=("front", "rear"), default=None,
                    help="Which end of the trike this Pi's ToF sensors and camera face, copied to every fused "
                         "hazard. Default: the side the detector reports in /detections, else null")
    ap.add_argument("--raw-dir", default=RAW_DIR,
                    help="Directory for the raw IMU capture files (default %s; created on the first raw line)" % RAW_DIR)
    ap.add_argument("--no-raw-capture", action="store_true",
                    help="Do not write raw IMU lines to disk (they are still counted)")
    ap.add_argument("--raw-max-mb", type=float, default=RAW_MAX_MB,
                    help="Start a new capture file at this size (default %.0f MB)" % RAW_MAX_MB)
    ap.add_argument("--raw-rotate-s", type=float, default=RAW_ROTATE_S,
                    help="Start a new capture file after this many seconds (default %.0f)" % RAW_ROTATE_S)
    ap.add_argument("--raw-min-free-mb", type=float, default=RAW_MIN_FREE_MB,
                    help="Pause writing while the disk has less free space than this (default %.0f MB)" % RAW_MIN_FREE_MB)
    ap.add_argument("--raw-keep-mb", type=float, default=0.0,
                    help="Delete the oldest capture files to keep the directory under this total; 0 (default) never deletes")
    ap.add_argument("--duration", type=float, default=0, help="Seconds to run, 0 = until Ctrl+C or SIGTERM")
    a = ap.parse_args()

    # Stop cleanly under systemd (SIGTERM) the same way as Ctrl+C.
    def _on_sigterm(signum, frame_):
        raise KeyboardInterrupt
    signal.signal(signal.SIGTERM, _on_sigterm)

    bridge = Bridge(a.serial_port, a.baud, a.host, a.port, a.replay, a.replay_interval,
                    tof=not a.no_tof, fake_tof=a.fake_tof, beacon=not a.no_beacon,
                    beacon_port=a.beacon_port, beacon_targets=a.beacon_target,
                    beacon_interval_s=a.beacon_interval, camera_port=a.camera_port,
                    fusion=a.fusion, detections_url=a.detections_url, fusion_config=a.fusion_config,
                    fusion_log=a.fusion_log or None, side=a.side,
                    raw_capture=not a.no_raw_capture, raw_dir=a.raw_dir, raw_max_mb=a.raw_max_mb,
                    raw_rotate_s=a.raw_rotate_s, raw_min_free_mb=a.raw_min_free_mb,
                    raw_keep_mb=a.raw_keep_mb).start()
    print("Telemetry bridge %s on http://%s:%d/telemetry, source %s, tof %s" % (
        VERSION, a.host, bridge.port, bridge.state.serial_label,
        "fake" if a.fake_tof else ("off" if a.no_tof else "sensors")))
    if bridge.beacon is not None:
        print("Beacon every %.0f s to UDP port %d (%s)" % (
            a.beacon_interval, a.beacon_port,
            ", ".join(a.beacon_target) if a.beacon_target else "broadcast on every interface"))
    if bridge.fusion is not None:
        print("Fusion %s: detections from %s, config %s, log %s" % (
            a.fusion, bridge.fusion.url, a.fusion_config, bridge.fusion.log_path or "off"))
    start = time.monotonic()
    try:
        while a.duration == 0 or time.monotonic() - start < a.duration:
            time.sleep(0.2)
    except KeyboardInterrupt:
        pass
    finally:
        bridge.close()
        b = bridge.state.snapshot()["bridge"]
        print("Stopped. %d DASH lines, %d bad, in %.1f s" % (b["lines"], b["bad_lines"], time.monotonic() - start))
        r = b["raw"]
        if r and r["lines"]:
            print("Raw: %d lines, %d bad CRC, %.1f MB written to %s, %d not written" % (
                r["lines"], r["bad_crc"], r["bytes_written"] / 1e6, r["dir"], r["not_written"]))
        if bridge.beacon is not None:
            print("Beacon: %d sent, %d failed" % (bridge.beacon.sent, bridge.beacon.send_errors))
        if bridge.fusion is not None:
            print("Fusion: %d updates, %d detector polls failed" % (bridge.fusion.updates, bridge.fusion.camera_errors))


if __name__ == "__main__":
    main()
