0geder/Tukzie-HPEC-HUD/BenchTest/analysis/run.py

"""Road-characterisation pipeline, one command, no hand steps.

    python -m BenchTest.analysis.run --session BenchTest/logs/roadtest_2026-10-19 --out <folder>
        [--config file.json] [--wheelbase 1.9] [--labels labels.csv] [--tz 2]

Session folder contents used:
  *_roadtest.jsonl          recorder file(s) (BenchTest/road_logger.py), all read in name order
  roadtest_markers.txt      extra markers (only time-stamped lines; the recorder already copies the others in)
  *raw*.txt|.log|.csv       raw IMU stream per node ("front"/"rear" in the name), or cfg.raw_files
  labels.csv                video labels (time, type), or --labels / cfg.labels_csv
  crossings.csv             video crossing times of the section lines (run, t_in, t_out), or cfg.crossings_csv;
                            optional: without it the pass windows are the marker intervals
  session.json              config overrides (keys of config.Config)

Bands (recorded in summary.json under "bands"): ride features in cfg.band_lo_hz to cfg.band_hi_hz; a_w and VDV with
Wk; RQ4 in cfg.pt_band_lo_hz to cfg.pt_band_hi_hz. Repeatability: CV per section and speed; ICC with bins along each
section as rows (repeatability_bin_icc_*), and "n too small, CV only" where there are too few rows or passes.
Potholes: counts per pass and a threshold sweep, labelled descriptive (no ROC).

Writes to --out: tables/*.csv and *.tex, figures/*.pdf and *.png, summary.json. Every analysis that cannot run on
the data present (no raw stream, no markers, no speed, no wheelbase, no labels) is skipped and the reason is
written in summary.json under "skipped", so nothing is filled with a placeholder.
"""
import argparse
import glob
import shutil
import os
import sys

import numpy as np

from . import config as cfgmod
from . import delay as dl
from . import dsp
from . import pothole as ph
from . import powertrain as pt
from . import readers as rd
from . import report as rp
from . import segment as sg
from . import stats as stt


def _speed_fn(dash, cfg):
    if dash is None or not len(dash):
        return None
    ok = dash.fix & np.isfinite(dash.spd_raw)
    if ok.sum() < 2:
        return None
    t, v = dash.t[ok], dash.spd_raw[ok] * cfg.spd_raw_to_mps

    def f(x):
        if x < t[0] - 2 or x > t[-1] + 2:
            return np.nan
        j = np.searchsorted(t, x)
        near = min(abs(x - t[min(j, len(t) - 1)]), abs(x - t[max(j - 1, 0)]))
        return float(np.interp(x, t, v)) if near <= 3.0 else np.nan
    return f


def _find_raw(session, cfg):
    if cfg.raw_files:
        return {n: os.path.join(session, p) for n, p in cfg.raw_files.items()}
    out = {}
    for p in sorted(glob.glob(os.path.join(session, "*raw*"))):
        if os.path.splitext(p)[1].lower() not in (".txt", ".log", ".csv"):
            continue
        b = os.path.basename(p).lower()
        node = "front" if "front" in b else "rear" if "rear" in b else os.path.splitext(b)[0]
        out.setdefault(node, []).append(p)
    return out


def _raw_span(path):
    """(first host_t, first t_us, last host_t, last t_us) of the RAW lines of one file, from its head and tail."""
    def parse(line):
        f = line.split()
        if len(f) > 6 and f[1] == "RAW":
            try:
                return float(f[0]), int(f[6])
            except ValueError:
                return None
        return None
    first = last = None
    with open(path, "rb") as fh:
        for line in fh.read(200000).decode("utf-8", "replace").splitlines():
            first = first or parse(line)
        size = fh.seek(0, 2)
        fh.seek(max(0, size - 200000))
        for line in fh.read().decode("utf-8", "replace").splitlines():
            last = parse(line) or last
    if not first or not last:
        return None
    return first[0], first[1], last[0], last[1]


def _pick_raw(paths, runs, workdir, node):
    """26 Oct 2026: capture rotates its file every hour and a node may reboot, so join the files of one boot
    (device time keeps rising from one file to the next) and keep the boot that overlaps the marked runs most.
    Returns (path to read, note)."""
    spans = [(p, _raw_span(p)) for p in paths]
    spans = sorted([s for s in spans if s[1]], key=lambda s: s[1][0])
    groups = []
    for p, sp in spans:
        if groups and sp[1] > groups[-1][-1][1][3]:
            groups[-1].append((p, sp))
        else:
            groups.append([(p, sp)])
    wins = [(r.t0, r.t1) for r in runs if np.isfinite(r.t0) and np.isfinite(r.t1)] if runs else []

    def score(g):
        a, b = g[0][1][0], g[-1][1][2]
        if wins:
            return sum(max(0.0, min(b, w1) - max(a, w0)) for w0, w1 in wins)
        return b - a
    best = max(groups, key=score)
    os.makedirs(workdir, exist_ok=True)
    pieces = _split_boots([p for p, _ in best], workdir, node)
    if len(pieces) == 1:
        joined, n_boots = pieces[0][0], 1
    else:
        joined = max(pieces, key=lambda c: score([(None, (c[1], 0, c[2], 0))]))[0]
        n_boots = len(pieces)
    note = (f"{node}: {len(paths)} raw files in {len(groups)} boot group(s); used {len(best)} file(s) "
            f"({', '.join(os.path.basename(p) for p, _ in best)})"
            + (f"; a reboot inside the files split them into {n_boots} pieces, the one overlapping the runs kept"
               if n_boots > 1 else ""))
    return joined, note


def _split_boots(paths, workdir, node):
    """Join files and cut wherever a RAW line's device time falls by more than 1 s (a reboot inside a file).
    Header (RAWH) and sync (RAWS) lines go with the piece they appear in. Returns [(path, host_first, host_last)]."""
    pieces, out, last_t, k = [], None, None, 0
    first_h = last_h = None

    def close():
        if out is not None:
            out.close()
            pieces.append((out.name, first_h if first_h is not None else 0.0, last_h if last_h is not None else 0.0))
    for p in paths:
        with open(p, encoding="utf-8", errors="replace") as fh:
            for line in fh:
                f = line.split(" ", 7)
                if len(f) > 6 and f[1] == "RAW":
                    try:
                        h, tu = float(f[0]), int(f[6])
                    except ValueError:
                        h = tu = None
                    if tu is not None and last_t is not None and tu < last_t - 1_000_000:
                        close(); out = None
                    if tu is not None:
                        last_t = tu
                        if out is None or first_h is None:
                            pass
                if out is None:
                    k += 1
                    out = open(os.path.join(workdir, f"{node}_raw_part{k}.txt"), "w", encoding="utf-8")
                    first_h = last_h = None
                if len(f) > 6 and f[1] == "RAW":
                    try:
                        h = float(f[0])
                        first_h = h if first_h is None else first_h
                        last_h = h
                    except ValueError:
                        pass
                out.write(line)
    close()
    return pieces


def _phone_speed_fn(session):
    """Speed from the phone's NMEA log (phone_gps_bridge.py: '<Pi epoch> <sentence>'), RMC sentences with status A.
    Returns (function of epoch time, number of fixes) or (None, 0)."""
    tt, vv = [], []
    for p in sorted(glob.glob(os.path.join(session, "*phone_gps*.txt"))):
        with open(p, encoding="utf-8", errors="replace") as fh:
            for line in fh:
                f = line.split(" ", 1)
                if len(f) < 2 or "RMC," not in f[1]:
                    continue
                parts = f[1].split(",")
                try:
                    if parts[2] != "A" or parts[7] == "":
                        continue
                    tt.append(float(f[0])); vv.append(float(parts[7]) * 0.514444)
                except (ValueError, IndexError):
                    continue
    if len(tt) < 2:
        return None, 0
    o = np.argsort(tt)
    t, v = np.array(tt)[o], np.array(vv)[o]

    def fn(x):
        if x < t[0] - 2 or x > t[-1] + 2:
            return np.nan
        j = np.searchsorted(t, x)
        near = min(abs(x - t[min(j, len(t) - 1)]), abs(x - t[max(j - 1, 0)]))
        return float(np.interp(x, t, v)) if near <= 3.0 else np.nan
    return fn, len(t)


ROAD_KINDS = ("smooth", "rough", "bump", "obstacle", "coast", "other")


def _group(row):
    """Repeatability group: section and speed setting, so passes at different speeds are not pooled in one CV."""
    g = " ".join(x for x in (row.get("section") or "", row.get("setting") or "") if x)
    return g or "all"


def _pass_speed(name, pm_rows, key, delays=None):
    """(mean, sd, source) speed of a pass in m/s: video crossings, else GNSS, else wheelbase / delay."""
    row = next((x for x in pm_rows if x["stream"] == key and x["run"] == name), {})
    if np.isfinite(row.get("speed_video", np.nan)):
        return row["speed_video"], 0.0, "video crossings"
    if np.isfinite(row.get("speed_mean", np.nan)):
        return row["speed_mean"], row.get("speed_sd", np.nan), "GNSS"
    d = next((x for x in delays or [] if x["run"] == name), {})
    if np.isfinite(d.get("speed_mps", np.nan)):
        return d["speed_mps"], np.nan, "wheelbase / delay"
    return np.nan, np.nan, ""


def _bin_icc(vert, passes, win, length, crossings, speed_fn, cfg):
    """Bin ICC rows: per section and speed, and pooled over sections at each speed (bins of every section as rows)."""
    groups = {}
    for r in passes:
        t0, t1 = win[r.name]
        edges, how = sg.section_bins(t0, t1, length[r.name], cfg.icc_bin_m, speed_fn, r.name in crossings)
        b = dsp.bin_metrics(vert, edges)
        groups.setdefault((r.section, r.setting), []).append((r.pass_no if r.pass_no is not None else r.name, b, how))
    out = []
    for m in cfg.icc_metrics:
        for (sec, setting), items in groups.items():
            table = {p: [x[m] for x in b] for p, b, _ in items}
            res = stt.bin_icc(table, cfg.icc_min_rows, cfg.icc_min_passes)
            out.append({"group": " ".join(x for x in (sec, setting) if x) or "all", "metric": m,
                        "bins_method": "; ".join(sorted({h for _, _, h in items})), **_icc_cols(res)})
        for setting in sorted({k[1] for k in groups}):
            secs = sorted(k[0] for k in groups if k[1] == setting)
            if len(secs) < 2:
                continue
            common = set.intersection(*[{p for p, _, _ in groups[(s, setting)]} for s in secs])
            table = {}
            for p in common:
                vals = []
                for s in secs:
                    b = next(b for q, b, _ in groups[(s, setting)] if q == p)
                    nb = min(len(bb) for _, bb, _ in groups[(s, setting)])
                    vals += [x[m] for x in b[:nb]]
                table[p] = vals
            res = stt.bin_icc(table, cfg.icc_min_rows, cfg.icc_min_passes)
            out.append({"group": f"sections {'+'.join(secs)} {setting}".strip(), "metric": m,
                        "bins_method": "bins of every section as rows, passes matched by repeat number",
                        **_icc_cols(res)})
    return out


def _icc_cols(res):
    return {"n_rows": res["n_rows"], "bins_per_pass": res["bins_per_pass"], "k_passes": res["k_passes"],
            "ICC(2,1)": res["icc2_1"], "ICC(2,1) CI": res["icc2_1_ci"], "ICC(3,1)": res["icc3_1"],
            "ICC(3,1) CI": res["icc3_1_ci"], "status": res["status"]}


def analyse_session(session, out, cfg=None, labels=None, tz_h=2.0, make_figures=True):
    cfg = cfg or cfgmod.load_config(session)
    tdir, fdir = os.path.join(out, "tables"), os.path.join(out, "figures")
    S = {"session": os.path.abspath(session), "config": cfg.to_dict(), "skipped": {}, "notes": [], "outputs": []}
    rec_files = sorted(glob.glob(os.path.join(session, "*_roadtest.jsonl")))
    S["recorder_files"] = [os.path.basename(p) for p in rec_files]

    # ---- 1. DASH records, dedup, driving --------------------------------------------------------------------
    dash = {}
    for src in ("rear", "front"):
        d = rd.read_dash(rec_files, src, cfg.readable_fields) if rec_files else None
        if d is not None and len(d):
            dash[src] = d
    S["dash"] = {k: v.stats for k, v in dash.items()}
    rear = dash.get("rear")
    segs = []
    if rear is not None:
        drv = sg.label_driving(rear.i, rear.vib, cfg.drive_current_a, cfg.drive_vib)
        segs = sg.driving_segments(rear.t, drv, cfg.drive_join_s)
        rdbl = rear.readable
        vd, vp = rear.vib[drv & rdbl], rear.vib[~drv & rdbl]
        S["driving"] = {
            "rule": f"|i| > {cfg.drive_current_a} A or vib > {cfg.drive_vib}; segments at most {cfg.drive_join_s} s "
                    "apart joined",
            "records_driving": int(drv.sum()), "records_driving_readable": int((drv & rdbl).sum()),
            "records_parked_readable": int((~drv & rdbl).sum()),
            "vib_median_parked": float(np.nanmedian(vp)) if len(vp) else None,
            "vib_median_driving": float(np.nanmedian(vd)) if len(vd) else None,
            "vib_p95_driving": float(np.nanpercentile(vd, 95)) if len(vd) else None,
            "vib_max_driving": float(np.nanmax(vd)) if len(vd) else None,
            "current_max_abs": float(np.nanmax(np.abs(rear.i))) if np.isfinite(rear.i).any() else None,
            "segments": len(segs),
            "segment_seconds_inclusive": float(sum(b - a + 1 for a, b in segs)),
            "gnss_fix_records": int(rear.fix.sum()),
        }
        rows = [{"segment": k + 1, "start_epoch": a, "end_epoch": b, "duration_s": b - a + 1,
                 "records": int(np.sum((rear.t >= a) & (rear.t <= b))),
                 "vib_median": float(np.nanmedian(rear.vib[(rear.t >= a) & (rear.t <= b)]))}
                for k, (a, b) in enumerate(segs)]
        S["outputs"].append(rp.write_table(rows, os.path.join(tdir, "driving_segments")))
    else:
        S["skipped"]["driving"] = "no rear DASH records in the recorder file"

    # ---- 2. markers and runs ------------------------------------------------------------------------------------
    markers, untimed = rd.read_markers(rec_files, os.path.join(session, "roadtest_markers.txt"))
    t_end = max((d.t[-1] for d in dash.values()), default=None)
    runs = [sg.classify_run(r, cfg) for r in sg.runs_from_markers(markers, cfg.start_word, cfg.stop_word, t_end)]
    S["markers"] = [{"t": t, "text": x} for t, x in markers]
    S["markers_untimed"] = untimed
    S["runs"] = [{"name": r.name, "t0": r.t0, "t1": r.t1, "duration_s": r.duration, "closed": r.closed,
                  "section": r.section, "kind": r.kind, "setting": r.setting, "pass_no": r.pass_no} for r in runs]
    if runs:
        S["outputs"].append(rp.write_table(S["runs"], os.path.join(tdir, "runs")))
    else:
        S["skipped"]["runs"] = (f"no '{cfg.start_word}'/'{cfg.stop_word}' marker pairs in the session "
                                f"({len(markers)} markers found)")
    if make_figures and rear is not None:
        S["outputs"].append(rp.fig_session(rear, None, segs, markers, os.path.join(fdir, "session"), tz_h))

    # DASH-only per-run table (works without the raw stream)
    if runs and rear is not None:
        rows = []
        for r in runs:
            m = (rear.t >= r.t0) & (rear.t < r.t1)
            rows.append({"run": r.name, "kind": r.kind, "section": r.section, "records": int(m.sum()),
                         "vib_median": float(np.nanmedian(rear.vib[m])) if m.any() else np.nan,
                         "vib_p95": float(np.nanpercentile(rear.vib[m], 95)) if m.any() else np.nan,
                         "current_median_abs": float(np.nanmedian(np.abs(rear.i[m]))) if m.any() else np.nan})
        S["outputs"].append(rp.write_table(rows, os.path.join(tdir, "runs_dash")))

    # ---- 3. raw streams ----------------------------------------------------------------------------------------
    raw_paths = _find_raw(session, cfg)
    verts = {}
    S["raw"] = {}
    for node, plist in raw_paths.items():
        p, note = _pick_raw(plist, runs, os.path.join(out, "_raw"), node)
        if note:
            S["notes"].append(note)
        streams = rd.read_raw_stream(p, node)
        for (nd, imu), s in streams.items():
            key = f"{nd}{s.imu}"
            host = s.host_t
            clock, basis = None, "device time (no clock map)"
            pi_edges = cfg.sync_edges.get(nd) if cfg.sync_edges else None
            sc = rd.sync_clock(s, pi_edges) if s.sync is not None else None
            if sc is not None and pi_edges is not None:
                clock, basis = sc[:2], "RAWS sync edges against the Pi's GPIO time stamps"
            elif np.isfinite(host).sum() >= 2:
                clock, basis = rd.fit_clock(s.t_s, host)[:2], "host receive time stamps on the raw lines"
            elif nd in dash and np.isfinite(dash[nd].up_ms).sum() >= 2:
                clock, basis = rd.dash_clock(dash[nd])[:2], f"{nd} DASH up_ms against recorder time"
            v = dsp.make_vertical(s, cfg, clock)
            verts[key] = v
            S["raw"][key] = {"file": os.path.basename(p), **s.stats, **v.stats, "clock": basis}
    if not verts:
        S["skipped"]["raw"] = ("no raw IMU stream file in the session (firmware v0.7.4 had none); a_w, VDV, "
                               "per-second features, repeatability, delay, powertrain and pothole analyses need it")
        rp.write_json(S, os.path.join(out, "summary.json"))
        return S

    phone_fn, n_phone = _phone_speed_fn(session)
    if phone_fn is not None:
        speed_fn, S["speed_source"] = phone_fn, f"phone GNSS (RMC, {n_phone} fixes)"
    else:
        speed_fn = _speed_fn(rear, cfg)
        S["speed_source"] = "vehicle GNSS" if speed_fn is not None else None
    if speed_fn is None:
        S["notes"].append("no GNSS speed (no fix): speed index and speed-dependent threshold use no speed")
    passes = [r for r in runs if r.kind in ROAD_KINDS]
    stationary = [r for r in runs if r.kind == "stationary"]
    S["bands"] = {
        "ride_hz": [cfg.band_lo_hz, cfg.band_hi_hz],
        "ride_used_for": "sigma, crest, p2p, jerk, sigma^2/v, pothole detector, front-to-rear delay",
        "wk": "ISO 2631-1 Wk (0.4 to 100 Hz analogue band limiting) on the unfiltered vertical, up to fs/2: a_w, VDV",
        "rq4_hz": [cfg.pt_band_lo_hz, cfg.pt_band_hi_hz],
        "rq4_used_for": "powertrain peaks, line energy share, sub-band energies, coasting against powered",
        "rq4_sub_bands_hz": [list(b) for b in cfg.pt_sub_bands]}

    # pass windows: the video crossing times of the section lines if given, else the markers
    cr_path = cfg.crossings_csv or ("crossings.csv" if os.path.isfile(os.path.join(session, "crossings.csv")) else None)
    if cr_path and not os.path.isabs(cr_path):
        cr_path = os.path.join(session, cr_path)
    crossings = sg.read_crossings(cr_path) if cr_path and os.path.isfile(cr_path) else {}
    S["crossings"] = {"file": os.path.basename(cr_path) if crossings else None, "runs": len(crossings)}
    if not crossings:
        S["notes"].append("no crossings.csv (video times of the section lines): pass windows are the marker "
                          "intervals, which include the run-up and braking")
    win = {r.name: crossings.get(r.name, (r.t0, r.t1)) for r in passes + stationary}
    length = {r.name: cfg.section_lengths_m.get(r.section, cfg.section_length_m) for r in passes}

    # ---- 4. per-pass metrics --------------------------------------------------------------------------------------
    pm_rows = []
    for key, v in verts.items():
        for r in passes + stationary:
            t0, t1 = win[r.name]
            m = dsp.pass_metrics(v, t0, t1, cfg, speed_fn)
            if m.get("n", 0) == 0:
                continue
            on_lines = r.name in crossings
            km = (length[r.name] / 1000 if on_lines else
                  m.get("speed_mean", np.nan) * (t1 - t0) / 1000 if np.isfinite(m.get("speed_mean", np.nan))
                  else np.nan)
            pm_rows.append({"stream": key, "run": r.name, "section": r.section, "kind": r.kind,
                            "pass_no": r.pass_no, "setting": r.setting, "window": "video crossings" if on_lines
                            else "markers", "duration_s": t1 - t0, "km": km,
                            "speed_video": length[r.name] / (t1 - t0) if on_lines and t1 > t0 else np.nan, **m})
    if pm_rows:
        S["outputs"].append(rp.write_table(pm_rows, os.path.join(tdir, "pass_metrics")))
    else:
        S["skipped"]["pass_metrics"] = "no marked run overlaps the raw stream"

    # ---- 5. repeatability --------------------------------------------------------------------------------------------
    # CV per section and speed over passes; ICC with bins along each section as rows and passes as columns (one
    # section has no between-section variance), pooled over sections at the same speed when there are several.
    S["repeatability"] = {}
    rep_kinds = ("smooth", "rough", "other")
    for key in verts:
        rows = [dict(r, section=_group(r)) for r in pm_rows if r["stream"] == key and r["kind"] in rep_kinds]
        if len(rows) < 2:
            continue
        rep = stt.repeatability(rows, n_boot=cfg.n_boot, seed=cfg.seed, min_rows=cfg.icc_min_rows,
                                min_passes=cfg.icc_min_passes)
        rep["bins"] = _bin_icc(verts[key], [r for r in passes if r.kind in rep_kinds], win, length, crossings,
                               speed_fn, cfg)
        S["repeatability"][key] = rep
        S["outputs"].append(rp.write_table(rep["per_section"], os.path.join(tdir, f"repeatability_cv_{key}")))
        icc_rows = [{"metric": m, "rows": "sections", "n_rows": d["n_sections"], "passes": d["k_passes"],
                     "ICC(2,1)": d["icc2_1"], "ICC(2,1) CI": d["icc2_1_ci"], "ICC(3,1)": d["icc3_1"],
                     "ICC(3,1) CI": d["icc3_1_ci"], "status": d.get("status", "")}
                    for m, d in rep["icc"].items()]
        if icc_rows:
            S["outputs"].append(rp.write_table(icc_rows, os.path.join(tdir, f"repeatability_icc_{key}")))
        if rep["bins"]:
            S["outputs"].append(rp.write_table(rep["bins"], os.path.join(tdir, f"repeatability_bin_icc_{key}")))
        if make_figures:
            S["outputs"].append(rp.fig_pass_metric(rows, "a_w", "$a_w$ (m/s$^2$)",
                                                   os.path.join(fdir, f"pass_aw_{key}")))
    if not S["repeatability"]:
        S["skipped"]["repeatability"] = "fewer than two marked road passes on the raw stream"

    # ---- 6. front to rear delay ------------------------------------------------------------------------------------
    fk = next((k for k in verts if k.startswith("front")), None)
    rk = next((k for k in verts if k.startswith("rear")), None)
    if fk and rk and passes:
        rows = []
        for r in passes:
            d = dl.front_rear_delay(verts[fk], verts[rk], r.t0, r.t1, cfg.fs, cfg.wheelbase_m, cfg.delay_min_s,
                                    cfg.delay_max_s, cfg.delay_window_s, n_boot=cfg.n_boot, seed=cfg.seed)
            rows.append({"run": r.name, **d})
        S["delay"] = rows
        S["outputs"].append(rp.write_table(rows, os.path.join(tdir, "front_rear_delay")))
        if not cfg.wheelbase_m:
            S["notes"].append("wheelbase_m not set: delay reported, speed not computed")
    else:
        S["skipped"]["delay"] = "needs raw streams from both a front and a rear node and marked passes"

    # ---- 7. powertrain (RQ4 band, not the ride band) ------------------------------------------------------------------
    key0 = rk or next(iter(verts))
    st_psd = {}
    for r in stationary:
        f, p = pt.psd_of(verts[key0], r.t0, r.t1, cfg.welch_seg_s)
        if len(f):
            name = r.setting or r.name
            st_psd[name if name not in st_psd else f"{name} {r.pass_no or len(st_psd)}"] = (f, p)
    road_psd = {r.name: pt.psd_of(verts[key0], *win[r.name], cfg.welch_seg_s) for r in passes}
    road_psd = {k: v for k, v in road_psd.items() if len(v[0])}
    speeds = {r.name: _pass_speed(r.name, pm_rows, key0, S.get("delay")) for r in passes}
    if st_psd or road_psd:
        res = pt.powertrain(st_psd, road_psd, cfg, speeds)
        S["powertrain"] = {"stream": key0, "band_hz": res["band_hz"], "peaks": res["peaks"],
                           "lines_hz": res["lines_hz"], "fixed_lines_hz": res["fixed_lines_hz"],
                           "fixed_lines_source": res["fixed_lines_source"], "orders": res["orders"],
                           "orders_source": res["orders_source"], "ratios": res["ratios"]}
        if st_psd:
            prow = [{"setting": s, **pk} for s, v in res["peaks"].items() for pk in v]
            S["outputs"].append(rp.write_table(prow or [{"setting": s, "f_hz": None} for s in res["peaks"]],
                                               os.path.join(tdir, "powertrain_peaks")))
            S["outputs"].append(rp.write_table(res["stands"], os.path.join(tdir, "powertrain_stands")))
        else:
            S["notes"].append("no stand run in this session: RQ4 lines are the 23 Oct stand lines "
                              f"{list(cfg.pt_stand_lines_hz)} Hz")
        if res["ratios"]:
            S["outputs"].append(rp.write_table(res["ratios"], os.path.join(tdir, "powertrain_ratios")))
            kinds = {r.name: r.kind for r in passes}
            coast = pt.coast_vs_powered(res["ratios"], kinds, {r.name: r.section for r in passes}, cfg)
            if coast:
                S["powertrain"]["coast_vs_powered"] = coast
                S["outputs"].append(rp.write_table(coast, os.path.join(tdir, "powertrain_coast")))
        if make_figures:
            S["outputs"].append(rp.fig_psd(st_psd, road_psd, res["lines_hz"] or res["fixed_lines_hz"],
                                           os.path.join(fdir, "psd"), (cfg.pt_band_lo_hz, cfg.pt_band_hi_hz)))
    else:
        S["skipped"]["powertrain"] = "no marked stand run or road pass on the raw stream"

    # ---- 8. potholes (descriptive counts, no ROC) ---------------------------------------------------------------------
    lab_path = labels or cfg.labels_csv or (os.path.join(session, "labels.csv")
                                             if os.path.isfile(os.path.join(session, "labels.csv")) else None)
    if lab_path and not os.path.isabs(lab_path) and not os.path.isfile(lab_path):
        lab_path = os.path.join(session, lab_path)
    lt, ly = rd.read_labels(lab_path) if lab_path and os.path.isfile(lab_path) else (np.array([]), np.array([]))
    S["pothole"] = {"stream": key0}
    pr = []
    for r in passes:
        t0, t1 = win[r.name]
        cands = ph.candidates_vertical(verts[key0], t0, t1, cfg, speed_fn)
        row = next((x for x in pm_rows if x["stream"] == key0 and x["run"] == r.name), {})
        t_ev = None
        if r.kind == "obstacle" and len(lt):
            m = (lt >= t0) & (lt < t1)
            t_ev = float(lt[m][0]) if m.any() else None
        pr.append({"name": r.name, "kind": r.kind, "cands": cands, "km": row.get("km", np.nan), "t0": t0, "t1": t1,
                   "speed": row.get("speed_mean", np.nan), "t_event": t_ev})
    smooth = [p for p in pr if p["kind"] == "smooth"]
    obst = [p for p in pr if p["kind"] == "obstacle"]
    a, b = cfg.ph_threshold_a, cfg.ph_threshold_b
    c_shape = (b / a) if a else 0.0
    if smooth and obst:
        cal = ph.calibrate(smooth, obst, cfg)
        a, b, c_shape = cal["a"], cal["b"], cal["c"]
        S["pothole"]["threshold"] = {k: cal[k] for k in ("a", "b", "c", "rule", "chosen", "basis", "smooth_km",
                                                         "obstacle_events", "descriptive")}
    elif a is None:
        S["skipped"]["pothole_threshold"] = "needs marked smooth and obstacle passes (or ph_threshold_a in config)"
    if pr:
        sw = ph.sweep(pr, cfg, b_over_a=c_shape, label_t=lt, label_type=ly)
        S["outputs"].append(rp.write_table(sw, os.path.join(tdir, "pothole_sweep")))
        if make_figures:
            S["outputs"].append(rp.fig_sweep(sw, a, os.path.join(fdir, "pothole_sweep")))
    if a is not None and pr:
        counts = ph.pass_counts(pr, a, b, cfg, lt, ly)
        S["pothole"]["counts"] = ph.counts_summary(counts)
        S["outputs"].append(rp.write_table(counts, os.path.join(tdir, "pothole_counts")))
    if a is not None:
        t0 = min(c.t[0] for c in verts[key0].chunks) if verts[key0].chunks else 0
        t1 = max(c.t[-1] for c in verts[key0].chunks) + 1 if verts[key0].chunks else 0
        drive_segs = segs or [(t0, t1)]
        events = []
        for sa, sb in drive_segs:
            events += ph.detect(ph.candidates_vertical(verts[key0], sa, sb + 1, cfg, speed_fn), a, b)
        S["pothole"]["events"] = len(events)
        S["outputs"].append(rp.write_table(events or [{"t": None}], os.path.join(tdir, "pothole_events")))
        if len(lt):
            km = np.nan
            if speed_fn is not None:
                tt = np.concatenate([np.arange(sa, sb + 1, 1.0) for sa, sb in drive_segs])
                vv = np.array([speed_fn(x) for x in tt])
                km = float(np.nansum(vv) / 1000) if np.isfinite(vv).any() else np.nan
            ev = ph.evaluate(events, lt, ly, cfg.ph_label_tol_s, ("pothole",), (t0, t1), km)
            ev["km"] = km
            ev["wording"] = (f"descriptive, n = {ev['labels']} labelled potholes, "
                             + (f"{km:.3f} km driven" if np.isfinite(km) else "distance unknown")
                             + f": {ev['tp']} hits, {ev['fn']} misses, {ev['fp']} false alarms")
            S["pothole"]["evaluation"] = ev
            S["outputs"].append(rp.write_table([{k: v for k, v in ev.items() if k != "matches"}],
                                               os.path.join(tdir, "pothole_evaluation")))
        else:
            S["skipped"]["pothole_evaluation"] = "no video labels CSV"
    rp.write_json(S, os.path.join(out, "summary.json"))
    return S


def main(argv=None):
    ap = argparse.ArgumentParser(description="SW-7 road characterisation pipeline")
    ap.add_argument("--session", required=True)
    ap.add_argument("--out", required=True)
    ap.add_argument("--config")
    ap.add_argument("--wheelbase", type=float, help="front to rear axle distance, m (measured)")
    ap.add_argument("--labels", help="video labels CSV (time,type)")
    ap.add_argument("--tz", type=float, default=2.0, help="local time offset for figures, hours")
    ap.add_argument("--no-figures", action="store_true")
    a = ap.parse_args(argv)
    cfg = cfgmod.load_config(a.session, a.config, {"wheelbase_m": a.wheelbase})
    S = analyse_session(a.session, a.out, cfg, a.labels, a.tz, not a.no_figures)
    print("summary:", os.path.join(a.out, "summary.json"))
    for k, v in S["skipped"].items():
        print(f"  skipped {k}: {v}")
    return 0


if __name__ == "__main__":
    sys.exit(main())
