0geder/Tukzie-HPEC-HUD/CameraDetection/tests/test_sensor_fusion.py

"""Offline tests of the camera and ToF fusion: sensor_fusion.py, the
detector's GET /detections (hazard_detector.py) and the fusion block of
telemetry_bridge.py. No camera, no ToF sensors, no Raspberry Pi.

Run from anywhere: python CameraDetection/tests/test_sensor_fusion.py
(or with pytest)."""
import json
import os
import sys
import tempfile
import threading
import time
import unittest
import urllib.error
import urllib.request
from http.server import BaseHTTPRequestHandler, ThreadingHTTPServer

HERE = os.path.dirname(os.path.abspath(__file__))
ROOT = os.path.dirname(HERE)
REPO = os.path.dirname(ROOT)
sys.path.insert(0, ROOT)
sys.path.insert(0, os.path.join(REPO, "BenchTest"))
import sensor_fusion as sf  # noqa: E402
import hazard_detector as hd  # noqa: E402
import fusion_report  # noqa: E402

from test_telemetry_bridge import BridgeProcess, get, get_json, SAMPLE  # noqa: E402

CFG = sf.load_config(None)
T = 1000.0   # frame time used throughout, local monotonic seconds


def x_for_bearing(b, hfov=53.5):
    import math
    return 0.5 + math.tan(math.radians(b)) / (2 * math.tan(math.radians(hfov / 2)))


def det(cls, bearing, est, conf=0.8, width=0.1):
    x = x_for_bearing(bearing)
    return {"class": cls, "confidence": conf, "bbox": [x - width / 2, 0.2, x + width / 2, 0.9],
            "bearing_deg": bearing, "est_distance_m": est, "band": sf.band_for(est)}


def hist(values, t_end=T, n=5, period=0.05):
    """n identical ToF samples ending at t_end."""
    return [(t_end - (n - 1 - k) * period, dict(values)) for k in range(n)]


NONE3 = {"left": None, "ahead": None, "right": None}


class BearingTests(unittest.TestCase):
    def test_bearing_from_x(self):
        self.assertAlmostEqual(sf.bearing_from_x(0.5, 53.5), 0.0)
        self.assertAlmostEqual(sf.bearing_from_x(1.0, 53.5), 26.75, places=6)
        self.assertAlmostEqual(sf.bearing_from_x(0.0, 53.5), -26.75, places=6)
        self.assertAlmostEqual(sf.bearing_from_x(0.2, 53.5, mirror=True), -sf.bearing_from_x(0.2, 53.5))
        # pinhole, not linear: halfway from the centre to the edge is more than half the half-angle
        self.assertAlmostEqual(sf.bearing_from_x(0.75, 53.5), 14.15, places=2)
        for b in (-26.0, -10.0, 0.0, 7.5, 20.0):
            self.assertAlmostEqual(sf.bearing_from_x(x_for_bearing(b), 53.5), b, places=6)

    def test_detector_and_fusion_agree(self):
        for x in (0.0, 0.1, 0.37, 0.5, 0.81, 1.0):
            self.assertAlmostEqual(hd.bearing_deg(x, 53.5), sf.bearing_from_x(x, 53.5), places=9)
        self.assertEqual(hd.DEFAULT_HFOV_DEG, CFG["camera_hfov_deg"])
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
