0geder/Tukzie-HPEC-HUD/(commit log)

2026-08-27 feat: integrate ESP32-S3 A7670X telemetry firmware
    - Add PlatformIO configuration for ESP32-S3 DevKitC-1
    - Configure USB serial monitoring and COM10 upload settings
    - Add A7670X UART communication on GPIO47 and GPIO48
    - Add USB serial boot wait with a three-second timeout
    - Add startup status and firmware version banner
    - Send AT, AT+CPIN?, AT+CSQ, and AT+CREG? modem checks
    - Add two-second modem response windows
    - Add non-blocking heartbeat timer
    - Add bidirectional PC-to-modem UART pass-through
    - Verify successful PlatformIO build and upload to COM10
    - Preserve project research and supporting documentation
2026-09-16 Sync ESP32-S3 firmware with current development state
    Replaces the early heartbeat-only stub with the full dual-IMU
    FreeRTOS acquisition architecture, GNSS parsing over the A7670X
    modem, hardened JBD BMS BLE interface, ESP32<->Pi GPIO time-sync
    mechanism, and a new time-domain ride-characterisation task (RMS,
    std dev, peak-to-peak, crest factor, jerk, threshold crossings)
    with a self-test validated against a synthetic sine wave.
    Also corrects the board_build overrides for the physical
    ESP32-S3-WROOM-1-N16R8 module: 16MB flash size, DIO flash bus mode
    (the boot loop from an earlier qio_opi attempt is fixed), though
    PSRAM remains undetected under both dio_opi and dio_qspi memory
    types tried s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
    [main.cpp]
2026-09-16 Reorganize repo into a clear top-level structure
    No files deleted - this is a pure reorganization. Renamed unclear
    paper-subfolder names (MoPapers, "Some more", "Comm Syst n Auto
    Comm", "hpec Telemetry Unit", CameraResearch) to descriptive ones,
    consolidated loose top-level PDFs into their matching thematic
    folder under References/Papers (renaming on any filename collision
    rather than overwriting an existing copy), and grouped the
    remaining top-level files into Report/, Vehicle Documentation/,
    and Planning/. HUDTelemetryUnit/ and GA Tracking Form/ stay at the
    root since they were already self-contained.
2026-09-16 Add camera hazard-detection MVP for the Pi 4
    Pretrained COCO SSD-MobileNet-v1 (quantized TFLite, no training
    required) run on live Pi 4 camera frames, reporting road-relevant
    object classes with a rough distance estimate from a known-width
    heuristic. Deliberately scoped to what a Pi 4 with no ML
    accelerator can sustain in real time - not lane-level blind-spot
    geometry, not multi-frame tracking, not an autonomous-driving
    stack.
    Not yet run against the real camera (Pi unreachable at time of
    writing); the focal length used for distance estimation is an
    uncalibrated placeholder, documented as such in CameraDetection/README.md
    along with the calibration procedure needed before trusting a
    reporte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
2026-09-16 Add reference papers for component-selection and hazard-detection gaps
    10 papers added, split across two identified gaps in the literature
    review: component/market selection justification (IMU vibration
    performance, ESP32-class edge MCU for object detection, cellular
    vs LPWAN for developing-market IoT) and hazard/blind-spot detection
    for low-speed and three-wheeled vehicles specifically (monocular
    time-to-collision estimation on constrained hardware, near-field
    low-speed perception, an autonomous cycle-rickshaw path-planning
    system).
    Two gaps found genuinely empty rather than filled with a weak
    citation: no academic literature comparing low-cost camera sensors
    (OV5647 vs alternatives) exist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
2026-09-16 Add MQTT-over-cellular telemetry publishing
    Publishes ride-characterisation, BMS, and GNSS state as JSON over
    MQTT via the A7670X modem's native AT+CMQTT command set, running
    inside the existing modem task rather than a separate one (the
    modem UART has no locking, so a second task issuing AT commands
    concurrently would corrupt both command streams).
    Broker address/credentials are placeholders, not the existing
    Tukzie vac-work team's own broker - that team's documentation
    explicitly says its credentials must not be shared with an LLM.
    Verified on real hardware that the connect sequence fails cleanly
    against the placeholder host with no crash or hang, confirming the
    AT command sequence itself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
    [main.cpp]
2026-09-19 Add per-sensor IMU calibration, bench-test tooling, and camera mount design
    Firmware: two nominally identical MPU6050s disagreed by ~7% on resting
    gravity magnitude. Added a per-sensor magnitude calibration factor, measured
    once from a stationary baseline and persisted to NVS, applied before feature
    computation. Both sensors now agree to within noise, verified under dynamic
    motion as well as at rest. Also restored the native-USB Serial routing flags
    needed by the Makerfabs board (the bare dev board needs them off; this cost
    real debugging time, so the reason is documented in platformio.ini).
    Tooling: a live bench classifier reading the real [RIDE] feature stream, and
    a browser walkthrough c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
    [camera_mount.scad, camera_mount.stl]
2026-09-19 Add automated research pipeline with falsifiable gap ledger
    Queries OpenAlex, arXiv and Crossref on this project's scope, stores every
    record with full provenance in SQLite, deduplicates, and emits a dated
    digest plus BibTeX for the thesis. Deliberately avoids Google Scholar - no
    public API, CAPTCHA-blocked, scraping forbidden - so the pipeline does not
    fail silently later.
    Two design points that matter more than the scraping:
    Gap claims are stored as falsifiable propositions with an evidence ledger,
    and each run surfaces the items most likely to *challenge* them. A gap that
    has survived attempts to disprove it is defensible; one asserted once and
    never revisited is not. First run already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
2026-09-19 Review all flagged gap evidence; narrow claims G1 and G3
    All 11 auto-flagged items read against their claims: 3 challenge, 8 neutral,
    0 left unreviewed.
    G1 narrows. An open-architecture motorcycle telemetry unit (Electronics 2026,
    10.3390/electronics15122604) combines a fused 9-DoF IMU, RTK-GNSS, CAN-FD and
    a 4G/LTE uplink with deterministic dual-core task partitioning in a printed
    vibration-resistant enclosure. That is close enough to defeat any broad claim
    that an open IMU+GNSS+cellular telemetry unit is novel in itself. What
    survives is narrower and more honest: spatially-separated dual IMUs, a
    ride-quality rather than racing-performance framing, and the three-wheeler
    vehicle class.
    G3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
2026-09-19 Add dual-IMU and field-test-methodology searches (RQ6, RQ7)
    After G1 narrowed onto spatially-separated dual-IMU sensing, that was the
    least-searched part of the whole scope - a bad state for a load-bearing
    claim. RQ6 targets it directly; RQ7 targets field-test protocol and
    calibration practice, which the outstanding field test needs in order to
    justify its design by reference to established work.
    241 new sources, 733 total, 309 in the BibTeX export.
    The most consequential find is methodological rather than a gap challenge:
    "Online Classification of Road Roughness Conditions with Vehicle Unsprung
    Mass Acceleration by Sliding Time Window" (Shock and Vibration 2018,
    10.1155/2018/5131434) clas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
2026-09-19 Speed-normalise the ride roughness metric
    The transfer function from road profile to measured acceleration is speed
    dependent, so a raw RMS conflates how rough the road is with how fast the
    vehicle was driven - the same pothole reads larger at 30 km/h than at 10.
    Without this the headline ride metric from the field test would have been
    confounded, which is the kind of thing that surfaces in a viva rather than
    in the data.
    Adds mean-square-over-speed normalisation (the formulation used in Shock and
    Vibration 2018, 10.1155/2018/5131434, surfaced by the research pipeline) and
    records the speed each index was divided by, so the value is auditable.
    Deliberately yields NaN, printed as "norm=n/a"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
    [main.cpp]
2026-09-19 State the ML ethics position explicitly; exclude ML from version one
    The approved ethics application says machine learning is not planned for the
    first version, and that experimenting with it requires a revised application
    submitted first. The camera hazard detector is a pretrained TFLite
    convolutional network - unambiguously ML - and the Methodology chapter
    described it as a scope extension without once referencing that constraint.
    Read alongside the ethics application, that omission implied ML was simply
    part of version one.
    Audited the whole repository: exactly one ML component exists (the
    detect.tflite model and its inference script). Ride characterisation, the
    bench classifier and the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
2026-09-19 Record HUD prior-art finding as gap claim G4
    A targeted market and prior-art search found no HUD driven by on-board
    vehicle telemetry for any three-wheeled auto-rickshaw-class vehicle -
    academic, commercial or maker. Three-wheeler instrumentation in the
    Indian/Asian market is head-down cluster only (Montra Electric Super Auto,
    Infineon LEV cluster reference designs). Maker motorcycle HUDs exist but are
    phone or GPS fed rather than driven by on-board sensing.
    Claim is deliberately scoped to application and integration. HUD optics are
    long established and claiming novelty there would not survive scrutiny.
    Separately, and worth recording where the design decisions live: a
    see-through combiner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
2026-09-21 Record preliminary SW-6/SW-7 UART interface agreement
    Captures what Sharaav confirmed today: 115200 8N1 over the free GPIO43/44
    USB-C port, CSV framing, speed (km/h) and battery percent flowing SW-6 to
    SW-7, his own IMU staying on his side. This is the interface-definition
    deliverable the VIT plan's D5 joint session specifies - no record exists
    that session ever produced one, so this captures the real agreement as it
    happens rather than losing it in a WhatsApp thread the way D5's apparently
    was.
    Notable beyond the wire protocol: this is the direct data source for both
    of the HUD's persistent display values (speed, battery SoC), so SW-7 does
    not need to independently solve reliable speed/SoC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
2026-09-21 Add local telemetry logging to internal flash (LittleFS)
    The brief requires telemetry to be "logged locally and transmitted via
    cellular" - two separate obligations, and only the second existed. This is
    also the evidence base gap claim G3 rests on (store-and-forward under
    intermittent uplink), which had no actual implementation behind it either.
    The TF/microSD card slot was the obvious place to put this, but tracing the
    schematic showed its CS line reaches GPIO10 only through resistor R23,
    marked NC - not populated. Targeting a pin with no confirmed electrical
    path would repeat the original SYNC_PULSE_PIN mistake earlier in this
    project, so local logging uses the chip's own internal flash i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
    [main.cpp]
2026-09-23 Enforce ethics approval EBE/03305/2026 conditions in the hazard detector, update GA tracking form
    Restrict hazard_detector.py to the approved object-category list, add
    distance banding and class-level alert persistence, and log only the
    five fields the approval permits (class, distance_band, confidence,
    timestamp, alert_status) rather than raw frames or continuous distance.
    README updated to match.
    GA Tracking Form: rewrote all six Student Response entries in a denser,
    first-person style with explicit next-stage plans, added top-block
    identity details, and updated GA9 to reflect the ethics approval status.
2026-09-24 Correct unsupported claims: GA4 DOI count, GA8 brief claim, GA9 framing; attribute detector categories and log fields to the ethics application, not the approval; log possible change to SW-6 link
    [hazard_detector.py]
2026-09-24 GA9: name the specific research-gap claims narrowed and the camera claim that held
2026-09-24 GA8: add component selection, ordering, bench testing, camera casing, literature work; enlarge GA8 box
2026-09-25 Add dual-IMU fusion: overlap-checked mean of both sensors' ride features with a disagreement figure, single-sensor fallback, boot self-test, and fused block in the telemetry JSON
2026-09-25 Bring all project files into the repo: report source and figures, camera casing STLs, bench and vehicle photos, walkaround video, project brief, ethics application, GA forms, course and hardware refe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
    [RPi_cam_30_deg_corner_mount.stl, RPi_cam_case_bottom.stl, RPi_cam_case_top.stl]
2026-09-25 Fix boot loop on the Makerfabs board: set 16MB flash size and DIO mode to match the 16MB partition table; LittleFS now mounts and dual-IMU fusion verified live
2026-09-25 Report: document dual-IMU fusion with live results, local flash logging, and the flash-config boot-loop fix
2026-09-25 Add browser live-telemetry dashboard (Web Serial): fused and per-IMU features, acquisition health, GNSS/BMS status, rolling charts, raw log
2026-09-25 Record a 150 s bench session from power-up; add live dashboard and recorded-session figures, boot self-test excerpt, and the flash-write timing and GNSS poll findings to the report; add log replay to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
2026-09-25 Report: move four supporting figures (nameplate, board pinout, live dashboard screenshot, unprinted OpenSCAD bracket) to a Supporting Figures appendix
2026-09-28 Hazard detector: first live run fixes, live view, alert hysteresis
    First live run on the Pi 4 (about 7 fps) exposed two input faults, now
    fixed: the labelmap's leading "???" shifted every class name by one, and
    Picamera2 RGB888 buffers are B,G,R while the model expects R,G,B. Both
    checked against the model file, TF example source and the Picamera2
    manual.
    - Use ai-edge-litert (LiteRT) first; tflite-runtime has no Python 3.13 wheels
    - Optional --preview live view (MJPEG over HTTP, never saved), local by
    default, --preview-host 0.0.0.0 for devices on the same network
    - Alerts clear only after 5 missed frames, re-log when the object holds a
    nearer band for 3 frames, nearest band wins withi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
    [hazard_detector.py]
2026-09-28 Add verified camera/ML reading library: 15 papers, beginner reading guide and BibTeX
2026-09-28 Hazard detector: non-blocking live view, per-stage latency measurement, 4 inference threads
    The live view drew and JPEG-encoded every frame inside the detection loop,
    so detection waited on it. It now runs in its own thread and skips stale
    frames; the stream uses a small socket buffer so a slow link drops frames
    instead of lagging. Each frame's SensorTimestamp (Picamera2: ns since boot,
    same clock as time.monotonic_ns) gives sensor-to-result latency, printed
    every 5 s as p50/p95/max per stage, with an optional per-frame CSV
    (--timing-log). Per-frame detection lines moved behind --verbose; bilinear
    resize; --threads for inference (default 4).
    [hazard_detector.py]
2026-09-28 Hazard detector: --tuning option for a camera with no IR filter (ov5647_noir.json)
2026-09-28 Add camera integration prompt: colour check, detection coverage, latency target, calibration, service, dashboard
2026-09-28 Front camera page for the dashboard, and a systemd service for the detector
    DashboardIntegration/: FrontCameraPage (QtNetwork MJPEG reader showing only
    the newest frame, /alerts polling, dashboard status colours, reconnect,
    alerts_changed signal) with wiring notes for the dashboard team; tested
    offscreen with PySide6 6.11.2 inside a copy of the dashboard app package.
    CameraDetection/deploy/: hazard-detector.service and install notes.
2026-09-28 Camera README: document /alerts, timing output, tuning option and the boot service
2026-09-28 ESP32 firmware v0.5.0: MQTT result codes and reconnect, serial commands
    - MQTT: AT+CMQTTSTART, CONNECT and PUB now wait for their result line
    (+CMQTTxxx: ...,<err>) instead of treating the first OK as success; the
    A76XX manual v1.09 section 18.2 returns OK for both success and failure.
    - Reconnect with backoff (30 s doubling to 5 min) after a failed connect,
    3 failed publishes in a row, or the +CMQTTCONNLOST / +CMQTTNONET URC,
    with DISC, REL, STOP teardown first as the manual requires.
    - Local commands on the USB console (lines starting with '!'; everything
    else still passes through to the modem): !status, !log off, !log on,
    !mqtt, !recal (erase stored IMU calibration and restart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
    [main.cpp]
2026-09-28 Add PROJECT_LOG.md; correct fusion and calibration figures from the bench log
    PROJECT_LOG.md: status board, 32 decisions, timeline from 3 Aug, per-
    subsystem technical breakdown, findings, report sync table and tooling,
    built from the repo, report, GA form and session transcript.
    Corrections checked against BenchTest/logs/2026-09-25_bench_fusion_shake.log:
    - 149 fused windows, not 222 (each result is printed by both sensor tasks)
    - still-period max fused std 0.067 over the first 70 s (0.058 was the
    first 48 s only); largest peak-to-peak 77.6
    - resting magnitudes 9.93 and 10.10 m/s2 with the target board's stored
    factors 1.0390 and 1.0245, replacing 10.07/9.97 from a capture not in
    the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
2026-09-28 Add SW-7 bench console: ESP32 telemetry, camera live view and alerts, firmware commands, ToF and SEN55 panels in one page
    One local page (Edge or Chrome) instead of separate pages: Web Serial for
    the ESP32 (cards for ride vibration, IMU acquisition, BMS, GNSS, MQTT,
    logging and system), the Pi's MJPEG live view and /alerts, buttons for the
    v0.5.0 serial commands with an in-page confirm for !recal, a filtered log,
    a timestamped session-log download, and replay of recorded logs. ToF and
    SEN55 panels parse proposed [TOF] and [ENV] line formats, ready for when
    those sensors are wired. Checked by replaying the 25 Sept bench log.
2026-09-28 Record vehicle state and test dates: trike on the ground (raised on request), mounting Wed 30 Sept, road test requested Fri 2 Oct
2026-09-28 Report: capture the camera, console and firmware v0.5.0 work, each marked tested or untested
    Per the student, all work goes into the report now and length is cut
    later. Methodology adds alert hysteresis (tested offline), the live view
    and per-frame latency measurement from SensorTimestamp (tested offline),
    the alerts feed, dashboard camera page and start-up service (page tested
    offscreen, service not installed), the colour-cast investigation (tests
    not yet run), the combined bench console, and firmware v0.5.0 MQTT
    result-code checking, reconnection and serial test commands (compiles,
    not flashed). 49 content pages, 19,370 prose words.
2026-09-29 Firmware v0.5.0 on the board: bench test passes, flash-write stall confirmed
    Scripted bench session (BenchTest/v050_bench_test.py, log in
    BenchTest/logs/2026-09-29_v050_bench_test.log), board still:
    - logging on: 33 to 40 ms gaps on both IMUs every 10 s (12 events in
    2 min); logging off (!log off): worst gap 5.9 ms, none over 10 ms;
    200 Hz and no dropped samples throughout; MQTT kept publishing, so
    the stalls come from the flash writes
    - commands work; MQTT connected first time, 47 publishes, 0 failed;
    !mqtt teardown and reconnect in 0.4 s
    - GNSS polls no longer time out (indoors, no fix), so the log step now
    runs every 10 s instead of 12 s
    Report, evidence appendix, log and change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
2026-09-29 Report clean-up pass: drafting notes, cross-references, calibration figures, GA appendix
    - Drafting notes and out-of-register phrases removed; repository path
    moved to the evidence appendix; "dissertation" -> "project".
    - Wrong cross-references fixed; chapter labels added and every
    hard-coded "Chapter~N" now a \ref.
    - Calibration figures corrected from the 18 Sept session record: bare
    board raw 10.35-10.39 / 9.55-9.56 m/s2, stored factors 0.9773 / 0.9901
    implying 10.03 / 9.90 at calibration; target board first boot 9.44 /
    9.57 giving 1.0390 / 1.0245. Orientation dependence named as the
    likely cause (not confirmed); recalibrate in the mounted position.
    "5 to 8%" -> about 8% in t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
2026-09-29 GNSS confirmed outdoors, three firmware faults fixed, signal-loss recovery tested
    Rooftop tests, 29 to 30 Sept 2026 (logs in BenchTest/logs):
    - GNSS layout confirmed with a real fix: 17 fields (18 while settling),
    decimal degrees. Parser rewritten (v0.5.1 to v0.5.3) to read fields
    relative to the hemisphere letter, with shape and 100 m/s jump checks;
    !gnssraw prints raw replies. 104 fixes: median 2.7 m from the phone's
    position, 95% within 11.0 m. Speed units still to confirm on the road.
    - v0.5.2: power key pulsed at boot only if the modem does not answer AT;
    the unconditional pulse switched a running modem off after a reflash.
    - v0.5.3: accept the 18-field reply; reconnect MQTT a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
    [analyse_log.py, gnss_capture.py, main.cpp, signal_loss_test.py, test_alert_logic.py, test_alerts_endpoint.py]
2026-09-30 Pi sync-edge logger and I2C line voltage check recorded
2026-09-30 C6 wire check passed on the Pi
2026-09-30 C6 sync logger run on the Pi: one noisy run, one clean run
    [2026-09-30_sync_edges_run1_noisy.csv, 2026-09-30_sync_edges_run2.csv]
2026-09-30 Placement and enclosure plan for mounting on the TUKZIE
2026-09-30 Camera latency measured on the Pi, ToF probe, optocoupler identified
    [run1_4t.csv, run2_4t_preview.csv, run3_1t.csv]
2026-09-30 ToF stand-in identified as VL53L0X from the micromouse schematic; three-sensor reader
2026-10-01 Firmware v0.5.4 BMS checksum fix and v0.6.0 buffered log, signal quality, Hall counter; bench-tested; report updated
    [bms_probe.py, main.cpp, v060_bench_test.py]
2026-10-01 Firmware v0.6.3: log read-back and clear, JSON NaN fix; stored log recovered, BMS fix confirmed from it
    [log_dump.py, main.cpp]
2026-10-01 tof_reader: sensor ground on Pi pin 6, pin 9 is the ESP32 sync ground
2026-10-01 Stand-in ToF: three VL53L0X read on the Pi; results recorded
    [2026-10-01_tof_three_sensors.csv]
2026-10-01 Stand-in ToF: cover test confirms left, centre and right labels
    [2026-10-01_tof_cover_test.csv, 2026-10-01_tof_hand_test.csv]
2026-10-01 Dashboard camera page tested against the live detector
2026-10-01 Camera colour fixed with the NoIR tuning plus saturation 1.8; colour check recorded
    [hazard_detector.py]
2026-10-01 Colour check: all four cards in one frame
2026-10-02 Run 1 pothole model (mAP50 59.7% at 640, 55.0% at 320) recorded; notebook names runs per dataset
    [model.ncnn.param, results.csv]
2026-10-02 Firmware v0.7.0: 1 Hz DASH serial line for the dashboard; telemetry link contract
2026-10-02 T11: firmware v0.7.0 DASH line verified on the bench (40/40 lines, IMUs 200 Hz, no drops)
2026-10-03 Telemetry link contract: wired link, beacon, endpoint resolver, pre-test check
2026-10-03 Pi 4 bridge beacon, pre-test check, deploy command, wired-link setup, detector service fixed; start script live-only with no fixed address
    [sw7_check.py, telemetry_bridge.py, test_telemetry_bridge.py]
2026-10-03 Dashboard live-only mode (no simulated values, '--' when data is missing) and automatic Pi 4 finding (localhost, override, wired, beacon, mDNS, last good)
2026-10-03 Pre-test check finds Pirate5 by itself (last address, Raspberry Pi scan, hostname over ssh); probe timeouts 3 s for phone hotspots
2026-10-03 Uniform repo: README with architecture and folder map, TelemetryUnit rename, HUD wording updated, loose folders tidied; resolver back-off, controller off, dashboard auto-start files
    [main.cpp]
2026-10-03 Firmware v0.7.1: GNSS course and altitude in the DASH line; labelled GPS replay track along UCT roads (OSRM/OSM) and replay flag in the bridge
2026-10-04 Camera and ToF sensor fusion on the Pi 4: /detections with bearings, association by bearing and time, ToF-only obstacles, fused hazards in /telemetry and /hazards; test procedure C9 and report script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
    [timing.csv]
2026-10-05 Dashboard: route planning works without a BMS reading (labelled full-battery assumption); deploy switches the labwc autostart to our build and stops the team's for the session
2026-10-06 Dashboard settings: finger-drag scrolling, plain wording, technical options behind Show advanced settings
2026-10-06 Dashboard: skip the PIN page on the bench (TUKZIE_SKIP_LOGIN=1 in the start script)
2026-10-06 Changelog: PIN page skipped on the bench
2026-10-06 Dashboard: Sensors page and hazard banner (tested off-screen with live Pi 4 data, not deployed)
2026-10-06 Dashboard: no press delay on finger-scroll pages (QScroller MousePressEventDelay 0)
2026-10-06 Changelog: run 2 cells, tile prefetch, sensors page deployed
2026-10-06 C9: first live fused camera+ToF hazard observed (before calibration)
2026-10-06 Telemetry unit housing: parametric concept (placeholder sizes, measurement list, placement advice)
    [base_concept.stl, lid_concept.stl, telemetry_housing.scad]
2026-10-06 Camera: dark pixels neutralised in the live view (black no longer purple); Pi 4 throttling recorded
    [hazard_detector.py, test_alerts_endpoint.py, test_dark_neutral.py]
2026-10-06 ToF: one sensor not answering no longer disables all three; bridge re-probes a missing sensor every 60 s
    [telemetry_bridge.py, tof_reader.py]
2026-10-06 Run 2 pothole model (South African band tiles): results, models and caveats; notebook scores the held-out test split
    [model.ncnn.param, results.csv]
2026-10-07 Report: under-voltage traced to the ESP32 modem powered from the Pi 4 USB; Pi 4 soft temperature limit
2026-10-07 Report presentation fixes from the review: broken I2C/degree commands, template reference removed, WHO cited, short camera header, evidence table ragged-right with 5 to 6 Oct rows; Pi 4 power-watch l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
2026-10-07 Dashboard redesign stages 1-2: Night/Day themes, flat surfaces, Atkinson Hyperlegible, large speed/battery/range driving panel
2026-10-07 Dashboard: redesigned look switched off (student preferred the previous one); code kept behind TUKZIE_SW7_THEME
2026-10-07 Sensor pod concept: camera, ToF board, Pi 4 and ESP32 in one housing (sight-line windows; board sizes still to measure)
    [base_CONCEPT.stl, lid_CONCEPT.stl, sw7_sensor_pod.scad]
2026-10-07 MQTT: broker details from a git-ignored local secrets file; broker check script
    [main.cpp, mqtt_broker_check.py, mqtt_secrets.example.h]
2026-10-10 ToF: 0.5 s I/O timeout so a stuck sensor is skipped and logged instead of freezing the reader (deployed to the Pi 4)
    [tof_reader.py]
2026-10-10 Report: wiring appendix (Pi 4 header, sensor board, SEN5x pinout figures; connection tables for ToF, ESP32-Pi link, IMUs, antennas, SEN55 planned, camera and power); brief for the wiring and review f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
2026-10-10 Review fixes (Maisha): overstated claims corrected, feature/calibration/index/fusion equations, clipping and aliasing limits stated, SEN55 indices and start-up times, references cut to the 47 cited a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
    [main.cpp]
2026-10-10 Firmware v0.7.2 flashed from the laptop (COM10): boots, IMUs 200 Hz, 0 drops, CSQ 30; report updated
2026-10-10 Phone-style positioning: firmware v0.7.3 loads assisted GNSS (AT+CAGPS) and reports the mobile-network position (AT+CLBS, about 550 m) while there is no fix; the map draws it as an approximate circle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
2026-10-10 Navigation: Route Guidance panel hidden (the turn banner replaces it; TUKZIE_ROUTE_GUIDANCE=1 restores it) and the map uses the full width; simulated drive now shows its speed on the Driving page and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
2026-10-11 Simulated drive in step on every page: one simulated state (speed, battery drain by energy, power, range, temperatures, trip, gear) through the team's dispatcher; SIMULATED DRIVE strip in the layout 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
2026-10-11 Simulated drive smooth again: the map ignores its own simulated position echoed back by the dashboard (each echo counted as a fix and halved the glide time at the bridge's 2 Hz polling); a real GPS f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
2026-10-11 Spoken turn-by-turn directions from the map's turn banner through the team's voice system: route start, 200 m prompt, the turn (chained with a close next turn), arrival warning and arrival, once each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
2026-10-11 Finger-drag scrolling on every scroll area that lacked it (Diagnostics, Charging, destination suggestions), taps still immediate; test that a drag scrolls Diagnostics
2026-10-11 Two-finger swipe between dashboard pages with a short slide (three fingers on the map, where two zoom); the map ignores three-finger touches; one-finger gestures unchanged; tests; brief
2026-10-11 Page swipe rebuilt as a carousel: the page follows the fingers and changes only on release past a third of the width or on a flick, otherwise springs back; holding, resting, pinching or vertical move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
2026-10-11 Presentation updated with 7 to 11 Oct results (deck, poster, talking points, Q&A; talk about 9.2 min); bench observations of 10 to 11 Oct recorded as evidence (ToF hand test, Pi 4 temperatures and re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
2026-10-11 Uber-style destination search: Photon type-ahead biased to the current position, instant offline matches through a prefix index, two-line rows with distances, recents, From header (GPS, network, last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
2026-10-11 Report cut and restructured per the MSc review: body 32,241 to 11,118 words, 72 to 34 pages; requirements R1 to R13, architecture comparison, start-up table, Appendix E (configuration table, fault ta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
2026-10-11 Tracker: report cut and destination search done
2026-10-11 Store-and-forward and central database: firmware v0.7.4 (persistent seq and boot id, ack ledger, backlog replay marked replay, lost records counted, !sync, IMU filter 94 Hz; compiled, not flashed); S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
2026-10-11 Pothole path in the camera detector (run-2 model, road-band tiles, 2-of-3 debounce, experimental, new road_hazards keys only); off by default: on the Pi 4 it slows people/vehicle detection beyond 10 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
2026-10-11 Obstacle warning tucked into the right of the status bar as a compact red pill (tap opens Sensors, Hide snoozes); it no longer covers the status bar and the top of every page
2026-10-11 Critical review of the report (Stage A diagnosis): ranked weaknesses, questions for the student, revision plan
2026-10-11 Report audit after the cut: restored vital design reasons, test conditions, caveats and verification numbers (body 12,101 words, 35 pages); bench tools section (GA5); diagnosis records in Appendix E;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
2026-10-11 Report: ToF and Pi 4 investigations completed from the 10 Oct session (0x29 device with shutdown lines low, wiring re-seated, loose wire inferred not seen; ESP32 moved to the laptop; Pi 5 supply cond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
2026-10-12 IMU pod in SolidWorks 2025: base (board pocket, pilot holes, cable exit, strap slots for cable ties or hose clamp) and lid (clearance holes, forward +X arrow), driven by global variables; API build s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
2026-10-12 Dashboard display back shell and clip-on bracket (SolidWorks, scripted); reference photos with readings
2026-10-12 Dashboard shell: cable exit on the short side, split into four Prusa Mini quarters with rail and joiner plates; reference dimensions
2026-10-12 Dashboard shell: cable exit and vents moved to the left short side (connector side, from the desk photo)
2026-10-12 Dashboard shell: measured display 272 x 187, cable exit 58 mm for the 43-45 mm connector span
2026-10-12 Dashboard: Raspberry Pi 5 cradle on the back (left side), shell bolt holes for it
2026-10-12 Dashboard mount: handlebar clamp (bracket + cap), low rail so the screen stands above the bar, Pi 5 cradle moved clear of the bar, cross joiner, full assembly with reference parts and previews
2026-10-12 Dashboard shell: regenerate the Left_Top quarter with the current layout
2026-10-12 Remove stray CAD screenshots; ignore SolidWorks .bmp captures
2026-10-12 Layout pass for Driving and Analytics (agent B, LAYOUT_DRIVE_PATCHES)
    Driving: 64 px advice strip across the page, whole-number speed at 140 px in a larger dial, range and
    battery at 36 px with 18 px labels, short pedal bars. Analytics: 96 px values with 32 px units, context
    lines and sparklines, 480 px centre card, 64 px buttons, charts scaled to their data with 12 px axis
    text, headings in the text colour. All behind TUKZIE_SW7_LAYOUT (=0 is pixel-identical to before).
    Test: tests/test_layout_drive.py with before/after screenshots in tests/layout/drive.
2026-10-12 Dashboard layout pass A: status bar 48 px, nav labels and 64 px targets, arrows off the content, Settings two columns, Charging SOC rounding
    sw7_layout_frame.py (COPIES) wraps the team's status bar, nav bar, Settings and Charging classes; LAYOUT_FRAME_PATCHES adds three patch entries. TUKZIE_SW7_LAYOUT=0 installs nothing. tests/test_layout_frame.py checks sizes, the switch (widget tree identical to a build without the group) and saves before/after shots in tests/layout/frame.
2026-10-12 Dashboard layout pass (agent C): Diagnostics in four cards with the advice folded away, Front camera 64 px alert rows and status chip, Sensors tuk-tuk outline with 40 px ToF distances; TUKZIE_SW7_LAY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
    LAYOUT_PAGES_PATCHES and sw7_layout_pages.py for Diagnostics; tests/test_layout_pages.py checks sizes, the switch (pixel-identical with =0) and saves before/after screenshots in tests/layout/pages. test_sim_sync opens the folded details before the drag-scroll check; test_live_data_provider accepts the plain-word source.
2026-10-12 Layout merge fixes: obstacle pill 40 px in the 48 px bar with the clock-only width and 12 px Hide (off switch unchanged), scratch-folder guard in the tests, frame test compares with other layout grou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
2026-10-12 Layout pass: tests restore the real status bar height and follow the layout switch for the pill; screenshots from the combined build
2026-10-12 IMU pod: pocket set to the measured 20 x 17 mm GY-521
2026-10-12 Paper and depth style, core: sw7_style (palette, Ink night variant, type scale, cached shadows, back plane, signal audit, THEME in paper) and the restyled frame, sw7_weather (Open-Meteo chip and char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
2026-10-12 Brief: front sensor pod (camera above the sensor board, Pi 4, Makerfabs ESP32-S3) from the student's measurements
2026-10-12 Sensor pod layout research: Makerfabs board outline from its Eagle file, sensor board orientation, camera FOV, head plus box layout and parameter table
2026-10-12 Sensor pod CAD: shared parameters and SolidWorks helper layer (work in progress)
2026-10-12 Paper style, page agent P2 (work in progress): Surroundings merges Front camera and Sensors (7 nav items, page id sensors with camera and surroundings aliases, one hazards list), Diagnostics and Char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
2026-10-12 Paper and depth style, Drive and Analytics (P1): Drive as the glance page (speed disc at 162 to 168 px as the middle plane; Next turn, Around and Range tiles overlapping its edge with a signal chevro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
2026-10-12 Paper style P2: details card filled, raw rows on the scale, test_style_core samples the nav pill between labels (7 items), core screenshots with the 7-page nav
2026-10-12 Sensor pod CAD: head upper shell, camera retainer and sensor tray scripts and parts
2026-10-12 Sensor pod CAD (checkpoint): electronics box base and lid, USB hatch cover, sunshade; parameter updates
2026-10-12 Sensor pod: rail plate (dashboard clamp reused), reference parts and view cones, assembly with interference check, README
2026-10-12 Sensor pod: engineering review (interference proven by probe, 30 fastener joints checked), assembly order fixed for the flange bolts under the Pi
2026-10-12 Sensor pod review: support, connection, manufacture and assembly for every component
2026-10-12 Engineering reviews of the dashboard mount and IMU pod, with SolidWorks audit scripts (interference with probe, fastener coaxiality, bodies, walls, overhangs, sketch status)
2026-10-12 CAD revision 2: engineering review fixes applied and re-audited (dashboard clamp cap, insert walls, mirrored holes, rail plate overlap, lock detent, squeeze gap, parallel dovetail, fixed components; 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
2026-10-12 Print: slicing script, print list and bed layouts for the 13 Oct PLA prints (PrusaSlicer 2.9.4, Prusa MINI)
2026-10-12 Brief: UI theme refinement (Plex type, unboxed weather, restrained surfaces, battery animation kept)
2026-10-12 Report: Appendix F, enclosure and mount design (measurements, design choices, renders, parts, geometry verification, print plan, outstanding), linked from the Methodology
2026-10-12 UI theme refinement, part 1: IBM Plex Sans and Mono (OFL) bundled and registered, restrained tokens (small radii, light shadows, hairlines, no back-plane words), flat nav bar, unboxed weather item, C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
2026-10-12 UI theme refinement, part 2: Analytics (hairline cards, ink chart lines, Plex Mono axes), Surroundings and Charging surfaces (8 px radii, light shadows), Diagnostics values in Plex Mono with unavaila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
2026-10-12 UI theme refinement, part 4: tests updated where a visual assertion changed (flat nav bar, Plex font, flat map edge, shadow size, restored animation, unknown charging state), keyboard keys, night cha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
2026-10-12 Brief: three planes with hero type, TUKZIE renders as subjects, team-style charging graphic
2026-10-12 Three planes, part 1: hero word face (Anton, OFL) and cut-out TUKZIE renders in COPIES, back plane with word and subject (cached), Drive (three-quarter render, advice strip clears it, gear row on a c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
2026-10-12 Three planes, AURA pass: Drive. Archivo Black (wide, heavy) replaces Anton; the word at ink 14 % by day and a lifted charcoal at night; tiles and dial sit low so DRIVE fills the open upper area; the 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
2026-10-12 Three planes, AURA pass: Charging. No disc and no cards in the column (groups under hairlines), the column compacted, CHARGE across the band above the nav bar read through the ring, the front render 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
2026-10-12 Renders: the floor under the body (pale and grey patches) becomes the soft contact shadow, per-view floor lines, softer shadow; regenerated all three cut-outs
2026-10-12 Polish: Drive reads the whole DRIVE (gear and lamps move to the advice row, the vehicle cuts only into the end of the E), Settings word fainter (strength 0.45), Charging 'No charging data' without th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
2026-10-13 IMU pod rev 3: screwless, 1.6 mm walls, push-fit half-lap lid like the camera case, board on ledges with pegs and clamped by lid tubes, 0.4 mm clearance, bay for the right-angle header and Dupont hou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
2026-10-14 Report: power budget against the 72 V pack (GA 5), Pi 5 measured, the rest estimated and marked; Pi 4 under-voltage since boot noted
2026-10-14 Print: sensor head upper printed roof down (85 g, 8 h 25 min, was 114 g, 10 h 18 min on its back)
2026-10-15 Pi 5 front ToF board wiring diagram (same pins as the Pi 4)
2026-10-15 Pi 5 front camera: detector service on the Pi 5, dashboard camera page uses it when it answers (Pi 4 camera otherwise)
2026-10-15 Approaching-object warnings: per-track time to contact (camera) and ToF closing rate
    - hazard_detector.py: IoU tracker (track_id, tolerates 2 missed frames),
    TTC from box growth (Lee's tau, Theil-Sen fit of 1/width over 0.6 s of
    sensor timestamps, consistency, growth, edge-clipping and height checks),
    closing_mps from the distance estimate (uncalibrated), approaching alert
    under 4 s (warning) and 2 s (immediate) with onset, hysteresis and clear;
    --side front|rear; /alerts and /detections entries gain side, track_id,
    approaching, ttc_s, closing_mps; approaching alerts logged with
    track_id, ttc_s and side.
    - sensor_fusion.py / telemetry_bridge.py: ToF closing rate and TTC per
    s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
2026-10-15 Dual camera on Surroundings: Front (Pi 5) | Rear (Pi 4) toggle, each side's stream, alerts, ToF and fusion; banner from both sides with approaching objects; Rear in gear R; TUKZIE_SW7_DUAL_CAM=0 keep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
2026-10-15 Dual camera: the Pi 4 bridge's straight-on ToF is the rear obstacle; the front obstacle comes from the Pi 5's own ToF
2026-10-15 Fusion: as-built config with the side ToF bearings at -90/+90 (deployed on both Pis as fusion_config.json); repo default unchanged for the tests
2026-10-15 Front sensor pod (Pi 5 + AI HAT+): build scripts, parts, assembly and renders (checkpoint before audits); note on the original head's rear drip lip
2026-10-15 Front pod: audit 4 fixes (Pi standoffs 10 mm with counterbore bases, rail bosses back to 6 mm, rear port bosses clear of the facet, tie blocks clipped, 1.5 mm drip tips), box top Z 28, assembly rebui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
2026-10-15 Front pod (work in progress): boss gussets so the base prints without supports, side bosses at Y -50 (audit 5: 0.28 mm to the USB-A plug), audit fixes, slicing script with orientation search, review 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
2026-10-17 Report: two-sided layout and time-to-contact design (Methodology), first sustained BMS reading and pack identification, Pi 4 brown-out in the housing, serial-line rise, IMU pod rev 3, front pod for t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
2026-10-17 Report cohesion: time to contact grounded in the literature (Lee 1976, Dagan et al. 2004, Sen 1968) and cited in the method; Discussion on time to contact, the two-sided layout, enclosure heat and po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
2026-10-19 focal_cal.py: camera focal-length calibration helper (test C5)
2026-10-19 focal_cal: save a camera frame and the detections per run as proof; first frame: trike at about 10 ft
2026-10-19 Lab notebook started (19 Oct): status, front ToF fixed, Pi 4 and Pi 5 restart diagnosis, focal calibration with proof frames, student's tray and holding part
2026-10-19 Lab notebook: first check with everything mounted on the TUKZIE
2026-10-19 Lab notebook: Pi 5 restarts are abrupt power losses (power log), not brown-outs or heat
2026-10-19 Road-test recorder as a service on the Pi 5 (front local, rear over the cable); lab notebook
2026-10-19 Lab notebook: cable re-connected, recorder getting all four sources
2026-10-19 Report: recorder on the vehicle and vehicle-state labelling (Methodology, vehicle tests), Pi 5 abrupt power losses (power log), BMS sustained on the vehicle, mounted-system check (Results)
2026-10-19 Lab notebook: Pi 5 camera case sliced
2026-10-20 Report: first road session (19 Oct) results: R1 and R5 on the vehicle, vibration states, camera alerts on the road, no GNSS fix, recorder coverage; Discussion and summary table updated
2026-10-20 Deck: results since 11 Oct (two-sided layout, Pi 5 detector, approaching-object warning, enclosures and power, first road session); 14 slides, 1,275 words
2026-10-20 Presentation prep: speaker script re-timed (14 slides, 9:08 spoken), Q&A and examiner prep for the work since 11 Oct, Open Day demo for two cameras
2026-10-20 Report: RQ1 conclusion reflects the first road session; dashboard gear wording (no vehicle gear signal)
2026-10-21 Lab notebook: vac-work CAN status for speed and motor data; Melo's broker with TLS
2026-10-21 Lab notebook: ESP32 on its own battery; Pi 4 starts clean
2026-10-21 Telemetry unit v0.7.4.1: DASH lines and ! commands over a UART link to the Pi 4 (IO41 TX, IO42 RX, 460800)
2026-10-21 Lab notebook: ESP32 to Pi 4 UART link
2026-10-21 Telemetry bridge service: read the ESP32 over the Pi 4 UART at 460800
2026-10-21 Report and notebook: ESP32 on its own battery, wired UART link to the Pi 4
2026-10-21 Report: no GNSS antenna was fitted on the 19 Oct road test
2026-10-21 Lab notebook: ESP32 restarts and Pi 5 offline, 21 Oct morning
2026-10-21 Report: final camera layout throughout (Pi 5 front, Pi 4 rear); system figure redrawn with Ethernet and the wired UART
2026-10-21 Report: Appendix I photographs of the first road session (faces and plate blurred); guidance compliance record and photo appendix prompt
2026-10-22 Appendix I: front sensor board fitted on the vehicle (video still and crop)
2026-10-22 Deploy: chrony over the wired link (Pi 5 serves, Pi 4 follows), for the run-2 common time base
2026-10-22 Telemetry unit v0.7.5: raw 200 Hz IMU stream on the Pi link (CRC-checked lines, non-blocking, drops counted), read-failure and stuck counters, front-node build, position removed from the public-broke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
2026-10-22 Road characterisation analysis package (BenchTest/analysis, 42 tests): Wk/a_w/VDV, repeatability CV and ICC, front-rear delay and speed, powertrain spectra, pothole detector with ROC; driving p95 cor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
2026-10-22 front_node: confirmed board (bare ESP32-S3, CH343 on UART0, COM11); Serial on UART0
2026-10-22 Front node at 921600 baud (raw stream had filled 85 % of a 115200 line); IMU found, 200 Hz, 0 missing
2026-10-22 Lab notebook: front node on the Pi 5, capture service running, sync wire not yet seen
2026-10-22 Telemetry unit v0.7.6: IMU consumers moved off the IMU core (fix for the rising-drop fault), bounded catch-up, consumer-health fields in DASH, !modem off/on
2026-10-22 Calibration record; front IMU recalibrated (scale 1.0035, repeats first boot); system check 12:58
2026-10-22 Rear flash log read out (2,000 of 2,022 records; boot 109 holds the 19 Oct drive, min current -48.03 A); front node sync on GPIO5
2026-10-22 Lab notebook: front sync on GPIO5, rear flash log, rear v0.7.6, IMU2 not detected, CSQ 99
2026-10-22 Lab notebook: IMU2 moved to the front node (not missing); rear raw capture live
2026-10-22 Lab notebook: v0.7.6 survived a real IMU bus failure; sensor needs re-init after power loss; second soak started
2026-10-22 Telemetry unit v0.7.7: automatic IMU re-initialisation after 1 s of failed or stuck reads (with back-off and bus restart), rear IMU2 off by default; sw7_check accepts a one-IMU rear unit
2026-10-22 60-minute soak of v0.7.6: 0 drops, 0 restarts, no stall; stuck counts traced to the flash-flush catch-up
2026-10-22 v0.7.8 on both nodes; IMU auto-recovery confirmed on the bench (4 pulls, drops 0, no reset)
2026-10-22 Report archive: full version before the length cut (149 pages, body 69)
2026-10-22 Report length cut: body 64 to 46 pages, detail moved to new Appendices J (implementation) and K (supplementary results); comparison shows no number, label, citation or figure lost
2026-10-23 Appendix: Raspberry Pi 5 40-pin header figure with the front-unit connections
2026-10-23 Report: IMU pod figure F.6 shows revision 3 (as printed); rev 2 kept as history; print table and total updated
2026-10-23 New title agreed 23 Oct: Embedded Telemetry, Road-Surface Characterisation and Camera-Based Hazard Detection for the TUKZIE Electric Tricycle (report, docs, deck, poster; word count 14,015)
2026-10-23 Calibration in the mounted orientation: rear and front IMU; Pi 4 reboot after the rear restart noted
2026-10-23 Report: lab part of run 2 (23 Oct): mounted calibration (R2 met), stand runs, phone GNSS speed reference, Pi 4 restarts; road part moved to 26 Oct; word count 14,596; Monday plan
2026-10-23 Stand-run spectra (23 Oct): rear 5 to 7 times rest at 40 to 70 Hz, same lines at the front; run-2 timing corrected; figure and script; word count 14,610
2026-10-24 Report: second-examiner fixes, batch 1: requirement statuses match the evidence, contradicting numbers aligned (38 %, 72.8 V, backlog 37.9 s, flash-log interval), Figure 4.1 redrawn for 23 Oct, run-1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
2026-10-24 Report: strict-examiner fixes, batch 2: abstract rewritten (accurate, with contribution), conclusions claim only what was shown, statuses matched to each criterion (R1 vehicle not met, R2, R4, R6, R7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
2026-10-24 Analysis for run 2: RQ4 band 0.5 to 80 Hz with order tracking and coast-versus-powered, ICC over 5 m bins per section and speed (refused when n is too small), pothole results as counts and a descript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
2026-10-24 Report: analysis text matches the corrected pipeline (powertrain band 0.5 to 80 Hz, ICC over 5 m bins, pothole counts), Wk verified against Rimell and Mansfield 2007 and Virtins 2024 (cited), no more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
2026-10-24 Report 3.7: the driver is the laboratory owner, authorised to drive the vehicle; he conducts no research and is not measured
2026-10-24 Report: broken cross-reference (control character) repaired, stray comma, GA4 text no longer claims the camera offset is bounded
2026-10-24 RQ2 legibility measured without a participant: deployed dashboard at 1280x800, capital heights from font metrics and the Pi 5 screenshot; speed 84 arc minutes, alert banner 9, labels median 9 (ISO 15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
2026-10-24 Sunday bench validations planned (focal length, ToF tape, fusion with a chair, TTC, alert to screen, LED camera-to-IMU alignment, BMS meter, eye distance); led_offset.py for R6
2026-10-24 Literature review expanded (calibration, clock sync, GNSS, MQTT/DTN, TTC validation, fusion; 17 verified sources filed and logged) and Design chapter given quantitative theory (aliasing at 200 Hz, bu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
2026-10-24 Report back within limits after the literature and theory expansion: Recommendations tightened (-229 words, stale items updated), Method run-2 text condensed, Introduction and Discussion trimmed, pla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
2026-10-24 Report: third strict re-mark fixes: Yiliguoqi accuracy stated as 70 to 80 % across vehicles (checked against the paper's Table 13), programme cited to the brief, 1.61 per second, wheelbase range 4.1 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
2026-10-24 Presentation: deck and poster updated with the 23 Oct stand runs, mounted calibration, phone GNSS, legibility measurement and the Monday road plan
2026-10-24 Dashboard: hazard banner text 35 px (24.4 px capitals, ISO 15008 recommended at 0.70 m), obstacle distances 28 px (acceptable level), phone speed and position kept when the Pi 4 is stale or offline w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
2026-10-24 Analysis: within-run repeatability of the 23 Oct stand runs (10 s windows; rest CV 4.2 and 1.7 %, runs 17 to 29 % with the current ramping; vibration tracks current r 0.80)
2026-10-25 Run 2 plan: changes of 25 Oct (GPS with publishing off, video as speed truth, held stand settings, forward video, BMS meter, dash speed, supplies)
2026-10-25 Voice commands for the dashboard (off by default, not deployed): pages, rear camera with auto-return, destination by voice; offline Vosk; tests pass; synthetic-voice recognition check 17/18 clean; Ap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
2026-10-25 Voice: every page by name, greeting and destination conversation, weather, alerts and battery read-out, UCT buildings, command-only recogniser (18/18 clean, 17/18 at 10 dB); report cites tukzie.com i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
2026-10-25 Report: motor plates conflict stated plainly; ISO 15008:2003 contrast minimums cited from the publisher's preview (copy kept local, source check recorded); references renumbered; 14,987 words, body 4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
2026-10-25 Planning: deeper research-gap pass (e-tricycle IoT, e-scooter camera and IMU, motorcycle DAQ); Table 2.1 checks listed
2026-10-25 Appendix F: IMU pod positions by date (both at the rear on 19 Oct, one at the front from 22 Oct)
2026-10-26 Report: implement Simon's chapter feedback (1.2, 1.4, 1.5, 2.1, 3.4-3.8, Ch4 openings), measurement-chain figure, float settings, body 47 pages
2026-10-26 Lab notebook: rear UART working, rear IMU wiring test
2026-10-26 Lab notebook: new Pi 4, UART ground fault, first distance checks; focal_cal --no-proof for person targets
2026-10-26 Calibration proof frame: student at 2.2 m on the front camera axis (face out of frame, student's consent)
2026-10-26 Camera range check at 2.2 and 3.2 m: distance x box width constant (486 px m), scale 0.62 with the default person width
2026-10-26 Detector: person width 0.80 m, fitted on the front camera (standing person at 2.2 and 3.2 m, four readings within 3 %); deployed to both Pis
2026-10-26 Dashboard: voice player follows the current default output before every phrase (a reconnected Bluetooth speaker went silent until restart); tested on the Pi 5, deployed with screenshots
2026-10-26 Rear IMU node: front-node build named rear (NODE_ID_STR) on a bare ESP32-S3 (COM15); 200 Hz, 0 drops; Makerfabs IMU not answering
2026-10-26 Road recorder: rear_node source (rear IMU board on the Pi 4, :8083); deployed, 6 of 6 sources answering
2026-10-26 sw7_check: rear IMU rate from the rear IMU node on :8083; READY at 20:35; lab notebook
2026-10-26 Photos: rear IMU node board wired to its pod, and the rear unit as installed (26 Oct 2026)
2026-10-26 Report: Maisha's review, claims corrected (acquisition loss wording, RQ1 partly answered, outages, timing budget, battery chemistry, NHTSA criteria, W_k check scope, undelivered air-quality payload);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
2026-10-26 Title: Embedded Telemetry with Road-Surface Characterisation and Camera-Based Hazard Detection for the TUKZIE Electric Trike (Simon: no comma, trike); report, README, CLAUDE.md, project log D43, deck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
2026-10-26 Report: 26 Oct results written in (ToF and fusion parked checks, camera range scale and person width, Pi 4 replacement, rear IMU node), Table 4.1, Figure 4.1 caption and wiring updated; analysis join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
2026-10-27 Analysis: split raw streams at reboots inside files and keep the piece overlapping the runs (dry run on 23 Oct: rear 11,619 duplicates and 627 Hz before, 0 and no warning after)
2026-10-27 Dashboard speed: phone and vehicle GNSS fused (mean when within 3 km/h or 25 %, phone when they disagree, either alone); vehicle spd_raw in knots per the manual; tests; deployed with screenshots
2026-10-27 Lab notebook: Pi 4 clock fixed, rear capture restarted, under-voltage accepted for the run
2026-10-27 Analysis: auto_markers.py derives pass, stand, coast and still markers from phone GNSS speed and BMS current for a session without typed markers; synthetic test finds all 20
2026-10-27 Report: 27 Oct inertial-only nodes, 200.00 Hz with no gap over 5.2 ms, 1 g check within 1.3 %
2026-10-27 Run 2 (27 Oct): road session data (raw streams, trimmed recorder, phone GPS, alerts, database, derived markers), analysis outputs, dashboard time-lapse; report: all 11 placeholders filled (smooth 10 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
2026-10-27 Report: Section 8.2.1 links the staged path to autonomy to the TUKZIE 2026/2027 vacation programme (filed, source check recorded, cited)
2026-10-27 Report (strict pass): R1 zero-loss clause not met at the rear, R2 not met on the vehicle (9.845, 9.941), abstract names the third board, reason for thin 15 and 20 km/h data (small car park, cornering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
2026-10-27 R4 evidence cell dated (17 Oct no antenna, 27 Oct fixed); abstract close names the bench validation
2026-10-27 Audit fixes: architecture after the rear IMU node, first-session wording, R2 on vehicle, Method deviations, GA4 as driven, title dates
2026-10-27 Numbers audit: 27 Oct BMS range and 82.9 A peak, front-rear correlation from the logged table, R1 vehicle clause dated, LTE replay and ICC sensitivity wording
2026-10-27 Figure 4.1 redrawn for 27 Oct (rear IMU node), three contributions in 7.3, closing states feasibility not reliability, R7 road latency, dedup key, ICC recommendation
2026-10-27 Future work: replay test bench for development without the vehicle; calibration recommendation states both IMUs were calibrated; Ch 8 trimmed to keep 50 pages
2026-10-27 Recommendations ordered most consequential first (power, acquisition, connectivity, ride analysis)
2026-10-27 SEN55: what happened (soldered to test pads, supply pad lifted) in Appendix J; Introduction points there
2026-10-27 Final pre-submission audit: abstract no longer claims validated fusion or TTC; GNSS update rate corrected from data; R10 partly met on the vehicle; powertrain share from the logged table; architectur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
2026-10-27 README matches the final report: R10 partly met on the vehicle, GNSS update rate, ICC sensitivity, powertrain share
2026-10-27 Appendix B: remove the unprinted camera bracket render and its text
2026-10-27 Appendix I: photo of the Pi 5 and front IMU node under the frame (23 Oct)
2026-10-27 Appendix I: front camera and front system (22 Oct), damaged SEN55 (26 Oct)
2026-10-28 Media: the run (12:14 to 12:38, plates blurred), one-minute overview (web), music credits
2026-10-28 The run: plate stretches cut instead of blurred
2026-10-28 The run: starts on the camera screen, 12:23 to 12:38
