0geder/Tukzie-HPEC-HUD/(notices)

Notices in the files:
Planning/report-review.md:
Cite the MQTT standard and one reliability study in 2.7.
6 | Reference clean-up: delete or cite the 31 uncited entries, remove the irrelevant and placeholder ones ([47], [48], [57], [58], [38]), renumber in order of first citation, and add sources for the uncited key claims in section 6.
- [59], [60], [61] are web sources with access dates, which is correct. [60] is hosted on a third-party site (Waveshare); cite the SIMCom source if one exists.
- The behaviour of vTaskDelayUntil and esp_timer_get_time (p.29). Cite the FreeRTOS and ESP-IDF documentation.
